nolanstr/diycnc/analysis/figs/base_current.png

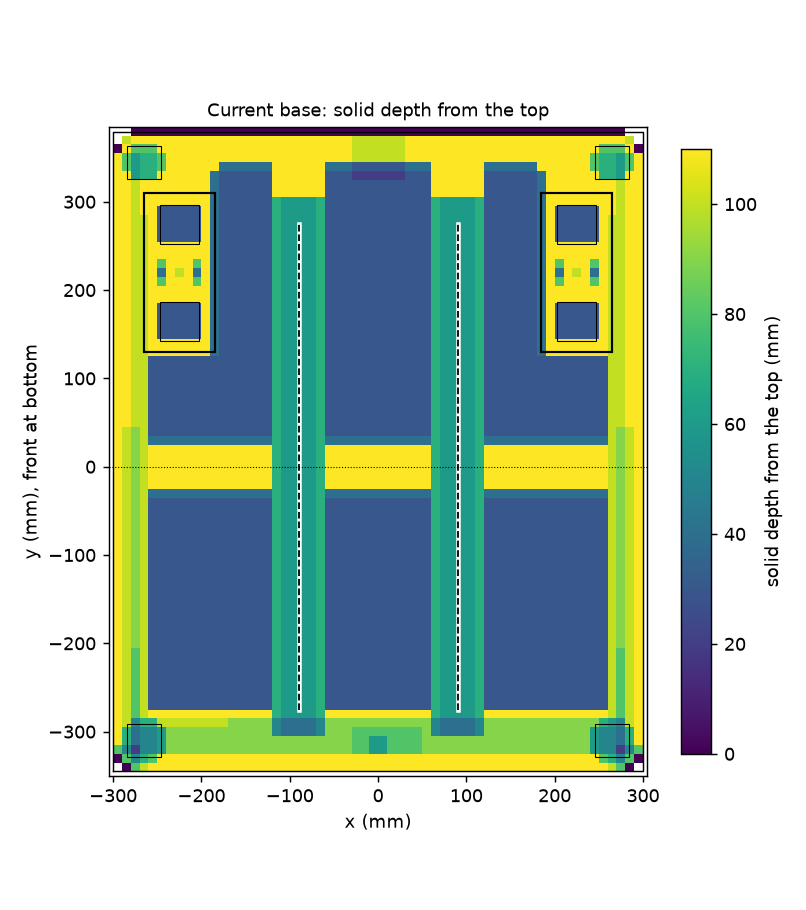
analysis/figs/base_current.png
