nolanstr/diycnc/analysis/figs/base_final.png

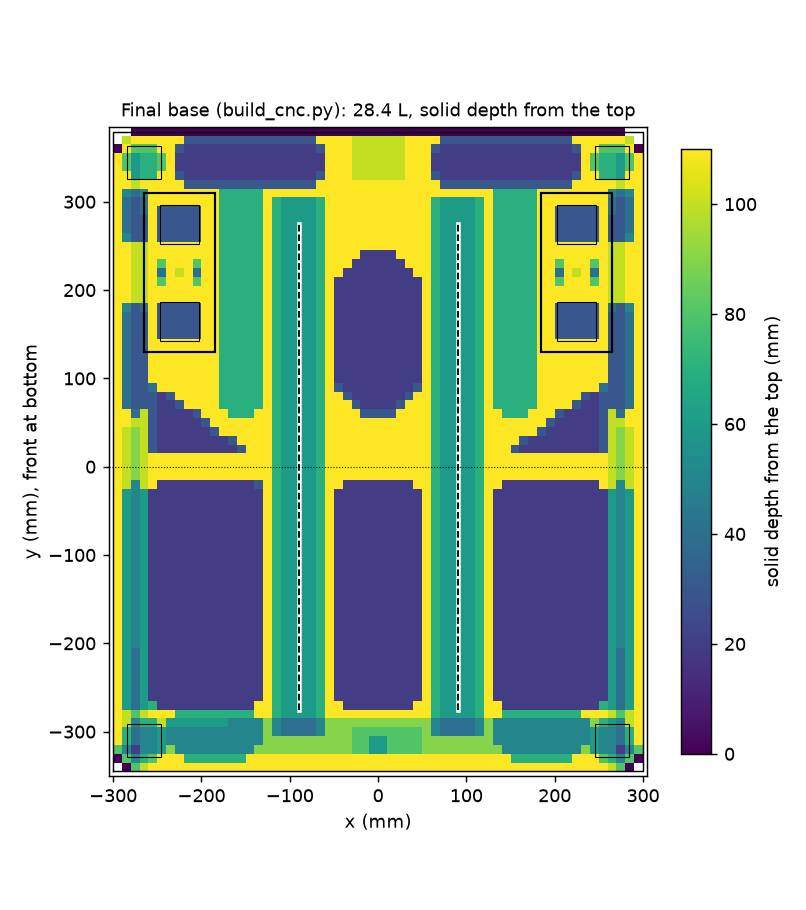
analysis/figs/base_final.png
