nolanstr/diycnc/analysis/figs/base_free_18_depth.png

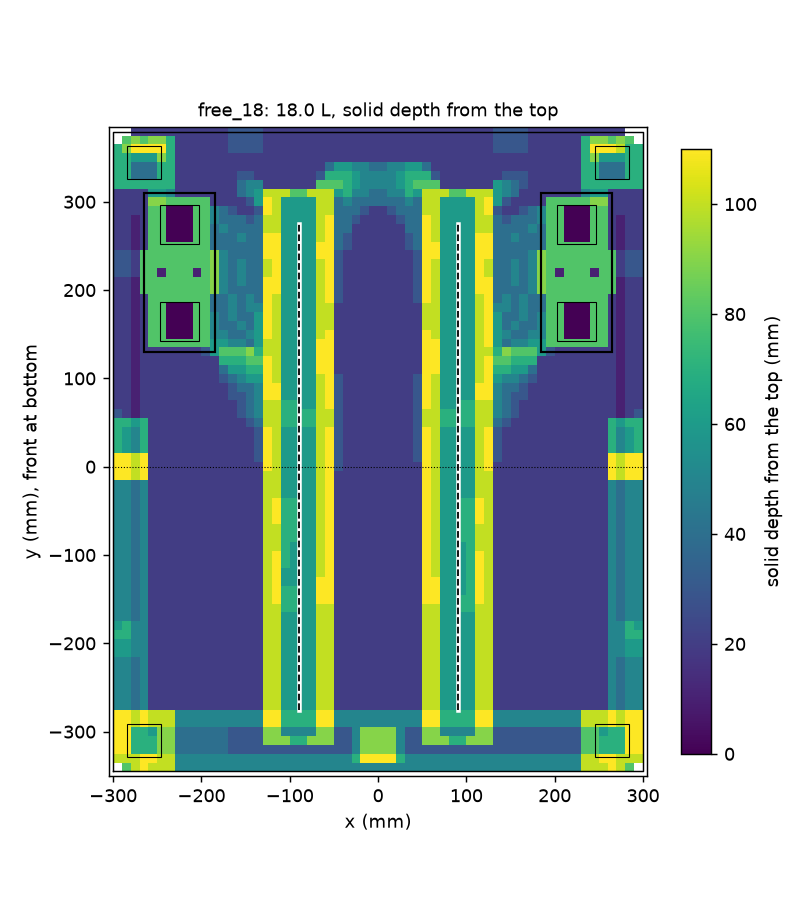
analysis/figs/base_free_18_depth.png
