nolanstr/diycnc/analysis/figs/base_free_18_layers.png

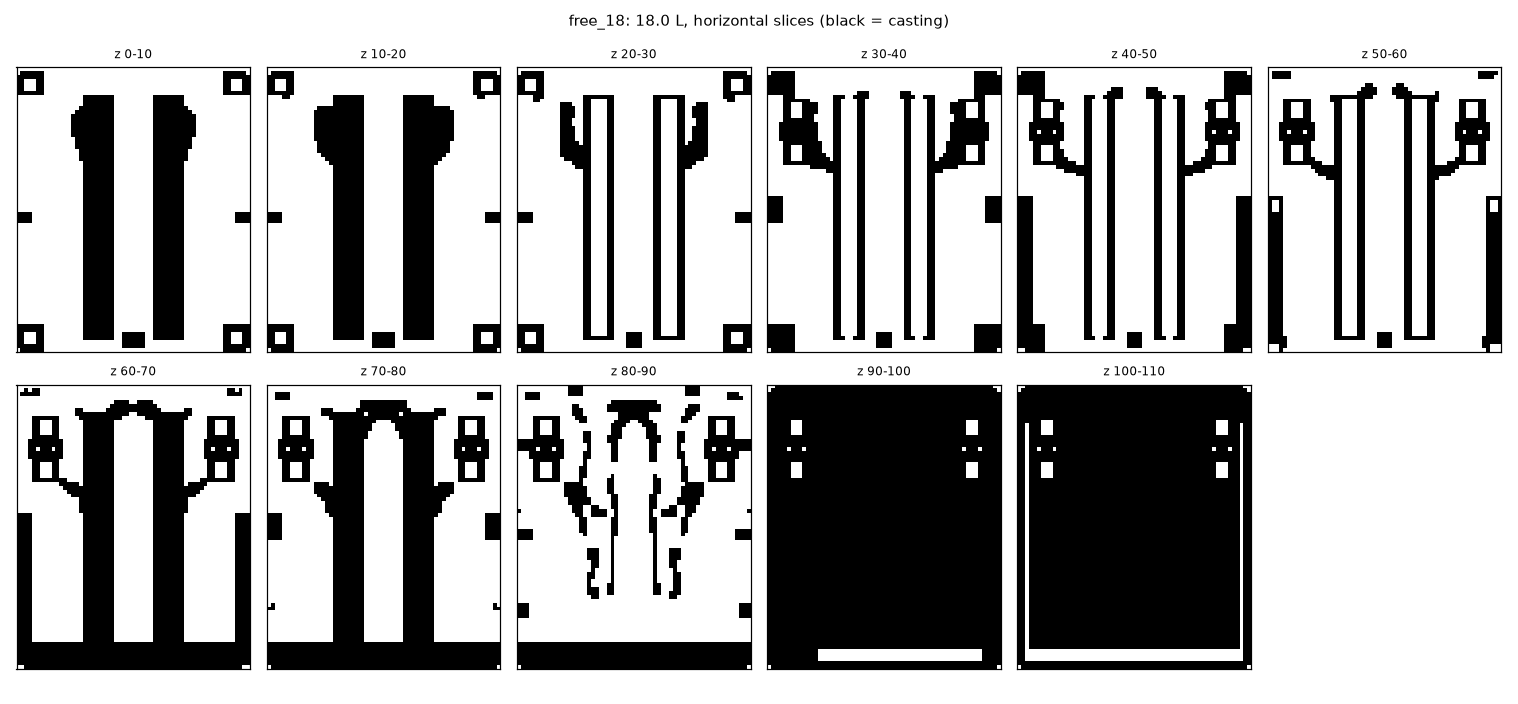
analysis/figs/base_free_18_layers.png
