nolanstr/diycnc/analysis/figs/base_free_21_depth.png

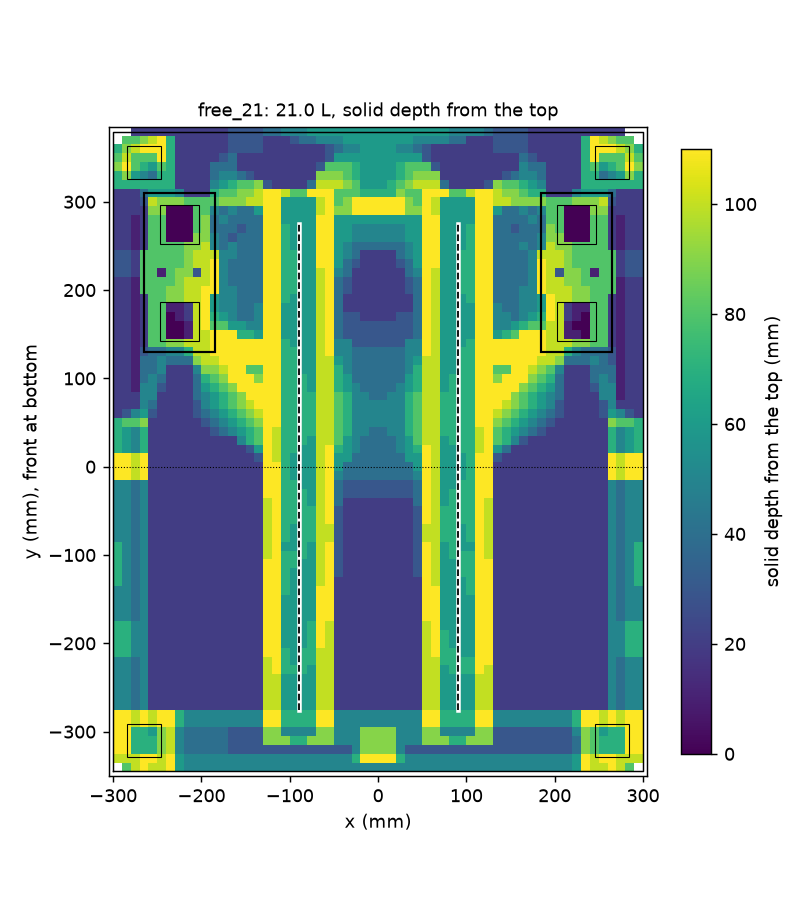
analysis/figs/base_free_21_depth.png
