nolanstr/diycnc/analysis/figs/base_free_21_layers.png

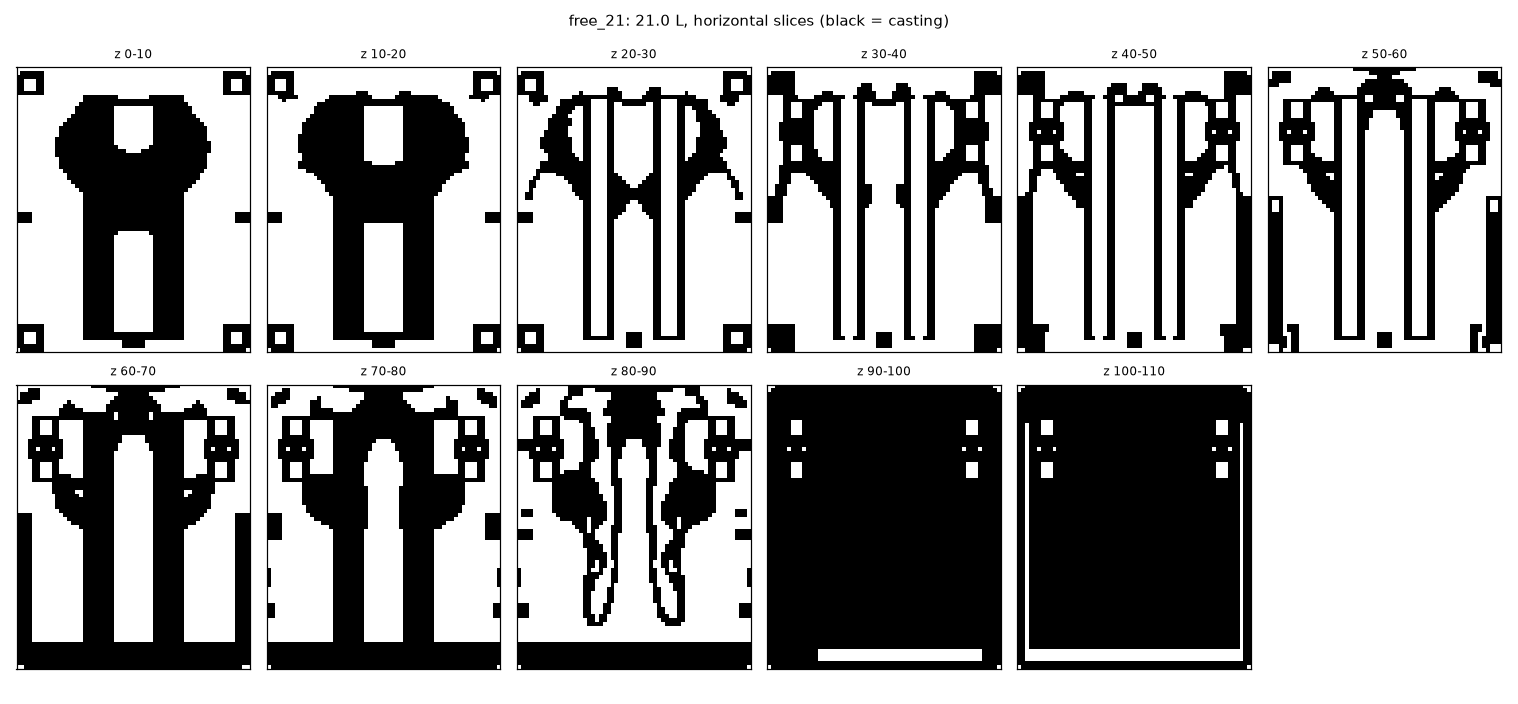
analysis/figs/base_free_21_layers.png
