nolanstr/diycnc/analysis/figs/base_pocket_21_depth.png

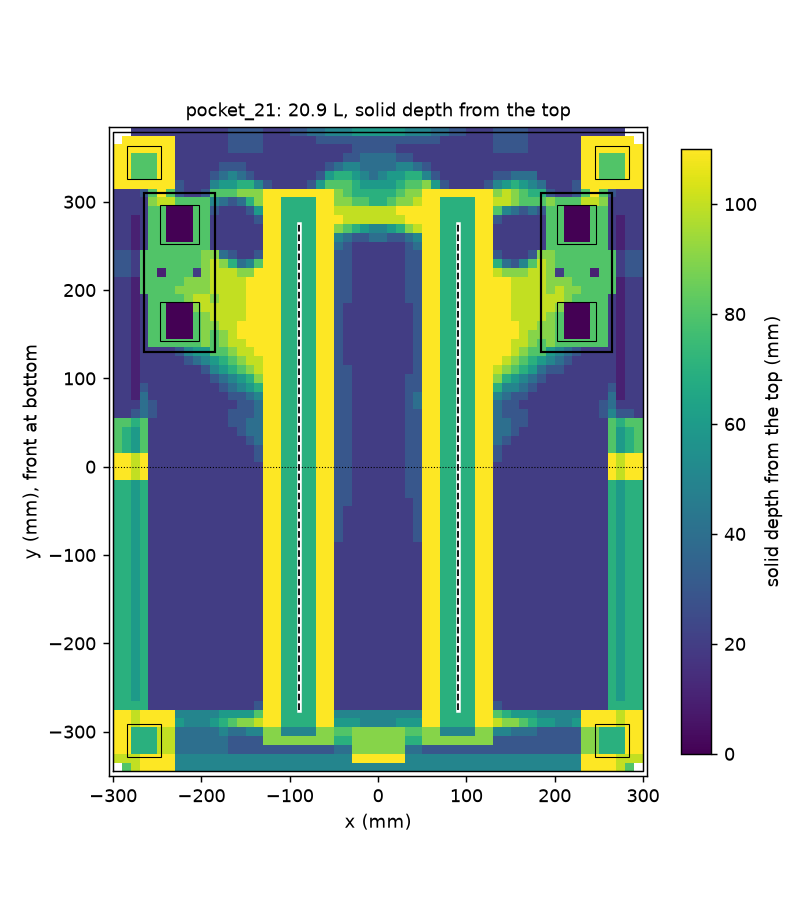
analysis/figs/base_pocket_21_depth.png
