nolanstr/diycnc/analysis/figs/base_pocket_28.5_depth.png

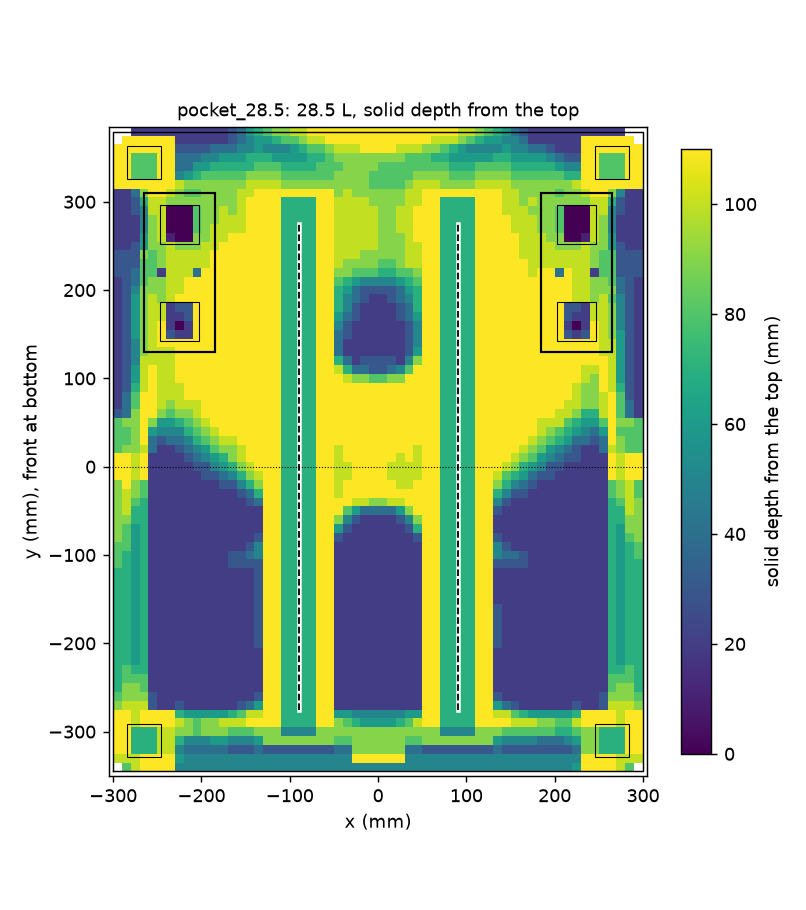
analysis/figs/base_pocket_28.5_depth.png
