nolanstr/diycnc/analysis/figs/frame2_base_28.4.png

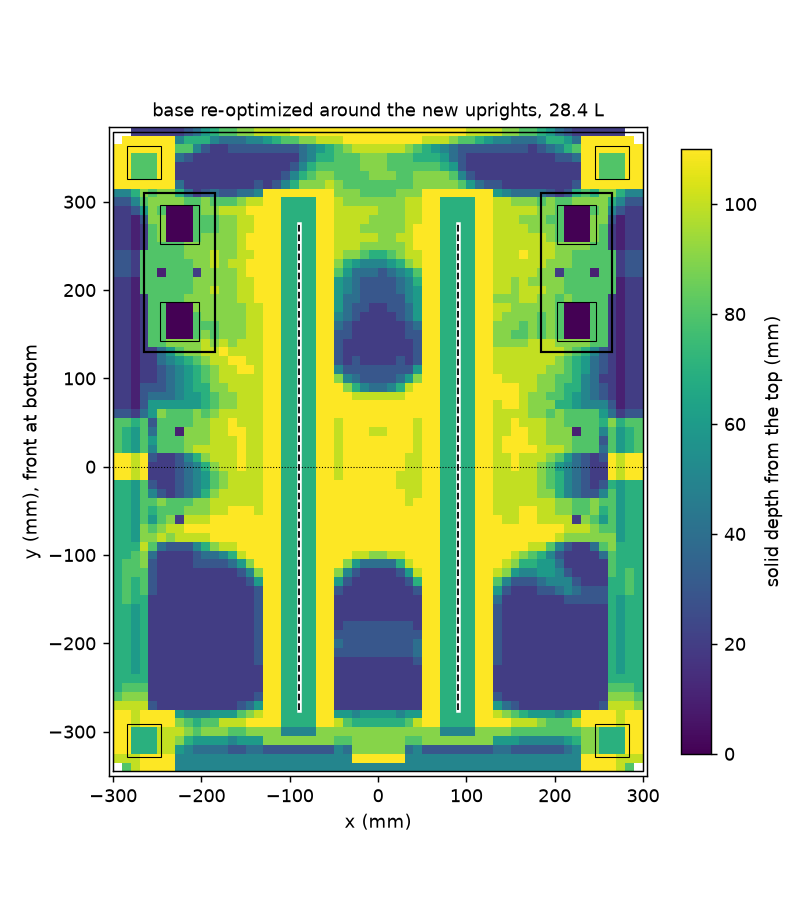
analysis/figs/frame2_base_28.4.png
