nolanstr/diycnc/analysis/figs/frame2_base_cad.png

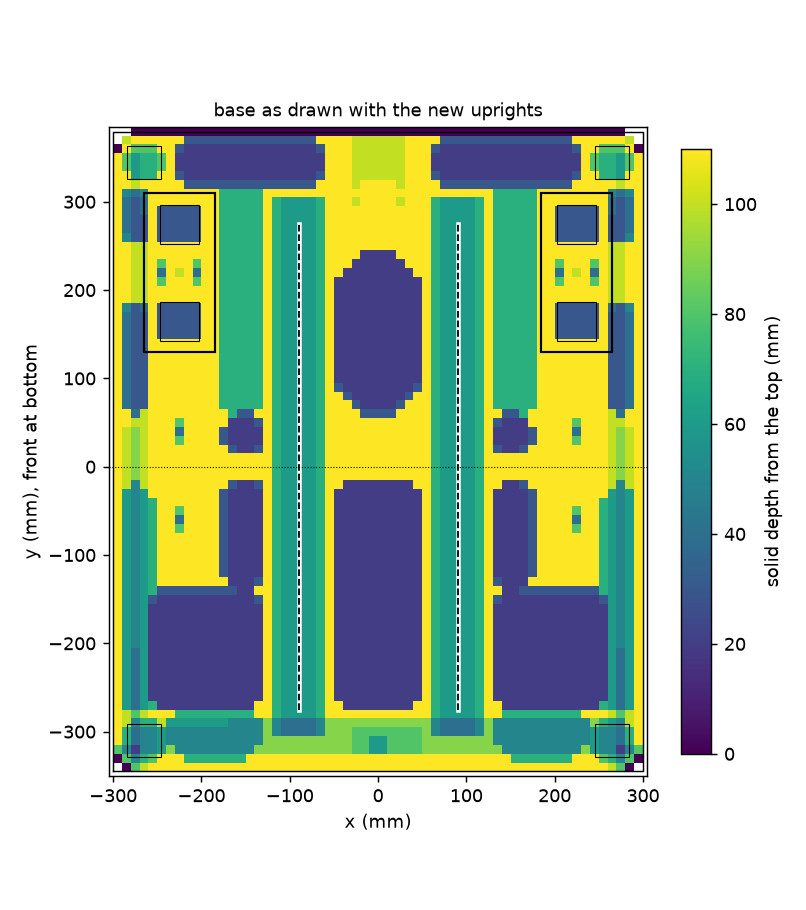
analysis/figs/frame2_base_cad.png
