nolanstr/diycnc/analysis/figs/frame_34.6_upright.png

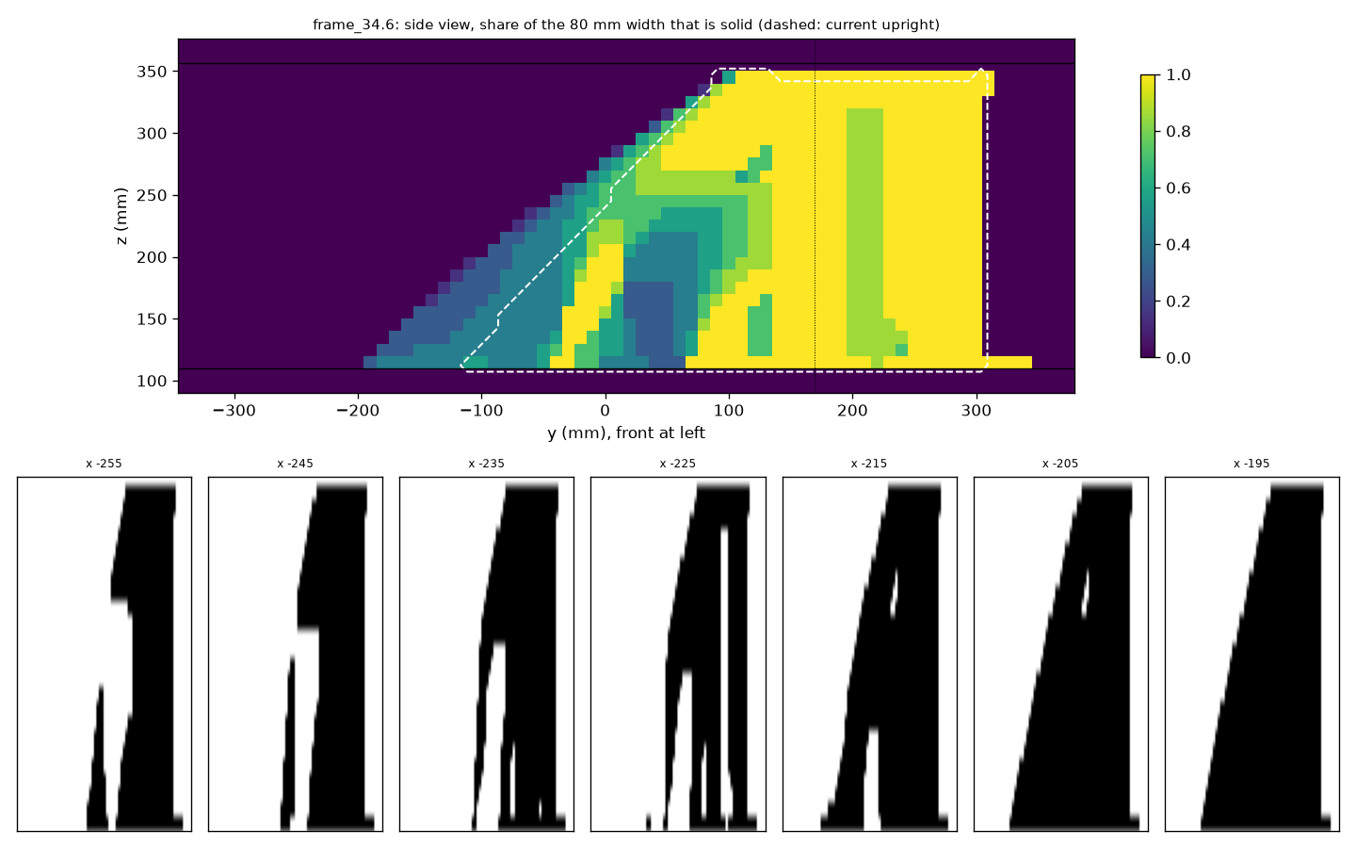
analysis/figs/frame_34.6_upright.png
