nolanstr/diycnc/analysis/figs/light_24.png

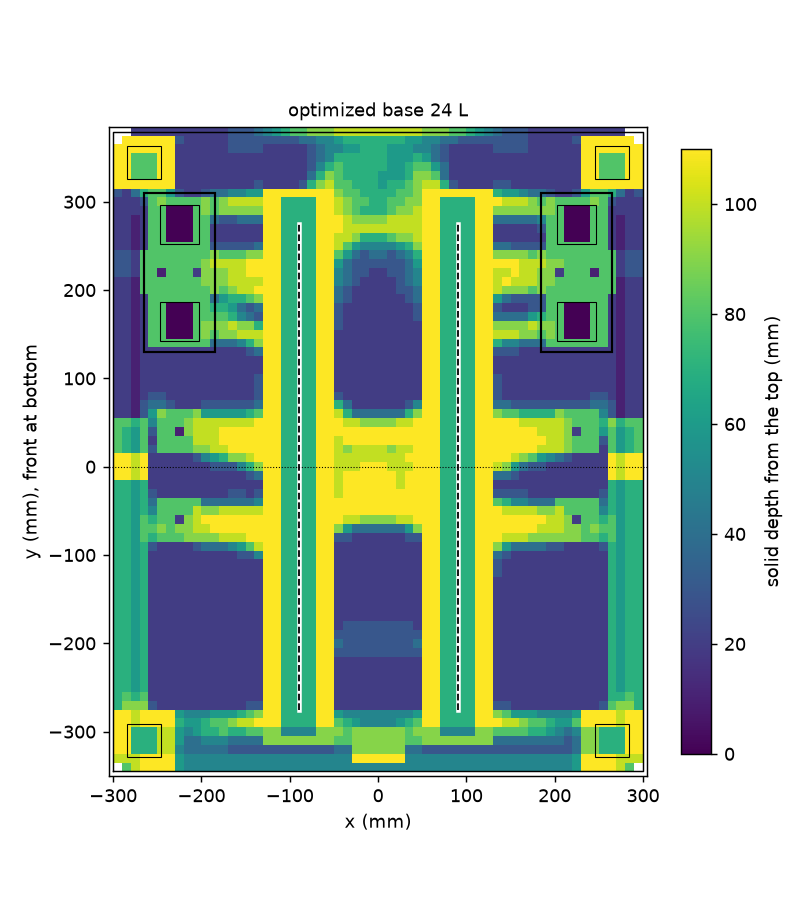
analysis/figs/light_24.png
