nolanstr/diycnc/analysis/figs/light_27.png

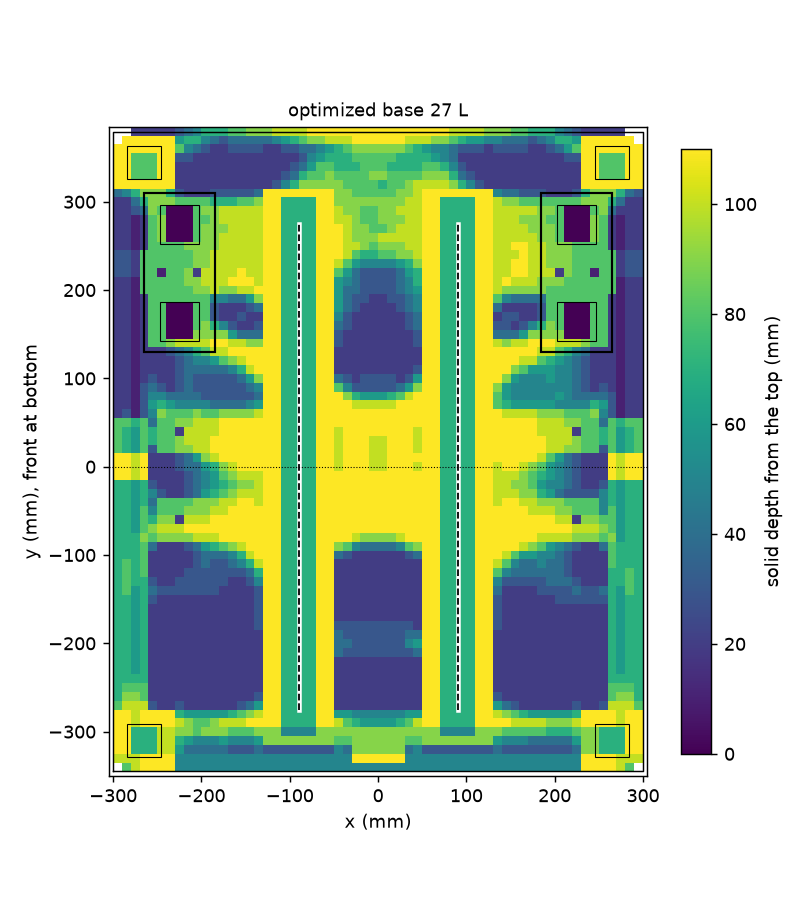
analysis/figs/light_27.png
