nolanstr/diycnc/analysis/figs/light_current.png

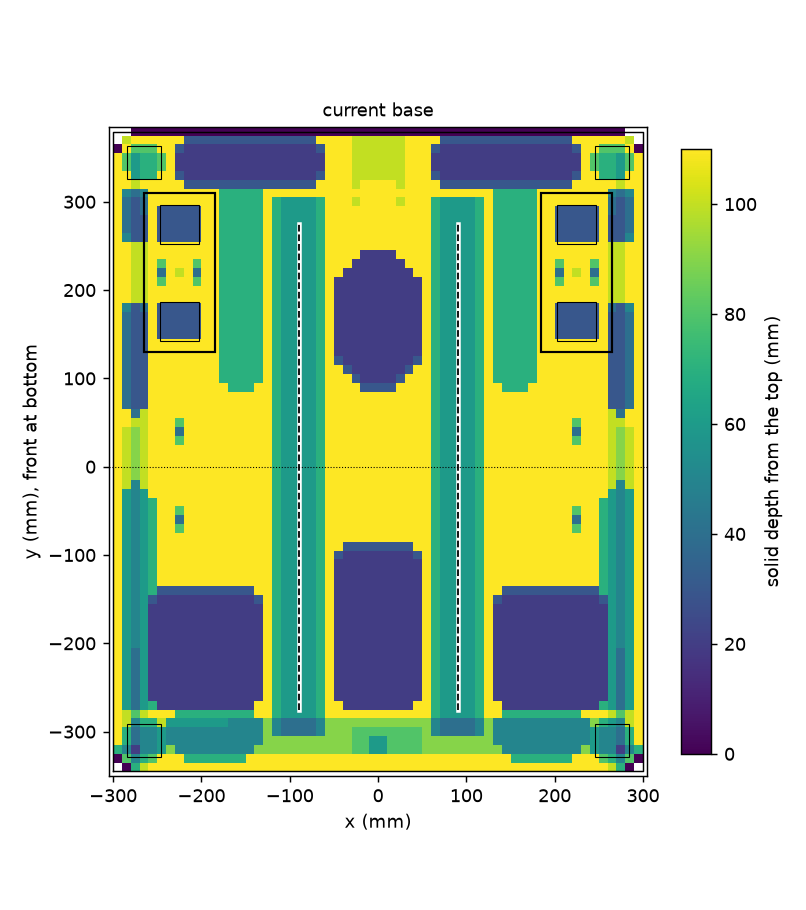
analysis/figs/light_current.png
