nolanstr/diycnc/analysis/figs/tradeoff.png

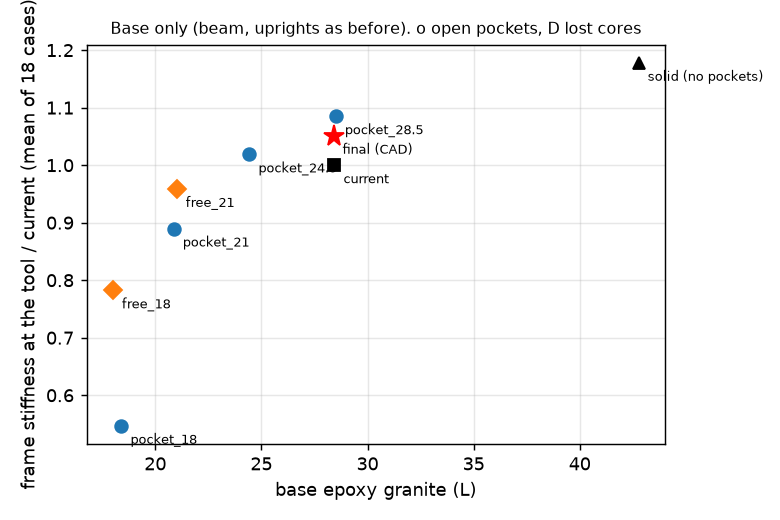
analysis/figs/tradeoff.png
