nolanstr/diycnc/analysis/figs/upright_thru_0.8.png

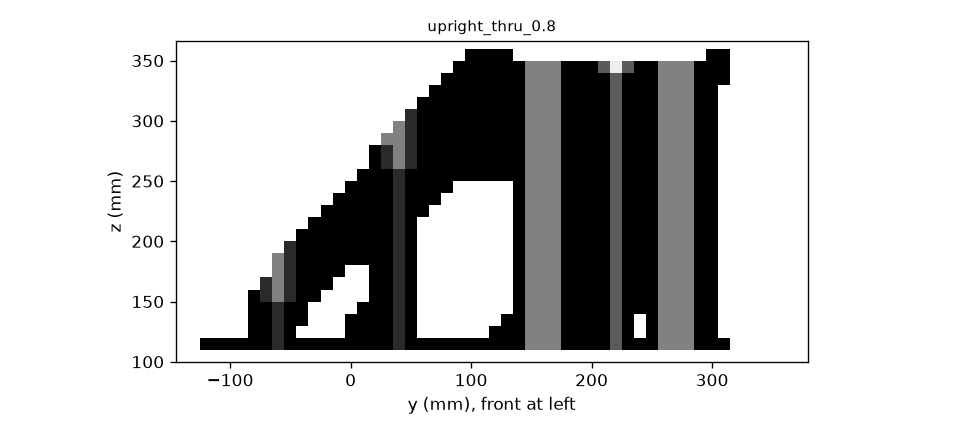
analysis/figs/upright_thru_0.8.png
