nolanstr/diycnc/renders/coolant_system.png

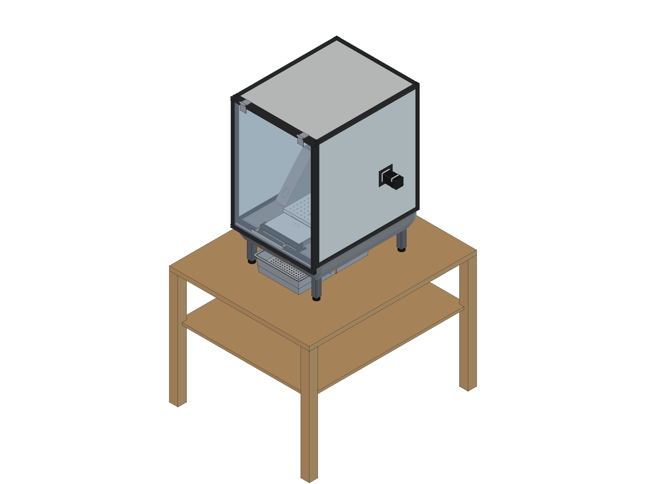
renders/coolant_system.png
