nolanstr/diycnc/renders/detail_cable_chain.png

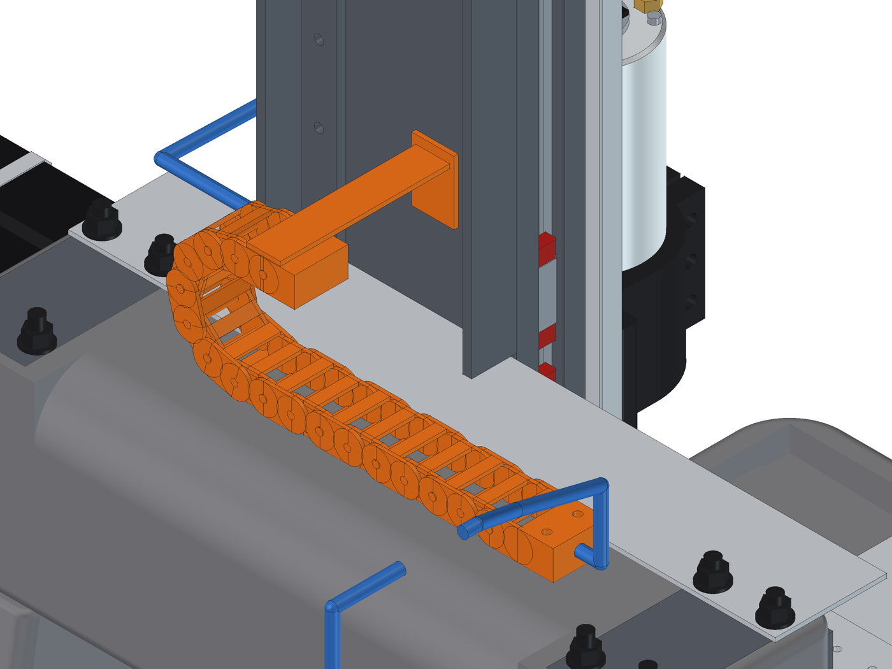
renders/detail_cable_chain.png
