nolanstr/diycnc/renders/detail_coolant_sump.png

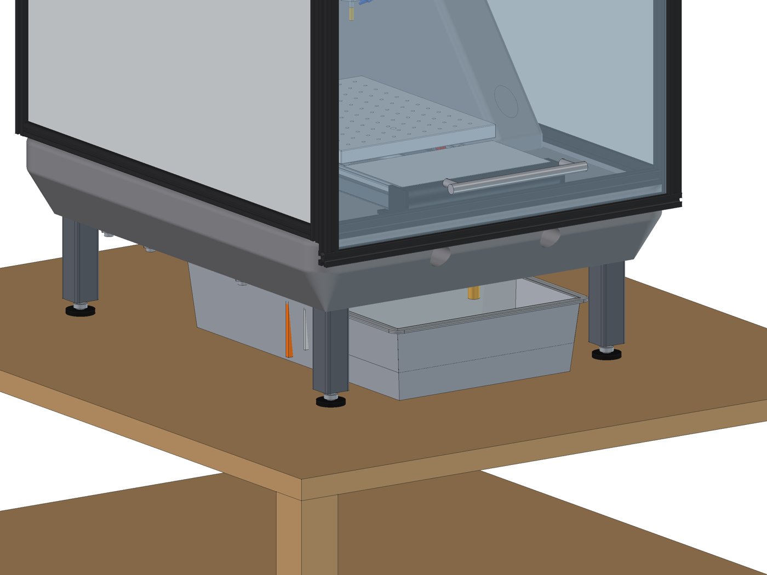
renders/detail_coolant_sump.png
