nolanstr/diycnc/renders/detail_coolant_sump_out.png

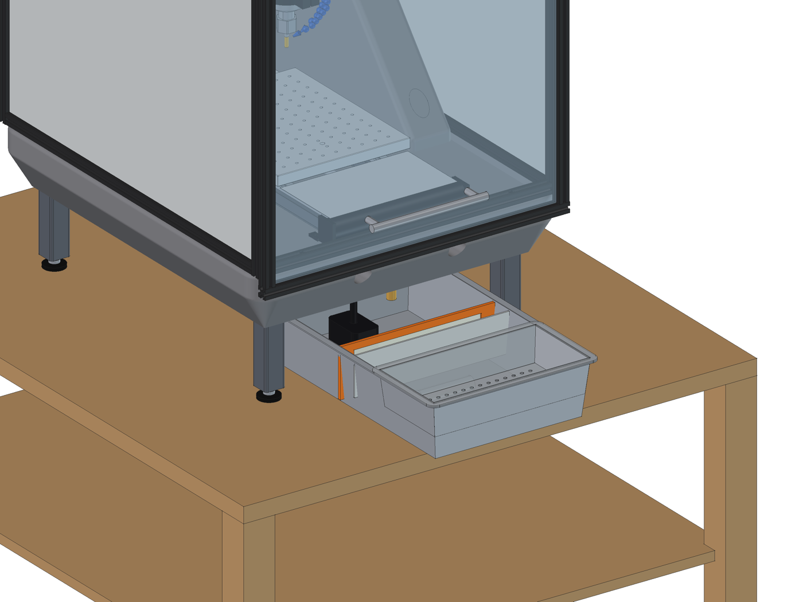
renders/detail_coolant_sump_out.png
