nolanstr/diycnc/renders/detail_nozzles.png

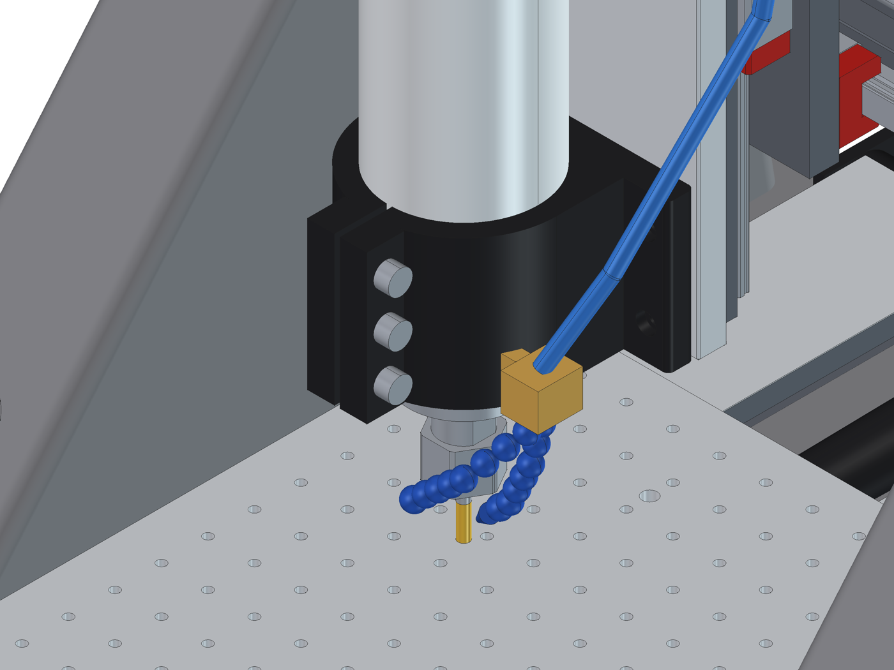
renders/detail_nozzles.png
