nolanstr/diycnc/renders/detail_table_drive.png

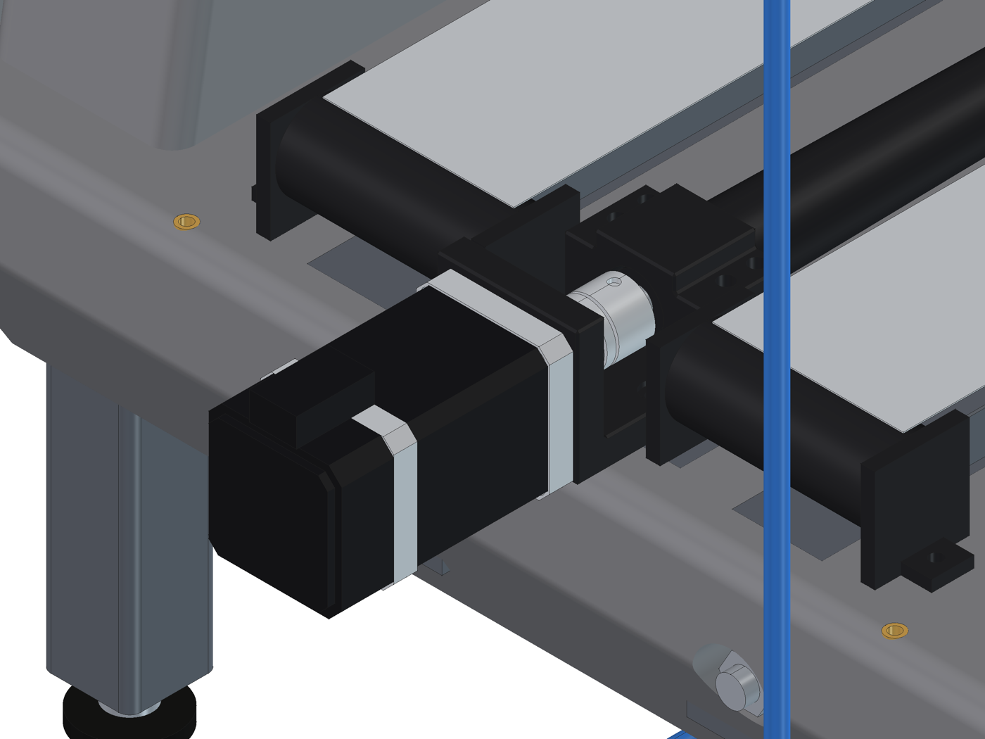
renders/detail_table_drive.png
