nolanstr/diycnc/renders/detail_way_covers.png

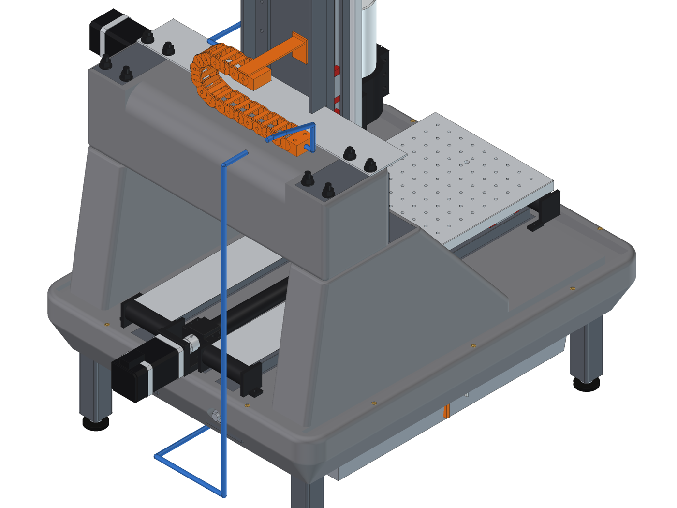
renders/detail_way_covers.png
