nolanstr/diycnc/renders/detail_z_axis.png

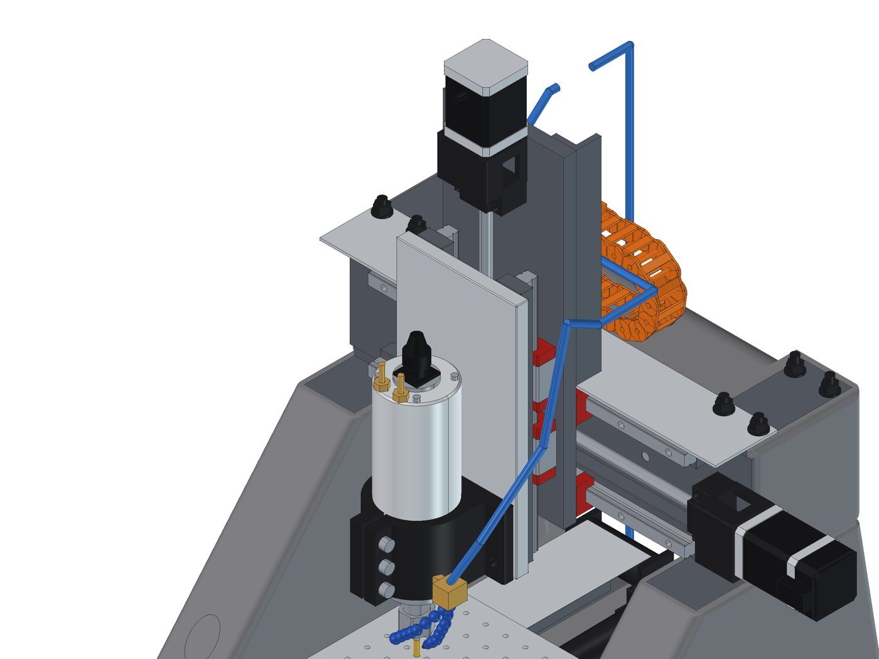
renders/detail_z_axis.png
