nolanstr/diycnc/renders/enclosure_closed.png

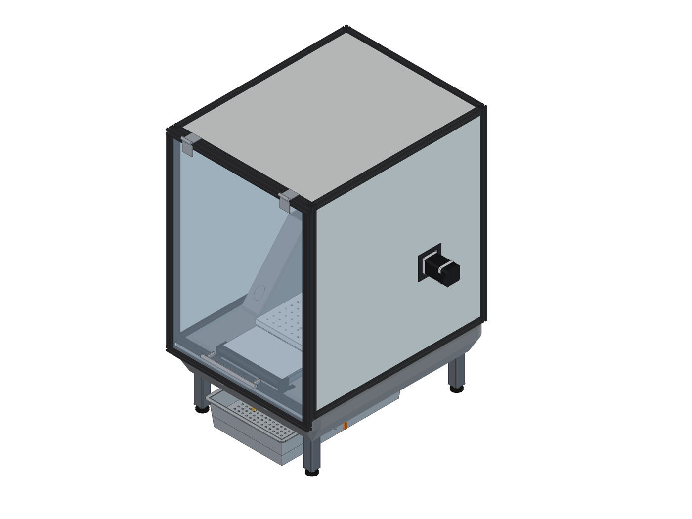
renders/enclosure_closed.png
