nolanstr/diycnc/renders/enclosure_open.png

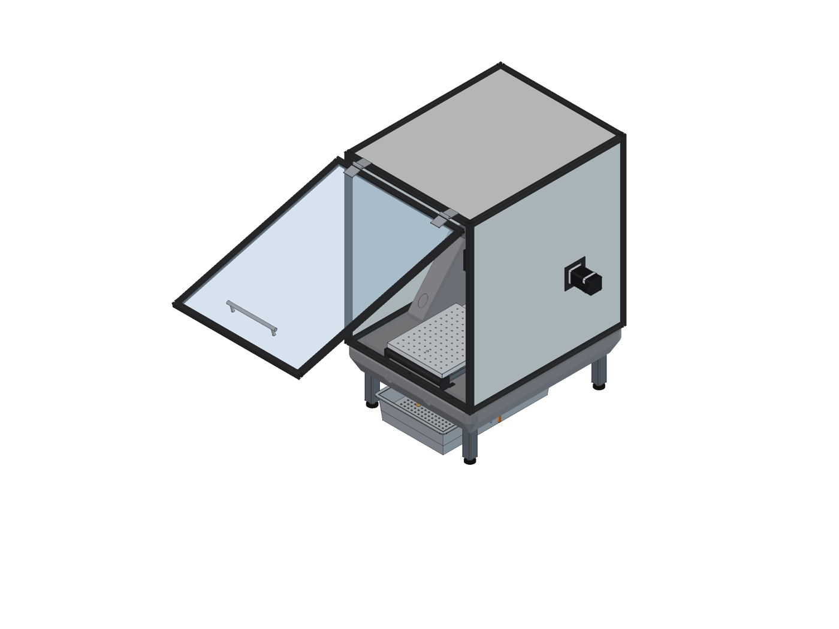
renders/enclosure_open.png
