nolanstr/diycnc/renders/frame_bare.png

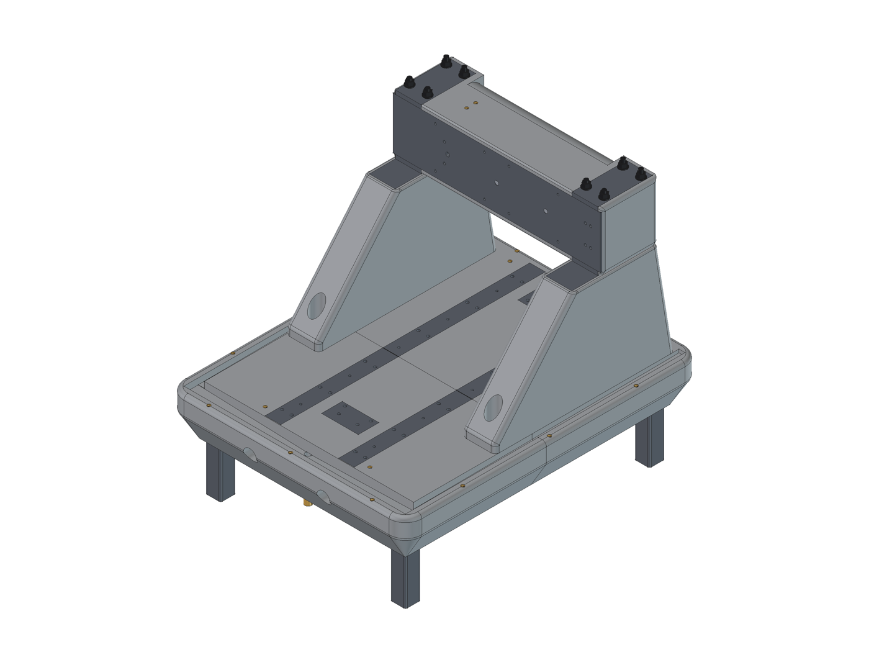
renders/frame_bare.png
