nolanstr/diycnc/renders/frame_bare_exploded.png

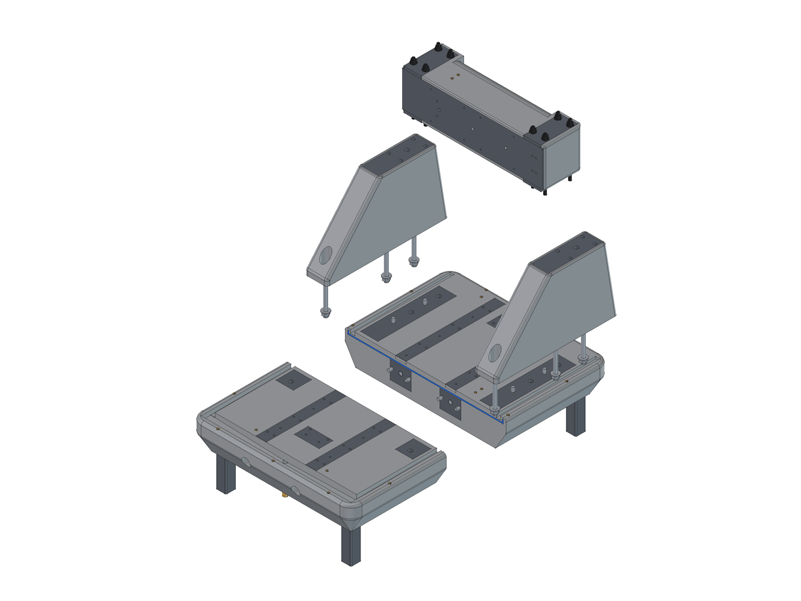
renders/frame_bare_exploded.png
