nolanstr/diycnc/renders/frame_bare_rear.png

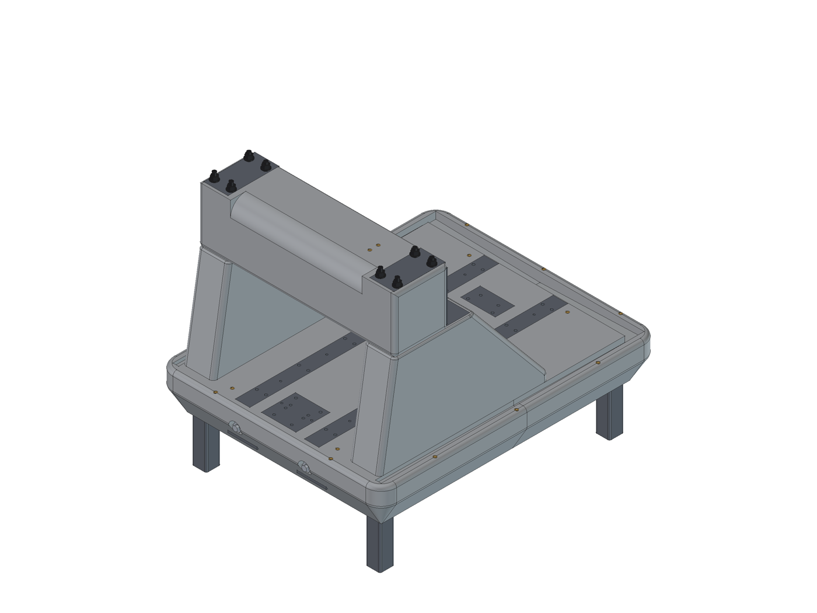
renders/frame_bare_rear.png
