nolanstr/diycnc/renders/frame_bare_xray.png

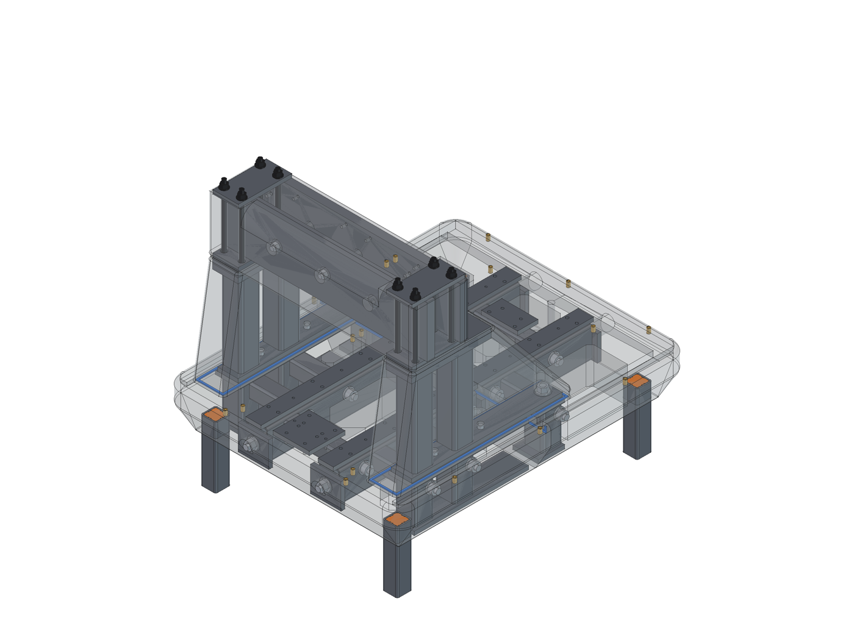
renders/frame_bare_xray.png
