nolanstr/diycnc/renders/frame_base_underside.png

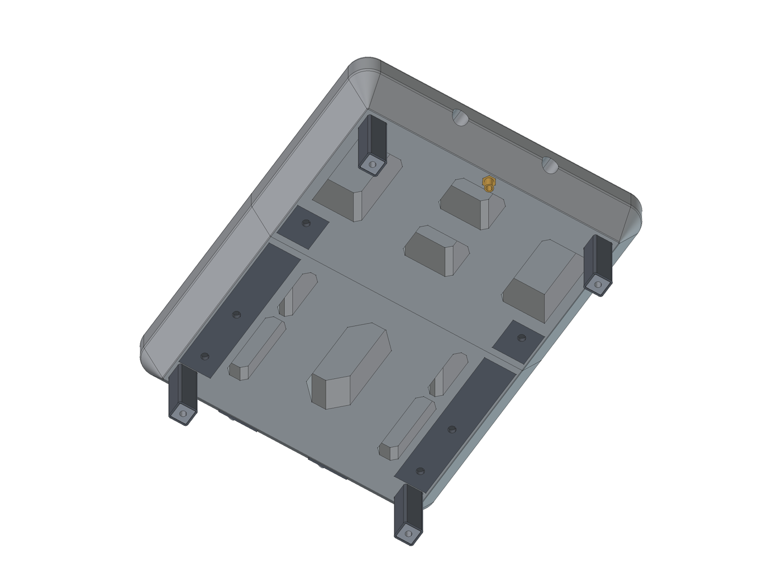
renders/frame_base_underside.png
