nolanstr/diycnc/renders/frame_exploded.png

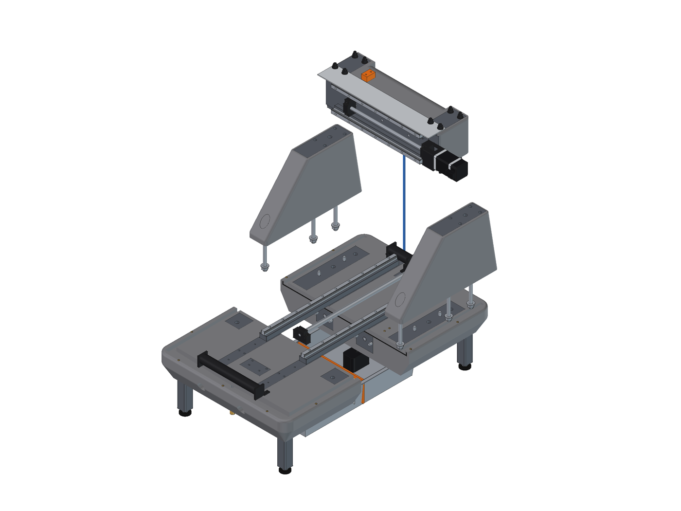
renders/frame_exploded.png
