nolanstr/diycnc/renders/frame_section_split.png

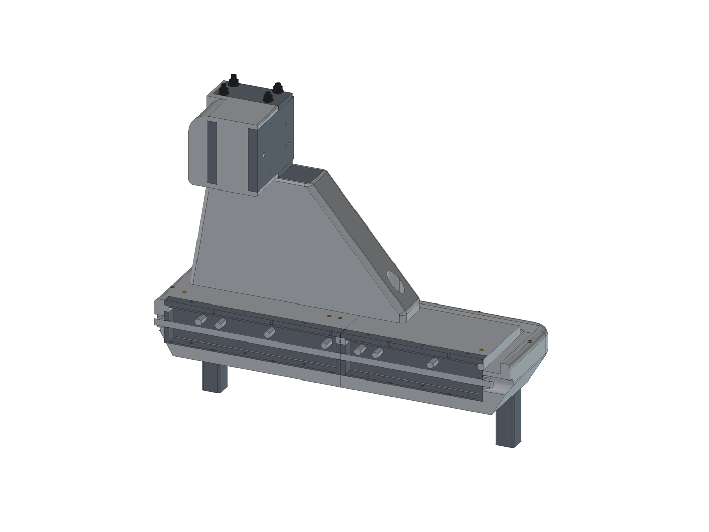
renders/frame_section_split.png
