nolanstr/diycnc/renders/frame_xray.png

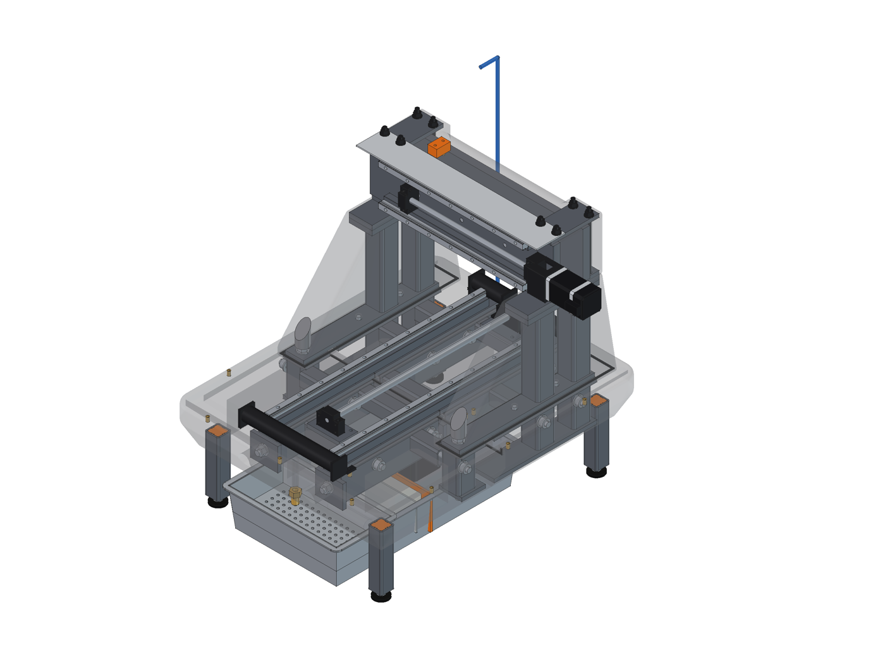
renders/frame_xray.png
