nolanstr/diycnc/renders/gasket_base_split.png

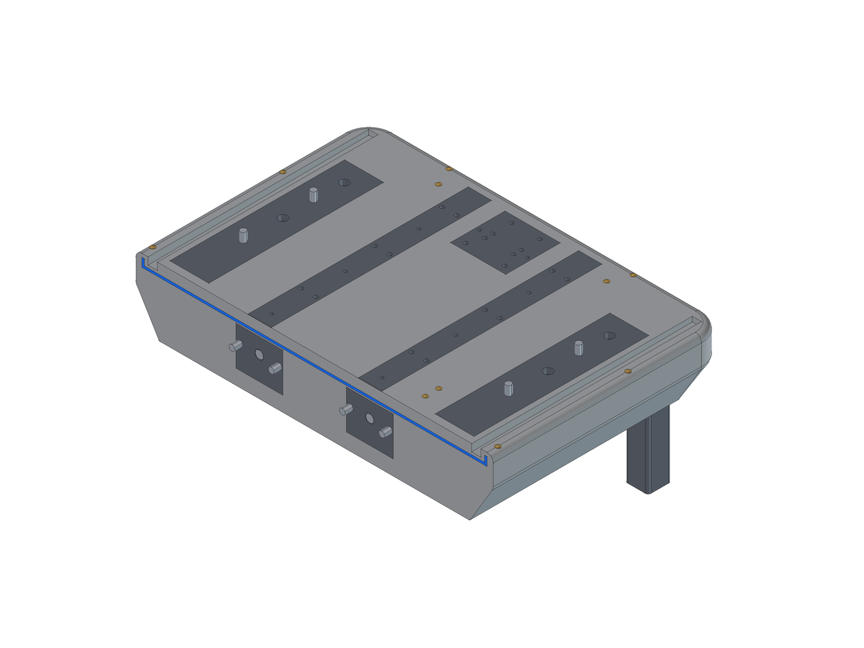
renders/gasket_base_split.png
