nolanstr/diycnc/renders/gasket_upright_foot.png

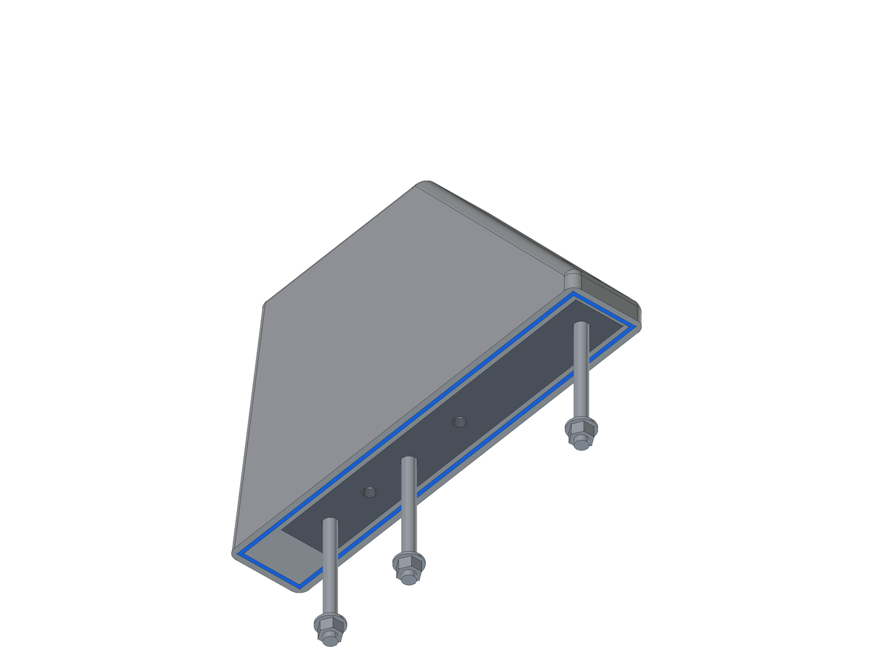
renders/gasket_upright_foot.png
