nolanstr/diycnc/renders/machine_front.png

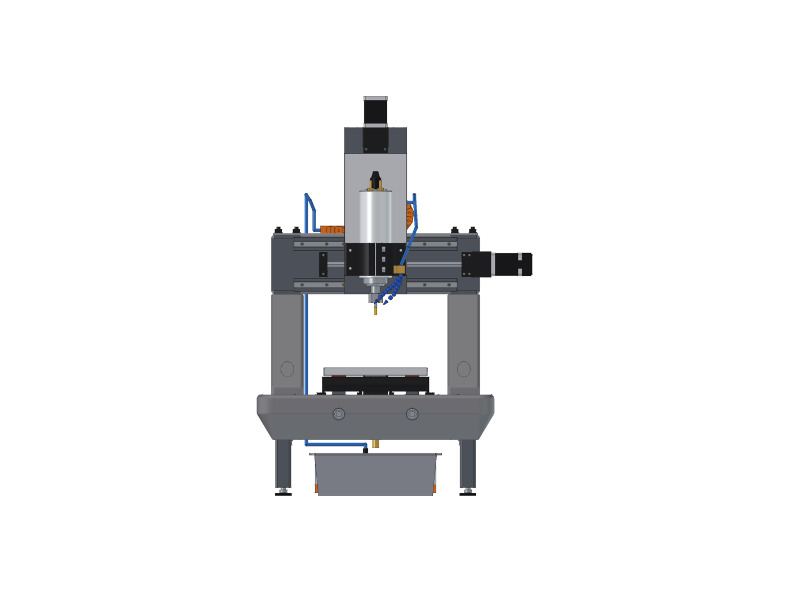
renders/machine_front.png
