nolanstr/diycnc/renders/machine_right.png

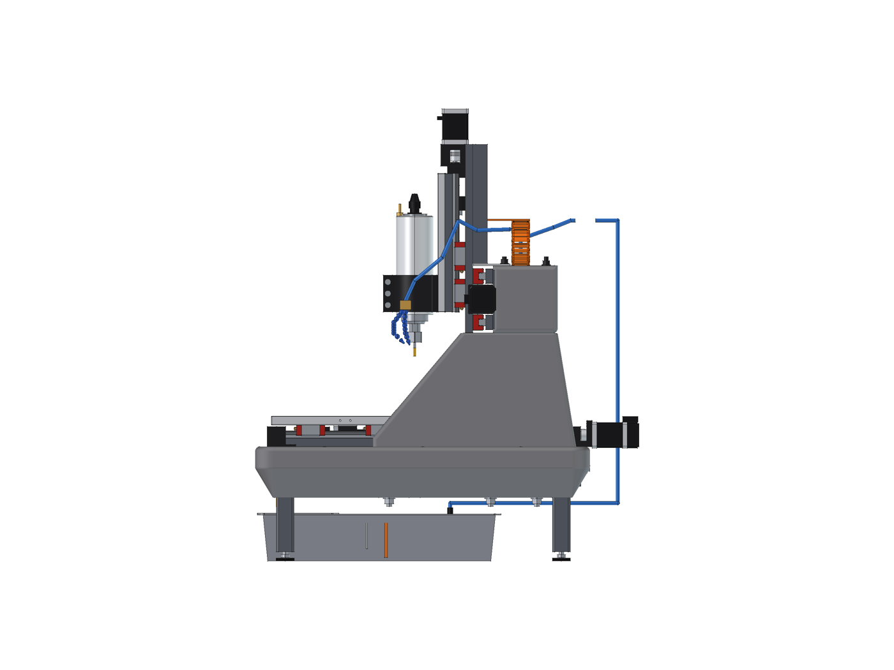
renders/machine_right.png
