nolanstr/diycnc/docs/1-sourcing/steel/README.md

# Steel for the skeletons and the X carriage

All stock mild steel (A36 / A500), nothing custom: buy it cut to length (Metal Supermarkets, Online Metals, a local steel yard; flat bar and tube also come in 3 and 6 ft lengths on Amazon and at hardware stores, and a chop saw or hacksaw does the rest). Drill and tap it from the printed 1:1 templates in `steel-templates.pdf` (center-punch through the paper, then a drill press).

25 different parts, 57 pieces, about 66 kg.

## Cut list (by stock size)

| Stock | Pieces (qty x length, mm) | Total |
|---|---|---|
| Angle 1-1/4 x 1-1/4 x 1/4 in | 2 x 257 | 1.7 ft |
| Flat bar 1/2 x 2-1/2 in | 4 x 198 | 2.6 ft |
| Flat bar 3/4 x 5 in | 2 x 508 | 3.3 ft |
| Flat bar 3/8 x 1-1/2 in | 2 x 359, 2 x 288 | 4.2 ft |
| Flat bar 3/8 x 2 in | 2 x 375, 1 x 90 | 2.8 ft |
| Flat bar 3/8 x 2-1/2 in | 4 x 285, 4 x 133, 8 x 76, 4 x 66 | 8.4 ft |
| Flat bar 3/8 x 3-1/2 in | 1 x 90 | 0.3 ft |
| Flat bar 5/8 x 6 in | 1 x 407 | 1.3 ft |
| Rectangular tube 2 x 3 x 1/8 in | 2 x 340, 2 x 269 | 4.0 ft |
| Square tube 1-1/2 x 1-1/2 x 1/8 in | 4 x 129, 6 x 75 | 3.2 ft |
| Square tube 2 x 2 x 3/16 in | 6 x 91 | 1.8 ft |

## Parts

| Part | Stock | Length | Qty | Holes |
|---|---|---|---|---|
| X carriage angle | Angle 1-1/4 x 1-1/4 x 1/4 in | 257 mm (10-1/8 in) | 2 | 5 x 17/64 in |
| Top plate, lower | Flat bar 1/2 x 2-1/2 in | 198 mm (7-13/16 in) | 2 | 2 x 27/64 in, tap 1/2-13, 4 x 5/16 in, tap 3/8-16, 1 x 9/16 in |
| Top plate, upper | Flat bar 1/2 x 2-1/2 in | 198 mm (7-13/16 in) | 2 | 4 x 13/32 in, 1 x 9/16 in |
| Beam back plate | Flat bar 3/4 x 5 in | 508 mm (20 in) | 1 | 3 x 13/32 in |
| Beam face plate | Flat bar 3/4 x 5 in | 508 mm (20 in) | 1 | 3 x 5/16 in, tap 3/8-16, 8 x M5 tap drill (4.2 mm), tap M5, 6 x M6 tap drill (5 mm), tap M6 |
| Rail bar rear | Flat bar 3/8 x 1-1/2 in | 359 mm (14-1/8 in) | 2 | 6 x 17/64 in, 3 x M5 tap drill (4.2 mm), tap M5 |
| Rail bar front | Flat bar 3/8 x 1-1/2 in | 288 mm (11-5/16 in) | 2 | 6 x 17/64 in, 2 x M5 tap drill (4.2 mm), tap M5 |
| Upright foot | Flat bar 3/8 x 2 in | 375 mm (14-3/4 in) | 2 | 3 x 9/16 in, 2 x 1/2 in |
| Pad BF | Flat bar 3/8 x 2 in | 90 mm (3-9/16 in) | 1 | 2 x 17/64 in, 2 x M6 tap drill (5 mm), tap M6 |
| Seat rear | Flat bar 3/8 x 2-1/2 in | 285 mm (11-1/4 in) | 2 | 2 x 9/16 in, 2 x 3/8 in |
| Pedestal bar rear | Flat bar 3/8 x 2-1/2 in | 285 mm (11-1/4 in) | 2 | 2 x 9/16 in |
| Beam seat | Flat bar 3/8 x 2-1/2 in | 133 mm (5-1/4 in) | 2 | 4 x 17/32 in, 1 x 3/8 in |
| Beam cap | Flat bar 3/8 x 2-1/2 in | 133 mm (5-1/4 in) | 2 | 4 x 17/32 in |
| Girder end | Flat bar 3/8 x 2-1/2 in | 76 mm (3 in) | 4 | 1 x 9/16 in |
| Girder end split | Flat bar 3/8 x 2-1/2 in | 76 mm (3 in) | 4 | 1 x 9/16 in, 2 x 3/8 in |
| Pedestal bar / seat front | Flat bar 3/8 x 2-1/2 in | 66 mm (2-5/8 in) | 4 | 1 x 9/16 in |
| Pad BK | Flat bar 3/8 x 3-1/2 in | 90 mm (3-9/16 in) | 1 | 2 x 17/64 in, 6 x M6 tap drill (5 mm), tap M6, 2 x M5 tap drill (4.2 mm), tap M5 |
| X carriage plate | Flat bar 5/8 x 6 in | 407 mm (16-1/16 in) | 1 | - |
| Girder rear | Rectangular tube 2 x 3 x 1/8 in | 340 mm (13-3/8 in) | 2 | 6 x 17/64 in, 3 x 1/4 in; 4 x 9/16 in |
| Girder front | Rectangular tube 2 x 3 x 1/8 in | 269 mm (10-5/8 in) | 2 | 6 x 17/64 in, 2 x 1/4 in; 3 x 9/16 in |
| Cross split | Square tube 1-1/2 x 1-1/2 x 1/8 in | 129 mm (5-1/16 in) | 2 | - |
| Cross BF front | Square tube 1-1/2 x 1-1/2 x 1/8 in | 129 mm (5-1/16 in) | 1 | 2 x 17/64 in, 2 x 9/32 in |
| Cross BK rear | Square tube 1-1/2 x 1-1/2 x 1/8 in | 129 mm (5-1/16 in) | 1 | 2 x 17/64 in, 2 x 9/32 in |
| Cross ped | Square tube 1-1/2 x 1-1/2 x 1/8 in | 75 mm (2-15/16 in) | 6 | - |
| Pedestal column | Square tube 2 x 2 x 3/16 in | 91 mm (3-9/16 in) | 6 | 1 x 9/16 in |
