nolanstr/diycnc/docs/1-sourcing/quote-requests.md

# Quote requests

Ready to send: copy the text into the seller's email or quote form, fill in your name and phone, and
send. Contacts were checked on 2026-10-22; none of these sellers publishes prices for cut pieces, so a
quote is the only way to beat the estimates in the sourcing list (steel ~$400, aluminum ~$65, ACM
~$117 + freight).

## 1. Steel, rail risers and aluminum plates

Send the same request to all four and take the best. Ask each to quote both ways: cut to the list,
and the same stock uncut (drops or full lengths), since a chop saw does the rest.

| Seller | How to send | Notes |
|---|---|---|
| Triple-S Steel, 6945 San Tomas Rd, Elkridge | howard.payton@sss-steel.com, 410-355-6464 | Sells to walk-in retail customers (walk-in Mon-Fri 8-3) |
| Metal Supermarkets, 7120 Golden Ring Rd #112 | Quote form at metalsupermarkets.com/location/baltimore, 410-918-0199 | No minimum; always cut to size |
| Alro Metals Outlet, 8893 Kelso Dr, Essex | "Email this facility" form at alro.com (location BZ), 410-687-2414 | Drops and remnants, open to the public, cuts while you wait: best taken in person with the list |
| DS Pipe & Steel, 1301 Wicomico St | Quote form at dspipe.com/request-a-quote, 410-539-8000 | "No order too small"; most Saturdays 7-1 |

> **Subject:** Quote request: small cut-to-length order, mild steel and aluminum, pickup
>
> Hello,
>
> I'd like a price for the following, for pickup in Baltimore. Please quote it cut to the lengths
> below, and if it's cheaper, the same stock uncut (drops or remnants are fine; I can cut it
> myself). Saw-cut ends are fine; length tolerance +/- 1/8 in. Hot-rolled A36 flat bar and A500
> tube unless noted.
>
> **Flat bar (hot-rolled A36)**
> - 3/4 x 5 in: 2 pcs at 20.00 in
> - 1/2 x 2-1/2 in: 4 pcs at 7.80 in
> - 3/8 x 1-1/2 in: 2 pcs at 14.13 in, 2 pcs at 11.34 in
> - 3/8 x 2 in: 2 pcs at 14.76 in, 1 pc at 3.54 in
> - 3/8 x 2-1/2 in: 4 pcs at 11.22 in, 4 pcs at 5.25 in, 8 pcs at 3.00 in, 4 pcs at 2.60 in
> - 3/8 x 3-1/2 in: 1 pc at 3.56 in
> - 5/8 x 6 in: 1 pc at 16.06 in
>
> **Angle (A36)**
> - 1-1/4 x 1-1/4 x 1/4 in: 2 pcs at 10.13 in
>
> **Tube (A500)**
> - Rectangular 2 x 3 x 1/8 in wall: 2 pcs at 13.40 in, 2 pcs at 10.61 in
> - Square 2 x 2 x 3/16 in wall: 6 pcs at 3.58 in, 4 pcs at 8.13 in
> - Square 1-1/2 x 1-1/2 x 1/8 in wall: 4 pcs at 5.09 in, 6 pcs at 3.31 in, 4 pcs at 6.00 in
>
> **Cold-rolled 1018 flat bar** (needs to be cold-rolled for flatness)
> - 3/4 x 1-1/4 in: 2 pcs at 23.62 in
> - 5/8 x 1-1/4 in: 2 pcs at 15.75 in, 2 pcs at 11.81 in
>
> **Aluminum 6061 flat bar** (drops or remnants welcome; MIC-6 even better if you have it)
> - 3/4 x 10 in: 1 pc at 12.63 in
> - 5/8 x 6 in: 1 pc at 11.81 in
>
> Total is roughly 185 lb of steel and 14 lb of aluminum. Could you also tell me your cutting
> charge, and whether I can pick it up the same week?
>
> Thank you,
> [name, phone]

## 2. Whiting (Clayworks Supplies)

clayworks@clayworkssupplies.com, 410-235-5998; 4625 Falls Rd, Mon-Fri 10-5, Sat 10-4. A call is quickest.

> **Subject:** Calcium carbonate whiting: mesh size
>
> Hello,
>
> I'd like to pick up a 50 lb bag of your calcium carbonate whiting ($17). Could you tell me its mesh
> size (I need 325 mesh, or finer) and whether it's in stock this week? If you have the SDS, could
> you send it as well?
>
> Thank you,
> [name, phone]

## 3. ACM sheet for the enclosure (Piedmont Plastics)

Piedmont Plastics, 7045 Troy Hill Dr, Elkridge, 301-881-7900 ("Talk to an expert" form at
piedmontplastics.com, Baltimore/Washington branch). Only when you get to part 3.

> **Subject:** Quote: one sheet of 3 mm ACM, pickup
>
> Hello,
>
> Could you quote one 48 x 96 in sheet of 3 mm aluminum composite panel (white or black, any brand)
> for pickup at Elkridge? If you cut to size, please also quote it cut into these panels: 2 at
> 726 x 684 mm, 1 at 726 x 560 mm, 1 at 684 x 560 mm and 1 at 518 x 79 mm.
>
> Thank you,
> [name, phone]
