nolanstr/diycnc/docs/1-sourcing/steel/steel-templates.pdf

# Steel parts: drilling templates

DIY CNC mill · October 2026 · full size, US Letter

## Printing

1. Print at Actual size / 100 %. Turn off "Fit to page" and "Scale to fit". Letter paper, portrait.
2. Measure the square below: it must be 100 mm (and the bar on every page 50 mm).

## Marking and drilling

1. Cut out the part's outline on each page and tape it to the part, its edges on the part's edges (x runs along the length from the end the page starts at). For a tube, tape it to the face named in the title.
2. Center-punch through every crosshair, pull the paper off, and drill on a drill press with the part clamped. Pilot with 1/8 in first. Tube holes marked "near wall only" go through one wall; the rest go through both.
3. Tap the holes the legend says to tap (cutting oil, a tap guide or the drill press chuck to start square).
4. Parts marked "x2" or more: mark one, then use it as a drilling jig for the rest (clamp them together).

## Pages

Part | Qty | Pages | Holes
X carriage angle (flat leg, from the heel) | 2 | 2-3 (2) | 5
Top plate, lower | 2 | 4-4 (1) | 7
Top plate, upper | 2 | 5-5 (1) | 5
Beam back plate | 1 | 6-8 (3) | 3
Beam face plate | 1 | 9-11 (3) | 17
Rail bar rear | 2 | 12-13 (2) | 9
Rail bar front | 2 | 14-15 (2) | 8
Upright foot | 2 | 16-17 (2) | 5
Pad BF | 1 | 18-18 (1) | 4
Seat rear | 2 | 19-20 (2) | 4
Pedestal bar rear | 2 | 21-21 (1) | 2
Beam seat | 2 | 22-22 (1) | 5

100 mm

## X carriage angle (flat leg, from the heel) (x2: mark each)

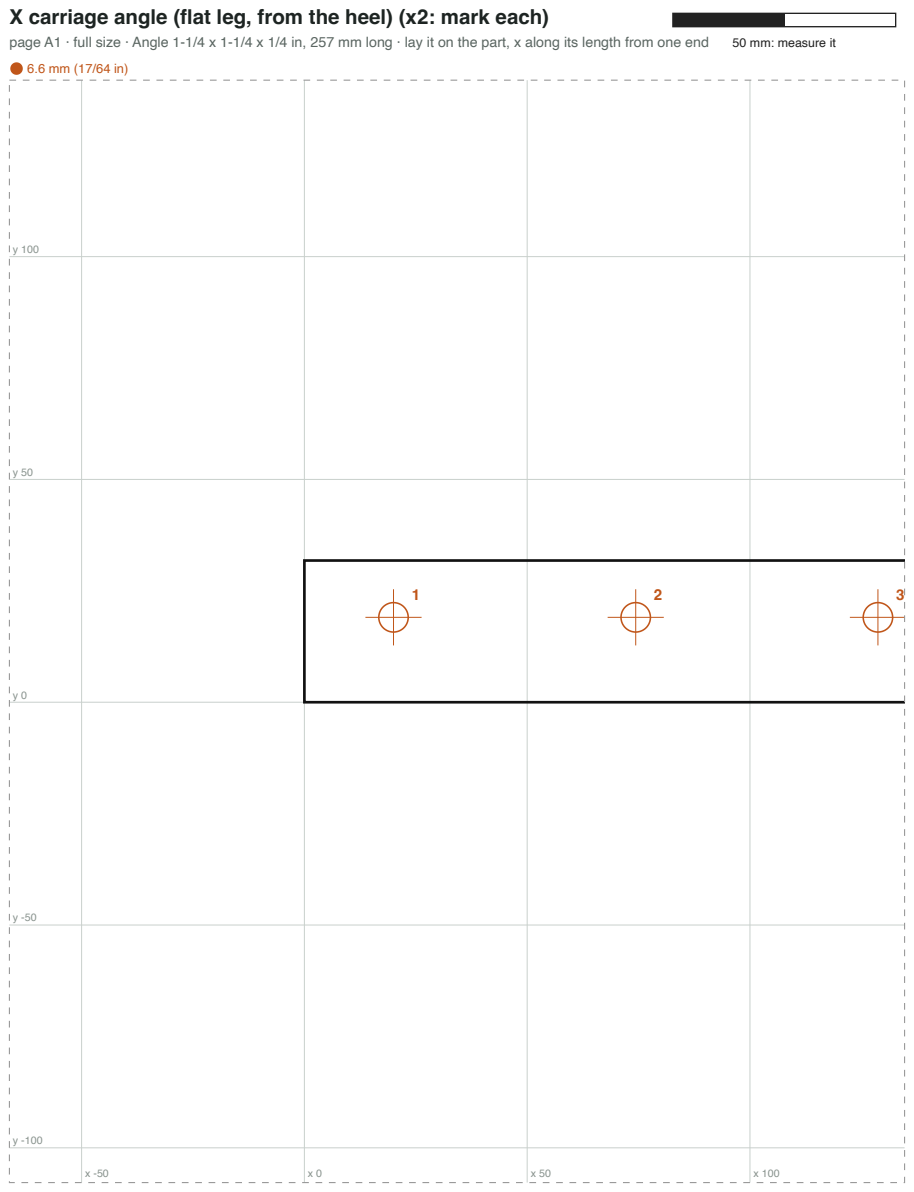
[picture p118: page 2]
page A1 · full size · Angle 1-1/4 x 1-1/4 x 1/4 in, 257 mm long · lay it on the part, x along its length from one end; 50 mm: measure it

## X carriage angle (flat leg, from the heel) (x2: mark each)

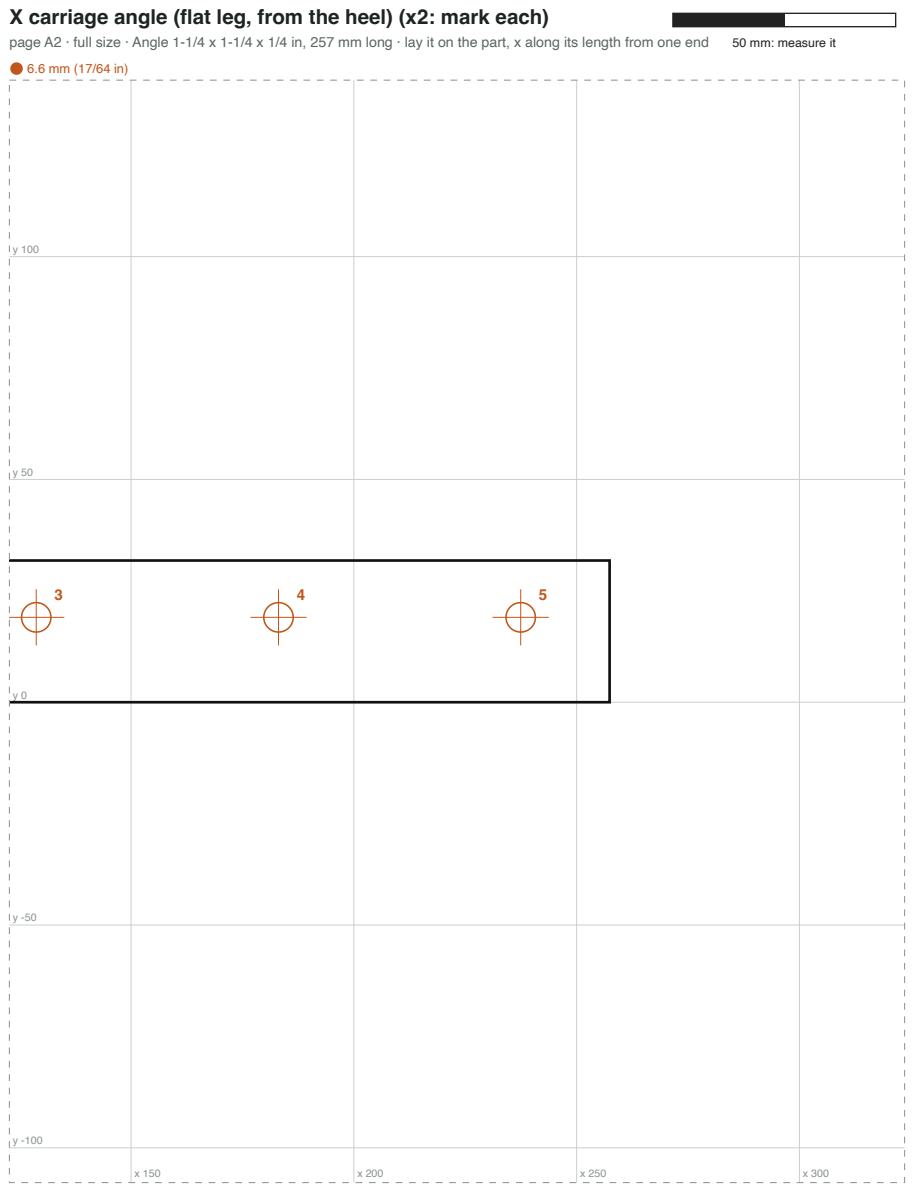
[picture p119: page 3]
page A2 · full size · Angle 1-1/4 x 1-1/4 x 1/4 in, 257 mm long · lay it on the part, x along its length from one end; 50 mm: measure it

## Top plate, lower (x2: mark each)

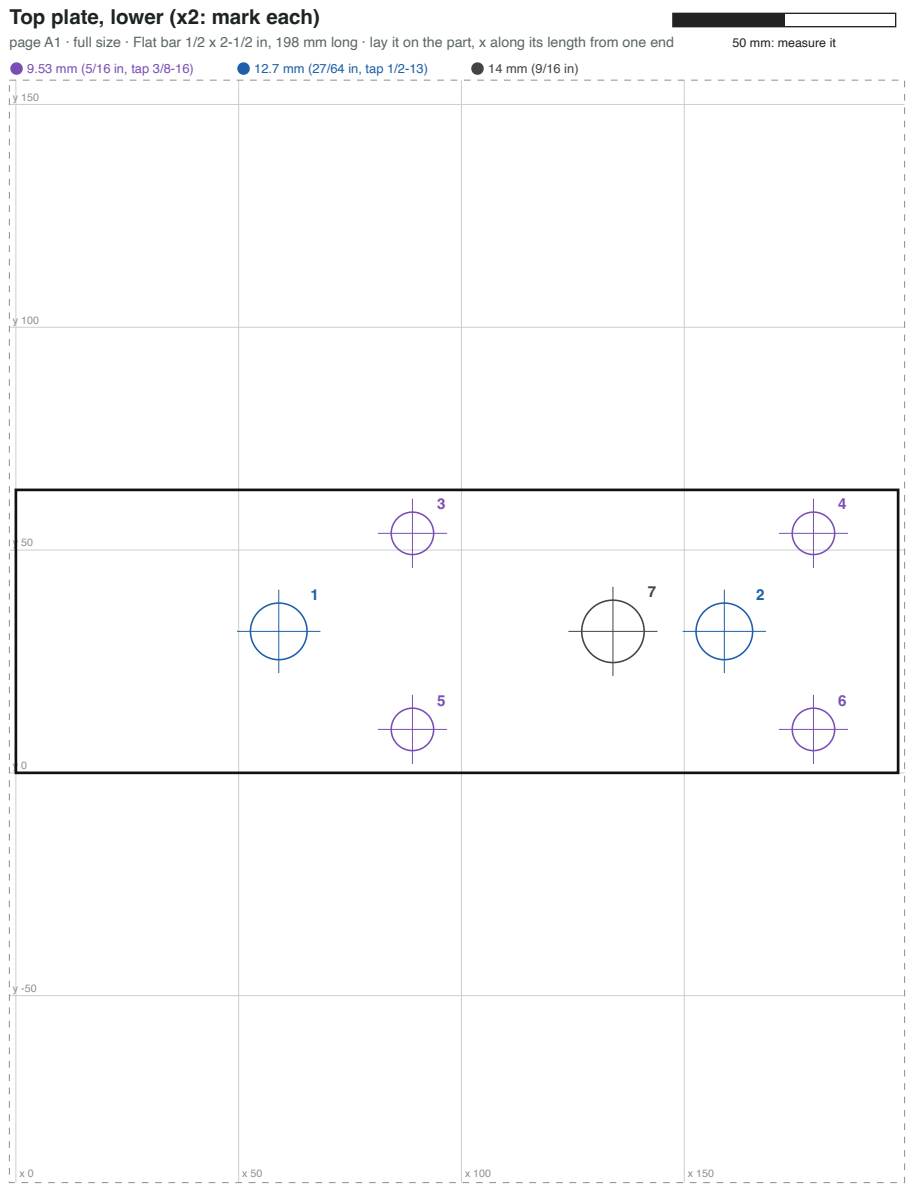
[picture p120: page 4]
page A1 · full size · Flat bar 1/2 x 2-1/2 in, 198 mm long · lay it on the part, x along its length from one end; 50 mm: measure it; 9.53 mm (5/16 in, tap 3/8-16); 12.7 mm (27/64 in, tap 1/2-13)

## Top plate, upper (x2: mark each)

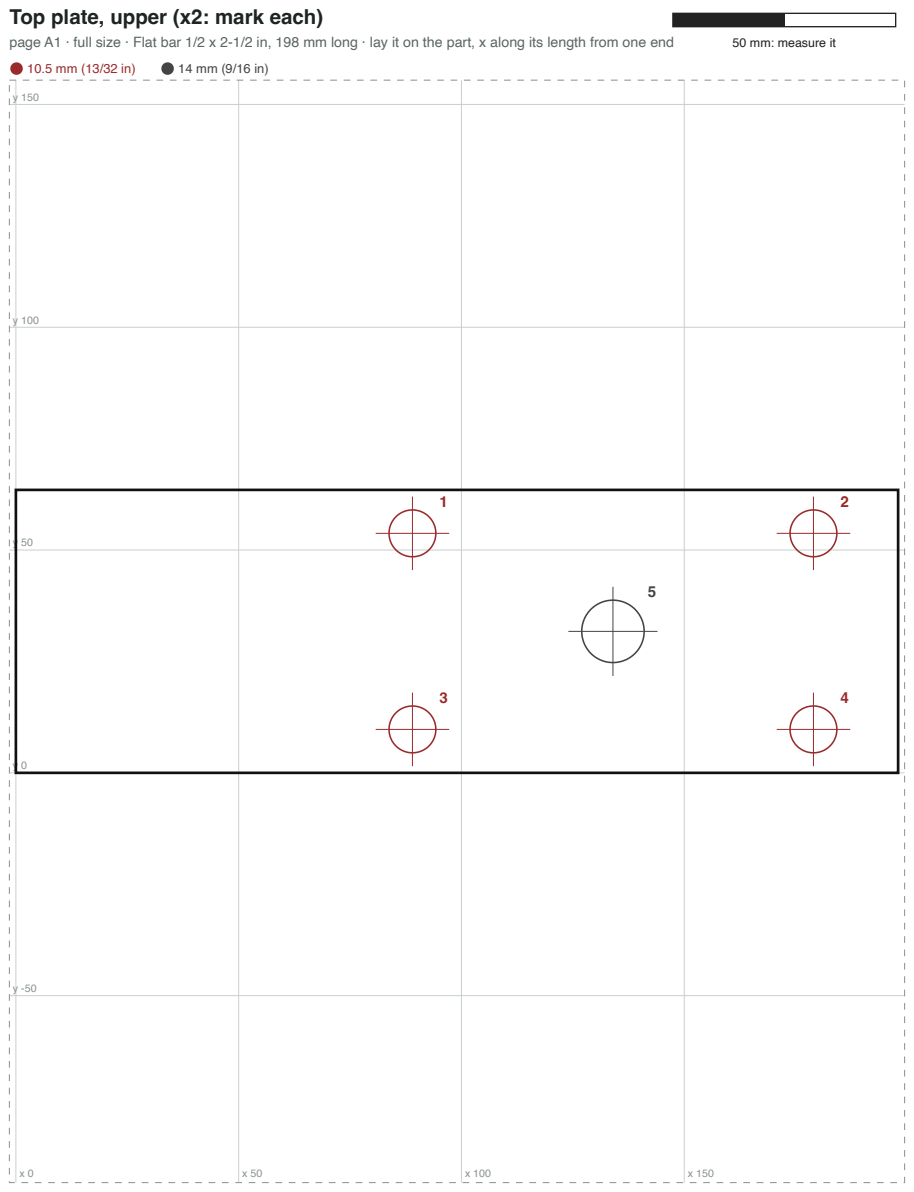
[picture p121: page 5]
page A1 · full size · Flat bar 1/2 x 2-1/2 in, 198 mm long · lay it on the part, x along its length from one end; 50 mm: measure it

## Beam back plate

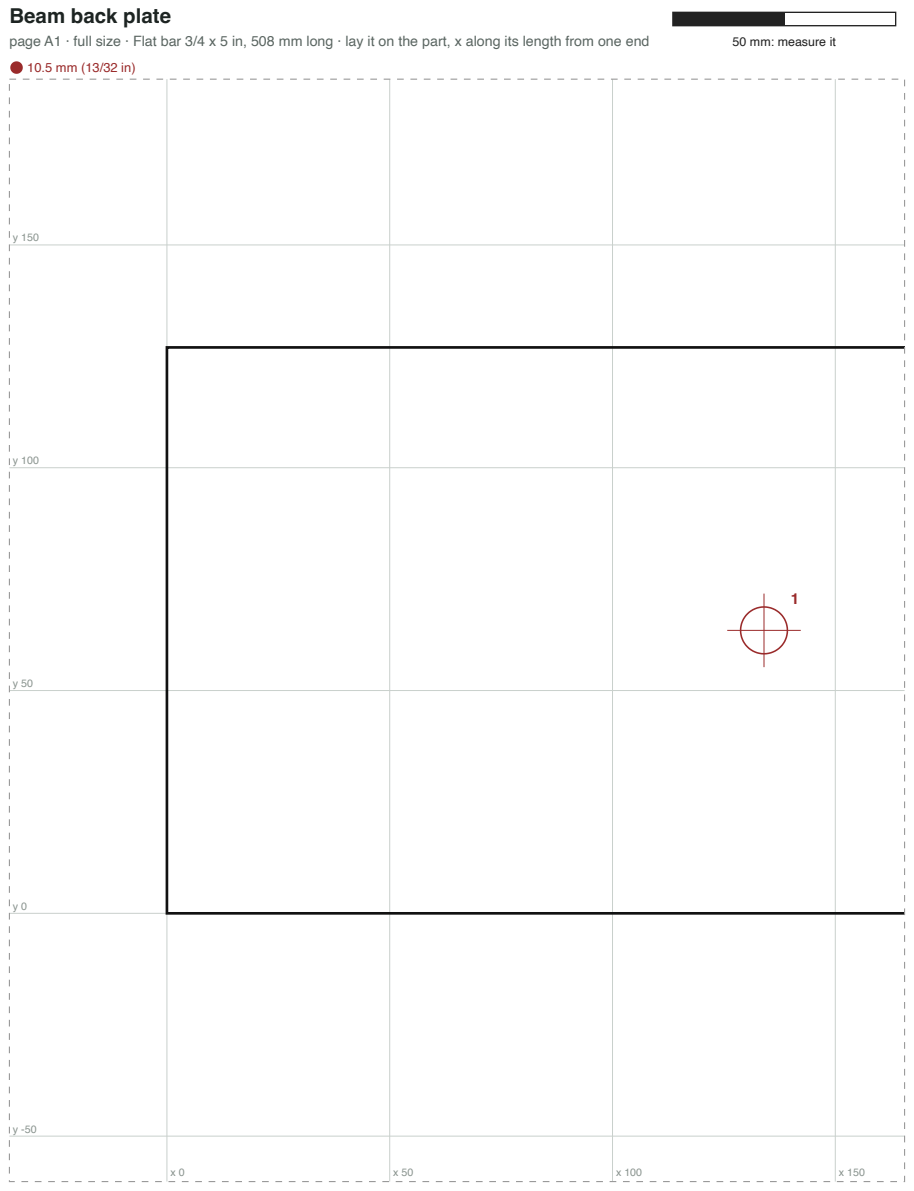
[picture p122: page 6]
page A1 · full size · Flat bar 3/4 x 5 in, 508 mm long · lay it on the part, x along its length from one end; 50 mm: measure it

## Beam back plate

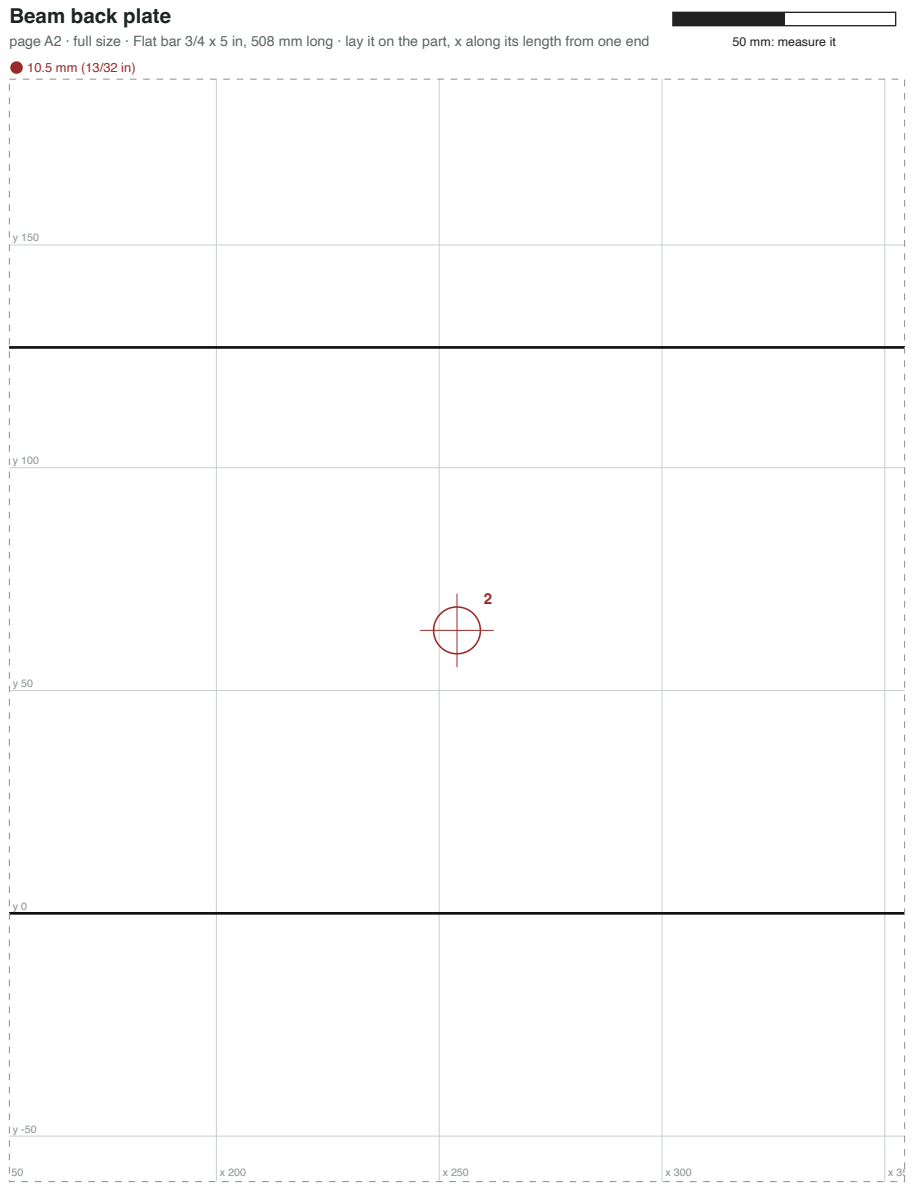
[picture p123: page 7]
page A2 · full size · Flat bar 3/4 x 5 in, 508 mm long · lay it on the part, x along its length from one end; 50 mm: measure it

## Beam back plate

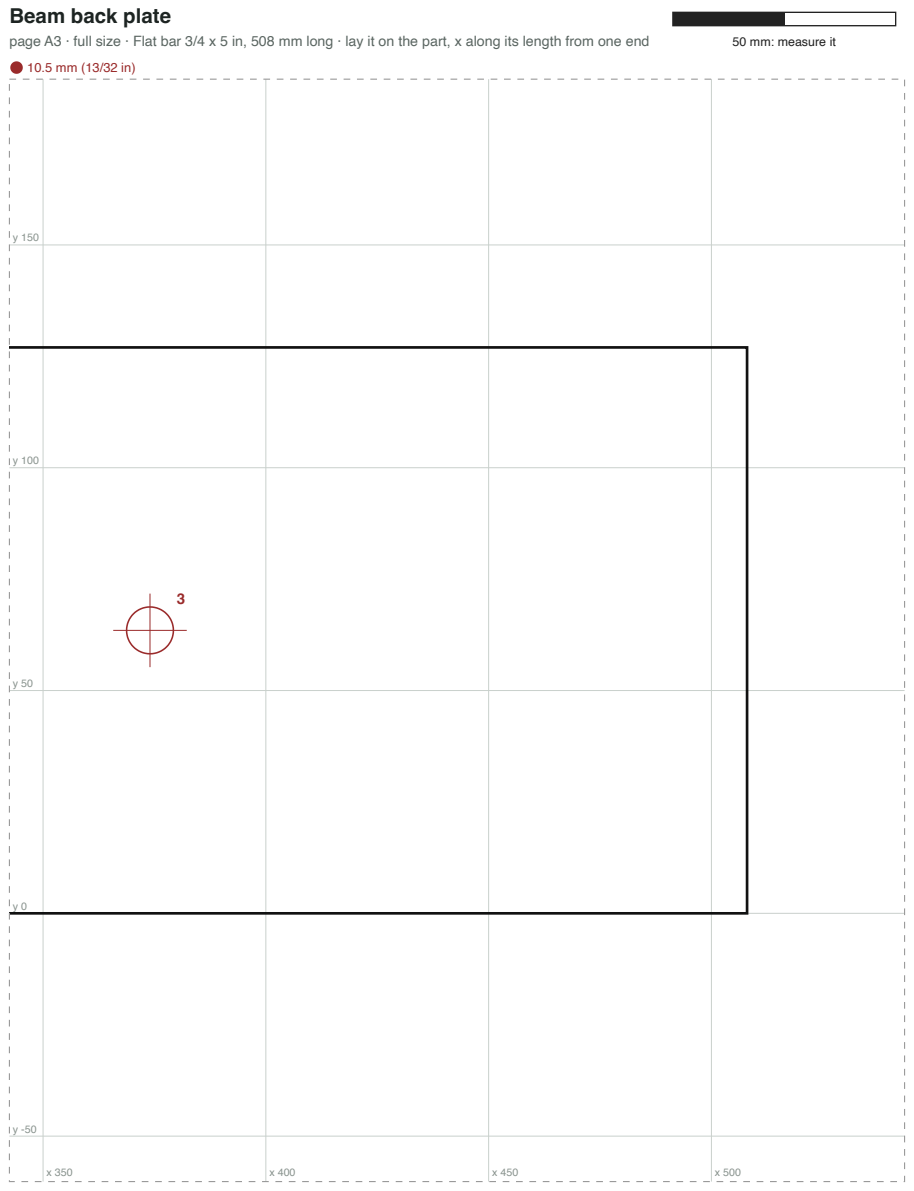
[picture p124: page 8]
page A3 · full size · Flat bar 3/4 x 5 in, 508 mm long · lay it on the part, x along its length from one end; 50 mm: measure it

## Beam face plate

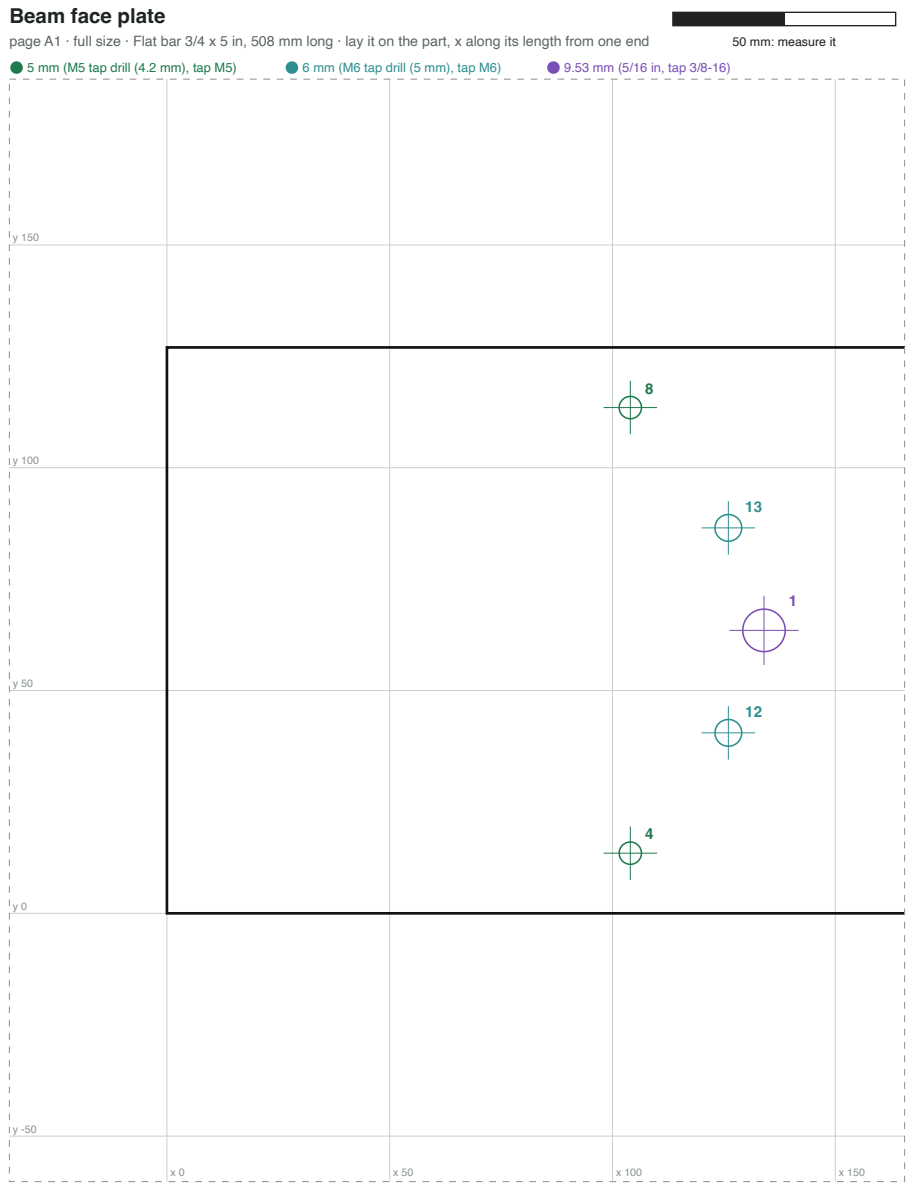
[picture p125: page 9]
page A1 · full size · Flat bar 3/4 x 5 in, 508 mm long · lay it on the part, x along its length from one end; 50 mm: measure it; 5 mm (M5 tap drill (4.2 mm), tap M5); 6 mm (M6 tap drill (5 mm), tap M6); 9.53 mm (5/16 in, tap 3/8-16)

## Beam face plate

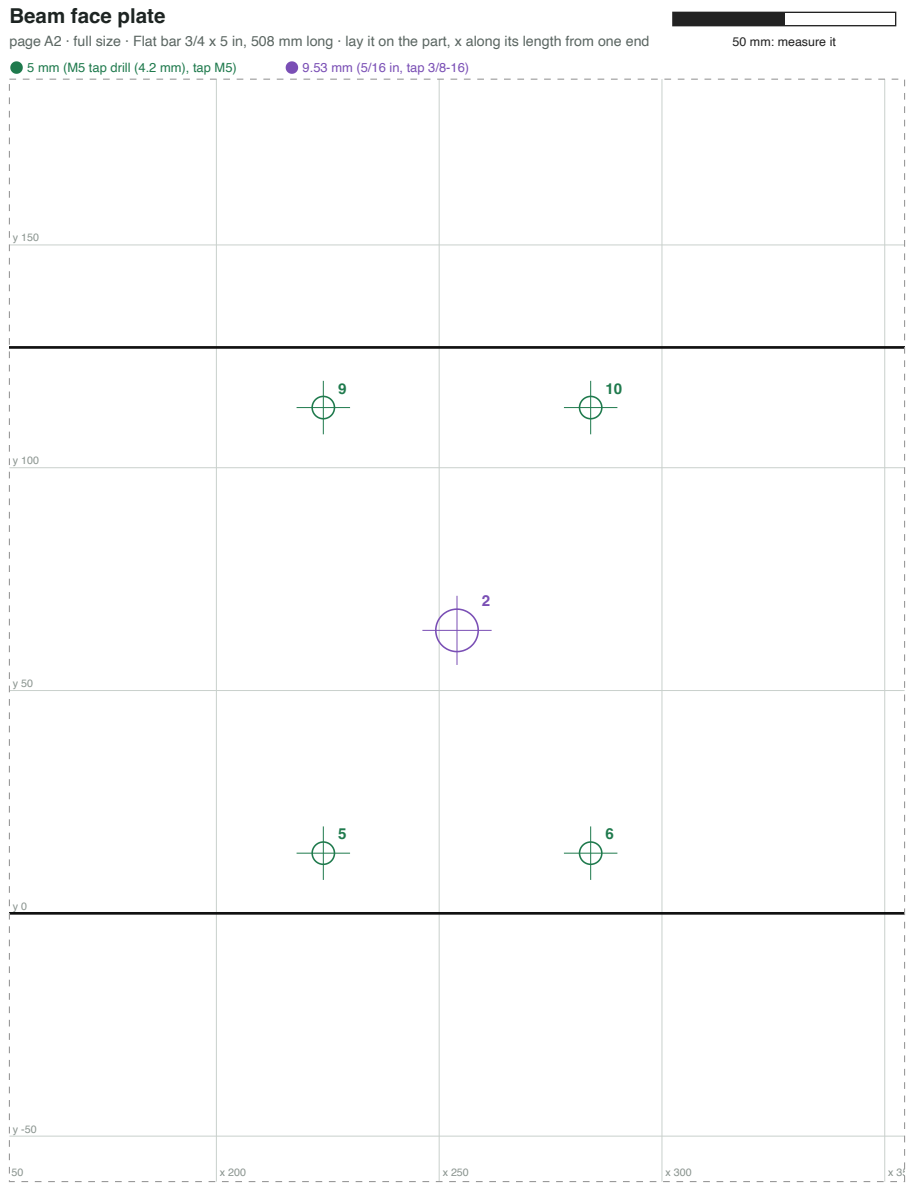
[picture p126: page 10]
page A2 · full size · Flat bar 3/4 x 5 in, 508 mm long · lay it on the part, x along its length from one end; 50 mm: measure it; 5 mm (M5 tap drill (4.2 mm), tap M5); 9.53 mm (5/16 in, tap 3/8-16)

## Beam face plate

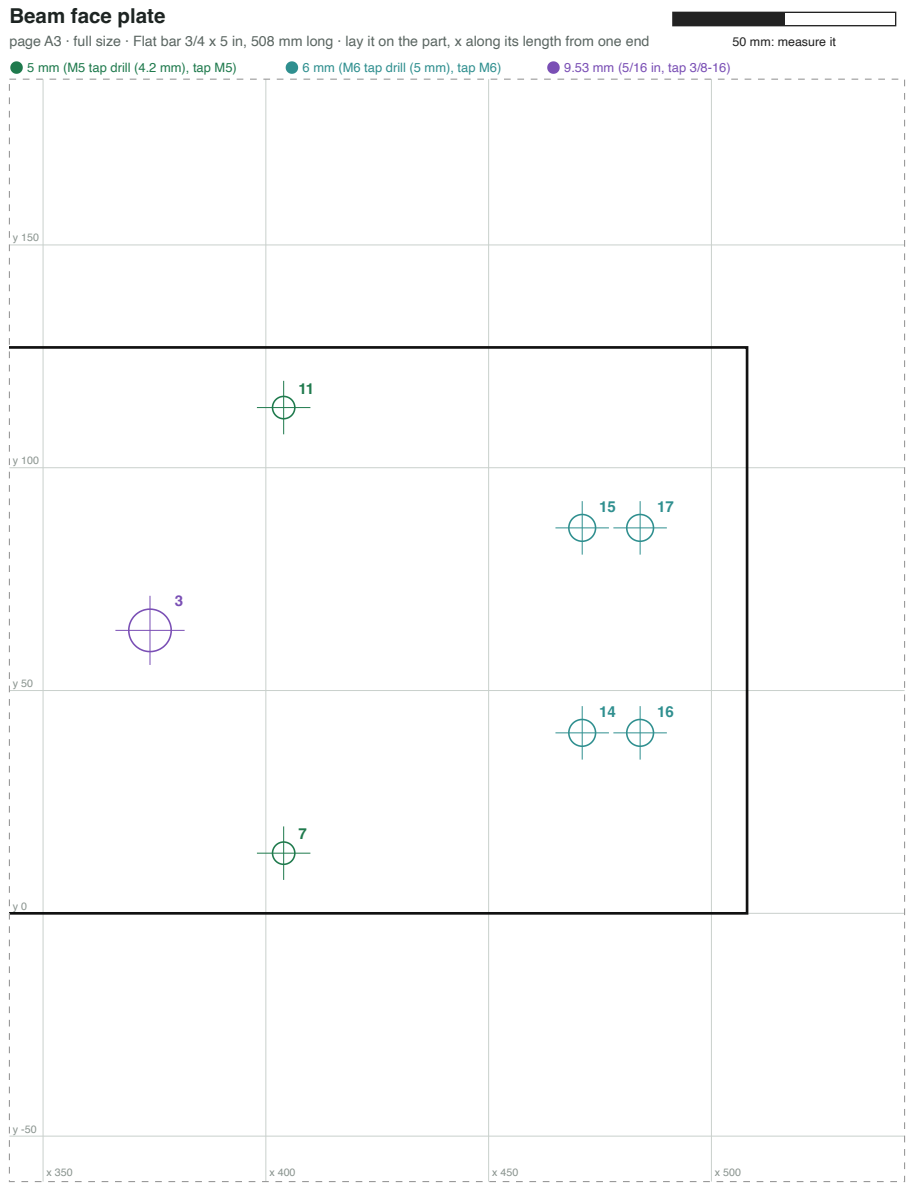
[picture p127: page 11]
page A3 · full size · Flat bar 3/4 x 5 in, 508 mm long · lay it on the part, x along its length from one end; 50 mm: measure it; 5 mm (M5 tap drill (4.2 mm), tap M5); 6 mm (M6 tap drill (5 mm), tap M6); 9.53 mm (5/16 in, tap 3/8-16)

## Rail bar rear (x2: mark each)

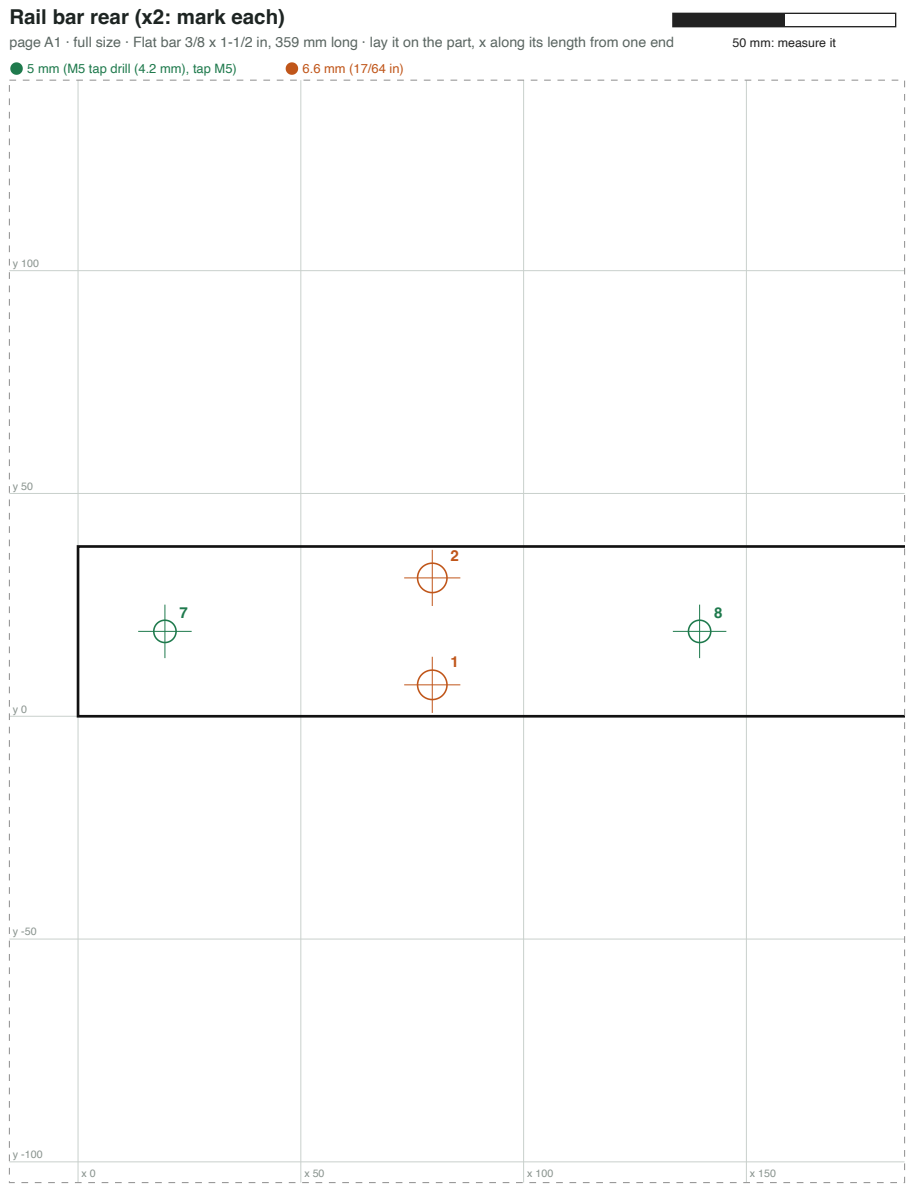
[picture p128: page 12]
page A1 · full size · Flat bar 3/8 x 1-1/2 in, 359 mm long · lay it on the part, x along its length from one end; 50 mm: measure it; 5 mm (M5 tap drill (4.2 mm), tap M5)

## Rail bar rear (x2: mark each)

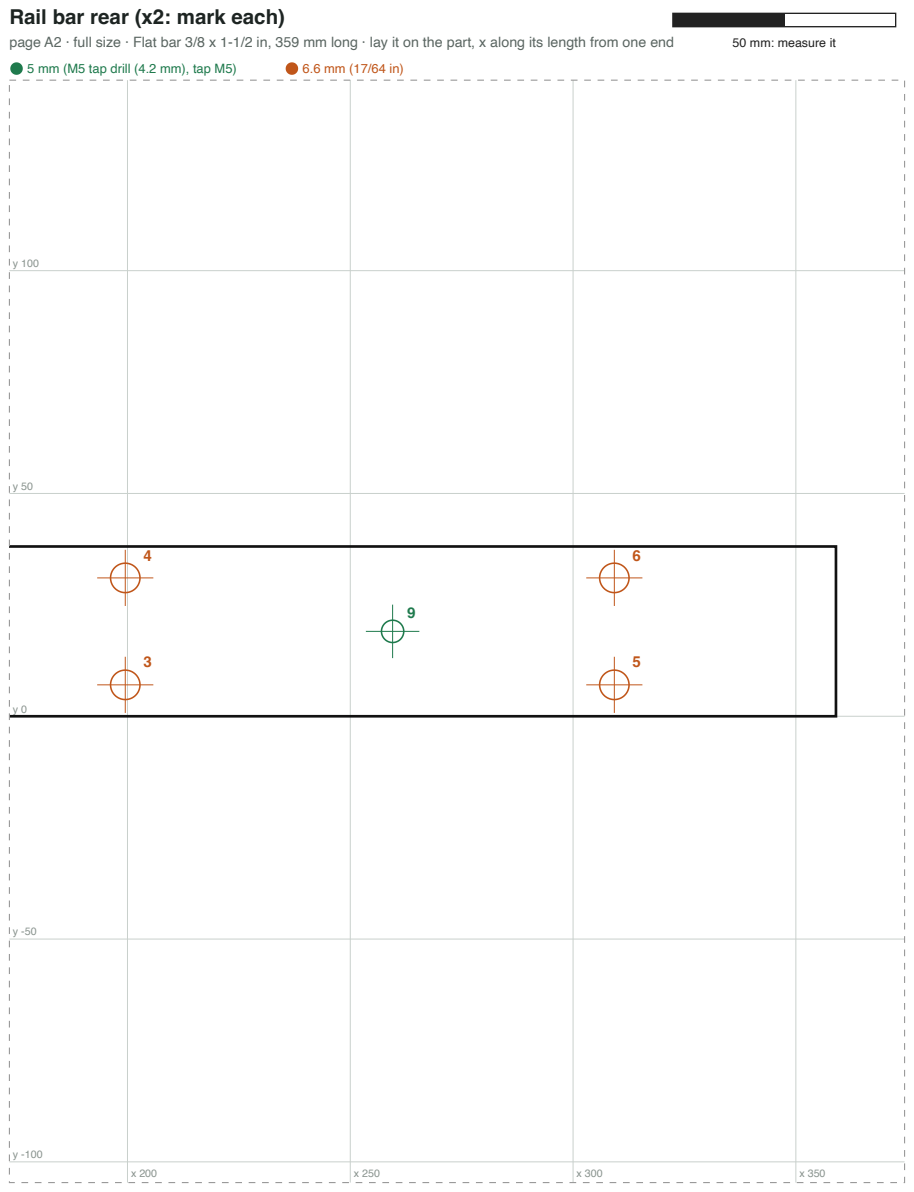
[picture p129: page 13]
page A2 · full size · Flat bar 3/8 x 1-1/2 in, 359 mm long · lay it on the part, x along its length from one end; 50 mm: measure it; 5 mm (M5 tap drill (4.2 mm), tap M5)

## Rail bar front (x2: mark each)

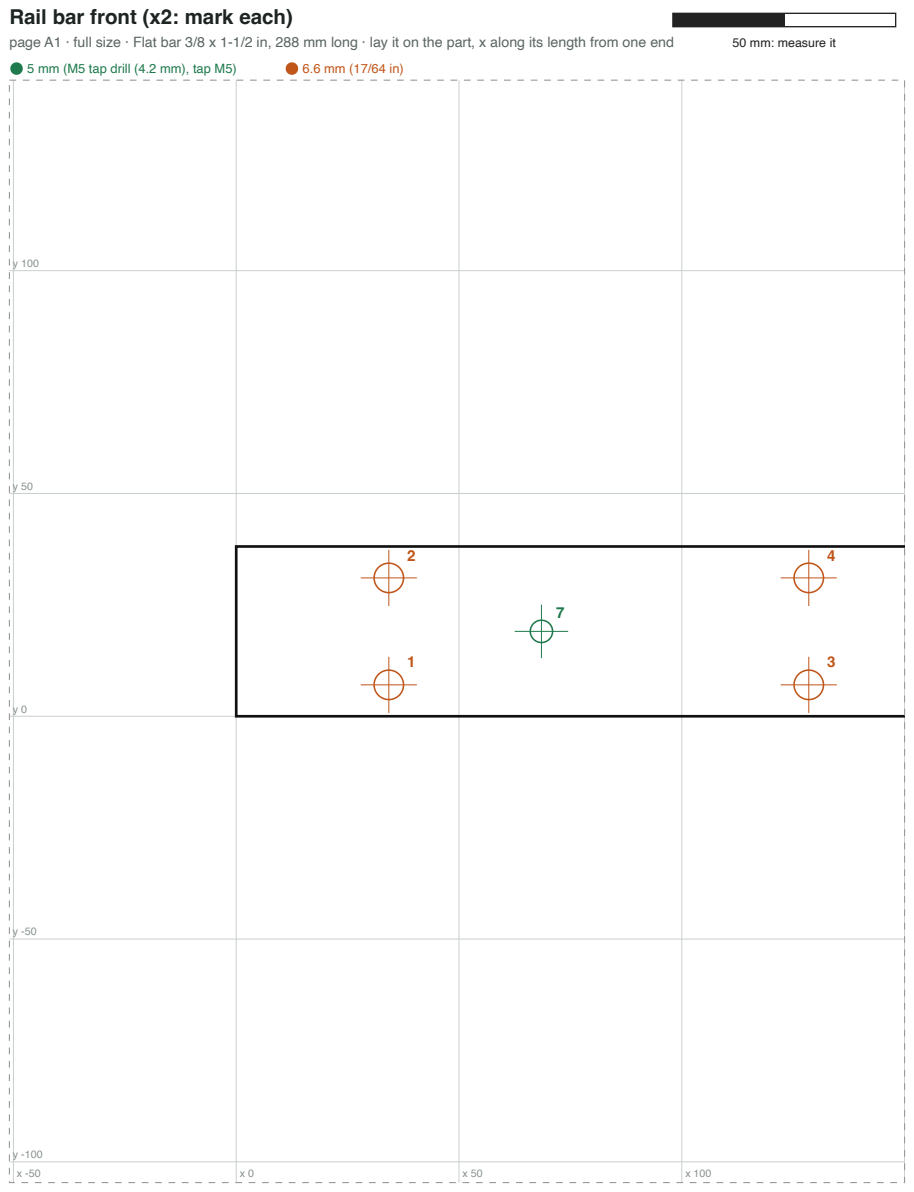
[picture p130: page 14]
page A1 · full size · Flat bar 3/8 x 1-1/2 in, 288 mm long · lay it on the part, x along its length from one end; 50 mm: measure it; 5 mm (M5 tap drill (4.2 mm), tap M5)

## Rail bar front (x2: mark each)

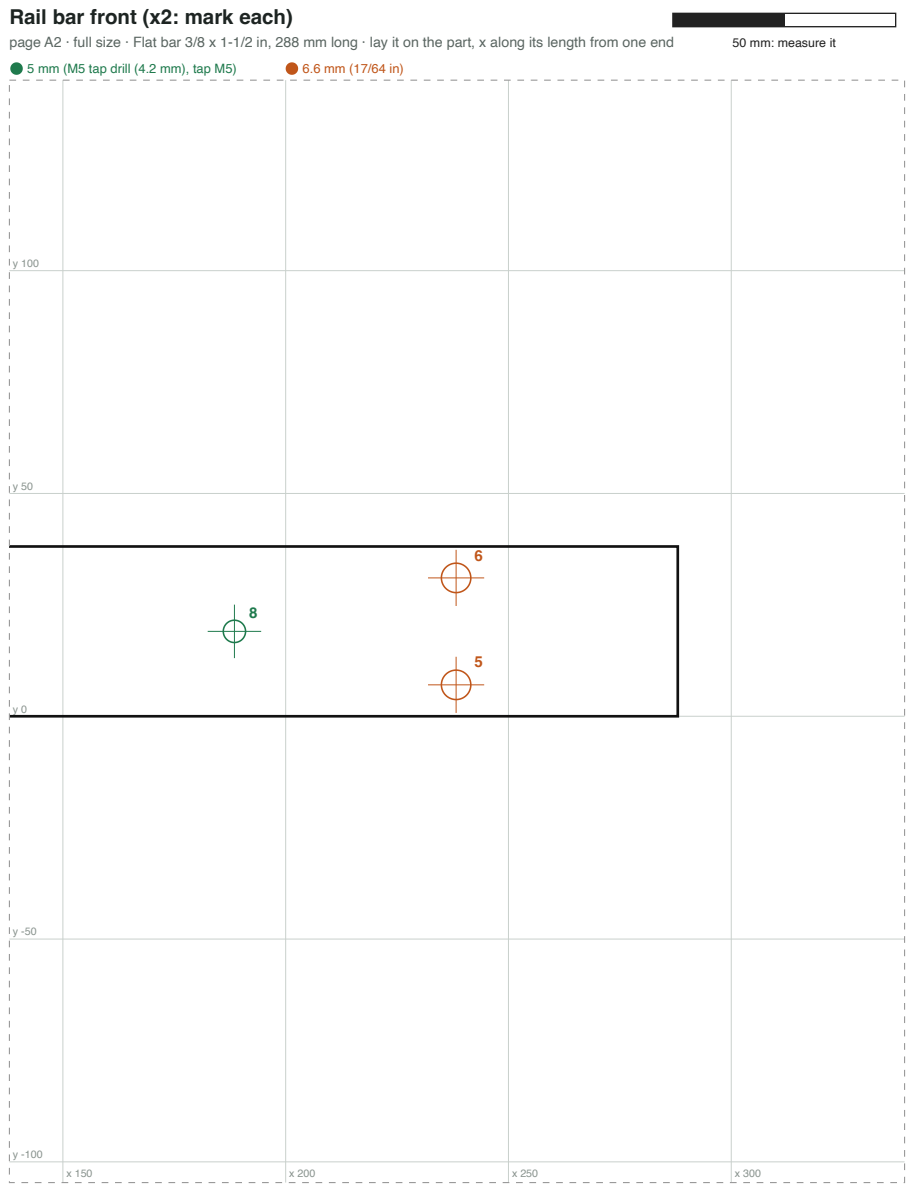
[picture p131: page 15]
page A2 · full size · Flat bar 3/8 x 1-1/2 in, 288 mm long · lay it on the part, x along its length from one end; 50 mm: measure it; 5 mm (M5 tap drill (4.2 mm), tap M5)

## Upright foot (x2: mark each)

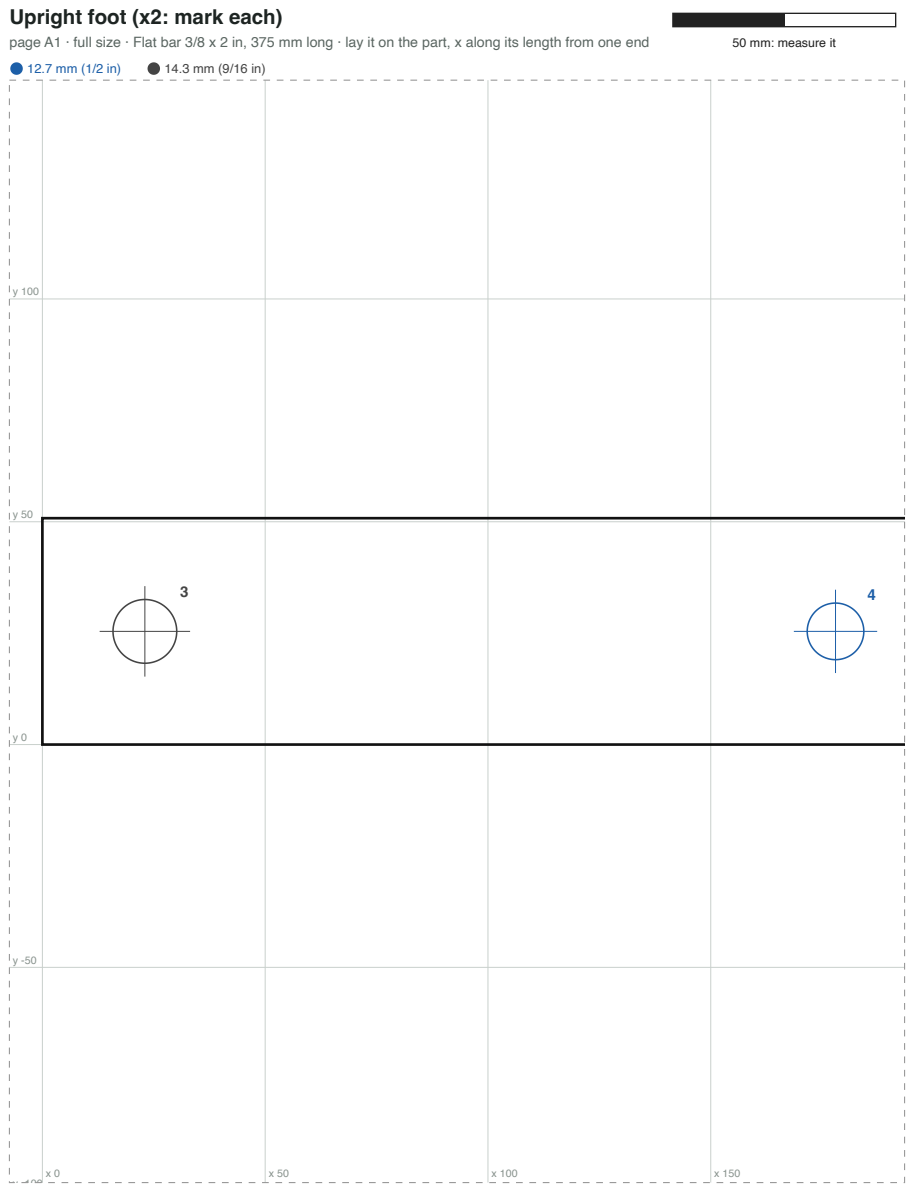
[picture p132: page 16]
page A1 · full size · Flat bar 3/8 x 2 in, 375 mm long · lay it on the part, x along its length from one end; 50 mm: measure it

## Upright foot (x2: mark each)

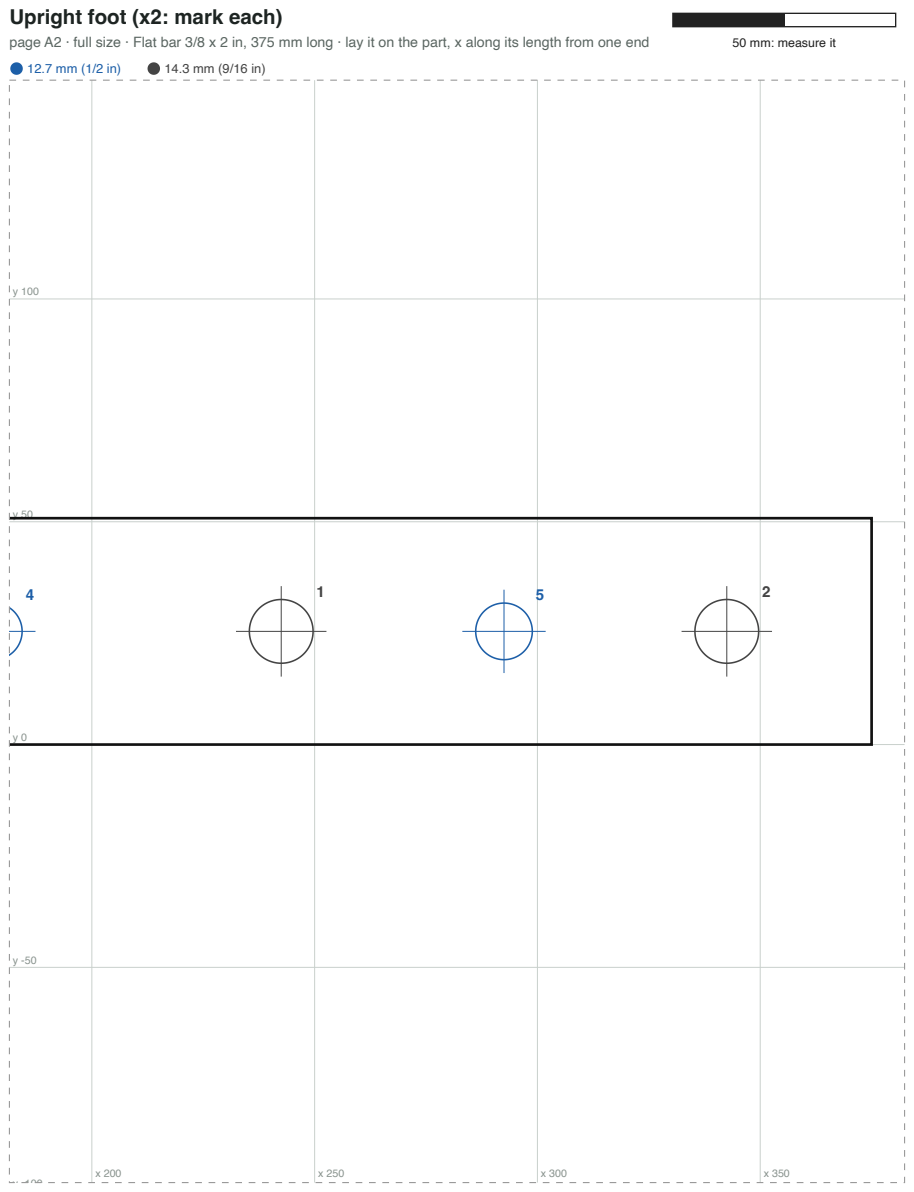
[picture p133: page 17]
page A2 · full size · Flat bar 3/8 x 2 in, 375 mm long · lay it on the part, x along its length from one end; 50 mm: measure it

## Pad BF

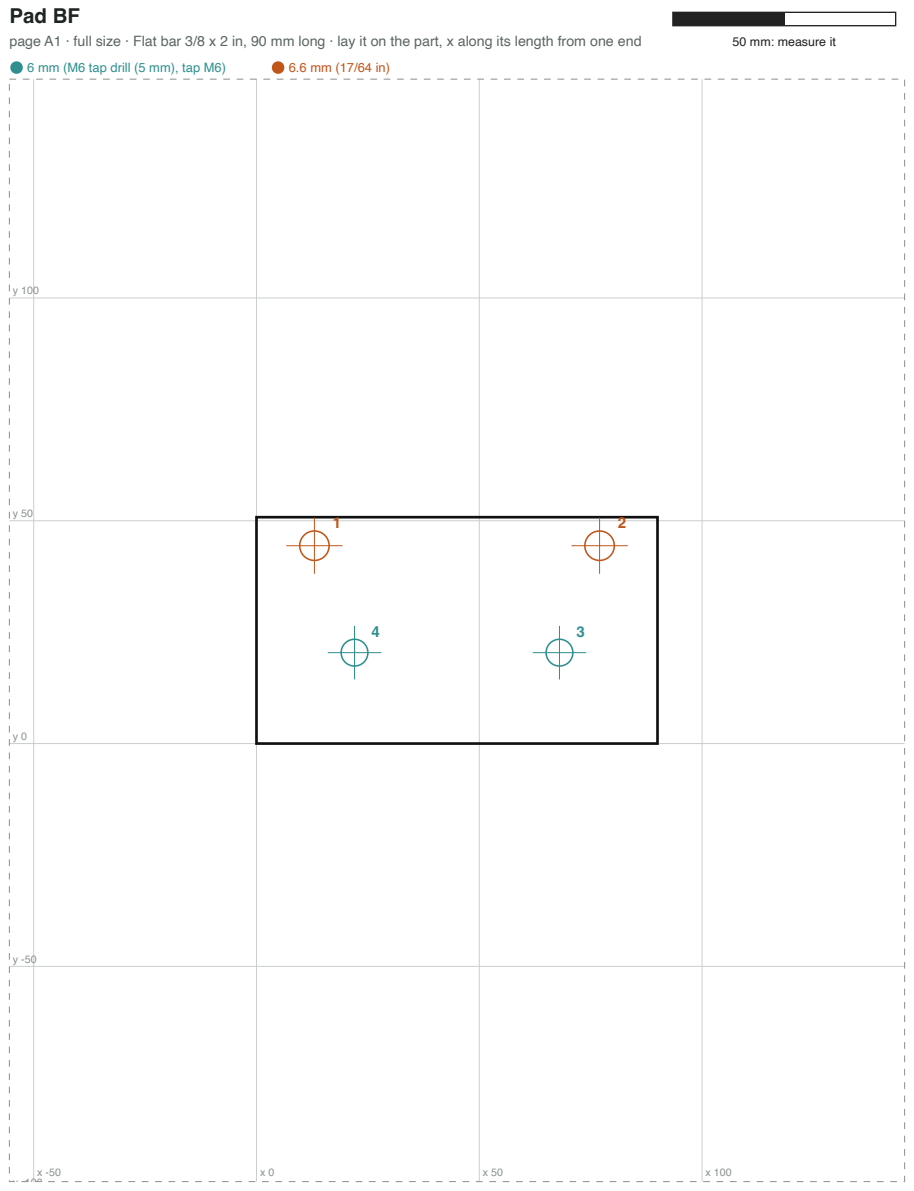
[picture p134: page 18]
page A1 · full size · Flat bar 3/8 x 2 in, 90 mm long · lay it on the part, x along its length from one end; 50 mm: measure it; 6 mm (M6 tap drill (5 mm), tap M6)

## Seat rear (x2: mark each)

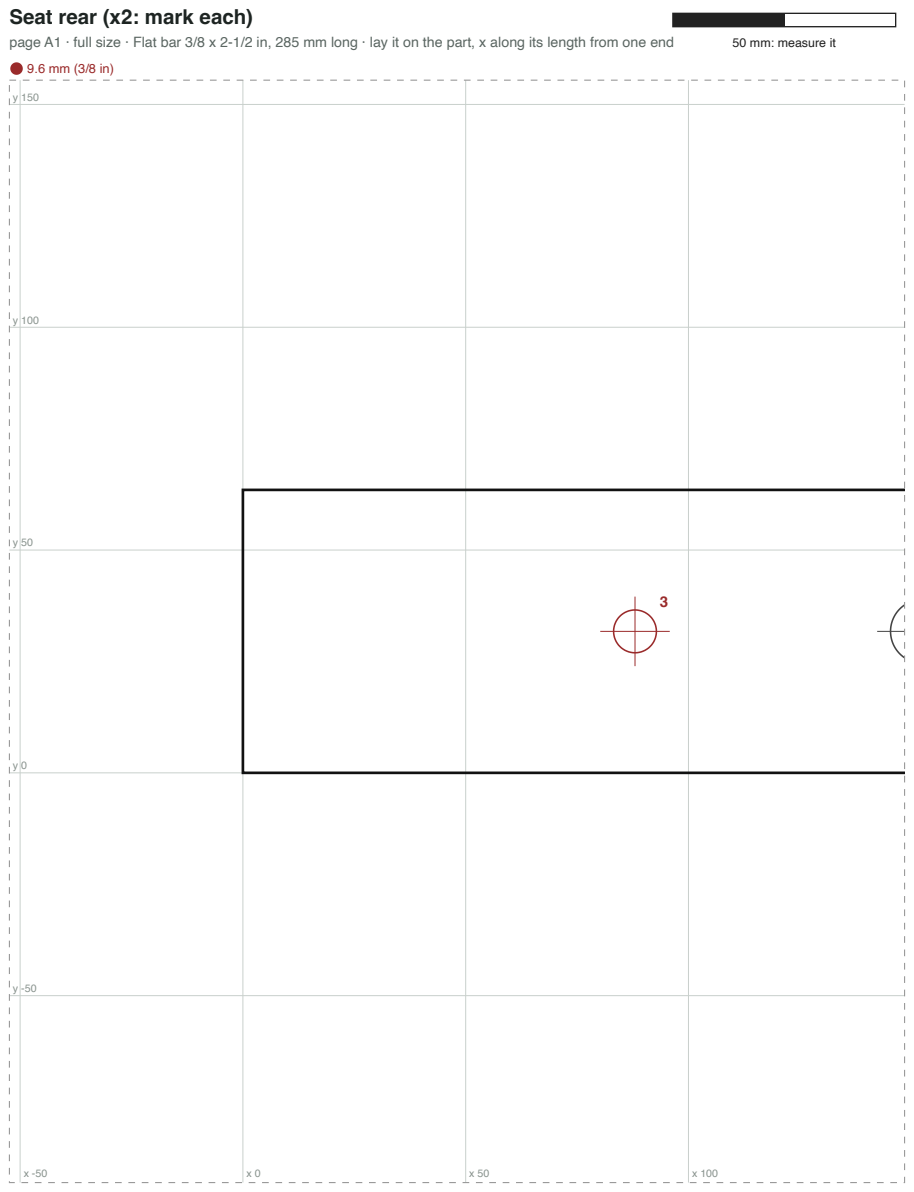
[picture p135: page 19]
page A1 · full size · Flat bar 3/8 x 2-1/2 in, 285 mm long · lay it on the part, x along its length from one end; 50 mm: measure it

## Seat rear (x2: mark each)

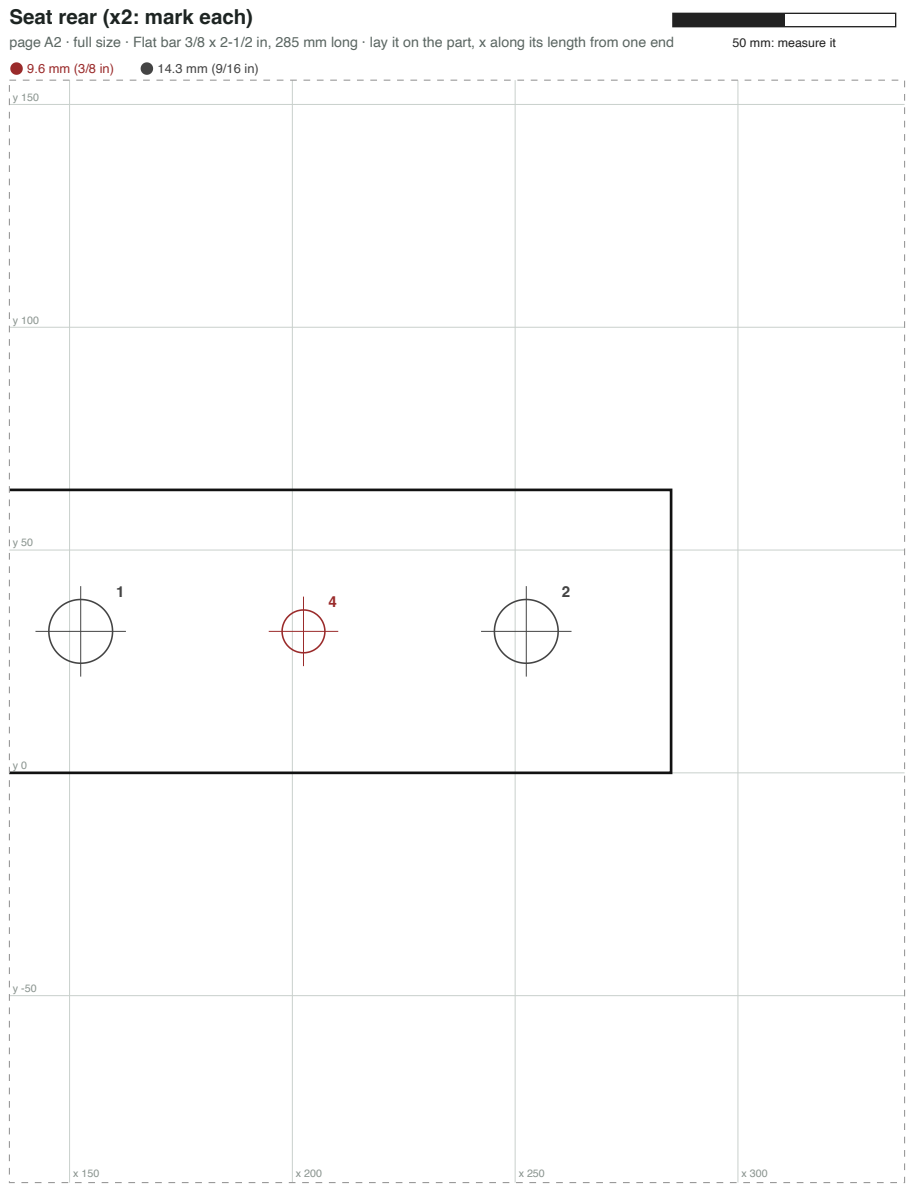
[picture p136: page 20]
page A2 · full size · Flat bar 3/8 x 2-1/2 in, 285 mm long · lay it on the part, x along its length from one end; 50 mm: measure it

## Pedestal bar rear (x2: mark each)

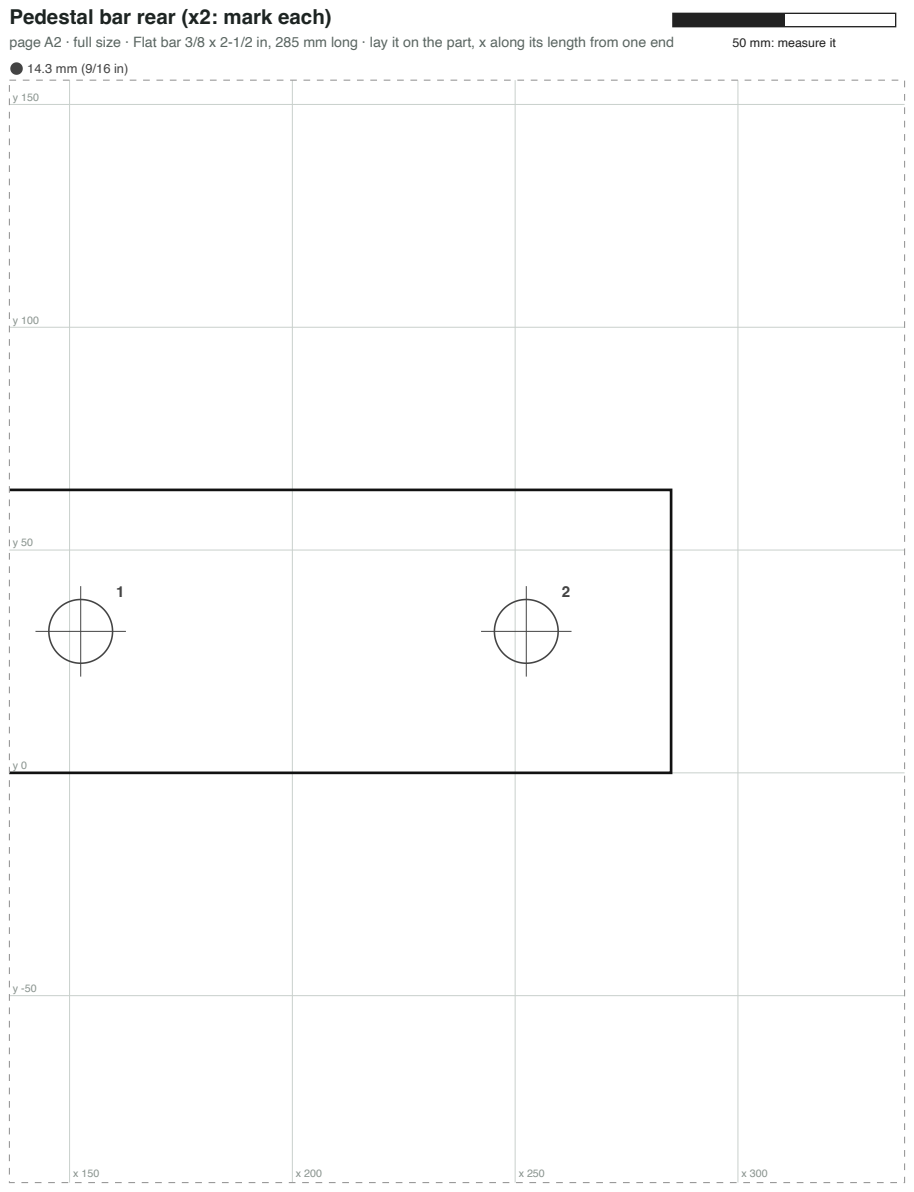
[picture p137: page 21]
page A2 · full size · Flat bar 3/8 x 2-1/2 in, 285 mm long · lay it on the part, x along its length from one end; 50 mm: measure it

## Beam seat (x2: mark each)

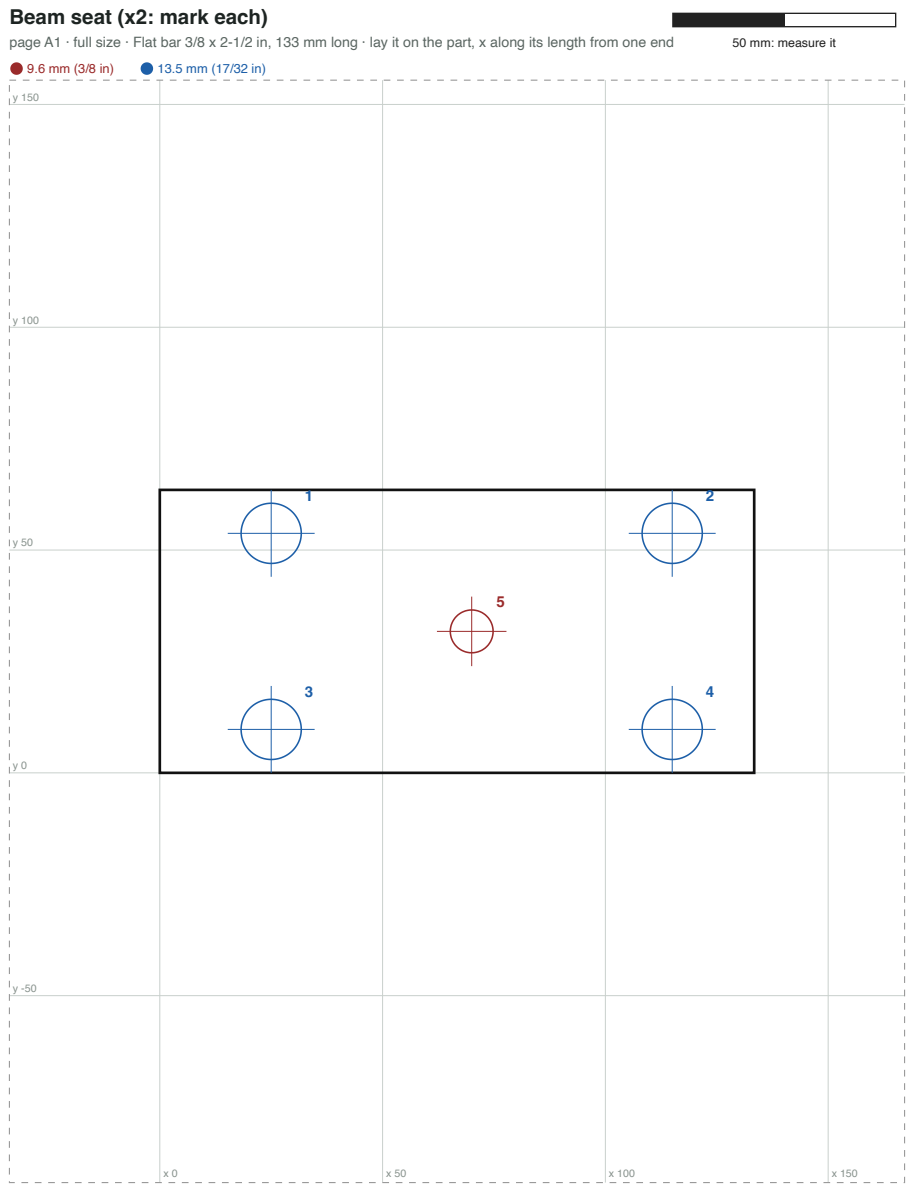
[picture p138: page 22]
page A1 · full size · Flat bar 3/8 x 2-1/2 in, 133 mm long · lay it on the part, x along its length from one end; 50 mm: measure it

## Beam cap (x2: mark each)

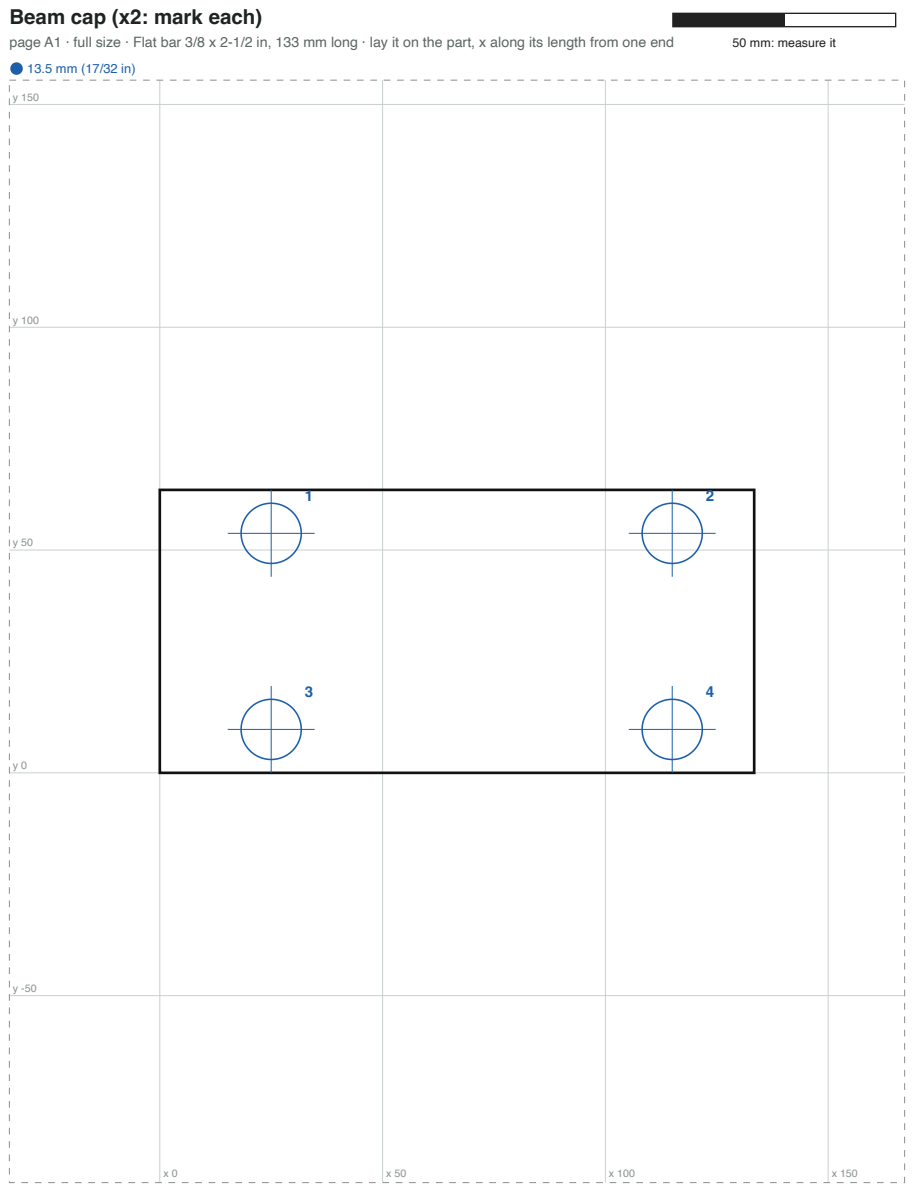
[picture p139: page 23]
page A1 · full size · Flat bar 3/8 x 2-1/2 in, 133 mm long · lay it on the part, x along its length from one end; 50 mm: measure it

## Girder end (x4: mark each)

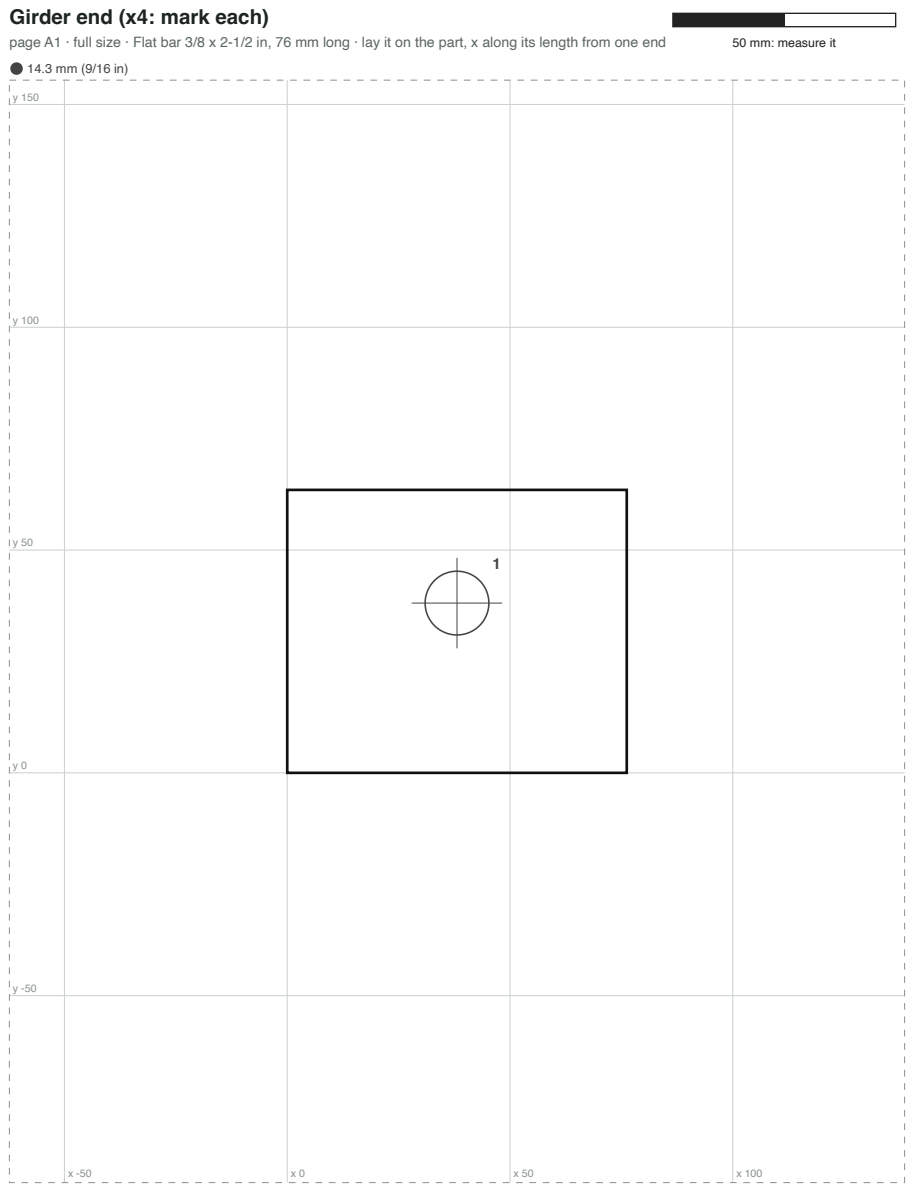
[picture p140: page 24]
page A1 · full size · Flat bar 3/8 x 2-1/2 in, 76 mm long · lay it on the part, x along its length from one end; 50 mm: measure it

## Girder end split (x4: mark each)

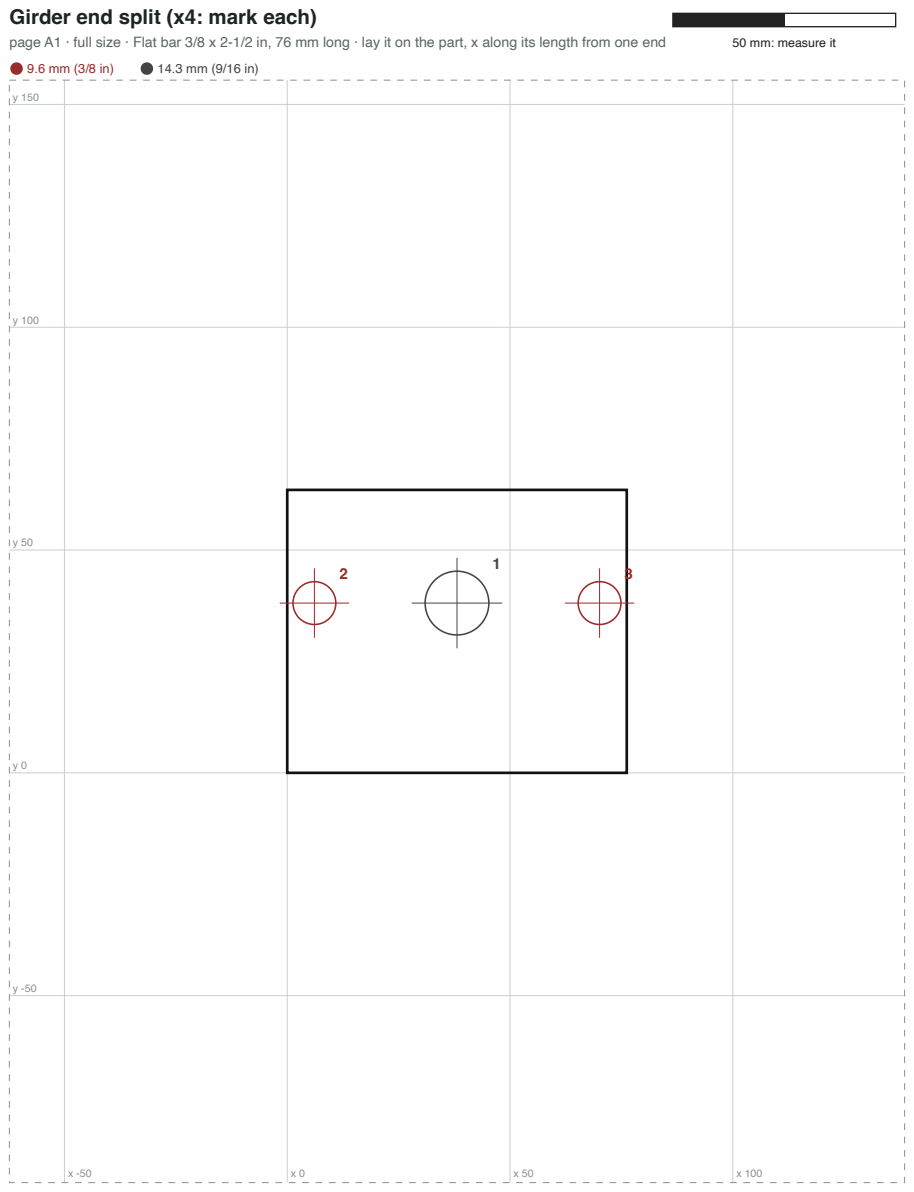
[picture p141: page 25]
page A1 · full size · Flat bar 3/8 x 2-1/2 in, 76 mm long · lay it on the part, x along its length from one end; 50 mm: measure it

## Pedestal bar / seat front (x4: mark each)

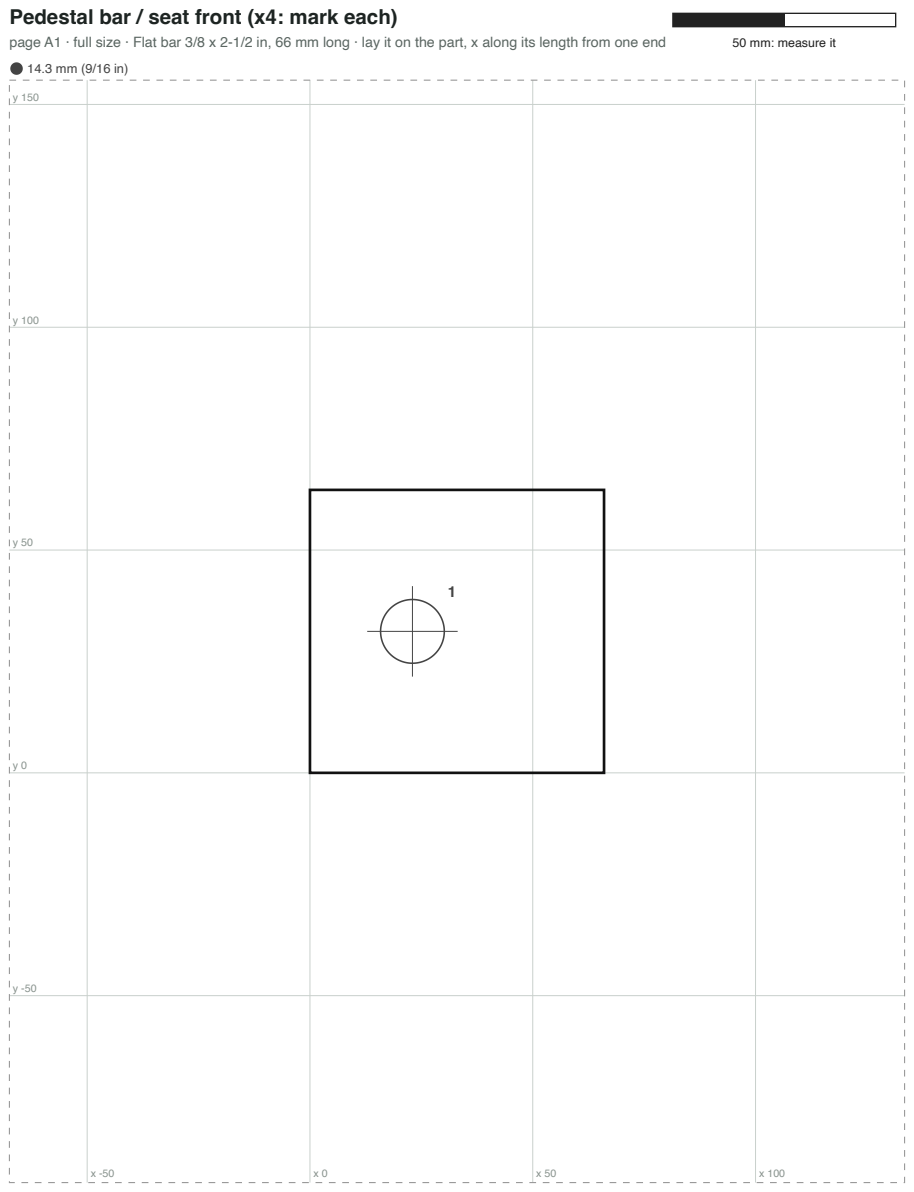
[picture p142: page 26]
page A1 · full size · Flat bar 3/8 x 2-1/2 in, 66 mm long · lay it on the part, x along its length from one end; 50 mm: measure it

## Pad BK

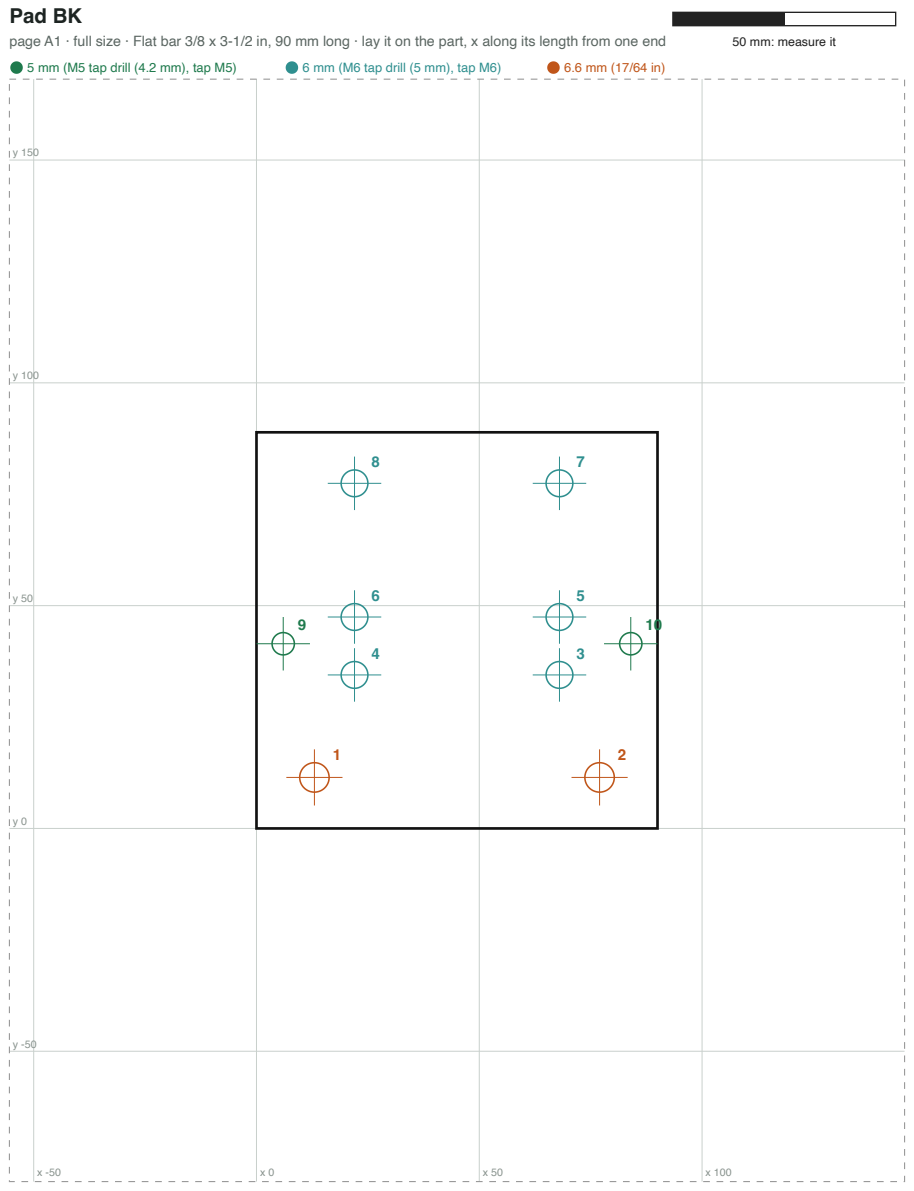
[picture p143: page 27]
page A1 · full size · Flat bar 3/8 x 3-1/2 in, 90 mm long · lay it on the part, x along its length from one end; 50 mm: measure it; 5 mm (M5 tap drill (4.2 mm), tap M5); 6 mm (M6 tap drill (5 mm), tap M6)

## Girder rear (z-face) (x2: mark each)

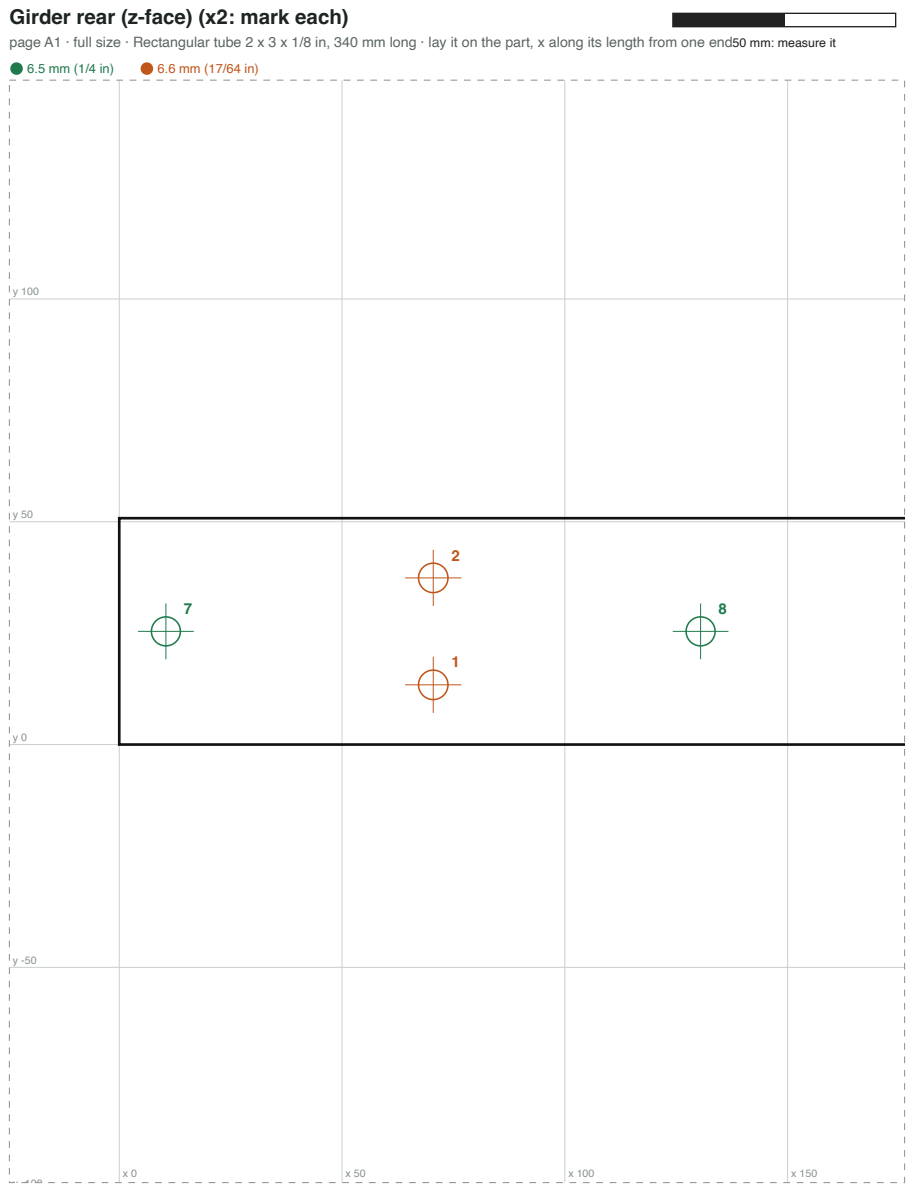
[picture p144: page 28]

page A1 · full size · Rectangular tube 2 x 3 x 1/8 in, 340 mm long · lay it on the part, x along its length from one end50 mm: measure it

## Girder rear (z-face) (x2: mark each)

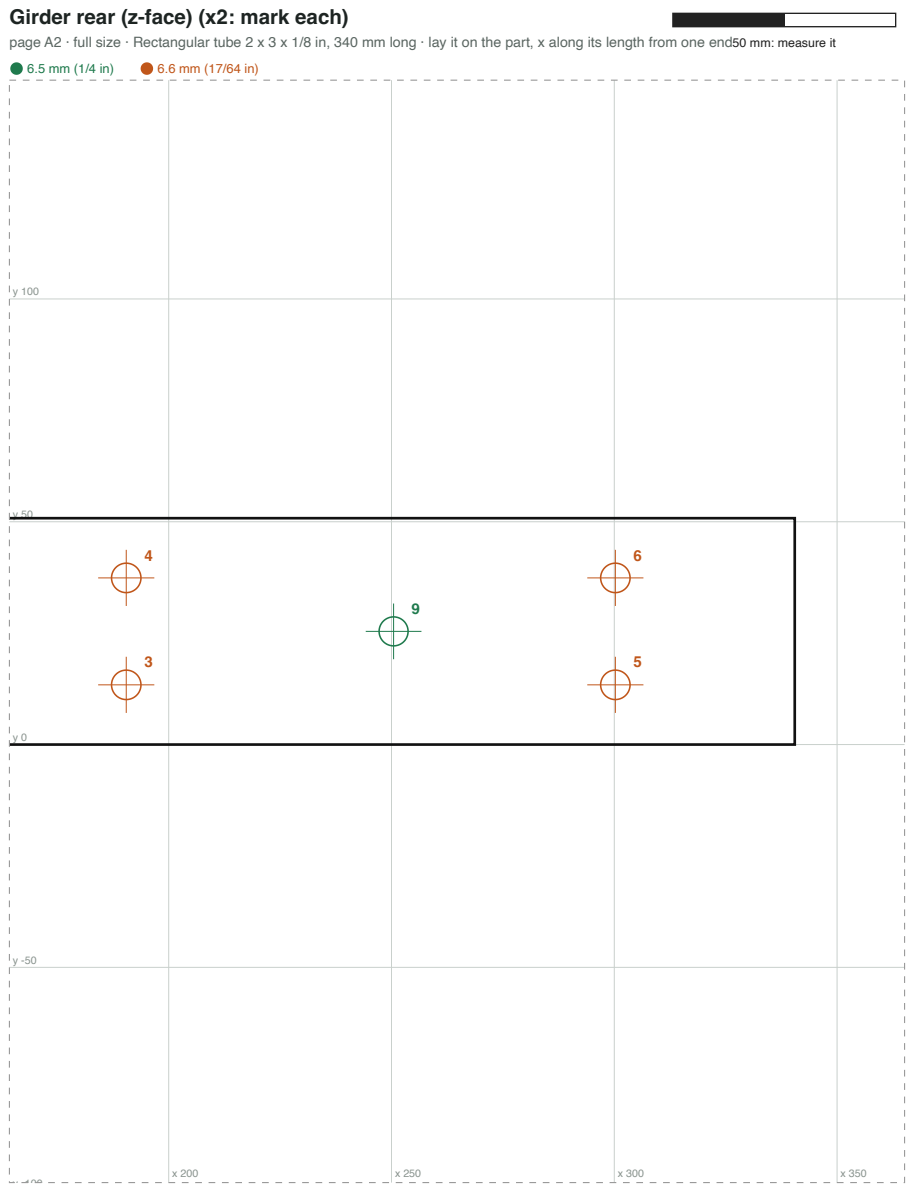
[picture p145: page 29]

page A2 · full size · Rectangular tube 2 x 3 x 1/8 in, 340 mm long · lay it on the part, x along its length from one end50 mm: measure it

## Girder rear (x-face) (x2: mark each)

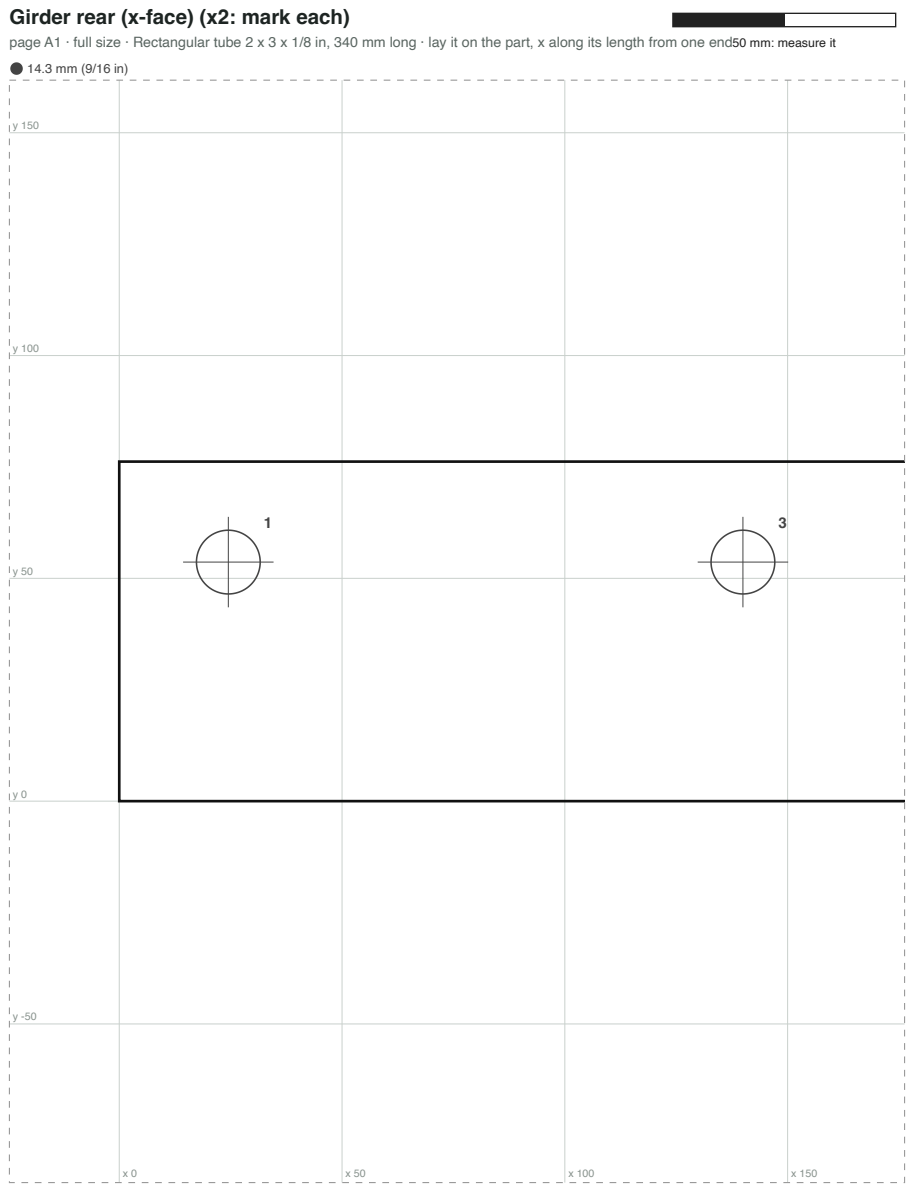
[picture p146: page 30]

page A1 · full size · Rectangular tube 2 x 3 x 1/8 in, 340 mm long · lay it on the part, x along its length from one end50 mm: measure it

## Girder rear (x-face) (x2: mark each)

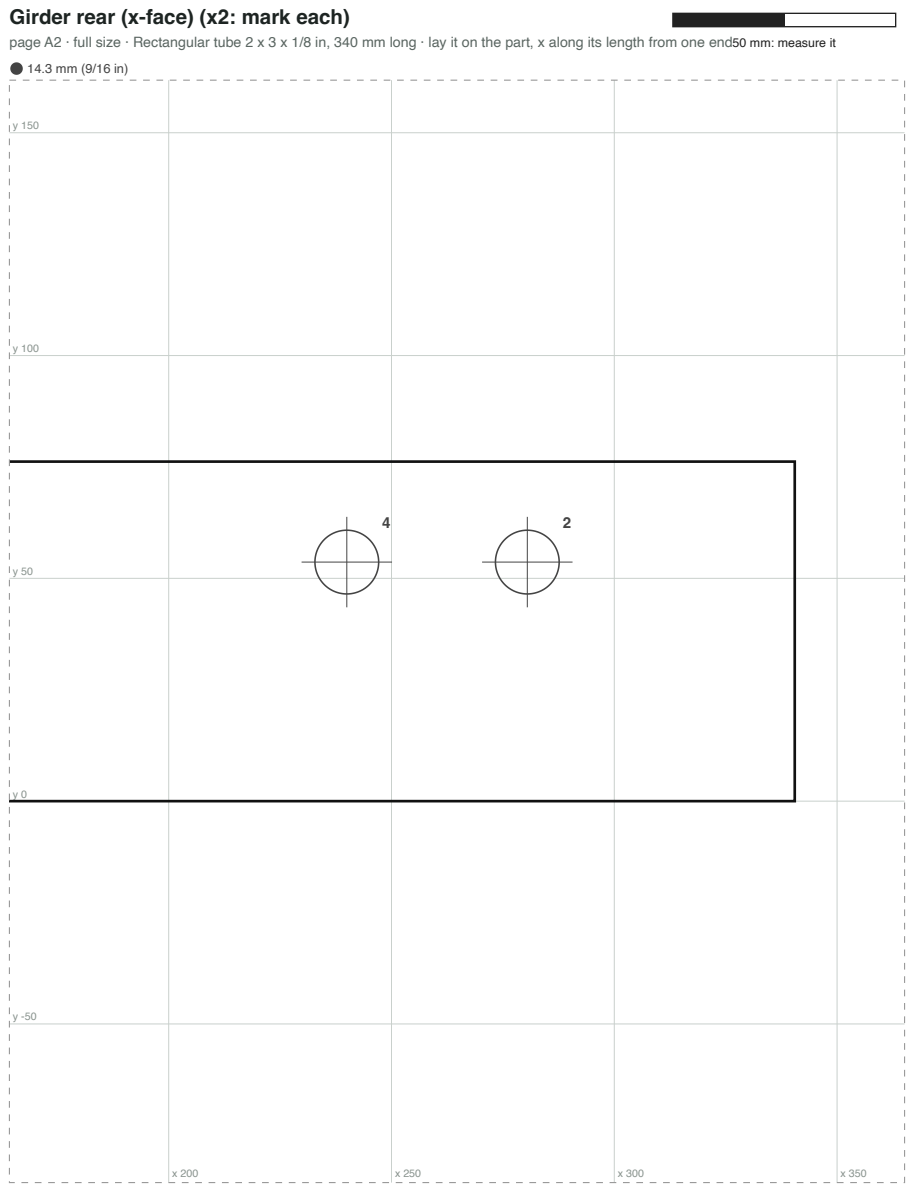
[picture p147: page 31]

page A2 · full size · Rectangular tube 2 x 3 x 1/8 in, 340 mm long · lay it on the part, x along its length from one end50 mm: measure it

## Girder front (z-face) (x2: mark each)

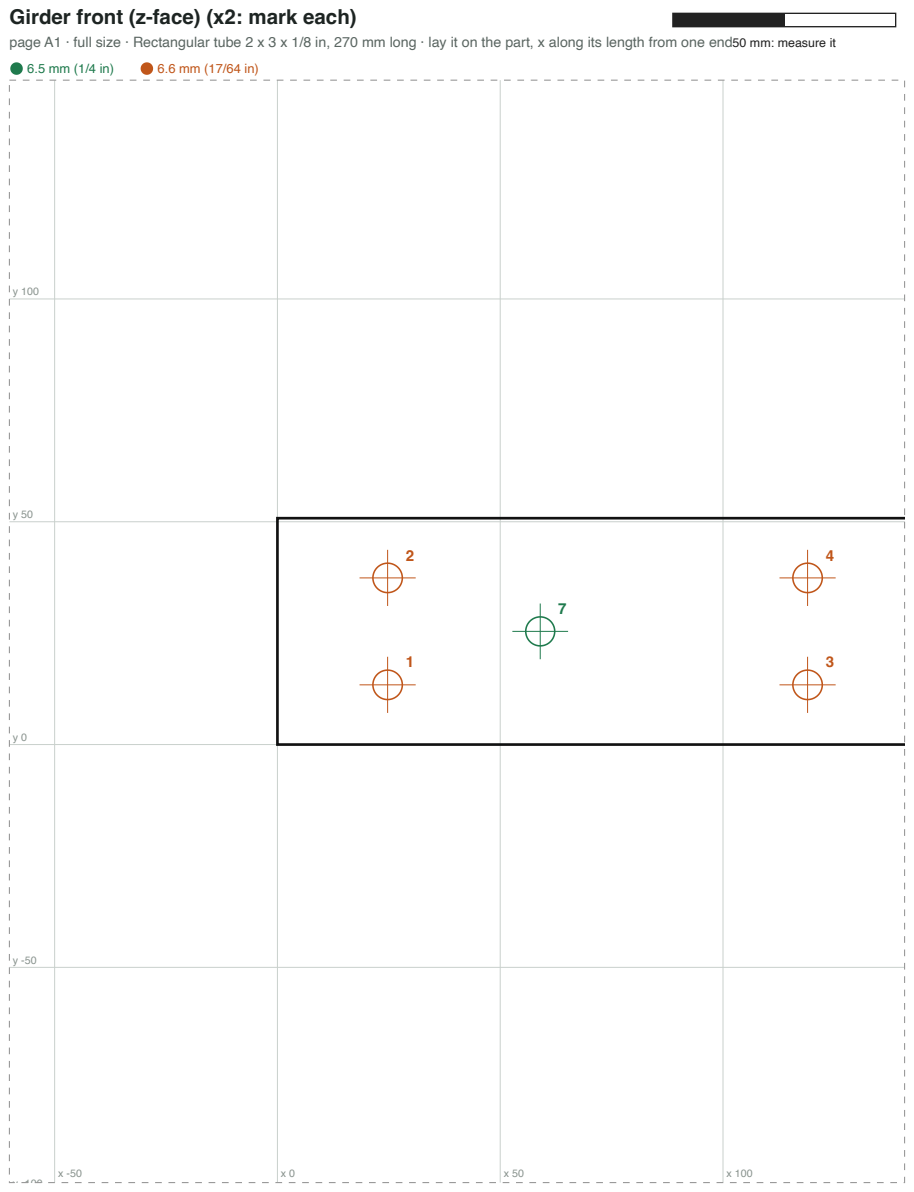
[picture p148: page 32]

page A1 · full size · Rectangular tube 2 x 3 x 1/8 in, 270 mm long · lay it on the part, x along its length from one end50 mm: measure it

## Girder front (z-face) (x2: mark each)

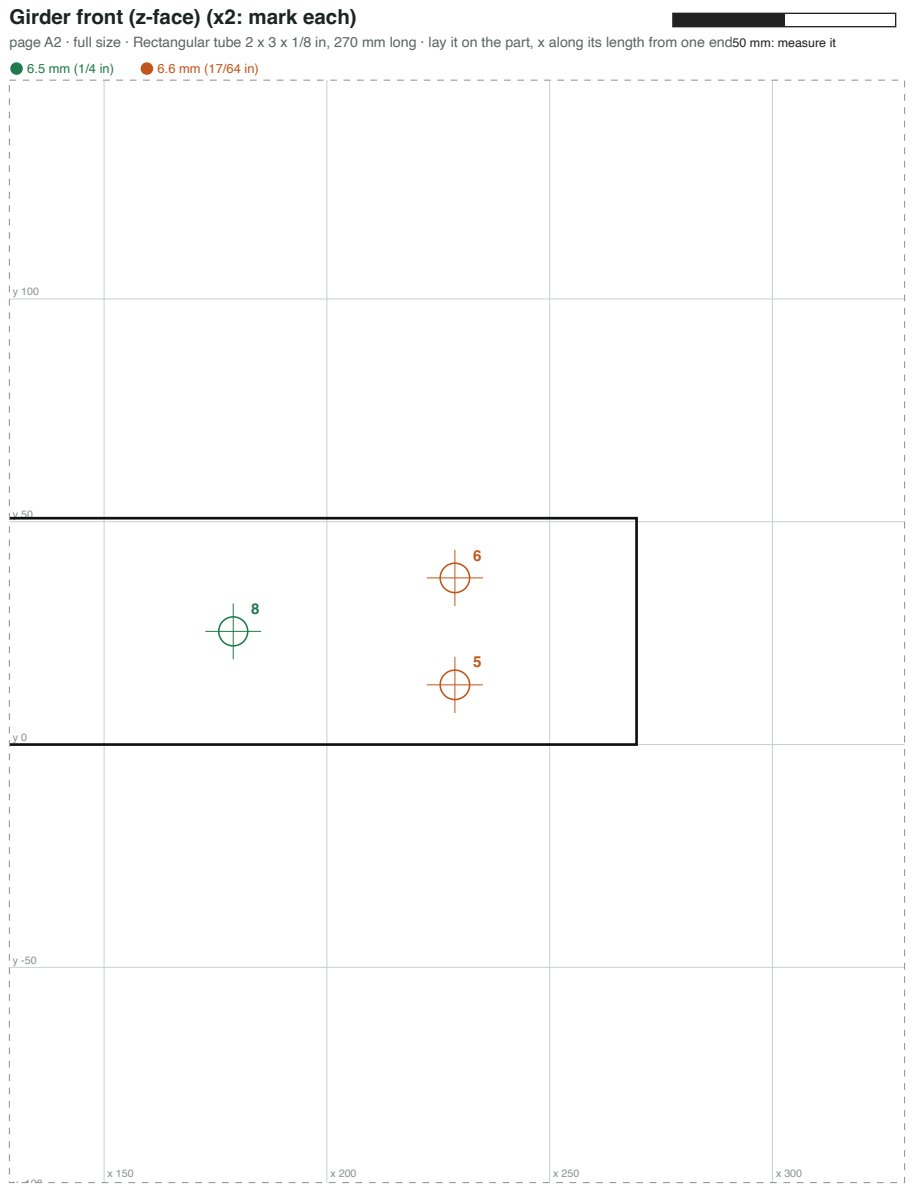
[picture p149: page 33]

page A2 · full size · Rectangular tube 2 x 3 x 1/8 in, 270 mm long · lay it on the part, x along its length from one end50 mm: measure it

## Girder front (x-face) (x2: mark each)

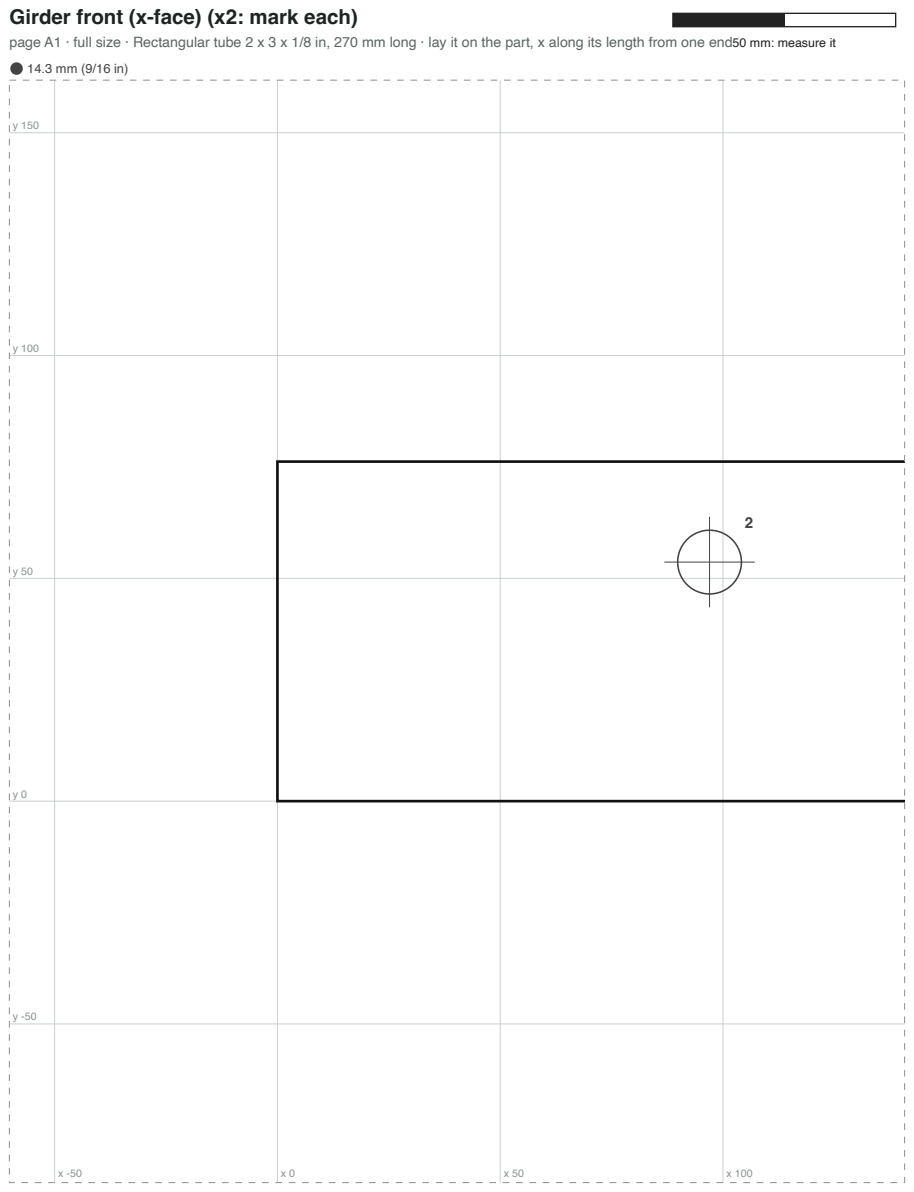
[picture p150: page 34]

page A1 · full size · Rectangular tube 2 x 3 x 1/8 in, 270 mm long · lay it on the part, x along its length from one end50 mm: measure it

## Girder front (x-face) (x2: mark each)

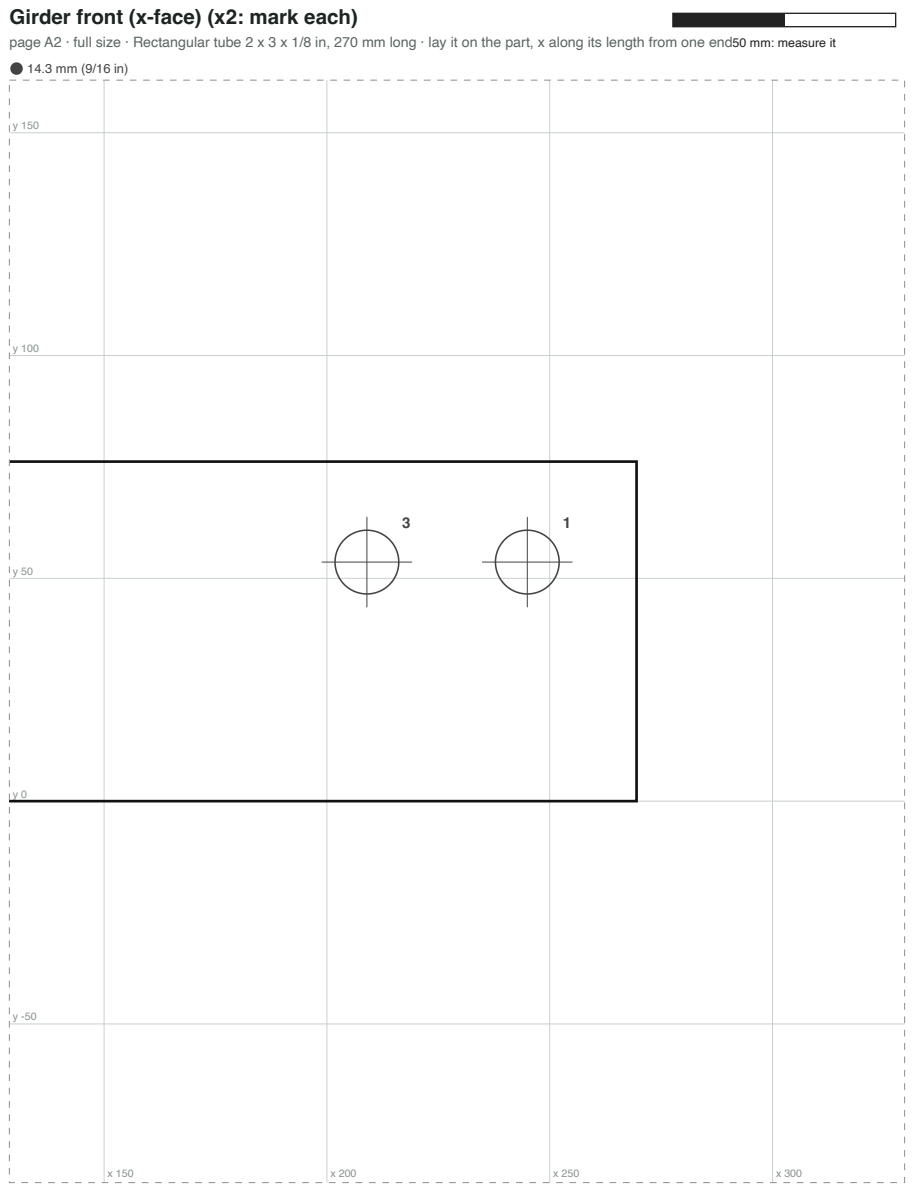
[picture p151: page 35]
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

## Cross BF front (z-face)

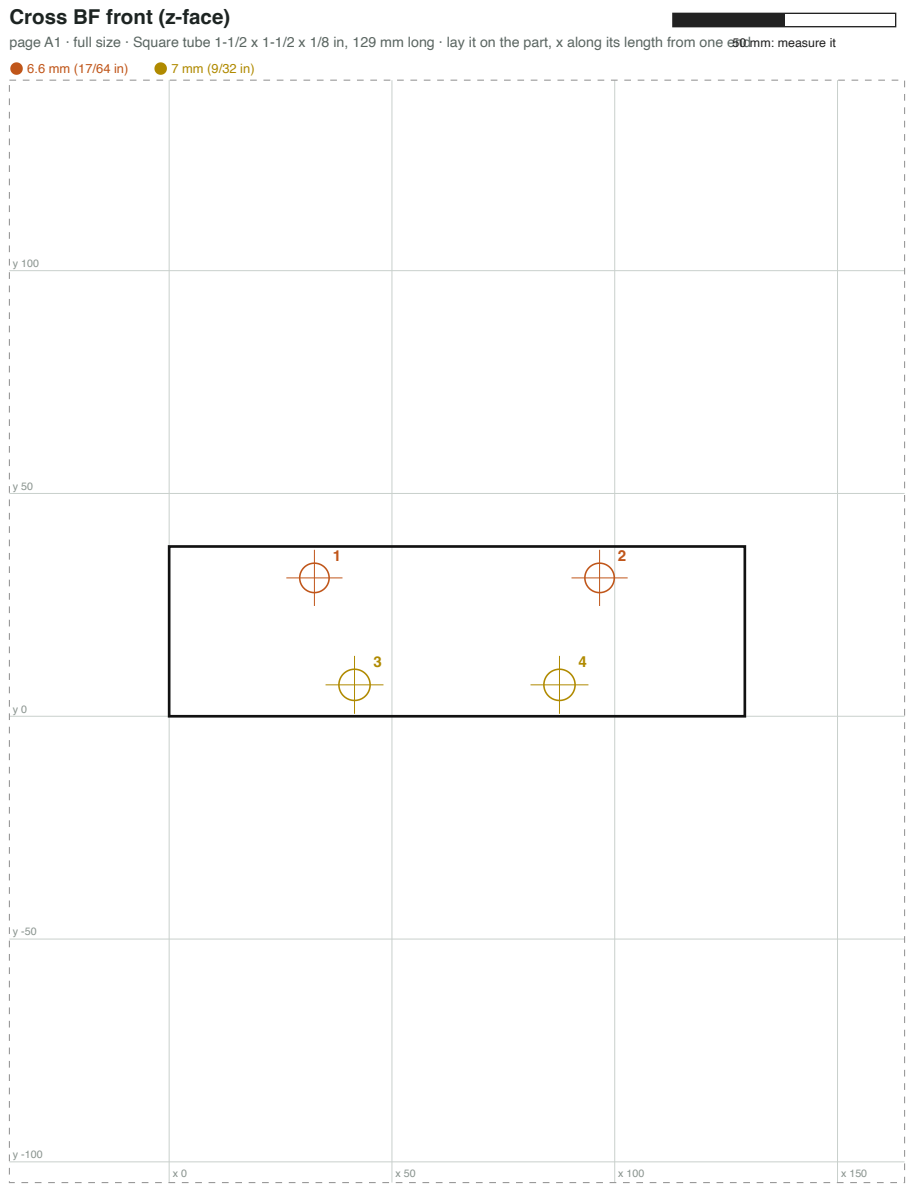
[picture p152: page 36]

page A1 · full size · Square tube 1-1/2 x 1-1/2 x 1/8 in, 129 mm long · lay it on the part, x along its length from one e5n0dmm: measure it

## Cross BK rear (z-face)

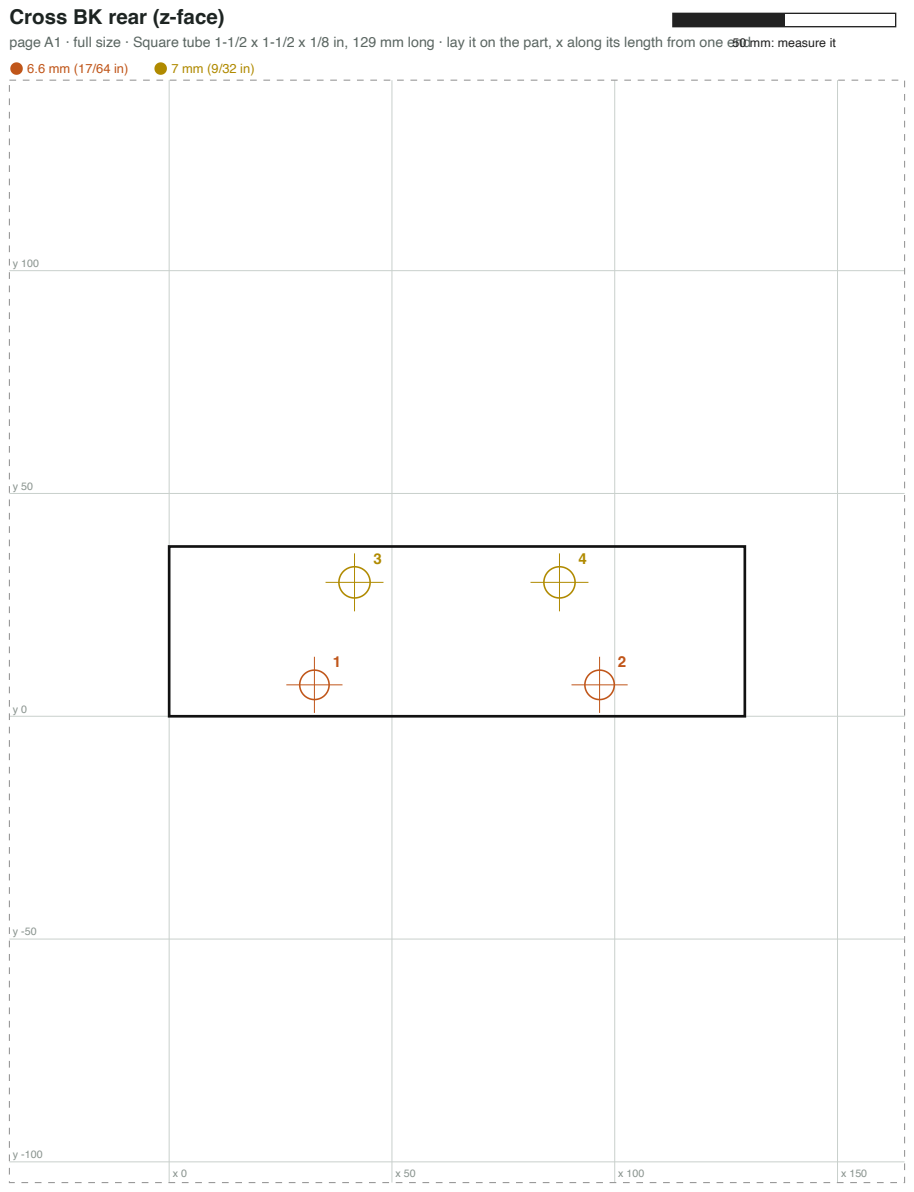
[picture p153: page 37]

page A1 · full size · Square tube 1-1/2 x 1-1/2 x 1/8 in, 129 mm long · lay it on the part, x along its length from one e5n0dmm: measure it

## Pedestal column (x-face) (x6: mark each)

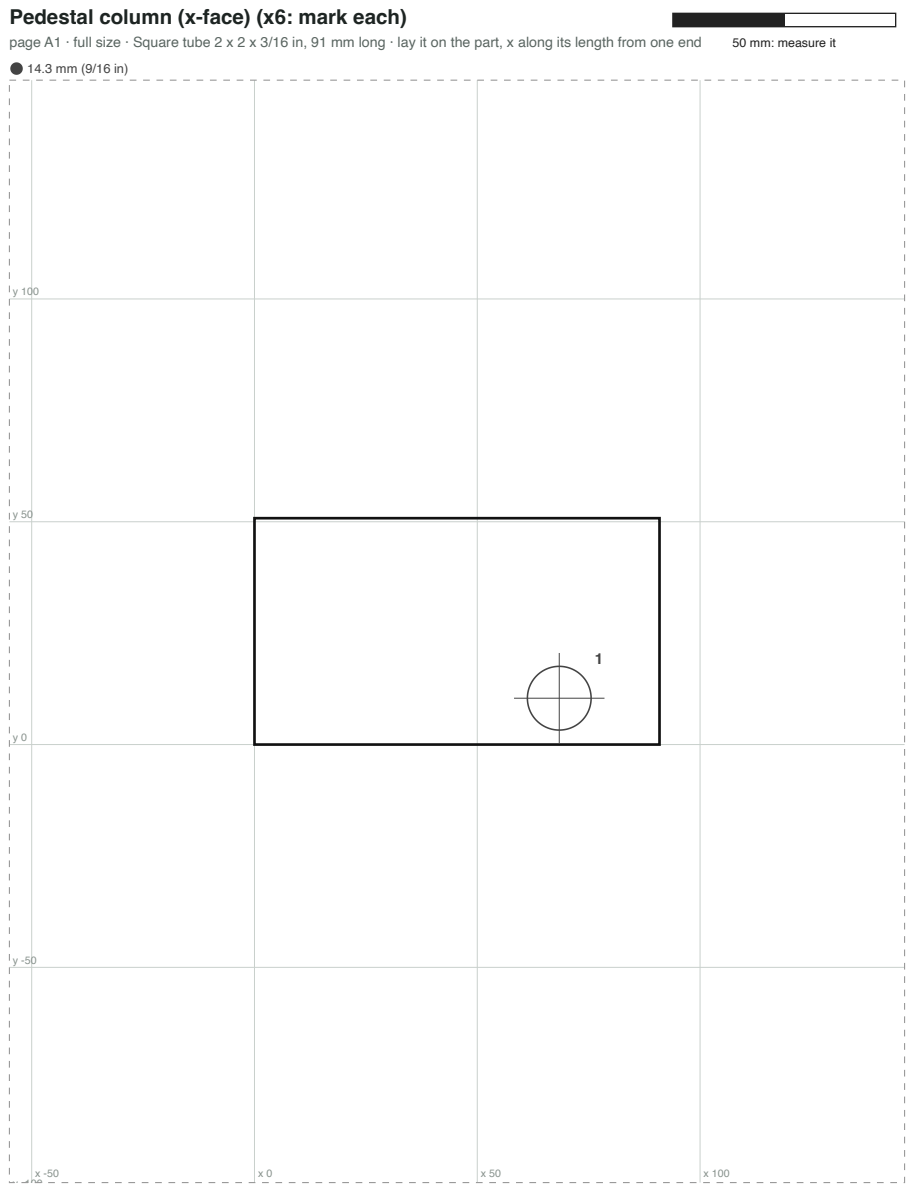
[picture p154: page 38]
page A1 · full size · Square tube 2 x 2 x 3/16 in, 91 mm long · lay it on the part, x along its length from one end; 50 mm: measure it
