nolanstr/diycnc/docs/1-sourcing/laser/anchor-bar-rear.dxf

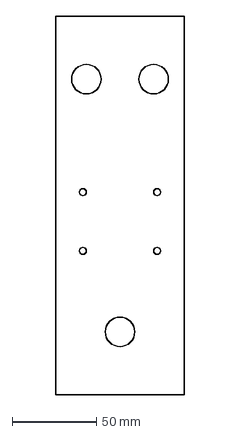
[picture p155: CAD file, 2026-10-12]
docs/1-sourcing/laser/anchor-bar-rear.dxf
76.2 x 225.0 mm
