nolanstr/diycnc/print/base-box/kit-corner-bracket.stl

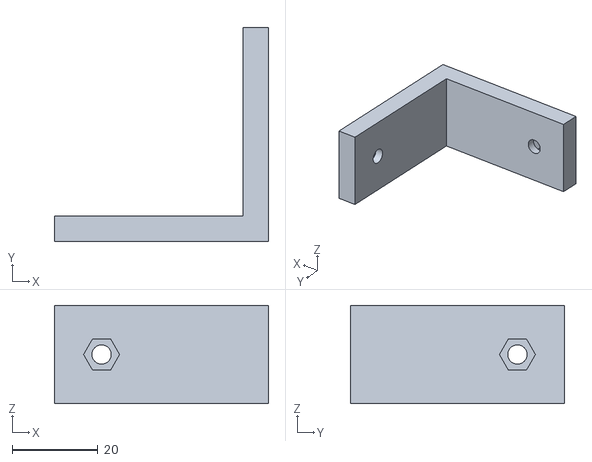
[picture p156: CAD file, 2026-10-23]
print/base-box/kit-corner-bracket.stl
50.0 x 50.0 x 23.0
