nolanstr/diycnc/print/base-front/filler-bevel-end-part1of3.stl

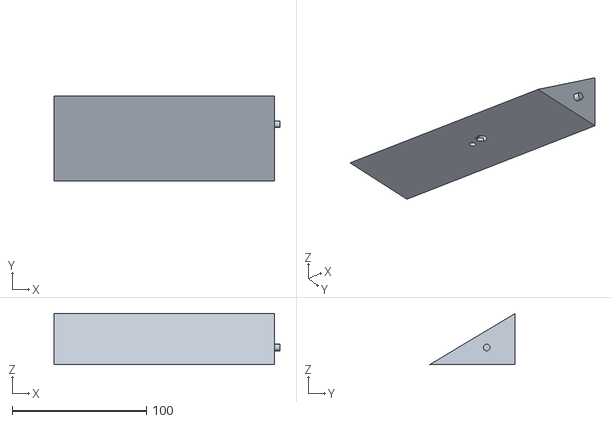
[picture p157: CAD file, 2026-10-23]
print/base-front/filler-bevel-end-part1of3.stl
168.1 x 63.5 x 38.1
