nolanstr/diycnc/print/base-rear/filler-corner-L.stl

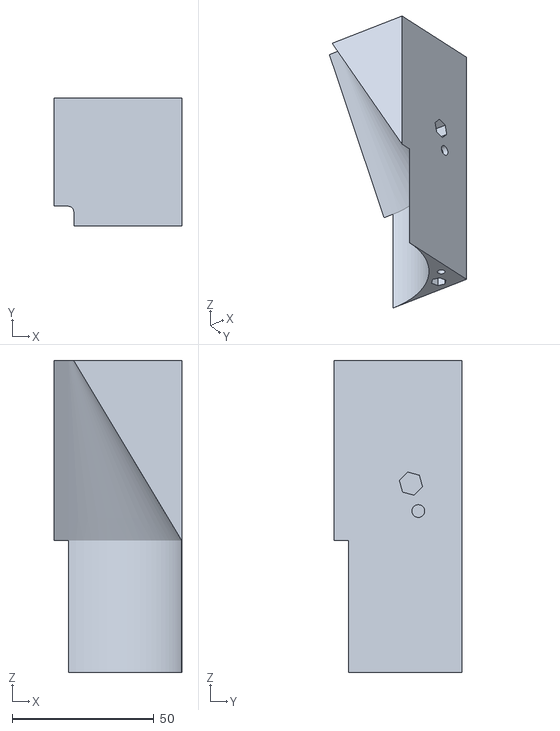
[picture p158: CAD file, 2026-10-23]
print/base-rear/filler-corner-L.stl
45.0 x 45.0 x 110.0
