nolanstr/diycnc/print/beam/filler-back-edge-part1of3.stl

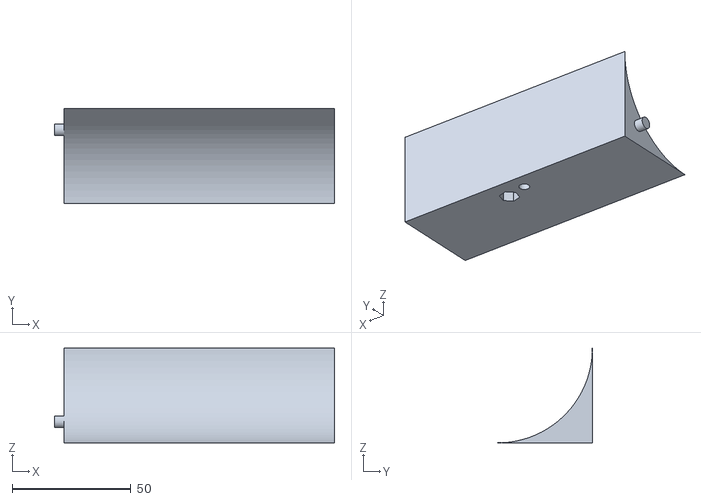
[picture p159: CAD file, 2026-10-23]
print/beam/filler-back-edge-part1of3.stl
118.1 x 40.0 x 40.0
