nolanstr/diycnc/print/machine/part-chain-mount-fixed.stl

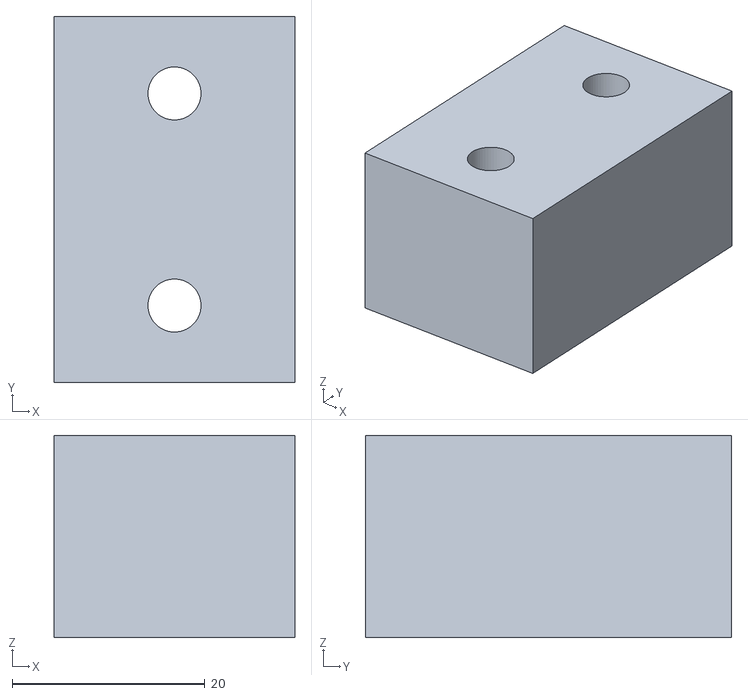
[picture p160: CAD file, 2026-10-13]
print/machine/part-chain-mount-fixed.stl
25.0 x 38.0 x 21.0
