nolanstr/diycnc/print/tools/kit-screed-shoe.stl

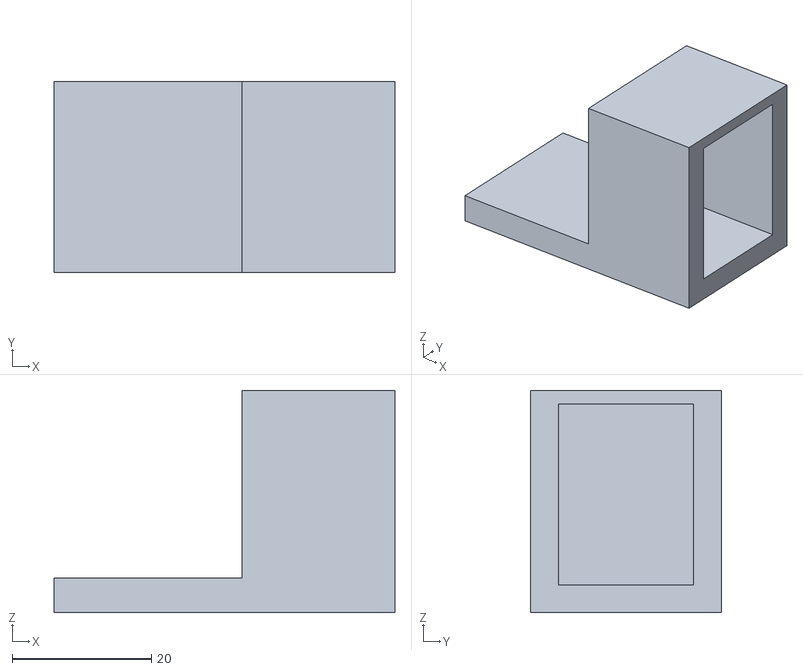
[picture p161: CAD file, 2026-10-11]
print/tools/kit-screed-shoe.stl
49.0 x 27.5 x 32.0
