nolanstr/diycnc/print/upright/kit-back-bracket.stl

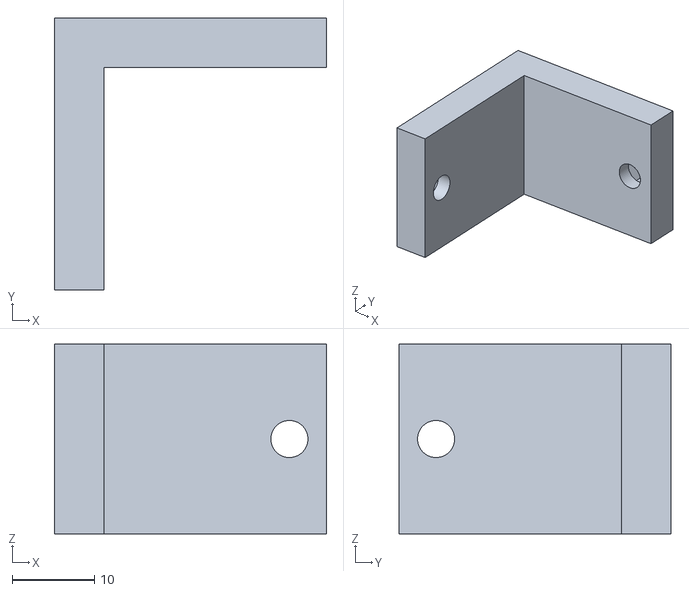
[picture p162: CAD file, 2026-10-23]
print/upright/kit-back-bracket.stl
33.0 x 33.0 x 23.0
