nolanstr/diycnc/print/base-box/kit-partition-bracket.stl

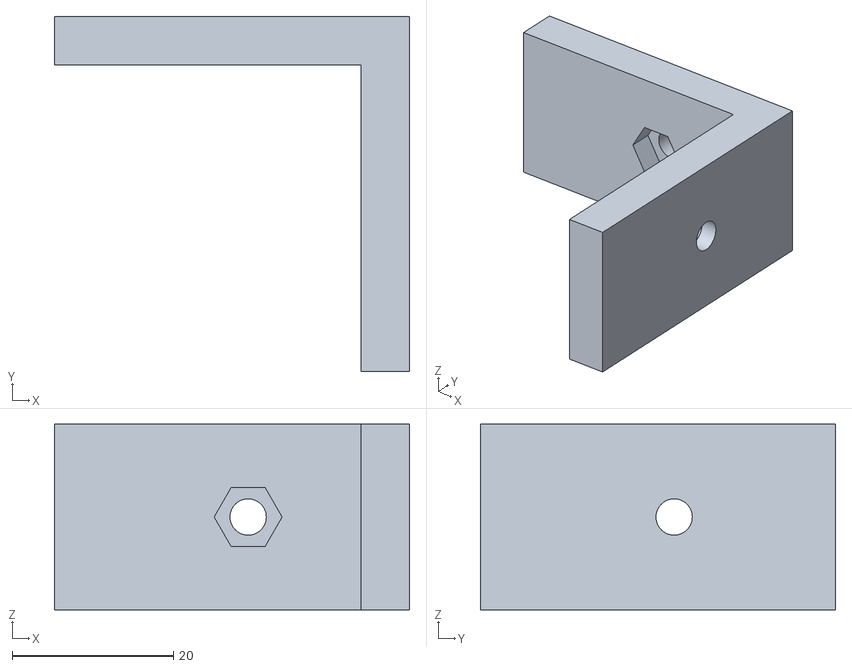
[picture p163: CAD file, 2026-10-23]
print/base-box/kit-partition-bracket.stl
44.0 x 44.0 x 23.0
