nolanstr/diycnc/print/base-front/filler-bevel-end-part3of3.stl

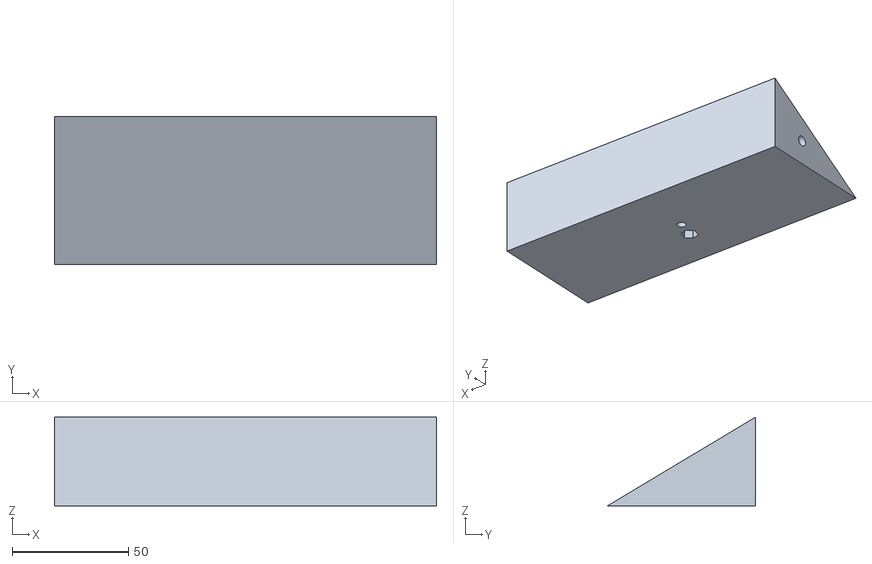
[picture p164: CAD file, 2026-10-23]
print/base-front/filler-bevel-end-part3of3.stl
164.1 x 63.5 x 38.1
