nolanstr/diycnc/print/base-rear/former-gutter-L-part2of3.stl

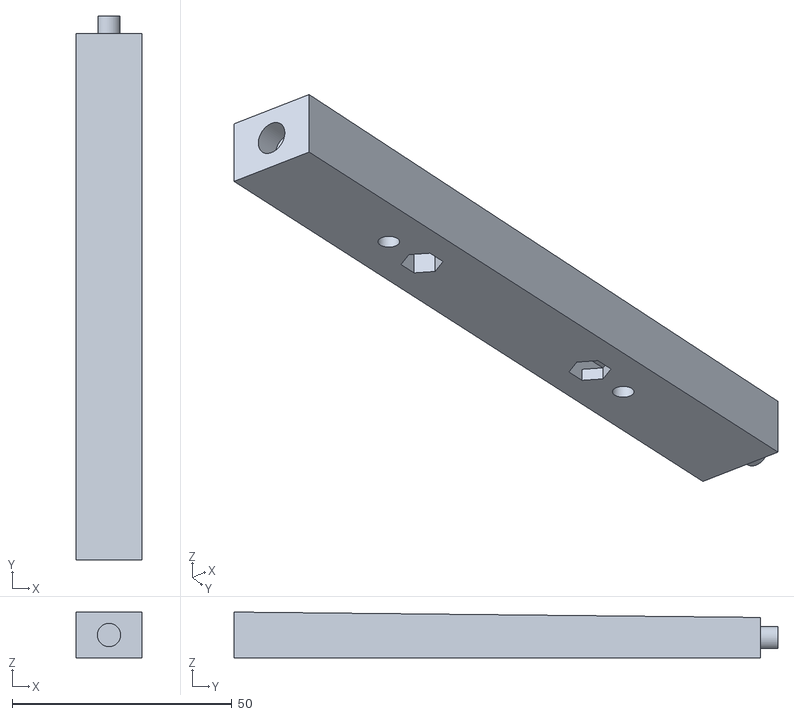
[picture p165: CAD file, 2026-10-23]
print/base-rear/former-gutter-L-part2of3.stl
15.0 x 123.8 x 10.5
