nolanstr/diycnc/print/machine/part-pocket-cap-l3.stl

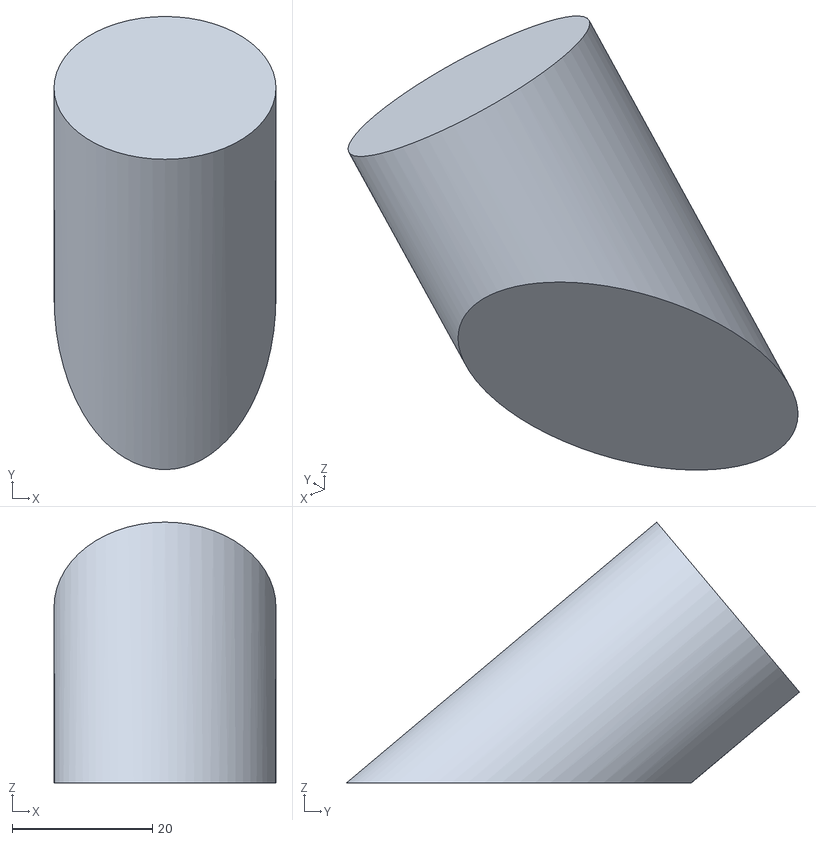
[picture p166: CAD file, 2026-10-12]
print/machine/part-pocket-cap-l3.stl
31.7 x 64.7 x 37.2
