nolanstr/diycnc/print/tools/kit-pour-gauge.stl

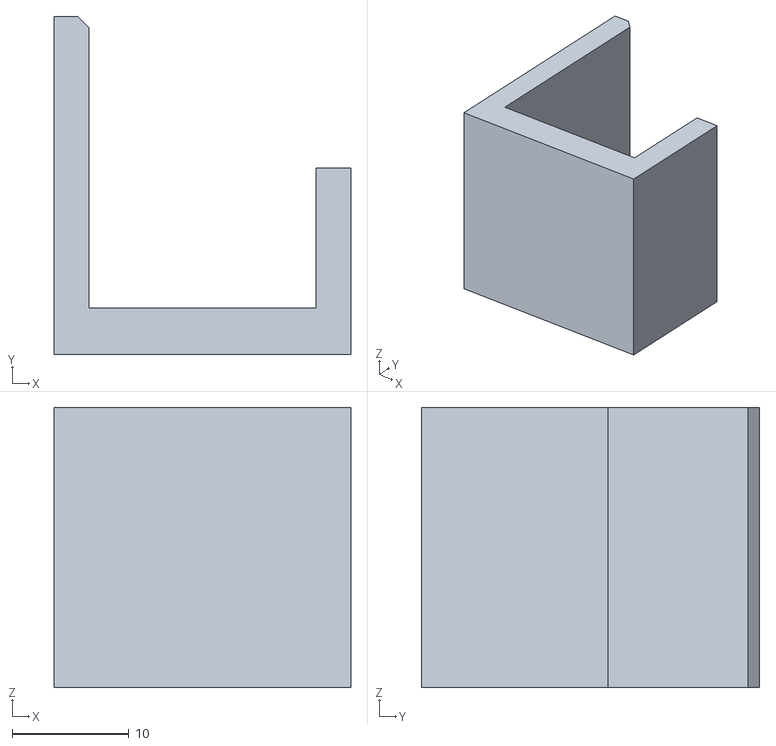
[picture p167: CAD file, 2026-10-11]
print/tools/kit-pour-gauge.stl
25.5 x 29.0 x 24.0
