nolanstr/diycnc/print/upright/former-foot-gasket-groove-part1of4.stl

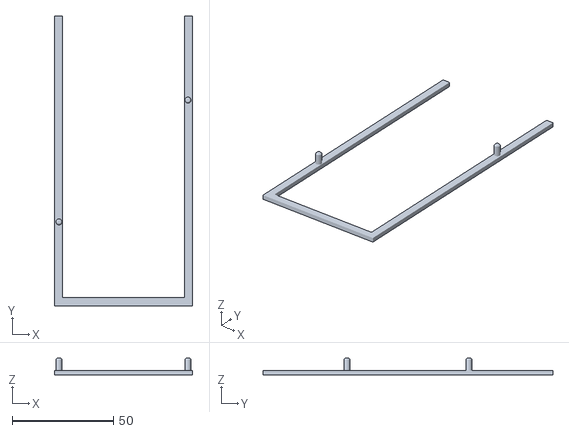
[picture p168: CAD file, 2026-10-23]
print/upright/former-foot-gasket-groove-part1of4.stl
68.0 x 142.7 x 8.30
