nolanstr/diycnc/print/base-box/kit-leg-holder.stl

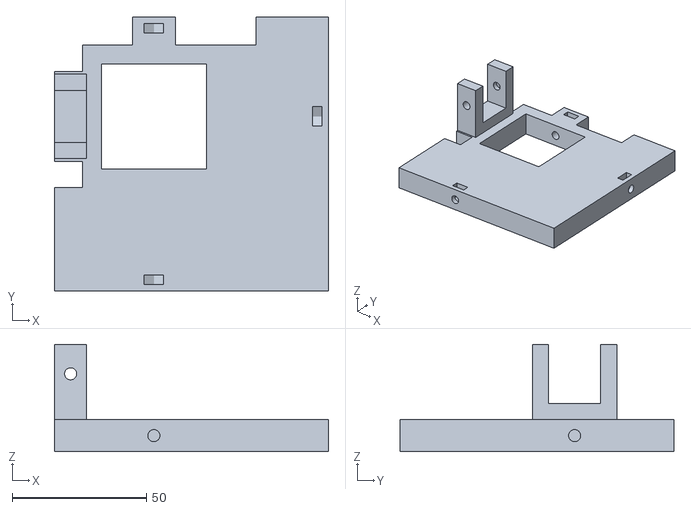
[picture p169: CAD file, 2026-10-23]
print/base-box/kit-leg-holder.stl
102.0 x 102.0 x 40.0
