nolanstr/diycnc/print/base-front/former-gutter-R-part2of2.stl

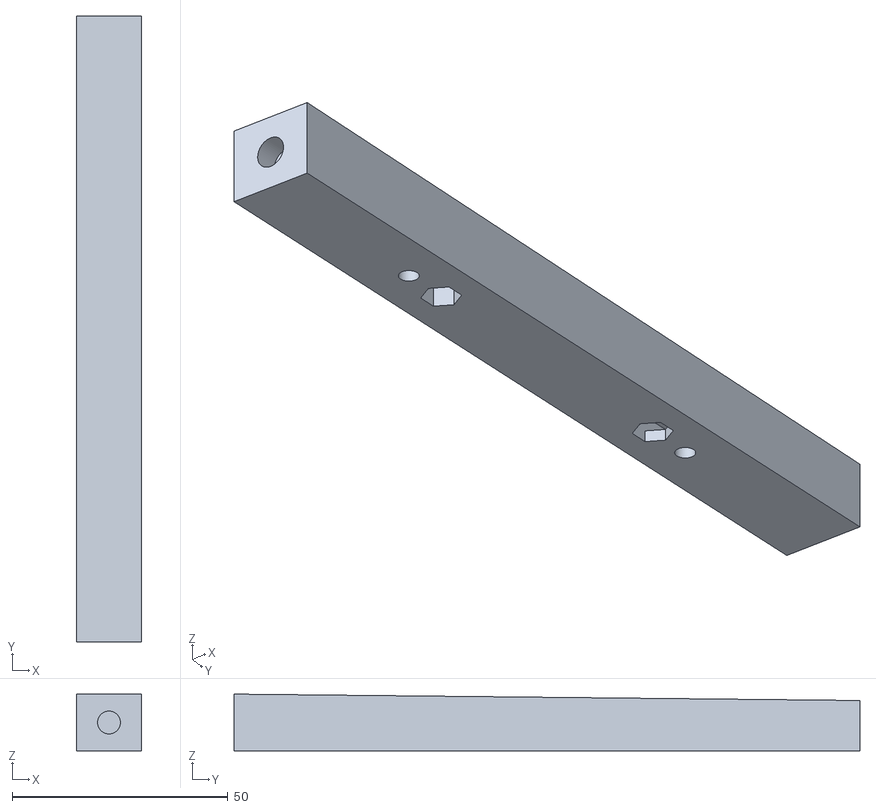
[picture p170: CAD file, 2026-10-23]
print/base-front/former-gutter-R-part2of2.stl
15.0 x 145.0 x 13.2
