nolanstr/diycnc/print/machine/part-chain-mount-moving.stl

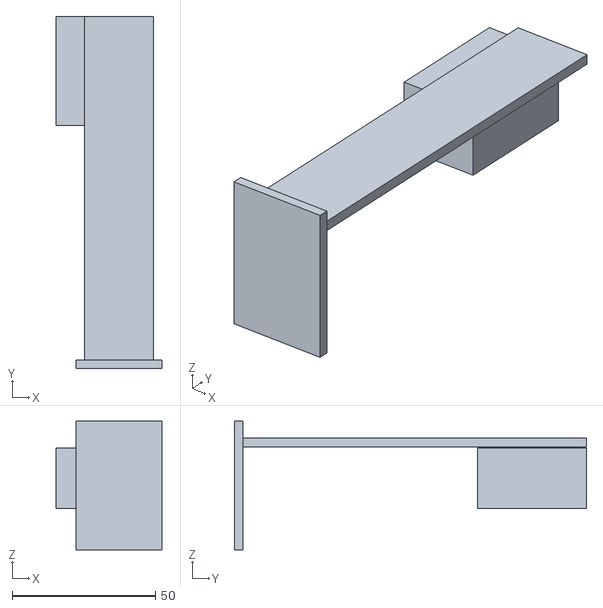
[picture p171: CAD file, 2026-10-10]
print/machine/part-chain-mount-moving.stl
37.0 x 122.9 x 45.0
