nolanstr/diycnc/print/upright/filler-toe-filler.stl

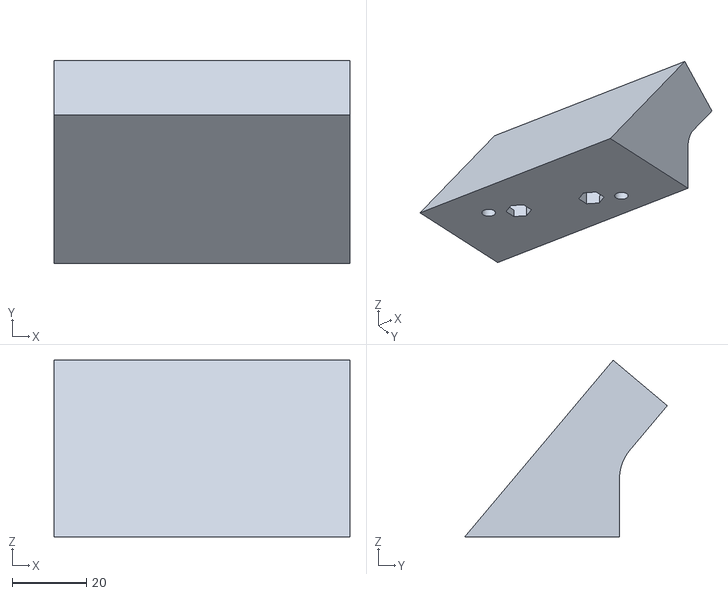
[picture p172: CAD file, 2026-10-23]
print/upright/filler-toe-filler.stl
79.7 x 54.5 x 47.6
