nolanstr/diycnc/print/base-box/kit-saddle.stl

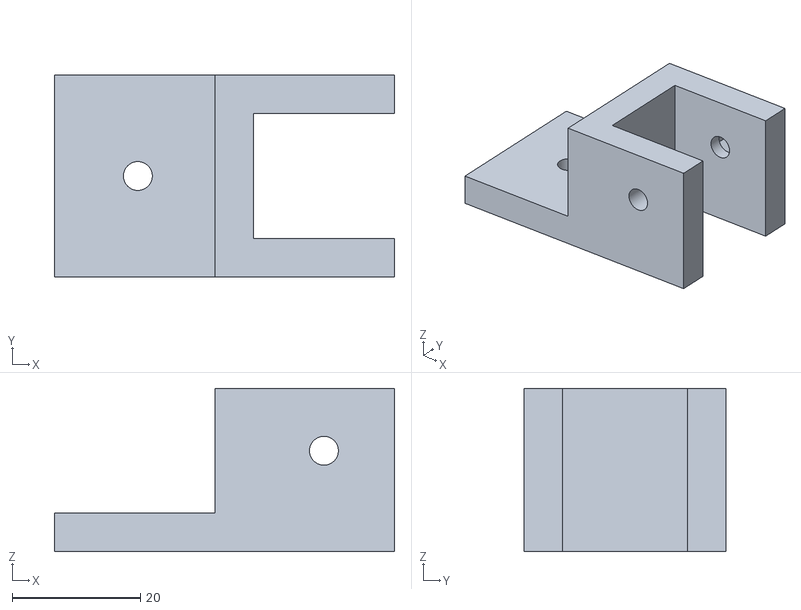
[picture p173: CAD file, 2026-10-23]
print/base-box/kit-saddle.stl
53.0 x 31.5 x 25.5
