nolanstr/diycnc/print/base-front/filler-bevel-R-part1of2.stl

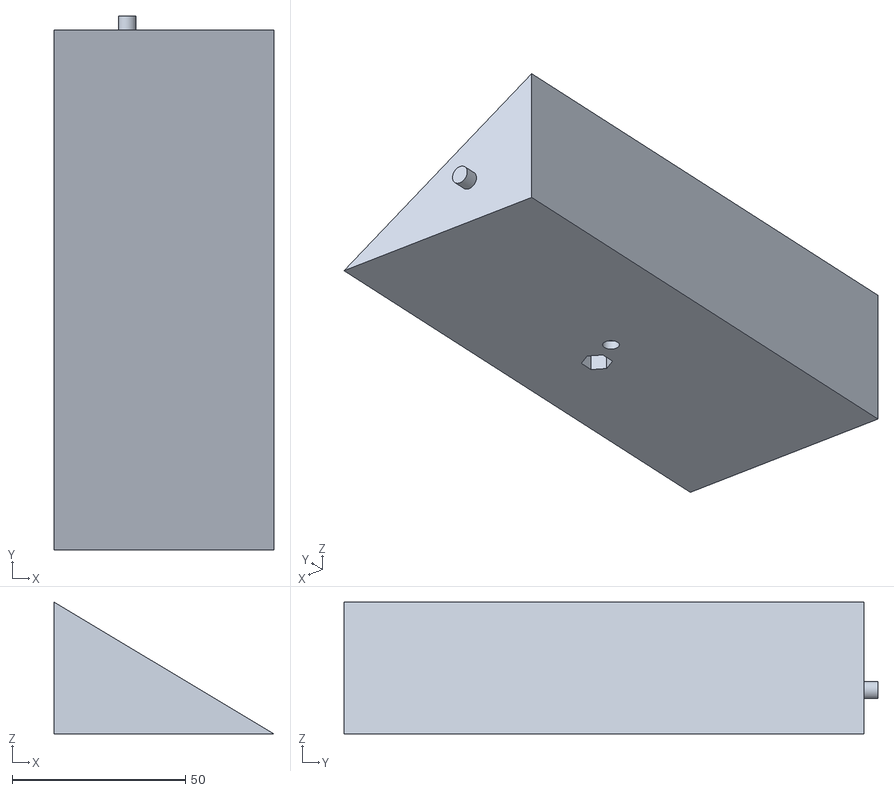
[picture p174: CAD file, 2026-10-23]
print/base-front/filler-bevel-R-part1of2.stl
63.5 x 154.0 x 38.1
