nolanstr/diycnc/print/base-rear/former-gutter-L-part1of3.stl

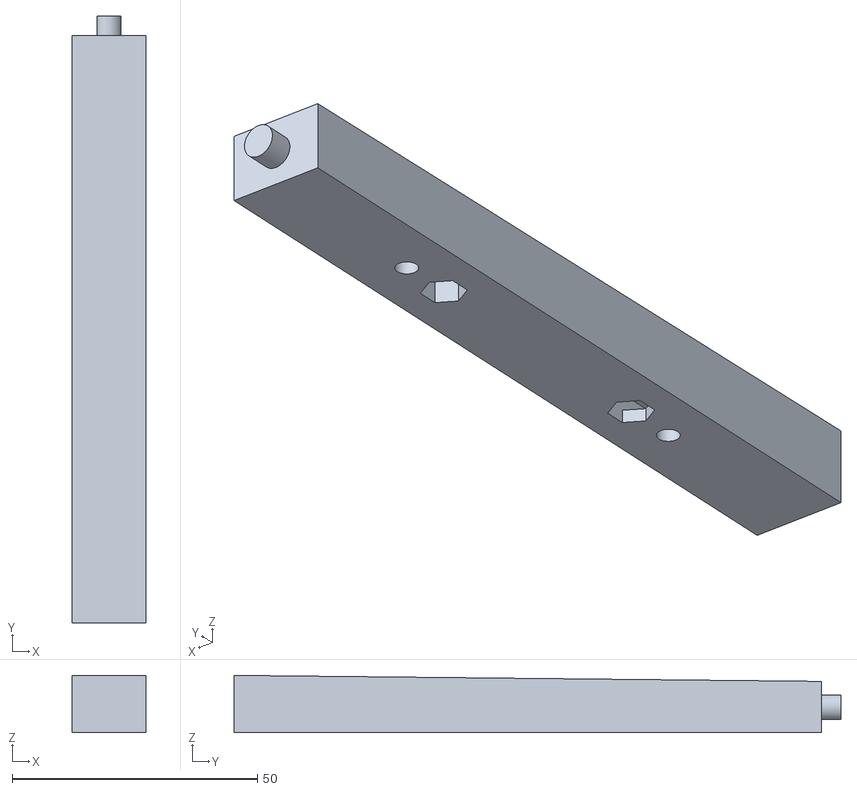
[picture p175: CAD file, 2026-10-23]
print/base-rear/former-gutter-L-part1of3.stl
15.0 x 123.8 x 11.7
