nolanstr/diycnc/print/beam/filler-back-edge-part3of3.stl

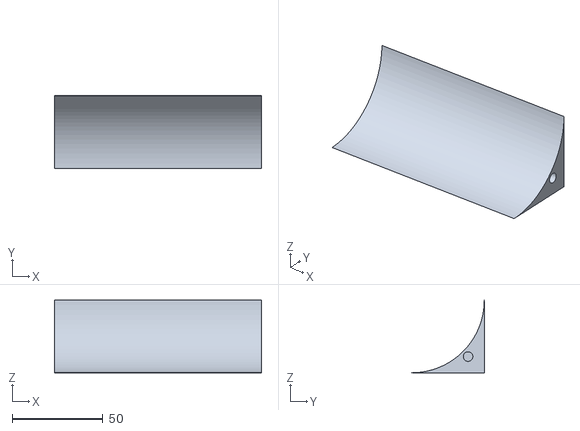
[picture p176: CAD file, 2026-10-23]
print/beam/filler-back-edge-part3of3.stl
114.1 x 40.0 x 40.0
