nolanstr/diycnc/print/machine/part-sump-filter-frame-part2of2.stl

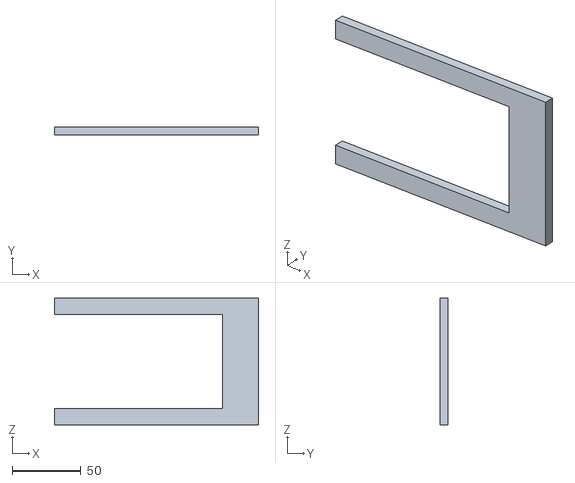
[picture p177: CAD file, 2026-10-10]
print/machine/part-sump-filter-frame-part2of2.stl
148.0 x 6.00 x 92.1
