nolanstr/diycnc/print/upright/plug-toe-plug.stl

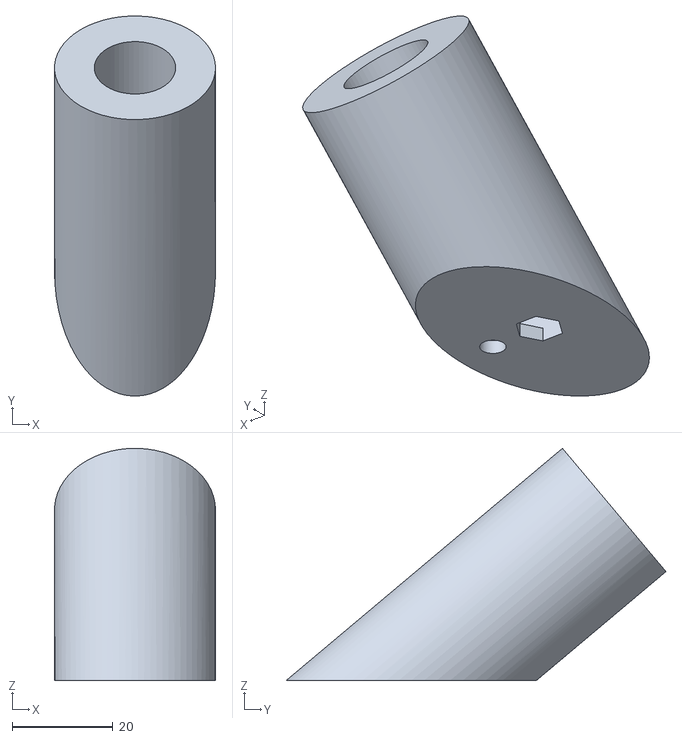
[picture p178: CAD file, 2026-10-23]
print/upright/plug-toe-plug.stl
32.0 x 75.5 x 46.2
