nolanstr/diycnc/print/beam/kit-dowel-stop.stl

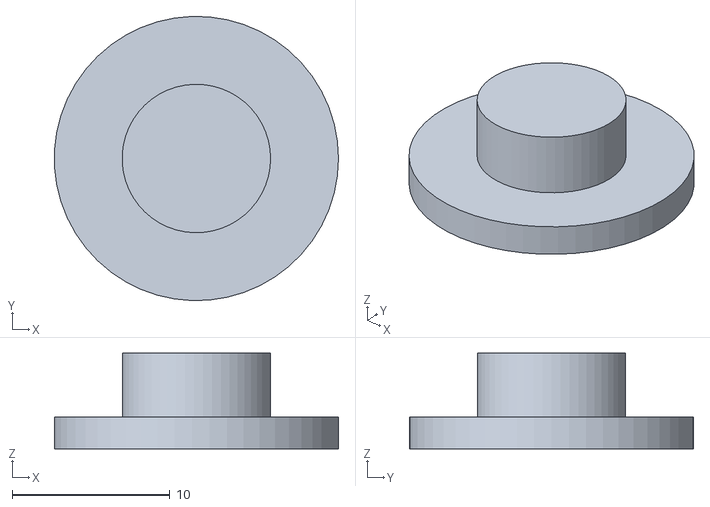
[picture p179: CAD file, 2026-10-12]
print/beam/kit-dowel-stop.stl
18.0 x 18.0 x 6.05
