nolanstr/diycnc/print/upright/kit-front-bracket.stl

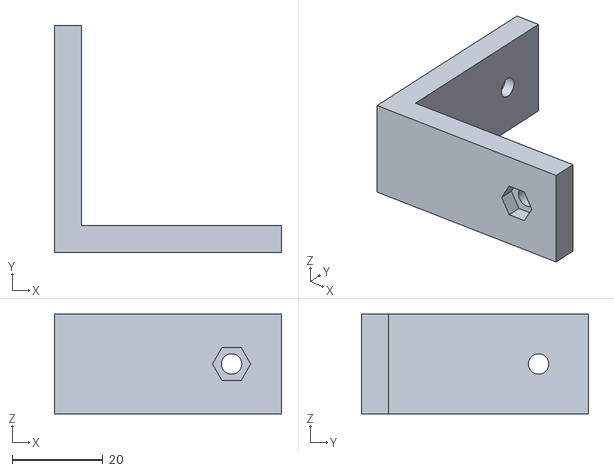
[picture p180: CAD file, 2026-10-23]
print/upright/kit-front-bracket.stl
50.0 x 50.0 x 22.0
