nolanstr/diycnc/print/base-front/filler-bevel-L-part2of2.stl

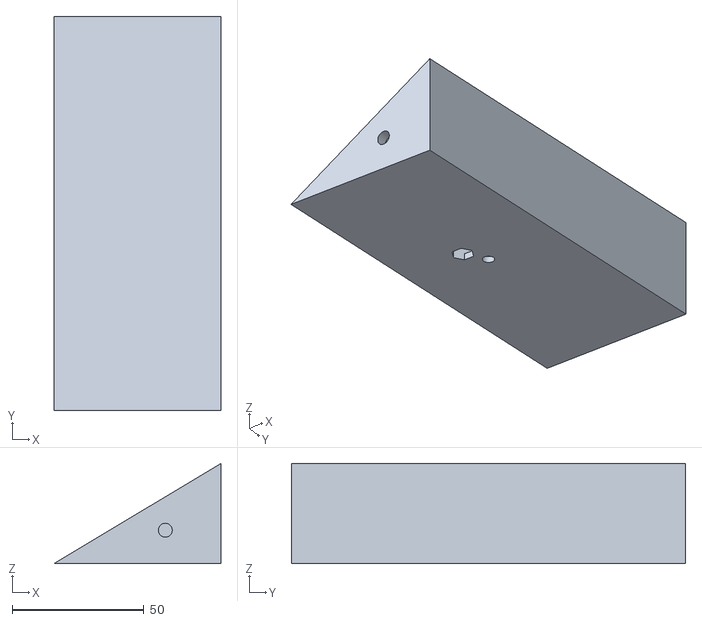
[picture p181: CAD file, 2026-10-23]
print/base-front/filler-bevel-L-part2of2.stl
63.5 x 150.0 x 38.1
