nolanstr/diycnc/print/base-rear/former-split-gasket-groove-part3of4.stl

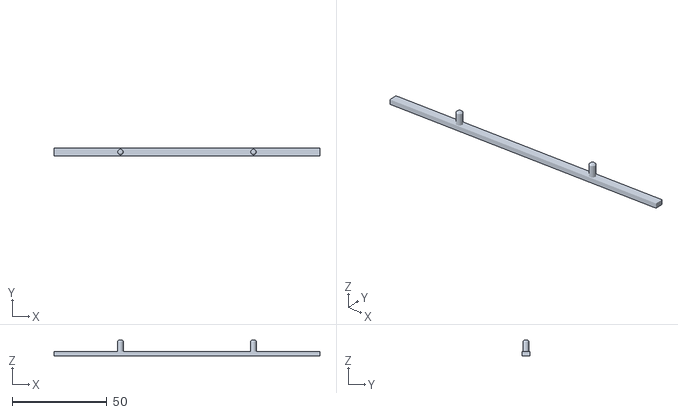
[picture p182: CAD file, 2026-10-23]
print/base-rear/former-split-gasket-groove-part3of4.stl
140.6 x 4.00 x 8.30
