nolanstr/diycnc/print/upright/cast-in-column-ring-l1a.stl

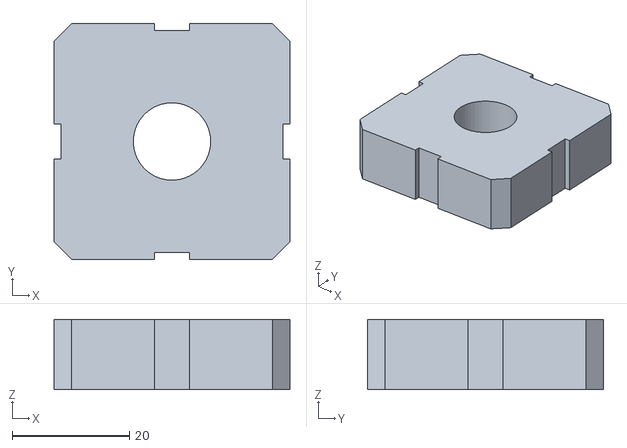
[picture p183: CAD file, 2026-10-23]
print/upright/cast-in-column-ring-l1a.stl
40.3 x 40.3 x 12.0
