nolanstr/diycnc/print/base-front/former-gutter-L-part1of2.stl

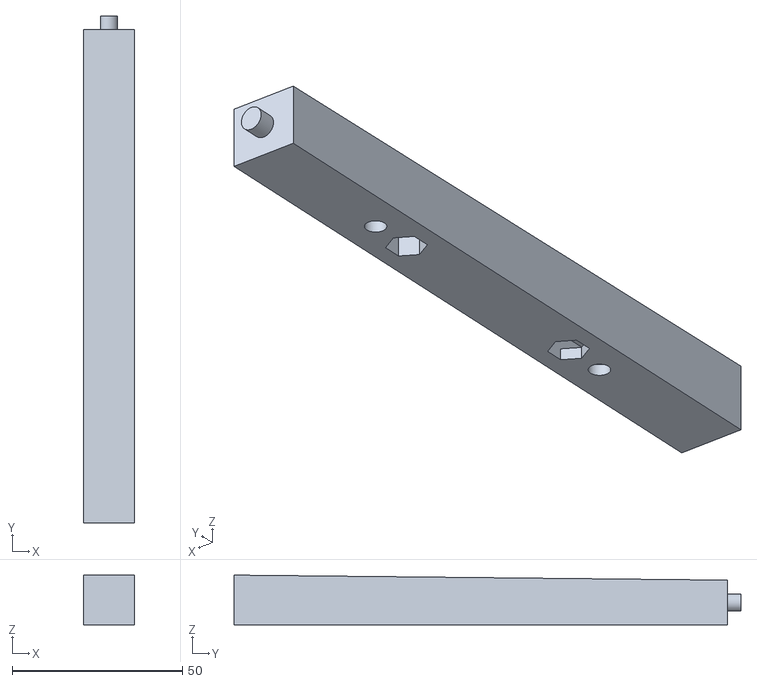
[picture p184: CAD file, 2026-10-23]
print/base-front/former-gutter-L-part1of2.stl
15.0 x 149.0 x 14.6
