nolanstr/diycnc/print/base-rear/former-split-gasket-groove-part4of4.stl

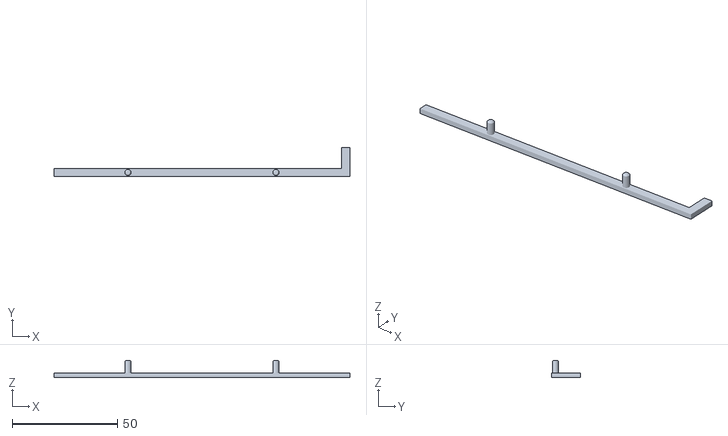
[picture p185: CAD file, 2026-10-23]
print/base-rear/former-split-gasket-groove-part4of4.stl
140.6 x 14.0 x 8.30
