nolanstr/diycnc/print/base-rear/former-gutter-L-part3of3.stl

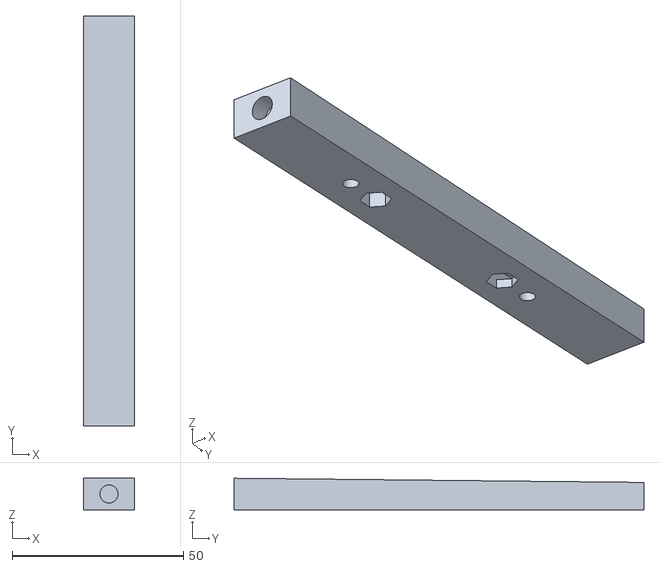
[picture p186: CAD file, 2026-10-23]
print/base-rear/former-gutter-L-part3of3.stl
15.0 x 119.8 x 9.23
