nolanstr/diycnc/print/upright/kit-saddle-flat.stl

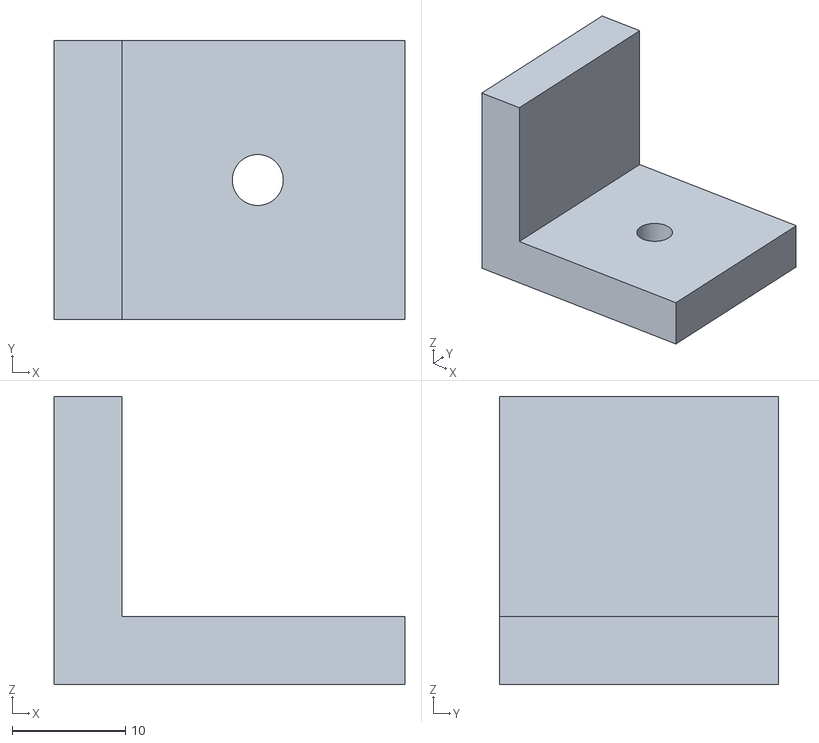
[picture p187: CAD file, 2026-10-11]
print/upright/kit-saddle-flat.stl
31.0 x 24.6 x 25.5
