nolanstr/diycnc/print/base-front/former-trough-part3of5.stl

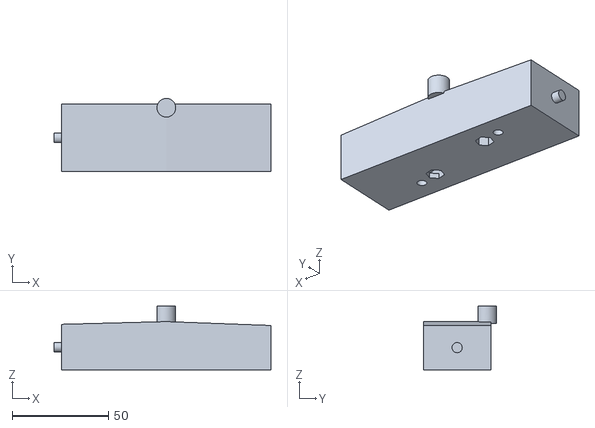
[picture p188: CAD file, 2026-10-23]
print/base-front/former-trough-part3of5.stl
112.5 x 37.9 x 33.0
