nolanstr/diycnc/print/base-rear/core-knee-L-post.stl

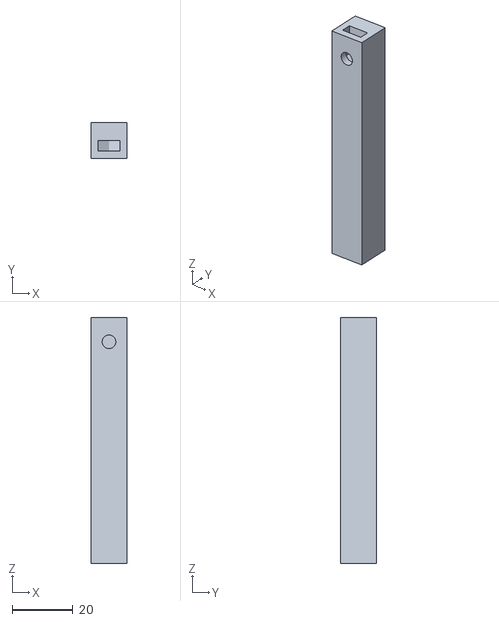
[picture p189: CAD file, 2026-10-23]
print/base-rear/core-knee-L-post.stl
12.0 x 12.0 x 81.0
