nolanstr/diycnc/print/upright/kit-plate-spacer.stl

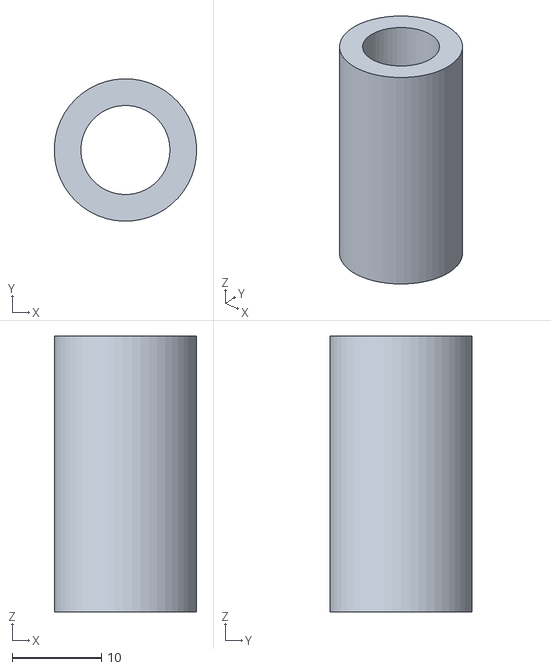
[picture p190: CAD file, 2026-10-11]
print/upright/kit-plate-spacer.stl
16.0 x 16.0 x 31.0
