nolanstr/diycnc/print/base-front/former-trough-part5of5.stl

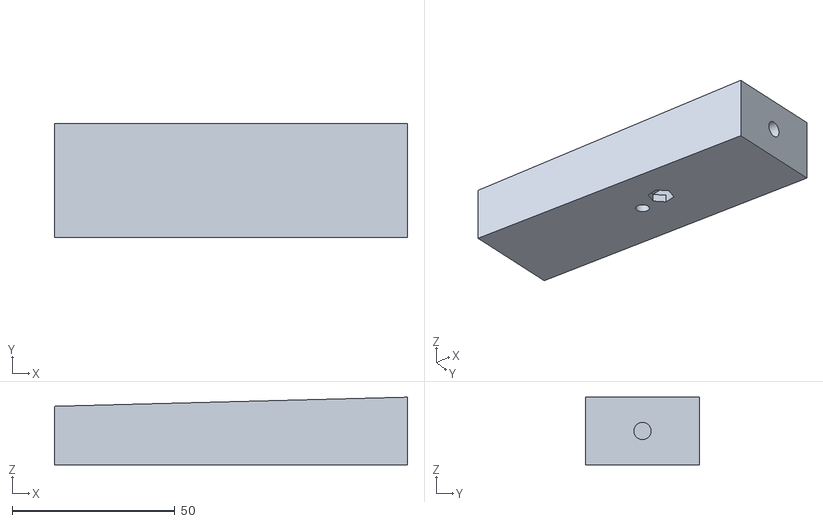
[picture p191: CAD file, 2026-10-23]
print/base-front/former-trough-part5of5.stl
108.5 x 35.0 x 20.8
