nolanstr/diycnc/print/base-front/former-trough-part4of5.stl

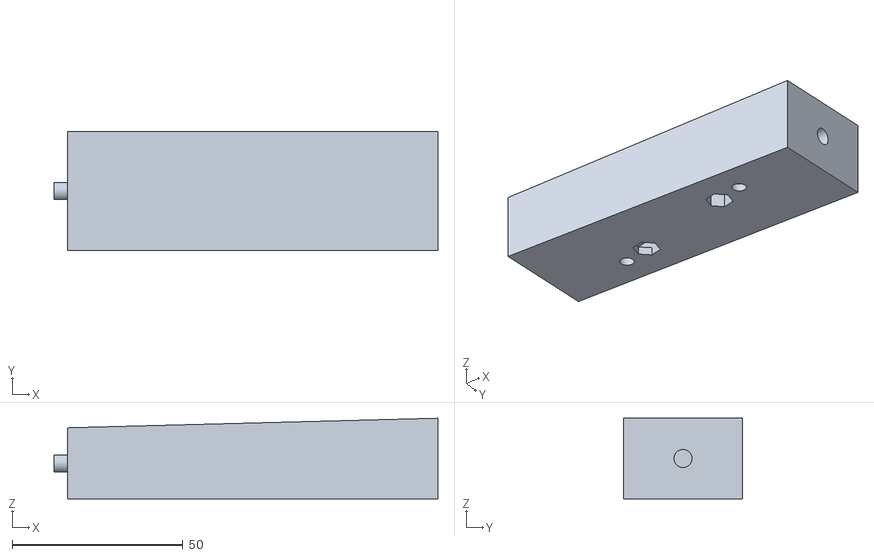
[picture p192: CAD file, 2026-10-23]
print/base-front/former-trough-part4of5.stl
112.5 x 35.0 x 23.6
