nolanstr/diycnc/print/base-front/former-trough-part2of5.stl

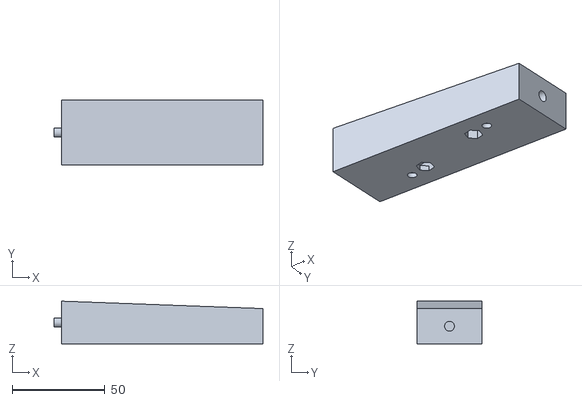
[picture p193: CAD file, 2026-10-23]
print/base-front/former-trough-part2of5.stl
112.5 x 35.0 x 23.0
