nolanstr/diycnc/print/base-rear/filler-bevel-L-part2of2.stl

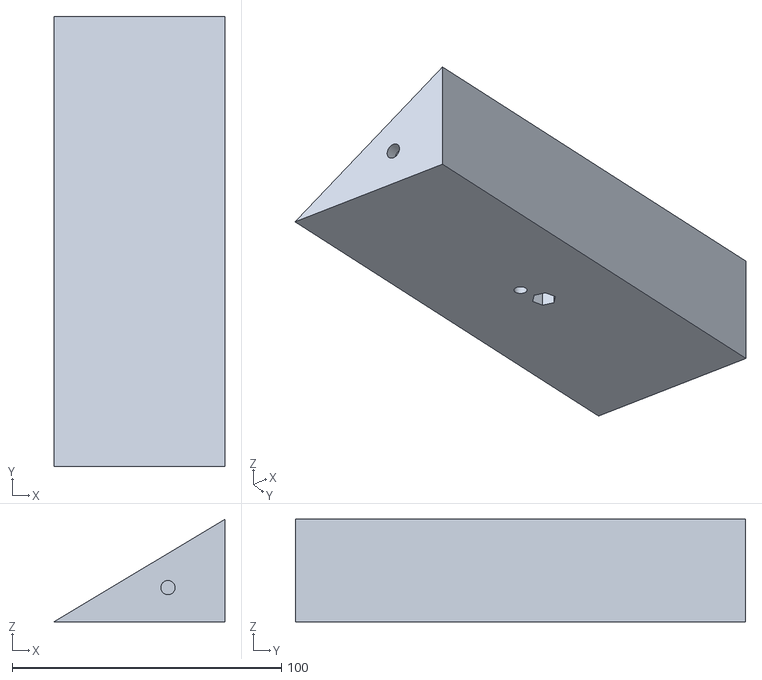
[picture p194: CAD file, 2026-10-23]
print/base-rear/filler-bevel-L-part2of2.stl
63.5 x 167.2 x 38.1
