nolanstr/diycnc/print/base-front/cast-in-leg-front-l-plug.stl

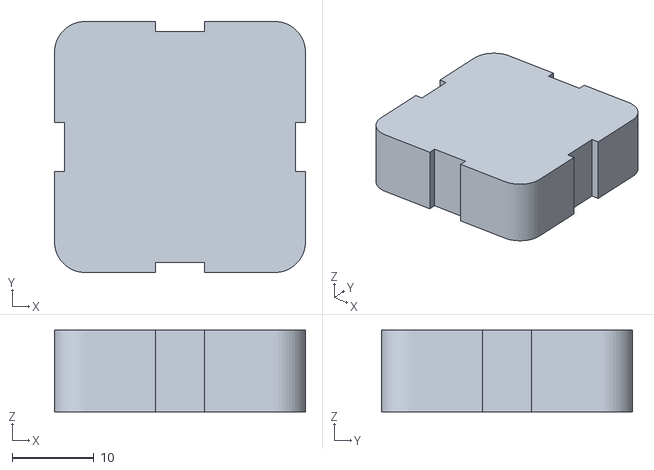
[picture p196: CAD file, 2026-10-23]
print/base-front/cast-in-leg-front-l-plug.stl
30.8 x 30.8 x 10.0
