nolanstr/diycnc/print/base-front/plug-draw-pocket-L.stl

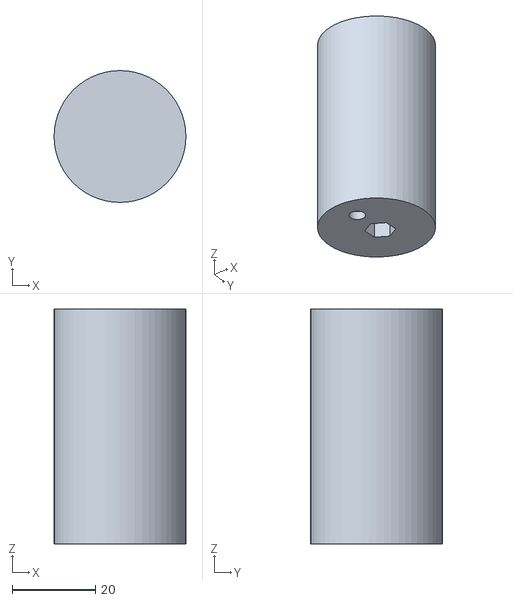
[picture p197: CAD file, 2026-10-12]
print/base-front/plug-draw-pocket-L.stl
31.7 x 31.7 x 56.5
