nolanstr/diycnc/print/base-rear/plug-draw-pocket-R.stl

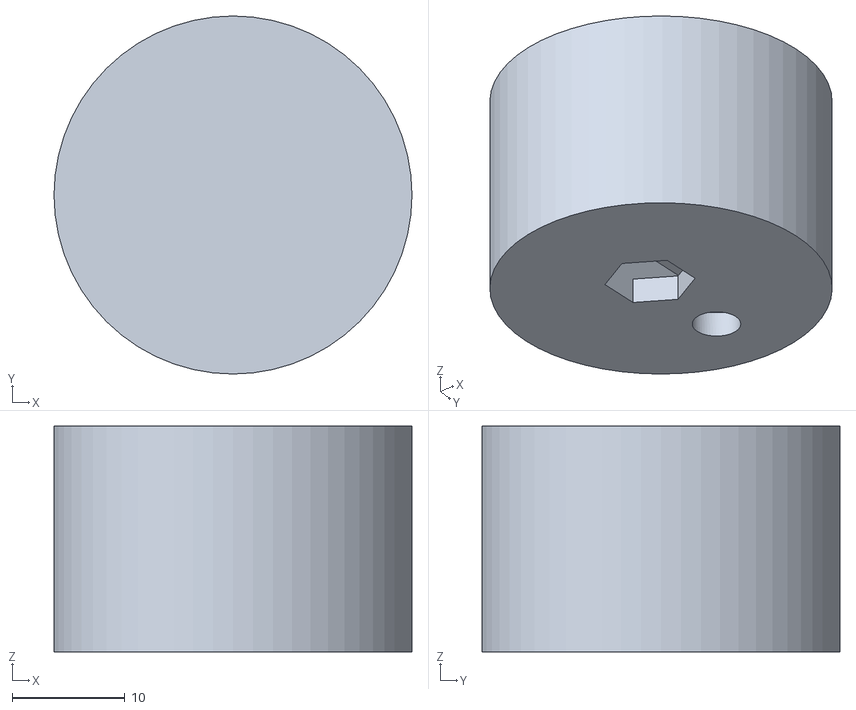
[picture p198: CAD file, 2026-10-12]
print/base-rear/plug-draw-pocket-R.stl
31.7 x 31.7 x 20.0
