nolanstr/diycnc/(list of files, cad)

Other CAD files:
print/beam/filler-back-edge-part2of3.stl
print/base-rear/filler-bevel-R-part1of2.stl
print/beam/kit-corner-bracket.stl
print/base-front/filler-bevel-end-part2of3.stl
print/base-rear/filler-bevel-end-part3of3.stl
print/machine/part-sump-filter-frame-part1of2.stl
print/upright/former-foot-gasket-groove-part4of4.stl
print/base-front/filler-bevel-R-part2of2.stl
print/base-rear/former-gutter-R-part2of3.stl
print/base-front/filler-corner-R.stl
print/base-rear/former-split-gasket-groove-part2of4.stl
print/upright/former-foot-gasket-groove-part2of4.stl
print/upright/former-foot-gasket-groove-part3of4.stl
print/base-front/filler-bevel-L-part1of2.stl
print/base-front/former-gutter-L-part2of2.stl
print/base-rear/former-split-gasket-groove-part1of4.stl
print/base-rear/former-gutter-R-part3of3.stl
print/base-rear/filler-bevel-end-part1of3.stl
print/base-front/former-gutter-R-part1of2.stl
print/base-rear/filler-bevel-R-part2of2.stl
print/base-front/filler-corner-L.stl
print/base-rear/filler-bevel-L-part1of2.stl
print/base-rear/filler-bevel-end-part2of3.stl
print/base-rear/former-gutter-R-part1of3.stl
print/base-front/plug-draw-pocket-R.stl
print/base-rear/filler-corner-R.stl
print/base-front/core-center-b-post.stl
print/base-front/core-center-a-post.stl
print/base-front/core-outboard-R-post.stl
print/base-rear/plug-draw-pocket-L.stl
print/base-front/core-outboard-L-post.stl
print/base-rear/core-center-post.stl
print/base-rear/core-foot-b-R-post.stl
print/base-rear/core-foot-b-L-post.stl
