nolanstr/diycnc/docs/src/mould-guide.md

# Mould guide

How to make the moulds for the five castings, put them together, and take them apart again. The
moulds are melamine boards that bolt together with printed brackets; every printed piece bolts or
pins to its board from outside, and the bulky hidden cores are foam. Nothing is glued, nothing
goes through a face the mix touches, and the moulds come apart cleanly for the next casting.

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

The rear base-half mould ready to pour: boards see-through, printed kit in orange, foam in blue

**The order of work:** print the kit (about a week of printer time, so start first) &rarr; cut and
drill the boards &rarr; cut the foam &rarr; wax &rarr; assemble a mould &rarr; cast &rarr; take it
apart. Cast in this order: base rear half, base front half (against the rear half), the two uprights
together, the beam.

## 1. How the moulds work

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

A corner of the base mould, the right way up

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

The captive nut: drop it in, slide it under the hole, bolt through the board

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

Pins on a gasket-groove bead

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

Peg and socket between the parts of a long former

**Cores** (the pockets in the base underside) are blocks of XPS foam wrapped in packing tape. Each
has a printed post glued into it; the post bolts to the side of a bridge (a board standing on edge
across the mould, in printed saddles on the wall tops), which sets its height and stops it floating.

A foam core hanging from its bridge

**Fits** are 0.15 mm a side: snug, but they go together by hand. Board thickness matters: the
saddles and cradles are drawn for 19.05 mm board (Home Depot's 3/4 in white melamine is a true
0.750 in). Measure yours; if it differs, set `mould_board` in `model/build_cnc.py` and re-run it.

## 2. What you need

| Material | Amount | Notes |
|---|---|---|
| Melamine board, 19 mm (3/4 in) | 2 sheets, 4 x 8 ft | the layout below; have the store rip the strips |
| XPS foam board, 2 in | 1 sheet, 2 x 8 ft | the cores; stack two layers for the 90 mm ones |
| PETG | 2 x 1 kg rolls | 1.19 kg for the moulds and cast-in parts (sliced) |
| Packing tape, double-sided carpet tape | 1 roll each | foam wrapping and holding |
| Paste wax (Partall #2) and PVA | 1 each | release, 3-5 coats |
| 3/8 in quarter-round moulding (PVC) | about 6 m | the 10 mm outside edges of the castings |
| 2x4 offcut | 4 blocks, about 50 mm | feet for each upright mould |

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

## 3. Print the kit

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

The mould kit (reused for every casting):

The printed mould kit

The formers, fillers and plugs (each shapes part of a casting):

Formers, fillers and plugs

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

## 4. Cut the boards

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

Sheet 1

Sheet 2

| Mould | Board | Qty | Size (mm) | Notes |
|---|---|---|---|---|
| Base | Base floor | 1 | 718 x 843 | both halves are cast on it |
| Base | Base front wall | 1 | 638 x 135 |  |
| Base | Base rear wall | 1 | 638 x 135 |  |
| Base | Base side wall, left | 1 | 724 x 135 |  |
| Base | Base side wall, right | 1 | 724 x 135 |  |
| Base | Base partition | 1 | 600 x 135 | rear half only; comes out before the front half |
| Base | Base partition strut | 2 | 326 x 60 | offcut, stands on edge; holds the partition foot (rear half only) |
| Base | Base cleat, front | 1 | 638 x 40 | offcut strip, flat on the floor |
| Base | Base cleat, rear | 1 | 638 x 40 | offcut strip, flat on the floor |
| Base | Base cleat, left | 1 | 724 x 40 | offcut strip, flat on the floor |
| Base | Base cleat, right | 1 | 724 x 40 | offcut strip, flat on the floor |
| Base | Base bridge y=-190 | 1 | 651 x 60 |  |
| Base | Base bridge y=-58 | 1 | 651 x 60 |  |
| Base | Base bridge y=100 | 1 | 651 x 60 |  |
| Base | Base bridge y=170 | 1 | 651 x 60 |  |
| Base | Base bridge y=280 | 1 | 651 x 60 |  |
| Base | Base leg bridge y=-310 | 1 | 480 x 60 |  |
| Base | Base leg bridge y=344 | 1 | 480 x 60 |  |
| Uprights | Upright floor | 2 | 198 x 575 |  |
| Uprights | Upright side plate, outer | 2 | 495 x 271 (profile) | cut to the profile |
| Uprights | Upright side plate, inner | 2 | 495 x 271 (profile) | cut to the profile |
| Uprights | Upright back board | 2 | 80 x 271 |  |
| Uprights | Upright front board | 2 | 80 x 312 | ends cut square |
| Uprights | Upright bridge | 2 | 131 x 108 |  |
| Uprights | Upright cleat, outer | 2 | 405 x 40 | offcut strip, flat on the floor |
| Uprights | Upright cleat, inner | 2 | 405 x 40 | offcut strip, flat on the floor |
| Uprights | Upright cleat, back | 2 | 80 x 40 | offcut strip, flat on the floor |
| Beam | Beam floor | 1 | 648 x 258 |  |
| Beam | Beam top wall | 1 | 568 x 165 |  |
| Beam | Beam bottom wall | 1 | 568 x 165 |  |
| Beam | Beam end wall, left | 1 | 140 x 165 |  |
| Beam | Beam end wall, right | 1 | 140 x 165 |  |
| Beam | Beam cleat, top | 1 | 568 x 40 | offcut strip, flat on the floor |
| Beam | Beam cleat, bottom | 1 | 568 x 40 | offcut strip, flat on the floor |
| Beam | Beam cleat, left | 1 | 140 x 40 | offcut strip, flat on the floor |
| Beam | Beam cleat, right | 1 | 140 x 40 | offcut strip, flat on the floor |

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

## 5. Drill the boards

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

### Base

#### Base floor

Base floor

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

#### Base front wall

Base front wall

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

#### Base rear wall

Base rear wall

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

#### Base side wall, left

Base side wall, left

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

#### Base side wall, right

Base side wall, right

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

#### Base partition

Base partition

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

#### Base cleat, front

Base cleat, front

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

#### Base cleat, rear

Base cleat, rear

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

#### Base cleat, left

Base cleat, left

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

#### Base cleat, right

Base cleat, right

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

#### Base bridge y=-190

Base bridge y=-190

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

#### Base bridge y=-58

Base bridge y=-58

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

#### Base bridge y=100

Base bridge y=100

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

#### Base bridge y=170

Base bridge y=170

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

#### Base bridge y=280

Base bridge y=280

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

#### Base leg bridge y=-310

Base leg bridge y=-310

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

#### Base leg bridge y=344

Base leg bridge y=344

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

### Uprights

#### Upright floor (x2)

Upright floor

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

#### Upright side plate, outer (x2)

Upright side plate, outer

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

Outline corners (x, y): (0, 0), (495, 0), (495, 271), (264, 271)

#### Upright side plate, inner (x2)

Upright side plate, inner

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

Outline corners (x, y): (495, 0), (0, 0), (0, 271), (231, 271)

#### Upright back board (x2)

Upright back board

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

#### Upright front board (x2)

Upright front board

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

#### Upright bridge (x2)

Upright bridge

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

#### Upright cleat, outer (x2)

Upright cleat, outer

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

#### Upright cleat, inner (x2)

Upright cleat, inner

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

#### Upright cleat, back (x2)

Upright cleat, back

| # | x | y | Hole | For |
|---|---|---|---|---|
| 1 | 40 | 20 | 4.5 | cleat |

### Beam

#### Beam floor

Beam floor

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

#### Beam top wall

Beam top wall

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

#### Beam bottom wall

Beam bottom wall

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

#### Beam end wall, left

Beam end wall, left

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

#### Beam end wall, right

Beam end wall, right

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

#### Beam cleat, top

Beam cleat, top

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

#### Beam cleat, bottom

Beam cleat, bottom

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

#### Beam cleat, left

Beam cleat, left

| # | x | y | Hole | For |
|---|---|---|---|---|
| 1 | 100 | 20 | 4.5 | cleat |
| 2 | 40 | 20 | 4.5 | cleat |

#### Beam cleat, right

Beam cleat, right

| # | x | y | Hole | For |
|---|---|---|---|---|
| 1 | 100 | 20 | 4.5 | cleat |
| 2 | 40 | 20 | 4.5 | cleat |

## 6. Cut the foam

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

| Casting | Piece | Qty | Size and how |
|---|---|---|---|
| base-front | centre | 1 | XPS block 100 x 185 x 90 mm, outline as the pocket (chamfered corners); taped, with its printed post glued in. |
| base-rear | centre | 1 | XPS block 100 x 190 x 90 mm, outline as the pocket (chamfered corners); taped, with its printed post glued in. |
| base-front | outboard-L | 1 | XPS block 130 x 164 x 90 mm, outline as the pocket (chamfered corners); taped, with its printed post glued in. |
| base-front | trough-band-L | 1 | XPS block 101 x 55 x 40 mm, outline as the pocket (chamfered corners); taped, with its printed post glued in. |
| base-front | draw-rod-L | 1 | XPS block 37 x 255 x 40 mm, outline as the pocket (chamfered corners); taped, with its printed post glued in. |
| base-front | foot-a-L | 1 | XPS block 68 x 66 x 90 mm, outline as the pocket (chamfered corners); taped, with its printed post glued in. |
| base-rear | foot-b-L | 1 | XPS block 68 x 100 x 90 mm, outline as the pocket (chamfered corners); taped, with its printed post glued in. |
| base-rear | foot-c-L | 1 | XPS block 80 x 63 x 90 mm, outline as the pocket (chamfered corners); taped, with its printed post glued in. |
| base-rear | knee-L | 1 | XPS block 50 x 183 x 40 mm, outline as the pocket (chamfered corners); taped, with its printed post glued in. |
| base-rear | outer-a-L | 1 | XPS block 35 x 43 x 65 mm, outline as the pocket (chamfered corners); taped, with its printed post glued in. |
| base-rear | outer-b-L | 1 | XPS block 35 x 60 x 65 mm, outline as the pocket (chamfered corners); taped, with its printed post glued in. |
| base-rear | rear-L | 1 | XPS block 170 x 52 x 90 mm, outline as the pocket (chamfered corners); taped, with its printed post glued in. |
| base-front | outboard-R | 1 | XPS block 130 x 164 x 90 mm, outline as the pocket (chamfered corners); taped, with its printed post glued in. |
| base-front | trough-band-R | 1 | XPS block 101 x 55 x 40 mm, outline as the pocket (chamfered corners); taped, with its printed post glued in. |
| base-front | draw-rod-R | 1 | XPS block 37 x 255 x 40 mm, outline as the pocket (chamfered corners); taped, with its printed post glued in. |
| base-front | foot-a-R | 1 | XPS block 68 x 66 x 90 mm, outline as the pocket (chamfered corners); taped, with its printed post glued in. |
| base-rear | foot-b-R | 1 | XPS block 68 x 100 x 90 mm, outline as the pocket (chamfered corners); taped, with its printed post glued in. |
| base-rear | foot-c-R | 1 | XPS block 80 x 63 x 90 mm, outline as the pocket (chamfered corners); taped, with its printed post glued in. |
| base-rear | knee-R | 1 | XPS block 50 x 183 x 40 mm, outline as the pocket (chamfered corners); taped, with its printed post glued in. |
| base-rear | outer-a-R | 1 | XPS block 35 x 43 x 65 mm, outline as the pocket (chamfered corners); taped, with its printed post glued in. |
| base-rear | outer-b-R | 1 | XPS block 35 x 60 x 65 mm, outline as the pocket (chamfered corners); taped, with its printed post glued in. |
| base-rear | rear-R | 1 | XPS block 170 x 52 x 90 mm, outline as the pocket (chamfered corners); taped, with its printed post glued in. |
| base-rear | socket | 4 | XPS block 41 x 41 x 80 mm, taped; dig it out after curing (a little acetone dissolves the rest). |

A socket core: printed spike bolted to the floor, the foam pushed over it

## 7. Prepare the surfaces

- Wax every face the mix touches, boards and removable printed pieces alike: 3-5 thin coats of paste
  wax, each buffed, then a coat of PVA. Don't wax the pieces that stay in (core posts, cast-in parts):
  scuff them and wipe them with acetone so the epoxy grips.
- The castings' outside edges are rounded 10 mm: glue 3/8 in quarter-round moulding into the inside
  corners that form outside edges (floor to wall), and run a small silicone fillet into the others.
- Grease every screw, bolt and rod that will come out of the casting.

## 8. Put the moulds together

### Base, rear half (cast first)

Both base halves are cast on the same floor board. The rear half goes first, against a partition at
the split; then the partition comes out and the front half is cast against the rear half's waxed
split face. The two top faces come out flush, the split faces match, and the front tubes slide
straight onto the rear half's spigots. The base is cast upside down (its top face on the floor);
these pictures show the mould the right way up.

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

Base rear, step 1

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

Base rear, step 2

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

Base rear, step 3

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

Base rear, step 4

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

Base rear, step 5

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

Base rear, step 6

### Base, front half (against the rear half)

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

Base front, step 1

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

Base front, step 2

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

Base front, step 3

### Uprights (two moulds, cast together)

The uprights are cast foot down. Both are the same, so build two of everything.

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

Upright, step 1

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

Upright, step 2

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

Upright, step 3

4. Stand the mould on its four 2x4 blocks. Push the posts up through the bushings onto the bench, and the greased 5/8 in rods up through the floor: the two short ones into the slope plugs (bolted to the front board), the two long ones on through the top. The dowel-hole bolt and nut go in from underneath.

Upright, step 4

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

Upright, step 5

The toe filler holds the front board's foot

### Beam

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

Beam, step 1

2. Stand the walls against the cleats and fit the four corner brackets.

Beam, step 2

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

Beam, step 3

A tube locator: a cross in the tube end, bolted through the end wall

## 9. Pouring, and the pour line

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

## 10. Taking it apart, and reuse

1. Leave it the full cure time (build guide). Unbolt the bridges and saddles, then the corner
   brackets, then the cleats; pull the walls straight off (a plastic wedge in the corner helps).
2. Unscrew every insert screw, coupler bolt and rod from outside, then lift the casting off the floor
   (or the floor off the casting).
3. Unbolt and pull the formers and fillers (the bolts come out from the board side first). A wooden
   dowel and a light tap frees a stuck one. Dig out the socket foam; the pocket cores can stay.
4. Scrape the boards, re-wax them, and store the kit pieces with their nuts in a box per mould. The
   same kit does the next casting; only the formers and pieces that stay in are per casting.

## 11. If something doesn't fit

| Problem | Fix |
|---|---|
| A nut won't slide under the hole | Clean the pocket with a 7 mm nut on a bolt; a warm nut (hair dryer) pushes in |
| A bracket or saddle is loose on the board | Your board is thinner than set: shim with tape, or set `mould_board` and reprint |
| A pin won't go into its hole | Run a 1/8 in bit through the hole again; trim the pin tip with a knife |
| A foam core moves while pouring | Check its post bolt is tight and the post is glued; add carpet tape under it |
| Mix leaks at a corner | A silicone fillet inside the corner before waxing; check the diagonals and brackets |
| A former is stuck after curing | Bolts out first; then a dowel and a light tap from its thick end |
