nolanstr/diycnc/docs/4-build/2-casting.pdf

# Build guide 2: molds and casting

DIY CNC epoxy-granite mill · October 2026

## 2. Molds and cores

The molds are a kit. Melamine boards are cut to a list and drilled from hole maps, and printed brackets hold them together with M4 bolts. Every printed piece bolts or pins to its board from outside, into a nut built into the piece. Nothing is glued, nothing goes through a cast face, and the molds come apart and go back together the same way. The mold guide has the cut list, the hardware, a drawing and a hole table for every board, and the steps ( docs/3-molds/ , one guide per mold); the print guide lists the printed parts.

Walls stand 25 mm above the pour line. The brackets, saddles and leg holders bolt through that band. Fill to the line, not to the top.
Everything that has to be flat or located goes against the floor, so each casting is poured with its most important face down.
Edges: the castings' outside edges are rounded 10 mm. Glue 3/8 in quarter-round molding (PVC or primed wood) into the inside corners of the boxes that form outside edges, and run small silicone fillets everywhere else. The base's lower edge is a bevel, 1-1/2 in in and 2-1/2 in up, formed by a strip along each wall at the pour line: a 2x3 ripped corner to corner on a table saw and screwed to the wall from outside, or the printed bevel strips. Printed pieces fill the corners either way.
Release: wax every surface the mix touches 3-5 times (Partall Paste #2), buff, then spray or wipe PVA. That includes the printed pieces that come out; not the ones that stay in.
Casting | Face on the mold floor | Size (mm) | Mass
Base front | top face (coolant floor) | 600 x 345 x 110 | 31.6 kg
Base rear | top face | 600 x 380 x 110 | 39.7 kg
Upright (x2) | foot (the face that sits on the base) | 80 wide, foot 400 long, 246 tall, sloped front | 12.1 kg each
Beam | front face (rails) | 530 x 140 x 140 | 23.7 kg

Casting order:

1. Base rear half, against a partition at the split, on a floor board big enough for both halves.
2. Base front half on the same floor, with the partition out, cast against the rear half's waxed split face. The two top faces come out flush and the split faces match. The front grid's end plates go straight onto the rear half's dowel pins, and the draw rods run on through, so that joint fits by construction. The split's gasket groove is in the rear half; tape over it first.
3. Uprights, one after the other in the same mold (the two are the same part): take it apart after the first one cures, scrape and re-wax it, and cast the second.
4. Beam.

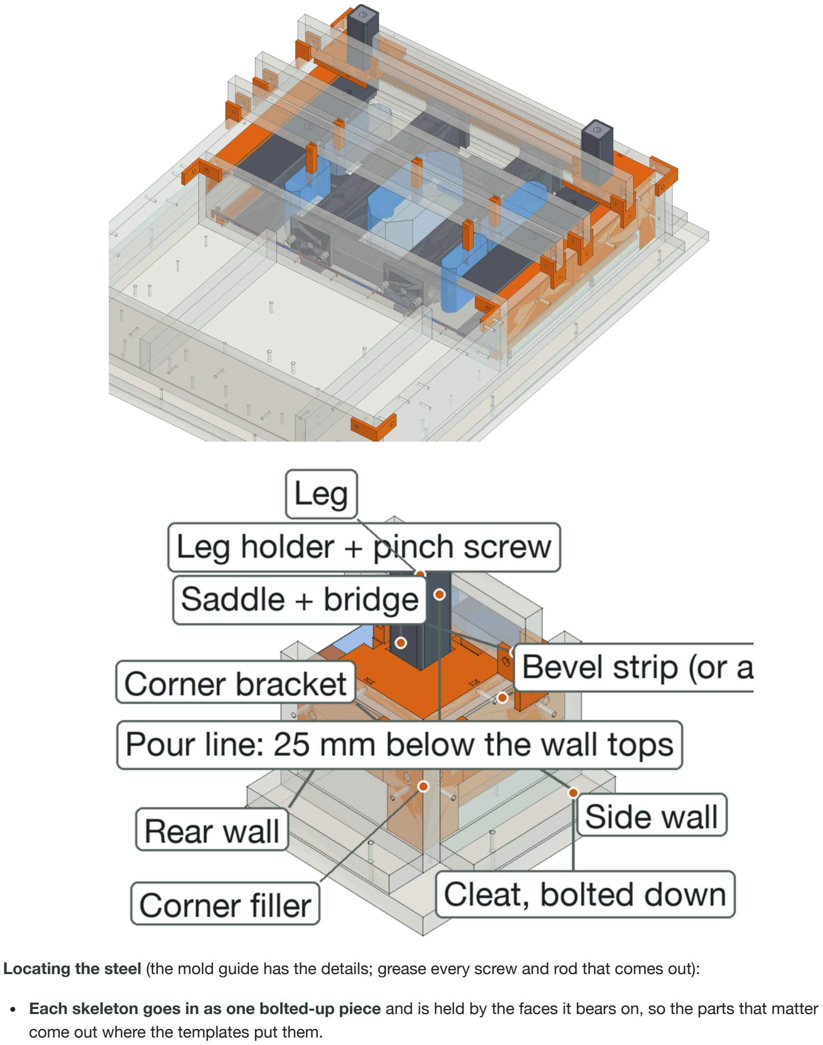
[picture p218: page 2]

Locating the steel (the mold guide has the details; grease every screw and rod that comes out):

Each skeleton goes in as one bolted-up piece and is held by the faces it bears on, so the parts that matter come out where the templates put them.

Base: the grid lies upside down on the floor (the base is cast top face down). Greased M5 and M6 screws through the floor hold its rail bars and support pads; the dowels through the floor and the seat bars locate the pedestals. The draw rods and tie rods sit inside the tubes, so nothing forms their holes; tape over the holes in the pedestals' bottom bars (they're at the pour line). For the front half, the front grid's split end plates go onto the rear half's dowel pins. Printed plugs form the draw-rod nut pockets down to the girders' end plates. The 15 inserts (11 for the enclosure, 4 for the way-cover rollers) screw to the floor; the rear rollers' other feet go into two M5 holes in the BK pad, screwed to the floor like the rest of the grid.
Dowels (rear half): two per upright, through the floor and the seat bars; they stand 15 mm proud and are grouted into oversize holes in the upright's foot at assembly (section 4).
Legs: through printed holders near the corners (65 mm in from the sides and the front, 62 mm from the back, behind the bevel), each held at its cast-in depth by a pinch screw.
Cores: taped XPS foam blocks on the wet 20 mm skin, between the steel; a printed post glued into each bolts to the side of a bridge. They can stay in.
Uprights: the foot bar lies on the floor. Stand the columns on a bed of thickened epoxy on it, set the top plate and bridge on them while it goes off, then lift those away and fill. The top plate goes back on, hung from the bridge on two greased 3/8 bolts, and the two column tie rods (greased) go up from under the floor through the foot bar and the columns into the plate, to hold the columns centered while it cures. A printed plug forms the toe pocket down to the foot bar; greased 1/2-13 bolts form the two dowel holes.
Beam: the face bar lies on the floor, held by greased M5 and M6 screws into its tapped holes, the back bar on its spacers above it; greased 1/2 in rods through the walls and the cap and seat bars form the stud holes. The dowels sit in the bottom wall on printed stops; the cable-chain mount's two inserts screw to the top wall.

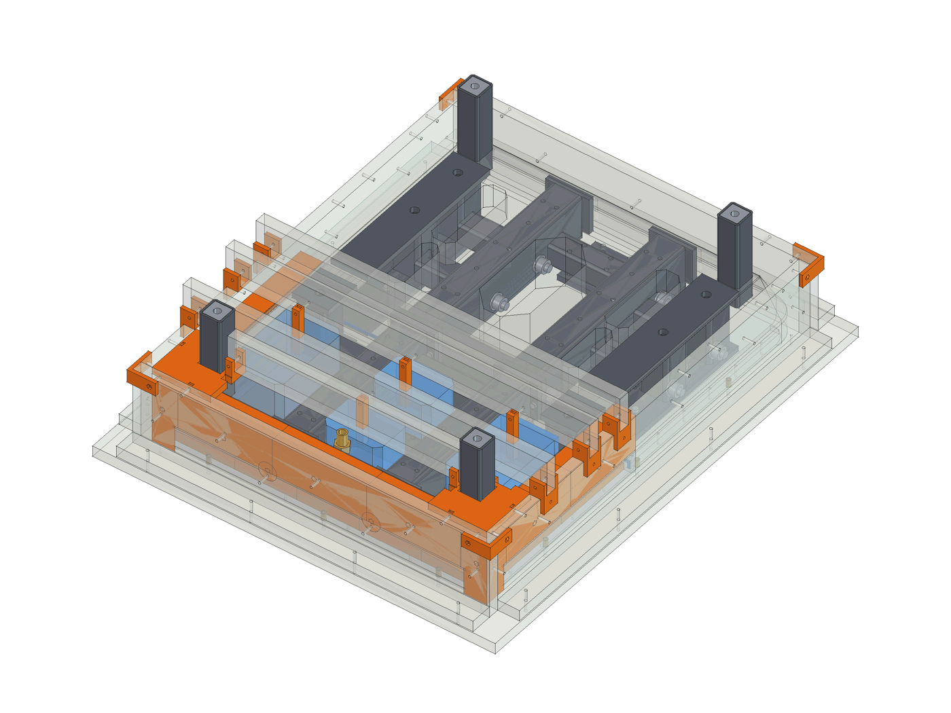
[picture p219: figure]
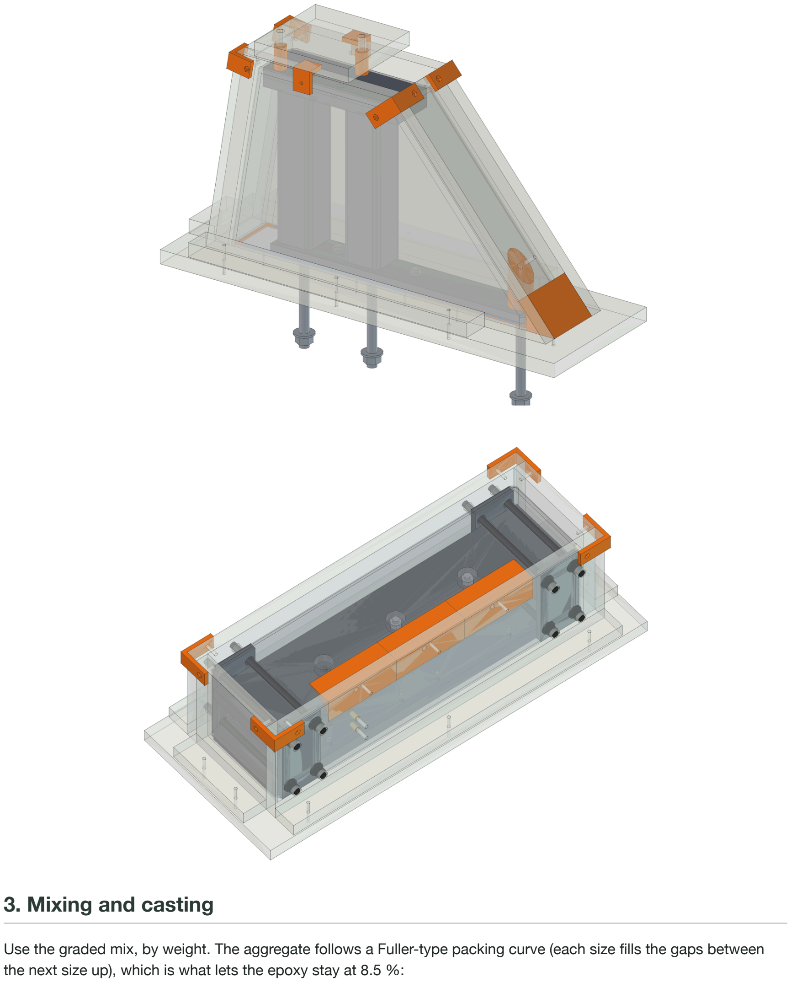
[picture p220: page 4]

## 3. Mixing and casting

Use the graded mix, by weight. The aggregate follows a Fuller-type packing curve (each size fills the gaps between the next size up), which is what lets the epoxy stay at 8.5 %:

Part | Size | Source | % of mix | For the whole frame
Epoxy | | Raka 127 + 606 | 8.5 % | 9.6 kg
Whiting (calcium carbonate) | 325 mesh, under 0.05 mm | pottery supplier | 9 % | 10 kg
Fine sand | 0.1-0.6 mm | pool filter sand (#20 silica) | 15 % | 17 kg
Coarse sand | 0.6-3 mm | concrete / all-purpose sand, sieved | 27.5 % | 31 kg
Pea gravel | 3-6 mm | bagged pea gravel, sieved | 20 % | 23 kg
Gravel | 6-10 mm | 3/8 in crushed stone (#8) or bigger pea gravel | 20 % | 23 kg

Two kitchen-type sieves (about 3 and 6 mm mesh, or hardware cloth) split the bagged sand and gravel into these bands. Wash anything dusty or clay-coated, and dry everything completely (spread it out in the sun, or an old oven tray): water stops the epoxy bonding. Crushed stone locks together a little stiffer than rounded gravel; rounded flows and packs a little better; either works.

The same mix in every casting. The beam and uprights get their extra stiffness from steel (3/4 in beam bars, 3/16 in column walls), so all five castings use this plain mix. (Optional, and only before the pour: brown fused #16 aluminum oxide grit, about five times stiffer than sand, in place of the coarse sand in the beam and uprights adds about 8 % on the frame for one 50 lb bag. It's heavier, so swap it by volume: 1.5 kg of #16 for every 1 kg of coarse sand, everything else, epoxy included, the same. Don't over-vibrate it: the heavy grit can settle. Black 70 grit for the fine sand, 1.4 kg for every 1 kg, is a further option on top.)

8.5 % only works if the aggregate packs densely, so prove the mix before casting anything:

1. Jar test. Fill a 1 L jar with the dry aggregate blend (no whiting), shaking and tapping it down, then pour in water from a measuring cup until it reaches the top. The water is the void space. Nudge the coarse sand and fine sand up or down a few percent until it's as small as you can get it (below about 25 % of the jar is good).
2. Test bars. Print or build a 40 x 40 x 500 mm bar mold (waxed like the others) and cast two bars at 8.5 % and two at 9.5 %, about 2 kg each, vibrated the same way as the castings (and two at 8.5 % with the #16 grit, if you use it).
3. Check them after 7 days. Cut one bar of each pair open: there should be no voids larger than a grain of sand, and every stone should be wetted. Then tap-test the other: weigh it, rest it on two foam strips 112 mm in from each end, tap the middle with a small hammer and read the lowest strong peak on a phone spectrum app (phyphox, Spectroid). Its stiffness is about E (GPa) = 4.8e-5 x mass (kg) x frequency (Hz)². The frame model assumes 30 GPa, about 570 Hz for a 1.9 kg bar; 25 GPa would cost about 13 % of the frame stiffness.
4. Pick the mix. Use 8.5 % if its bar is void-free and at least as stiff as the 9.5 % one; otherwise use 9.5 % and order the extra 1.5 qt epoxy kit. A grit bar, if you cast one, should come out about 20 % stiffer than the plain 8.5 % one (35 % with the 70 grit as well; it's heavier, so use the formula, not the pitch); if it's well short, or it has voids, cast the beam and uprights with sand.
Casting | Mix | Epoxy (8.5 %)
Base front | 30.7 kg | 2.6 kg
Base rear | 41.1 kg | 3.5 kg
Uprights | 2 x 11.6 kg | 2 x 1.0 kg
Beam | 18.0 kg | 1.5 kg

Add 5-10 % for waste: about 10 kg, plus about 1 kg for the test bars, which fits the 3 gal kit (about 12.5 kg). Mix only what you can place; if you're running short, the 1.5 qt kit covers the gel coat.

1. Dry and clean all aggregate. Weigh everything out per batch before opening the epoxy. Keep batches to what you can place within about half the epoxy's pot life (10-15 kg each).
2. Mix order: epoxy resin + hardener (exact ratio, by weight), then the whiting until smooth, then the sands, then the gravel. Mix until every stone is wet and the color is even.
3. Place in layers of 30-40 mm. Vibrate each layer until the surface goes glossy and stops releasing bubbles, then add the next. Work the mix around the steel, inserts and cores with a stick, and pack it up under the base's bevel strips: the air runs up their slope to the open face. Vibrate the full mold for 20-30 minutes at the end.
4. Level the open face at the pour line, 25 mm below the wall tops: strike it off with a straight board in the two printed screed shoes (mold guide, "Pour"). Cover against dust, and leave it at 20-25 °C. Demold after the time your epoxy needs (usually 24-48 h), but don't load or machine anything for 7 days.
5. Pull all the greased screws and rods, the formers, fillers and plugs. Printed cores stay in; foam cores can be dug out or dissolved with a little acetone. Unbolt the mold kit; it's reused.
6. Seal the base top (the coolant floor) and the gutters with a thin epoxy gel coat. Paint the exposed leg ends.

Cast the rear base half first and the front half against it (above). Cast the two uprights, one after the other in their mold, before the beam, so you can check the top-plate spacing against the beam mold.
