nolanstr/diycnc/docs/3-molds/templates/base-templates.pdf

# Base mold: drilling templates

DIY CNC epoxy-granite mill · October 2026 · full size, US Letter

## Printing

1. Print at Actual size / 100 %. Turn off "Fit to page" and "Scale to fit". Letter paper, portrait.
2. Measure the square below: it must be 100 mm (and the bar on every page 50 mm). If it is off by more than 1 mm, fix the scaling and print again.
3. Only pages with holes are printed. Every page has a grid labeled in the board's own millimeters, from the bottom-left corner as you look at the marked face, so you can place any page on its own.

## Marking a board

1. Lay the board on the bench with the face named at the top of its pages up (the cast face, or the top face for bridges and cleats).
2. Start with the page that has the board's corner on it: line its printed edges up with the board's edges and tape it down. Add the next pages overlapping by about 12 mm, with the grid lines on top of each other; trim one edge if it helps. Where a page shows no board edge, measure to a labeled grid line with a square instead.
3. Push an awl or a center punch through every crosshair. The circle is the finished hole size, the number is the hole's number in the guide's table, and the color is its size: the legend at the top of each page gives the drill.
4. Pull the paper off, and drill from the marked face (clamp a scrap underneath). Drill a 1/8 in pilot first for anything 13 mm or bigger; the 63.5 mm holes are a 2-1/2 in hole saw.
5. Walls: pencil the dashed pour line (25 mm below the top edge) on the cast face, or mark it later with the printed pour-line gauge. The casting is filled to this line.
6. Boards marked "x2" are the same board twice: mark both from one print.

## Pages

Board | Qty | Pages | Holes
Base floor | 1 | 2-17 (16) | 90
Base front wall | 1 | 18-21 (4) | 11
Base rear wall | 1 | 22-25 (4) | 11
Base side wall, left | 1 | 26-29 (4) | 17
B | id | ll i h | 1 | 30 33 (4) | 1

100 mm

## Base floor

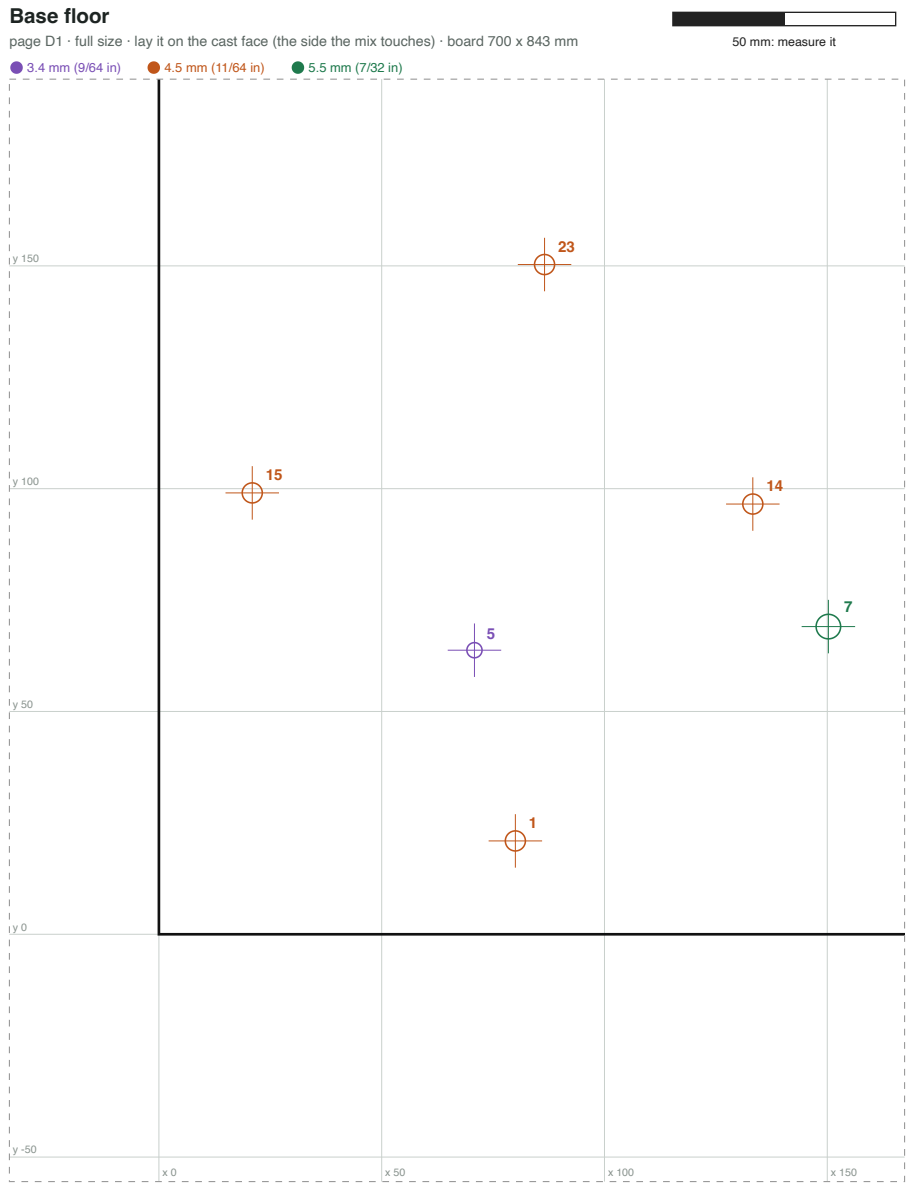
[picture p221: page 2]
page D1 · full size · lay it on the cast face (the side the mix touches) · board 700 x 843 mm; 50 mm: measure it

## Base floor

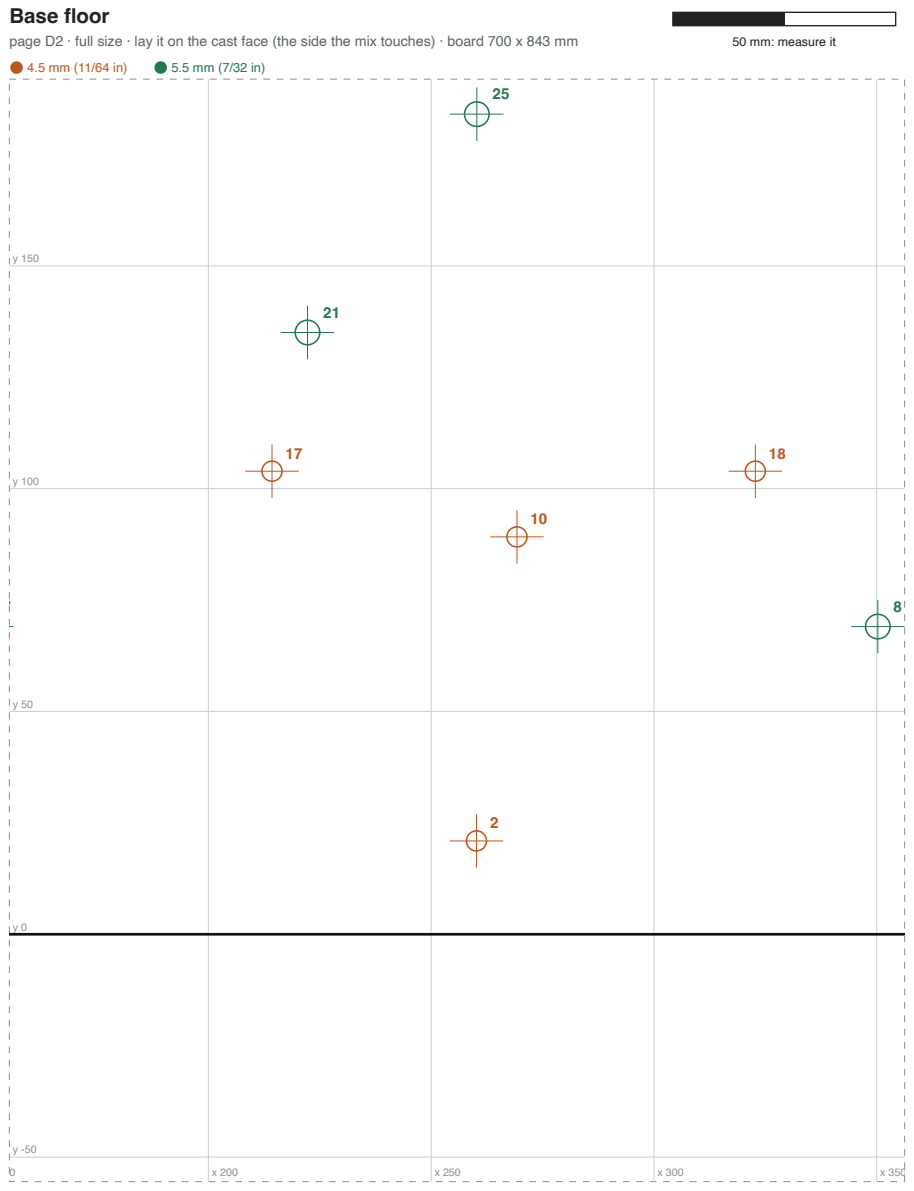
[picture p222: page 3]
page D2 · full size · lay it on the cast face (the side the mix touches) · board 700 x 843 mm; 50 mm: measure it

## Base floor

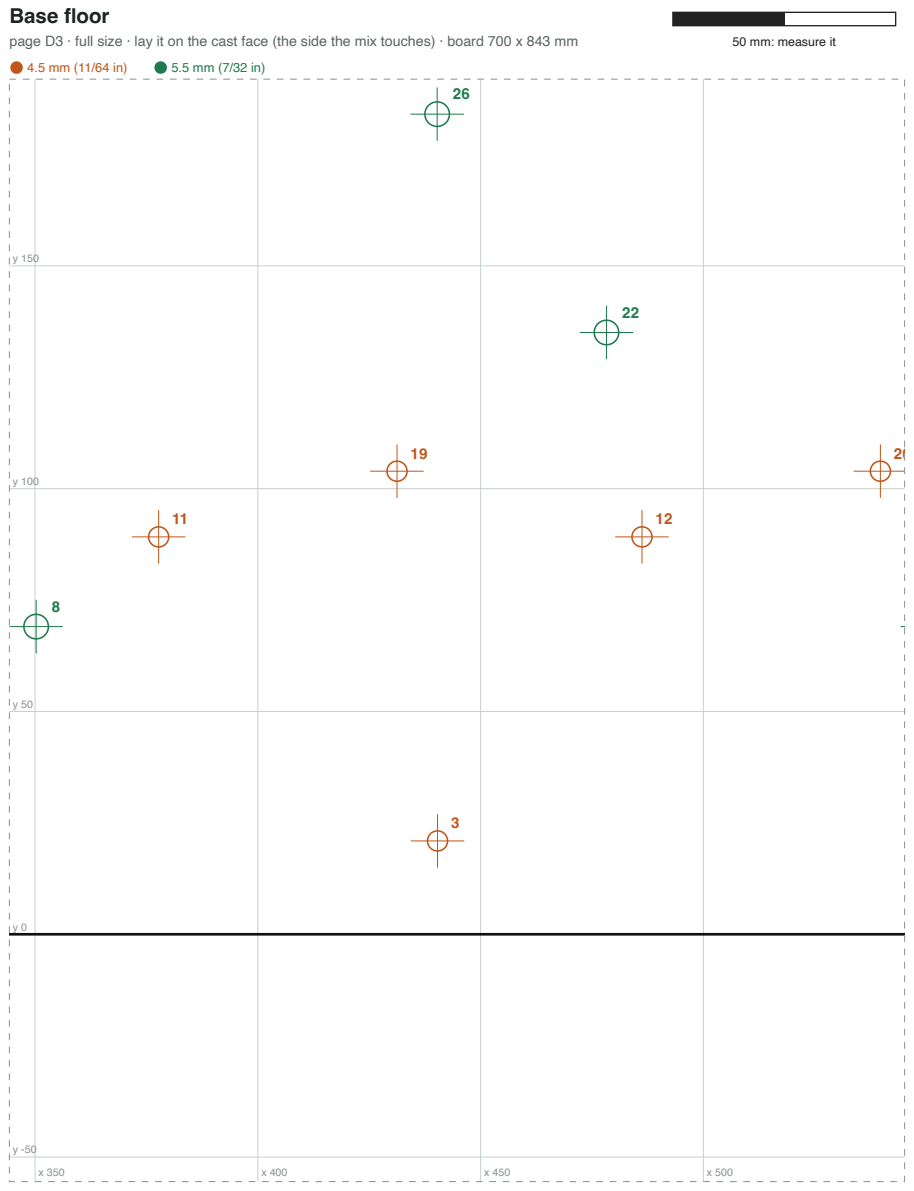
[picture p223: page 4]
page D3 · full size · lay it on the cast face (the side the mix touches) · board 700 x 843 mm; 50 mm: measure it

## Base floor

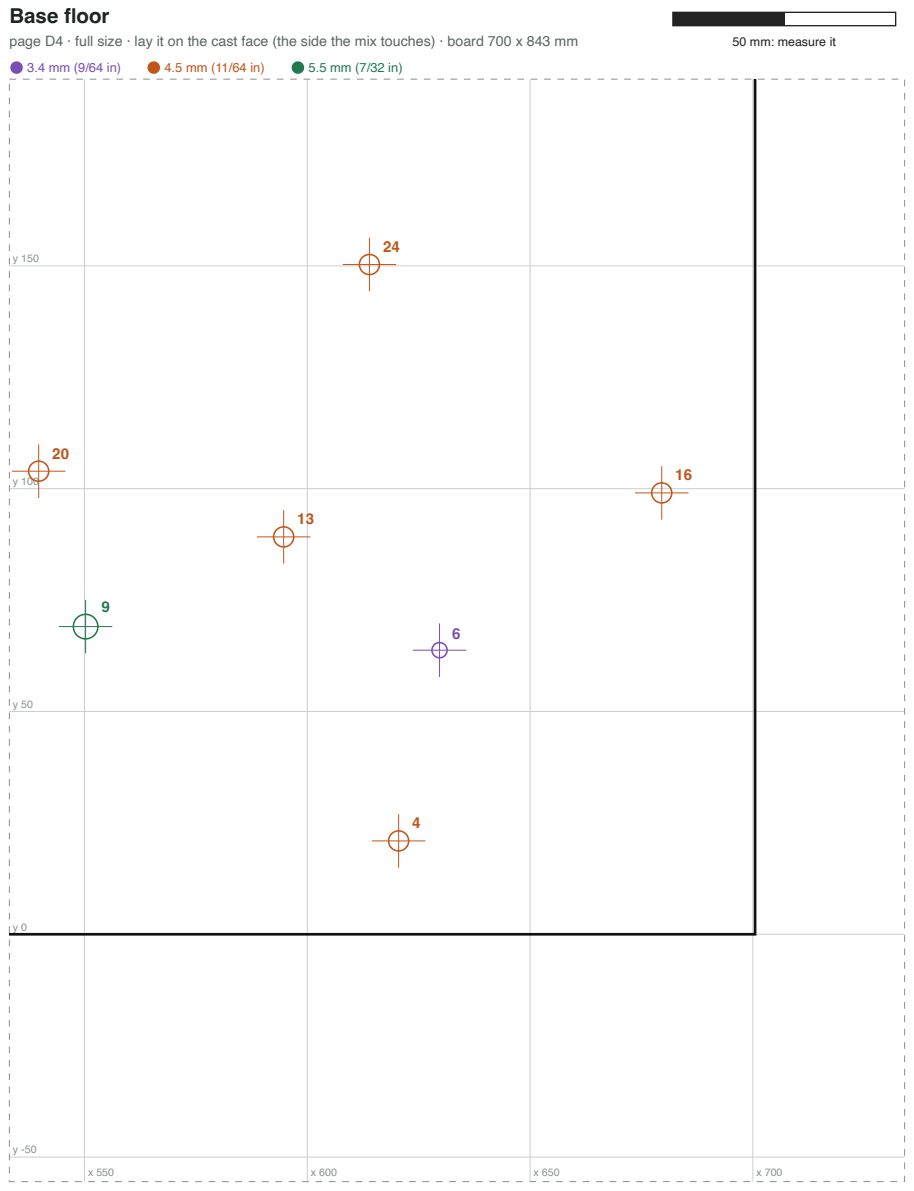
[picture p224: page 5]
page D4 · full size · lay it on the cast face (the side the mix touches) · board 700 x 843 mm; 50 mm: measure it

## Base floor

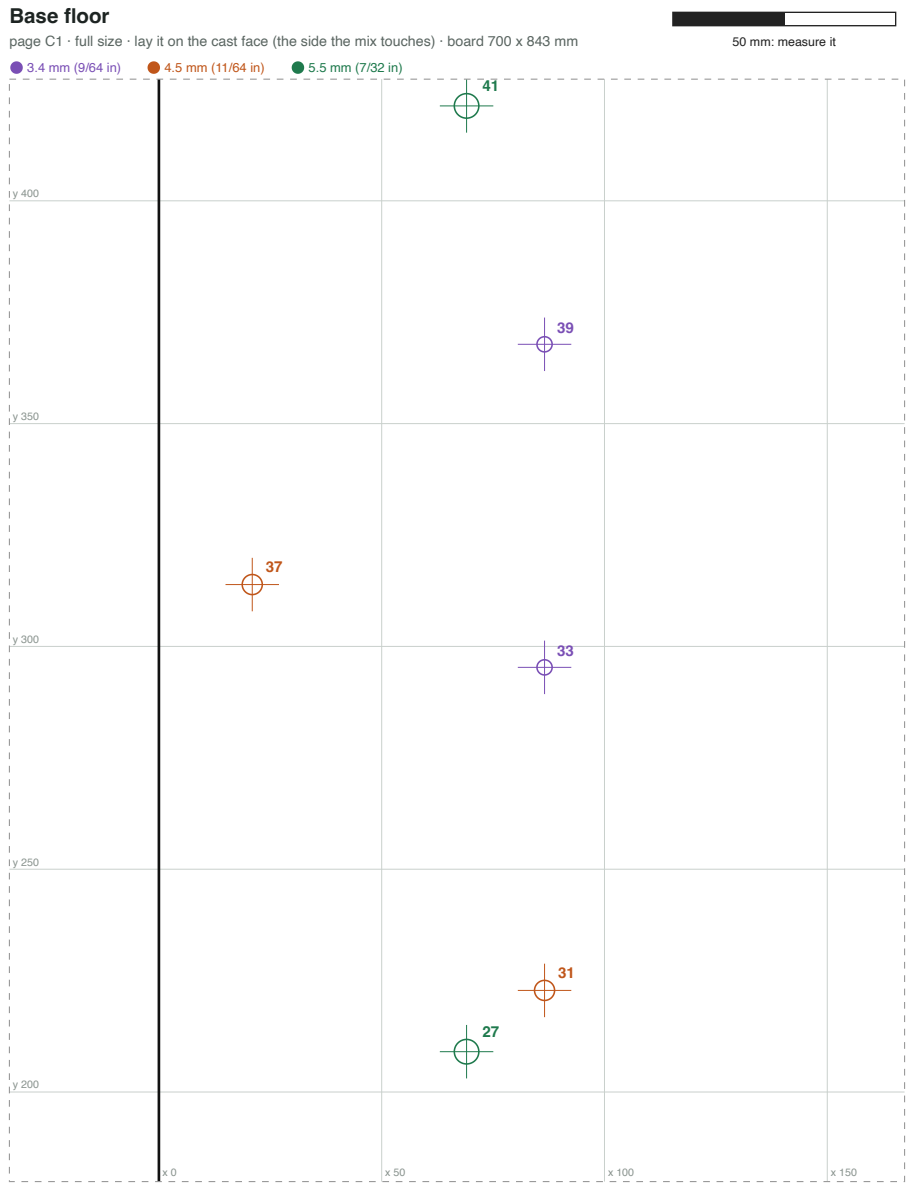
[picture p225: page 6]
page C1 · full size · lay it on the cast face (the side the mix touches) · board 700 x 843 mm; 50 mm: measure it

## Base floor

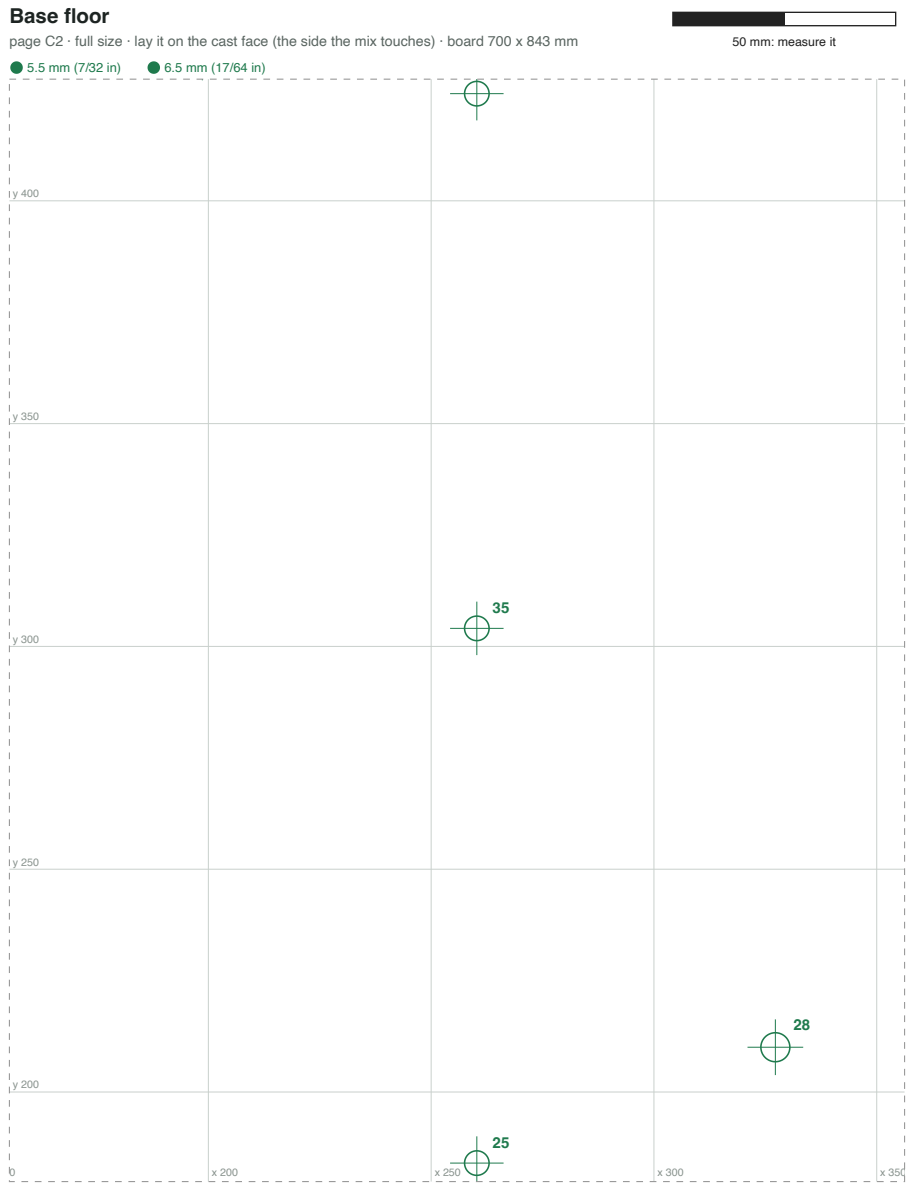
[picture p226: page 7]
page C2 · full size · lay it on the cast face (the side the mix touches) · board 700 x 843 mm; 50 mm: measure it

## Base floor

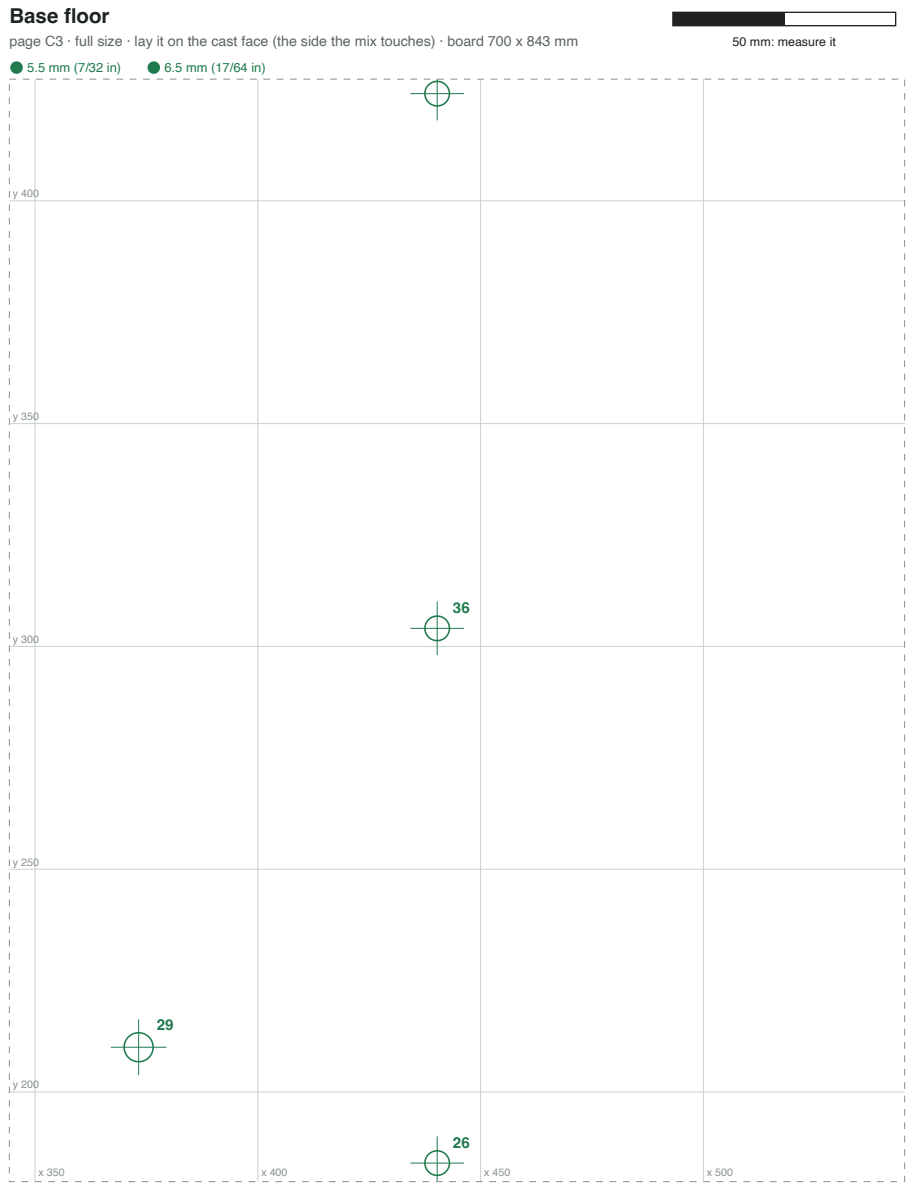
[picture p227: page 8]
page C3 · full size · lay it on the cast face (the side the mix touches) · board 700 x 843 mm; 50 mm: measure it

## Base floor

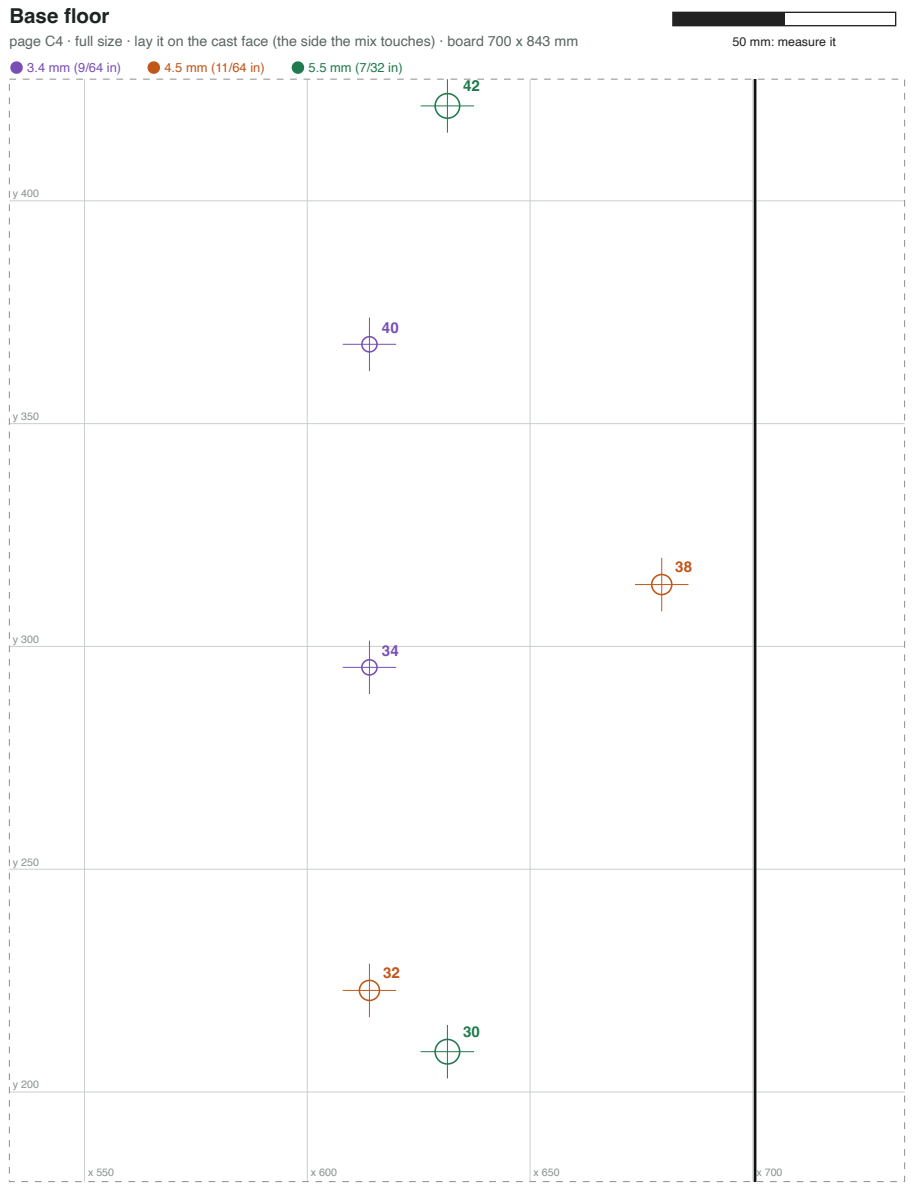
[picture p228: page 9]
page C4 · full size · lay it on the cast face (the side the mix touches) · board 700 x 843 mm; 50 mm: measure it

## Base floor

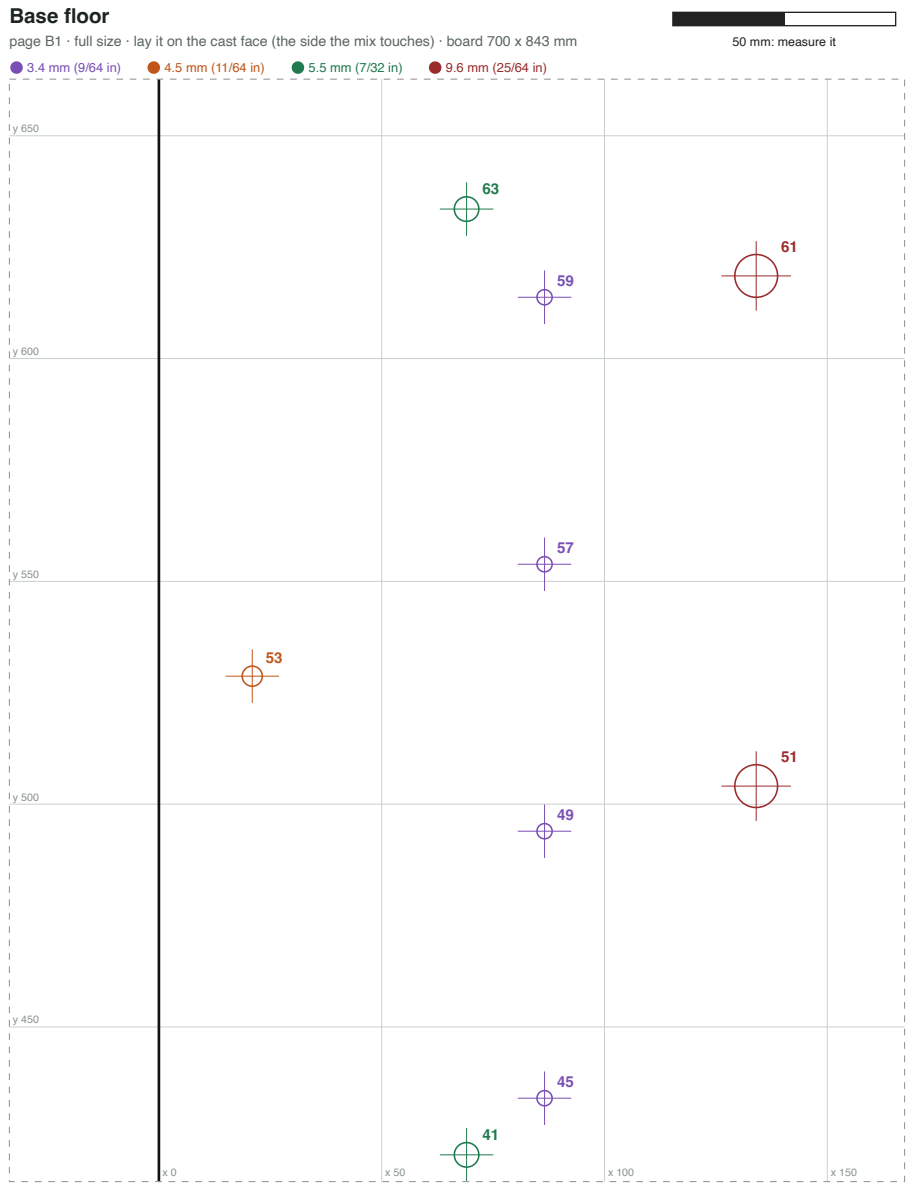
[picture p229: page 10]
page B1 · full size · lay it on the cast face (the side the mix touches) · board 700 x 843 mm; 50 mm: measure it

## Base floor

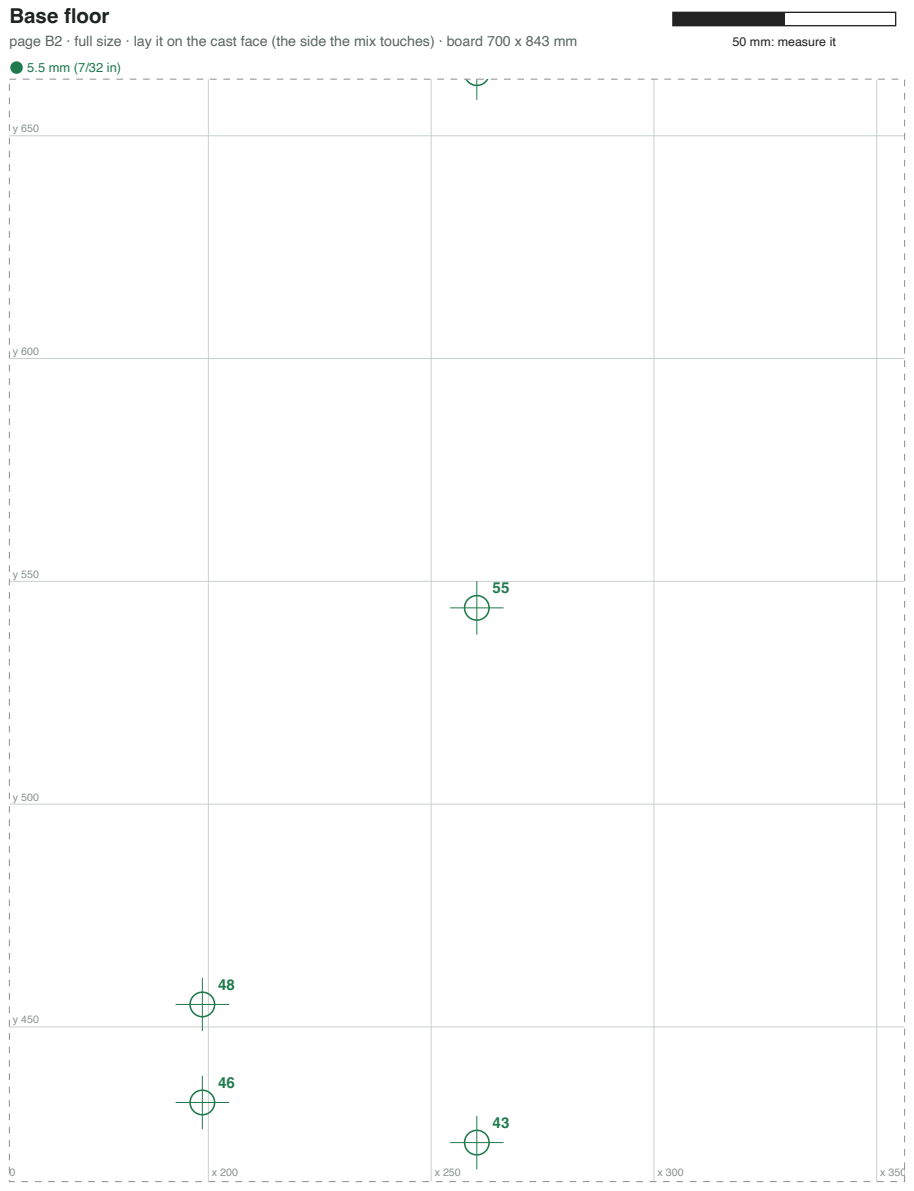
[picture p230: page 11]
page B2 · full size · lay it on the cast face (the side the mix touches) · board 700 x 843 mm; 50 mm: measure it

## Base floor

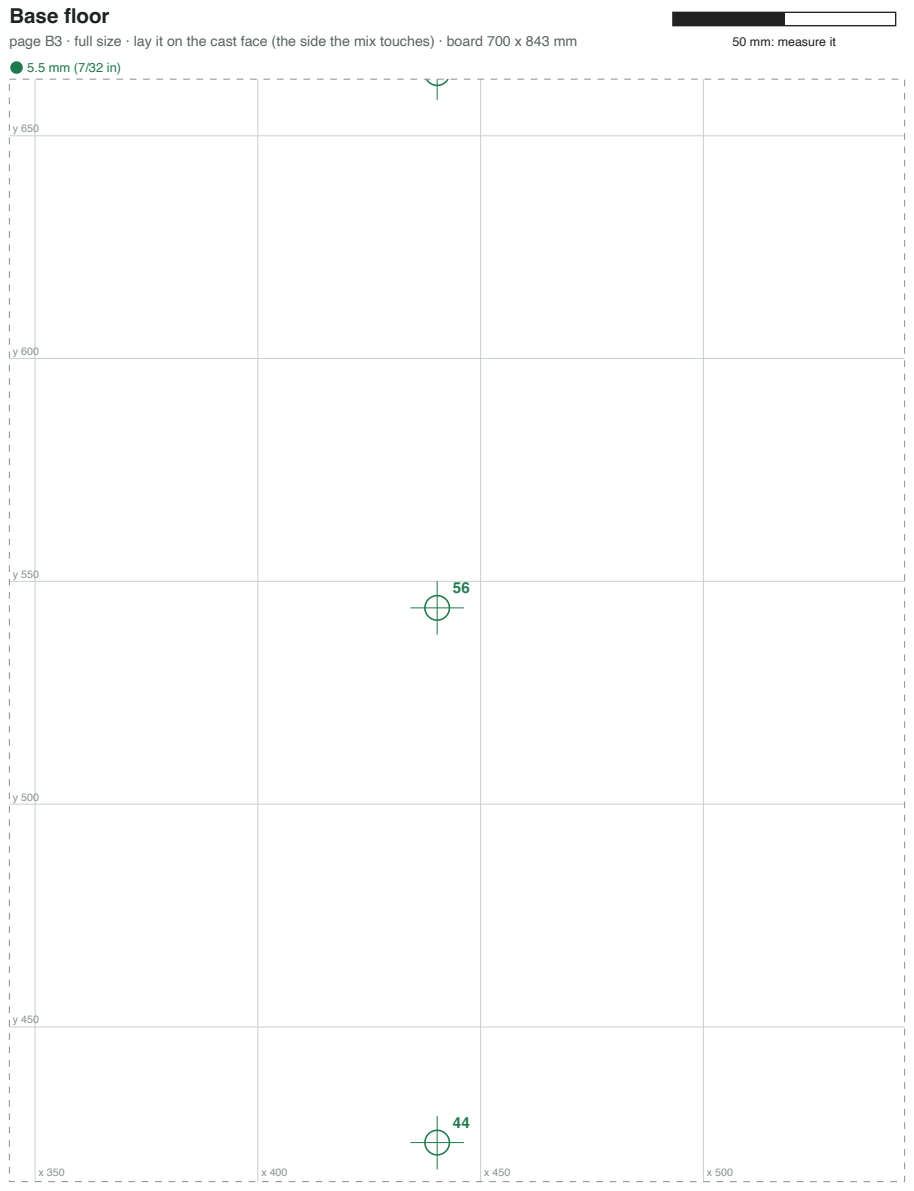
[picture p231: page 12]
page B3 · full size · lay it on the cast face (the side the mix touches) · board 700 x 843 mm; 50 mm: measure it

## Base floor

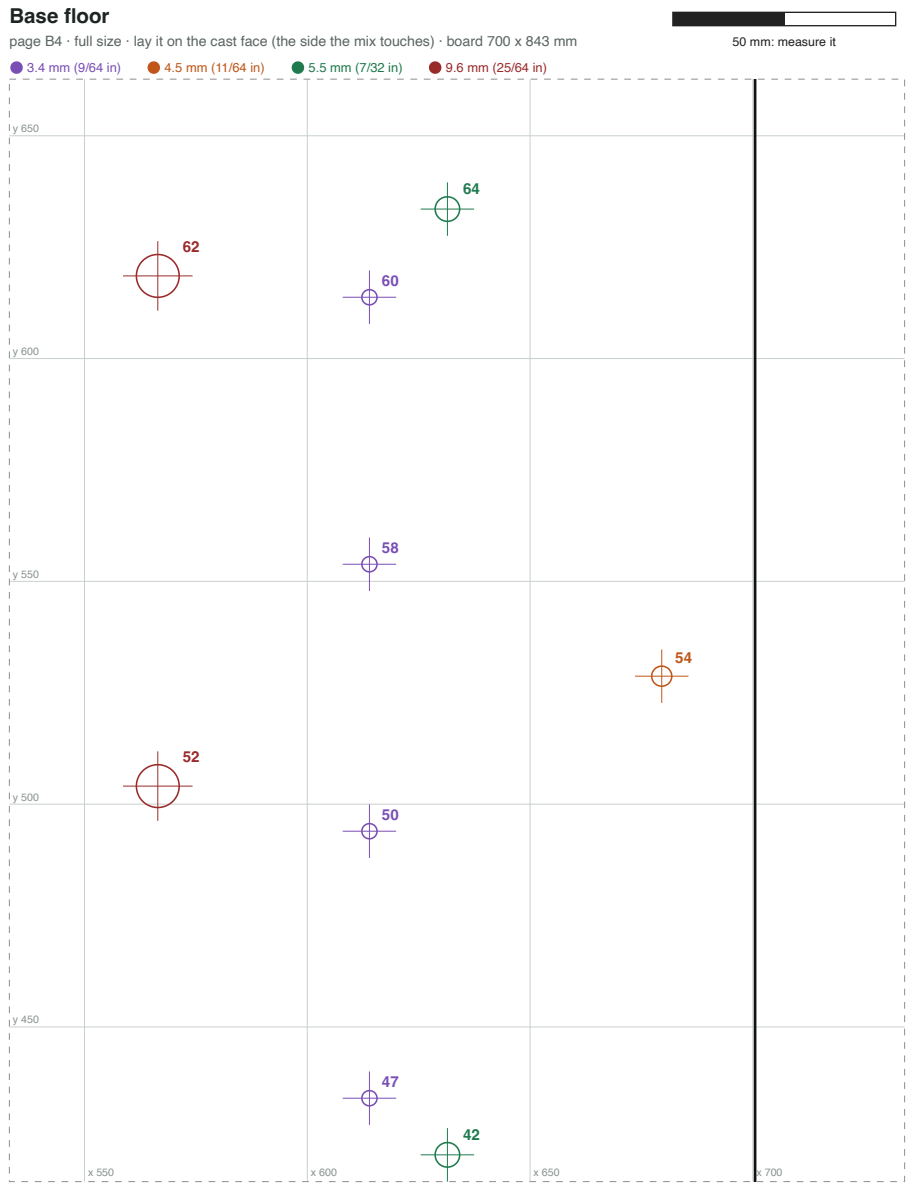
[picture p232: page 13]
page B4 · full size · lay it on the cast face (the side the mix touches) · board 700 x 843 mm; 50 mm: measure it

## Base floor

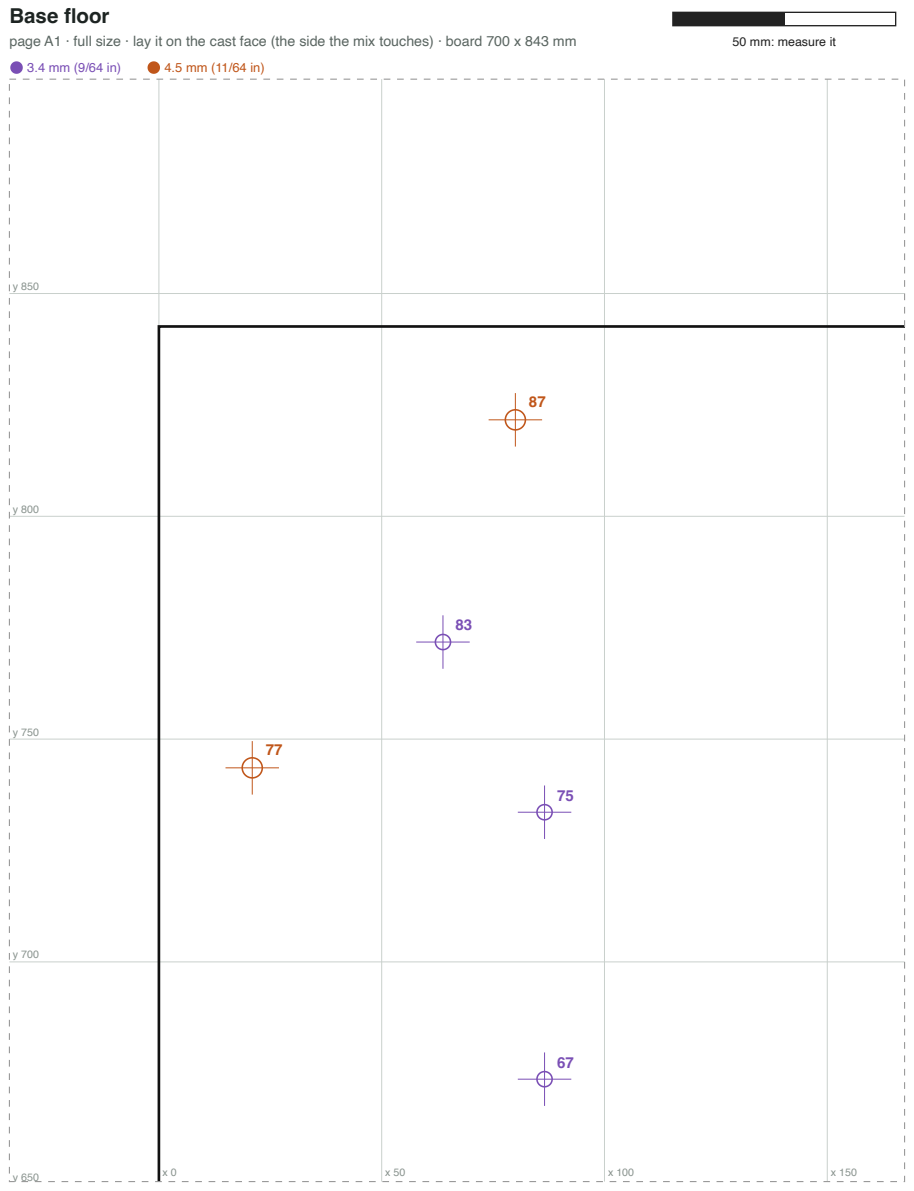
[picture p233: page 14]
page A1 · full size · lay it on the cast face (the side the mix touches) · board 700 x 843 mm; 50 mm: measure it

## Base floor

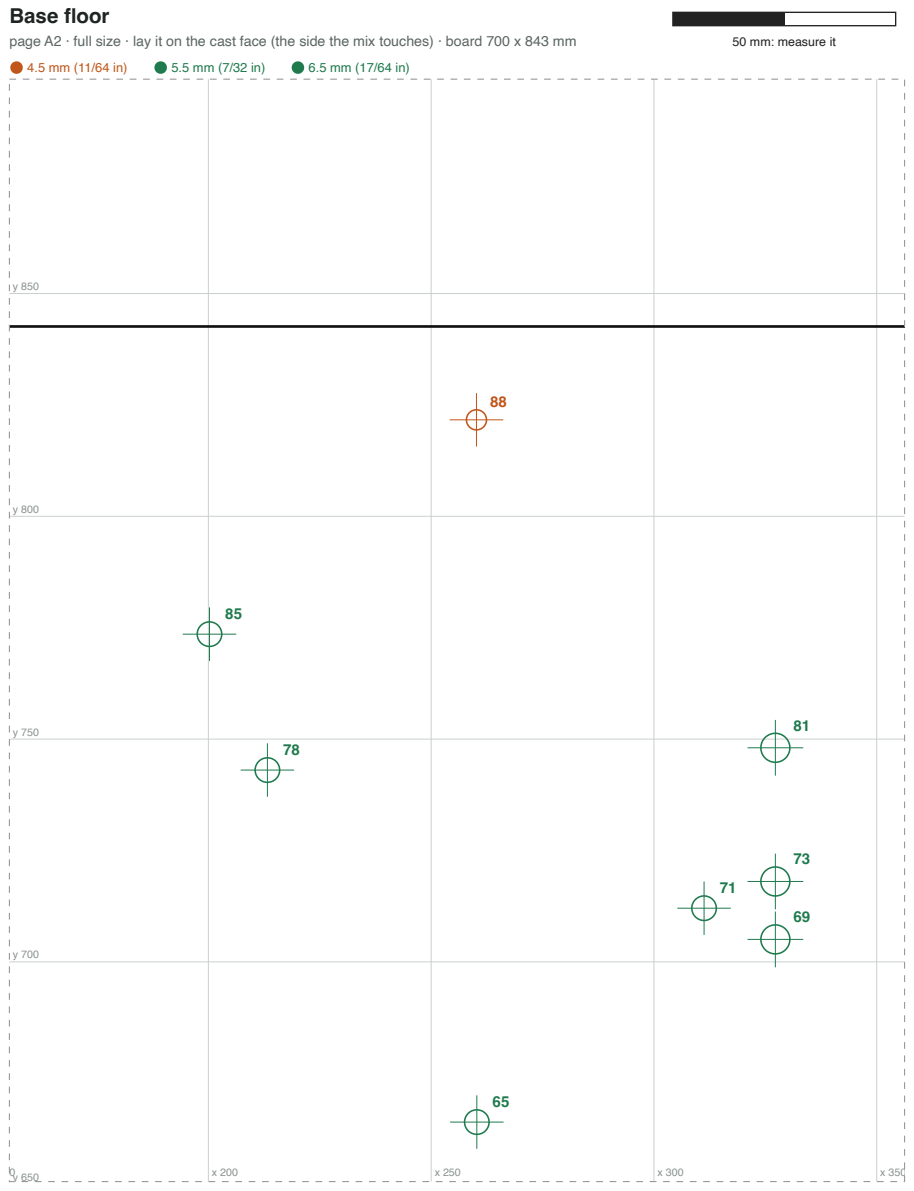
[picture p234: page 15]
page A2 · full size · lay it on the cast face (the side the mix touches) · board 700 x 843 mm; 50 mm: measure it

## Base floor

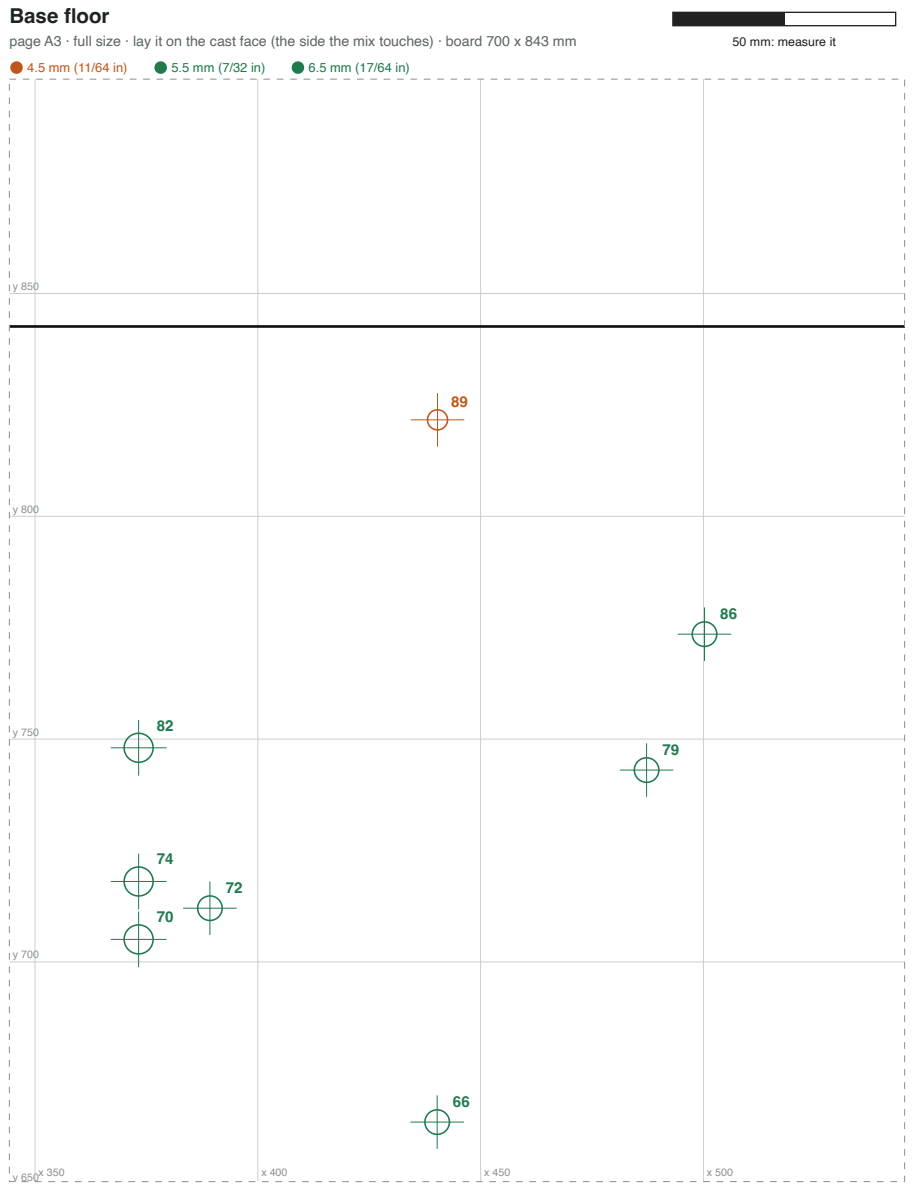
[picture p235: page 16]
page A3 · full size · lay it on the cast face (the side the mix touches) · board 700 x 843 mm; 50 mm: measure it

## Base floor

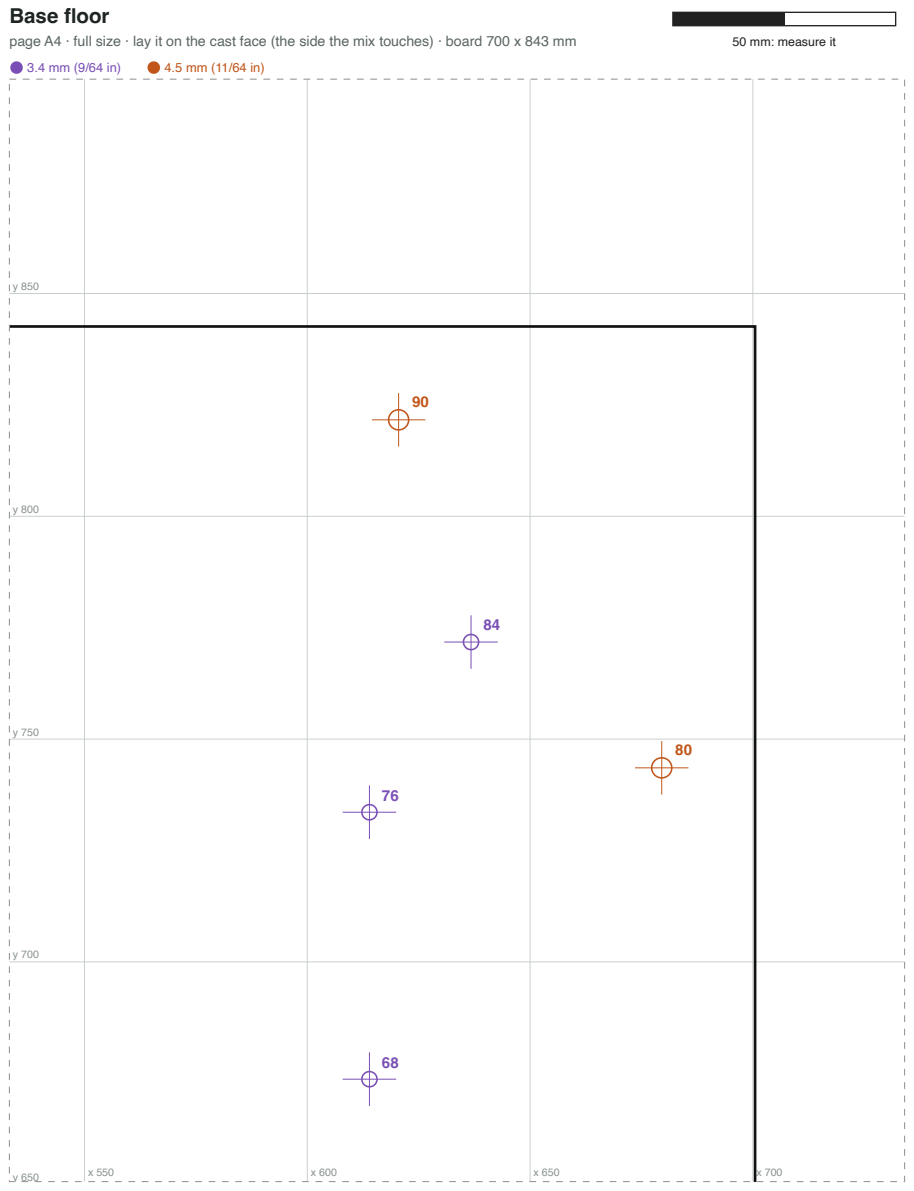
[picture p236: page 17]
page A4 · full size · lay it on the cast face (the side the mix touches) · board 700 x 843 mm; 50 mm: measure it

## Base front wall

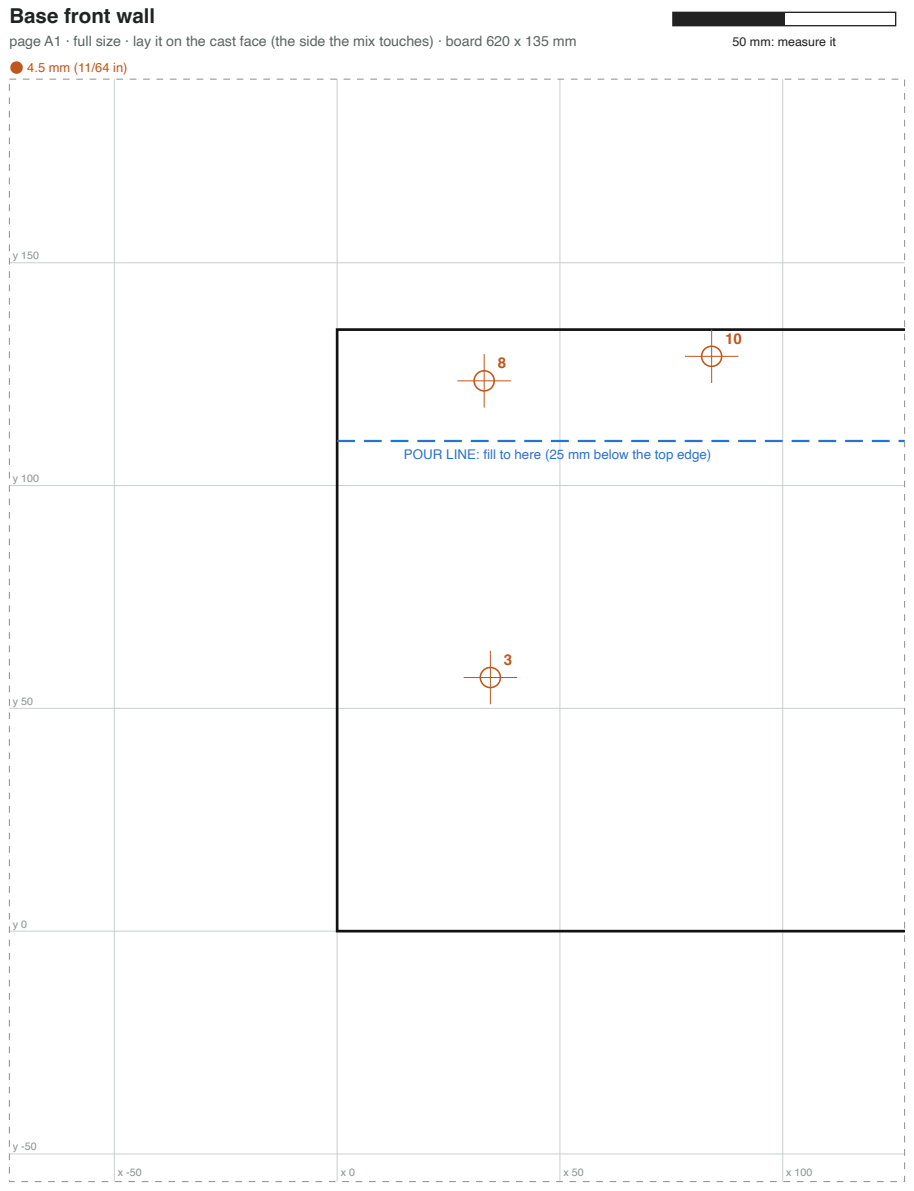
[picture p237: page 18]
page A1 · full size · lay it on the cast face (the side the mix touches) · board 620 x 135 mm; 50 mm: measure it

POUR LINE: fill to here (25 mm below the top edge)

## Base front wall

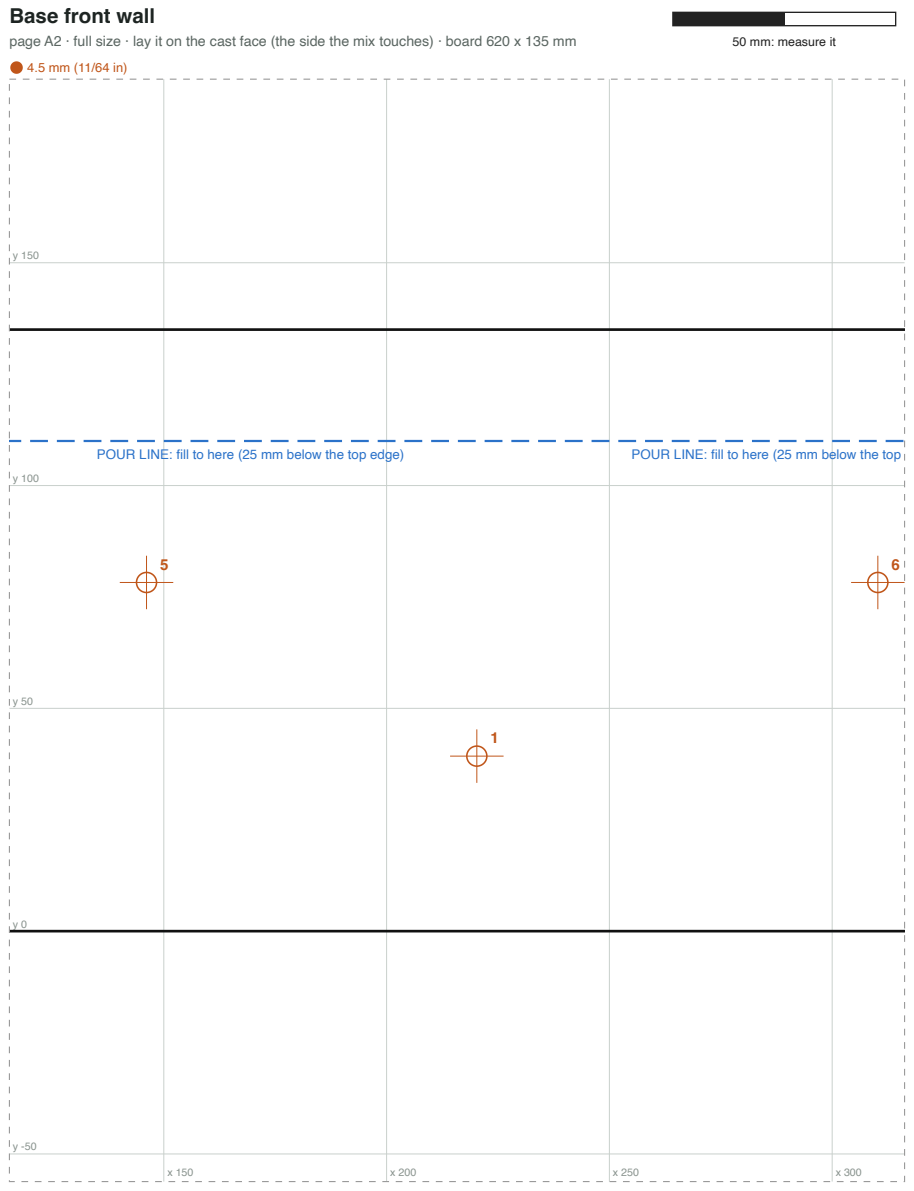
[picture p238: page 19]
page A2 · full size · lay it on the cast face (the side the mix touches) · board 620 x 135 mm; 50 mm: measure it; POUR LINE: fill to here (25 mm below the top edge); POUR LINE: fill to here (25 mm below the top

## Base front wall

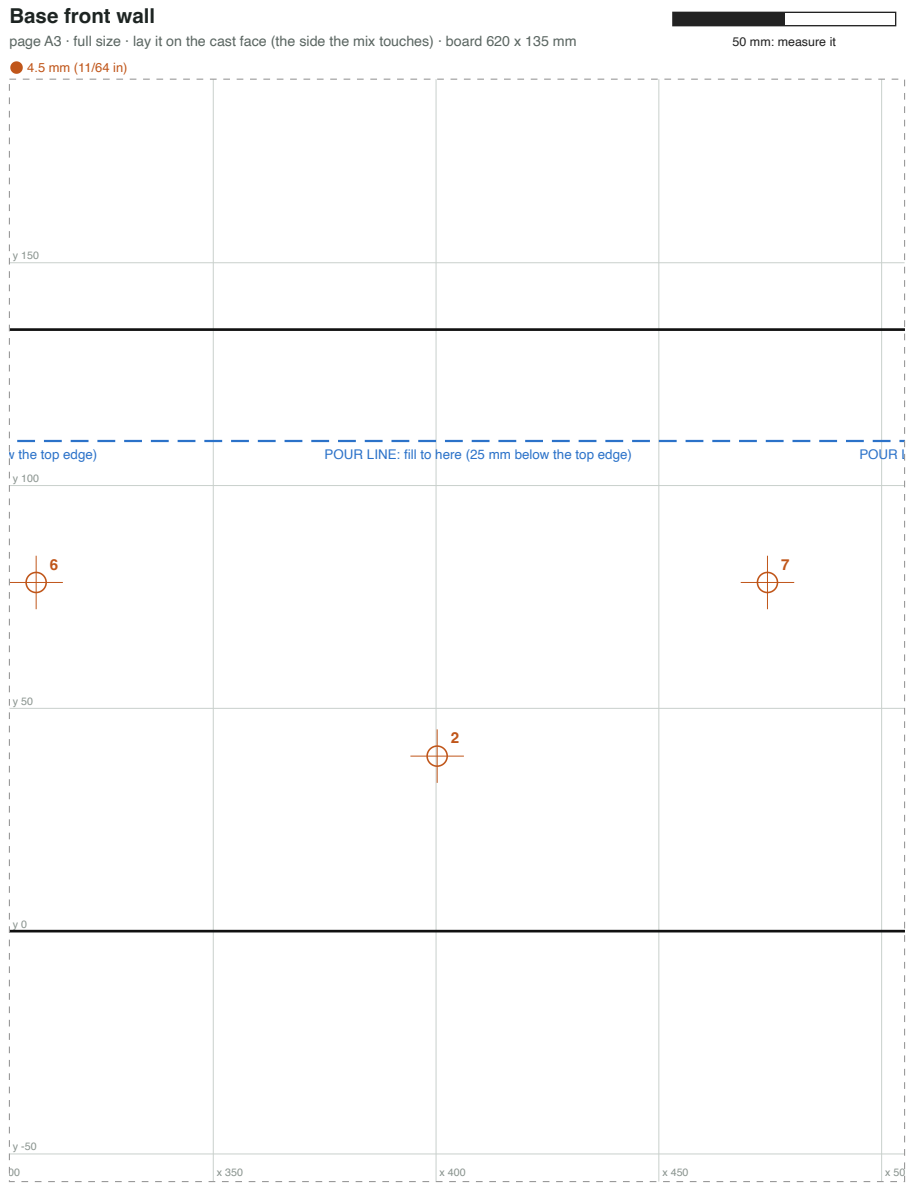
[picture p239: page 20]
page A3 · full size · lay it on the cast face (the side the mix touches) · board 620 x 135 mm; 50 mm: measure it; w the top edge); POUR LINE: fill to here (25 mm below the top edge); POUR L

## Base front wall

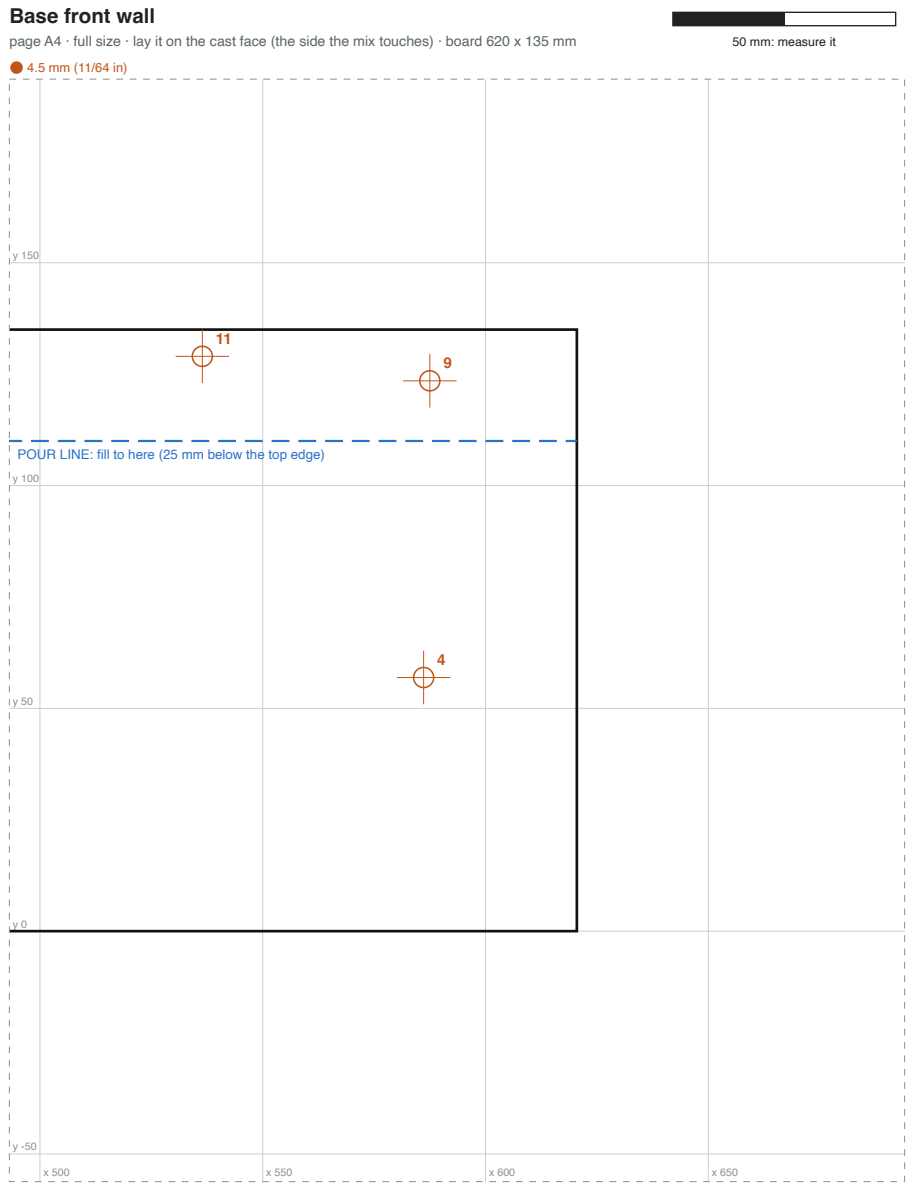
[picture p240: page 21]
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

POUR LINE: fill to here (25 mm below the top edge)

## Base rear wall

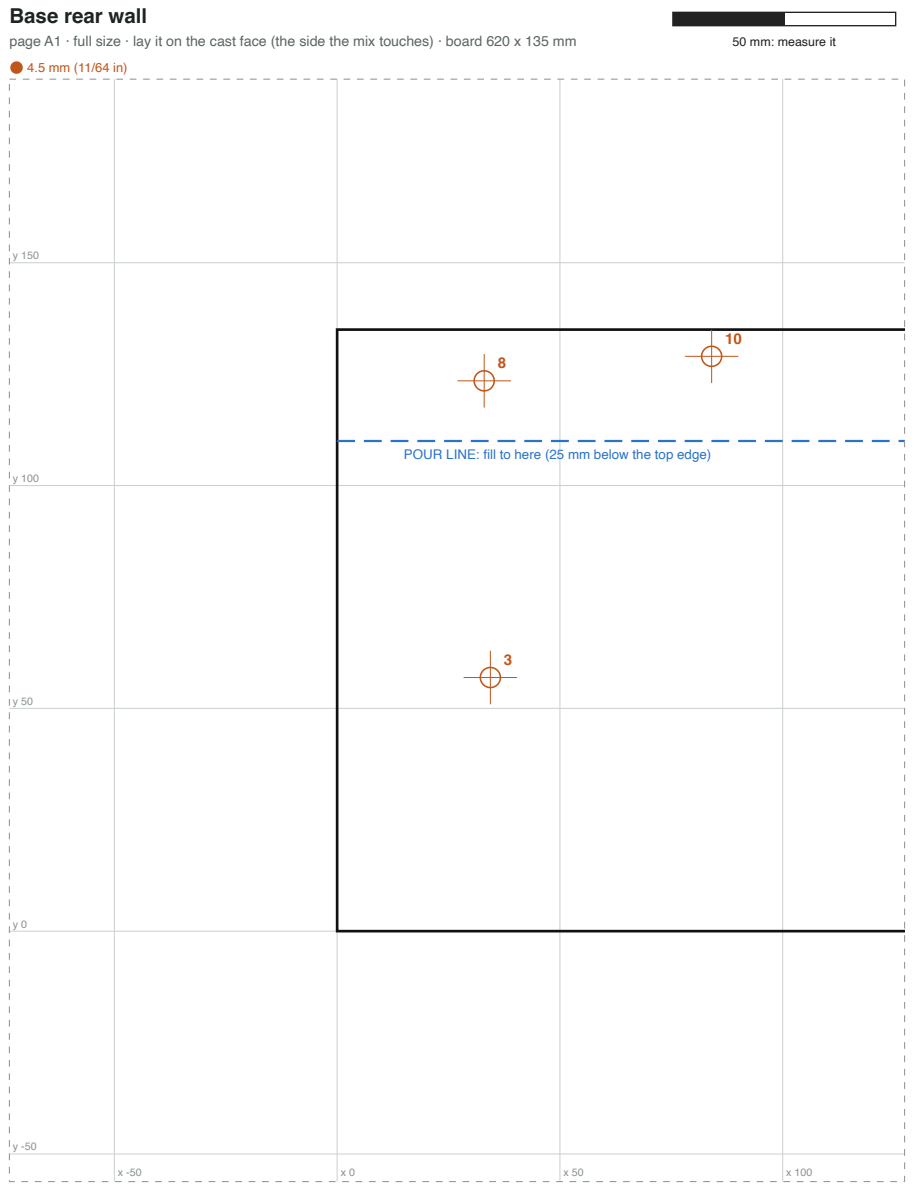
[picture p241: page 22]
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

POUR LINE: fill to here (25 mm below the top edge)

## Base rear wall

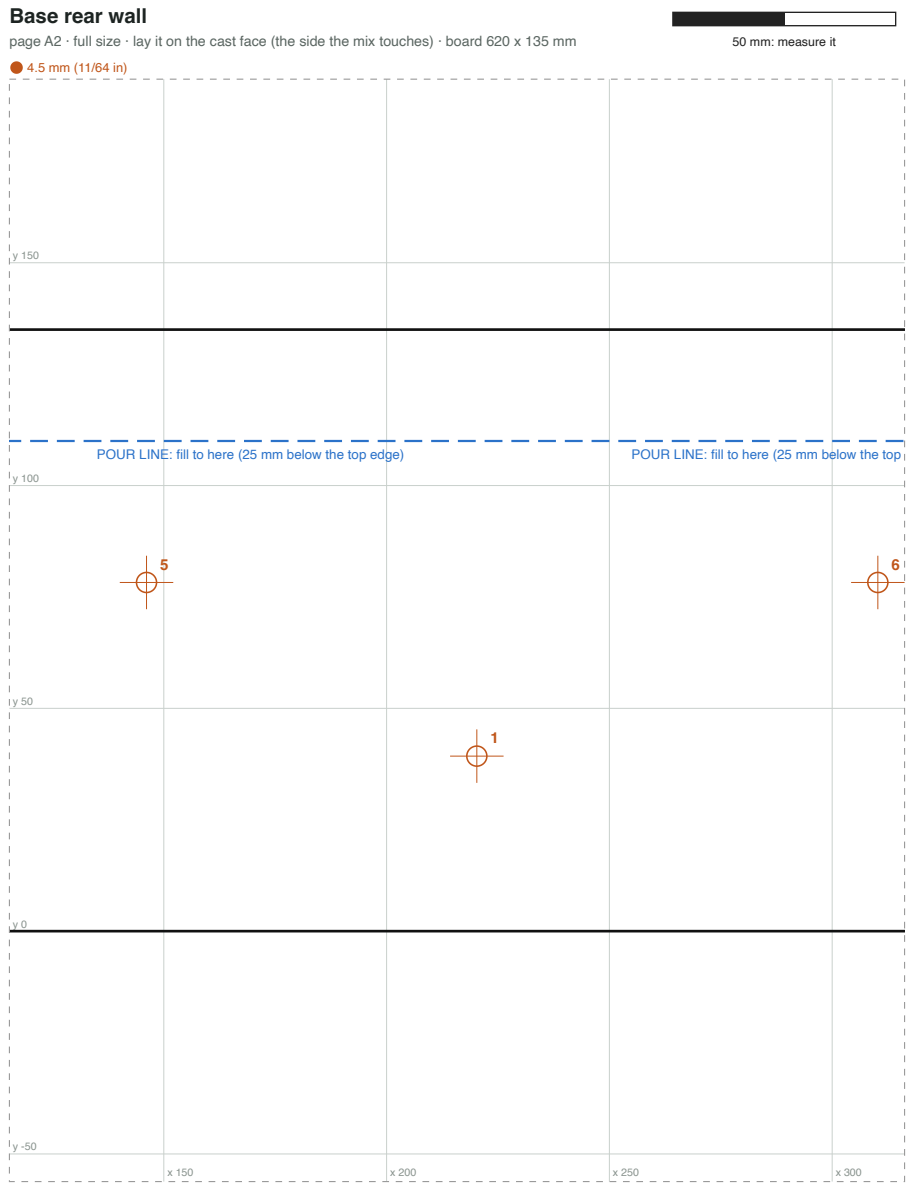
[picture p242: page 23]
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

## Base rear wall

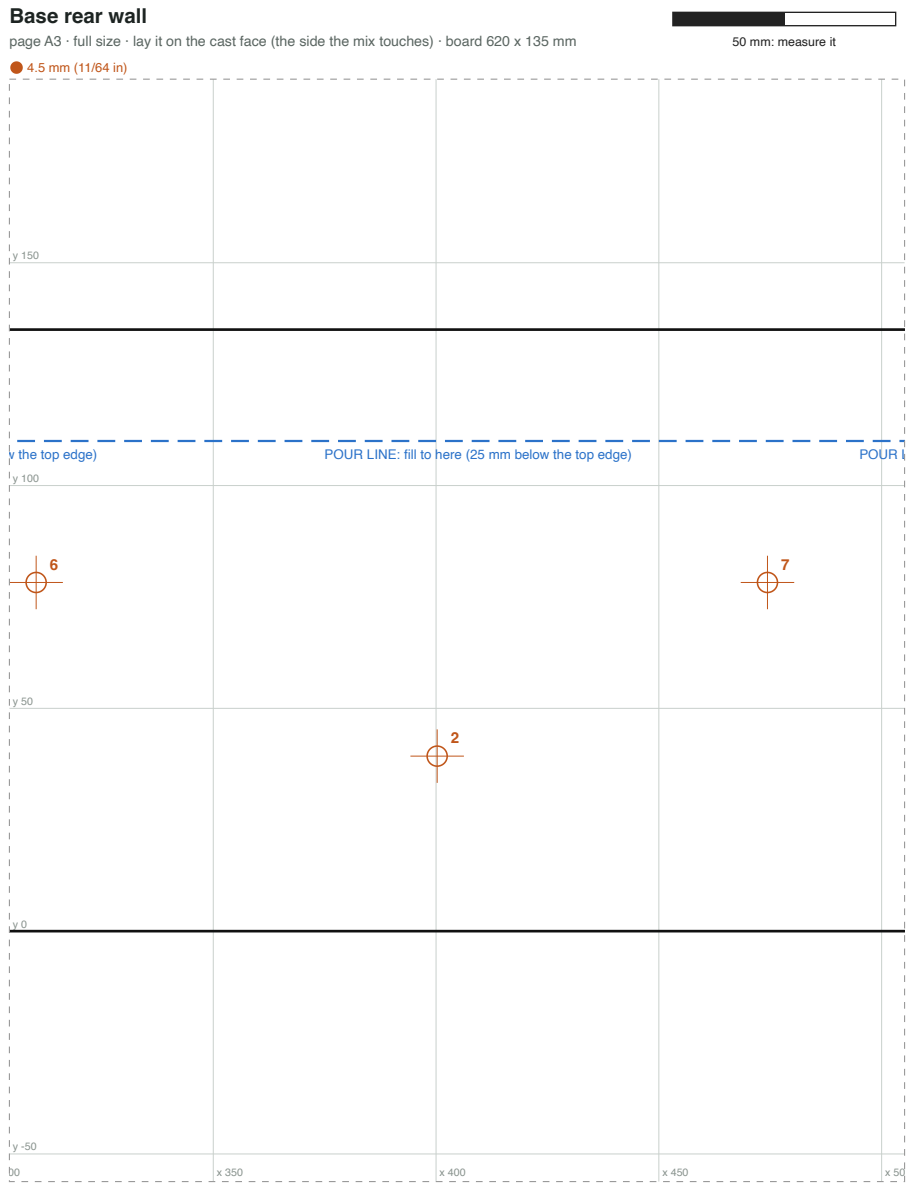
[picture p243: page 24]
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

## Base rear wall

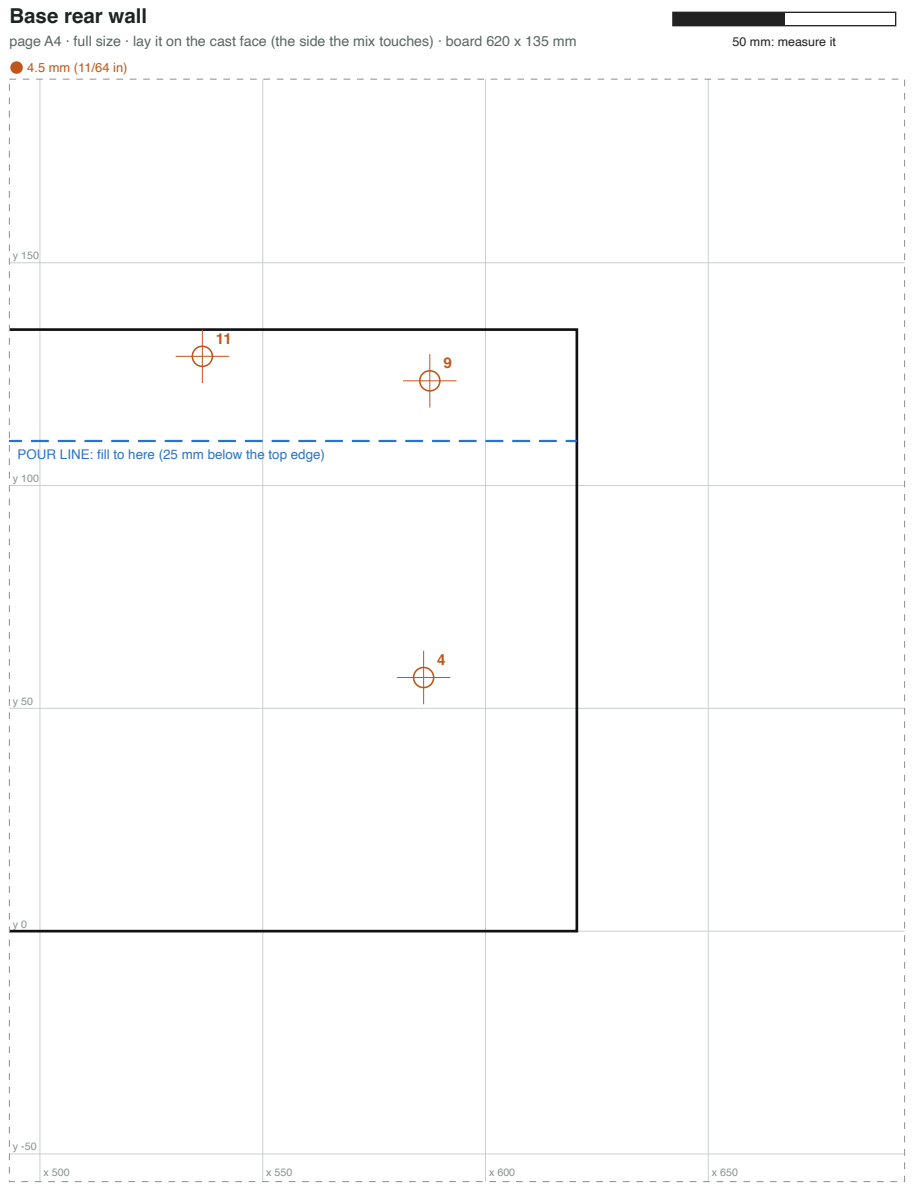
[picture p244: page 25]
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

POUR LINE: fill to here (25 mm below the top edge)

## Base side wall, left

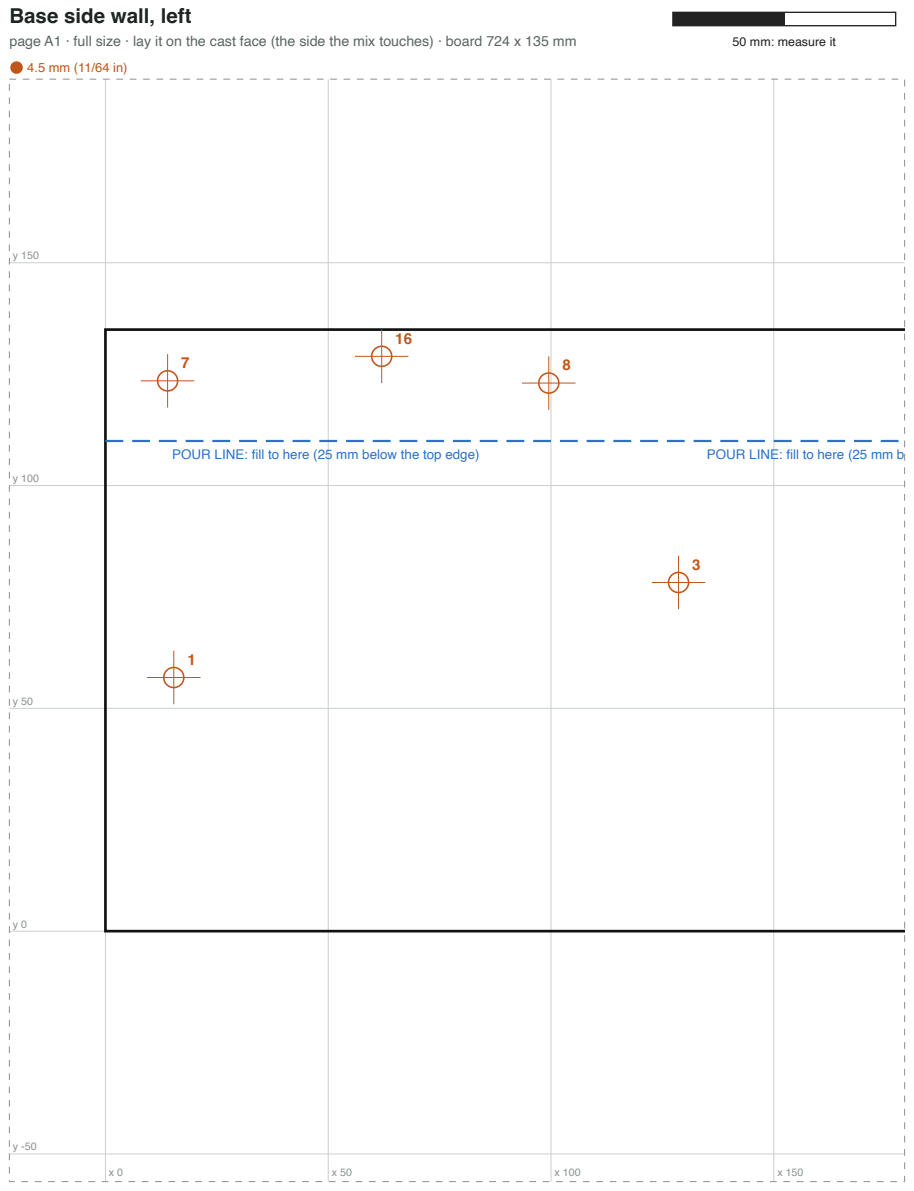
[picture p245: page 26]
page A1 · full size · lay it on the cast face (the side the mix touches) · board 724 x 135 mm; 50 mm: measure it; POUR LINE: fill to here (25 mm below the top edge); POUR LINE: fill to here (25 mm b

## Base side wall, left

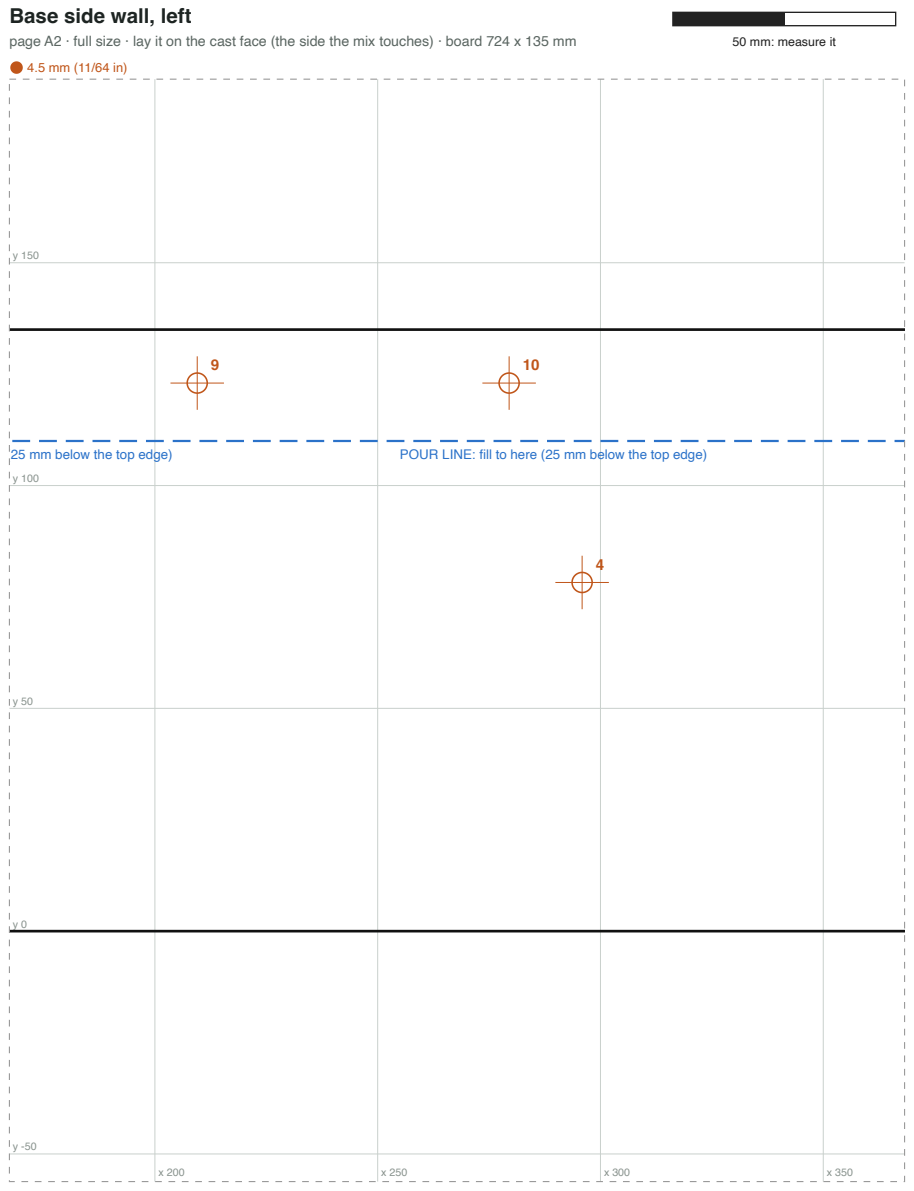
[picture p246: page 27]
page A2 · full size · lay it on the cast face (the side the mix touches) · board 724 x 135 mm; 50 mm: measure it; (25 mm below the top edge); POUR LINE: fill to here (25 mm below the top edge)

## Base side wall, left

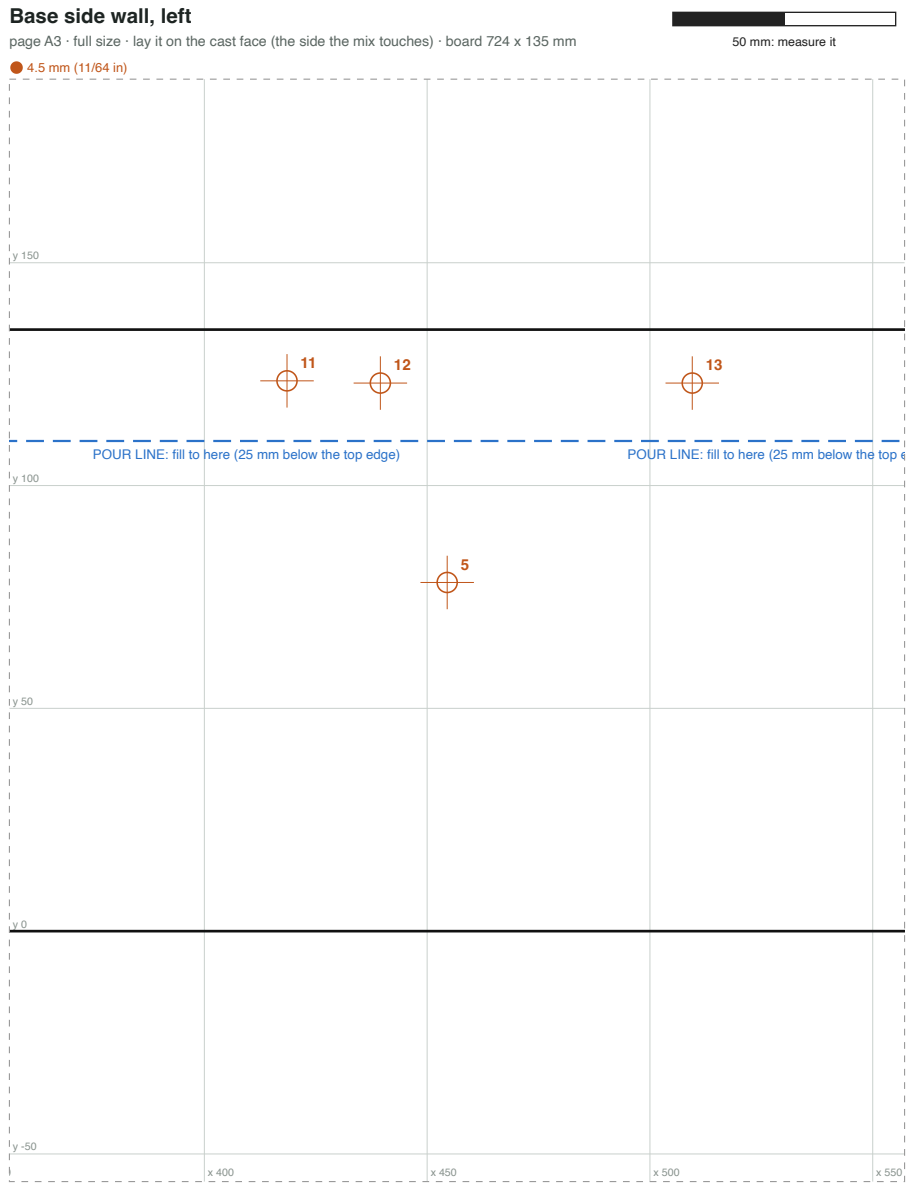
[picture p247: page 28]
page A3 · full size · lay it on the cast face (the side the mix touches) · board 724 x 135 mm; 50 mm: measure it; POUR LINE: fill to here (25 mm below the top edge); POUR LINE: fill to here (25 mm below the top e

## Base side wall, left

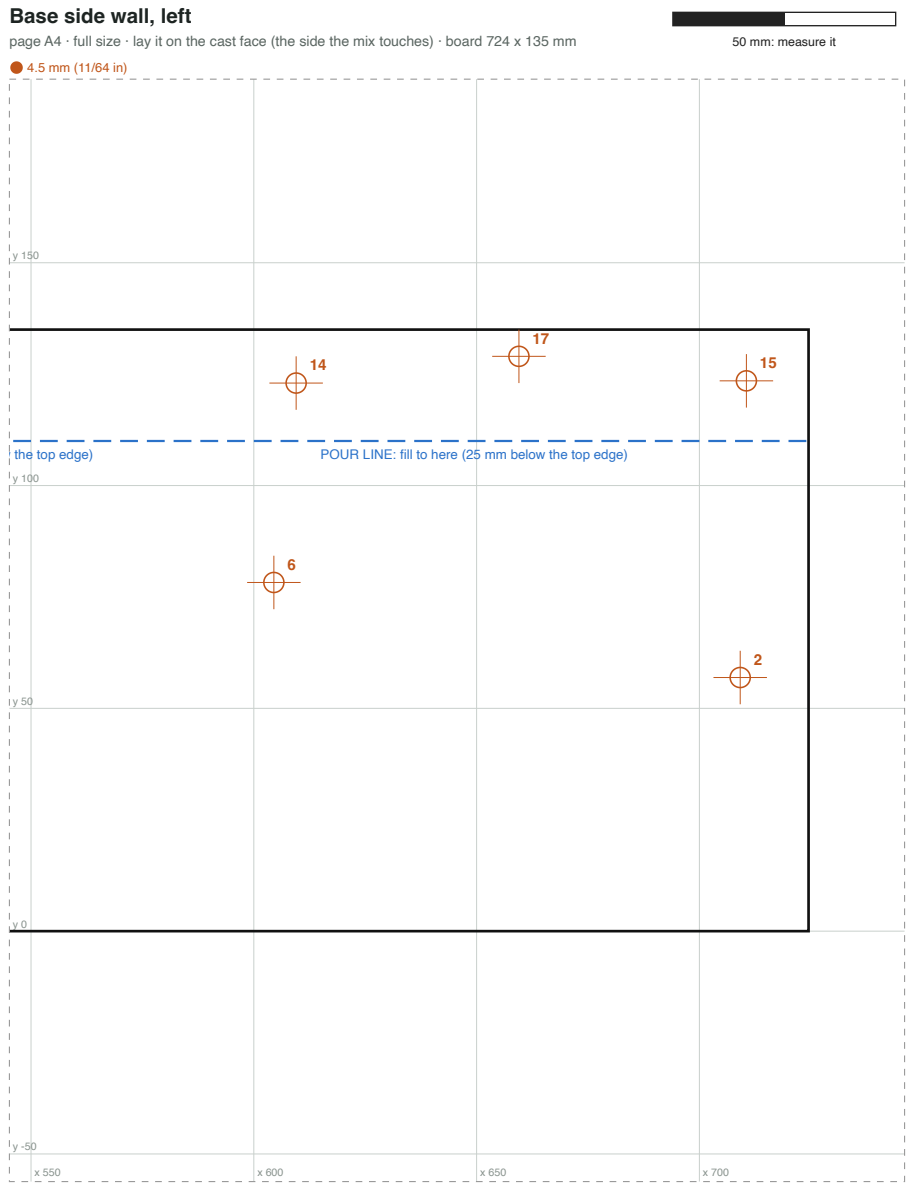
[picture p248: page 29]
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

## Base side wall, right

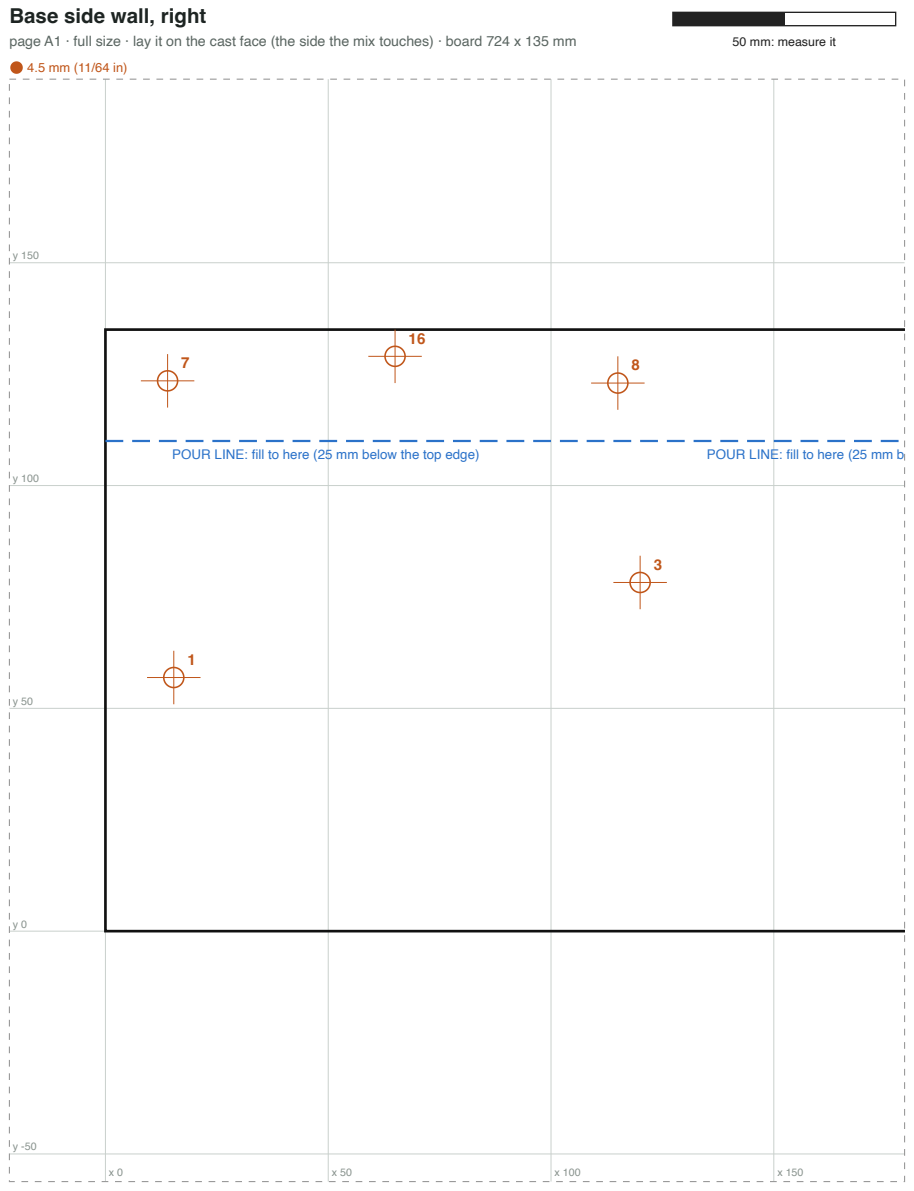
[picture p249: page 30]
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

## Base side wall, right

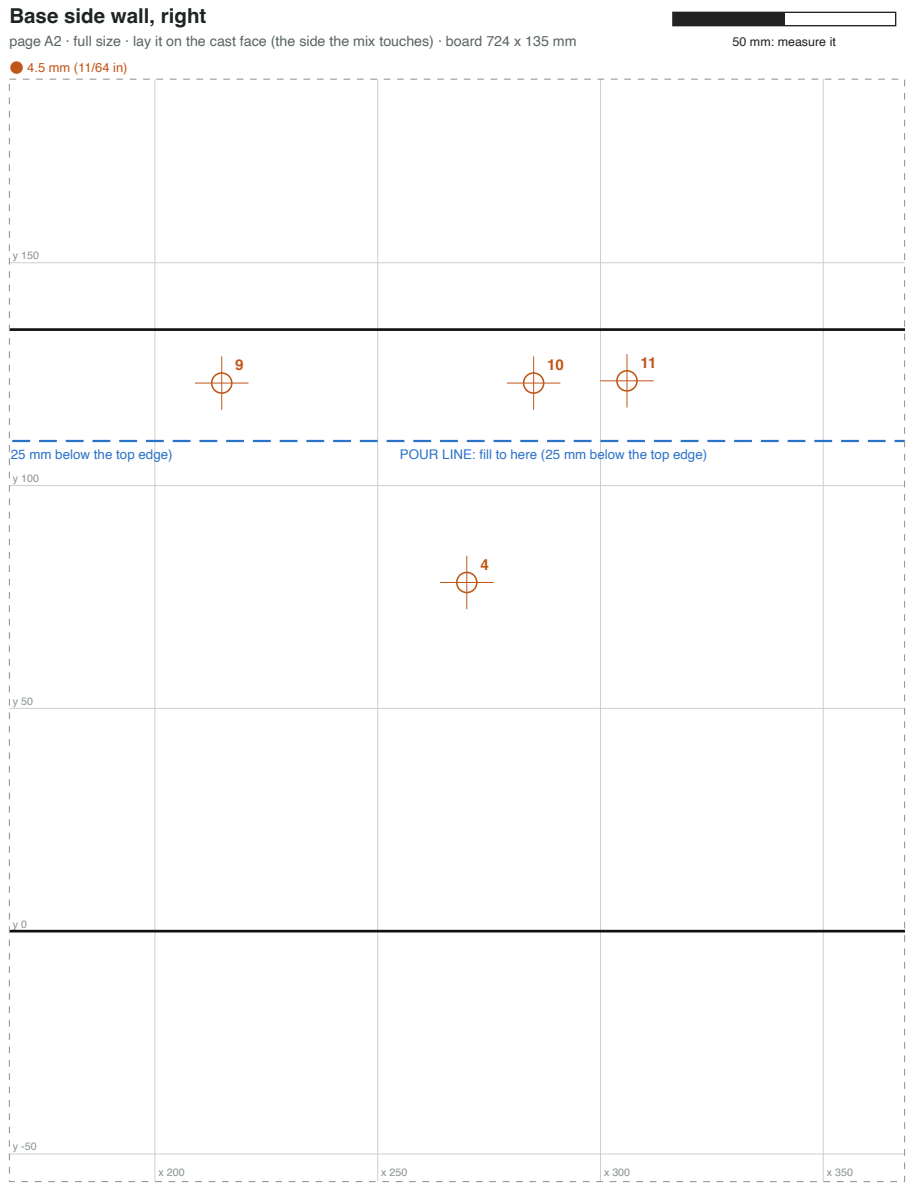
[picture p250: page 31]
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

## Base side wall, right

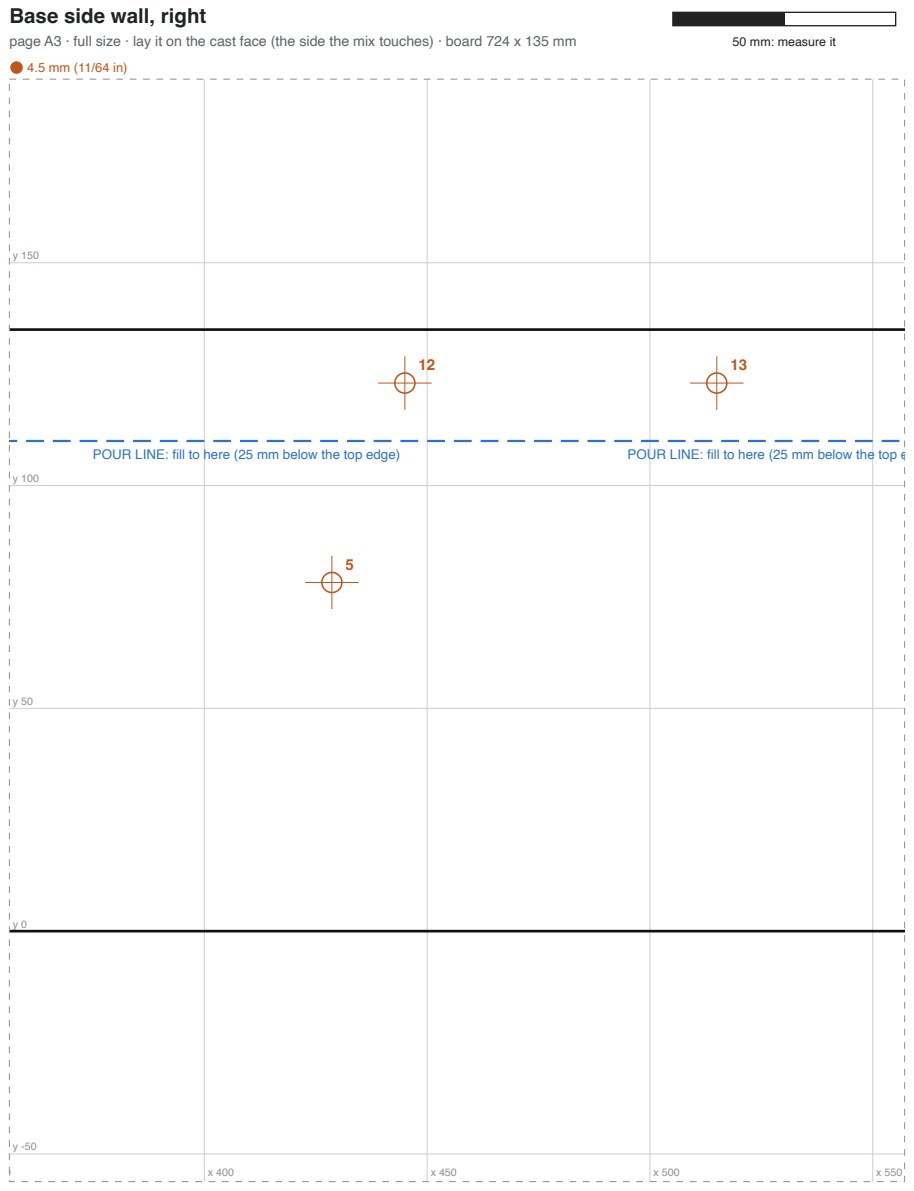
[picture p251: page 32]
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

## Base side wall, right

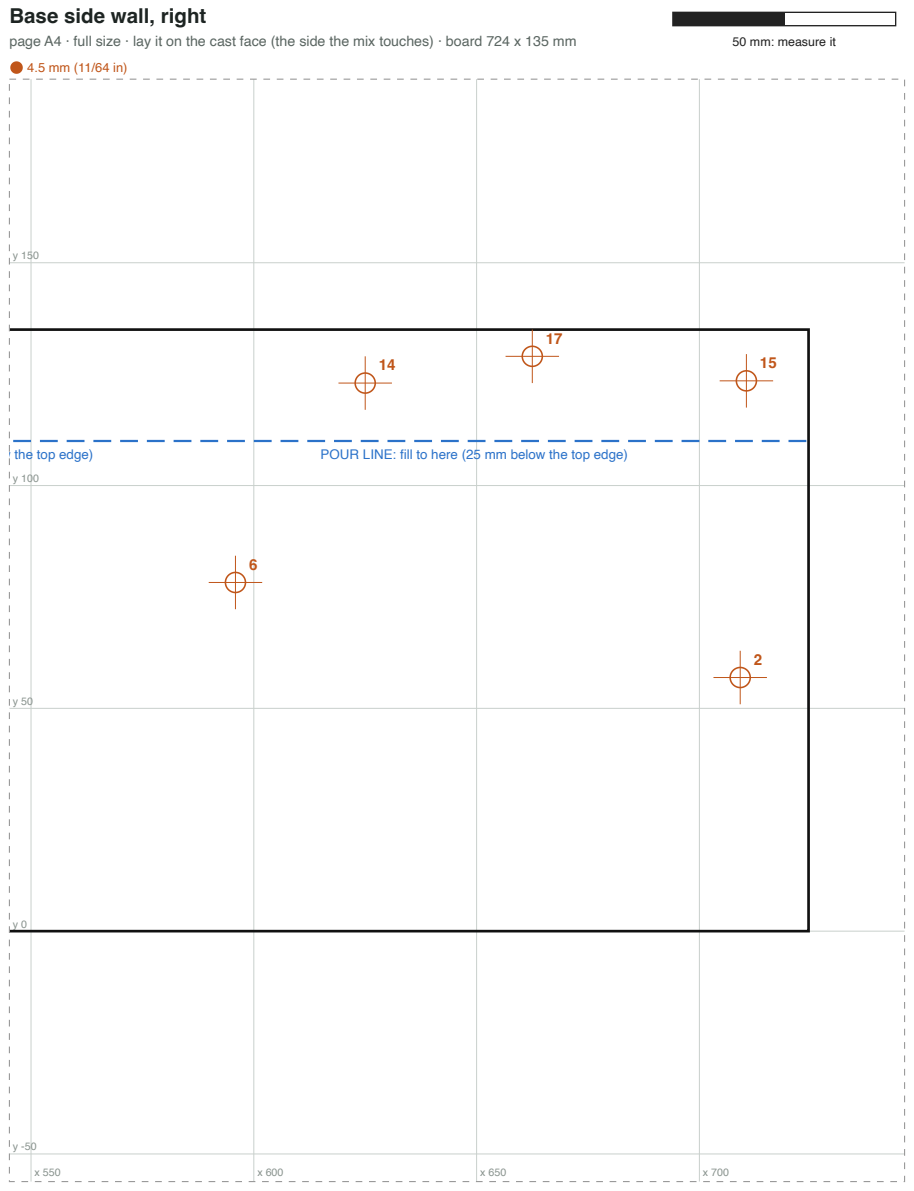
[picture p252: page 33]
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

## Base partition

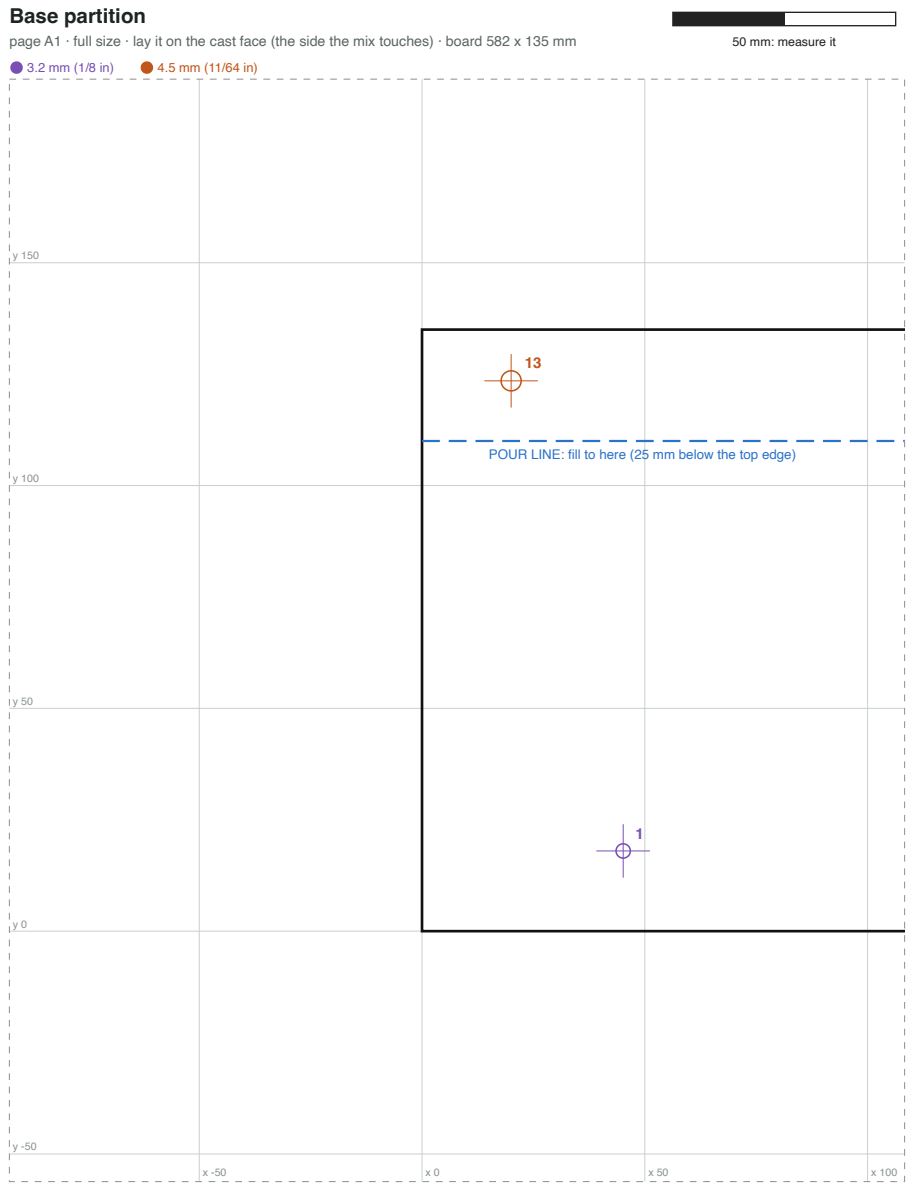
[picture p253: page 34]
page A1 · full size · lay it on the cast face (the side the mix touches) · board 582 x 135 mm; 50 mm: measure it

POUR LINE: fill to here (25 mm below the top edge)

## Base partition

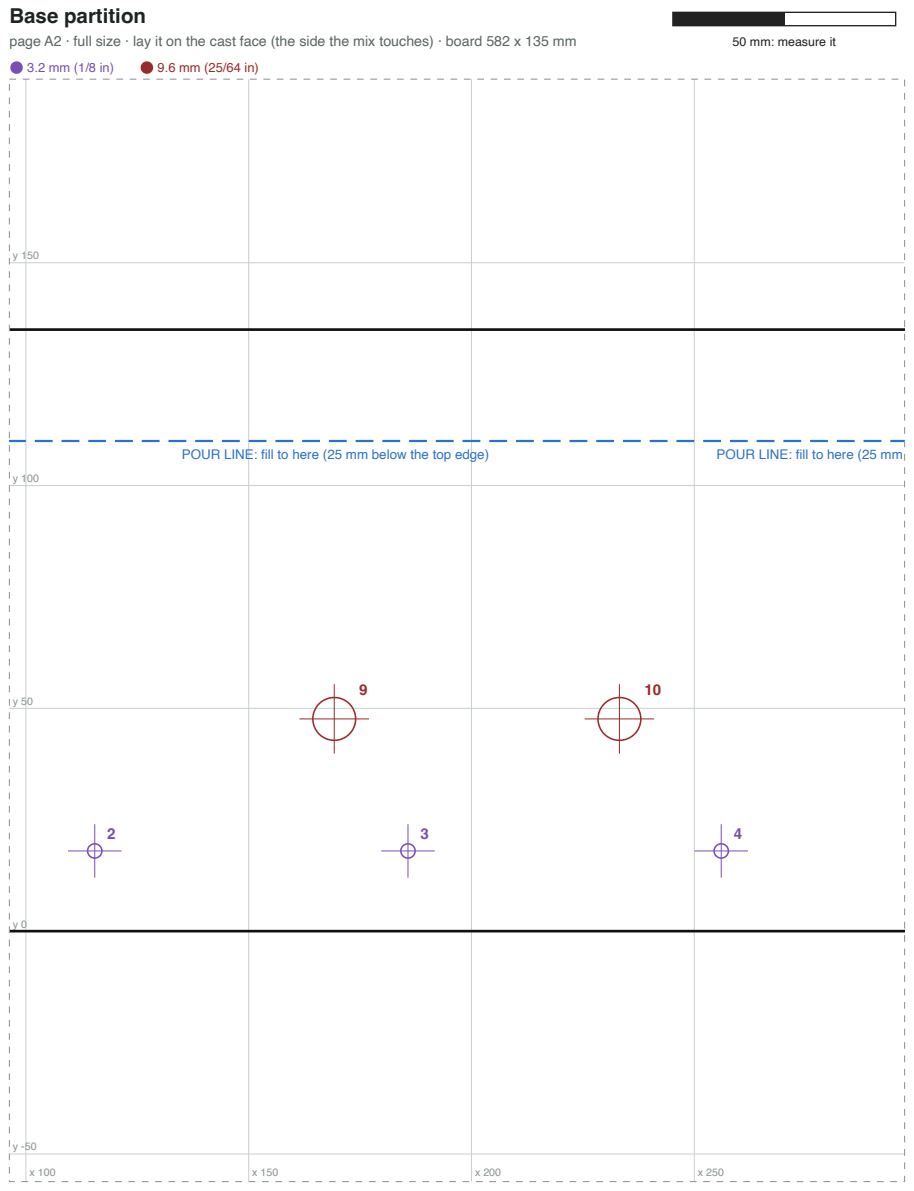
[picture p254: page 35]
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

## Base partition

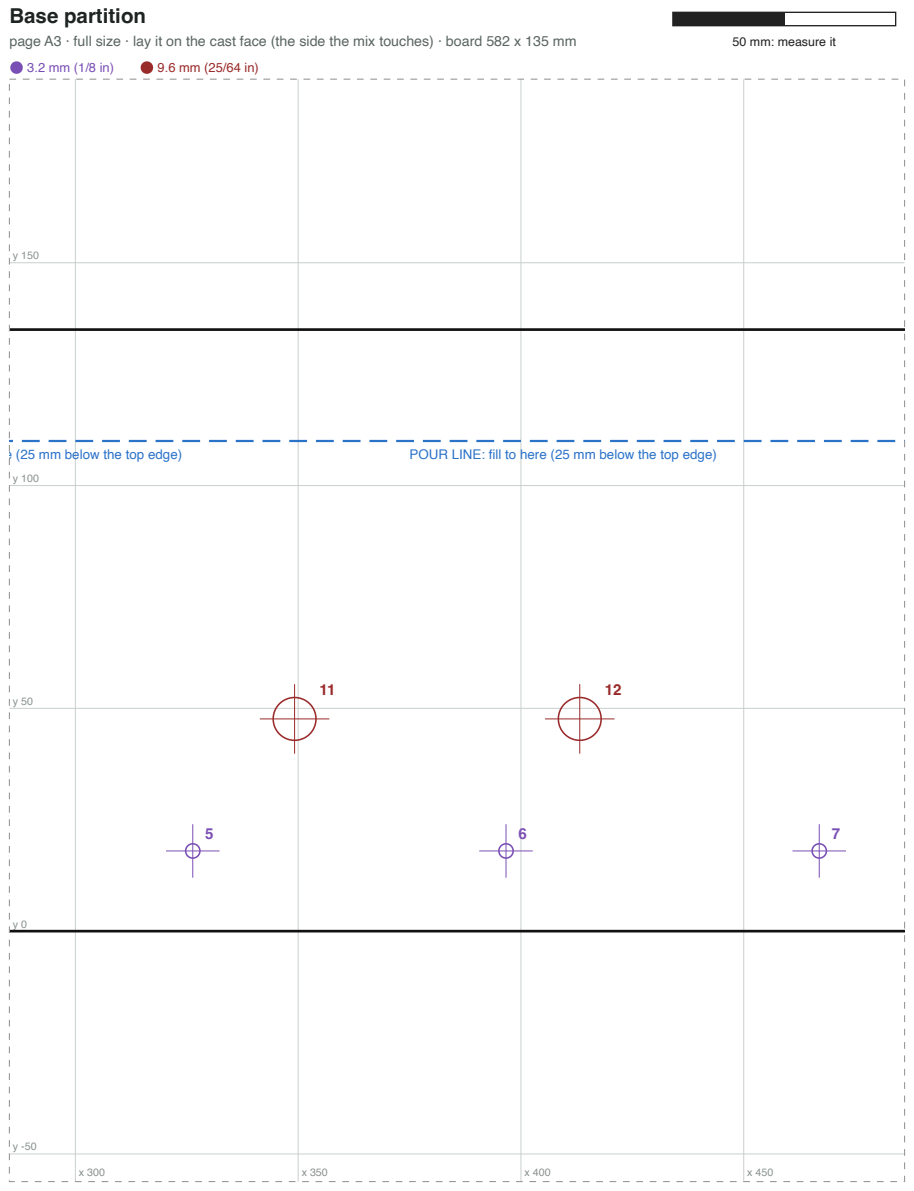
[picture p255: page 36]
page A3 · full size · lay it on the cast face (the side the mix touches) · board 582 x 135 mm; 50 mm: measure it; e (25 mm below the top edge); POUR LINE: fill to here (25 mm below the top edge)

## Base partition

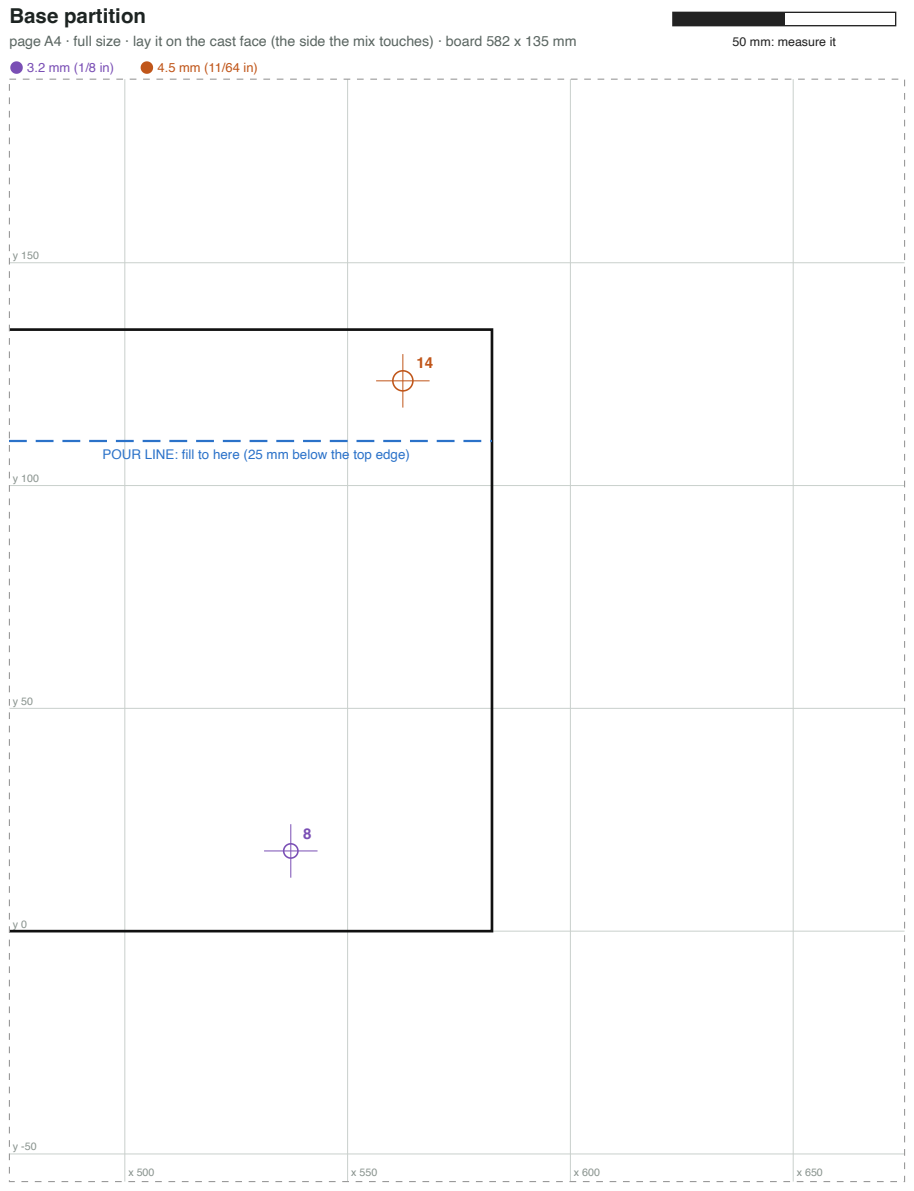
[picture p256: page 37]
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

POUR LINE: fill to here (25 mm below the top edge)

## Base cleat, front

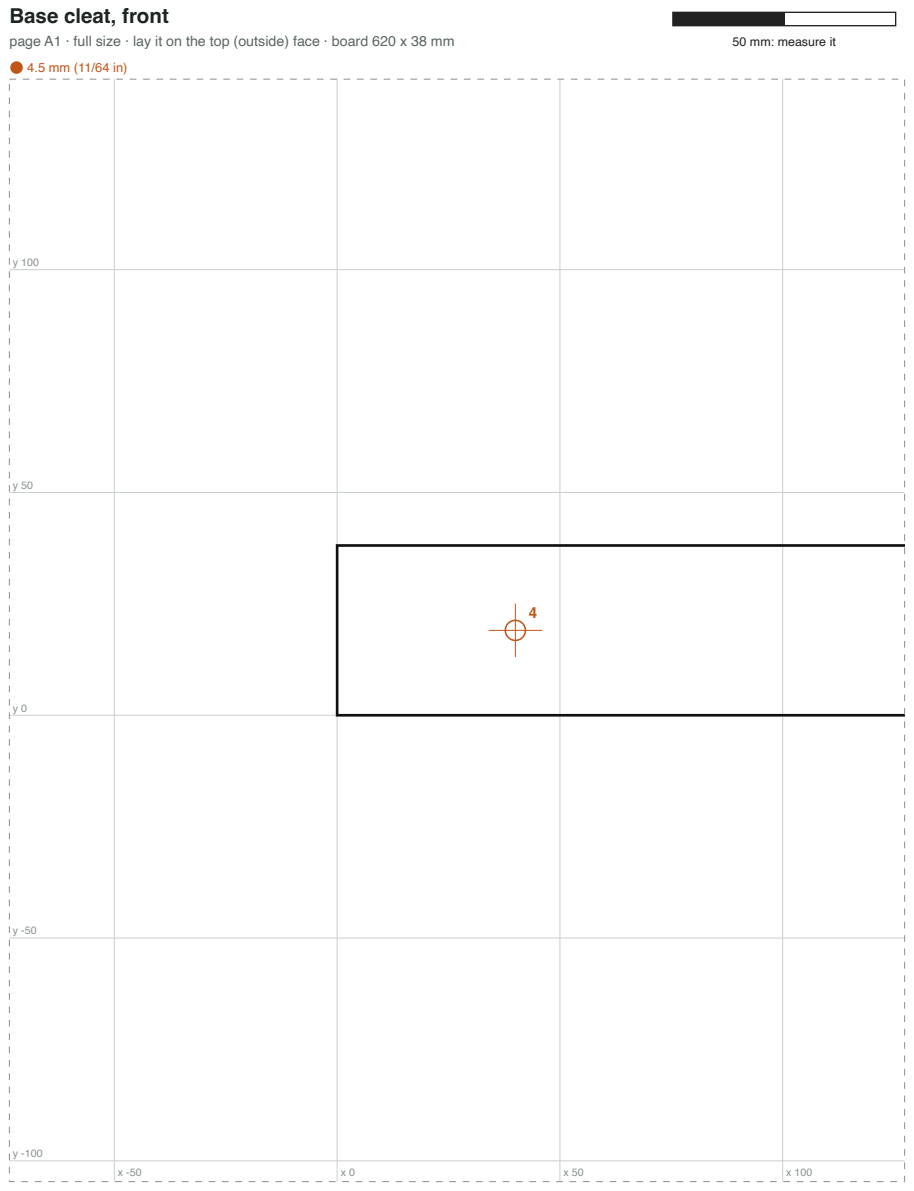
[picture p257: page 38]
page A1 · full size · lay it on the top (outside) face · board 620 x 38 mm; 50 mm: measure it

## Base cleat, front

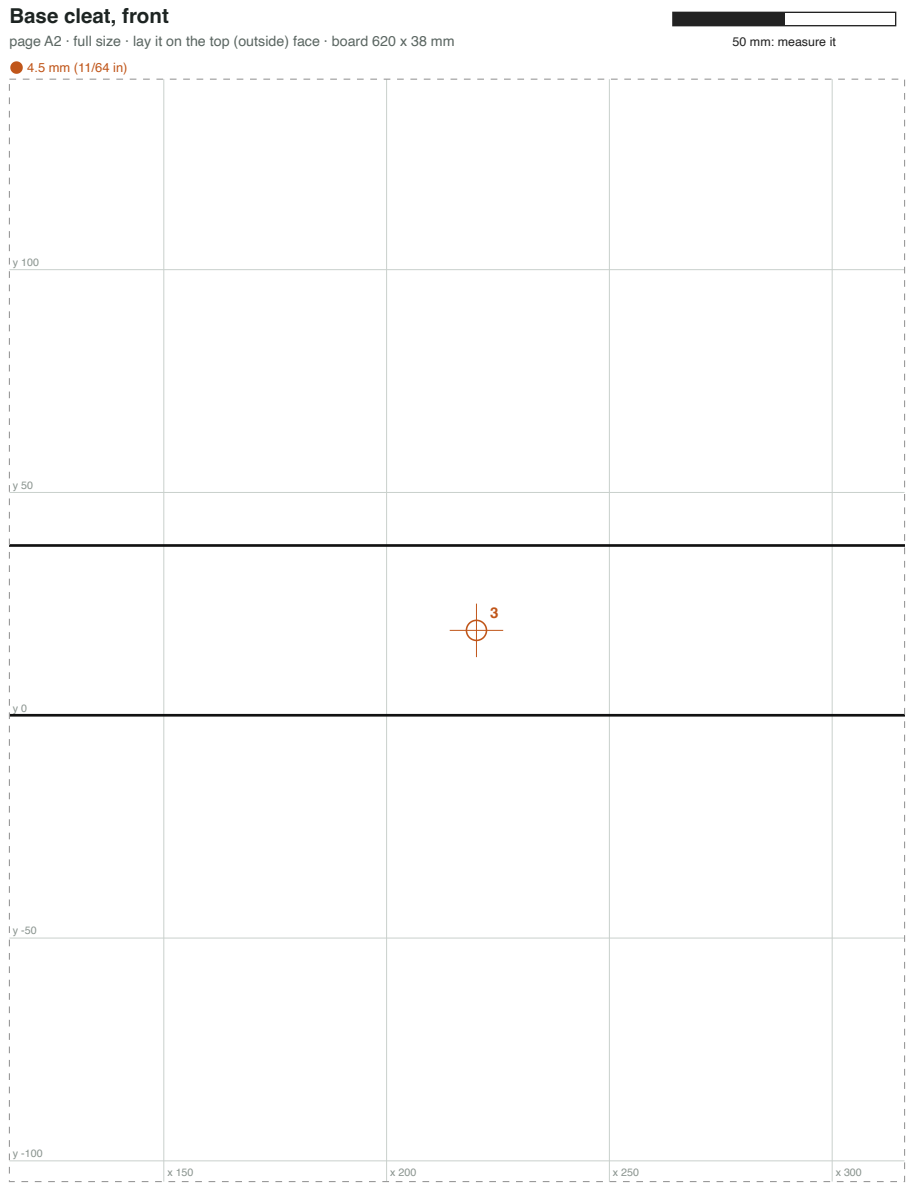
[picture p258: page 39]
page A2 · full size · lay it on the top (outside) face · board 620 x 38 mm; 50 mm: measure it

## Base cleat, front

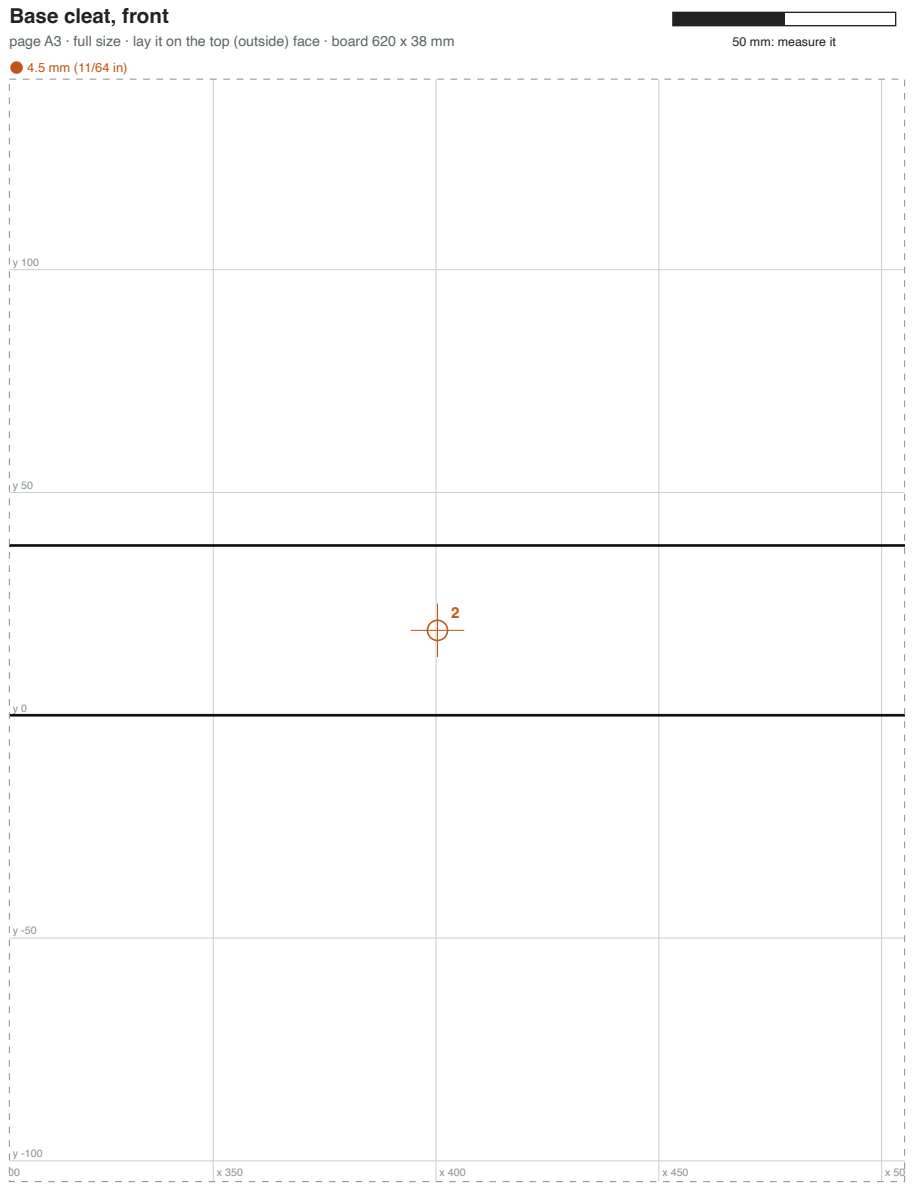
[picture p259: page 40]
page A3 · full size · lay it on the top (outside) face · board 620 x 38 mm; 50 mm: measure it

## Base cleat, front

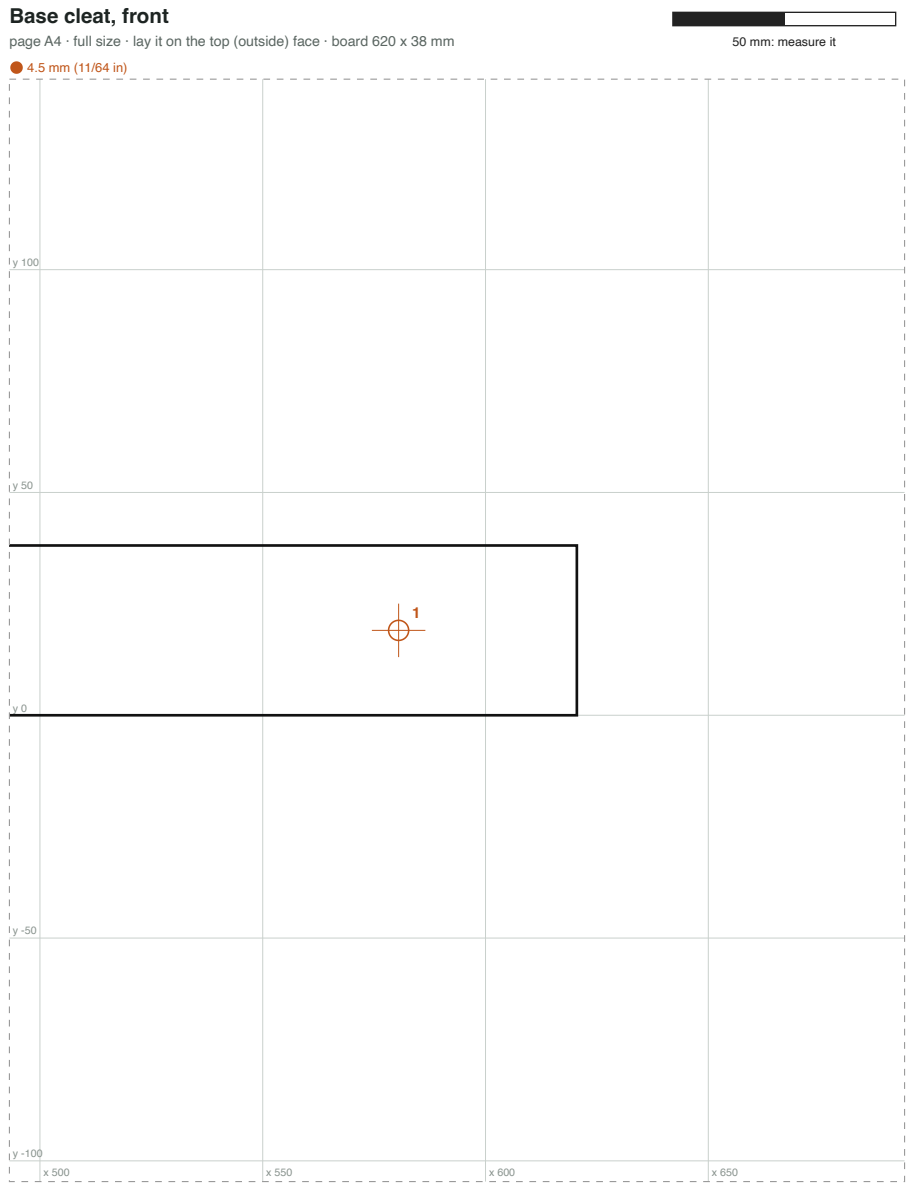
[picture p260: page 41]
page A4 · full size · lay it on the top (outside) face · board 620 x 38 mm; 50 mm: measure it

## Base cleat, rear

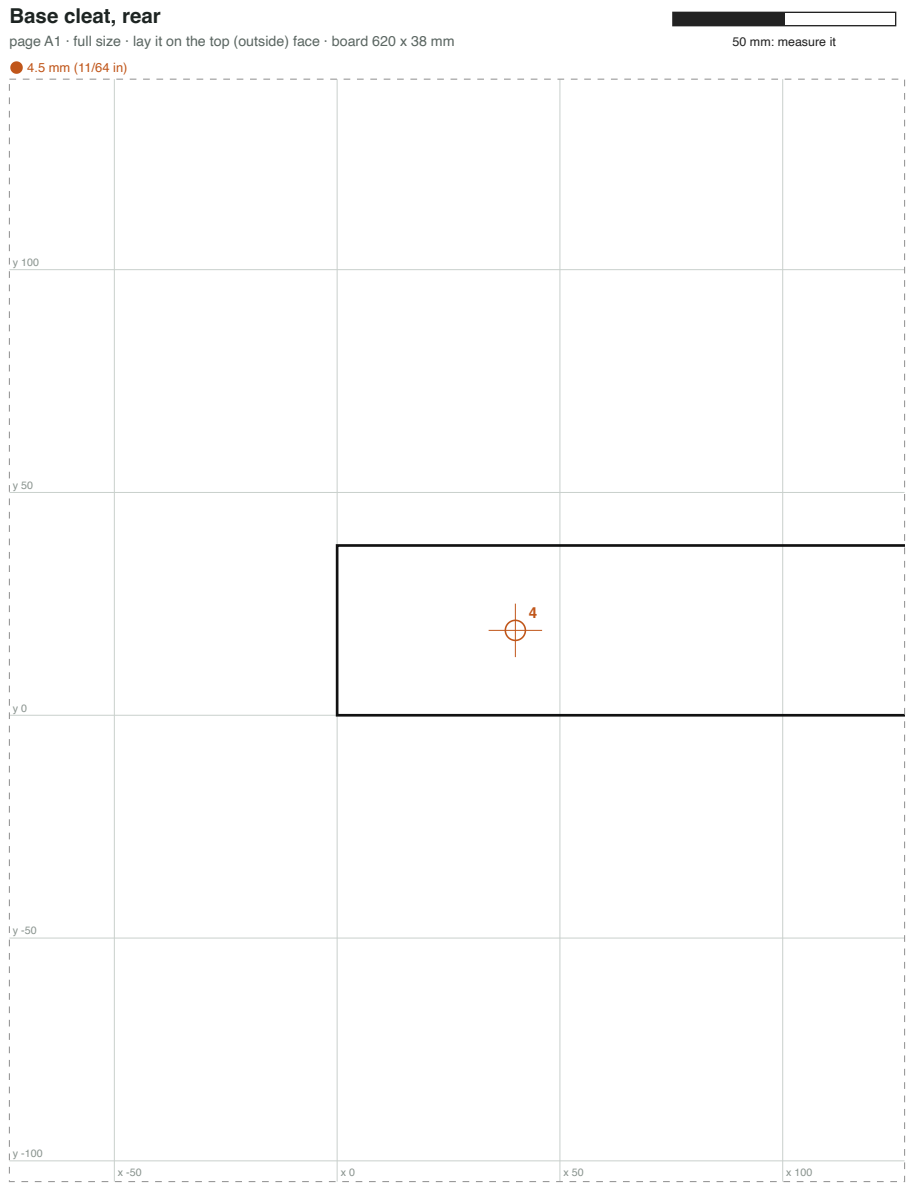
[picture p261: page 42]
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

## Base cleat, rear

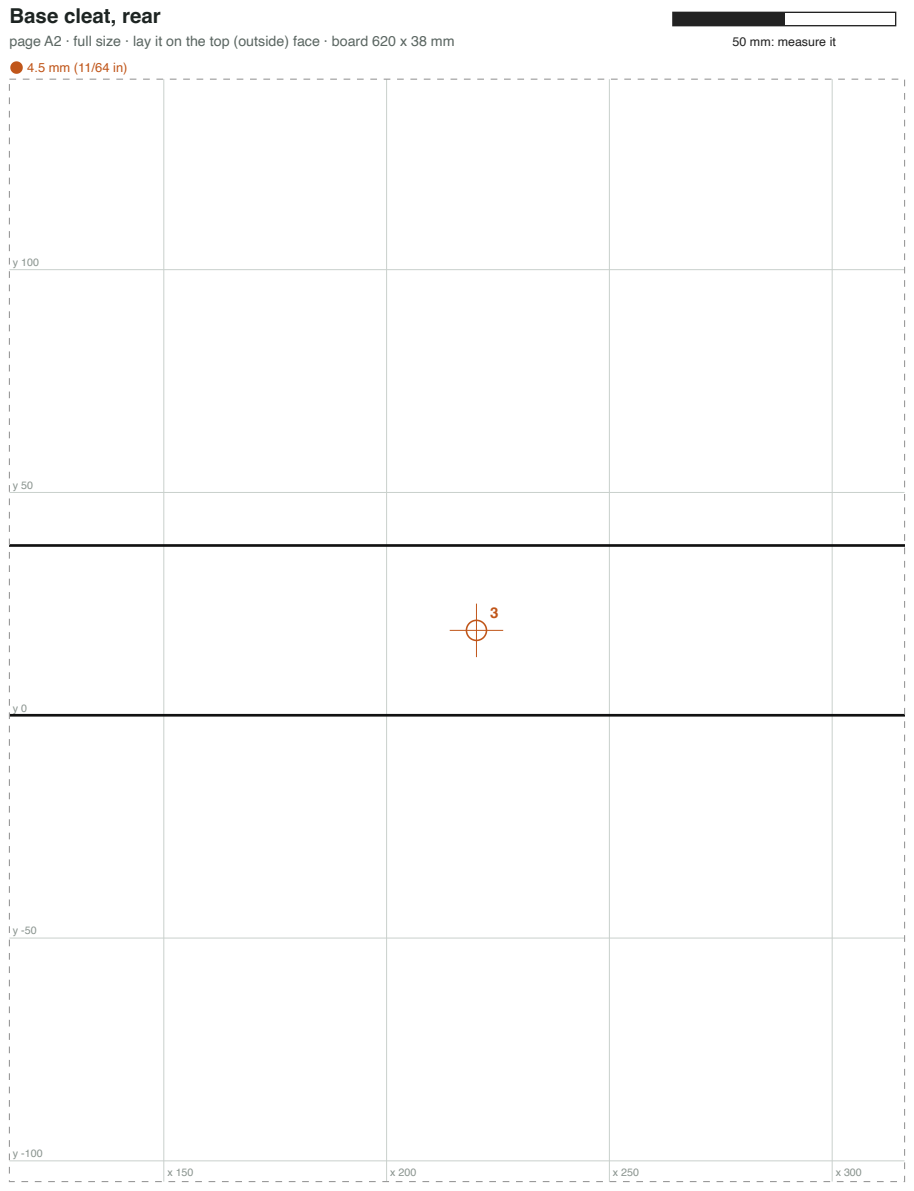
[picture p262: page 43]
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

## Base cleat, rear

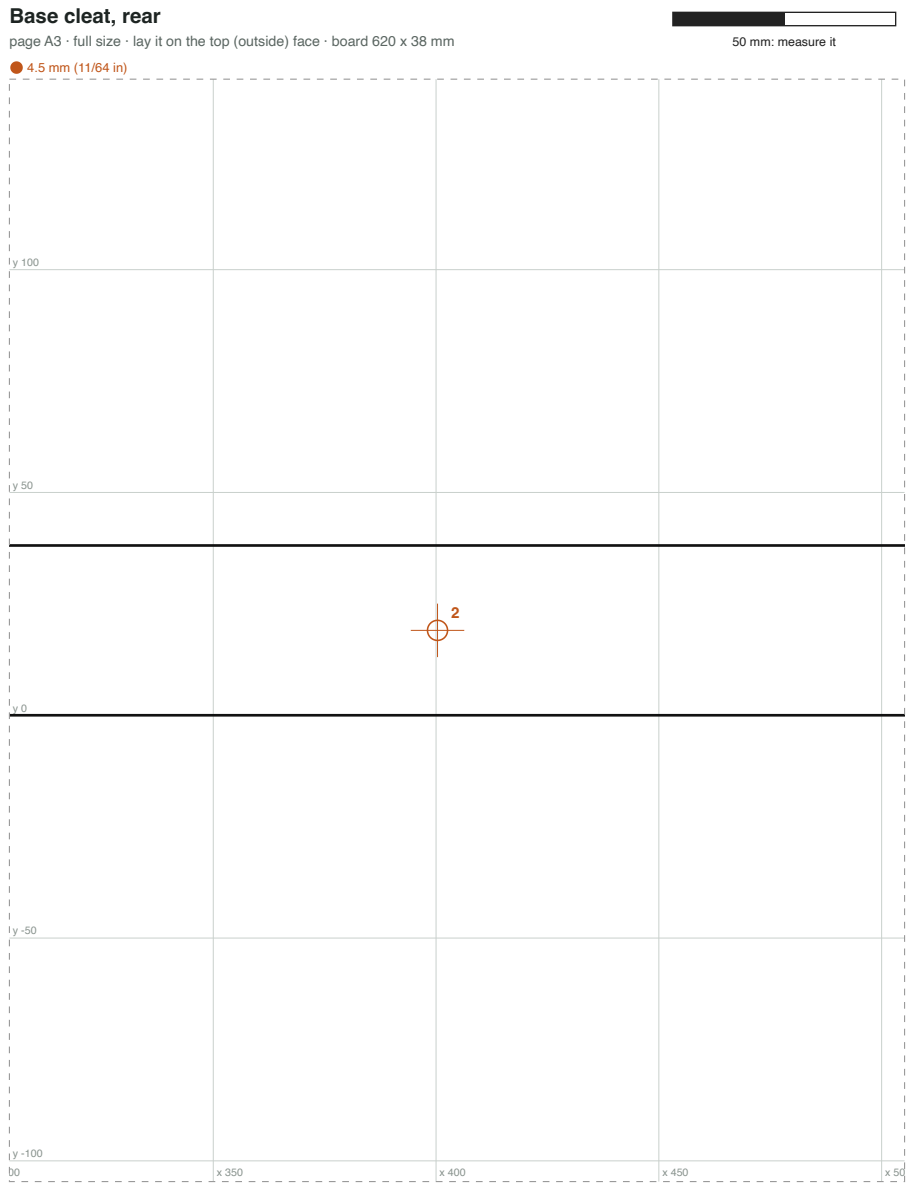
[picture p263: page 44]
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

## Base cleat, rear

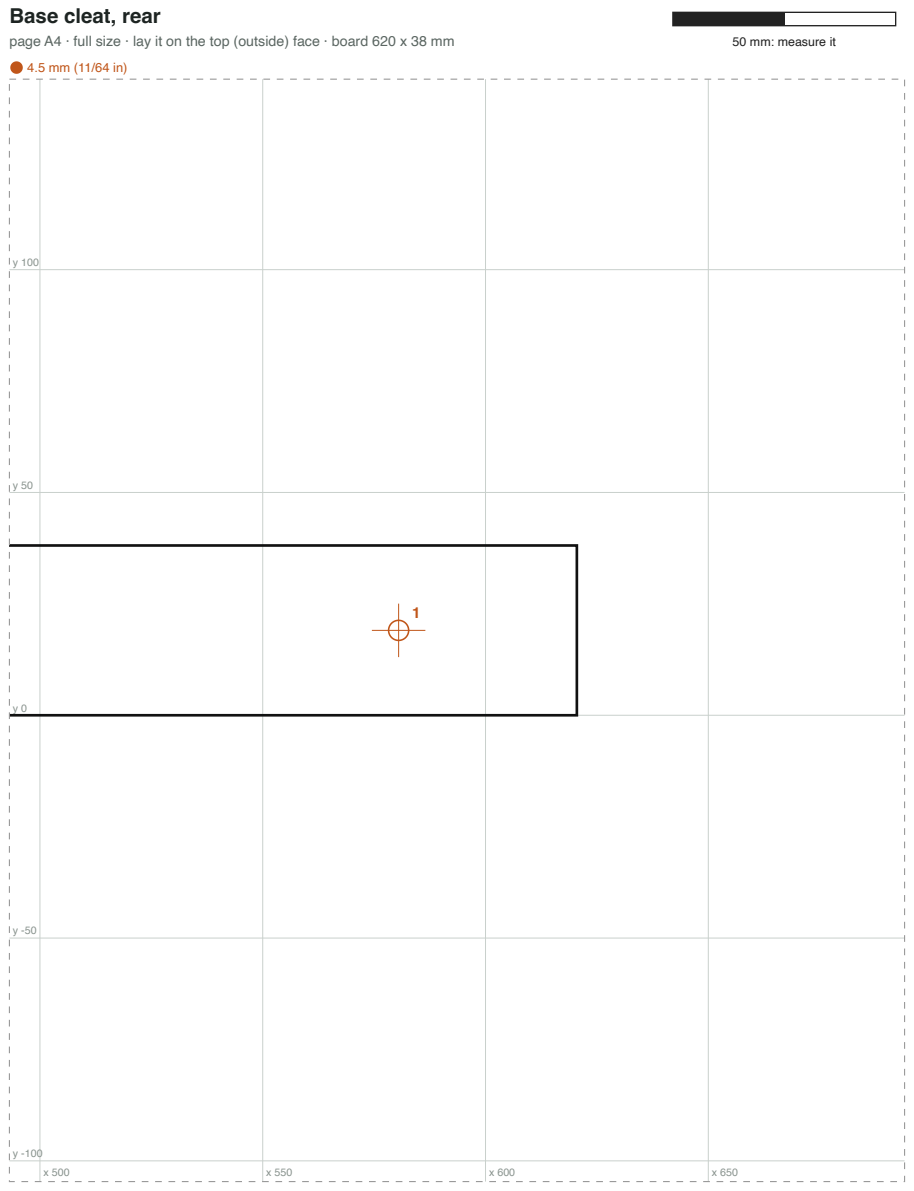
[picture p264: page 45]
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

## Base cleat, left

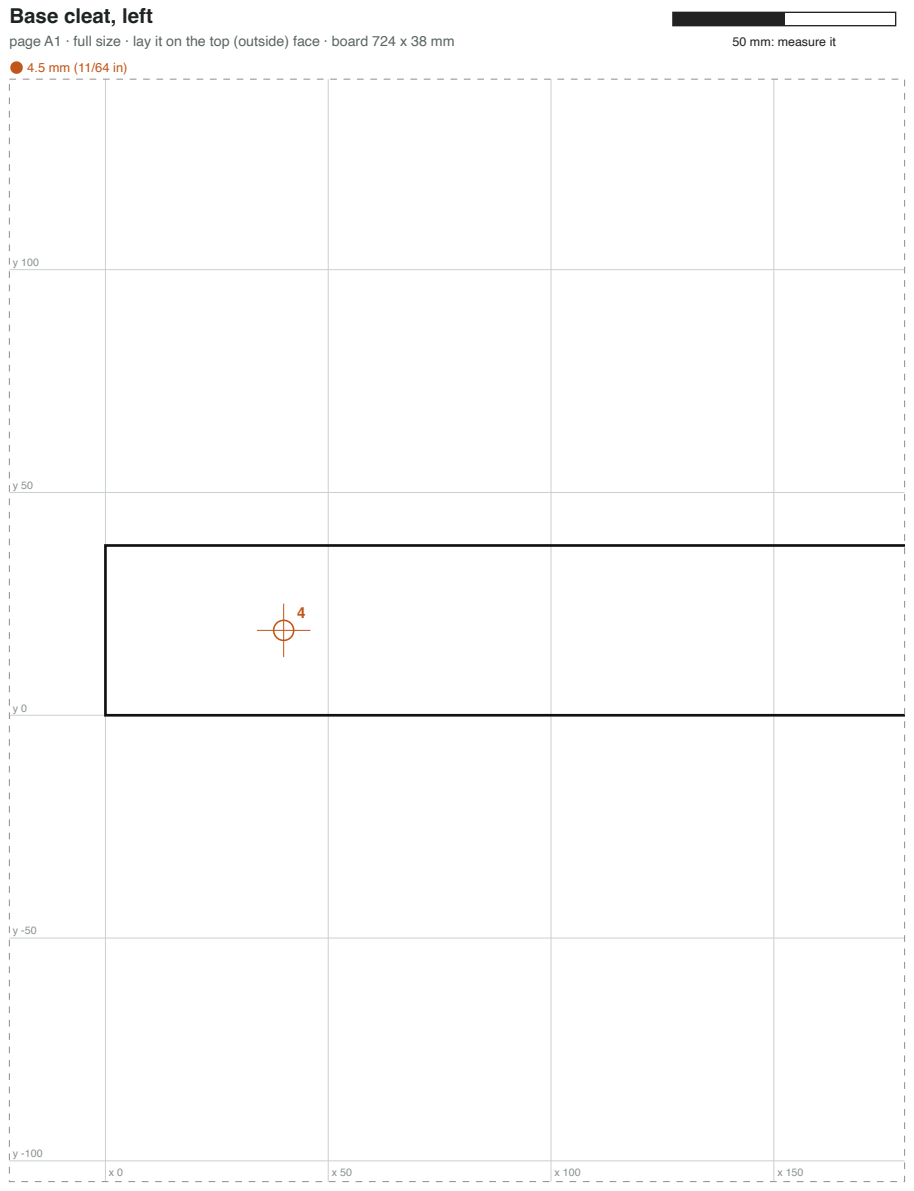
[picture p265: page 46]
page A1 · full size · lay it on the top (outside) face · board 724 x 38 mm; 50 mm: measure it

## Base cleat, left

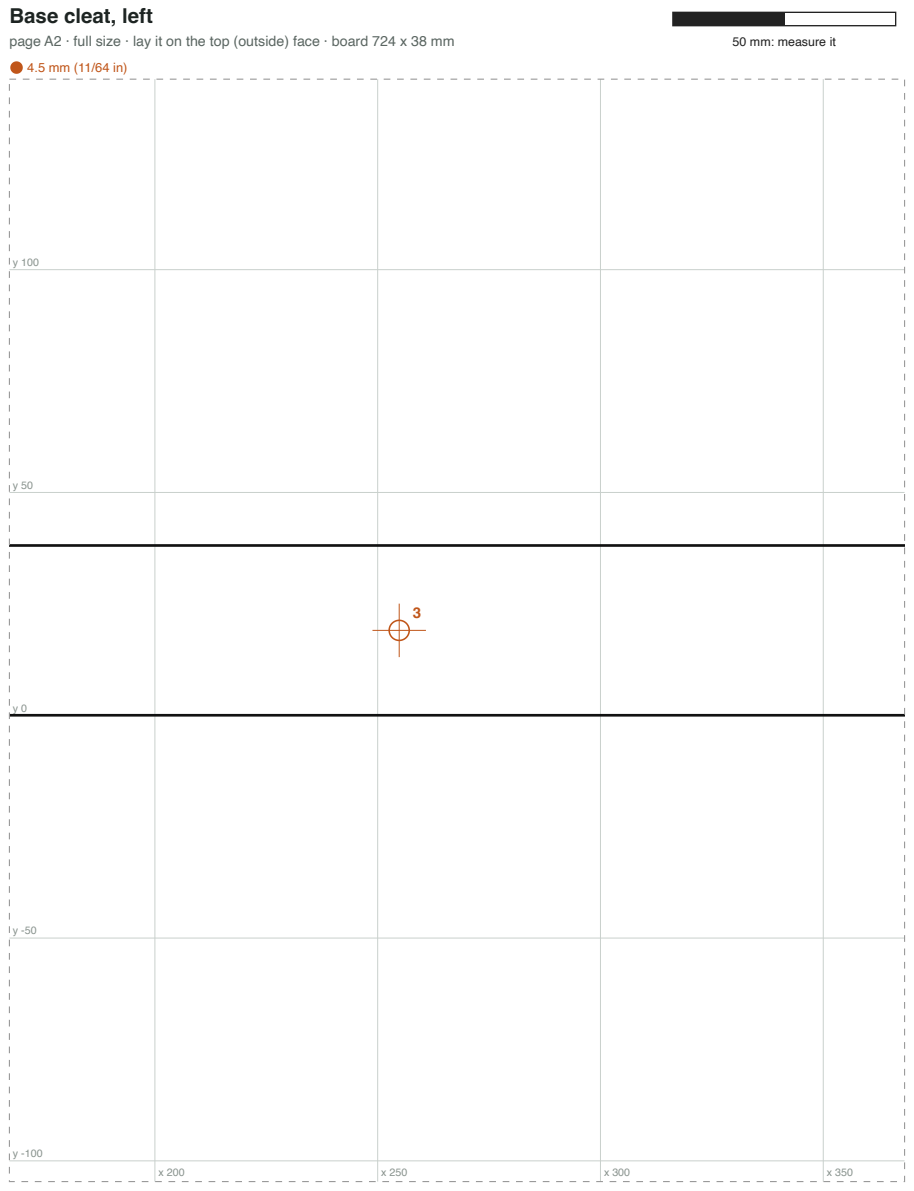
[picture p266: page 47]
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

## Base cleat, left

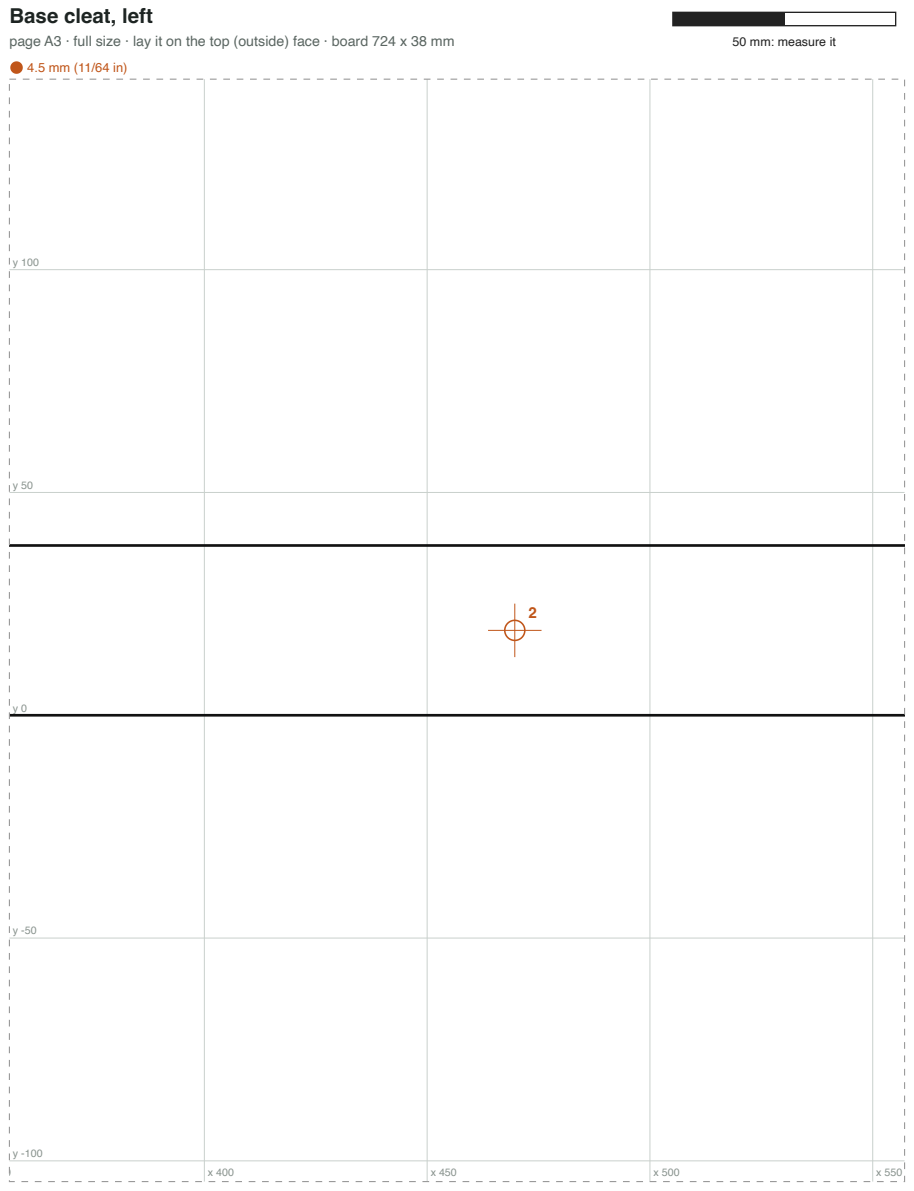
[picture p267: page 48]
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

## Base cleat, left

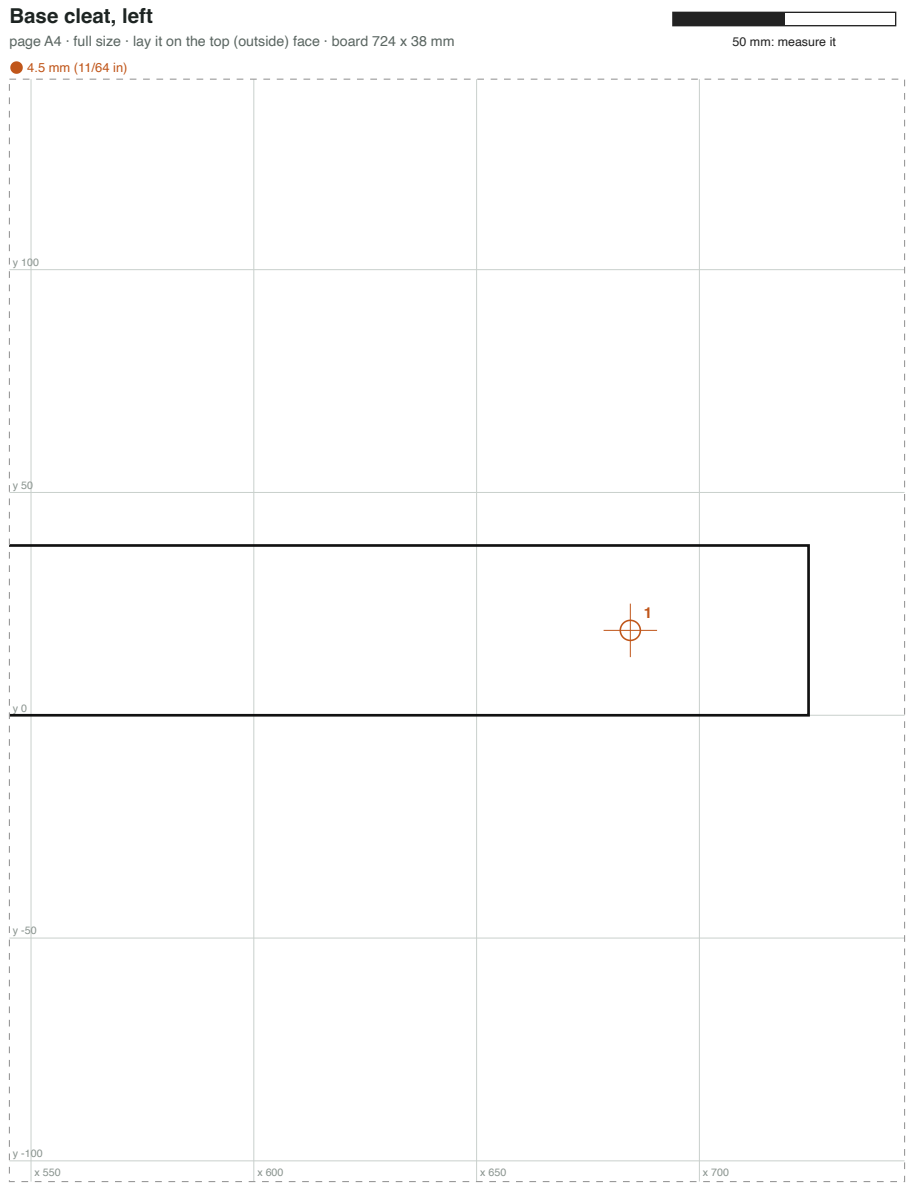
[picture p268: page 49]
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

## Base cleat, right

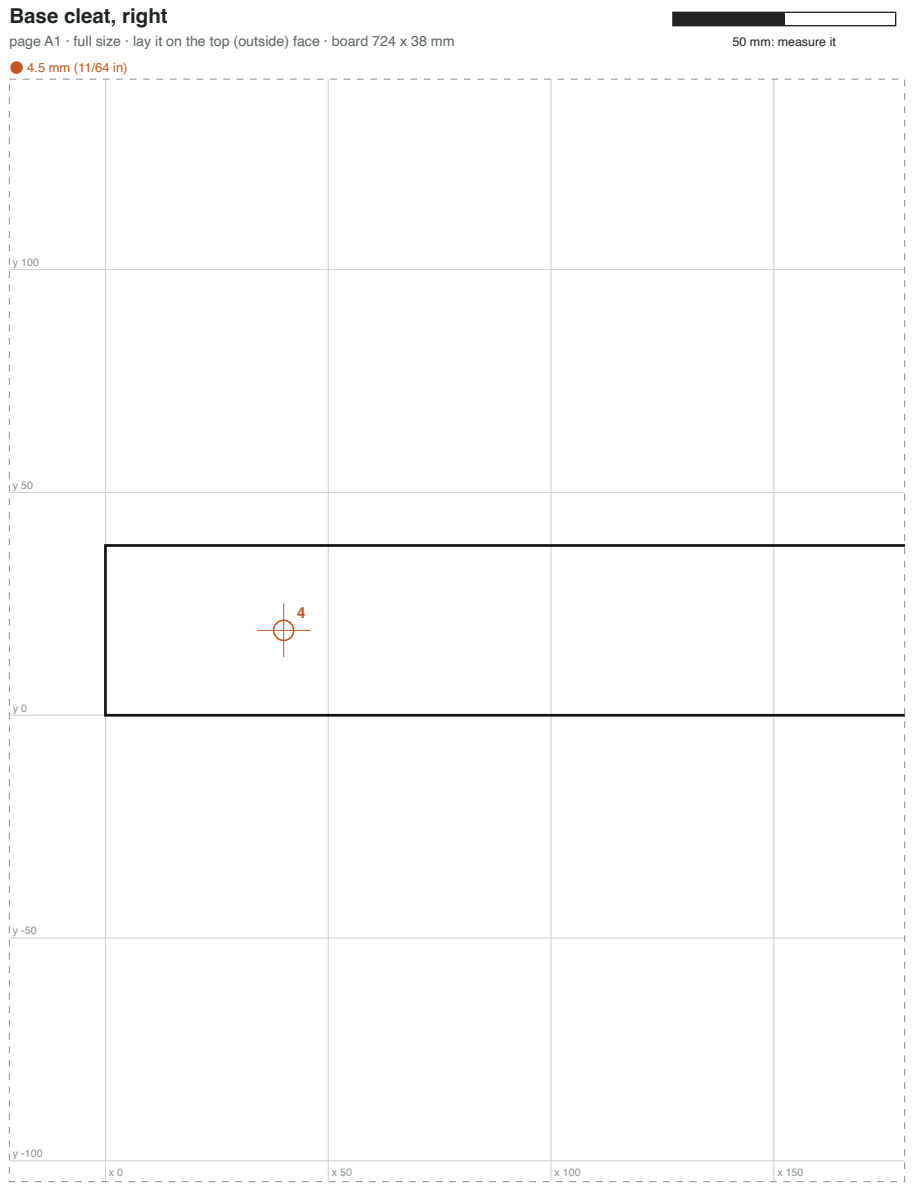
[picture p269: page 50]
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

## Base cleat, right

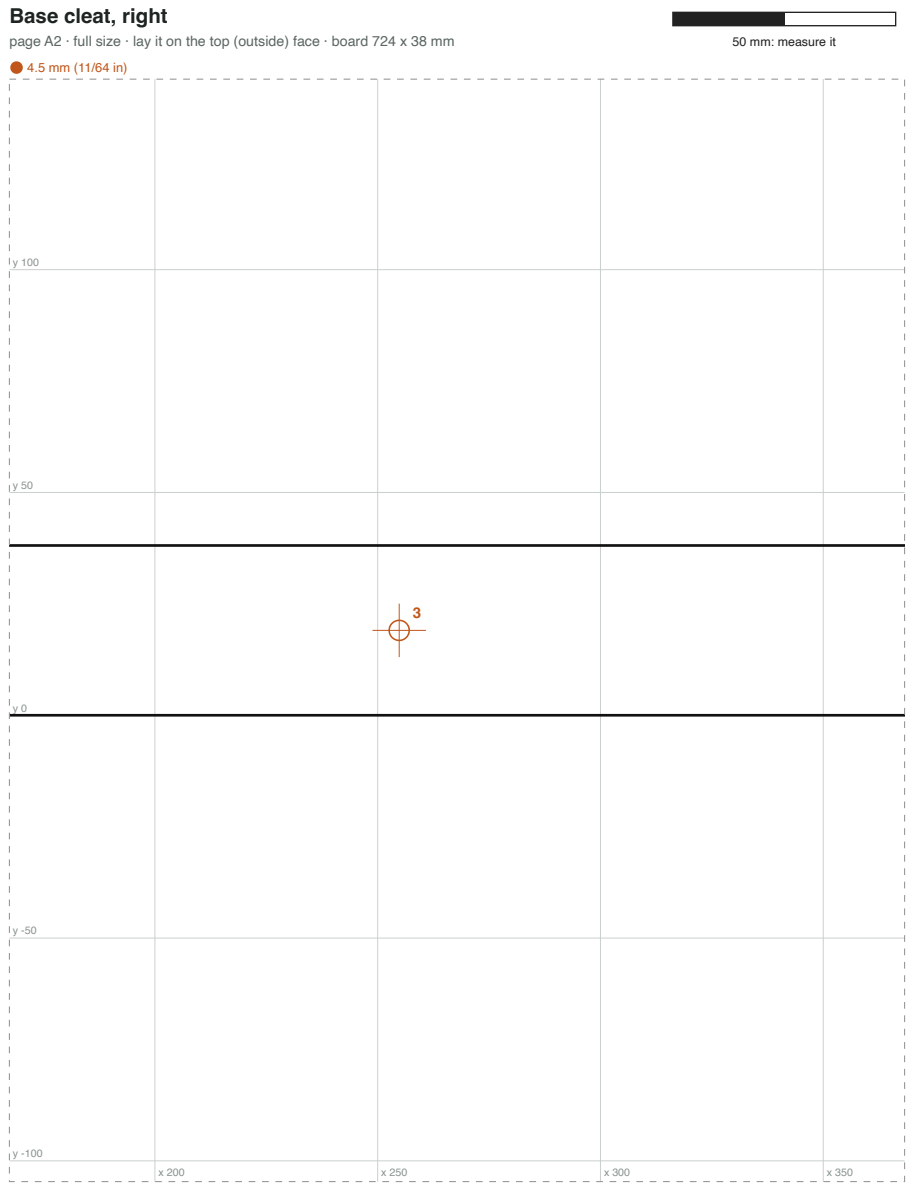
[picture p270: page 51]
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

## Base cleat, right

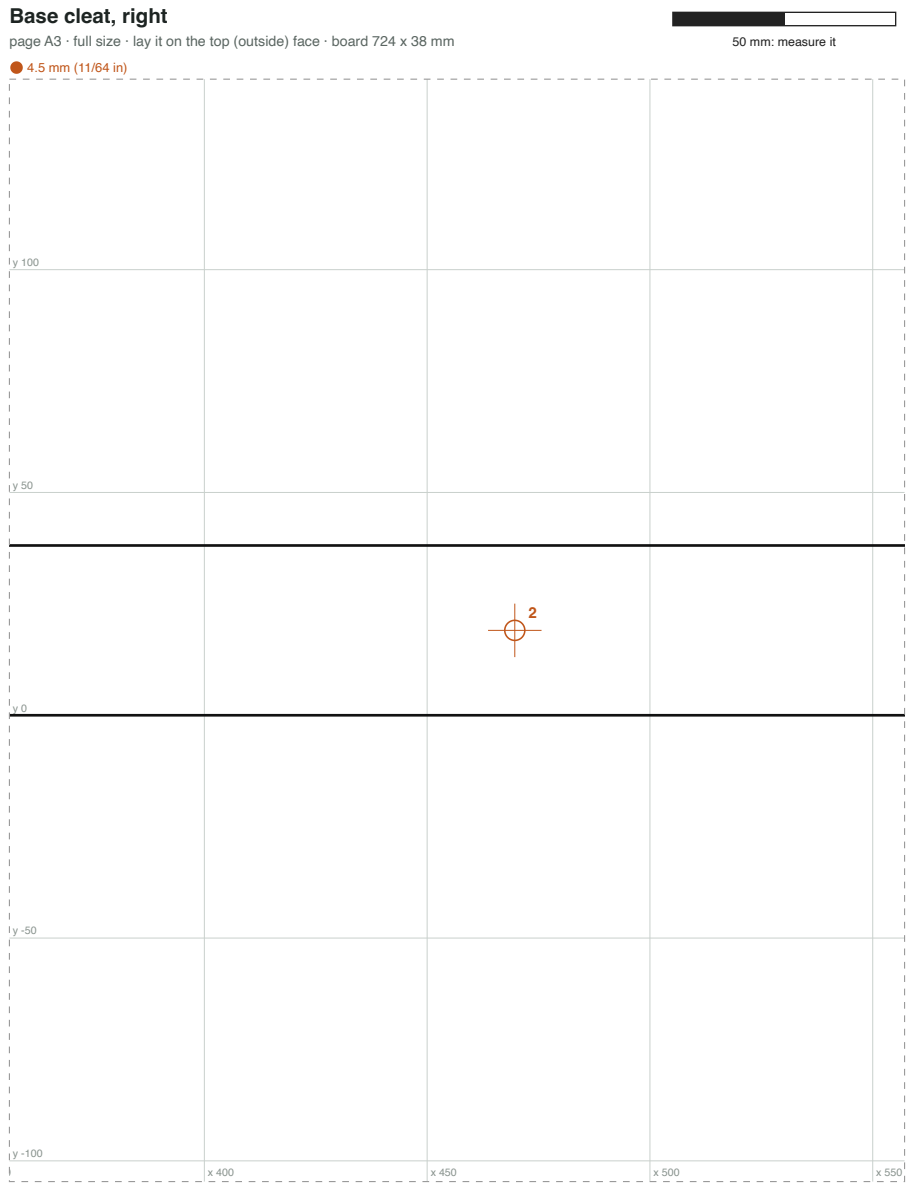
[picture p271: page 52]
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

## Base cleat, right

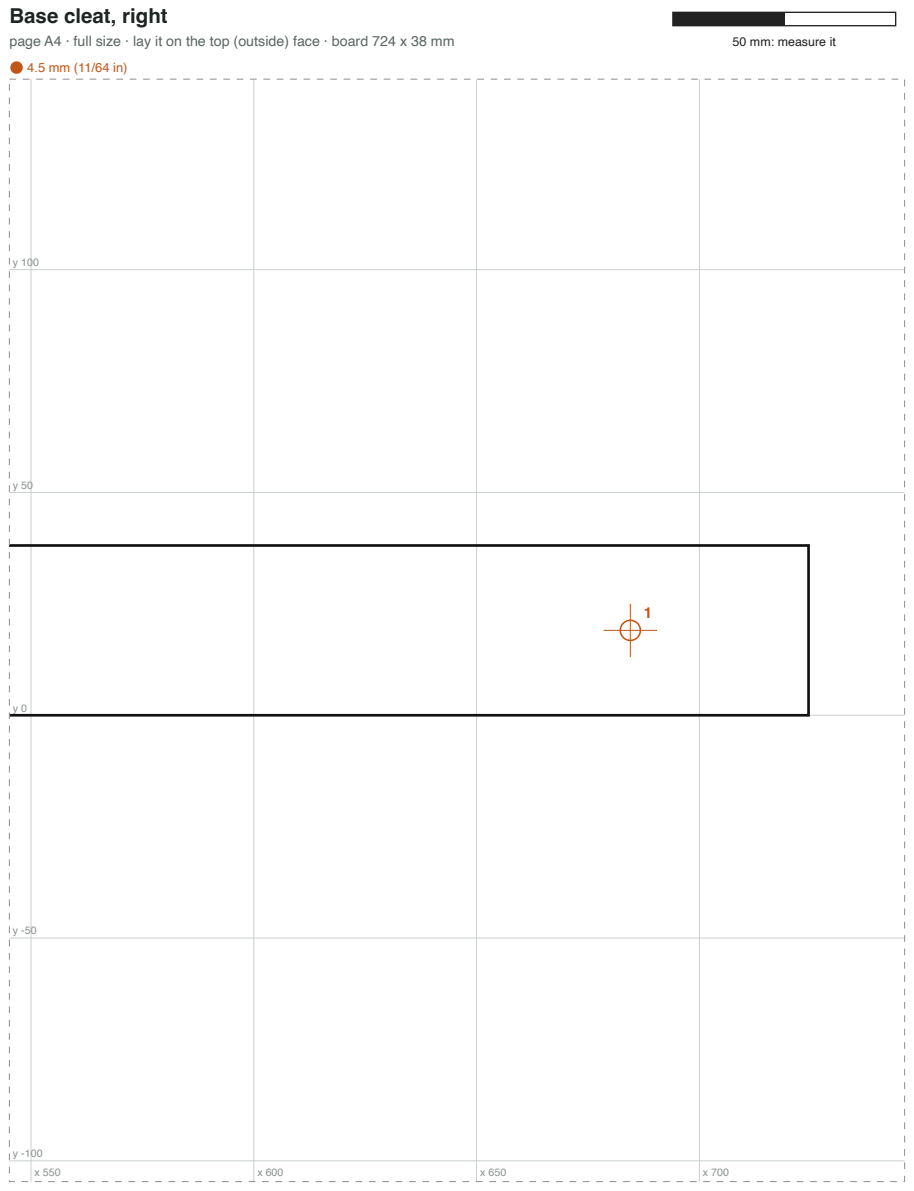
[picture p272: page 53]
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

## Base bridge y=-230

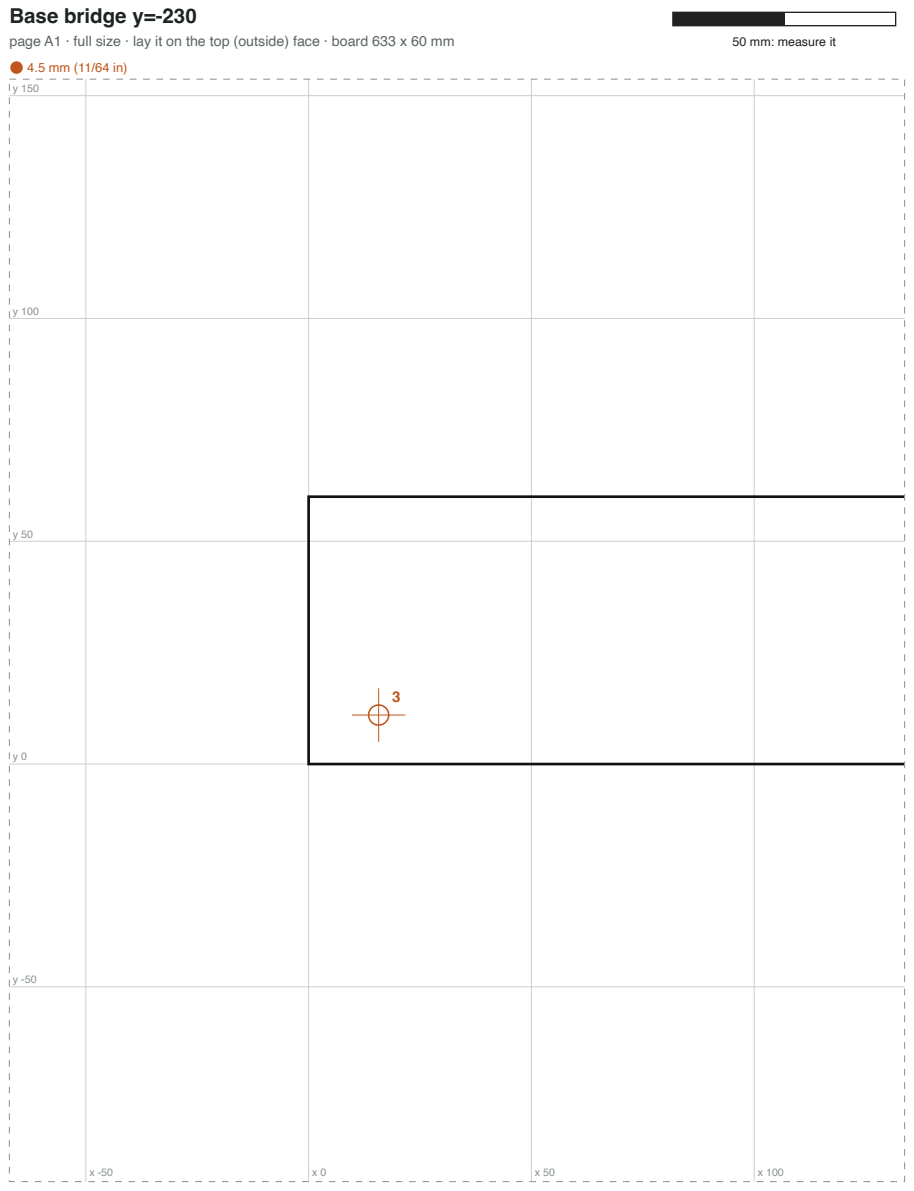
[picture p273: page 54]
page A1 · full size · lay it on the top (outside) face · board 633 x 60 mm; 50 mm: measure it

## Base bridge y=-230

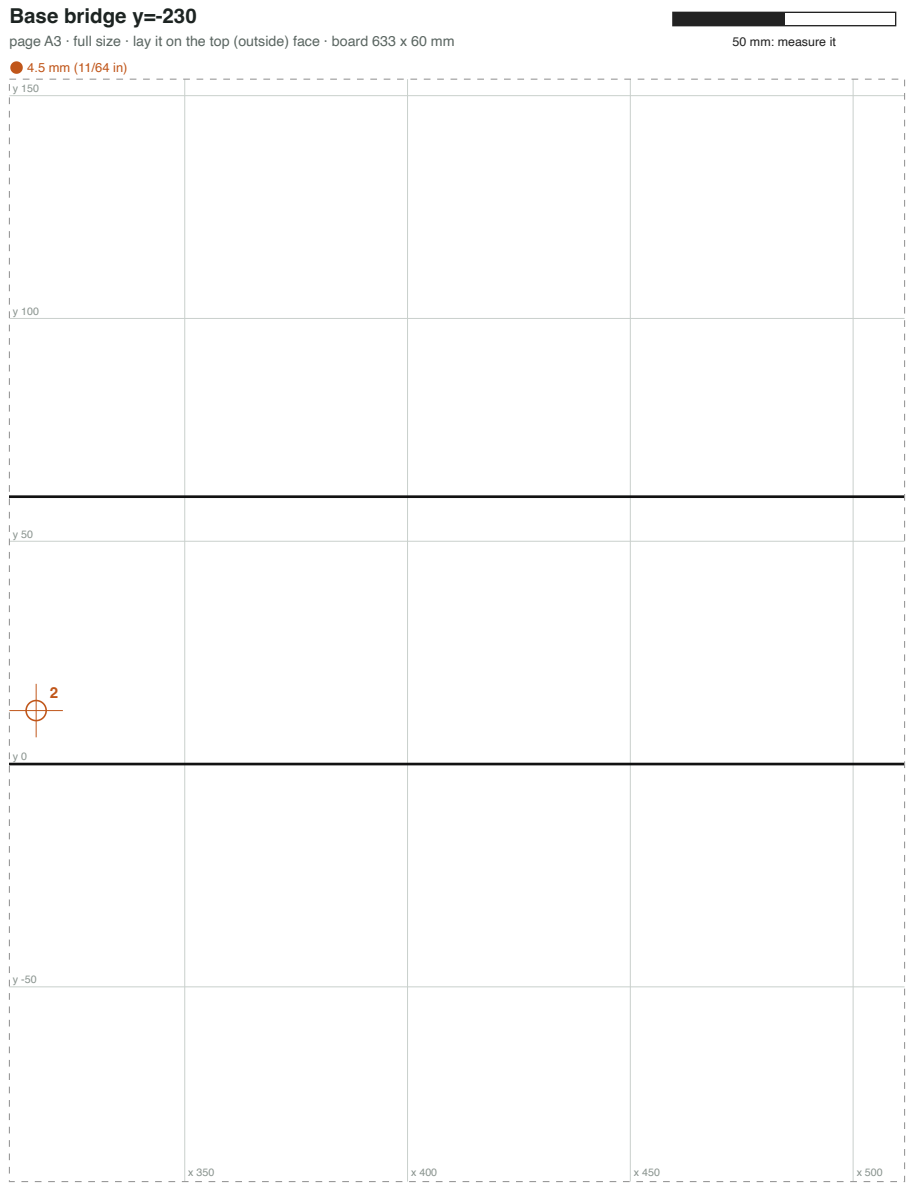
[picture p274: page 55]
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

## Base bridge y=-230

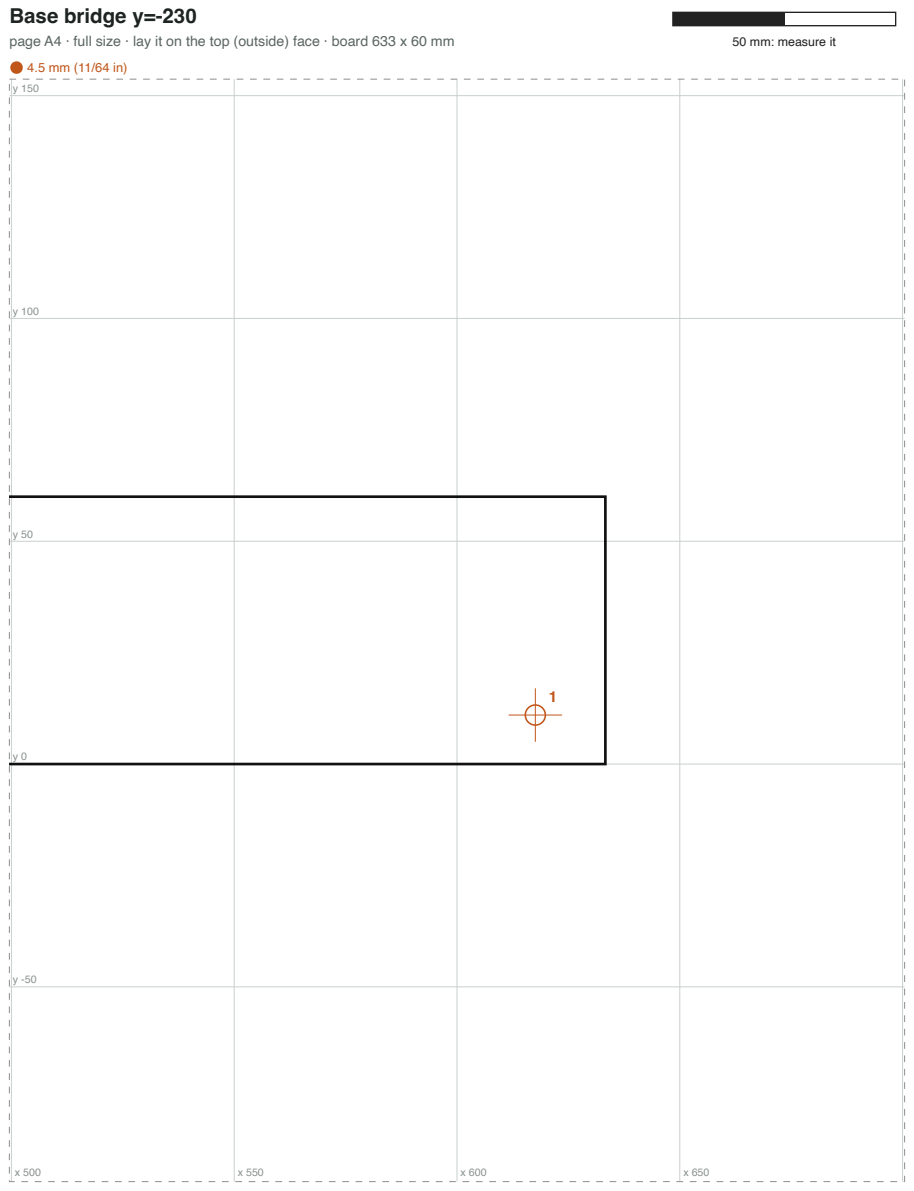
[picture p275: page 56]
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

## Base bridge y=-130

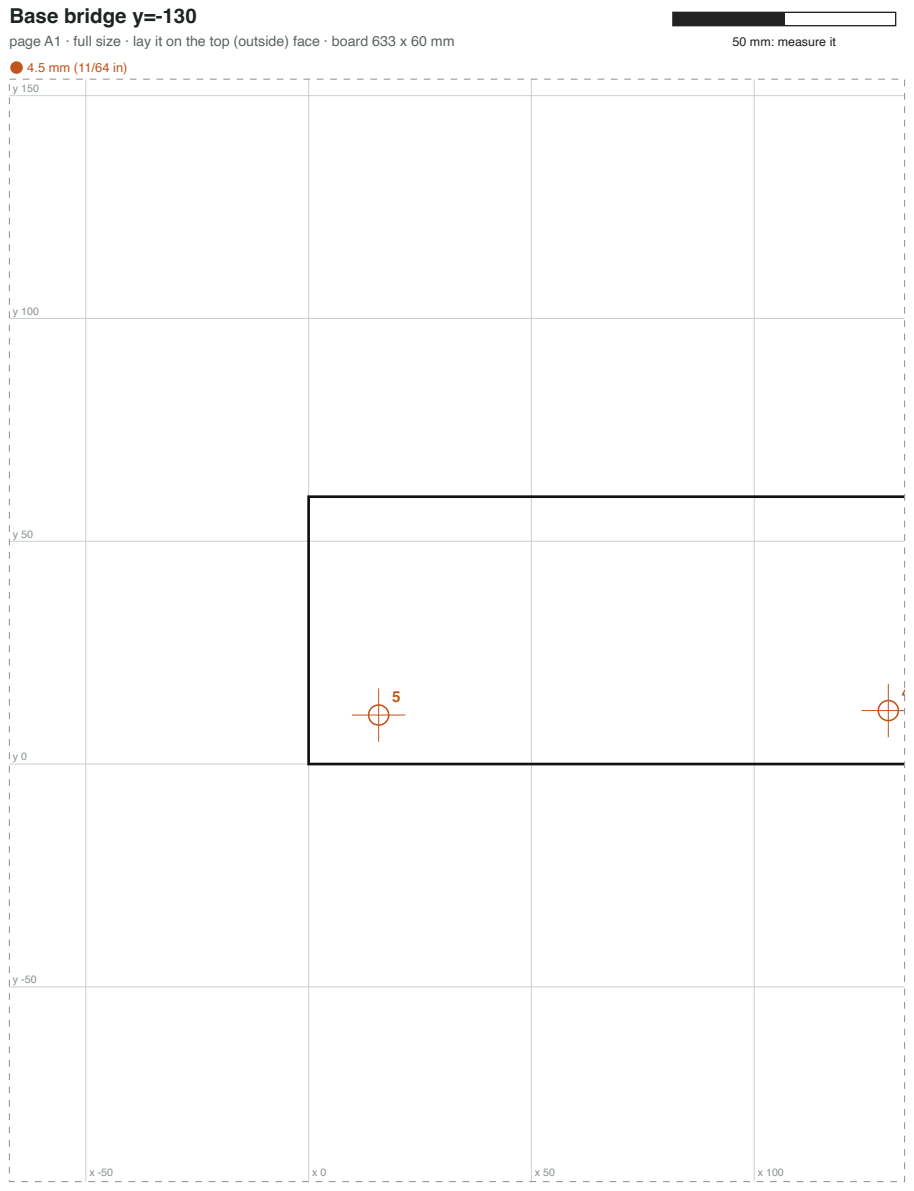
[picture p276: page 57]
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

## Base bridge y=-130

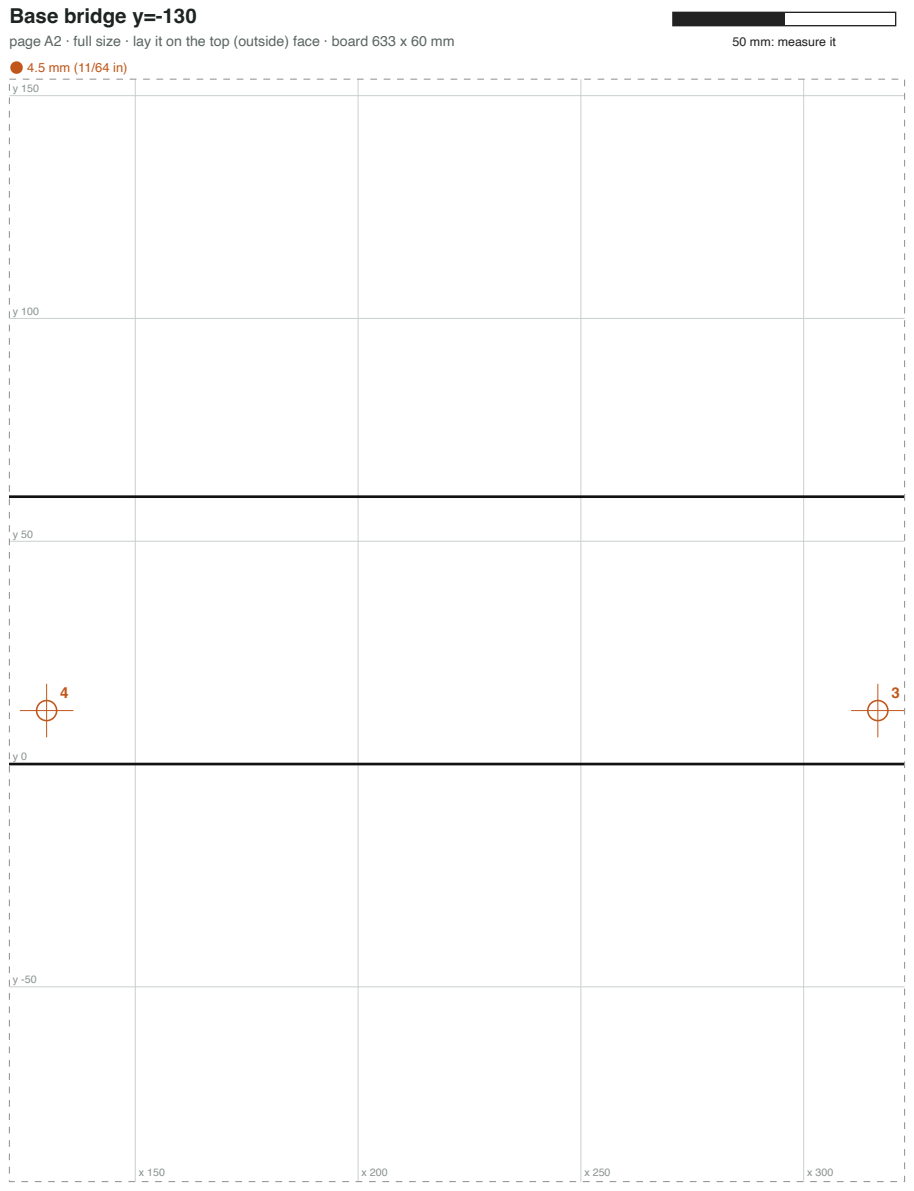
[picture p277: page 58]
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

## Base bridge y=-130

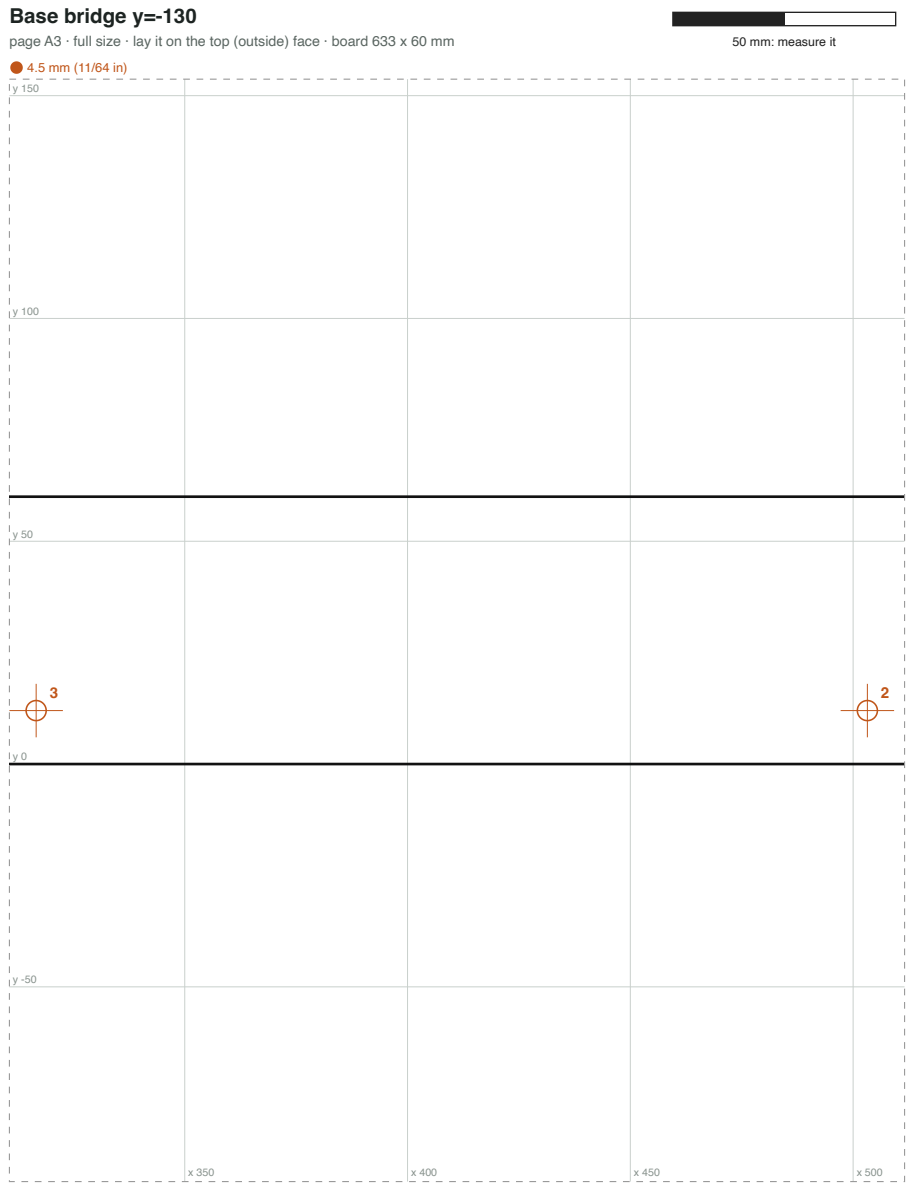
[picture p278: page 59]
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

## Base bridge y=-130

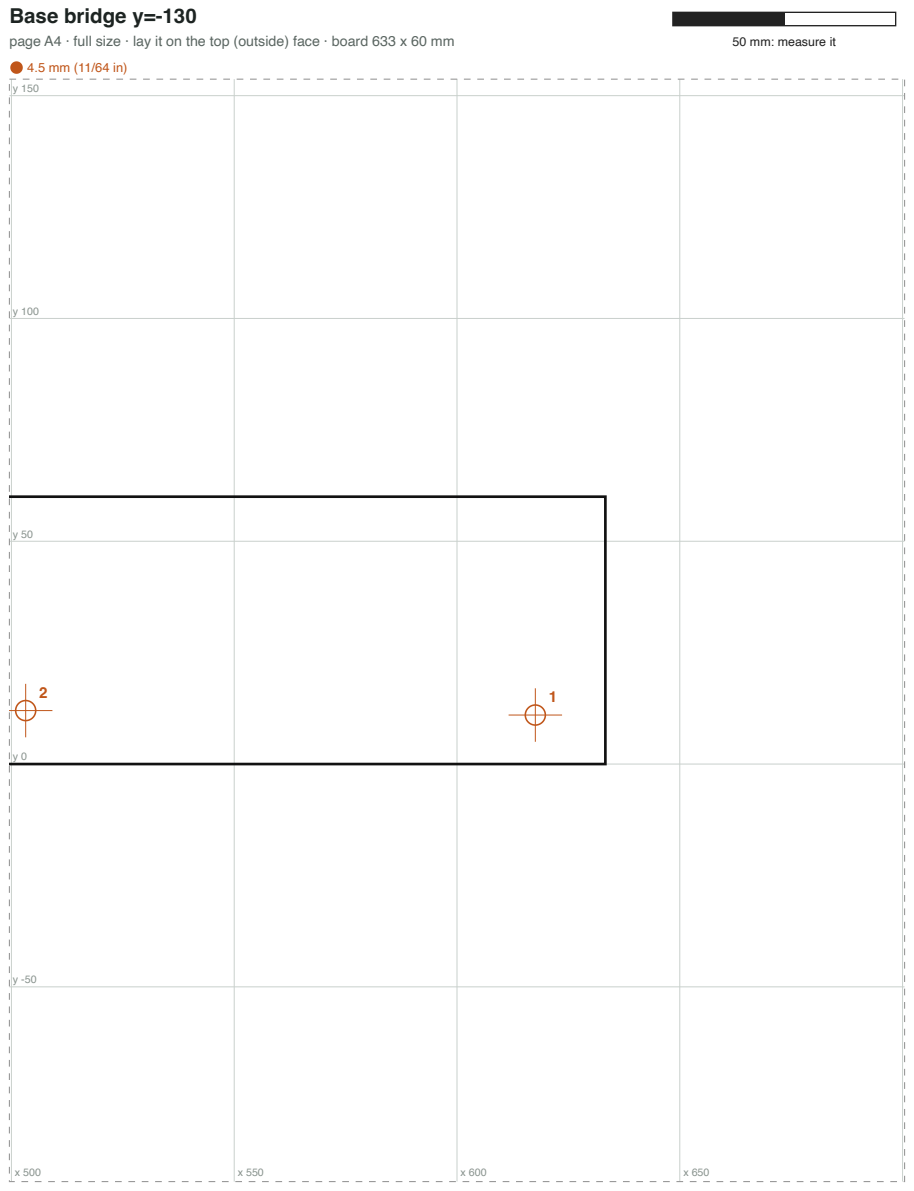
[picture p279: page 60]
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

## Base bridge y=-60

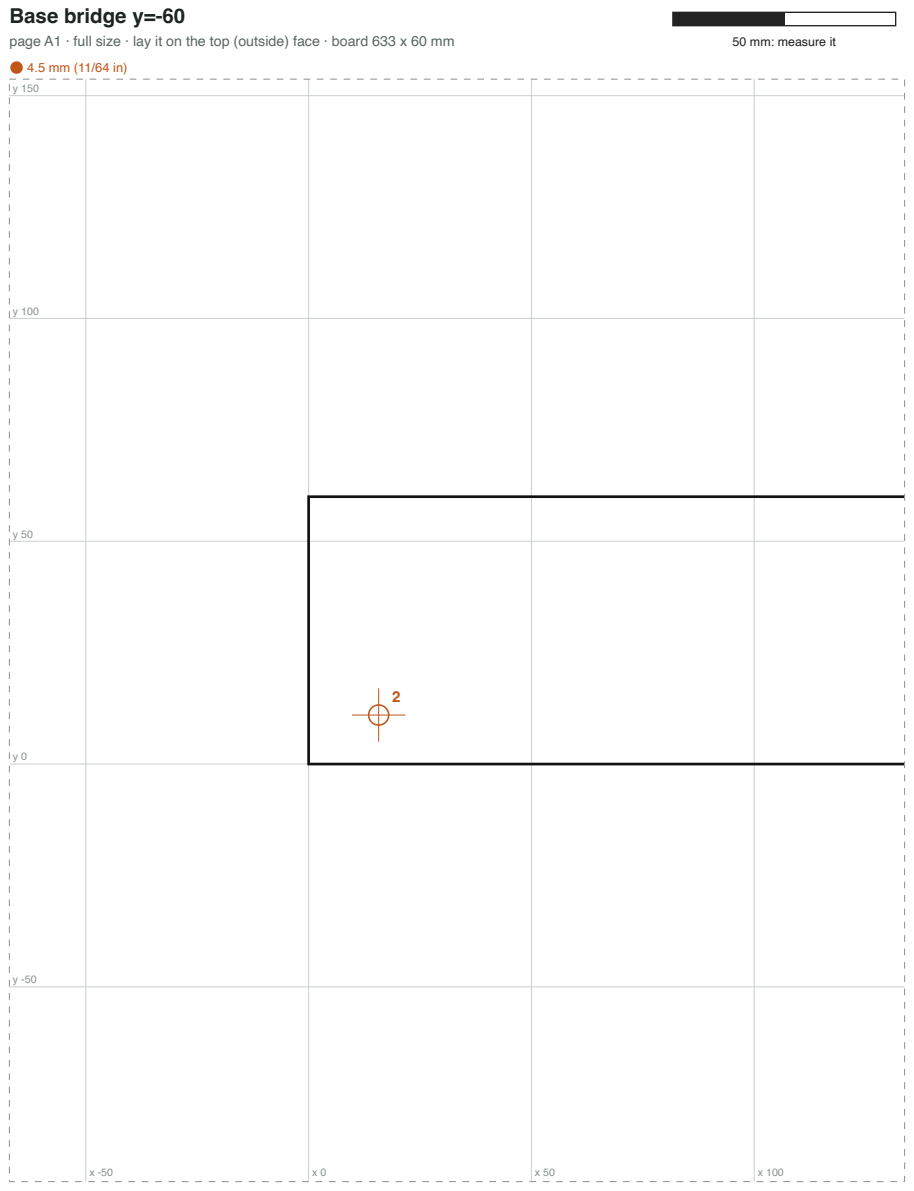
[picture p280: page 61]
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

## Base bridge y=-60

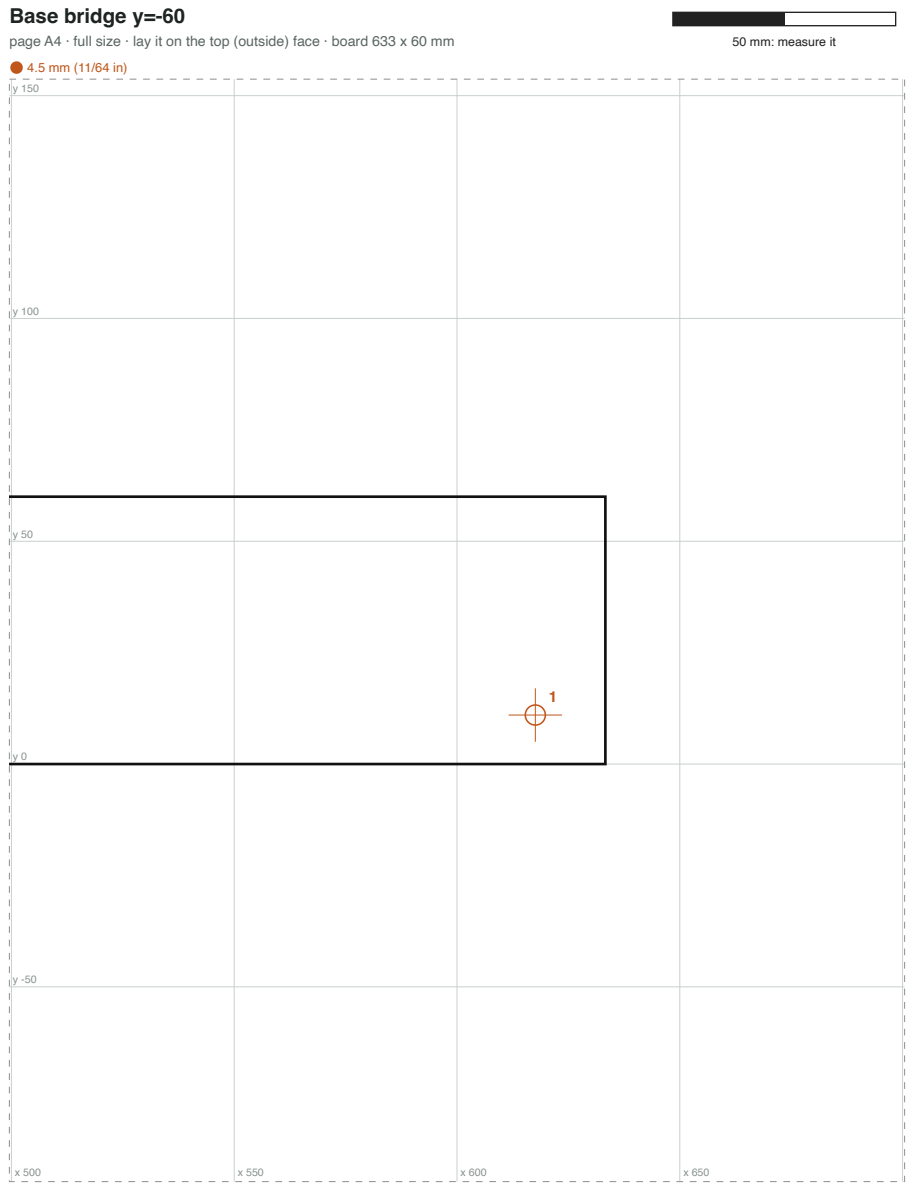
[picture p281: page 62]
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

## Base bridge y=100

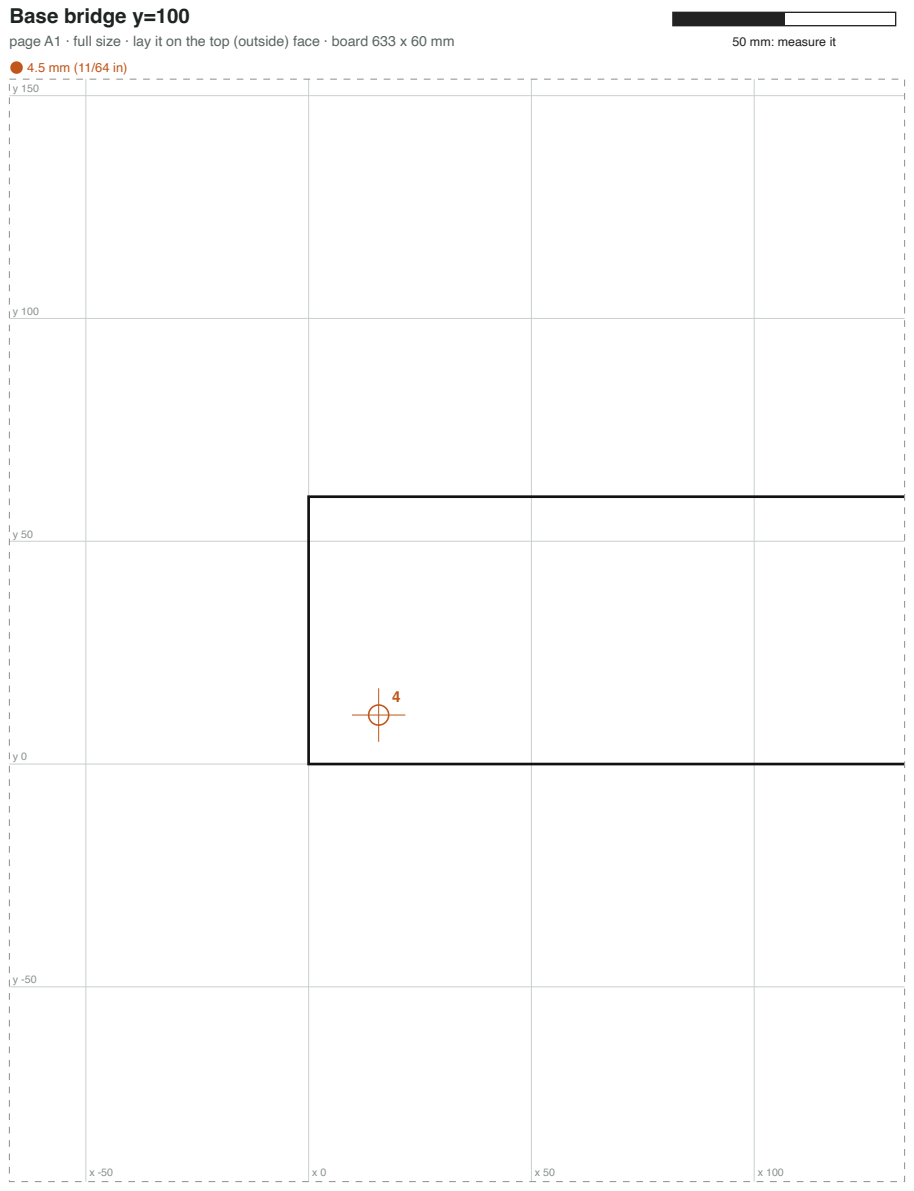
[picture p282: page 63]
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

## Base bridge y=100

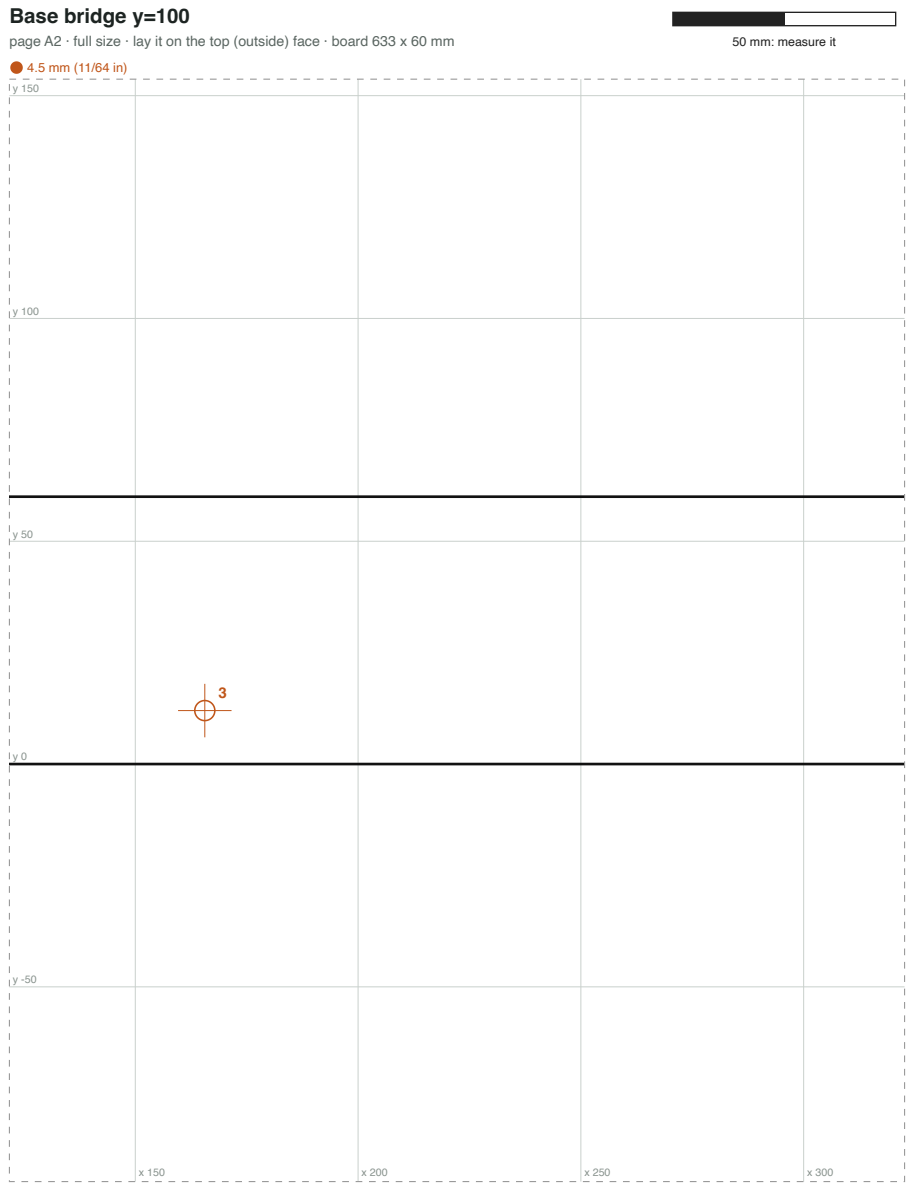
[picture p283: page 64]
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

## Base bridge y=100

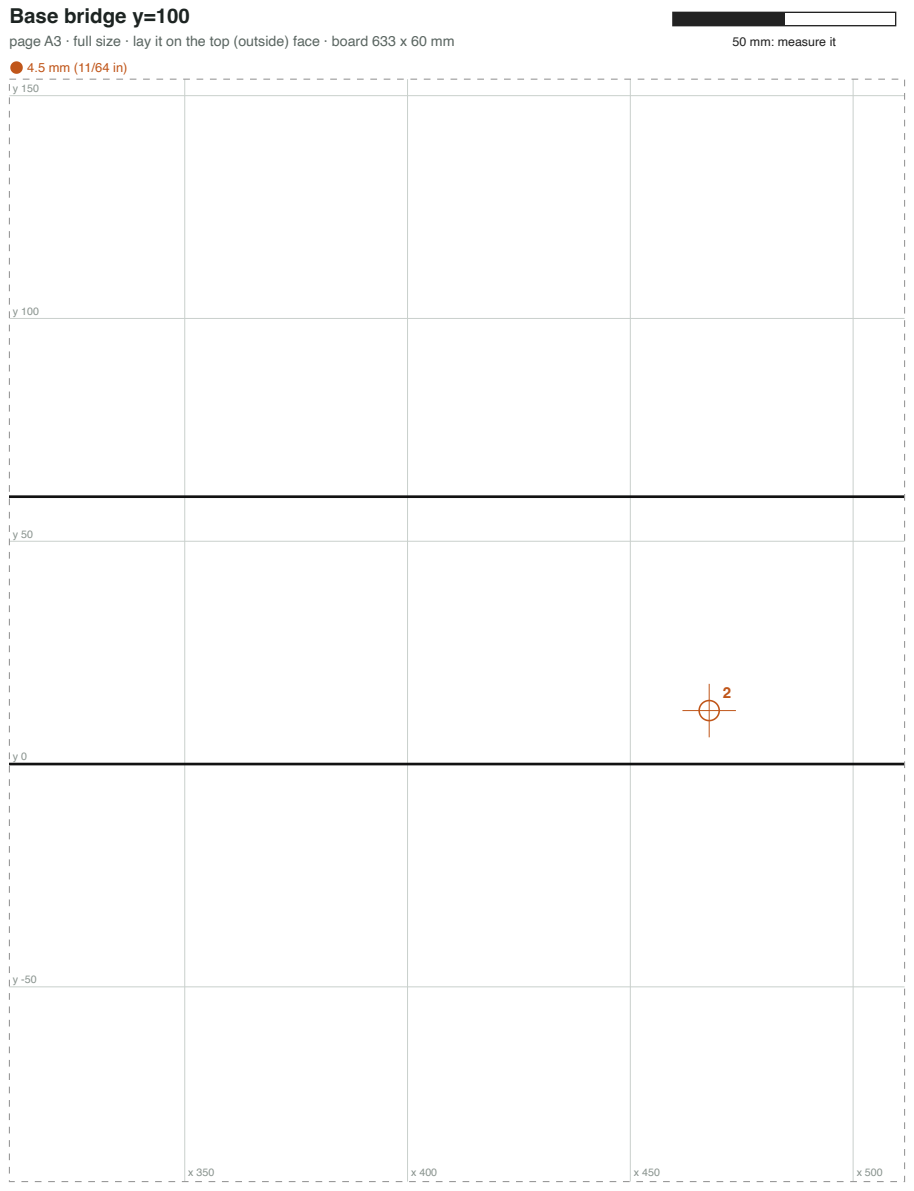
[picture p284: page 65]
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

## Base bridge y=100

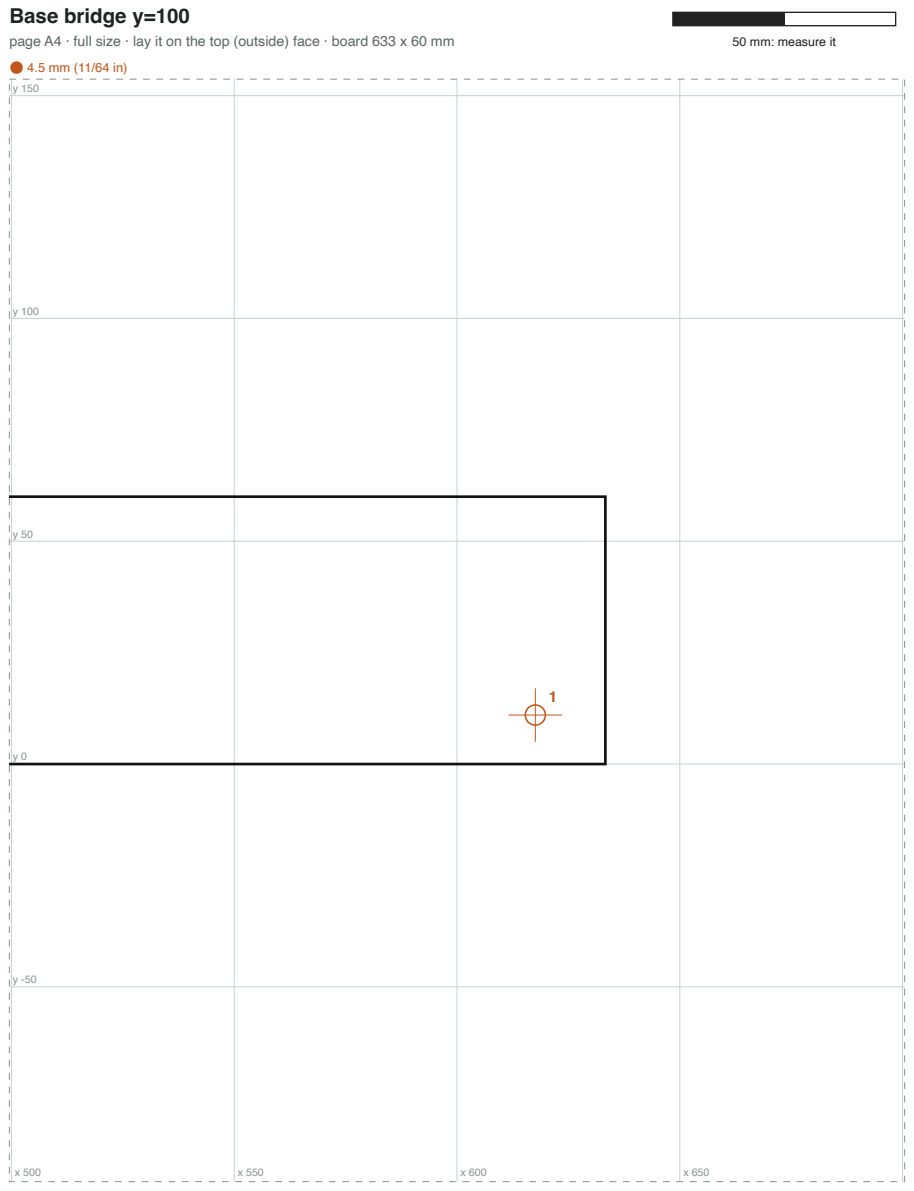
[picture p285: page 66]
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

## Base bridge y=170

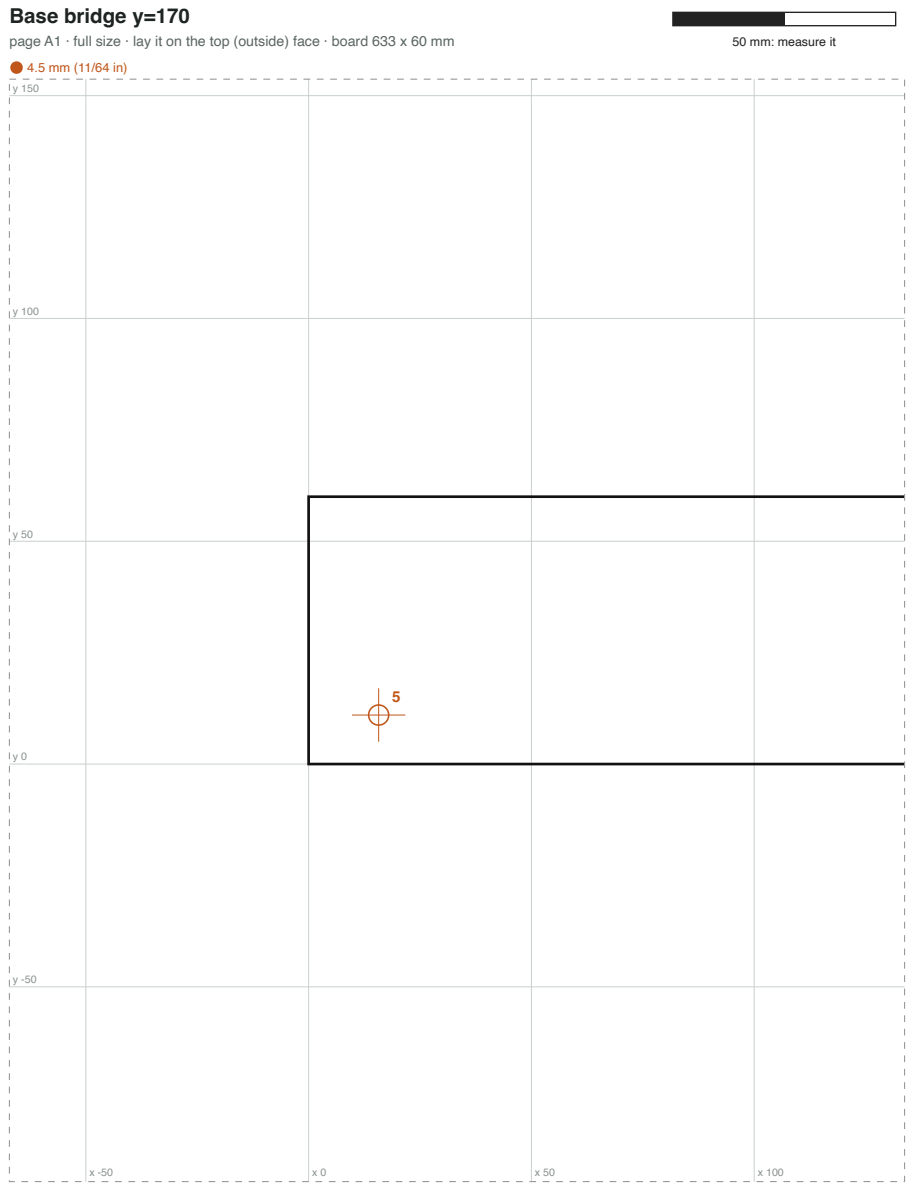
[picture p286: page 67]
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

## Base bridge y=170

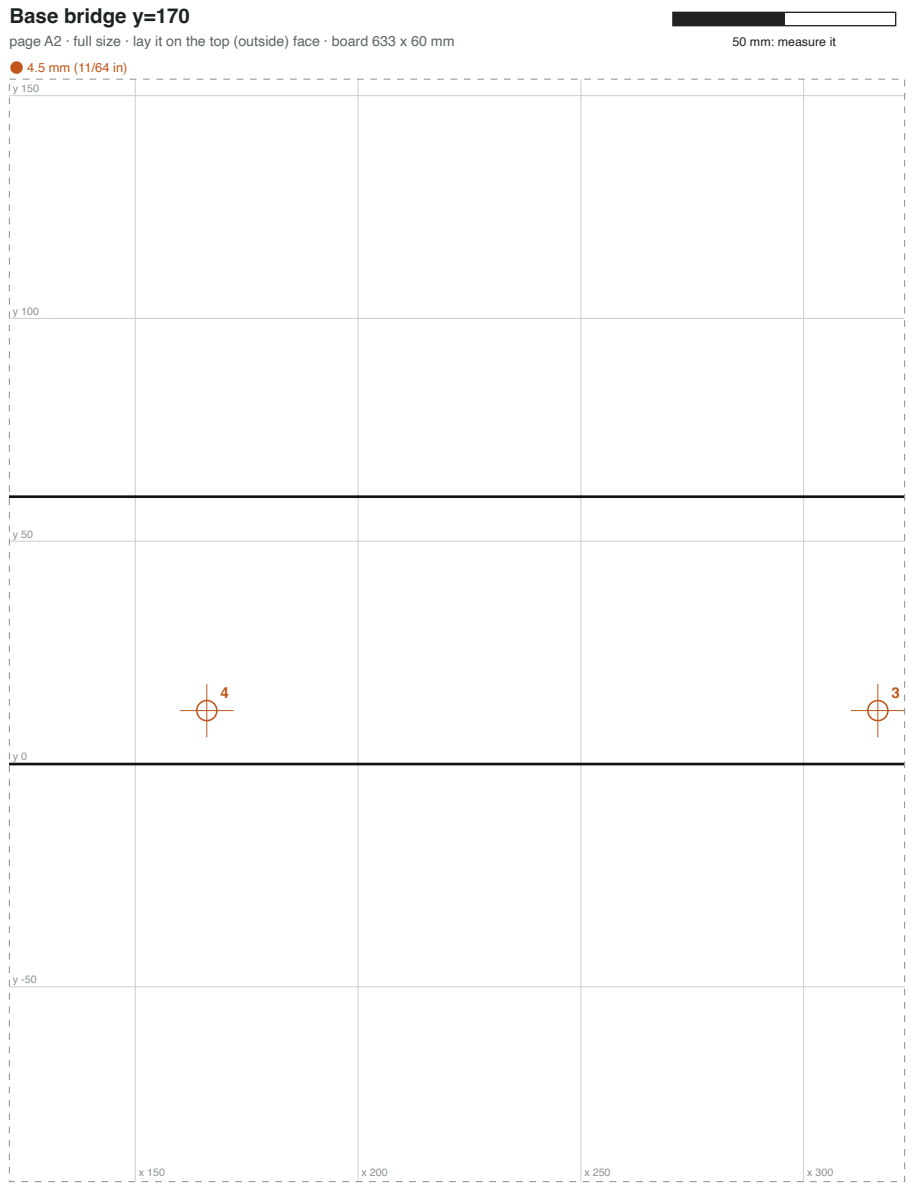
[picture p287: page 68]
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

## Base bridge y=170

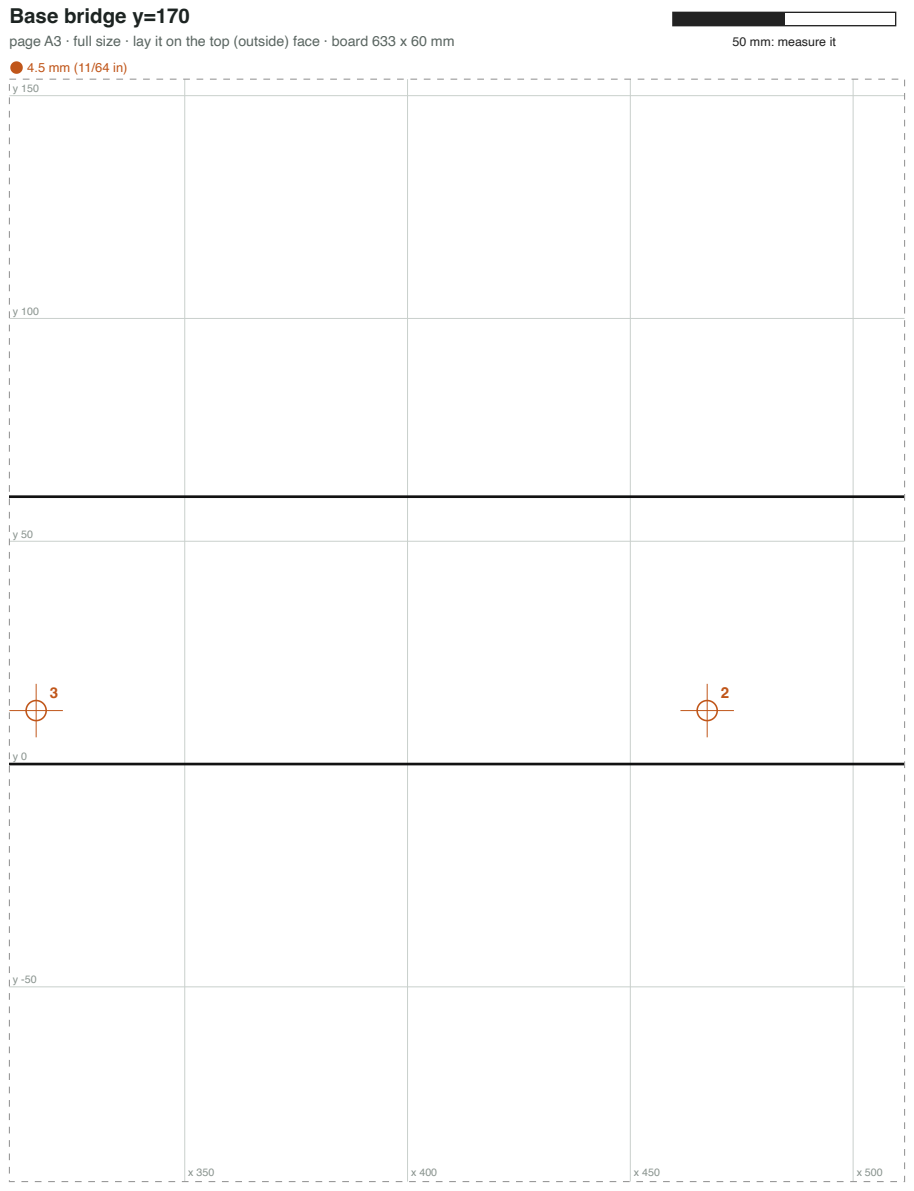
[picture p288: page 69]
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

## Base bridge y=170

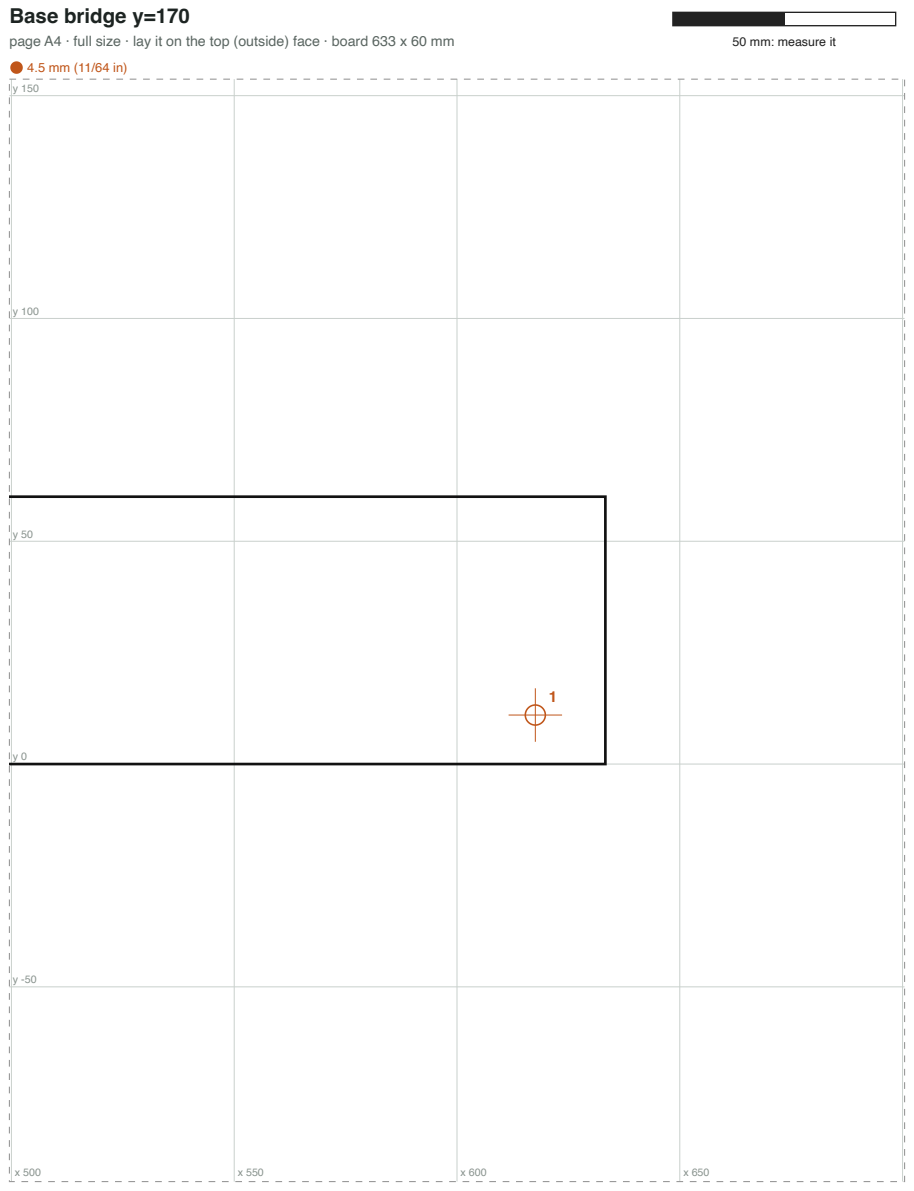
[picture p289: page 70]
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

## Base bridge y=280

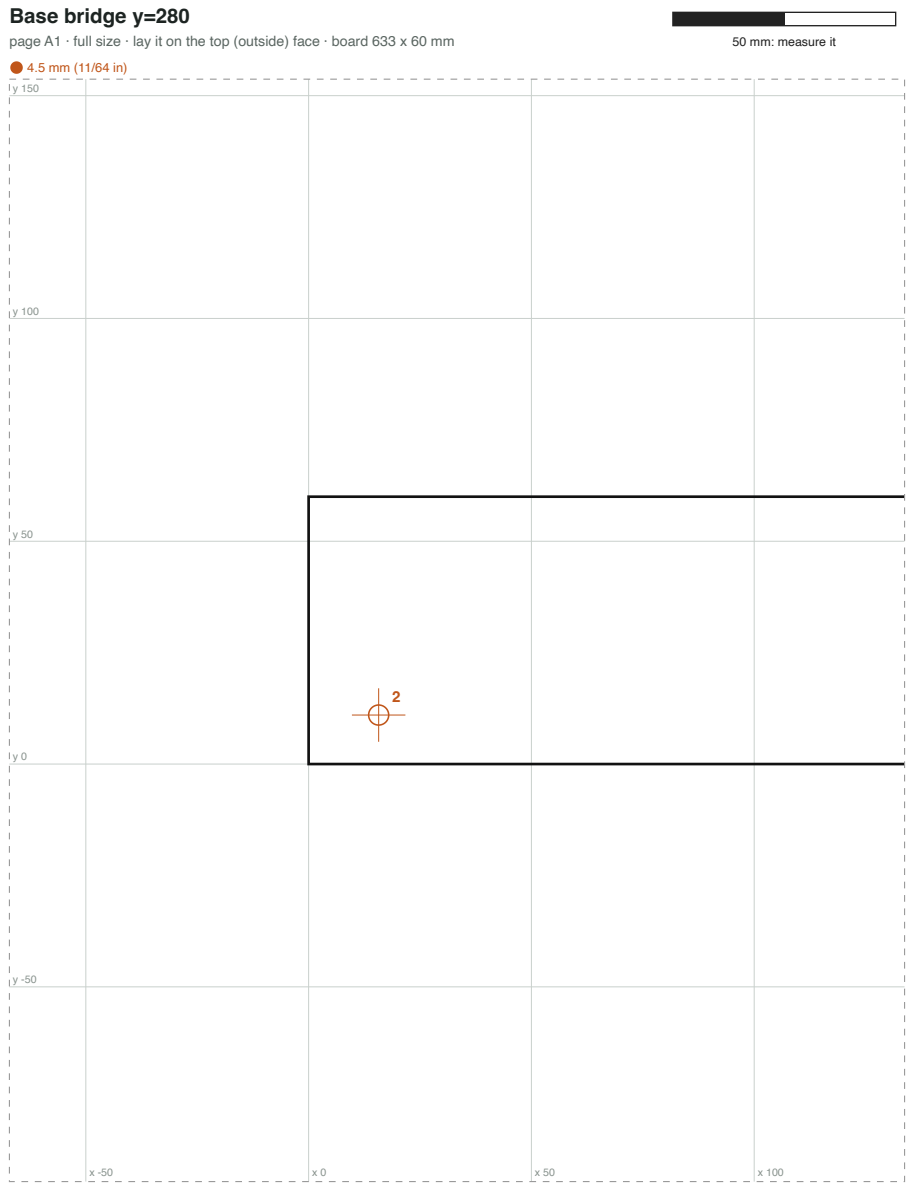
[picture p290: page 71]
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

## Base bridge y=280

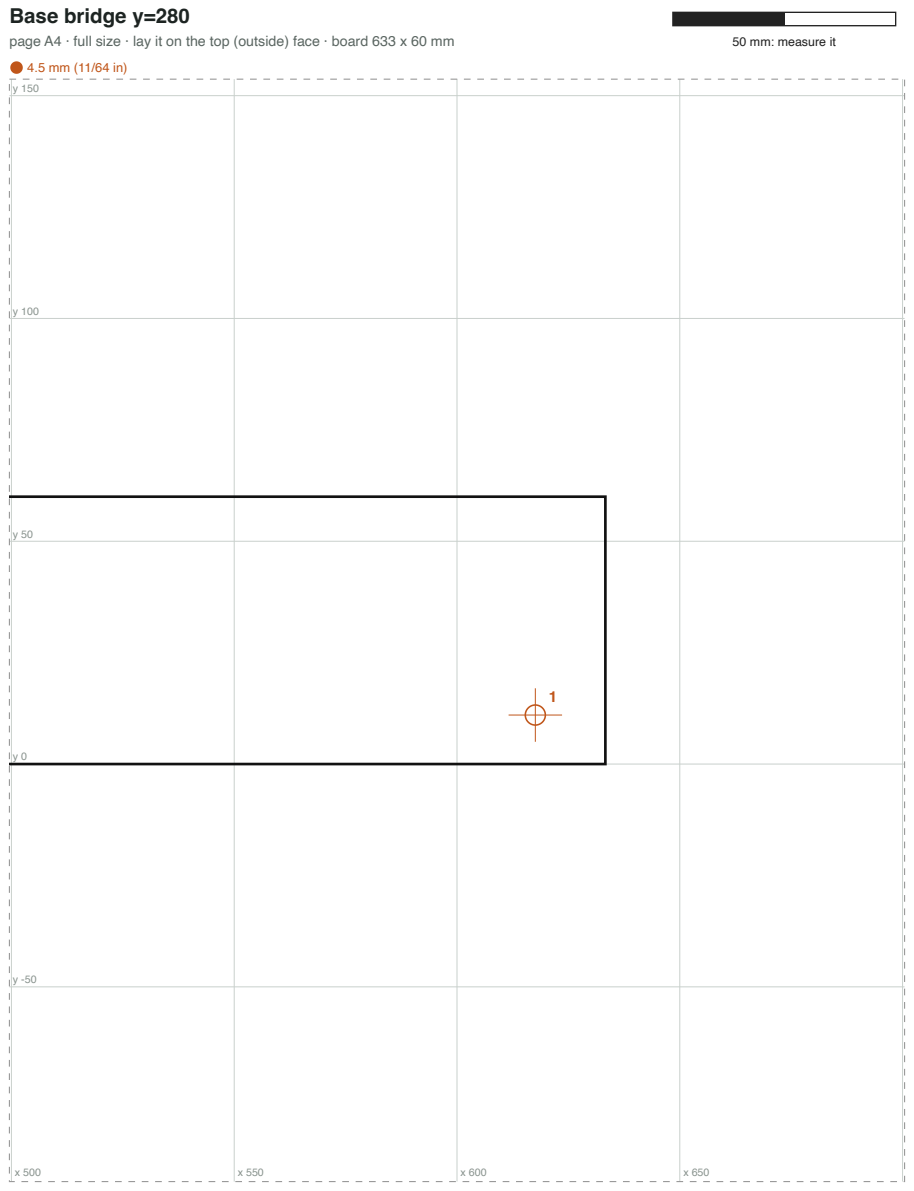
[picture p291: page 72]
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

## Base leg bridge y=-280

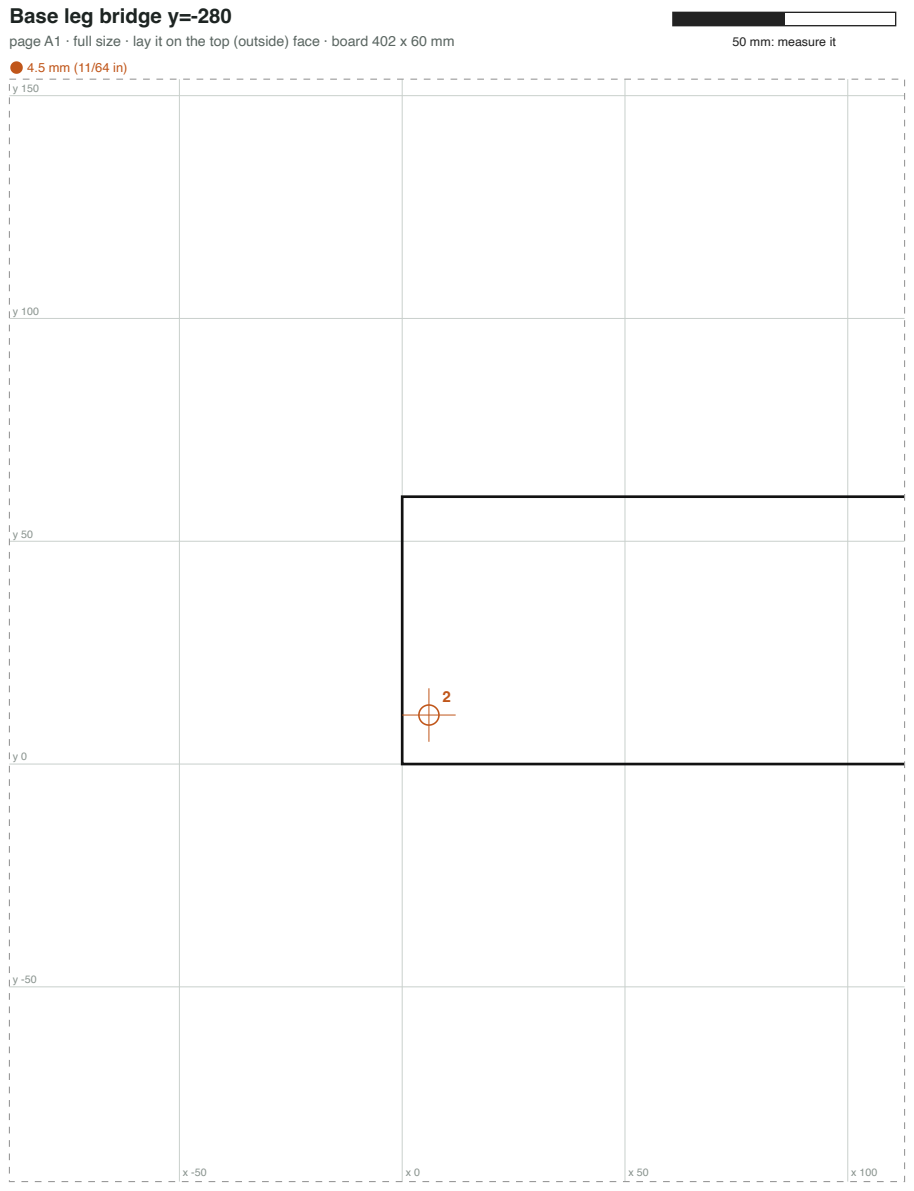
[picture p292: page 73]
page A1 · full size · lay it on the top (outside) face · board 402 x 60 mm; 50 mm: measure it

## Base leg bridge y=-280

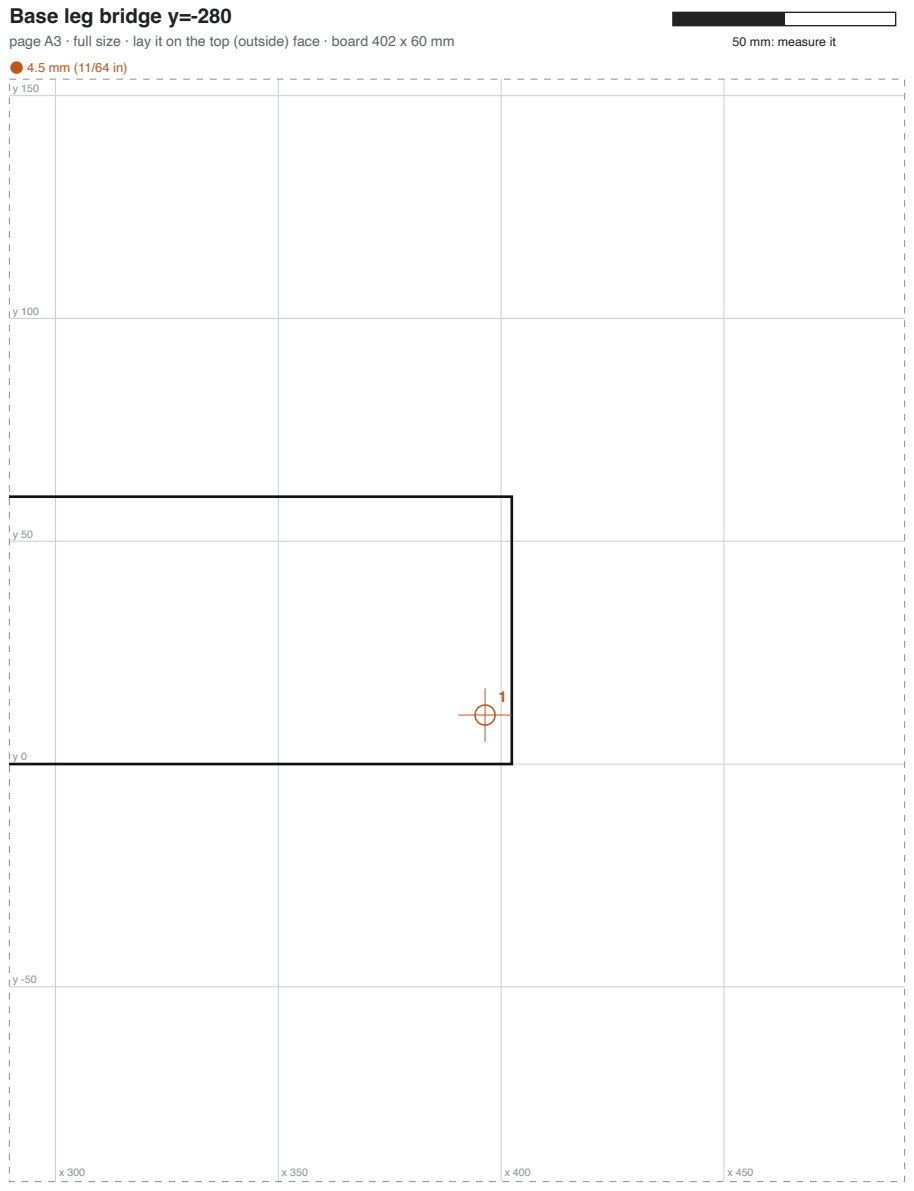
[picture p293: page 74]
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

## Base leg bridge y=318

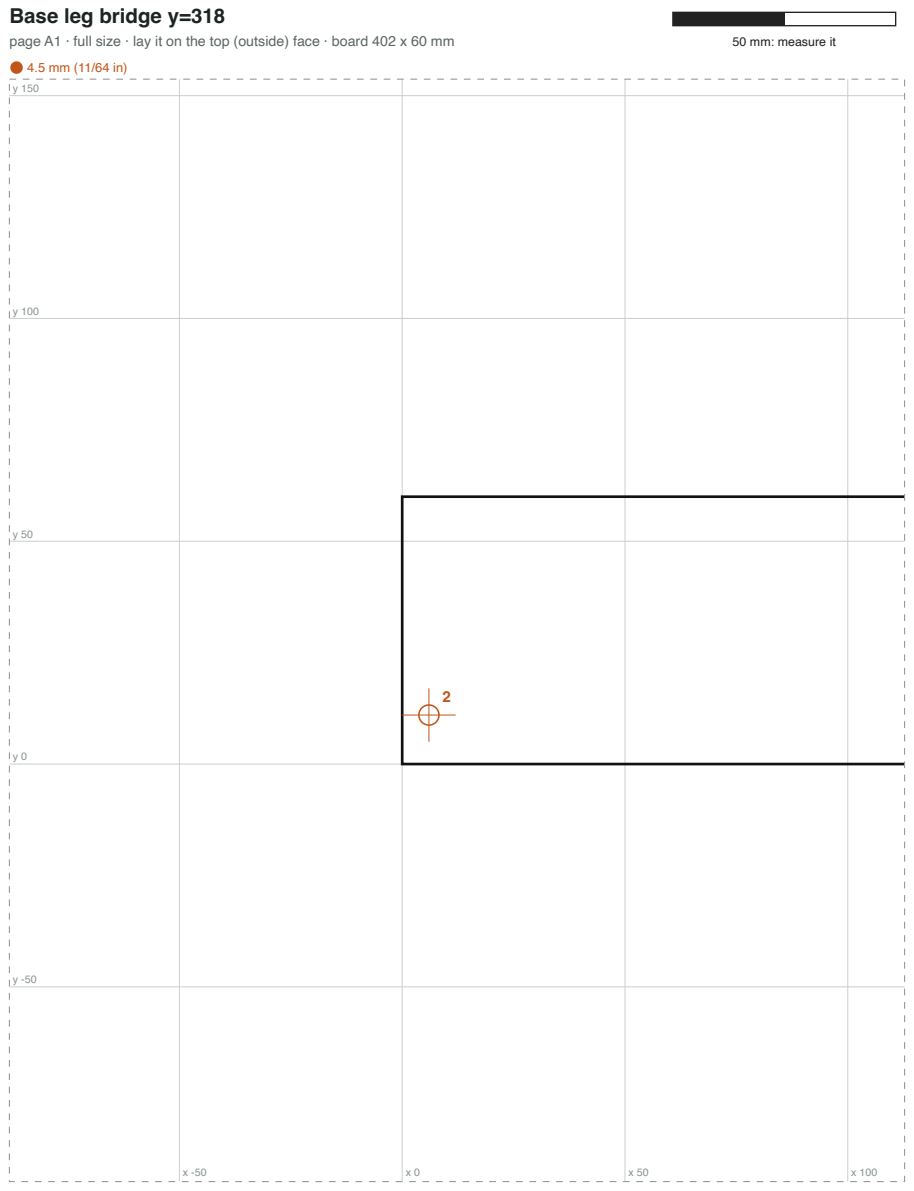
[picture p294: page 75]
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

## Base leg bridge y=318

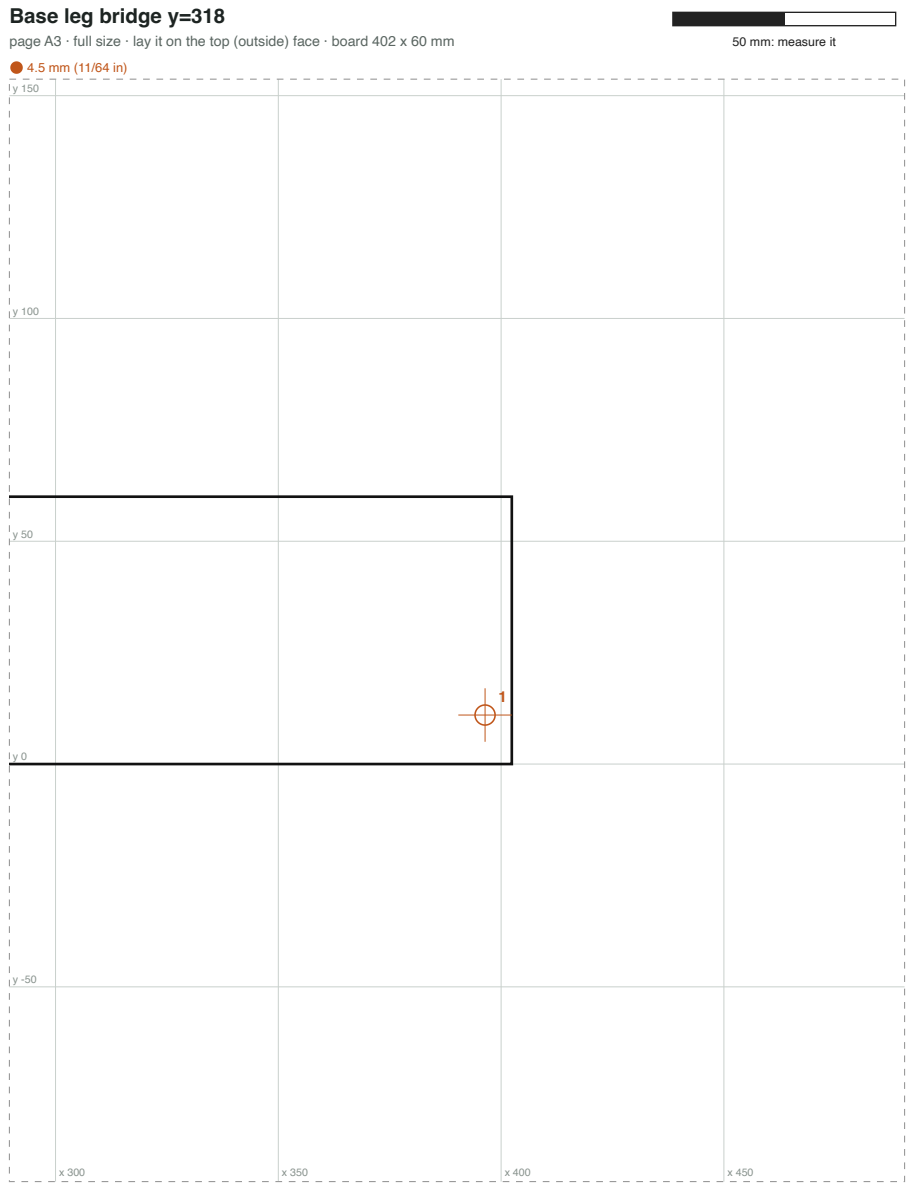
[picture p295: page 76]
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
