nolanstr/diycnc/docs/3-molds/templates/beam-templates.pdf

# Beam mold: drilling templates

DIY CNC epoxy-granite mill · October 2026 · full size, US Letter

## Printing

1. Print at Actual size / 100 %. Turn off "Fit to page" and "Scale to fit". Letter paper, portrait.
2. Measure the square below: it must be 100 mm (and the bar on every page 50 mm). If it is off by more than 1 mm, fix the scaling and print again.
3. Only pages with holes are printed. Every page has a grid labeled in the board's own millimeters, from the bottom-left corner as you look at the marked face, so you can place any page on its own.

## Marking a board

1. Lay the board on the bench with the face named at the top of its pages up (the cast face, or the top face for bridges and cleats).
2. Start with the page that has the board's corner on it: line its printed edges up with the board's edges and tape it down. Add the next pages overlapping by about 12 mm, with the grid lines on top of each other; trim one edge if it helps. Where a page shows no board edge, measure to a labeled grid line with a square instead.
3. Push an awl or a center punch through every crosshair. The circle is the finished hole size, the number is the hole's number in the guide's table, and the color is its size: the legend at the top of each page gives the drill.
4. Pull the paper off, and drill from the marked face (clamp a scrap underneath). Drill a 1/8 in pilot first for anything 13 mm or bigger; the 63.5 mm holes are a 2-1/2 in hole saw.
5. Walls: pencil the dashed pour line (25 mm below the top edge) on the cast face, or mark it later with the printed pour-line gauge. The casting is filled to this line.
6. Boards marked "x2" are the same board twice: mark both from one print.

## Pages

Board | Qty | Pages | Holes
Beam floor | 1 | 2-9 (8) | 24
Beam top wall | 1 | 10-12 (3) | 15
Beam bottom wall | 1 | 13-14 (2) | 12
Beam end wall, left | 1 | 15-15 (1) | 2
B | d | ll i h | 1 | 16 16 (1) | 2

100 mm

## Beam floor

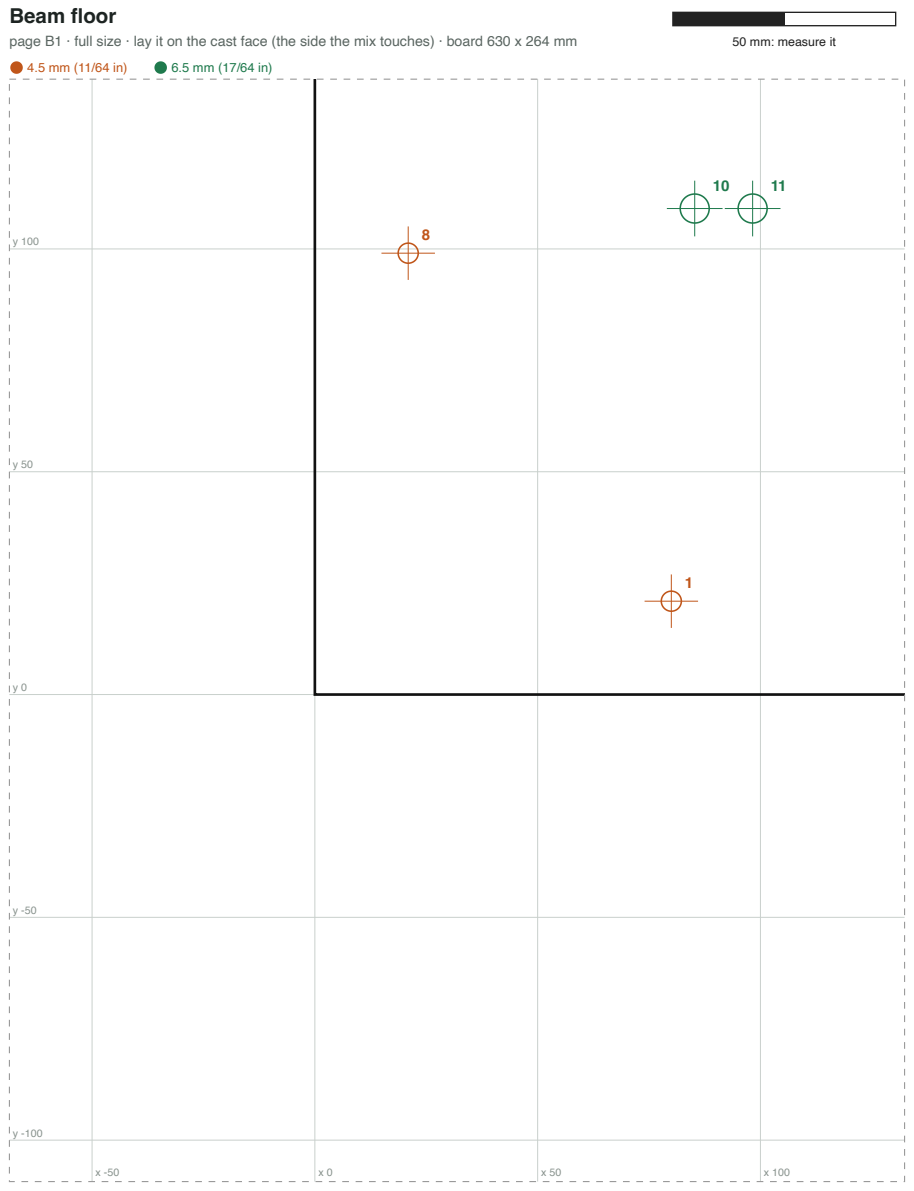
[picture p296: page 2]
page B1 · full size · lay it on the cast face (the side the mix touches) · board 630 x 264 mm; 50 mm: measure it

## Beam floor

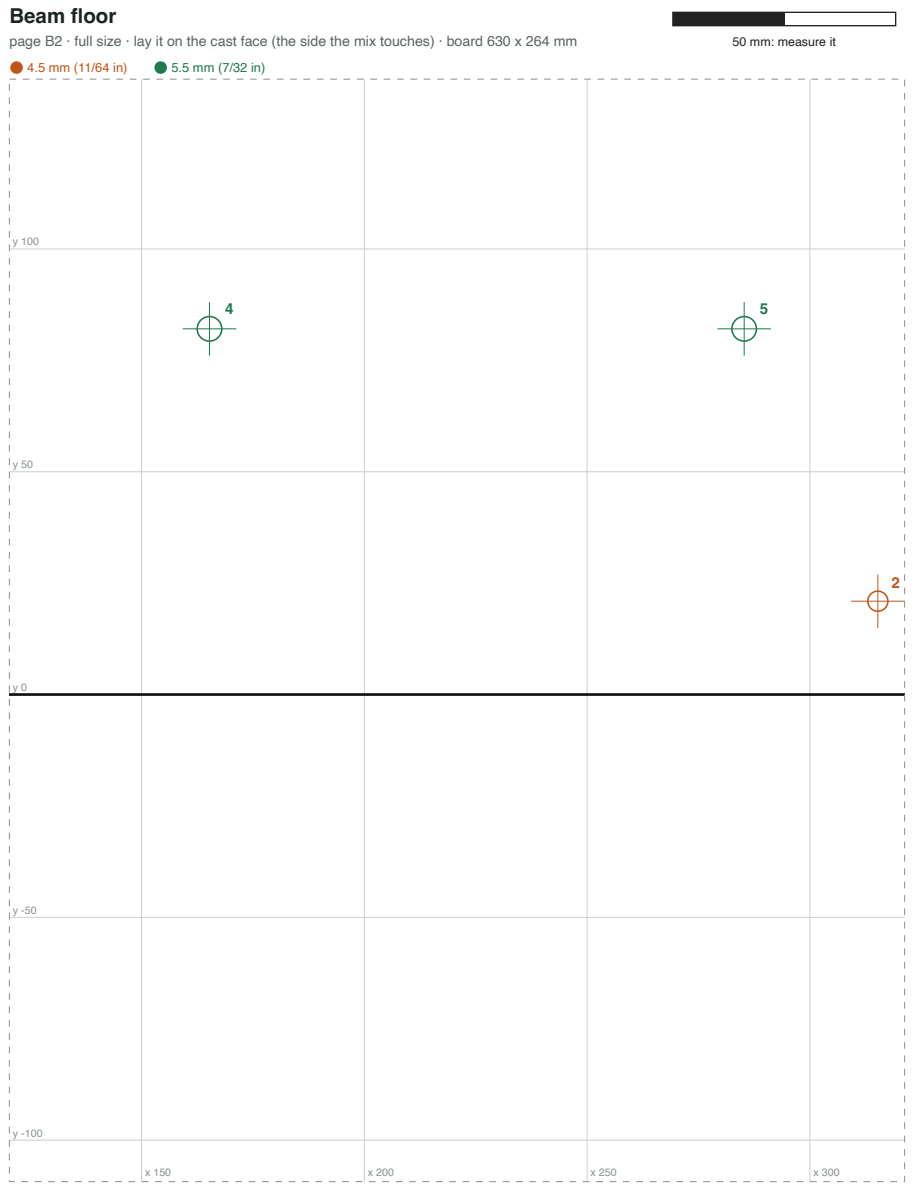
[picture p297: page 3]
page B2 · full size · lay it on the cast face (the side the mix touches) · board 630 x 264 mm; 50 mm: measure it

## Beam floor

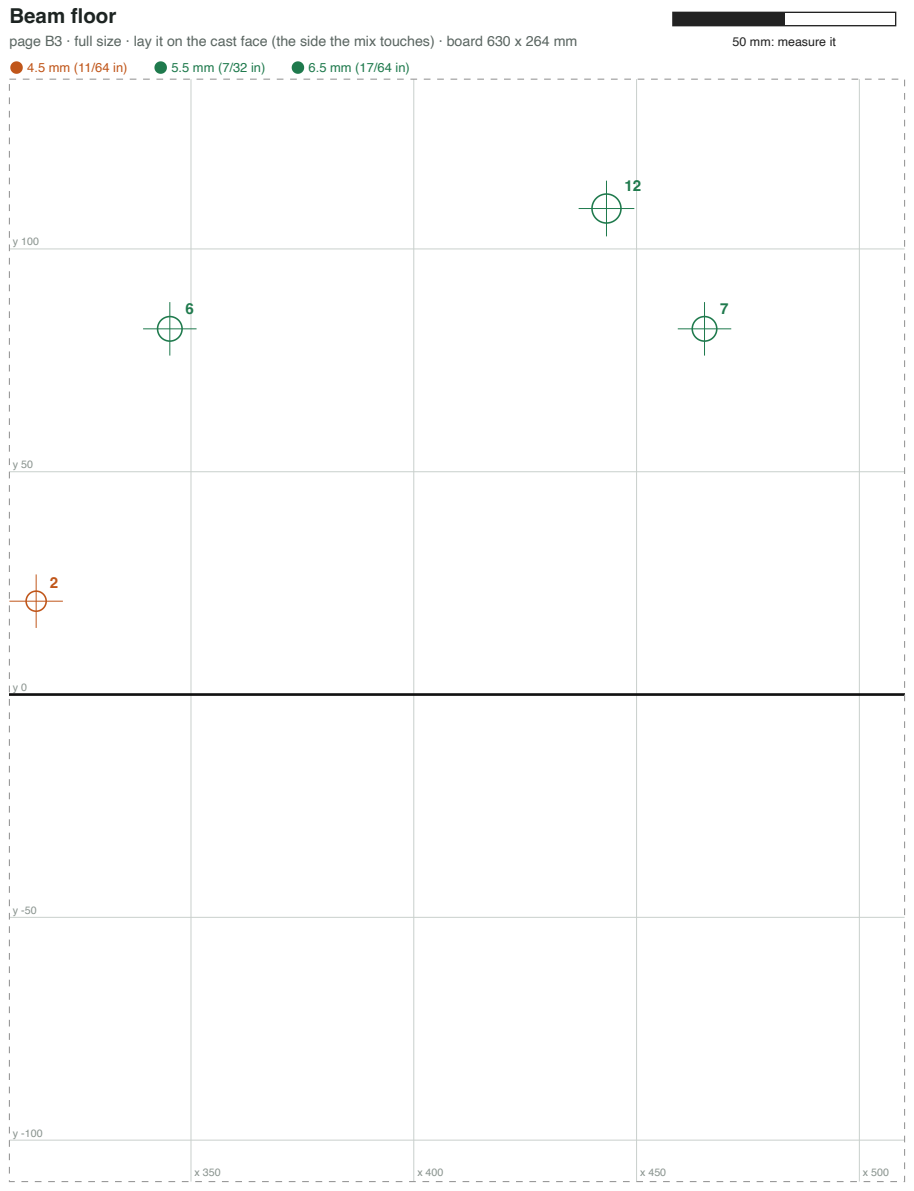
[picture p298: page 4]
page B3 · full size · lay it on the cast face (the side the mix touches) · board 630 x 264 mm; 50 mm: measure it

## Beam floor

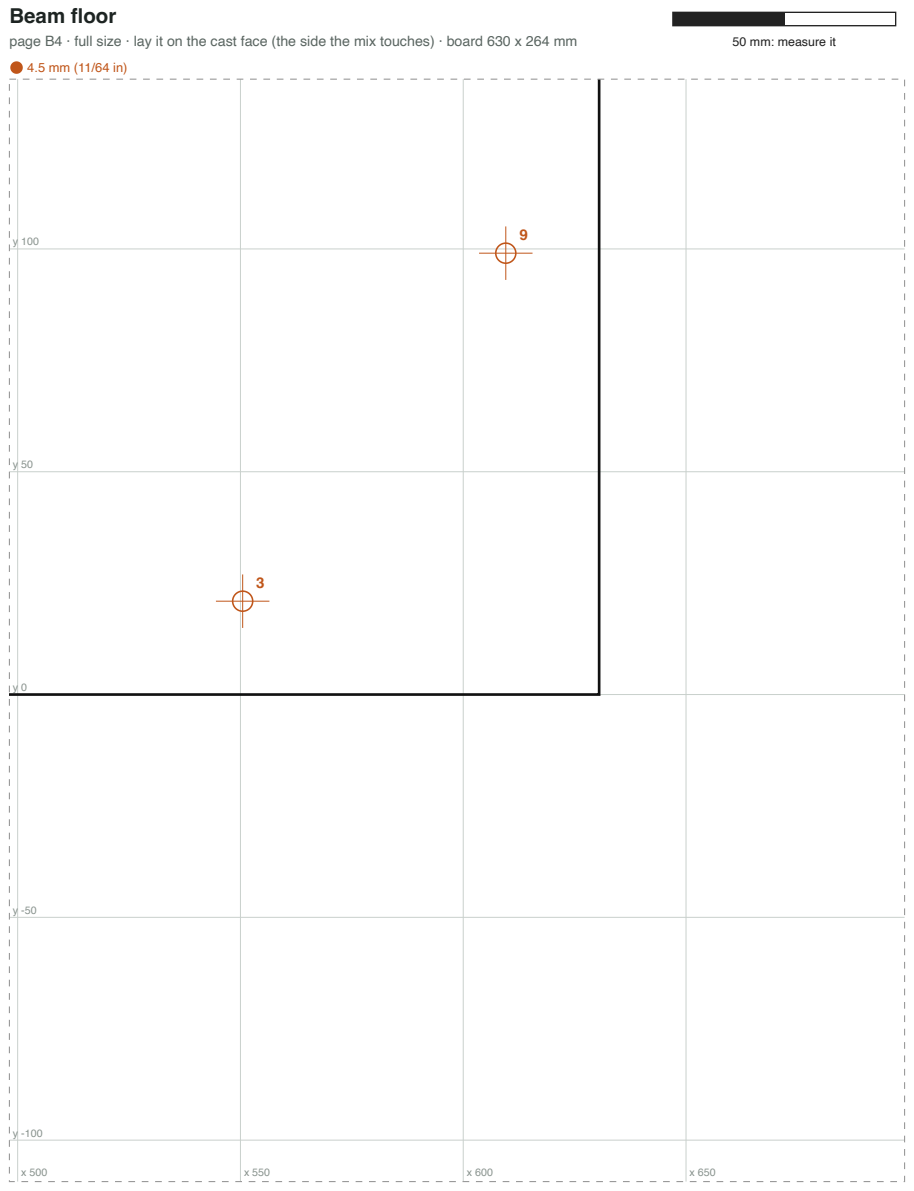
[picture p299: page 5]
page B4 · full size · lay it on the cast face (the side the mix touches) · board 630 x 264 mm; 50 mm: measure it

## Beam floor

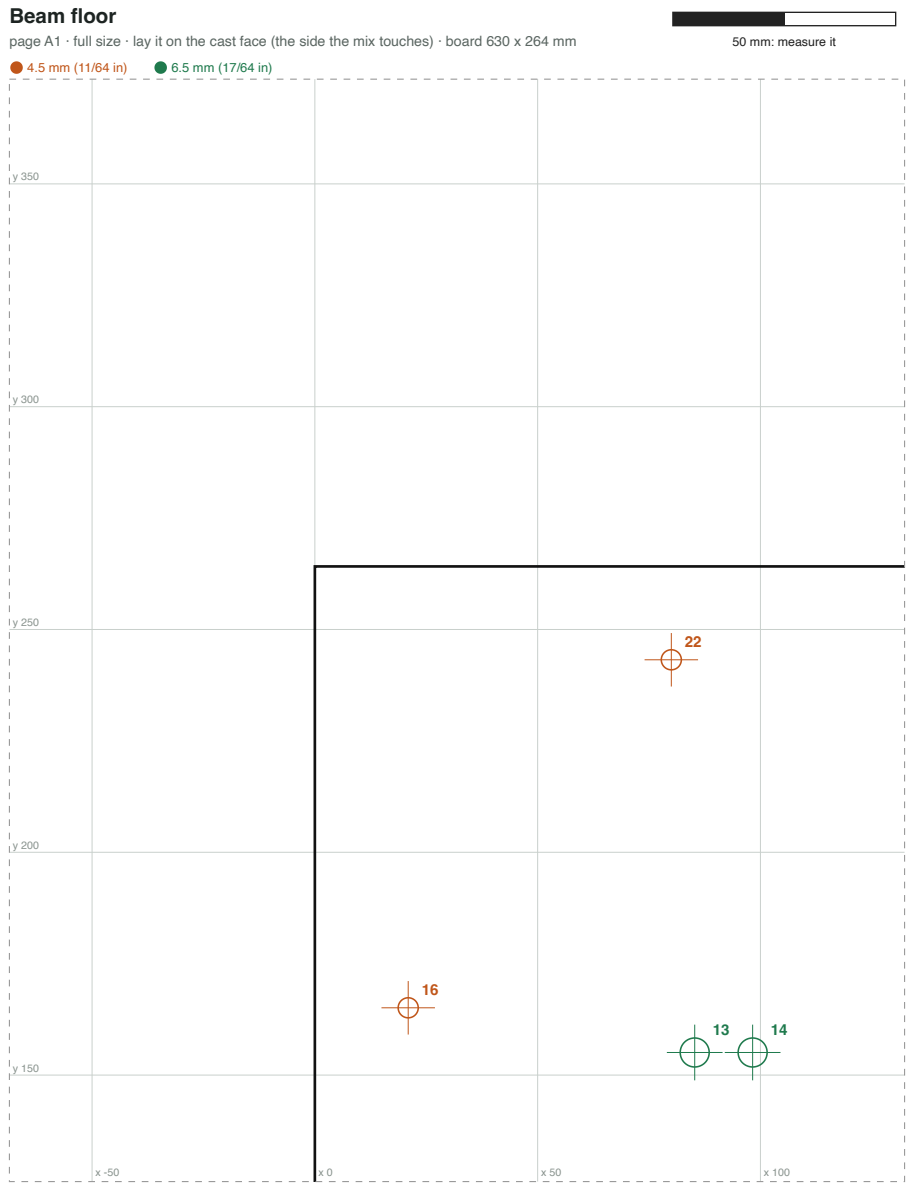
[picture p300: page 6]
page A1 · full size · lay it on the cast face (the side the mix touches) · board 630 x 264 mm; 50 mm: measure it

## Beam floor

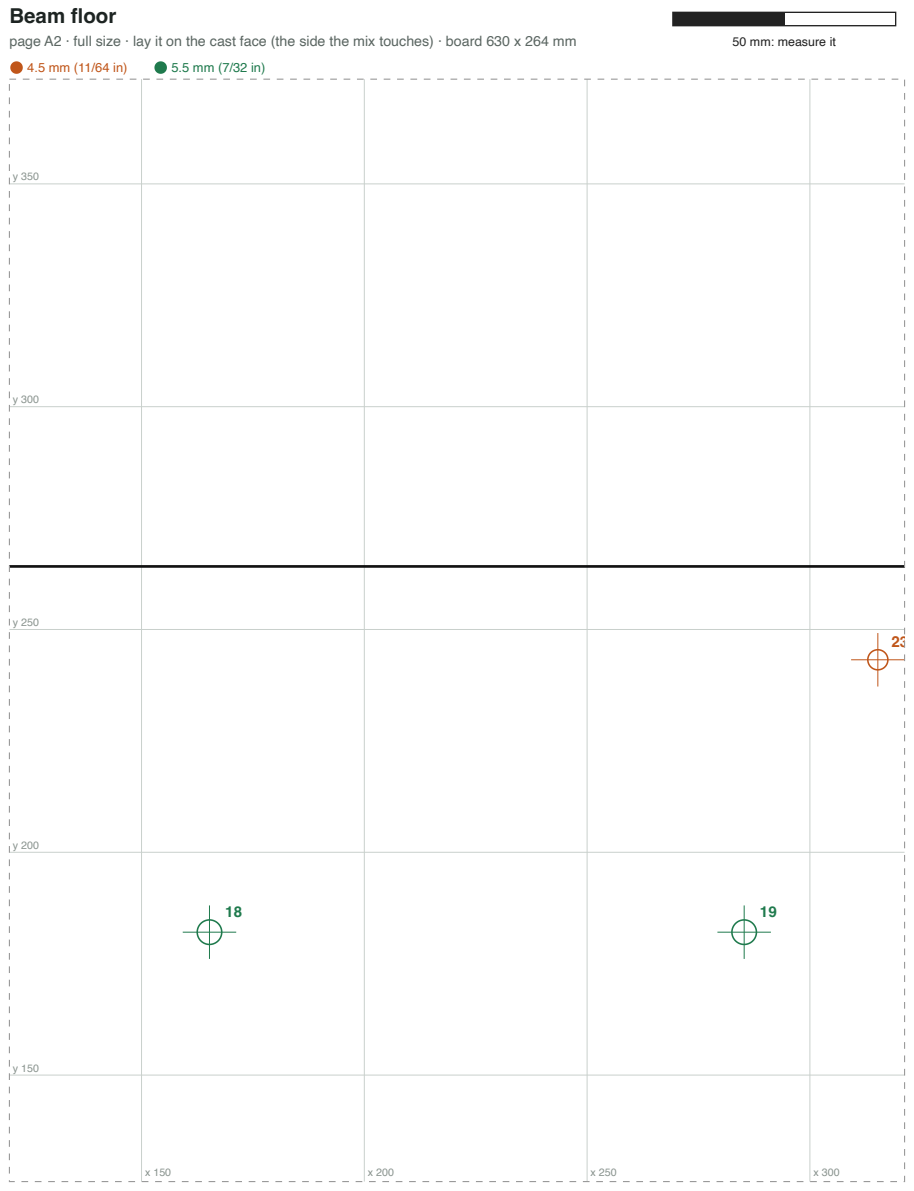
[picture p301: page 7]
page A2 · full size · lay it on the cast face (the side the mix touches) · board 630 x 264 mm; 50 mm: measure it

## Beam floor

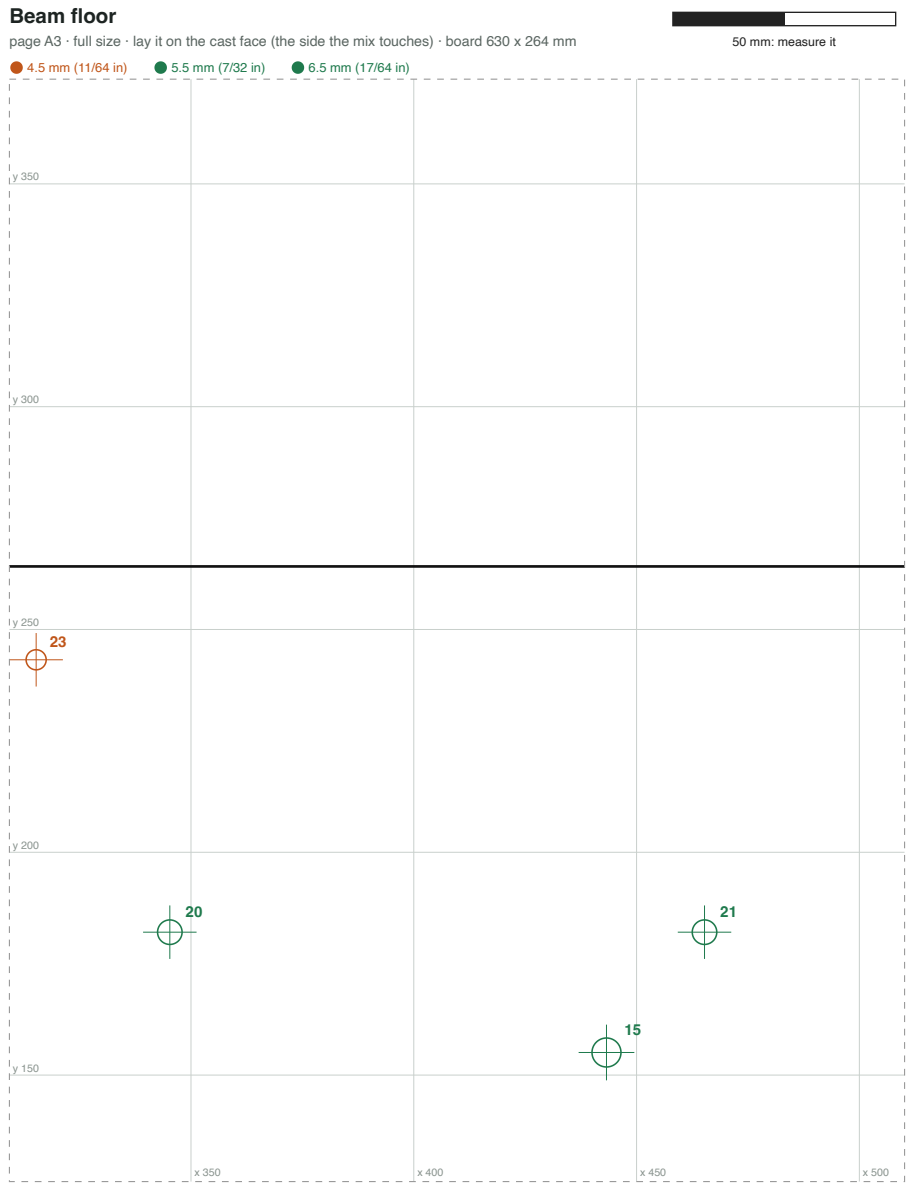
[picture p302: page 8]
page A3 · full size · lay it on the cast face (the side the mix touches) · board 630 x 264 mm; 50 mm: measure it

## Beam floor

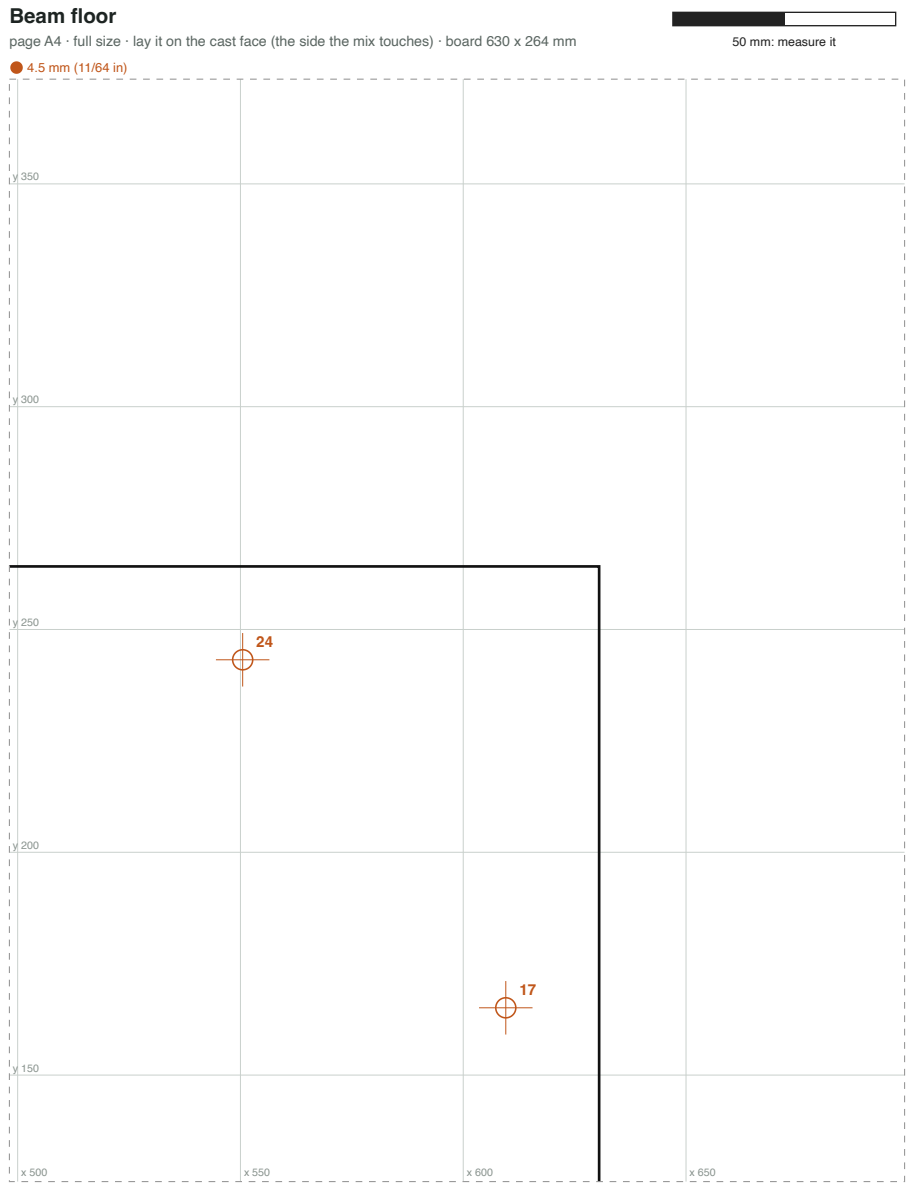
[picture p303: page 9]
page A4 · full size · lay it on the cast face (the side the mix touches) · board 630 x 264 mm; 50 mm: measure it

## Beam top wall

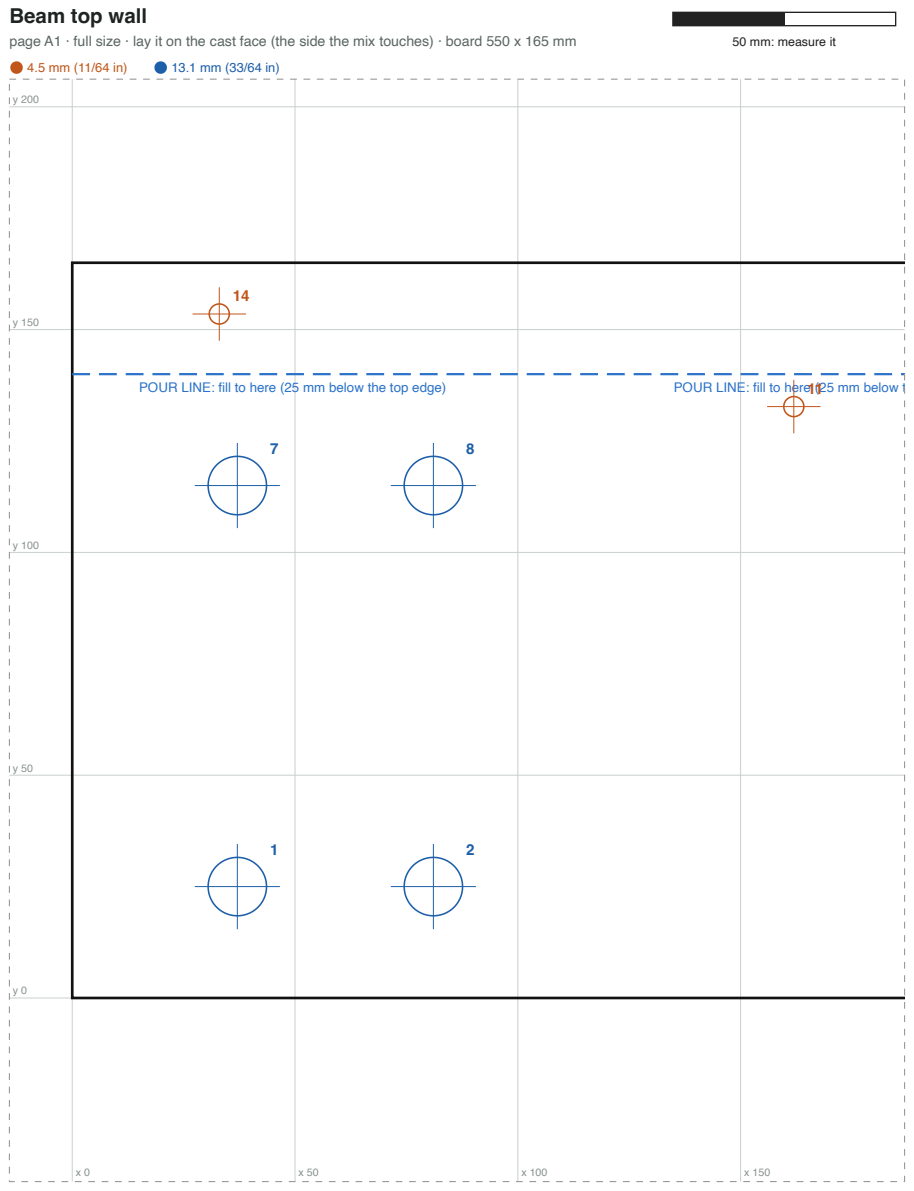
[picture p304: page 10]
page A1 · full size · lay it on the cast face (the side the mix touches) · board 550 x 165 mm; 50 mm: measure it; POUR LINE: fill to here (25 mm below the top edge); POUR LINE: fill to here (25 mm below t

## Beam top wall

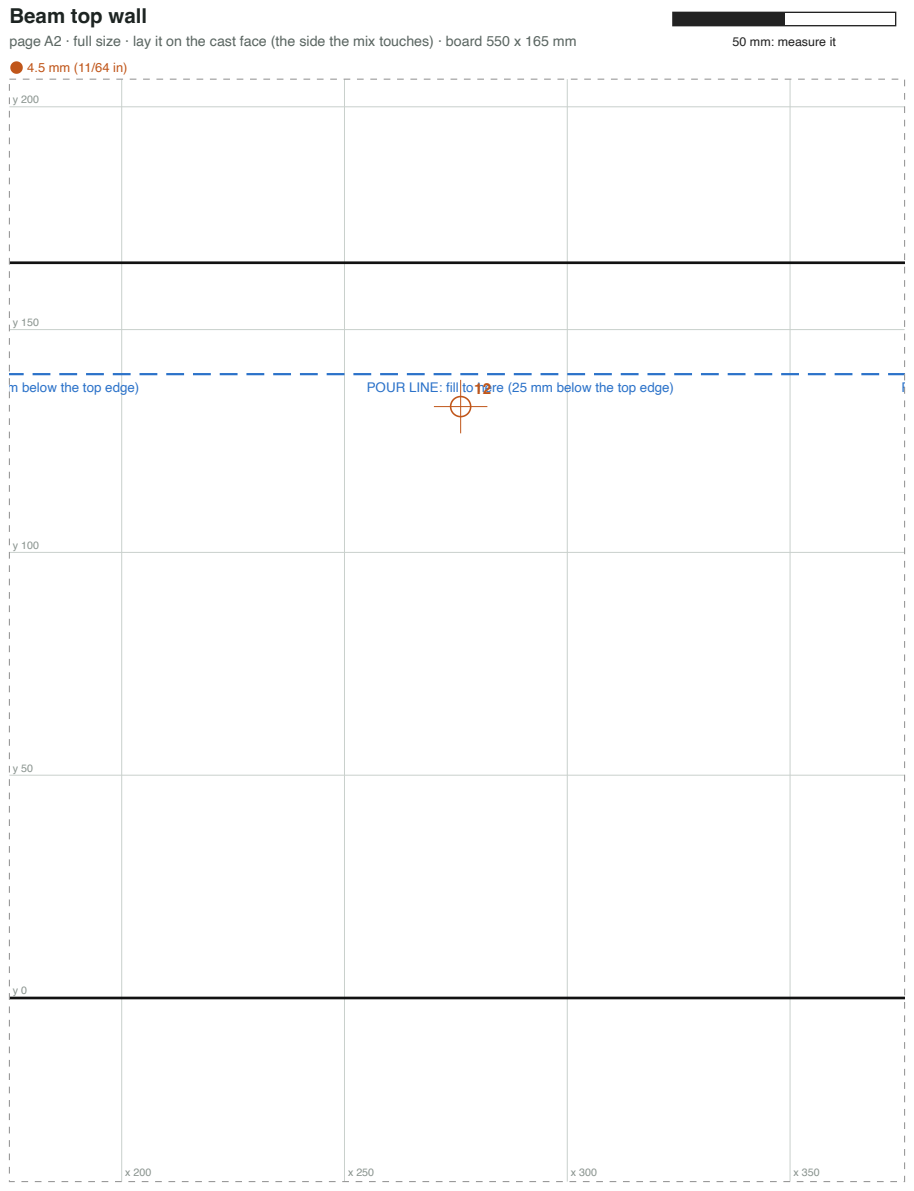
[picture p305: page 11]
page A2 · full size · lay it on the cast face (the side the mix touches) · board 550 x 165 mm; 50 mm: measure it; m below the top edge); POUR LINE: fill to1h2ere (25 mm below the top edge)

## Beam top wall

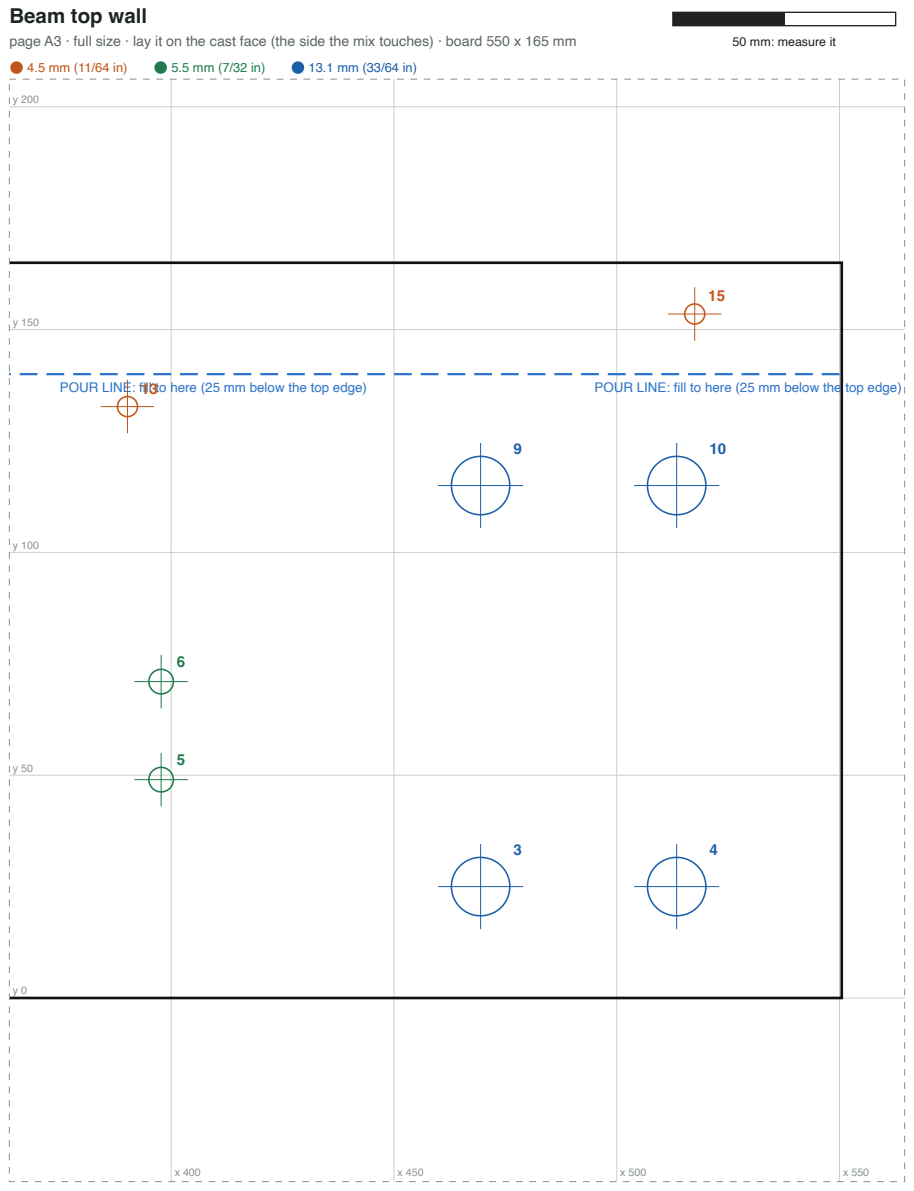
[picture p306: page 12]
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

## Beam bottom wall

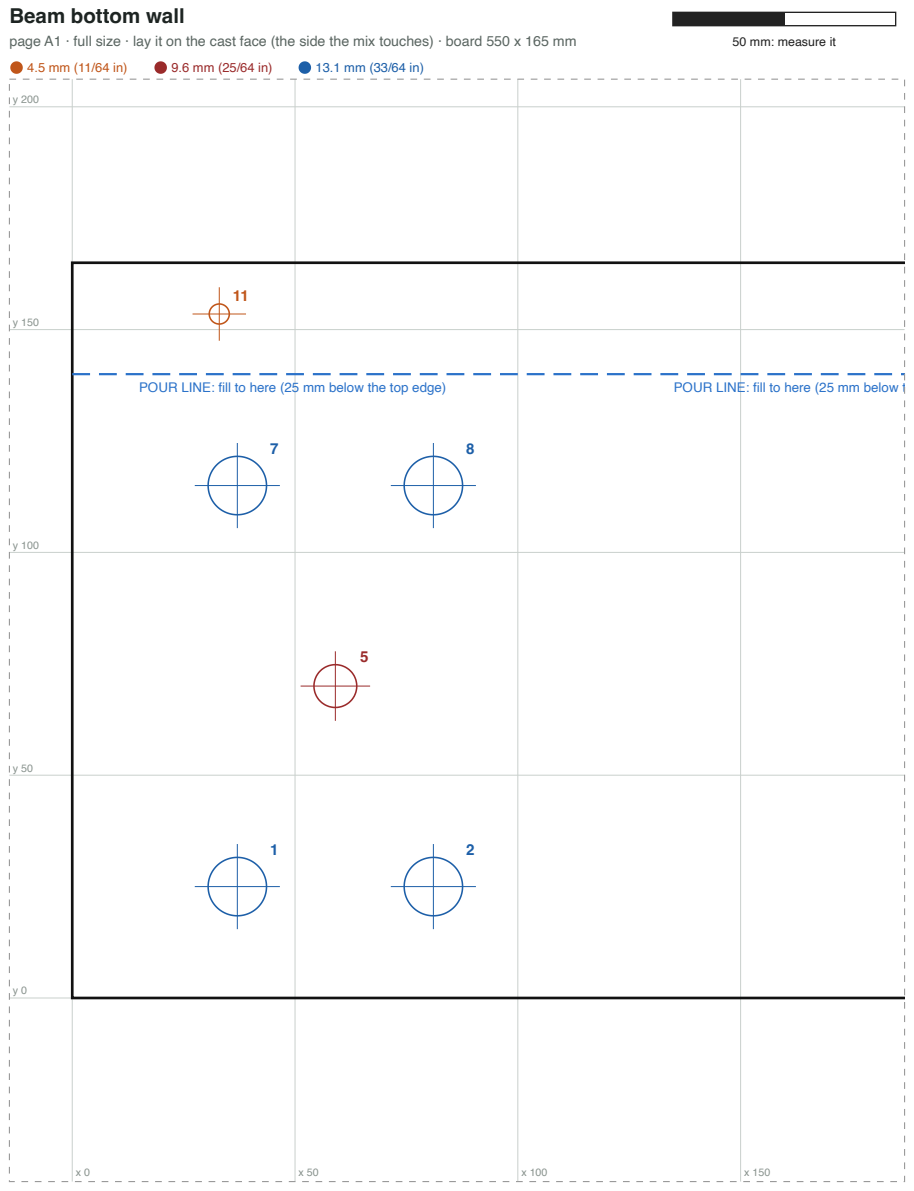
[picture p307: page 13]
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

## Beam bottom wall

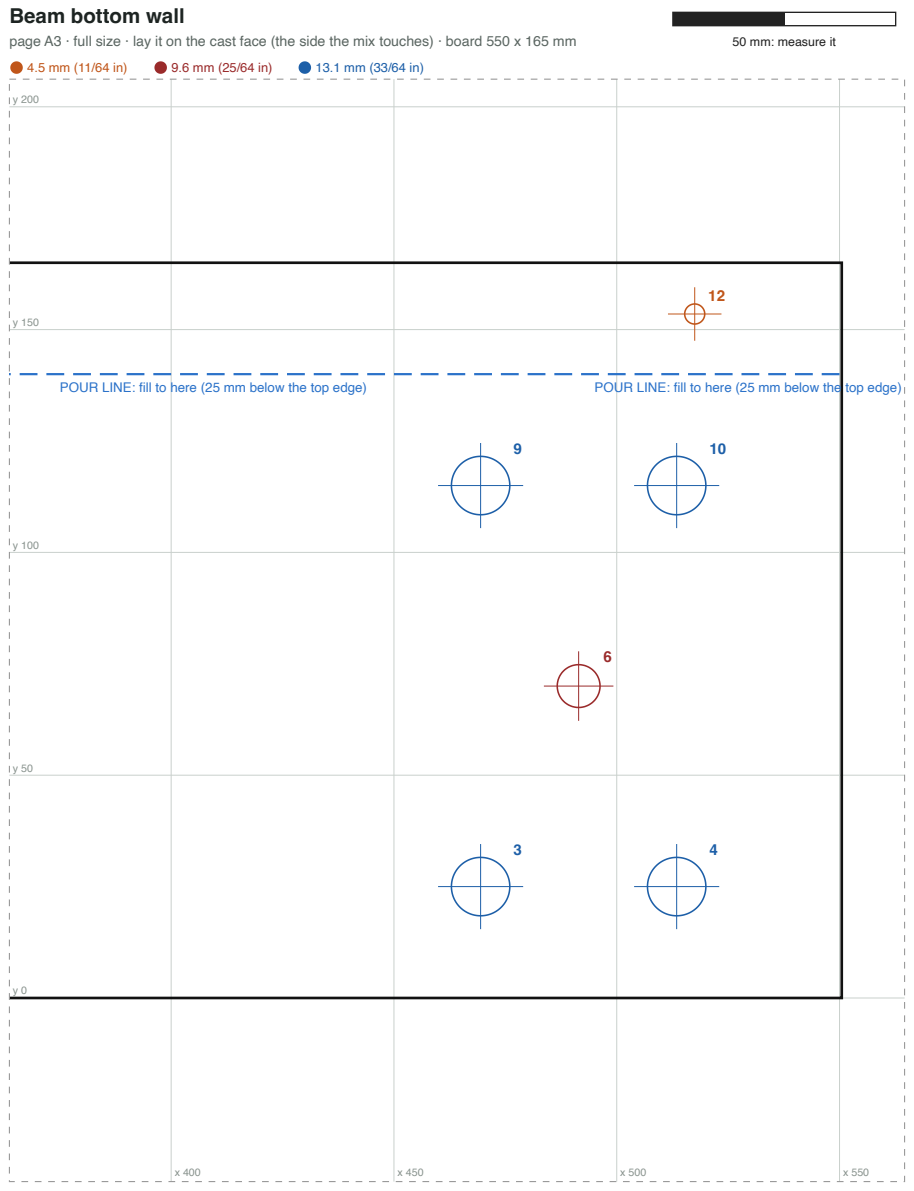
[picture p308: page 14]
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

## Beam end wall, left

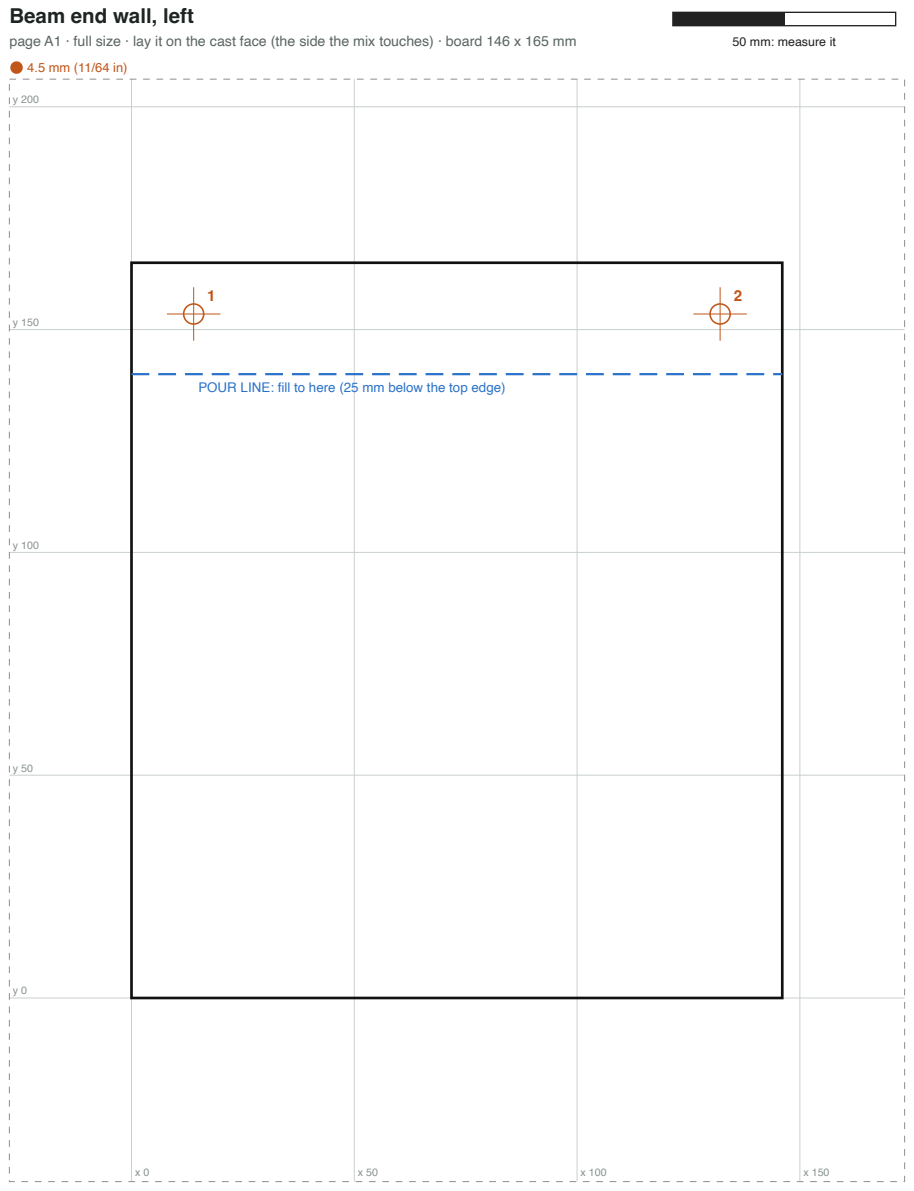
[picture p309: page 15]
page A1 · full size · lay it on the cast face (the side the mix touches) · board 146 x 165 mm; 50 mm: measure it

POUR LINE: fill to here (25 mm below the top edge)

## Beam end wall, right

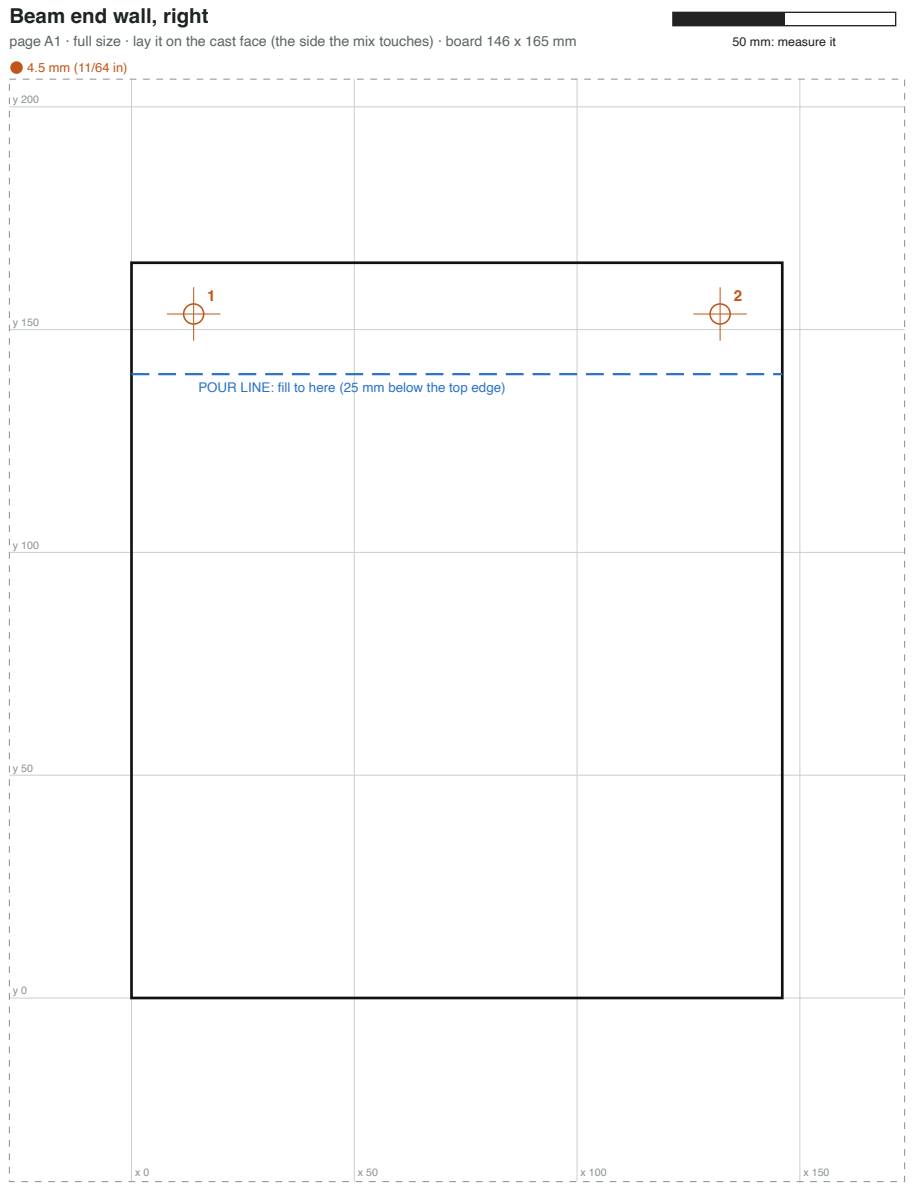
[picture p310: page 16]
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

POUR LINE: fill to here (25 mm below the top edge)

## Beam cleat, top

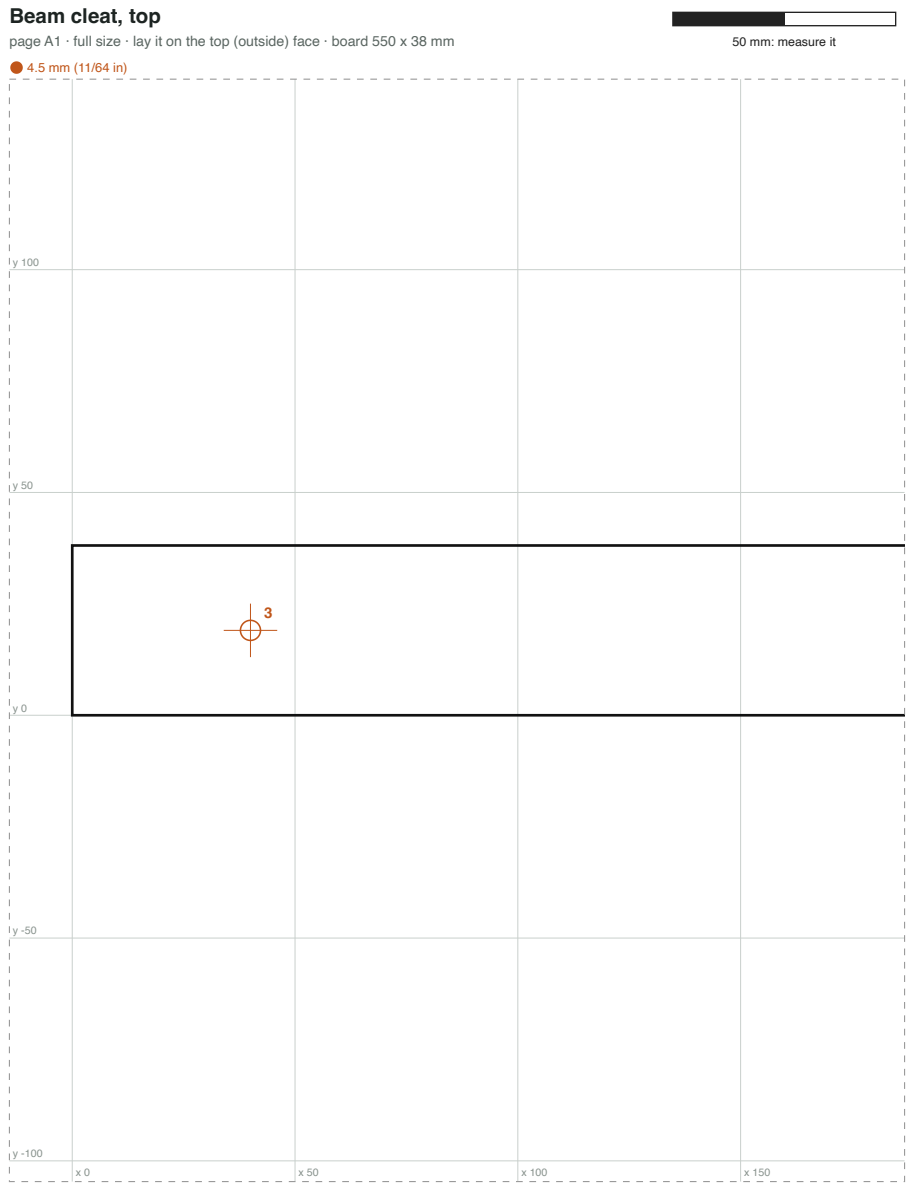
[picture p311: page 17]
page A1 · full size · lay it on the top (outside) face · board 550 x 38 mm; 50 mm: measure it

## Beam cleat, top

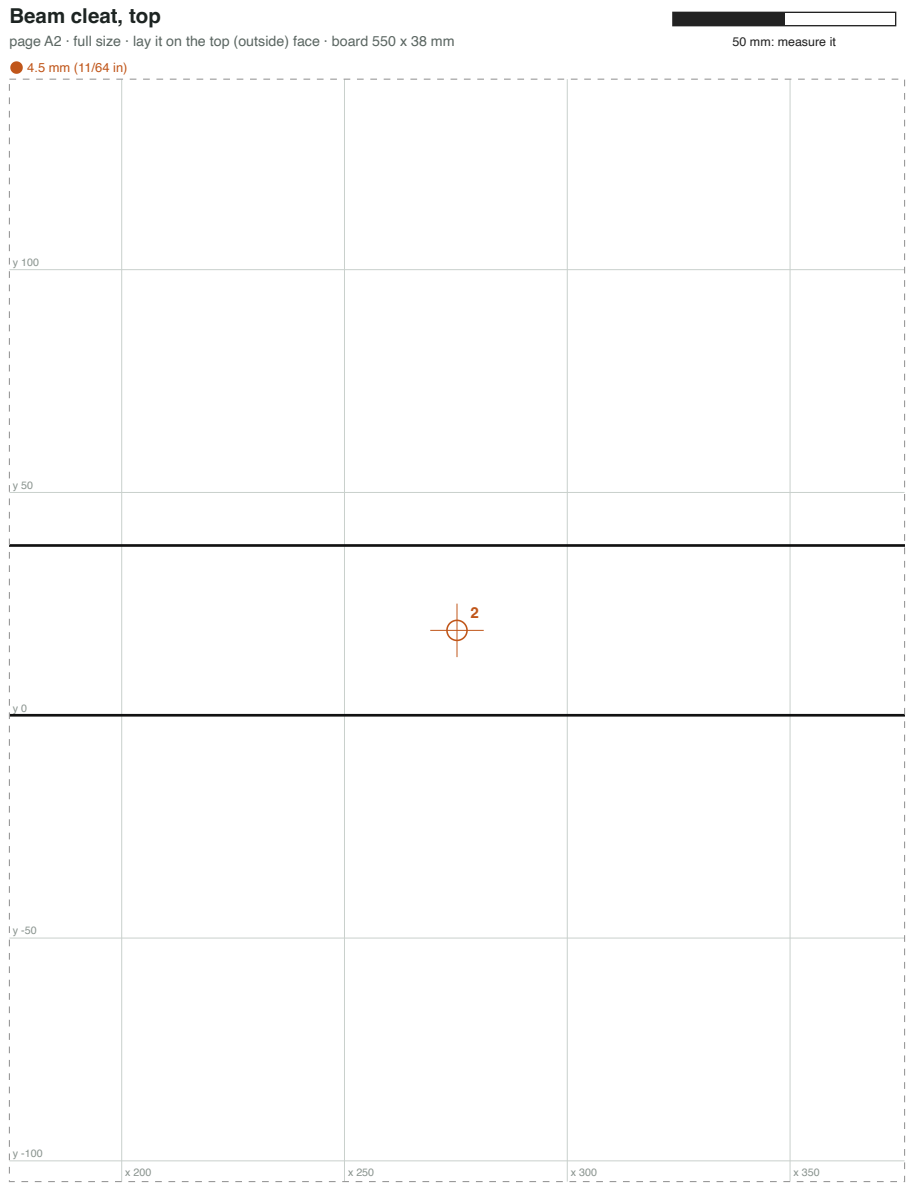
[picture p312: page 18]
page A2 · full size · lay it on the top (outside) face · board 550 x 38 mm; 50 mm: measure it

## Beam cleat, top

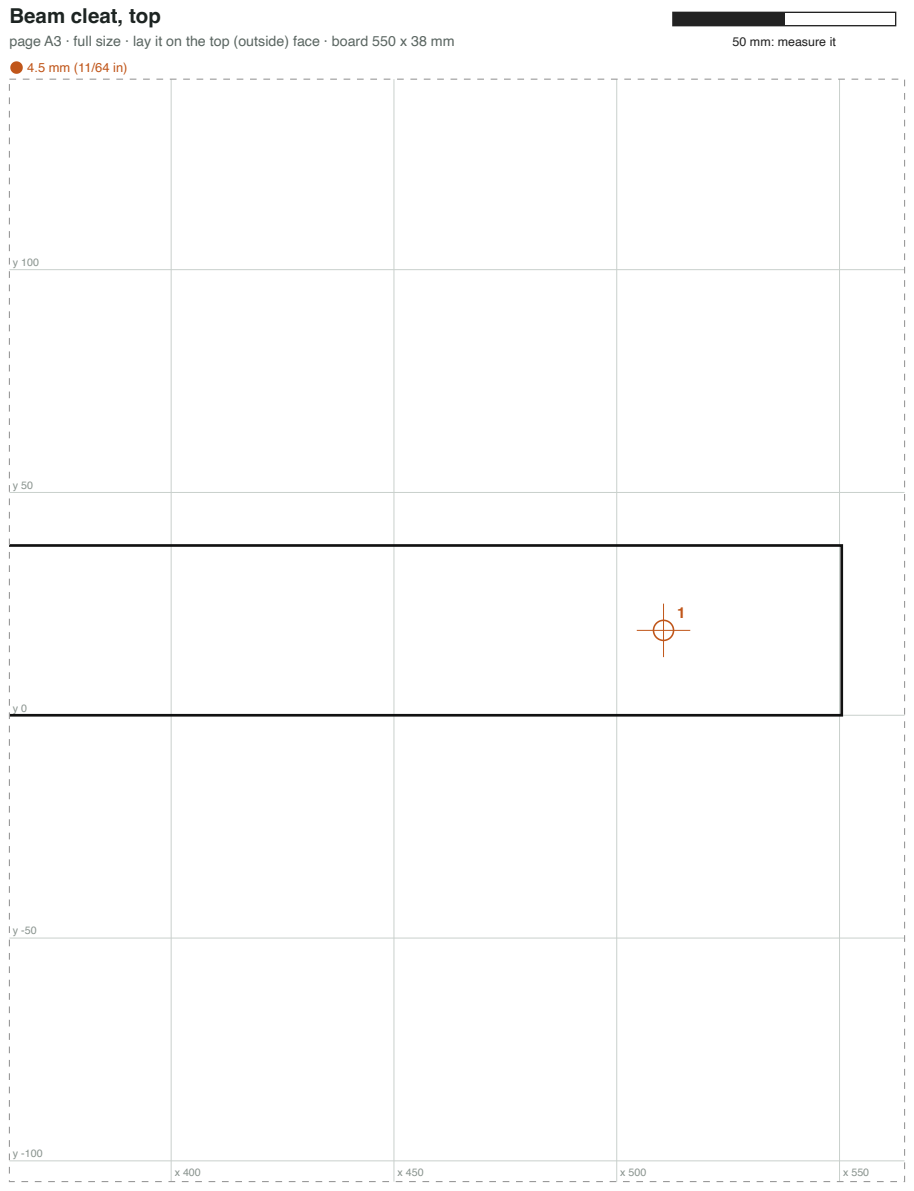
[picture p313: page 19]
page A3 · full size · lay it on the top (outside) face · board 550 x 38 mm; 50 mm: measure it

## Beam cleat, bottom

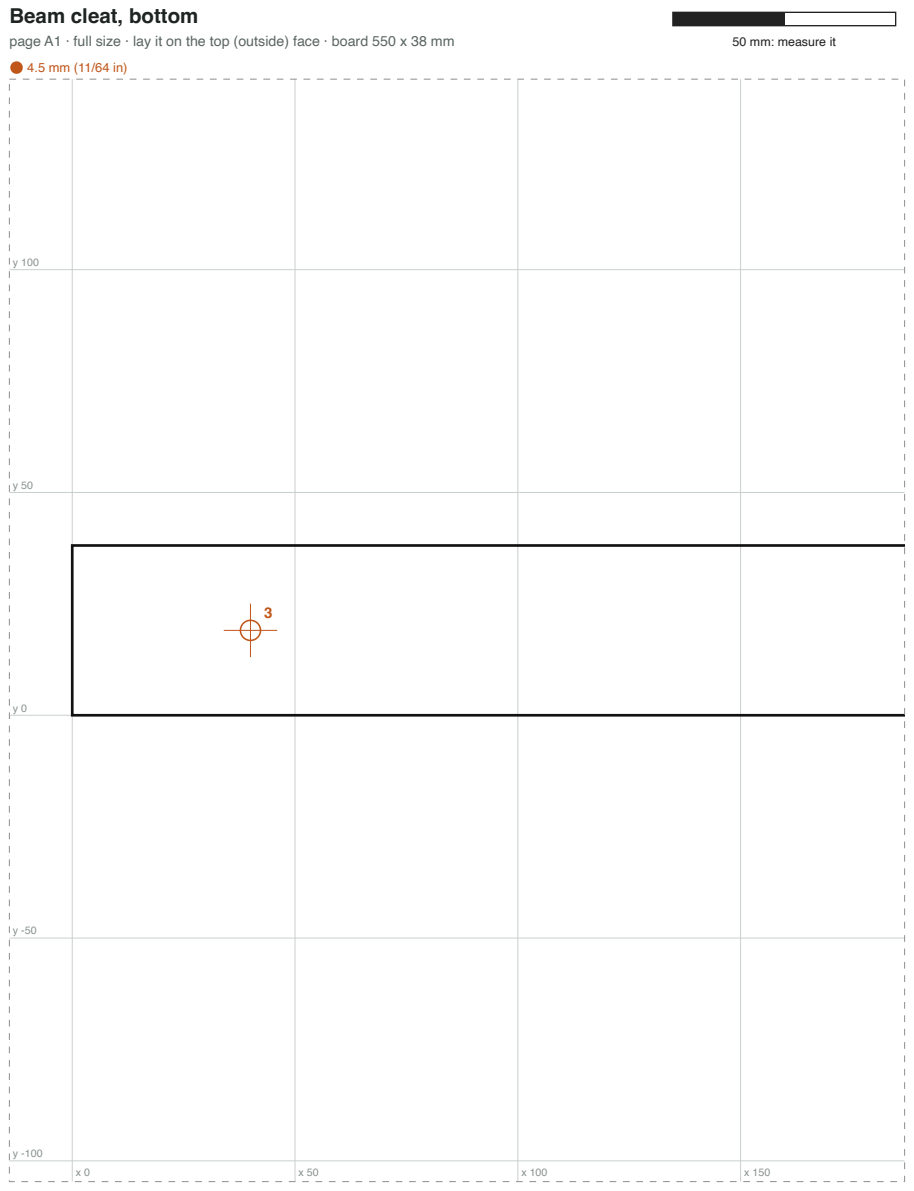
[picture p314: page 20]
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

## Beam cleat, bottom

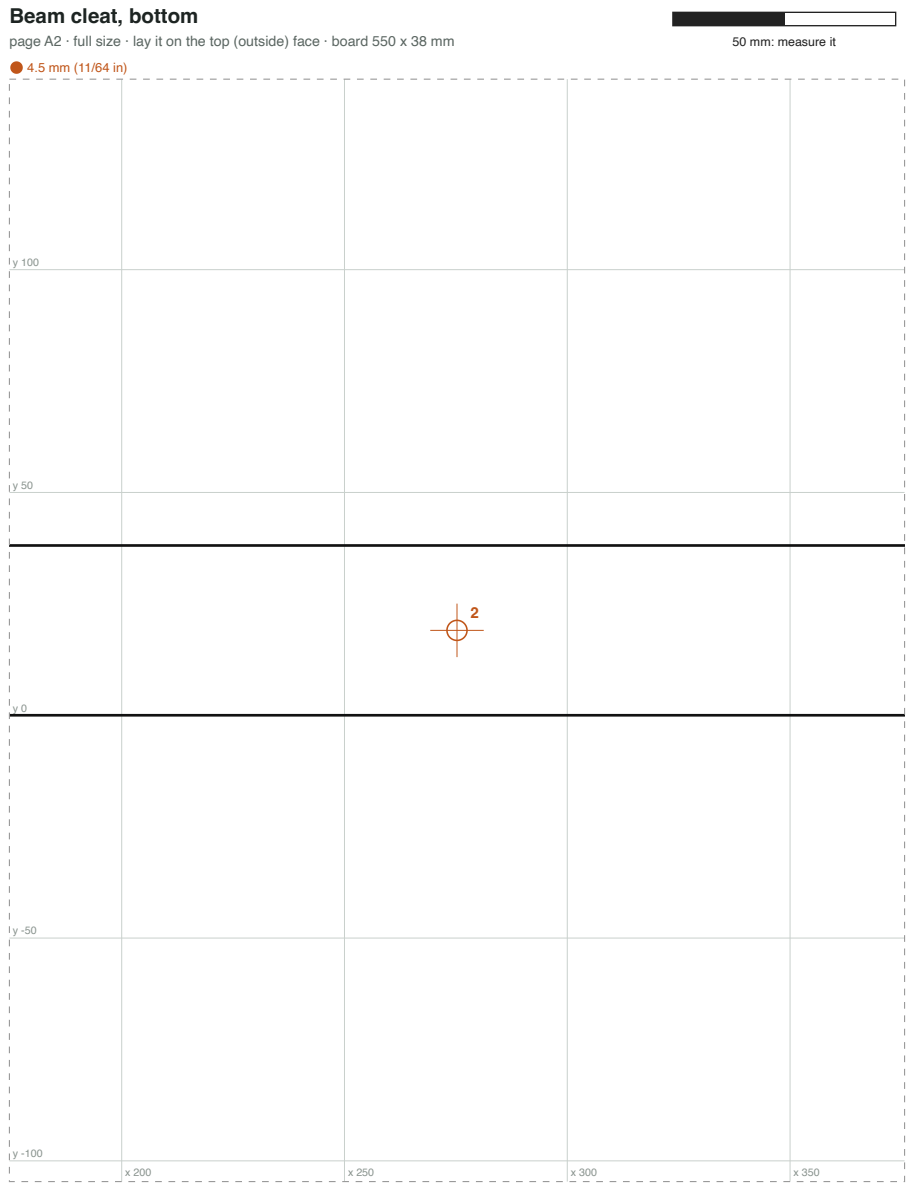
[picture p315: page 21]
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

## Beam cleat, bottom

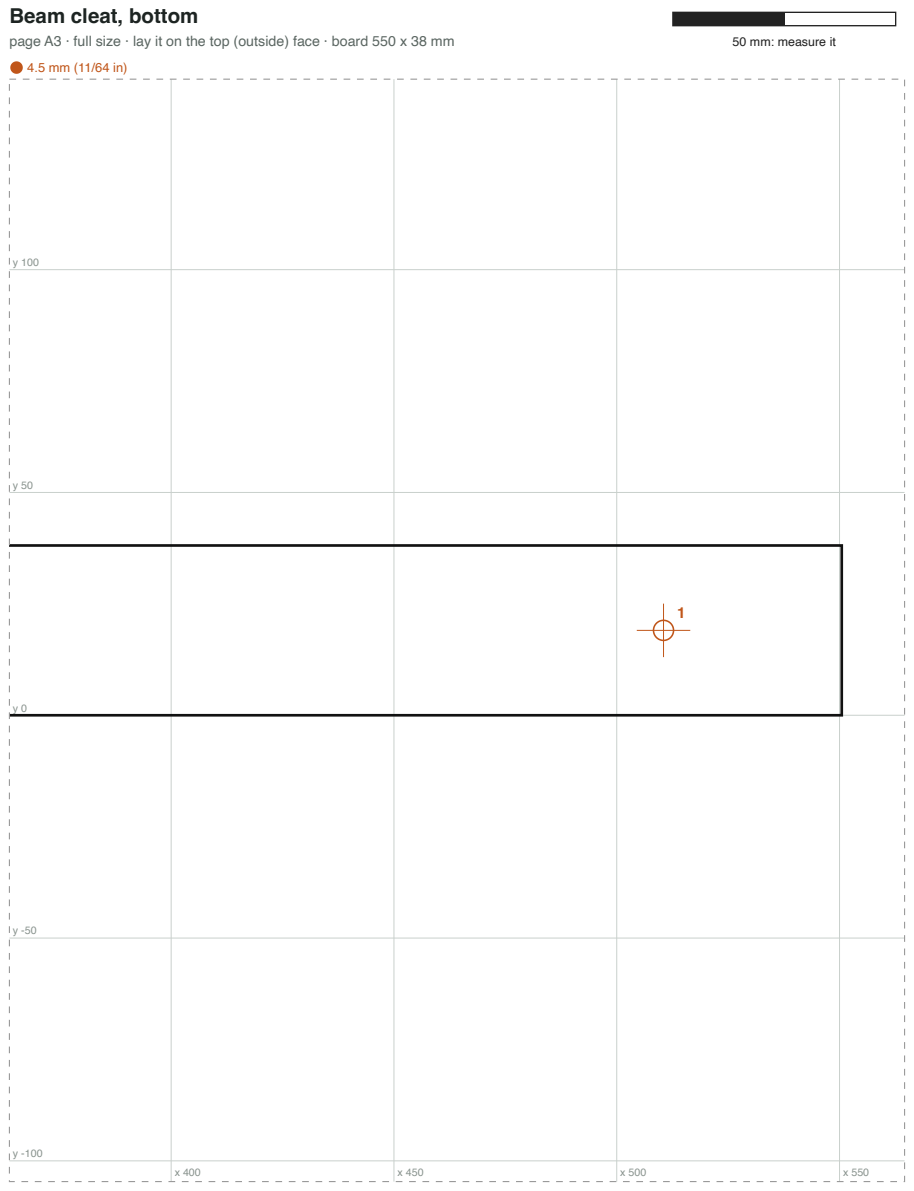
[picture p316: page 22]
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

## Beam cleat, left

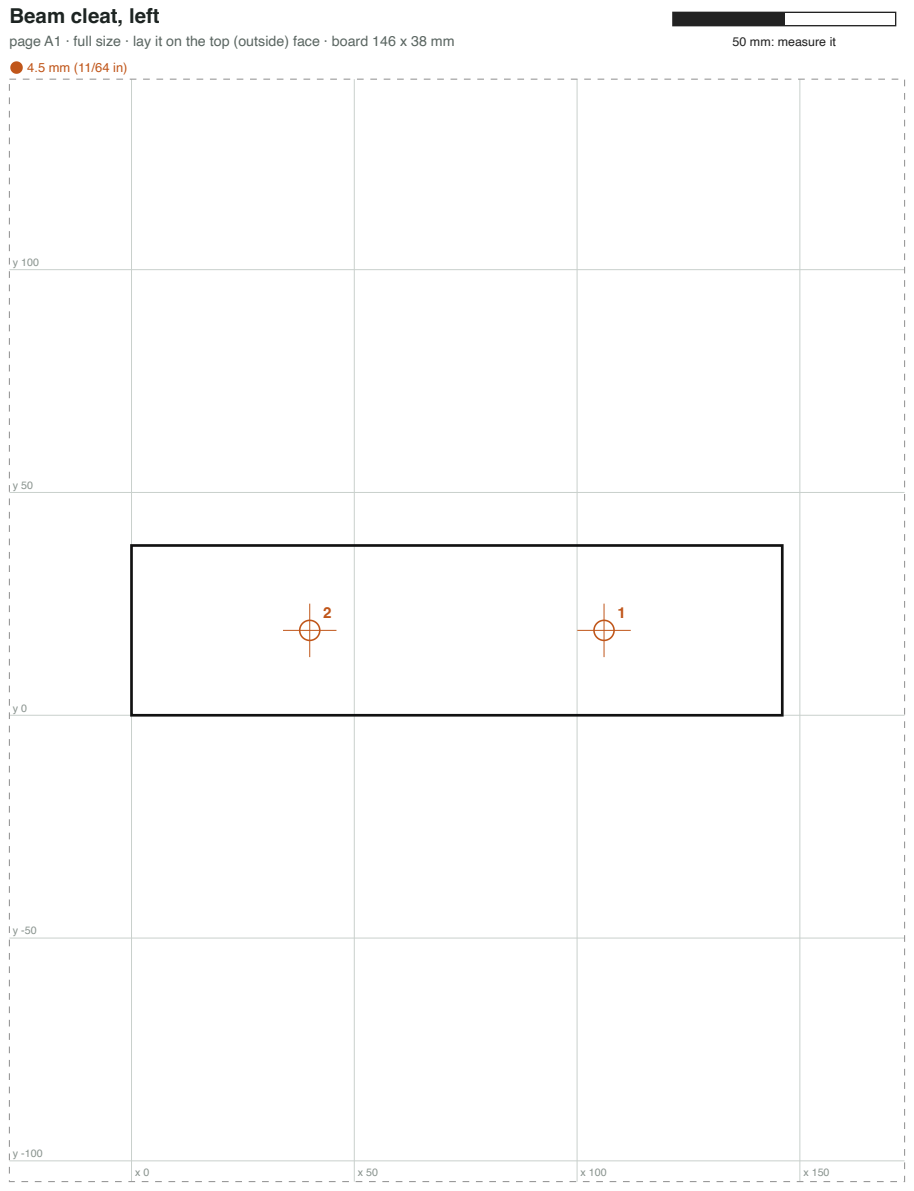
[picture p317: page 23]
page A1 · full size · lay it on the top (outside) face · board 146 x 38 mm; 50 mm: measure it

## Beam cleat, right

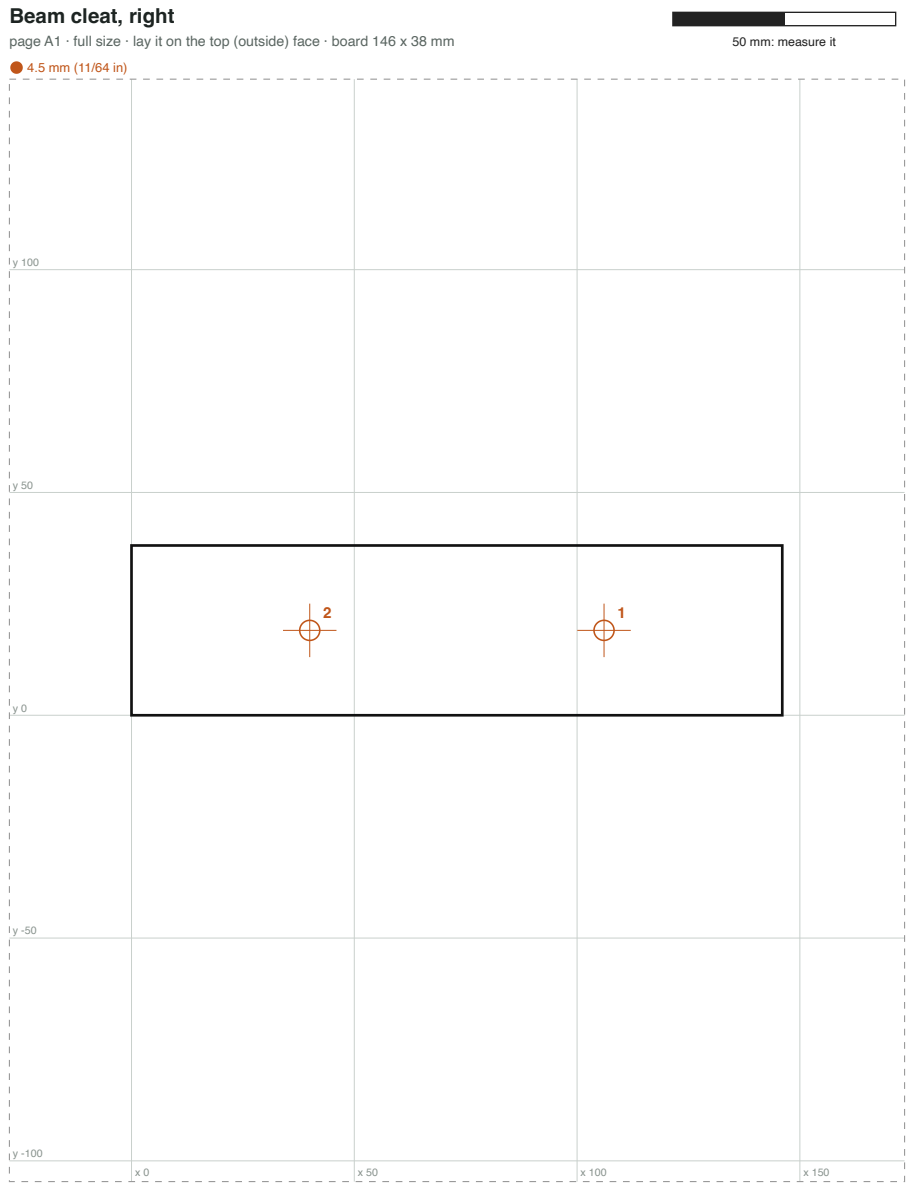
[picture p318: page 24]
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
