nolanstr/diycnc/docs/3-molds/templates/upright-templates.pdf

# Upright molds: drilling templates

DIY CNC epoxy-granite mill · October 2026 · full size, US Letter

## Printing

1. Print at Actual size / 100 %. Turn off "Fit to page" and "Scale to fit". Letter paper, portrait.
2. Measure the square below: it must be 100 mm (and the bar on every page 50 mm). If it is off by more than 1 mm, fix the scaling and print again.
3. Only pages with holes are printed. Every page has a grid labeled in the board's own millimeters, from the bottom-left corner as you look at the marked face, so you can place any page on its own.

## Marking a board

1. Lay the board on the bench with the face named at the top of its pages up (the cast face, or the top face for bridges and cleats).
2. Start with the page that has the board's corner on it: line its printed edges up with the board's edges and tape it down. Add the next pages overlapping by about 12 mm, with the grid lines on top of each other; trim one edge if it helps. Where a page shows no board edge, measure to a labeled grid line with a square instead.
3. Push an awl or a center punch through every crosshair. The circle is the finished hole size, the number is the hole's number in the guide's table, and the color is its size: the legend at the top of each page gives the drill.
4. Pull the paper off, and drill from the marked face (clamp a scrap underneath). Drill a 1/8 in pilot first for anything 13 mm or bigger; the 63.5 mm holes are a 2-1/2 in hole saw.
5. Walls: pencil the dashed pour line (25 mm below the top edge) on the cast face, or mark it later with the printed pour-line gauge. The casting is filled to this line.
6. Boards marked "x2" are the same board twice: mark both from one print.

## Pages

Board | Qty | Pages | Holes
Upright floor | 1 | 2-4 (3) | 21
Upright side plate, outer | 1 | 5-6 (2) | 3
Upright side plate, inner | 1 | 7-8 (2) | 3
Upright back board | 1 | 9-9 (1) | 2
U i h f | b | d | 1 | 10 11 (2) | 3

100 mm

## Upright floor

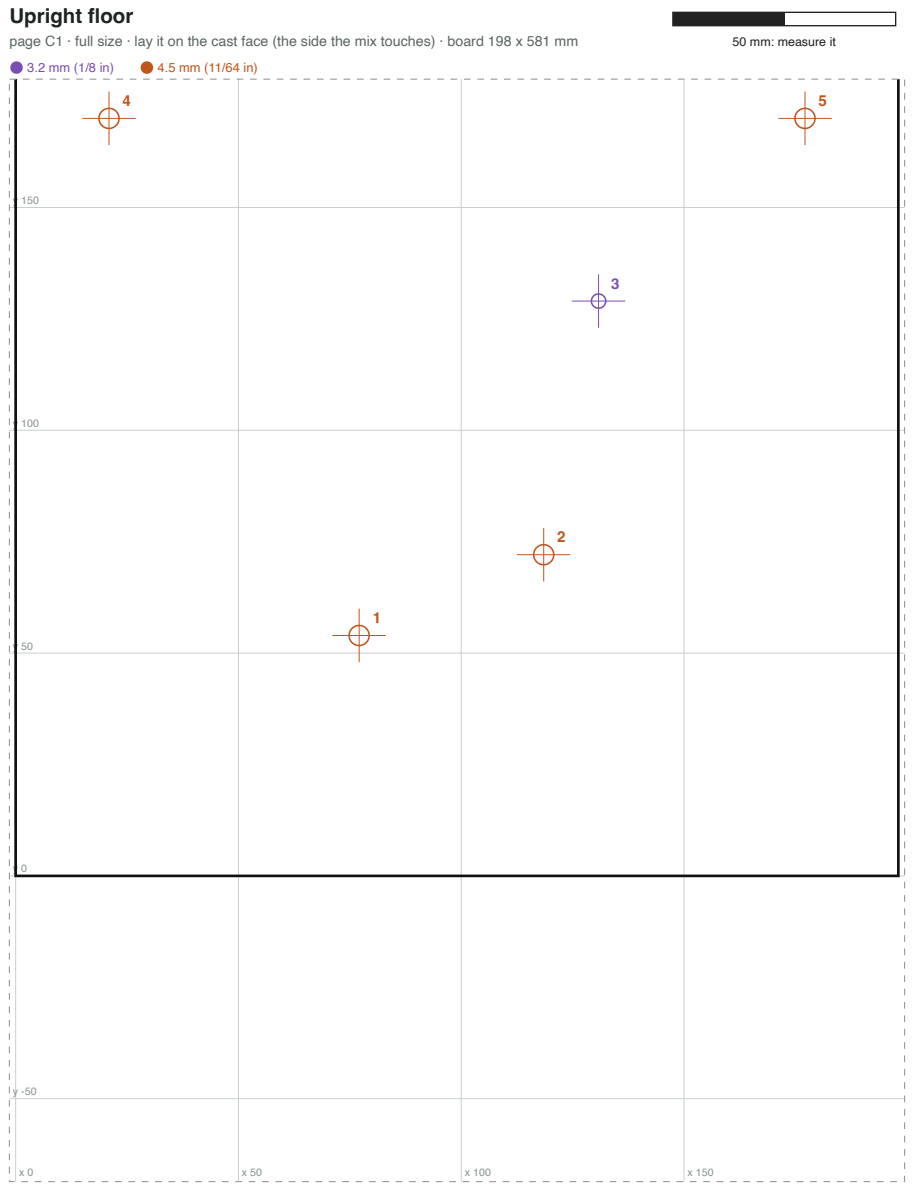
[picture p319: page 2]
page C1 · full size · lay it on the cast face (the side the mix touches) · board 198 x 581 mm; 50 mm: measure it

## Upright floor

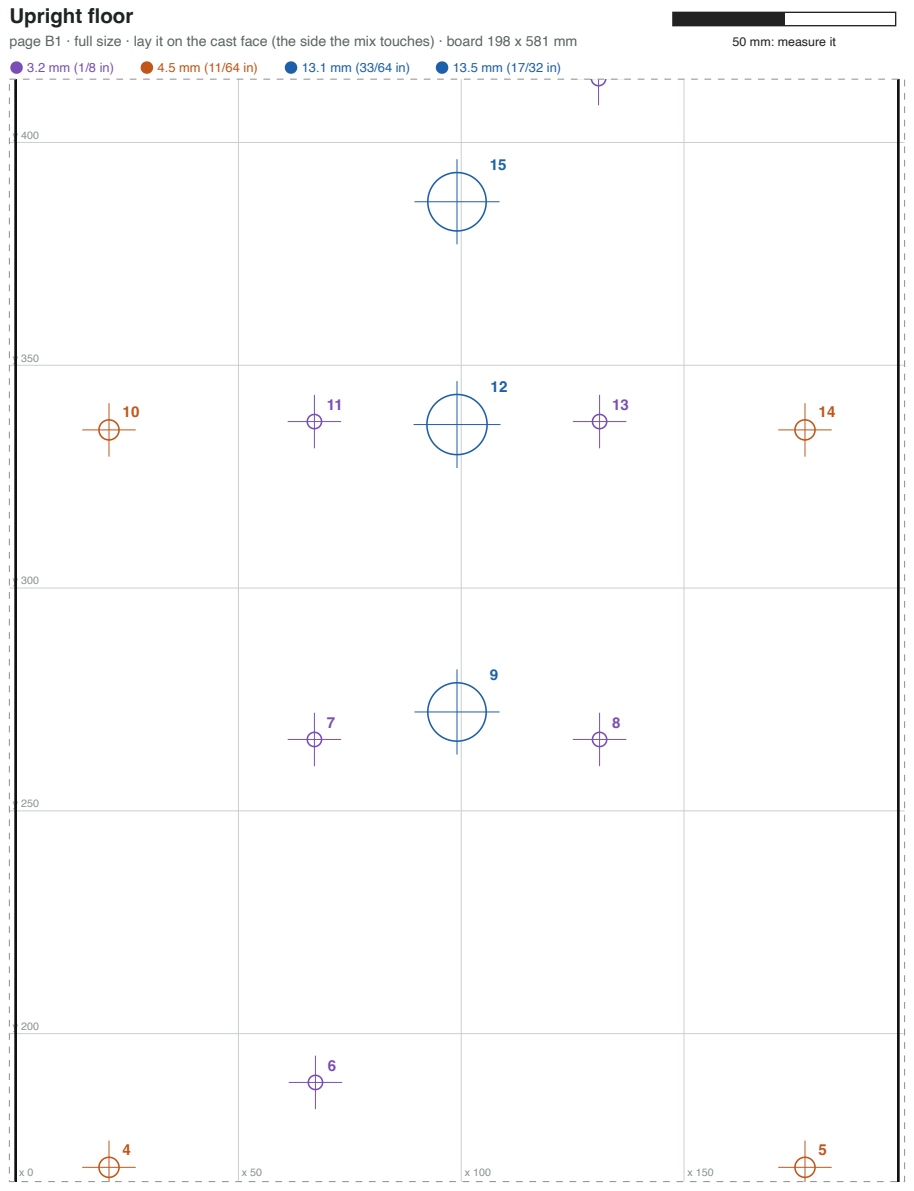
[picture p320: page 3]
page B1 · full size · lay it on the cast face (the side the mix touches) · board 198 x 581 mm; 50 mm: measure it

## Upright floor

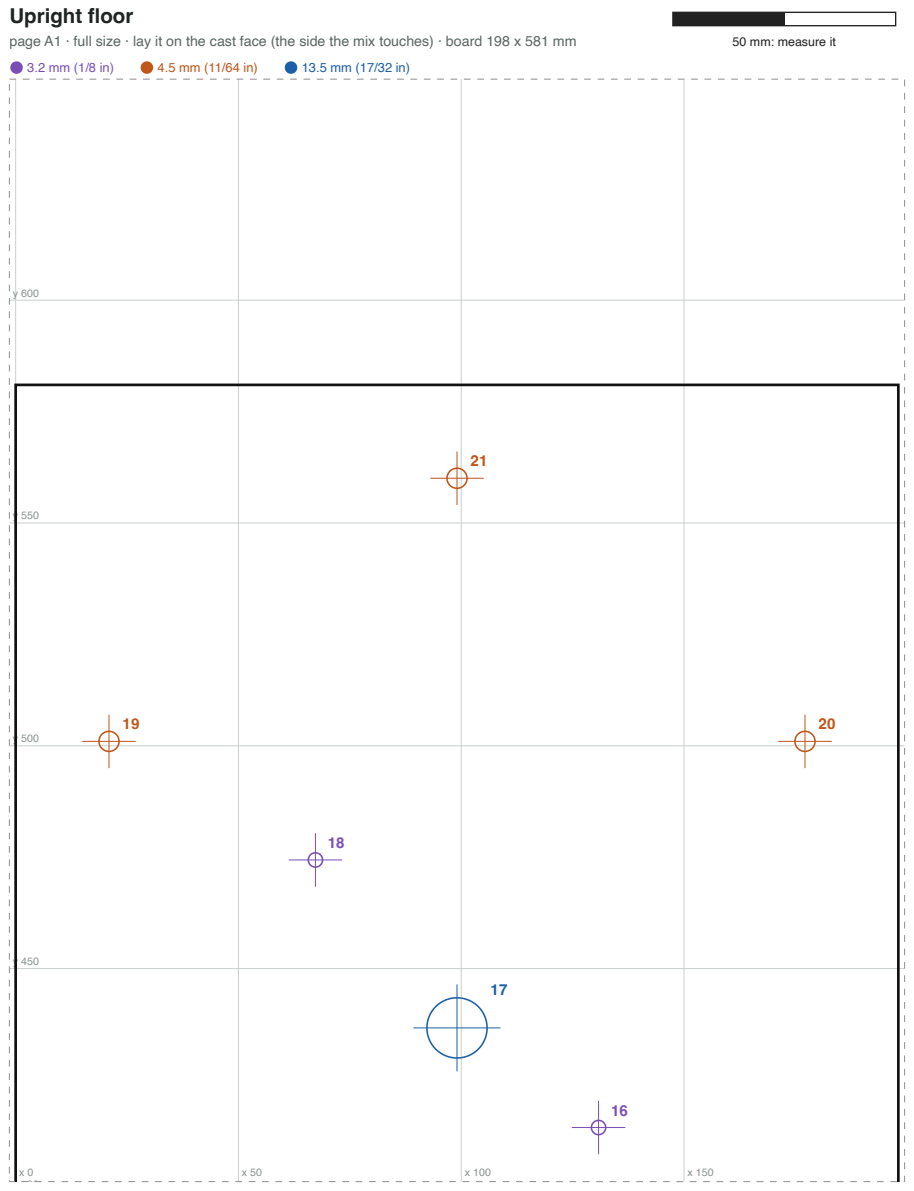
[picture p321: page 4]
page A1 · full size · lay it on the cast face (the side the mix touches) · board 198 x 581 mm; 50 mm: measure it

## Upright side plate, outer

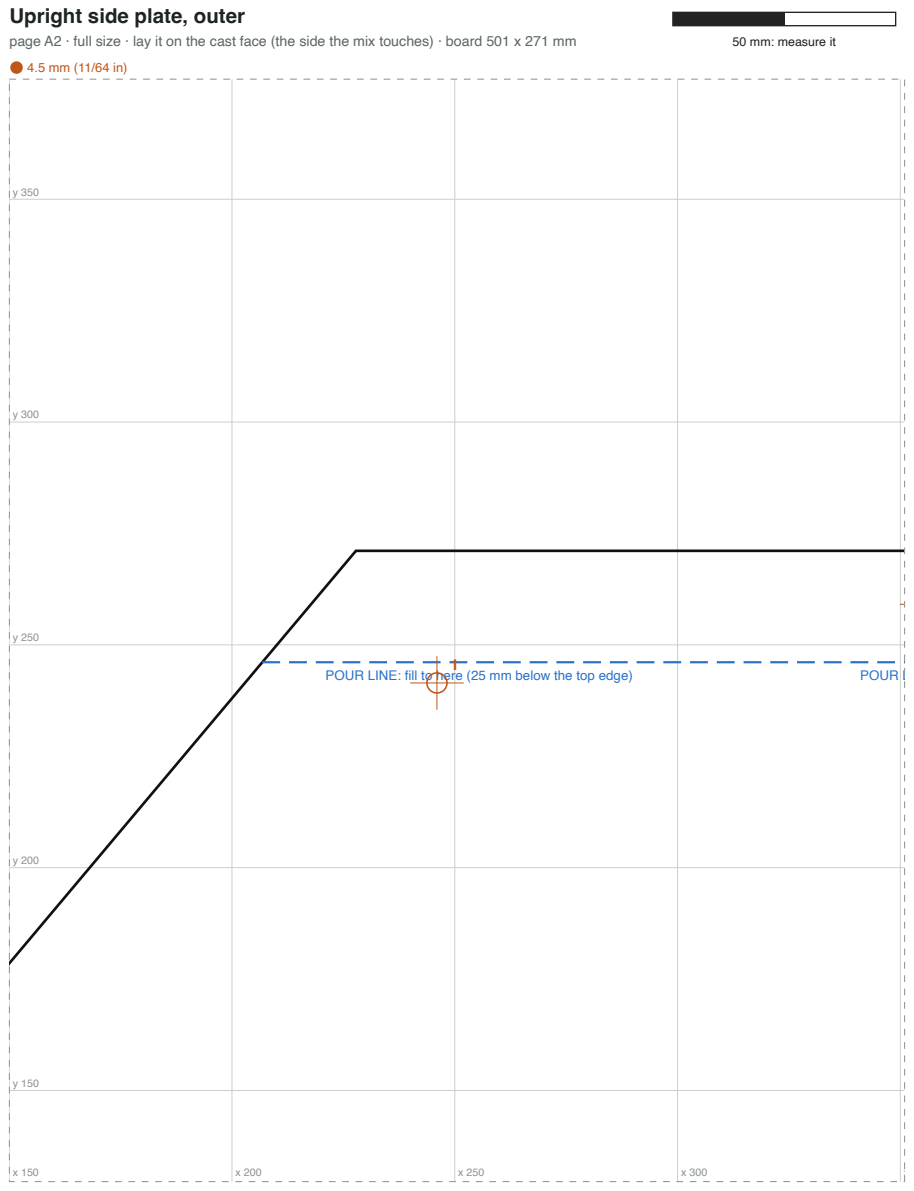
[picture p322: page 5]
page A2 · full size · lay it on the cast face (the side the mix touches) · board 501 x 271 mm; 50 mm: measure it; POUR LINE: fill to here (25 mm below the top edge); POUR L

## Upright side plate, outer

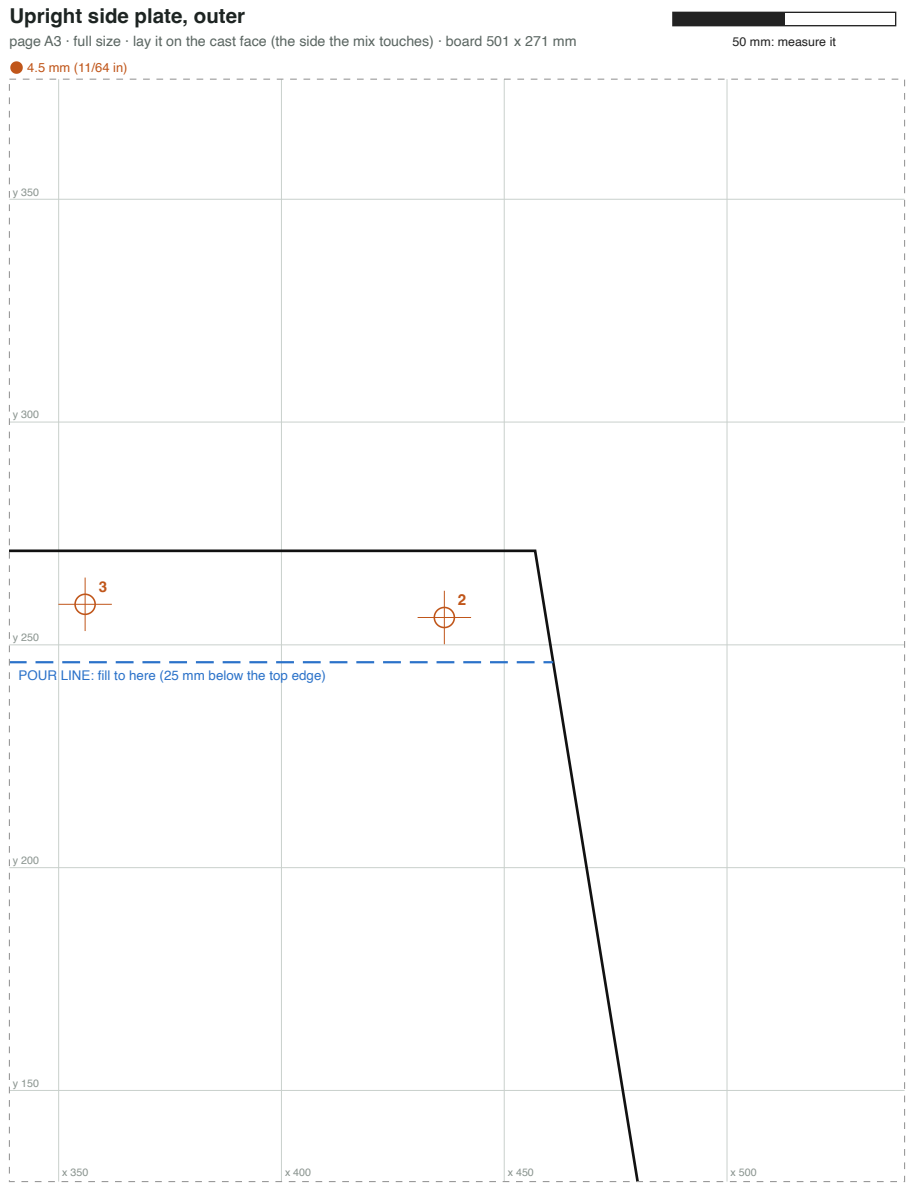
[picture p323: page 6]
page A3 · full size · lay it on the cast face (the side the mix touches) · board 501 x 271 mm; 50 mm: measure it

POUR LINE: fill to here (25 mm below the top edge)

## Upright side plate, inner

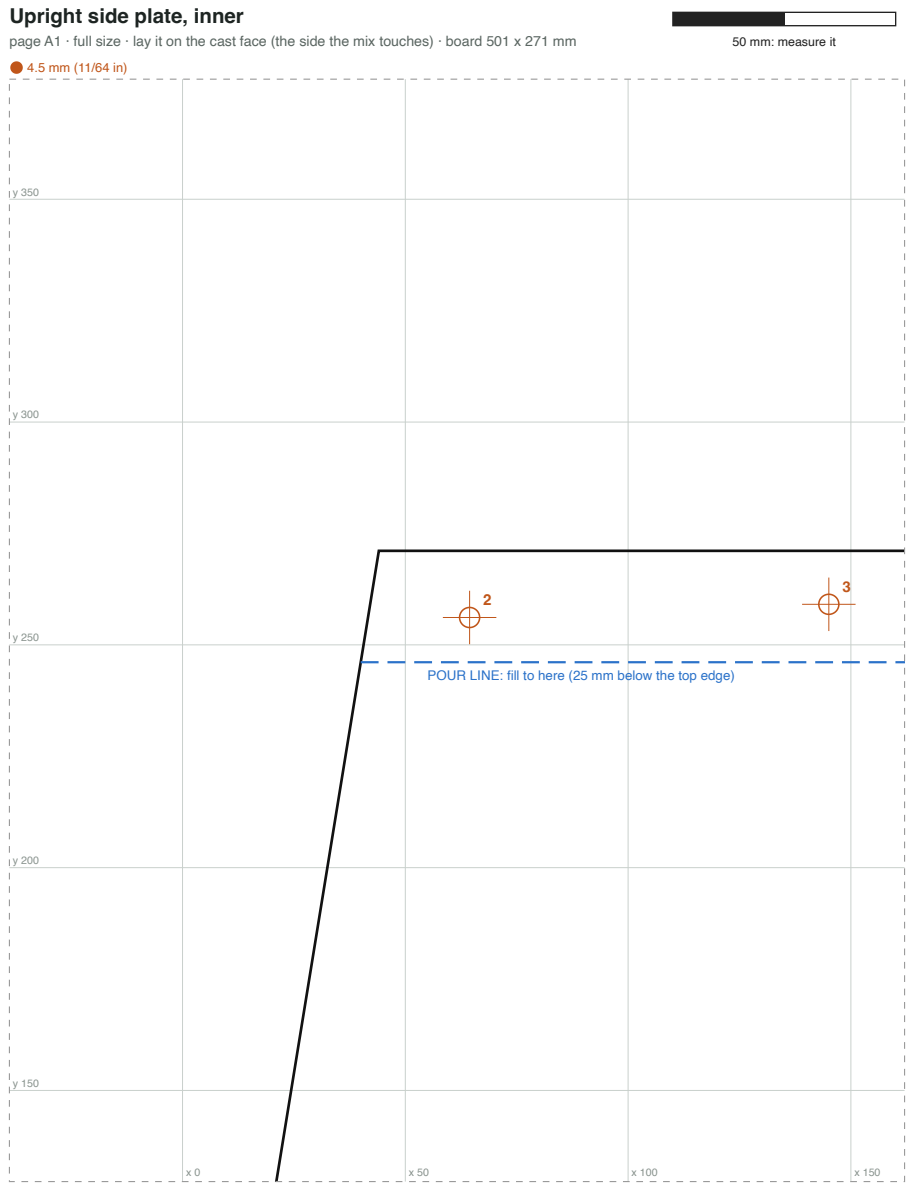
[picture p324: page 7]
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

POUR LINE: fill to here (25 mm below the top edge)

## Upright side plate, inner

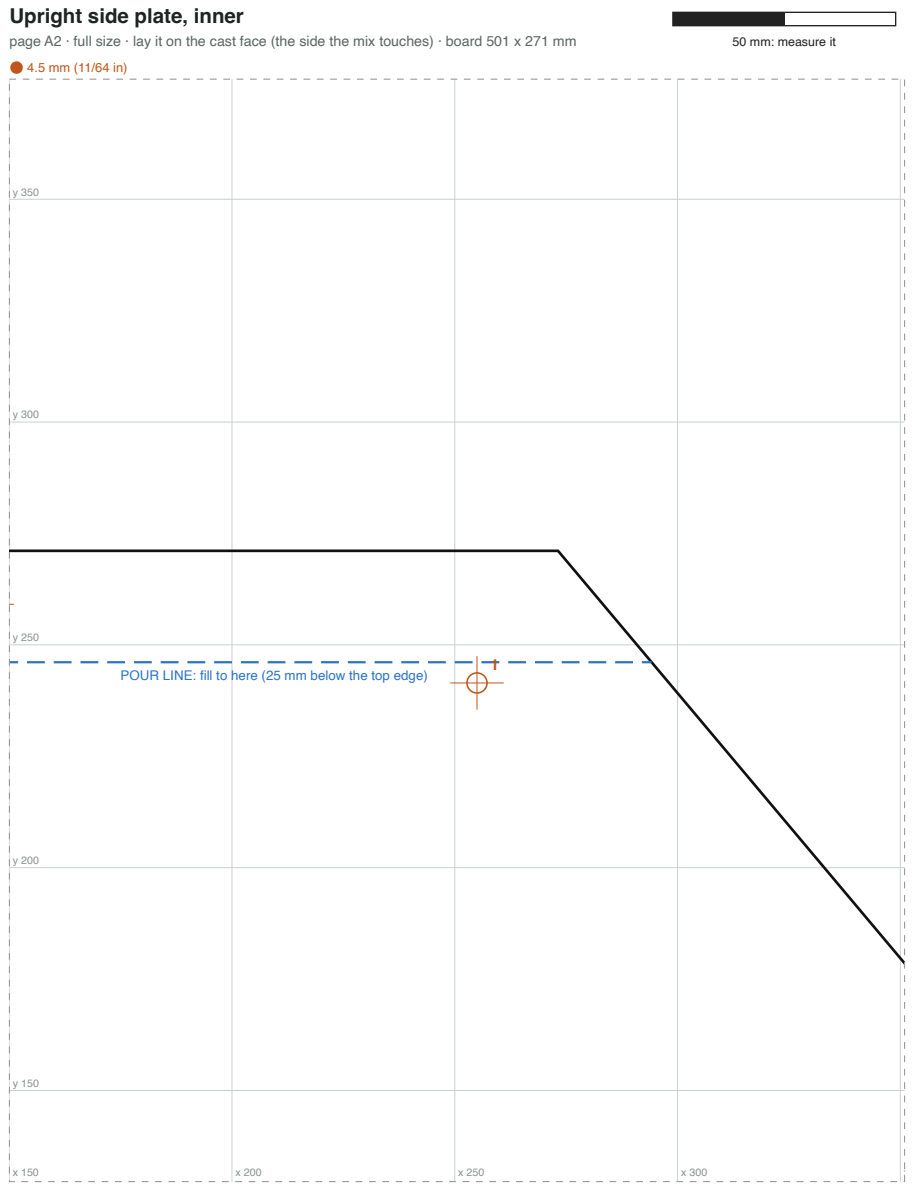
[picture p325: page 8]
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

POUR LINE: fill to here (25 mm below the top edge) y 200

## Upright back board

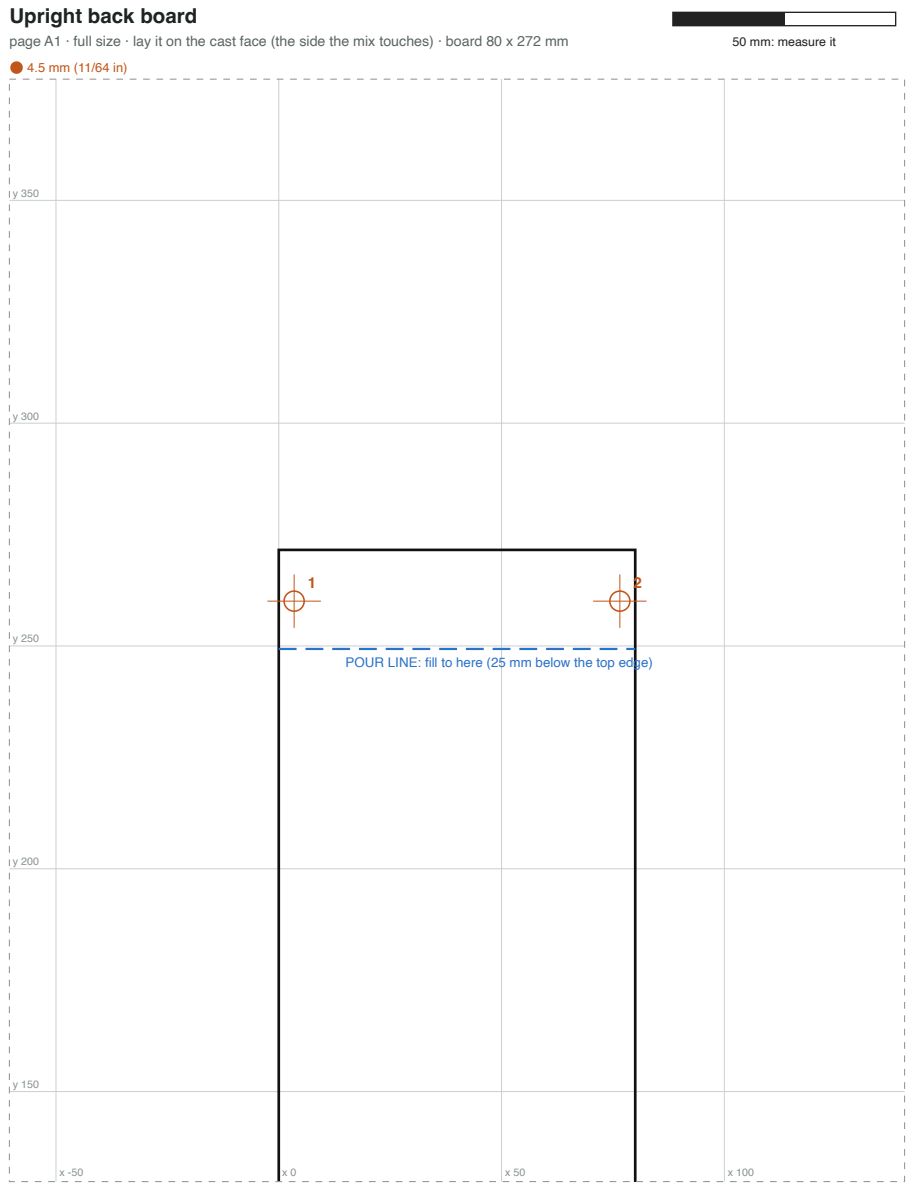
[picture p326: page 9]
page A1 · full size · lay it on the cast face (the side the mix touches) · board 80 x 272 mm; 50 mm: measure it

POUR LINE: fill to here (25 mm below the top edge)

## Upright front board

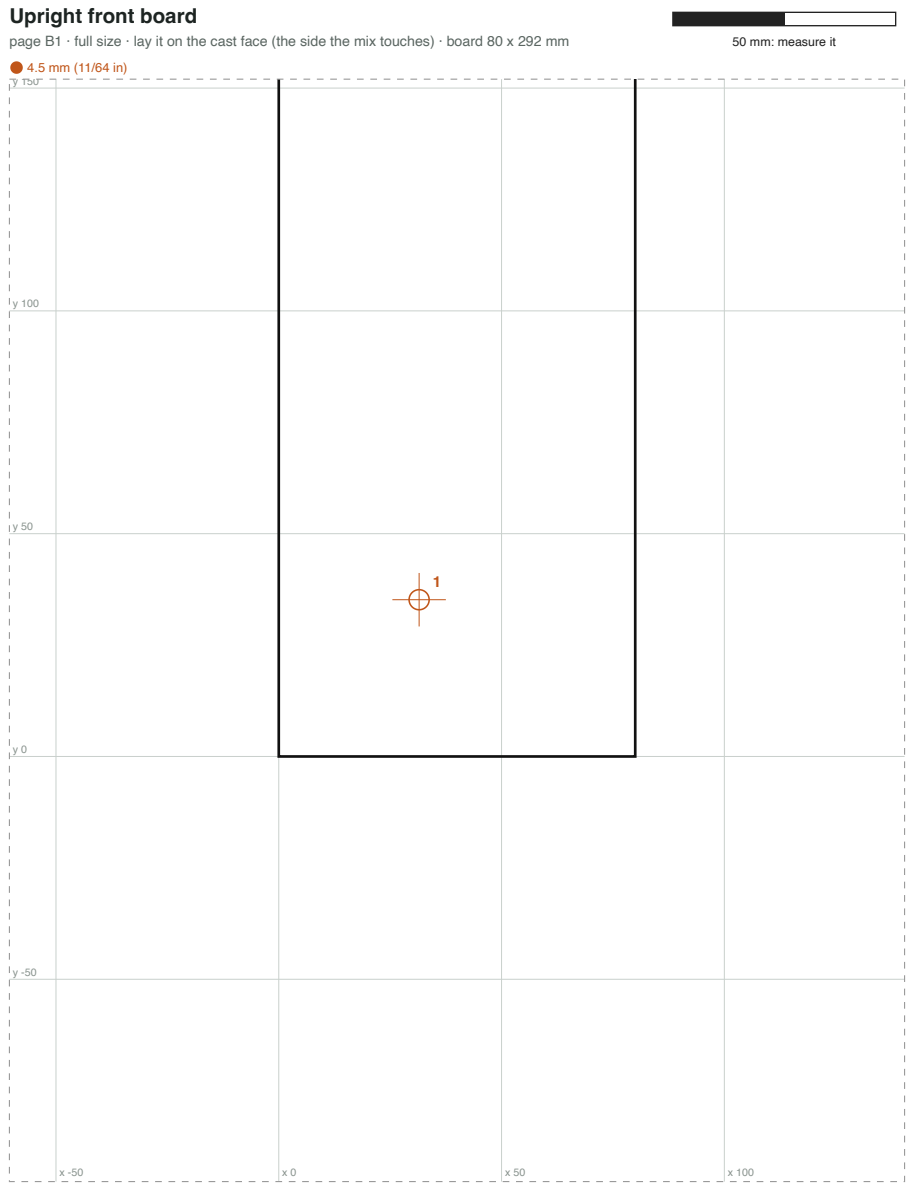
[picture p327: page 10]
page B1 · full size · lay it on the cast face (the side the mix touches) · board 80 x 292 mm; 50 mm: measure it

## Upright front board

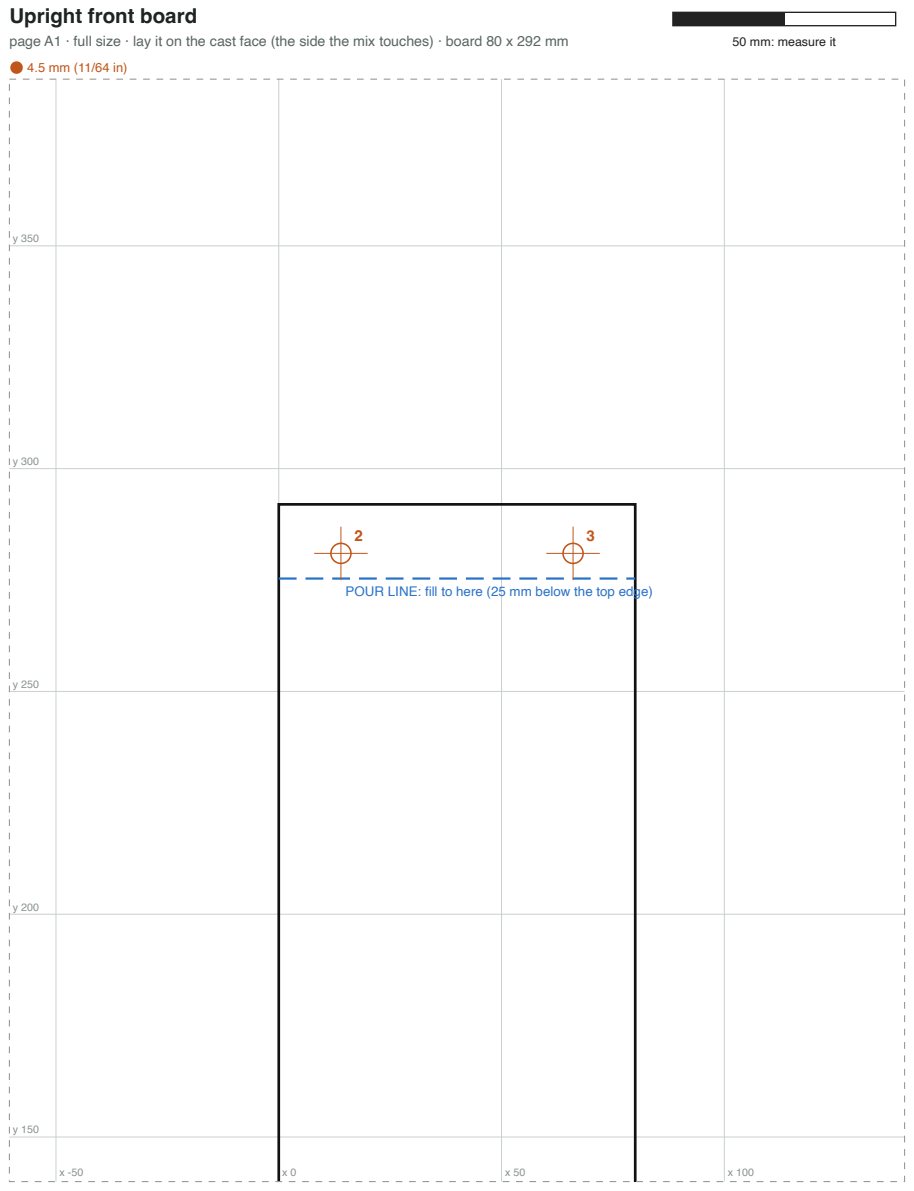
[picture p328: page 11]
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

POUR LINE: fill to here (25 mm below the top edge)

## Upright bridge

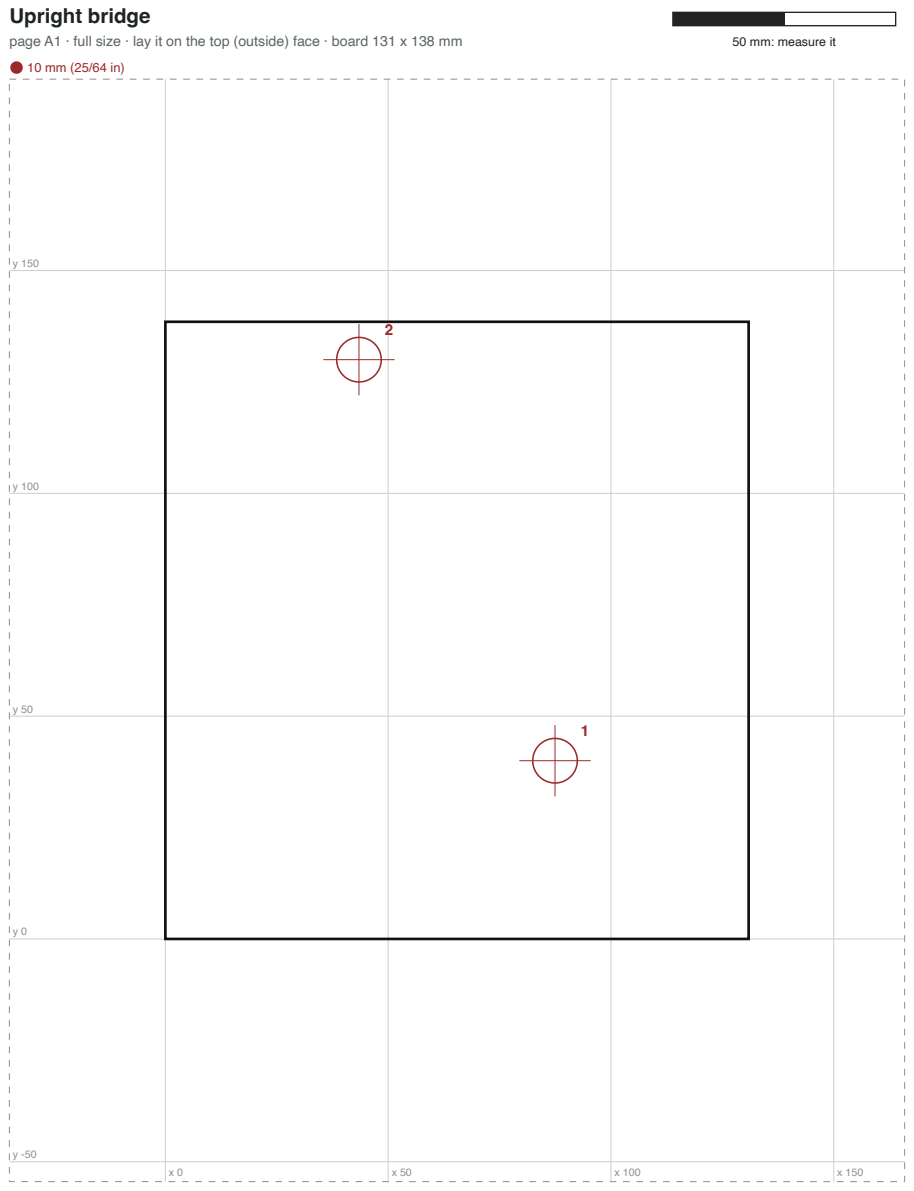
[picture p329: page 12]
page A1 · full size · lay it on the top (outside) face · board 131 x 138 mm; 50 mm: measure it

## Upright cleat, outer

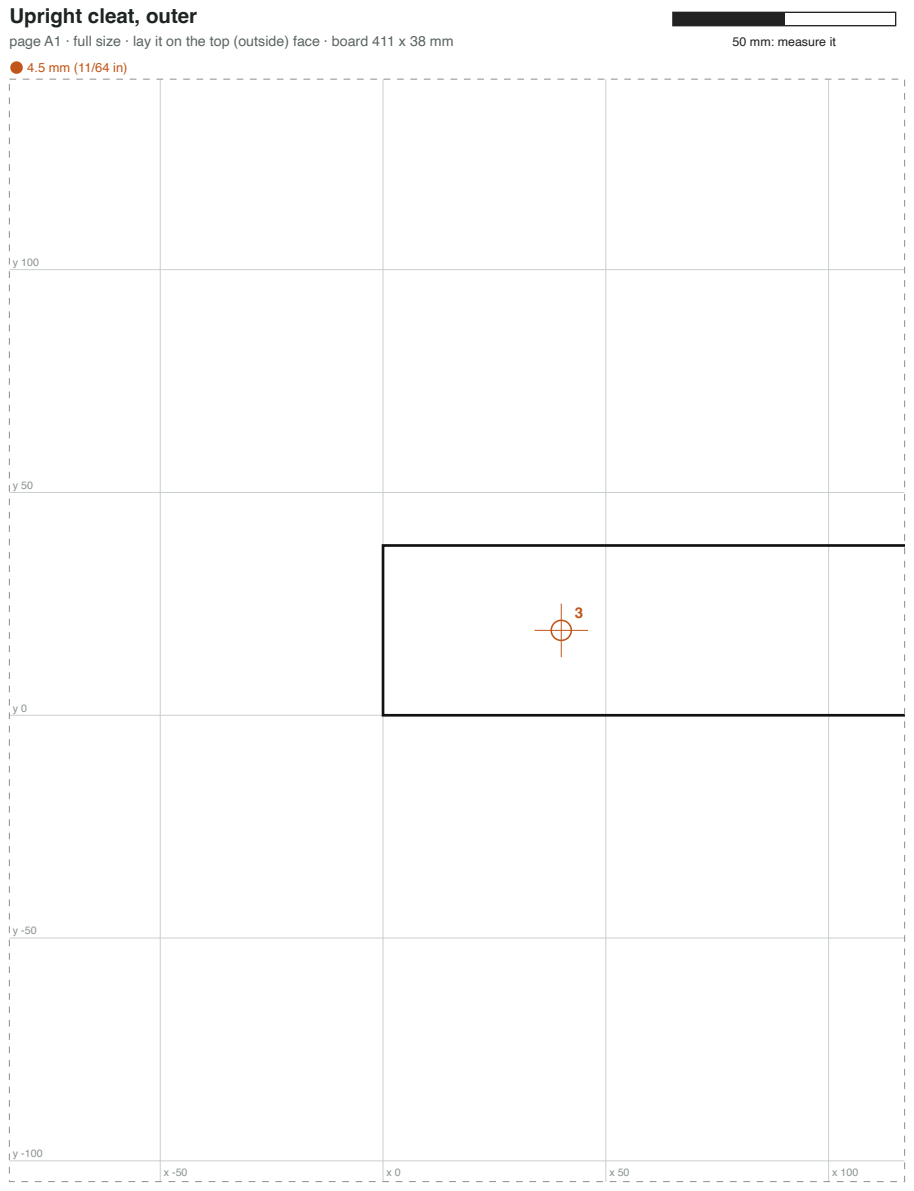
[picture p330: page 13]
page A1 · full size · lay it on the top (outside) face · board 411 x 38 mm; 50 mm: measure it

## Upright cleat, outer

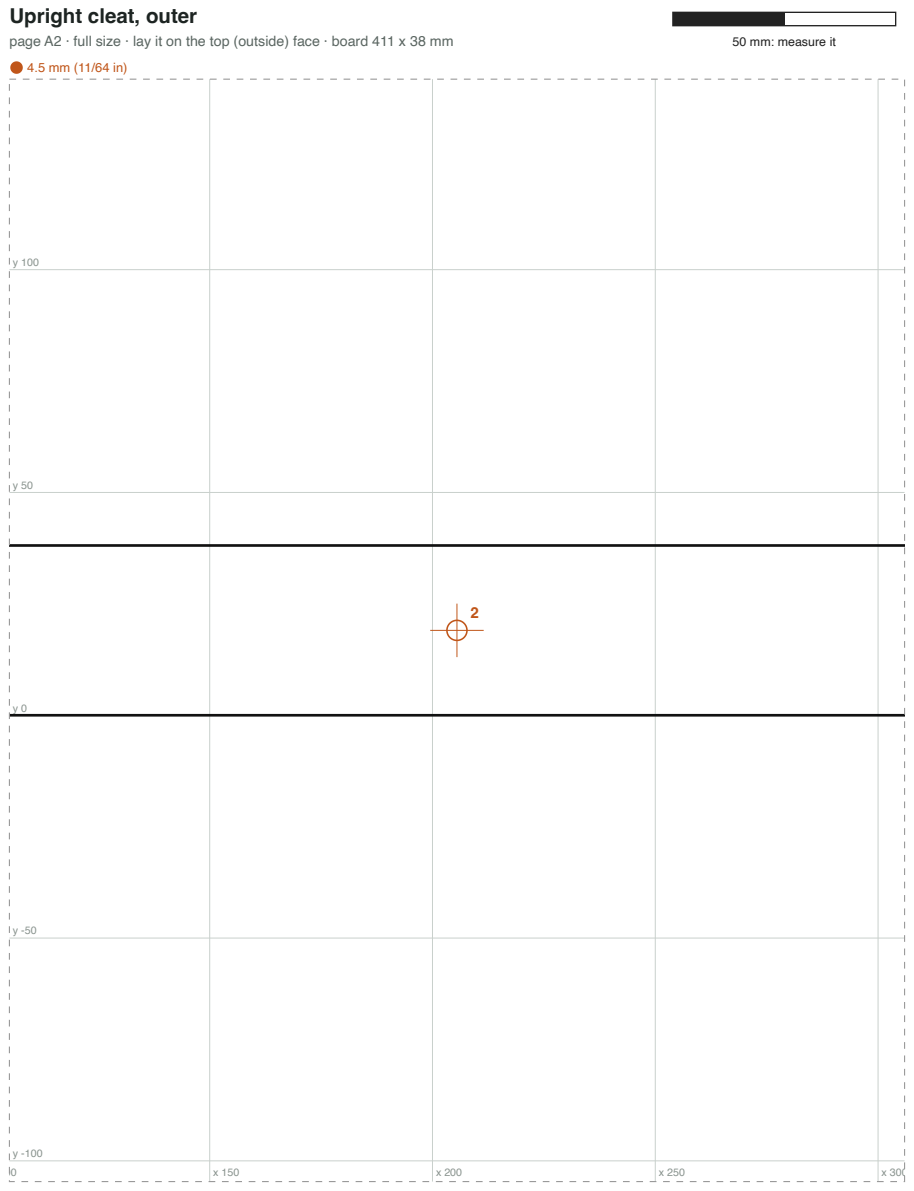
[picture p331: page 14]
page A2 · full size · lay it on the top (outside) face · board 411 x 38 mm; 50 mm: measure it

## Upright cleat, outer

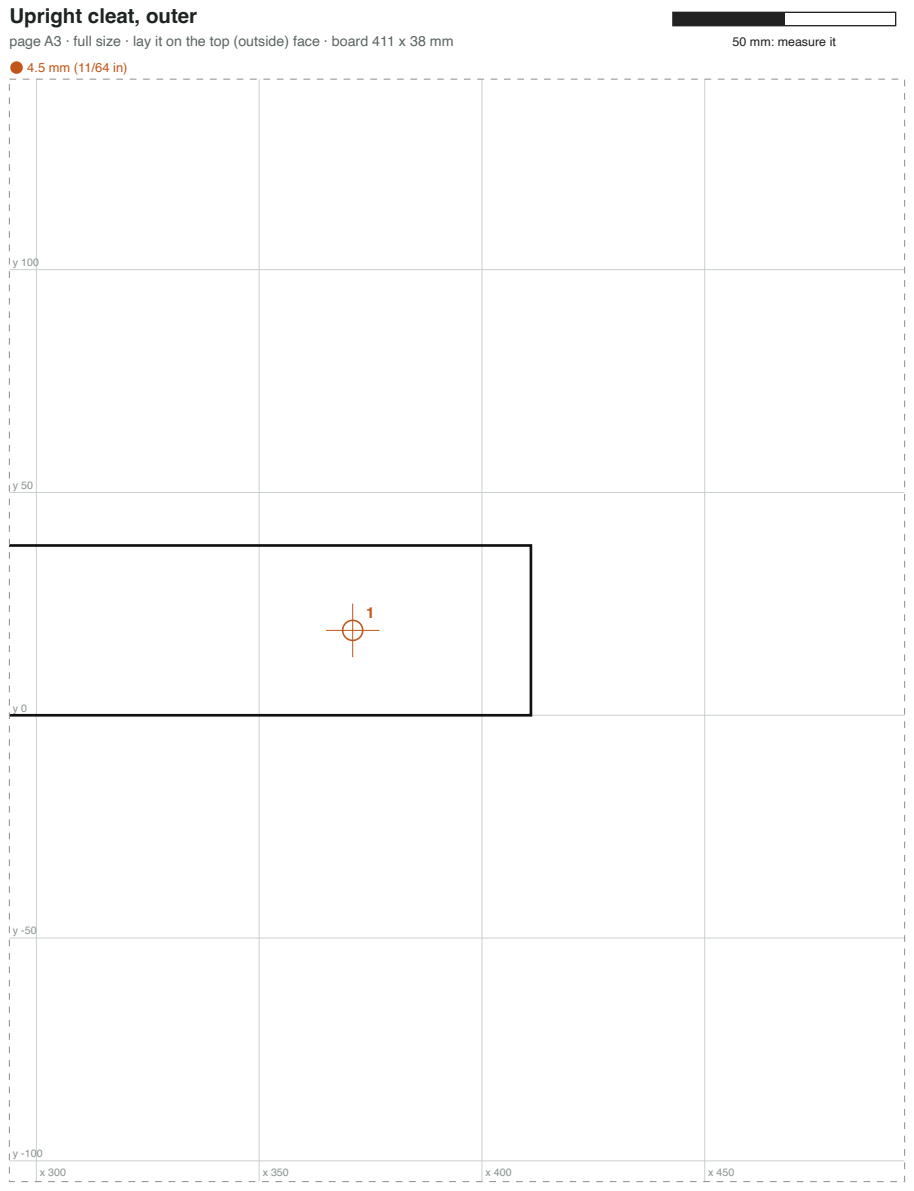
[picture p332: page 15]
page A3 · full size · lay it on the top (outside) face · board 411 x 38 mm; 50 mm: measure it

## Upright cleat, inner

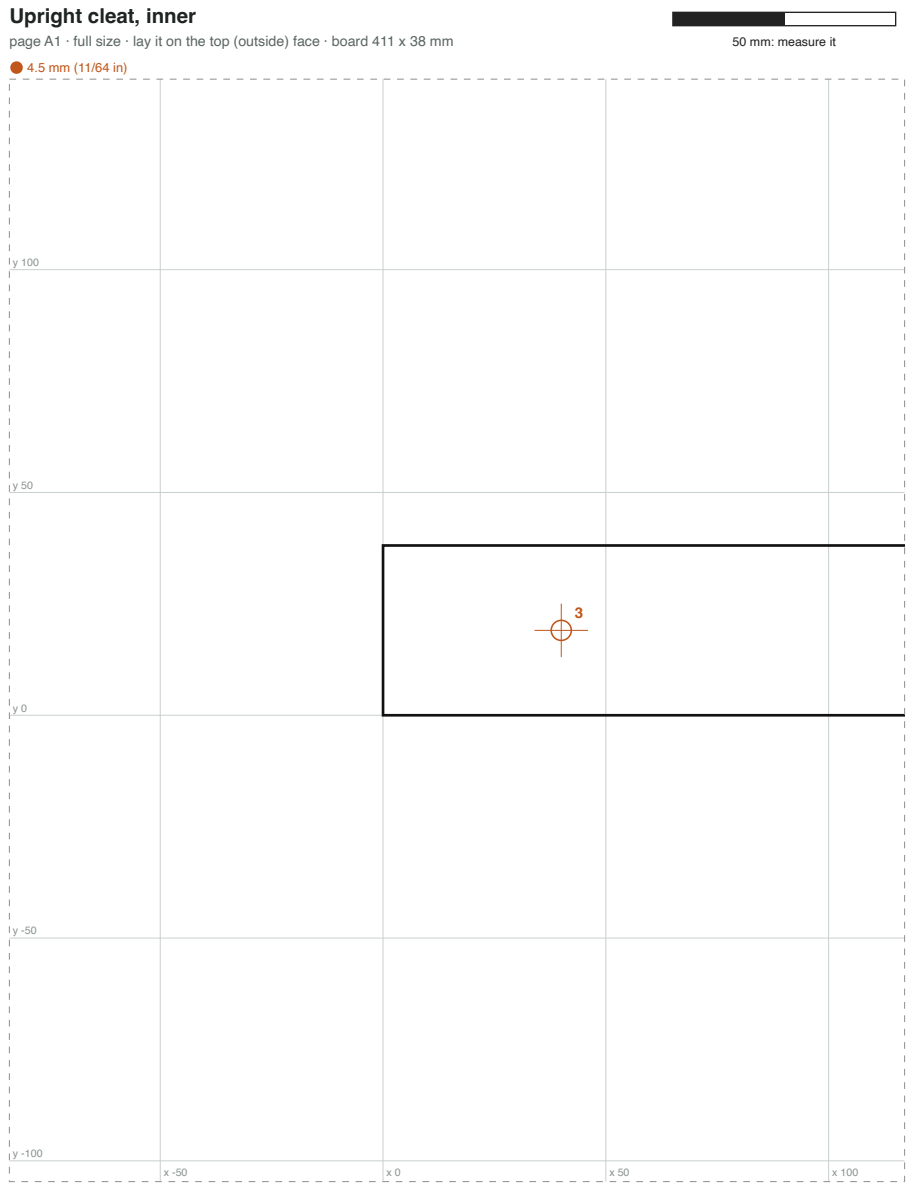
[picture p333: page 16]
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

## Upright cleat, inner

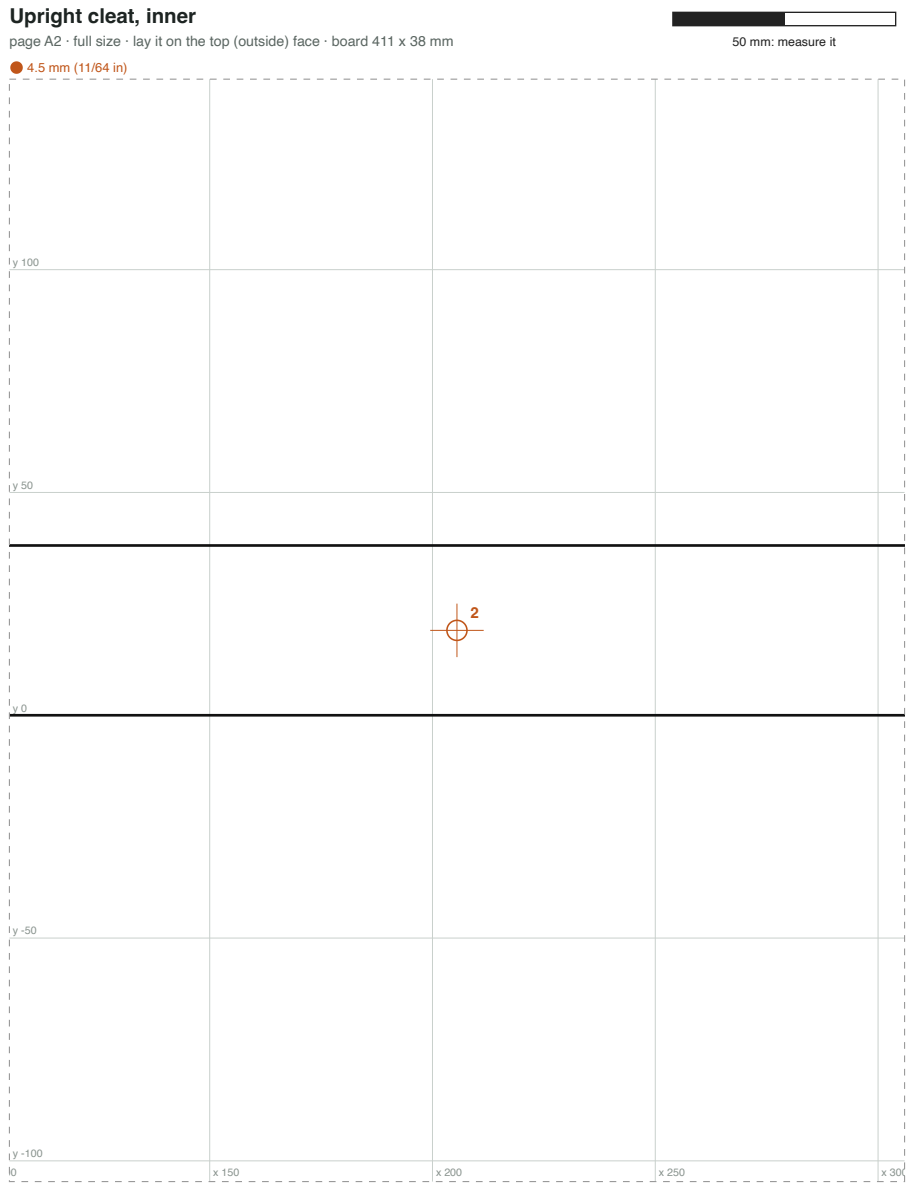
[picture p334: page 17]
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

## Upright cleat, inner

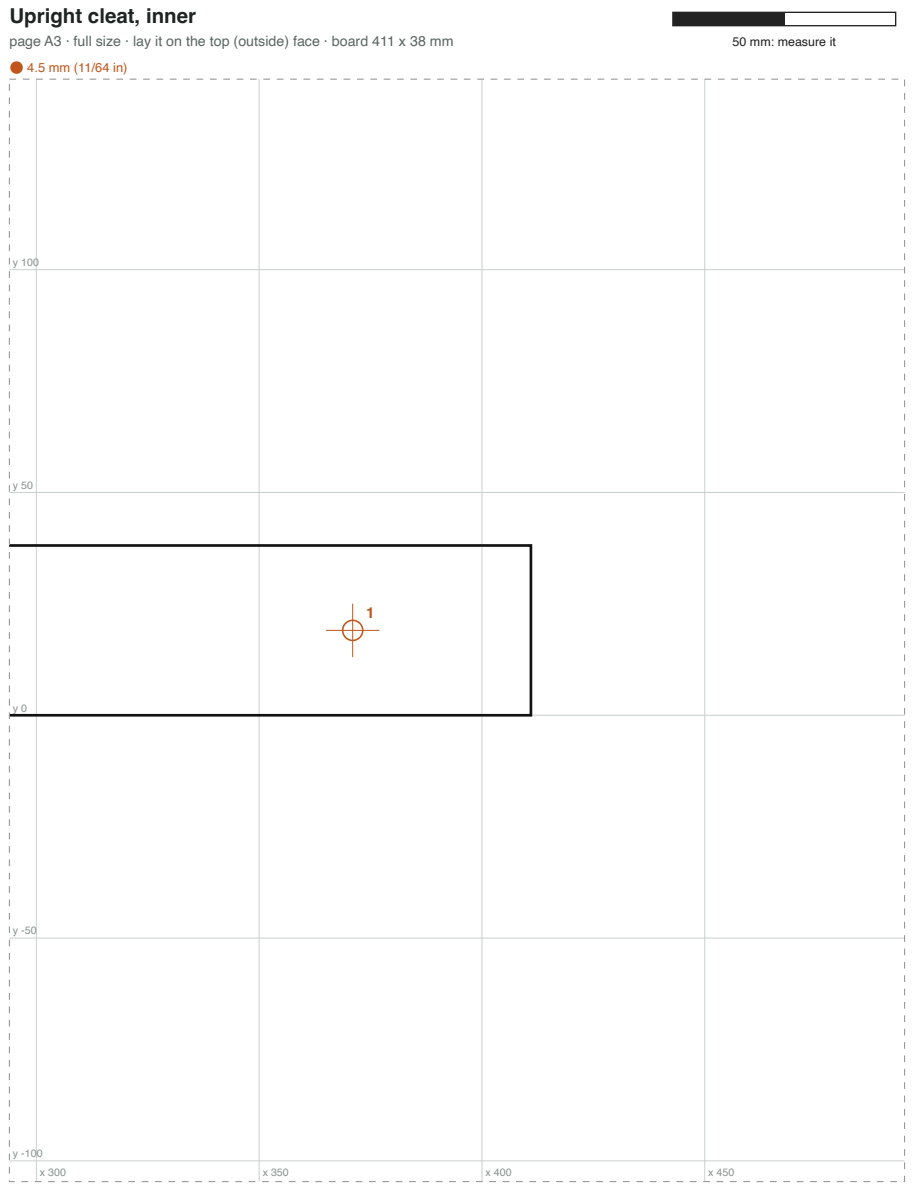
[picture p335: page 18]
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

## Upright cleat, back

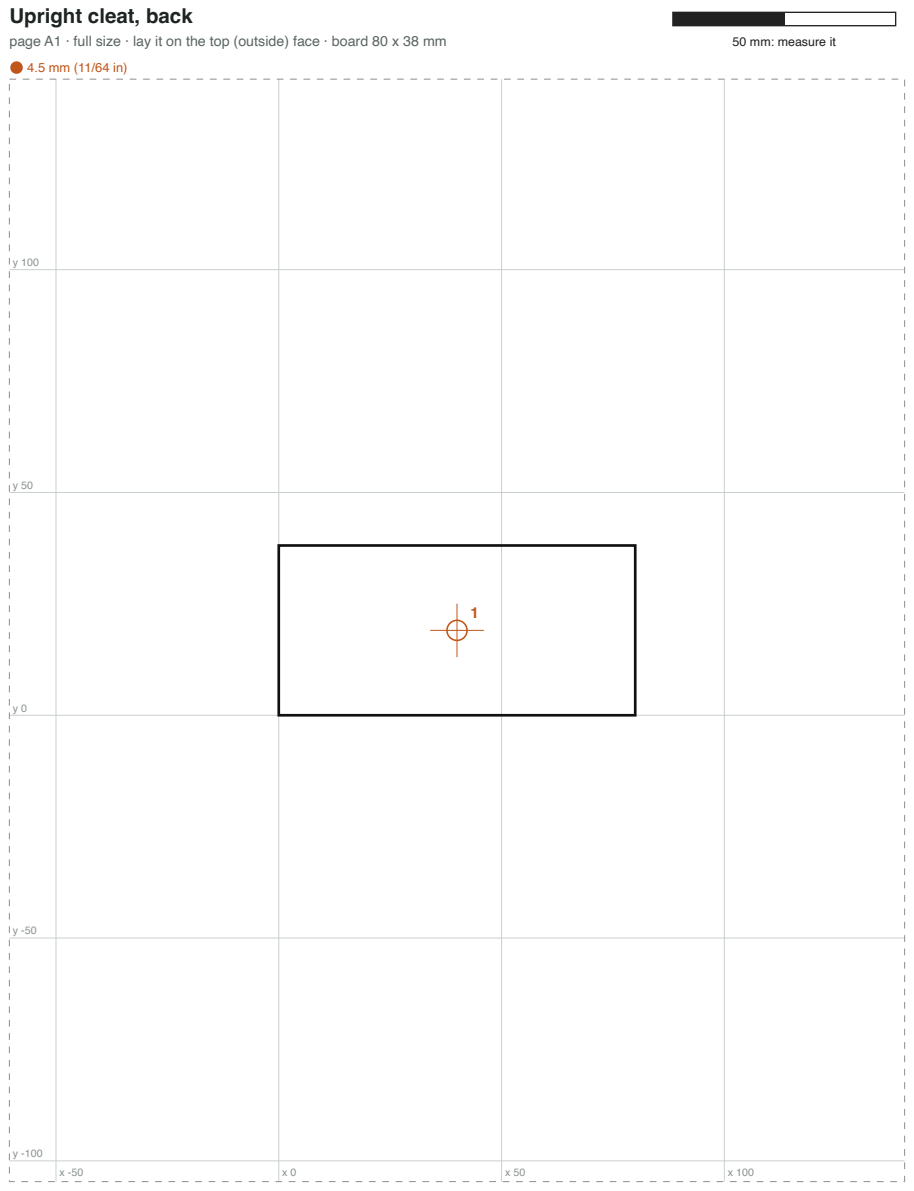
[picture p336: page 19]
page A1 · full size · lay it on the top (outside) face · board 80 x 38 mm; 50 mm: measure it
