nolanstr/diycnc/model/build_cnc.py

"""Parametric layout model of a fixed-gantry, epoxy-granite desktop CNC mill.

Target envelope is the Shariff DMC2 Mini (12 x 7 x 5.5 in travel). The long
axis rides on the table so the gantry beam stays short and stiff. Component
geometry (rails, blocks, ballscrew hardware, motors, spindle) lives in parts.py.
The frame is five bolt-together epoxy-granite castings with cast-in steel, and the
enclosure bolts to the base top.

Headless (collision check, docs/5-design/report.txt and the print/ STLs):
    /Applications/FreeCAD.app/Contents/Resources/bin/freecadcmd model/build_cnc.py
In the FreeCAD GUI (also rebuilds the colored DIYCNC.FCStd and DIYCNC.step):
    Macro > Macros... > select model/build_cnc.py > Execute

Edit P below and re-run. In the GUI, jog the axes and open the door by editing
posX / posY / posZ / doorAngle in the Params spreadsheet.

Coordinates: X right, Y toward the back (operator stands at -Y), Z up.
Origin is on the casting's underside directly below the spindle axis with all
axes at home (X and Y centered, Z fully up).
"""

import collections
import csv
import importlib
import itertools
import json
import math
import os
import re
import subprocess
import sys

import FreeCAD as App
import Part
from FreeCAD import Matrix, Vector

try:
    HERE = os.path.dirname(os.path.abspath(__file__))
except NameError:
    HERE = os.getcwd()
ROOT = os.path.dirname(HERE)          # repository root: docs/, renders/, print/ live here
if HERE not in sys.path:
    sys.path.insert(0, HERE)
import molds  # noqa: E402
import moldbox  # noqa: E402
import parts  # noqa: E402
import skeleton as sk  # noqa: E402

importlib.reload(parts)  # pick up edits when re-run inside one GUI session
importlib.reload(molds)
importlib.reload(moldbox)
importlib.reload(sk)
from molds import HW, Fix  # noqa: E402
from skeleton import T12, T14, T38  # noqa: E402

# --------------------------------------------------------------------------
# Parameters (mm)
# --------------------------------------------------------------------------
P = dict(
    # Work envelope
    travel_x=180.0,      # spindle along the beam
    travel_y=300.0,      # table front/back
    travel_z=140.0,
    work_clear=160.0,    # table top -> collet nut tip, Z at top (DMC2: 6.25 in table to spindle)
    beam_clear=180.0,    # table top -> underside of beam

    riser_w=31.75,       # 1-1/4 in cold-rolled steel flat bar under every rail

    # Table axis (Y): new HGR15 rails + SFU1605
    # Rails at the length they're sold in (2 x 600 mm kit, no cutting), shifted back 20 mm so
    # the front ends stay clear of the coolant trough.
    table_rail_len=600.0, table_rail_y=20.0, table_rail_spacing=180.0, table_blk_pitch=150.0,
    table_screw_len=550.0, table_riser_t=19.05,   # 3/4 in risers clear the 43 mm BK12
    # The table and Z plate are stock 6061 flat-bar widths (10 in and 6 in), so the only cut is their length.
    table_len=320.0, table_w=254.0, table_t=19.05, table_hole_pitch=25.0,

    # Beam axis (X): owned HGR15-400 pair + SFU1204-400 kit
    beam_rail_len=400.0, beam_rail_spacing=100.0, beam_blk_pitch=90.0,   # blocks span 151.4 on the 6 in carriage
    beam_screw_len=400.0, beam_riser_t=15.875,    # 5/8 in risers clear the 39 mm BK10
    # The X carriage is 5/8 x 6 in mild steel flat bar, with two 1-1/4 x 1/4 in steel angles bolted up its back above
    # the X blocks: it was the softest link between the tool and the work, and steel at the same thickness keeps
    # the spindle where it is (analysis/chain.py, design notes).
    carriage_w=152.4, carriage_t=15.875, car_angle=(31.75, 6.35),

    # Z axis: moving-rail (blocks fixed to the carriage), HGR15-300 + SFU1204-300
    z_rail_len=300.0, z_rail_spacing=100.0, z_blk_pitch=80.0,
    z_screw_len=300.0, z_nut_on_plate=230.0, z_riser_t=15.875,
    zplate_w=152.4, zplate_t=15.875,     # clamp foot is 148 wide

    # Motors (parts.MOTORS): closed loop on X/Y, the owned open-loop NEMA 23 on Z
    motor_x='23HS30-5004D-E1000', motor_y='23HS30-5004D-E1000', motor_z='23HS30-3004S',
    # Integrated bearing seat + motor brackets (parts.HM); None = the kit BK and a separate bracket. X and Z get
    # the HM10-57 once the one on hand is measured.
    bracket_y='HM12-57',

    # Epoxy-granite castings: base (front + rear halves), two uprights, beam
    # The base's underside pockets follow a topology optimization (analysis/, see base_pockets).
    base_h=110.0, base_corner_r=40.0, base_split_y=0.0, split_wall=15.0,
    base_core_skin=20.0,    # top skin over the pockets
    base_girder_w=80.0,     # full-depth girder under each table rail, rail tube in the middle
    base_tie=90.0,          # full-depth tie between the girders, this far ahead of the split
    base_tie_rear=55.0,     # ... and this far behind it
    base_foot_pockets=True, # pockets under the upright feet, between ribs and around the tie-rod couplers
    base_front_wall=70.0,   # the coolant trough and outlet run through it
    # The base's lower outside edge beveled (in, up), 1-1/2 x 2-1/2 in: its outside face reads as a 46 mm
    # slab, the pockets keep clear of it, and the mold's bevel strips are a 2x3 ripped corner to corner
    # (or printed). It costs no stiffness (design notes).
    base_bevel=(38.1, 63.5),
    # Uprights are raked buttresses (from the frame topology optimization, analysis/): the foot runs
    # forward along the base and the front face slopes up to just ahead of the beam.
    upright_t=80.0, upright_d=180.0, upright_front=40.0,
    upright_foot=260.0, upright_top_front=70.0,   # foot front / top front, mm ahead of the beam face
    upright_nose=20.0, upright_nose_r=12.0,       # blunt toe: vertical nose, rounded into the slope
    # The back face rakes too, the foot running 40 mm behind the beam's back: the upright reads as a tapered
    # buttress instead of a block, and it is stiffer (+1-2 %, design notes). The enclosure's rail is 10 mm behind it.
    upright_back_rake=40.0,
    # Upright skeleton, all stock: a 3/8 x 2 in flat-bar foot, two 2x2 tube columns (a tie rod inside each,
    # screwed into the top plate's lower bar) and the top plate
    column_ys=(35.0, 45.0),  # column center lines: this far behind the upright's top front / ahead of its back
    toe_rod=35.5,            # the toe tie rod, mm behind the foot's front edge; its nut sits on the foot plate
    column_len=206.4,        # 8-1/8 in, bought at length: 5 mm short, bedded in thickened epoxy on the foot bar
    beam_d=140.0, beam_h=146.05, beam_back_r=40.0, edge_r=6.0,  # 5 in face bar between two 3/8 in end bars
    # Outside edge rounds (quarter-round strips in the mold corners): castings' outer edges,
    # the beam's lower back edge (meets the uprights' back faces) and its rail-face edges
    round_r=10.0, beam_back_low_r=10.0, beam_face_r=3.0,

    # Cast-in steel and joints (tube = (size, wall)): US stock sizes in stock lengths, so
    # nothing is cut to length: 2 x 2 x 3/16 in (the upright and pedestal columns: the heavier wall is
    # steel in place of alumina grit) and 1-1/2 x 1-1/2 x 1/8 in mild steel.
    frame_tube=(50.8, 4.7625), post_tube=(38.1, 3.175),
    # Bought lengths, nothing cut: 12 in base (the split sockets), 18 in beam, 6 in spigots.
    tube_len=dict(base=304.8, spigot=152.4),
    # Real tube isn't nominal. A supplier's saw cut is good to about +/-1/8 in, and A500 tube is
    # +/-0.5 mm across the flats with a +/-10 % wall and a weld seam inside. So every cast-in piece is
    # set from one end (its datum) and its other end has room in the casting (the report checks it
    # against tube_cut_tol), and every printed part that slips on or into a tube has tube_fit a side
    # and clears the seam. Once the steel is here, caliper it, put the real sizes in frame_tube and
    # post_tube (outside across the flats, (outside - inside) / 2), set tube_fit to 0.25 and re-run
    # before printing those parts.
    tube_cut_tol=3.2, tube_fit=0.5, tube_seam=(6.0, 1.2),   # seam relief (width, depth) in printed faces
    stud_tol=1.6,        # a bought stud's length, +/-1/16 in
    # Printed PETG spigot sleeves (1-1/2 in spigot in the 2 in tube), this long in each tube.
    # The uprights have no posts: the tie rods clamp each foot to the base through steel, friction under
    # that clamp carries the side load, and two dowels per foot, grouted into oversize holes in the upright
    # at first assembly, locate it (the grout takes up whatever the two molds differ by).
    spigot_sleeve=70.0,
    # Legs: 6 in pieces of the 1-1/2 in tube cast into the base corners, with threaded inserts
    # for the leveling feet. The coolant sump slides in underneath, between them.
    leg_len=152.4, leg_embed=35.0,
    # Leg centers in from the base's sides, front and back: tucked in behind the bevel, which shortens the
    # span the base bends over between its feet (modes +11-31 %). The rear pair stays clear of the pedestal bars.
    leg_inset=(65.0, 65.0, 62.0),
    # O-ring cord seals at the epoxy-to-epoxy joints: the faces still bear on each other,
    # the cord sits in a groove (3 mm cord, 4 x 2.3 groove = ~25 % squeeze)
    gasket_cord=3.0, gasket_groove=(4.0, 2.3), gasket_split_z=92.0,
    # Joint hardware in hardware-store inch sizes: 1/2-13 rod, couplers and nuts, 3/8-16 grade 8
    # beam bolts, 3/8 in dowels.
    tie_rod_d=12.7, beam_bolt_d=9.525, dowel_d=9.525, dowel_proud=15.0,
    # The uprights are tied to steel top and bottom. Each top plate is two 1/2 x 2-1/2 in flat bars: the
    # lower one is tapped for the beam's studs and for the two column tie rods. At the bottom every tie rod
    # runs right through the base pedestal to its bottom bar, nut and washer below it. So the beam, the top
    # plate, the columns, the pedestal and the rods are one steel chain, with the epoxy granite clamped in
    # it, and there is no thread in the epoxy granite to come loose: every nut can be retightened.
    top_plate_t=25.4, plate_layer=12.7,
    beam_stud=190.5,         # the beam's eight 3/8-16 grade B7 studs, 7-1/2 in bought at length, screwed into the top plates
    drip_shield_t=3.0,       # ACM offcut over the X rails; the front studs' nuts clamp it to the beam top
    beam_bar_t=19.05,        # the beam's 5 in face and back bars, 3/4 in: steel in place of alumina grit (design notes)
    beam_spacer=63.5,        # 1/2 in x 2-1/2 in pipe nipples between the beam's face and back bars
    rod_tail=6.0,            # rod past its far nut; the rods are B7 studs bought in 1/4 in steps, and the step ends up here
    slope_pocket_d=32.0,     # toe tie-rod nut pocket, down to the foot plate
    # In the uprights the tie-rod holes are cast on 5/8 in rods (1.6 mm clearance a side) and the base
    # dowel's hole is 1/2 in, grouted with the posts: the uprights' own mold sets them.
    up_rod_hole=15.875, up_dowel_hole=12.7,
    beam_bolt_hole=12.7,     # the beam's cap-screw holes, cast on 1/2 in rods (1.6 mm a side over 3/8 in)
    plate_dowel_hole=14.0,   # the beam's dowels in the top plates: oversize, grouted at assembly
    # Cast-in threaded inserts (thread, outer diameter, length): the risers are bedded in epoxy
    # AND held down by counterbored low-head M5 screws under the rail; the BK/BF supports bolt
    # straight into M6 inserts. Nothing bolts to the cast-in tubes.
    # On the beam face the X BK/BF sit over the front beam tube, so they bolt to steel pads
    # (1/4 x 2-1/2 in flat bar, tapped M6) cast flush into the face against the tube.
    insert_m5=(5.0, 8.0, 12.0), insert_m6=(6.0, 10.0, 15.0), riser_cbore=(9.5, 4.5),
    side_clear=10.0,

    # Spindle: GDZ80-2.2 water-cooled, ER20, in the 80 mm cast foot clamp (bore 50 off the foot)
    clamp_off=50.0, clamp_lift=5.0, tool_stickout=30.0,

    # Enclosure: 2020 frame bolted to the base top, 4 mm polycarbonate, lift-up front door.
    # The base footprint matches the enclosure; its sealed top is the coolant floor.
    foot_h=20.0, enc_clear=15.0, panel_t=4.0, door_lap=30.0,
    motor_cutout=72.0,

    # Molds: melamine board (measure yours: the printed saddles and brackets are drawn for it), every
    # wall this much taller than its casting, so all the bolts go through above the pour line.
    mold_board=19.05, mold_freeboard=25.0,    # Home Depot 3/4 in white melamine is a true 0.750 in
    # XPS foam (one 2 in board) instead of PETG for the base pocket cores (only their posts are printed):
    # hidden, and they only need to be within a millimeter or two. False prints them
    # (about 1.4 kg more PETG). foam_formers also cuts the coolant trough and gutters and the beam's back
    # edge from foam; they shape faces you see and drain coolant, so they print by default.
    foam=True, foam_formers=False,

    eg_density=2.35,     # kg/L, epoxy granite
    # Aluminum oxide grit for the coarse sand in the beam and uprights, same volume (analysis/alumina.py):
    # about +9 % frame stiffness for $110. The 3/4 in beam bars and 3/16 in column walls give more for about
    # half that, so the mix is plain sand everywhere and the grit is an option, decided before the pour:
    # alumina=(('brown #16 (coarse sand)', 0.275, 3.95 / 2.65),).
    # (name, share of the sand mix by weight, density relative to sand)
    alumina_castings=('Upright', 'Beam'),
    alumina=(),
    eg_epoxy_frac=0.085,  # epoxy mass fraction, with well-graded aggregate + whiting (calcium carbonate) fines;
                          # check it with the jar test and test bars (build guide)
)

# rgb, shininess (0..1), transparency (0..100)
LOOKS = {
    'granite': ((0.50, 0.50, 0.52), 0.05, 0),     # as cast: gray aggregate and whiting in clear epoxy
    'steeltube': ((0.36, 0.38, 0.42), 0.35, 0),
    'alu': ((0.80, 0.81, 0.84), 0.45, 0),
    'steel': ((0.62, 0.64, 0.68), 0.70, 0),
    'black': ((0.13, 0.13, 0.14), 0.30, 0),
    'motor': ((0.09, 0.09, 0.10), 0.20, 0),
    'seal': ((0.70, 0.12, 0.10), 0.20, 0),
    'brass': ((0.80, 0.62, 0.30), 0.60, 0),
    'spindle': ((0.86, 0.87, 0.89), 0.60, 0),
    'tin': ((0.86, 0.68, 0.22), 0.70, 0),
    'rubber': ((0.08, 0.08, 0.08), 0.00, 0),
    'granite_hi': ((0.62, 0.63, 0.65), 0.05, 0),  # lighter castings in the frame-only renders
    'gasket_hi': ((0.10, 0.45, 1.00), 0.10, 0),   # gaskets highlighted in the frame renders
    'extrusion': ((0.17, 0.17, 0.18), 0.35, 0),
    'panel': ((0.70, 0.82, 0.92), 0.80, 72),
    'acm': ((0.80, 0.81, 0.82), 0.25, 0),
    'tank': ((0.88, 0.89, 0.90), 0.20, 35),
    'mesh': ((0.70, 0.72, 0.75), 0.50, 45),
    'filter': ((0.95, 0.95, 0.90), 0.00, 20),
    'hose': ((0.20, 0.45, 0.80), 0.30, 0),
    'drainhose': ((0.85, 0.86, 0.80), 0.30, 30),
    'locline': ((0.15, 0.32, 0.72), 0.30, 0),
    'printed': ((0.95, 0.45, 0.10), 0.25, 0),
    'printed_dark': ((0.50, 0.50, 0.52), 0.05, 0),   # printed in gray to match the castings (pocket caps)
    'shim': ((0.80, 0.81, 0.84), 0.85, 0),
    'wood': ((0.74, 0.58, 0.40), 0.10, 0),
    'melamine': ((0.93, 0.93, 0.90), 0.30, 62),   # mold boards, see-through in the renders
    'foam': ((0.45, 0.68, 0.92), 0.05, 30),       # XPS foam mold pieces
}
SHADED = ('granite',)   # drawn without edge lines


class Frame:
    """Local coordinates: u along the axis, v across it, w away from the mounting face."""

    def __init__(self, origin, u, v):
        u, v, o = Vector(*u), Vector(*v), Vector(*origin)
        w = u.cross(v)
        self.m = Matrix(u.x, v.x, w.x, o.x,
                        u.y, v.y, w.y, o.y,
                        u.z, v.z, w.z, o.z,
                        0, 0, 0, 1)

    def place(self, s):
        s = s.copy()
        s.transformShape(self.m)
        return s


class Model:
    def __init__(self):
        self.parts = []
        self.bom = []
        self.cutlist = []
        self.coupler_len = {}
        self.dims = {}
        self.warnings = []
        self.frame_container = 'FrameBaseRear'
        self.dynamic = []
        self.structure = set()   # castings, cast-in steel, joint hardware, gaskets
        self.anchors = []        # (point on the casting face, unit normal out of it, insert)
        self.plates = []         # flat bar in the skeletons (skeleton.Plate)
        self.base_tapped = []    # (plate, container): base plates cast_anchors taps, then adds
        self.tubes = []          # stock tube in the skeletons (skeleton.Tube)

    def add_dynamic(self, name, look, fn, container, touches=()):
        """A part whose shape depends on the axis positions: fn(x, y, z) -> shape or None.

        Way covers, the cable chain and the nozzle hose. `touches` names parts it is
        attached to (ignored by the collision check).
        """
        self.dynamic.append(dict(name=name, look=look, fn=fn, container=container, touches=set(touches)))

    def add(self, name, group, shape, look, comp=None, container=None, proxy=None):
        """proxy: smaller shapes used instead of `shape` by the collision check (hollow or sprawling parts).

        Fixed ('frame') parts without a container go to frame_container: the casting they bolt to.
        """
        if container is None and group == 'frame':
            container = self.frame_container
        self.parts.append(dict(name=name, group=group, shape=shape, look=look, comp=comp or name,
                               container=container, proxy=proxy or [shape]))

    def add_all(self, prefix, group, pieces, place=None, container=None):
        for suffix, shape, look in pieces:
            self.add(prefix + suffix, group, place(shape) if place else shape, look, comp=prefix, container=container)


# --------------------------------------------------------------------------
# Axes
# --------------------------------------------------------------------------
def riser_holddowns(length, pitch=60.0, end=20.0):
    """Hold-down screw positions along a rail: midway between rail screws, from each end inward
    every 120 mm (mirrored), so they sit under the rail between its own screws."""
    n = int((length - 2 * end) // pitch) + 1
    last = (n - 1) * pitch / 2 - pitch / 2         # outermost midpoint
    us = []
    u = last
    while u > -1e-6:
        us += [u, -u] if u > 1e-6 else [0.0]
        u -= 2 * pitch
    return sorted(us)


def rail_pair(m, f, tag, t, length, spacing, blk_pitch, rail_group, blk_group, rail_u0=0.0, blk_u0=0.0):
    for side, v in (('L', -spacing / 2), ('R', spacing / 2)):
        u0, u1 = rail_u0 - length / 2, rail_u0 + length / 2
        riser = parts.plate(u0, u1, v - P['riser_w'] / 2, v + P['riser_w'] / 2, 0, t, 0.6)
        if rail_group == 'frame':
            # counterbored M5 hold-downs into cast-in inserts; the heads sit below the rail
            cb_d, cb_h = P['riser_cbore']
            for u in riser_holddowns(length):
                uu = rail_u0 + u
                riser = riser.cut([parts.cyl_w(2.75, -1, t + 1, uu, v), parts.cyl_w(cb_d / 2, t - cb_h, t + 1, uu, v)])
                m.anchors.append((f.m.multVec(Vector(uu, v, 0)), f.m.multVec(Vector(0, 0, 1)) - f.m.multVec(Vector(0, 0, 0)),
                                  'insert_m5'))
        m.add(f'{tag}_Riser{side}', rail_group, f.place(riser), 'steeltube')
        m.add(f'{tag}_Rail{side}', rail_group, f.place(parts.hgr15_rail(length).translated(Vector(rail_u0, v, t))), 'steel')
        for i, du in enumerate((-blk_pitch / 2, blk_pitch / 2)):
            off = Vector(blk_u0 + du, v, t)
            m.add_all(f'{tag}_Block{side}{i + 1}', blk_group, parts.hgh15_block(), lambda s: f.place(s.translated(off)))


def screw_axis(m, f, tag, kind, length, u0, bf, bk, fixed_group, nut_group, nut_u, carrier_w, motor_min_u, motor,
               bracket=None):
    """Ballscrew, BF/BK supports, coupler, bracket and motor on fixed_group; nut + housing on nut_group.

    u0 is the BF outer face; length is the overall machined screw length. The nut housing
    bolts under the moving part at w = carrier_w. Returns the motor face position along u.
    bracket: an integrated HM bearing seat + motor bracket (parts.HM) in place of the BK and kit bracket, its
    bearing end where the BK's inner face would be, so the BK-machined screw end fits it.
    """
    a = parts.SUPPORT[bk]['h']
    e = parts.ENDS[kind]
    place = f.place
    screw, u1, s0, s1 = parts.ballscrew(kind, u0, length, bf, bk, a)
    m.add(f'{tag}_Screw', fixed_group, place(screw), 'steel')
    m.add_all(f'{tag}_{bf}', fixed_group, parts.support(bf, u0, a, e['bf_a'] / 2), place)
    ub = u1 - parts.SUPPORT[bk]['L']
    if bracket:
        m.add(f'{tag}_MotorBracket', fixed_group, place(parts.hm_bracket(bracket, ub)), 'black')
        m.add(f'{tag}_LockNut', fixed_group, place(parts.ring_u(parts.SUPPORT[bk]['lock'][0], e['bk_a'] / 2, u1,
                                                                u1 + parts.SUPPORT[bk]['lock'][1], 0, a)), 'black')
    else:
        m.add_all(f'{tag}_{bk}', fixed_group, parts.support(bk, ub, a, e['bk_a'] / 2, lock_r=e['bk_a'] / 2), place)
    if fixed_group == 'frame':
        # the BF and the BK (or HM bracket) bolt into M6 holes tapped in the steel of the base top / beam face
        n = f.m.multVec(Vector(0, 0, 1)) - f.m.multVec(Vector(0, 0, 0))
        sp = parts.SUPPORT[bf]
        pts = [(u0 + c, v) for c in sp['C'] for v in (-sp['P'] / 2, sp['P'] / 2)]
        if bracket:
            pts += parts.hm_holes(bracket, ub)
        else:
            sp = parts.SUPPORT[bk]
            pts += [(ub + c, v) for c in sp['C'] for v in (-sp['P'] / 2, sp['P'] / 2)]
        for u, v in pts:
            m.anchors.append((f.m.multVec(Vector(u, v, 0)), n, 'insert_m6'))

    shaft_r = parts.MOTORS[motor]['shaft_d'] / 2
    if bracket:
        # The bracket sets the motor face; the coupler bridges the stub and the motor shaft, centered on the gap.
        hm = parts.HM[bracket]
        face = ub + hm['L']
        tip, lo, hi = face - parts.SHAFT_LEN, *hm['coupler']
        span = min(max(tip + 15.0 - (s1 - 15.0), lo), hi)
        c0 = (s1 + tip) / 2 - span / 2
        c1 = c0 + span
        if min(s1 - c0, c1 - tip) < 10.0:
            m.warnings.append(f'{tag}: the {span:.0f} mm coupler takes only {min(s1 - c0, c1 - tip):.0f} mm of the '
                              f'stub or the motor shaft')
        m.coupler_len[tag] = span
    else:
        # The motor shaft (21 long) reaches 15 into the 30 mm coupler that sits on the stub.
        c0 = s0
        face = max(c0 + 30.0 + parts.SHAFT_LEN - 15.0, motor_min_u)
        c1 = face - (parts.SHAFT_LEN - 15.0)
        if c1 - c0 > 30.5:
            m.warnings.append(f'{tag}: motor pushed out to clear the moving parts; needs a {c1 - c0:.0f} mm '
                              f'coupler or a {length + c1 - c0 - 30:.0f} mm screw')
        m.coupler_len[tag] = c1 - c0
        m.add(f'{tag}_MotorBracket', fixed_group, place(parts.motor_bracket(u1, face, a)), 'black')
    if face < motor_min_u:
        m.warnings.append(f'{tag}: the bracket puts the motor {motor_min_u - face:.0f} mm into the moving parts')
    m.add(f'{tag}_Coupler', fixed_group, place(parts.coupler(c0, c1, a, e['stub'] / 2, shaft_r)), 'alu')
    m.add_all(f'{tag}_Motor', fixed_group, parts.nema23(face, a, motor), place)

    m.add(f'{tag}_Nut', nut_group, place(parts.sfu_nut(kind, nut_u, a)), 'steel')
    m.add_all(f'{tag}_NutHousing', nut_group, parts.nut_housing(kind, nut_u, a, carrier_w), place)
    return face


def fillet_safe(shape, radii, pred):
    """Fillet with the first radius OCC accepts."""
    for r in radii:
        out = parts.soften(shape, r, pred)
        if out is not shape:
            return out
    return shape


def on_z(z):
    return lambda e: all(abs(v.Point.z - z) < 1e-6 for v in e.Vertexes)


def on_y(y):
    return lambda e: all(abs(v.Point.y - y) < 1e-6 for v in e.Vertexes)


def hex_y(af, x, y0, length, z):
    """Hex prism (nut) along +y from y0."""
    h = parts.hexagon(af, 0.0, length)
    h.rotate(Vector(0, 0, 0), Vector(1, 0, 0), -90)
    h.translate(Vector(x, y0, z))
    return h


def frame_layout(d):
    """Positions shared by the castings, the cast-in steel and the joints."""
    g = dict(d)
    g['ux'] = (d['inner'] + d['outer']) / 2                    # upright center line
    g['rod_y'] = (d['up_y0'] + d['up_y1']) / 2                 # middle of the upright's top
    g['pocket_bot'] = d['beam_bot'] - P['top_plate_t']         # underside of the upright's top plate
    g['up_front'] = d['beam_face'] - P['upright_foot']         # front of the upright foot
    g['up_top_front'] = d['beam_face'] - P['upright_top_front']
    g['up_back_foot'] = d['up_y1'] + P['upright_back_rake']    # back of the upright foot
    g['foot_top'] = d['base_top'] + T38                        # top of the upright's foot plate (3/8 in)
    # tie rods (x, y, nut seat), all on the upright's center line: one inside each column (nut in the
    # top plate) and one at the toe (nut on the foot plate, in a pocket from the slope)
    g['columns'] = (d['up_y0'] + P['column_ys'][0], d['up_y1'] - P['column_ys'][1])
    nut_seat = d['beam_bot'] - P['plate_layer']
    g['tie_rods'] = [(g['ux'], cy, nut_seat) for cy in g['columns']]
    g['tie_rods'].append((g['ux'], g['up_front'] + P['toe_rod'], g['foot_top']))
    g['dowel_ys'] = (g['columns'][0] - 64.5, sum(g['columns']) / 2)   # the two base dowels under each upright
    g['bolt_xs'] = (g['ux'] - 22.0, g['ux'] + 22.0)            # beam cap screws
    g['bolt_ys'] = (d['beam_face'] + 25.0, d['beam_face'] + P['beam_d'] - 25.0)
    g['beam_dowel_y'] = d['beam_face'] + 70.0
    # base grid: a girder under each Y rail (web 12 mm outboard of the rail line, clear of the riser
    # hold-downs), a pedestal under each upright, cross plates at the split, the Y ballscrew supports and
    # the front; the draw rods run along the girders from the front face to the back face
    g['rail_x'] = g['girder_x'] = g['draw_rod_x'] = P['table_rail_spacing'] / 2   # girder tube under each rail
    g['pin_x'] = P['table_rail_spacing'] / 2 + 32.0                               # split dowel pins, beside it
    g['front_web'] = d['base_y0'] + 56.5                       # front cross plate (y of its front face)
    g['rear_end'] = d['base_y1'] - 29.5                        # girders' rear end plates (y of their front face)
    y_tail = parts.ENDS['SFU1605']['bk_e'] - parts.SUPPORT['BK12']['L'] + parts.ENDS['SFU1605']['stub_l']
    g['y_bf'] = d['y_bk'] - (P['table_screw_len'] - y_tail) + parts.SUPPORT['BF12']['L'] / 2   # BF12 center line
    g['y_bkc'] = d['y_bk'] - parts.SUPPORT['BK12']['L'] / 2                                       # BK12 center line
    g['split'] = P['base_split_y']
    g['outlet'] = (0.0, d['base_y0'] + max(30.0, P['base_bevel'][0] + 15.0))   # coolant drain (x, y): straight down into the sump
    ix, iy0, iy1 = P['leg_inset']
    g['legs'] = [(sx * (d['base_half'] - ix), y) for y in (d['base_y0'] + iy0, d['base_y1'] - iy1) for sx in (-1, 1)]
    g['gasket_len'] = 0.0
    g['draw_z'] = d['base_top'] - T38 - GIRDER[1] / 2              # the girders' center (and their draw rods)
    g['tie_z'] = d['base_top'] - T38 - CROSS / 2 - 3.5               # the cross tubes' center (and their rods)
    return g


GIRDER = (50.8, 76.2, 3.175)      # 2 x 3 x 1/8 in rectangular tube (wide, tall, wall)
CROSS = 38.1                      # 1-1/2 x 1-1/2 x 1/8 in square tube


BEVEL_WOOD = ('Or, instead of printing the strips: rip a 2x3 corner to corner on a table saw and screw the halves '
              'to the wall from outside (#8 x 1-1/4 in, every 150 mm).')
BASE_BRIDGES = {'base-front': (-230.0, -130.0, -60.0), 'base-rear': (100.0, 170.0, 280.0)}   # y of the base mold's bridges


class Steel:
    """Collects cast-in steel and joint hardware for the mass total."""

    def __init__(self, m):
        self.m, self.volume = m, 0.0

    def add(self, name, container, shape, look='steeltube'):
        self.m.add(name, 'frame', shape, look, container=container)
        self.m.structure.add(name)
        if look != 'printed':
            self.volume += shape.Volume

    def plug(self, name, container, axis, c1, c2, size, a0, a1, closed):
        """Printed end plug that keeps the casting out of a hollow tube: a cup, closed (2 mm) at the
        tube's end (`closed`, a0 or a1) and open toward the inside of the tube. `size` is the tube's
        inside; the cup is tube_fit a side smaller, with rounded corners and seam grooves."""
        s = size - 2 * P['tube_fit']
        env, _ = parts.square_tube(axis, c1, c2, s, 2.5, a0, a1)      # 3.75 mm corner rounds
        b0, b1 = (a0 + 2.0, a1 + 1.0) if closed == a0 else (a0 - 1.0, a1 - 2.0)
        cup = env.cut(parts.square_tube(axis, c1, c2, s - 4.8, 0.1, b0, b1)[0])
        self.add(name, container, seam_relief(cup, axis, c1, c2, s, a0, a1), 'printed')


def seam_relief(shape, axis, c1, c2, s, a0, a1):
    """Groove down the middle of each outside face of a printed square section (size s, along
    `axis` from a0 to a1, centered on (c1, c2)) that goes inside a steel tube: clears the weld seam."""
    w, dp = P['tube_seam']
    h = s / 2
    cuts = []
    for p0, p1, q0, q1 in ((h - dp, h + 1, -w / 2, w / 2), (-h - 1, -h + dp, -w / 2, w / 2),
                           (-w / 2, w / 2, h - dp, h + 1), (-w / 2, w / 2, -h - 1, -h + dp)):
        if axis == 'x':
            cuts.append(parts.box(a0 - 1, a1 + 1, c1 + p0, c1 + p1, c2 + q0, c2 + q1))
        elif axis == 'y':
            cuts.append(parts.box(c1 + p0, c1 + p1, a0 - 1, a1 + 1, c2 + q0, c2 + q1))
        else:
            cuts.append(parts.box(c1 + p0, c1 + p1, c2 + q0, c2 + q1, a0 - 1, a1 + 1))
    return shape.cut(cuts)


def chamfered(x0, x1, y0, y1, c):
    """Rectangle outline (x, y) with 45-degree corner chamfers c."""
    return [(x0 + c, y0), (x1 - c, y0), (x1, y0 + c), (x1, y1 - c), (x1 - c, y1), (x0 + c, y1), (x0, y1 - c), (x0, y0 + c)]


def bevel_clamp(pockets, g):
    """Pull the pockets in clear of the beveled lower edge (20 mm of casting inside it), dropping any
    that end up too narrow to bother with."""
    bi = P['base_bevel'][0]
    if bi <= 0:
        return pockets
    lim = bi + 20.0
    x1, y0, y1 = g['base_half'] - lim, g['base_y0'] + lim, g['base_y1'] - lim
    out = []
    for poly, z, name in pockets:
        pts = [(math.copysign(min(abs(x), x1), x), min(max(y, y0), y1)) for x, y in poly]
        pts = [p for i, p in enumerate(pts) if p != pts[i - 1]]
        xs, ys = [x for x, _ in pts], [y for _, y in pts]
        if max(xs) - min(xs) >= 25.0 and max(ys) - min(ys) >= 25.0:
            out.append((pts, z, name))
    return out


def rounded_rect(x0, x1, y0, y1, r, z):
    """Closed wire: a rectangle with corner radius r at height z, always started at the same corner."""
    c = [(x1 - r, y0 + r, -90), (x1 - r, y1 - r, 0), (x0 + r, y1 - r, 90), (x0 + r, y0 + r, 180)]
    edges = []
    for i, (cx, cy, a) in enumerate(c):
        pts = [Vector(cx + r * math.cos(math.radians(a + t)), cy + r * math.sin(math.radians(a + t)), z) for t in (0, 45, 90)]
        edges.append(Part.Arc(*pts).toShape())
        nx, ny, na = c[(i + 1) % 4]
        edges.append(Part.LineSegment(pts[2], Vector(nx + r * math.cos(math.radians(na)), ny + r * math.sin(math.radians(na)), z)).toShape())
    return Part.Wire(edges)


def base_pockets(g):
    """Underside pockets of the base: (outline [(x, y), ...], pocket top z, name). All open to the
    bottom, so the cores (printed shells or foam) pull straight out.

    The layout follows the topology optimization in analysis/ (see the design notes): two full-depth girders
    under the table rails, a full-depth tie between them behind the split, solid knees from
    the girders out under the upright feet, and thin skin nearly everywhere else.
    """
    top, half, y0, y1 = g['base_top'], g['base_half'], g['base_y0'], g['base_y1']
    zp = top - P['base_core_skin']
    s2, gw = P['table_rail_spacing'] / 2, P['base_girder_w'] / 2
    gi, go = s2 - gw, s2 + gw                       # girder inner and outer faces
    yf0, yf1 = y0 + P['base_front_wall'], g['split'] - P['split_wall']
    tie = g['split'] + P['base_tie_rear']
    ry = g['rod_y']
    foot = g['up_front']
    sw = P['split_wall'] + 10.0                      # full-depth band either side of the split
    ob = g['ux'] + 38.1 + 9.0                        # outboard of the pedestal (and the cross-rod nuts)
    bfw = g['y_bf'] + 12.0                           # the BF12 cross plate, just behind the screws
    leg_y = g['legs'][0][1] + P['post_tube'][0] / 2  # back face of the front legs
    out = [(chamfered(-gi, gi, yf0, bfw - 20.0, 10.0), zp, 'center-a'),       # front, between the girders
           (chamfered(-gi, gi, bfw + 20.0, g['split'] - P['base_tie'], 10.0), zp, 'center-b'),
           (chamfered(-gi + 6, gi - 6, tie, 245.0, 30.0), zp, 'center')]   # rear, clear of the cross rods' nuts
    for sx in (-1, 1):
        if P['base_foot_pockets']:
            # Under the upright feet: a full-depth rib across the foot's front end, another along the
            # split, and pockets between them that keep clear of the solid band under each upright's
            # center line, where the tie rods run down to the steel anchor bar.
            # The outboard pocket runs up to the front rib.
            cx = g['ux'] - 38.1 - 12.0                    # inboard of the pedestal
            sock = g['up_y0'] - 0.5                          # a rib across the foot
            front_end = foot + 10.0
            feet = [(chamfered(go + 6.0, cx, g['split'] + sw, sock - 5.0, 10.0), zp, 'foot-b')]
            knee_y0, outer_y0 = sock + 5.0, sock + 15.0
        else:
            front_end, feet, knee_y0, outer_y0 = foot - 20.0, [], tie, 60.0
        side = [
            (chamfered(go + 10.0, half - 40.0, max(yf0, leg_y + 12.0), front_end - 20.0, 10.0), zp, 'outboard'),  # front, outboard
            (chamfered(go + 5.0, 236.0, y0 + 15.0, yf0, 10.0), 40.0, 'trough-band'),      # under the coolant trough band
            (chamfered(ob, half - 8.0, yf0, yf1 - 5.0, 8.0), 40.0, 'draw-rod'),            # under the front draw rods
        ] + feet + [
            (chamfered(go, g['inner'] - 5.0, knee_y0, g['y_bkc'] - 34.0, 10.0), 40.0, 'knee'),   # under the knee, inboard of the pedestal
            (chamfered(ob, half - 8.0, outer_y0, ry - 32.0, 8.0), 65.0, 'outer-a'),        # outboard of the anchor bar,
            (chamfered(ob, half - 8.0, ry + 32.0, 312.0, 8.0), 65.0, 'outer-b'),           # either side of the rods
            (chamfered(go + 15.0, 230.0, 318.0, y1 - 10.0, 10.0), zp, 'rear'),            # behind the feet, outboard of the girder
        ]
        for poly, z, name in side:
            pts = [(sx * x, y) for x, y in poly]
            out.append((pts if sx > 0 else pts[::-1], z, f"{name}-{'R' if sx > 0 else 'L'}"))
    return bevel_clamp(out, g)


def base_envelope(g, front, edges=True):
    """Outside shape of a base half, before any cuts (the mold cavity). edges=False leaves off the
    small edge rounds (the mold fillers only need the big corner radii)."""
    half, base_top, ys = g['base_half'], g['base_top'], g['split']
    ya, yb = (g['base_y0'], ys) if front else (ys, g['base_y1'])
    outer_y = ya if front else yb
    blk = parts.box(-half, half, ya, yb, 0, base_top)
    blk = parts.soften(blk, P['base_corner_r'], lambda e: parts.parallel((0, 0, 1))(e) and on_y(outer_y)(e))
    bi, bh = P['base_bevel']
    if bi > 0:
        # the bevel: a ruled loft from the outline pulled in at the underside up to the full outline
        r, y0, y1 = P['base_corner_r'], g['base_y0'], g['base_y1']
        low = rounded_rect(-half + bi, half - bi, y0 + bi, y1 - bi, r - bi, 0.0)
        high = rounded_rect(-half, half, y0, y1, r, bh)
        keep = Part.makeLoft([low, high], True, True).fuse(Part.Face(high).extrude(Vector(0, 0, base_top - bh + 1)))
        blk = blk.common(keep).removeSplitter()
    if not edges:
        return blk
    blk = fillet_safe(blk, (P['round_r'], P['edge_r'], 3.0), lambda e: on_z(base_top)(e) and not on_y(ys)(e))
    if bi > 0:
        blk = fillet_safe(blk, (P['round_r'], 6.0), lambda e: on_z(bh)(e) and not on_y(ys)(e))
    return fillet_safe(blk, (2.0,), lambda e: on_z(0.0)(e) and not on_y(ys)(e))


def base_top_formers(g, front):
    """Recesses in a base half's top face (named solids): the side gutters, the coolant trough
    (front) and, with a short Y bracket, the table-motor relief (rear). Cut from the casting; printed as mold formers."""
    half, base_top, ys = g['base_half'], g['base_top'], g['split']
    ya, yb = (g['base_y0'], ys) if front else (ys, g['base_y1'])
    out = []
    # Coolant floor: a trough across the front, falling toward the outlet, fed by side gutters
    # that run between the uprights and the enclosure walls.
    gx0, gx1 = half - 35.0, half - 20.0
    gy0, gy1 = g['base_y0'] + 20.0, g['base_y1'] - 20.0
    side = [(gy0, base_top + 1), (gy0, base_top - 15), (gy1, base_top - 8), (gy1, base_top + 1)]
    for sx in (-1, 1):
        xa = min(sx * gx0, sx * gx1)
        gutter = Part.Face(Part.makePolygon([Vector(xa, y, z) for y, z in side] + [Vector(xa, *side[0])])).extrude(
            Vector(gx1 - gx0, 0, 0))
        out.append((f"gutter-{'R' if sx > 0 else 'L'}", gutter.common(parts.box(-half, half, ya, yb, 0, base_top + 1))))
    if front:
        ox = g['outlet'][0]
        trough = [(-gx1, base_top + 1), (-gx1, base_top - 15), (ox, base_top - 25), (gx1, base_top - 18), (gx1, base_top + 1)]
        out.append(('trough', Part.Face(Part.makePolygon([Vector(x, gy0, z) for x, z in trough] +
                                                         [Vector(trough[0][0], gy0, trough[0][1])])).extrude(Vector(0, 35.0, 0))))
    elif not P['bracket_y'] or g['y_bk'] - parts.SUPPORT['BK12']['L'] + parts.HM[P['bracket_y']]['L'] < yb:
        # relief under the table motor, which hangs below the base top: from the bracket's motor end
        c = P['motor_cutout'] / 2
        y_m = g['y_bk'] - parts.SUPPORT['BK12']['L'] + parts.HM[P['bracket_y']]['L'] if P['bracket_y'] else g['y_bk']
        out.append(('motor-relief', parts.box(-c, c, y_m, yb + 1, base_top - 8, base_top + 1)))
    return out


def base_grid(m, g, st, front, cont, tag):
    """The steel grid of a base half, all stock, drilled from the templates and bolted: a 2x3 tube girder
    under each Y rail with a 3/8 x 1-1/2 in rail bar bolted on top (tapped for the riser hold-downs) and a
    3/8 x 3 in end plate at each end; a pedestal under each upright (3/8 x 2-1/2 in seat and bottom bars,
    a 2x2 tube spacer round each tie rod); and 1-1/2 in cross tubes, each clamped by a 1/2-13 rod through
    it and the tubes it joins: girder to girder (at the split, and under the Y ballscrew supports, whose
    3/8 x 2 in pads bolt on top) and girder to pedestal. The draw rods run inside the girders, from end
    plate to end plate, and clamp the halves together. Returns the plates and tubes cut from the casting,
    and the plates cast_anchors taps."""
    base_top, ys = g['base_top'], g['split']
    H = base_top - T38                               # underside of the bars on top
    gw, gh, gt = GIRDER
    gz = g['draw_z']
    tz = g['tie_z']
    sides = ((-1, 'L'), (1, 'R'))
    parts_, tapped = [], []
    gx = g['girder_x']
    if front:
        tube_y = (g['front_web'] + T38, ys - T38)
        bar_y = (g['front_web'], ys - 0.5)
        ends = [('Front', g['front_web']), ('Split', ys - T38)]
    else:
        tube_y = (ys + T38, g['rear_end'])
        bar_y = (ys + 0.5, g['rear_end'] + T38)
        ends = [('Split', ys), ('Back', g['rear_end'])]
    # cross rods (y): girder to girder at the split and under the supports, girder to pedestal beside each
    # pedestal column's tie rod
    tie_ys = ([ys - 34.0, g['y_bf'] + 12.0] if front else [ys + 34.0, g['y_bkc'] - 17.5])
    ped_ys = [y_ - 15.0 for _, y_, _ in g['tie_rods'] if (y_ < ys) == front]
    # through-bolts that hold each rail bar down on its girder: midway between the riser hold-downs, clear of
    # the cross rods
    holds = [P['table_rail_y'] + u for u in riser_holddowns(P['table_rail_len'])]
    marks = sorted([bar_y[0]] + [h_ for h_ in holds if bar_y[0] < h_ < bar_y[1]] + [bar_y[1]])
    bolt_ys = [(a + b) / 2 for a, b in zip(marks, marks[1:]) if b - a > 30
               and all(abs((a + b) / 2 - t_) > 13 for t_ in tie_ys + ped_ys)]
    girders = {}
    for sx, side in sides:
        x0 = sx * gx
        tube = sk.Tube(f'BaseGirder{tag}{side}', 'y', x0, gz, gw, gh, gt, *tube_y)
        rail = sk.flat_bar(f'BaseRailBar{tag}{side}', 'z', H, T38, x0 - 19.05, bar_y[0], x0 + 19.05, bar_y[1])
        for by in bolt_ys:
            for dx in (-12.0, 12.0):
                tube.drill('z', by, x0 + dx, 6.6, '1/4-20 bolt (rail bar)')
                rail.hole(x0 + dx, by, 6.6)
        for hy in (P['table_rail_y'] + u for u in riser_holddowns(P['table_rail_len'])):
            if tube_y[0] < hy < tube_y[1]:
                tube.drill('z', hy, x0, 6.5, 'relief under a riser hold-down', both=False)
        for kind, c0 in ends:
            e = sk.flat_bar(f'BaseGirderEnd{kind}{tag}{side}', 'y', c0, T38, x0 - 38.1, H - 76.2, x0 + 38.1, H - 12.7)
            e.hole(x0, gz, 14.3)
            if kind == 'Split':
                for dx in (-32.0, 32.0):
                    e.hole(x0 + dx, gz, 9.6)                 # dowel pins: glued in the rear plate, into the front one
            parts_.append(e)
        girders[side] = tube
        parts_.append(tube)
        tapped.append(rail)
    # pedestals under the uprights
    peds = {}
    for sx, side in sides:
        ux = sx * g['ux']
        rods = [(sx * x_, y_) for x_, y_, _ in g['tie_rods'] if (y_ < ys) == front]
        sy0, sy1 = (g['up_front'] + 12.5, ys - 12.0) if front else (ys + 12.0, g['up_y1'] - 12.5)
        seat = sk.flat_bar(f'BaseSeat{tag}{side}', 'z', H, T38, ux - 31.75, sy0, ux + 31.75, sy1)
        pbar = sk.flat_bar(f'BasePedestalBar{tag}{side}', 'z', 0.0, T38, ux - 31.75, sy0, ux + 31.75, sy1)
        cols = []
        for k, (x_, y_) in enumerate(rods):
            seat.hole(x_, y_, 14.3)
            pbar.hole(x_, y_, 14.3)
            c = sk.Tube(f'BasePedestalColumn{tag}{side}{k + 1}', 'z', x_, y_, P['frame_tube'][0], P['frame_tube'][0], P['frame_tube'][1],
                        T38, H)
            cols.append((y_, c))
            parts_.append(c)
        if not front:
            for dy in g['dowel_ys']:
                seat.hole(ux, dy, 9.6)
        peds[side] = cols
        parts_ += [seat, pbar]
    # cross tubes, each clamped by a 1/2-13 rod through it and the tubes it butts against
    ties, rods_ = [], []
    def cross(name, y, xa, xb, through):
        c = sk.Tube(name, 'x', y, tz, CROSS, CROSS, 3.175, xa, xb)
        for t_ in through:
            t_.drill('x', y if t_.axis == 'y' else tz, tz if t_.axis == 'y' else y, 14.3, '1/2-13 cross rod')
        ties.append((name, y, through))
        parts_.append(c)
        # the rod: through the cross tube and both tubes it joins, a washer and nut on each outside face
        lo = min(t_.env.BoundBox.XMin for t_ in through)
        hi = max(t_.env.BoundBox.XMax for t_ in through)
        tail = 13.6 + P['rod_tail']
        rod = parts.cyl_u(P['tie_rod_d'] / 2, lo - tail, hi + tail, y, tz)
        nuts = [parts.cyl_u(13.5, lo - 2.5, lo, y, tz).fuse(parts.cyl_u(11.0, lo - 13.6, lo - 2.5, y, tz)),
                parts.cyl_u(13.5, hi, hi + 2.5, y, tz).fuse(parts.cyl_u(11.0, hi + 2.5, hi + 13.6, y, tz))]
        st.add(name.replace('BaseCross', 'CrossRod'), cont, rod.fuse(nuts), 'steel')
        rods_.append(rod.fuse(nuts))
        return c
    inner_x = gx - gw / 2
    cross(f'BaseCrossSplit{tag}', tie_ys[0], -inner_x, inner_x, [girders['L'], girders['R']])
    cross(f'BaseCross{"BF" if front else "BK"}{tag}', tie_ys[1], -inner_x, inner_x, [girders['L'], girders['R']])
    for sx, side in sides:
        for k, ((y_, col), py) in enumerate(zip(peds[side], ped_ys)):
            a, b = sorted((sx * (gx + gw / 2), sx * (g['ux'] - 25.4)))
            cross(f'BaseCrossPed{tag}{side}{k + 1}', py, a, b, [girders[side], col])
    # pads for the Y ballscrew supports, bolted down onto their cross tube
    for nm, y_, _ in ties:
        if nm.startswith(('BaseCrossBF', 'BaseCrossBK')):
            bf = nm.startswith('BaseCrossBF')
            py0, py1 = (g['y_bf'] - 20.4, g['y_bf'] + 30.4) if bf else (g['y_bk'] - 50.8, g['y_bk'])
            if not bf and P['bracket_y']:
                # the HM bracket's six holes, the rear rollers' inner feet and the pad's own bolts, 8 mm in from
                # its edges, on the narrowest stock flat bar that covers them
                ub = g['y_bk'] - parts.SUPPORT['BK12']['L']
                ys_ = [ub + c for c in parts.HM[P['bracket_y']]['C']] + [y_ - 12.0] + \
                      [ub + parts.HM[P['bracket_y']]['L'] - parts.HM[P['bracket_y']]['E']] + \
                      [yy for _, yy in roller_layout()['tapped']]
                need = max(ys_) - min(ys_) + 16.0
                w_ = next(w for w in (50.8, 63.5, 76.2, 88.9, 101.6) if w >= need)
                py0 = (max(ys_) + min(ys_)) / 2 - w_ / 2
                py1 = py0 + w_
                if py1 > g['base_y1'] - 6.0:
                    py0, py1 = g['base_y1'] - 6.0 - w_, g['base_y1'] - 6.0
            pad = sk.flat_bar('BasePadBF' if bf else 'BasePadBK', 'z', H, T38, -45.0, py0, 45.0, py1)
            tube = next(p_ for p_ in parts_ if getattr(p_, 'name', '') == nm)
            by = y_ + (12.0 if bf else -12.0)
            for bx in (-32.0, 32.0):
                pad.hole(bx, by, 6.6)
                tube.drill('z', bx, by, 6.6, '1/4-20 bolt (pad)')
            # reliefs in the tube's top under the support's screws
            sup = parts.SUPPORT['BF12' if bf else 'BK12']
            us = (g['y_bf'] - sup['L'] / 2) if bf else (g['y_bk'] - sup['L'])
            for c_ in sup['C']:
                for vx in (-sup['P'] / 2, sup['P'] / 2):
                    if abs(us + c_ - y_) < CROSS / 2 - 4:
                        tube.drill('z', vx, us + c_, 7.0, 'relief under a support screw', both=False)
            tapped.append(pad)
    m.half_rods = rods_
    for p_ in parts_:
        st.add(p_.name, cont, p_.shape)
        if isinstance(p_, sk.Plate):
            m.plates.append(p_)
        else:
            m.tubes.append(p_)
    return parts_, tapped


def base_half(m, g, st, front):
    """Front or rear half of the base: its steel grid (base_grid) cast into epoxy granite. The halves
    meet at y = split, end plate to end plate, on dowel pins, clamped by the two draw rods."""
    half, base_top, ys = g['base_half'], g['base_top'], g['split']
    ya, yb = (g['base_y0'], ys) if front else (ys, g['base_y1'])
    tag, cont = ('Front', 'FrameBaseFront') if front else ('Rear', 'FrameBaseRear')
    blk = base_envelope(g, front)

    cuts = []
    for poly, z_top, _ in base_pockets(g):
        if (sum(y for _, y in poly) / len(poly) < ys) == front:
            face = Part.Face(Part.makePolygon([Vector(x, y, -1) for x, y in poly + poly[:1]]))
            cuts.append(face.extrude(Vector(0, 0, z_top + 1)))
    plates, tapped = base_grid(m, g, st, front, cont, tag)
    cuts += [pl.env if isinstance(pl, sk.Tube) else pl.slab for pl in plates + tapped]
    cuts += m.half_rods
    m.base_tapped += [(pl, cont) for pl in tapped]
    # draw rods: from a nut pocket in the front face to a nut pocket in the back face, beside the girders
    for sx, side in ((-1, 'L'), (1, 'R')):
        dx, dz = sx * g['draw_rod_x'], g['draw_z']
        if front:
            y0 = ya
            seat = g['front_web']
            cuts += [parts.cyl_v(16.0, y0 - 1, seat, dx, dz), parts.cyl_v(8.0, seat, ys + 1, dx, dz)]
            nut = hex_y(19.05, dx, seat - 13.6, 11.1, dz).fuse(parts.cyl_v(13.5, seat - 2.5, seat, dx, dz))
            st.add(f'DrawRodNut{tag}{side}', cont, nut.cut(parts.cyl_v(P['tie_rod_d'] / 2, seat - 20, seat + 1, dx, dz)), 'steel')
            rod = parts.cyl_v(P['tie_rod_d'] / 2, seat - 13.6 - P['rod_tail'], ys, dx, dz)
            st.add(f'DrawRod{side}', cont, rod, 'steel')
        else:
            seat = g['rear_end'] + T38
            cuts += [parts.cyl_v(8.0, ys - 1, seat, dx, dz), parts.cyl_v(16.0, seat, yb + 1, dx, dz)]
            nut = hex_y(19.05, dx, seat + 2.5, 11.1, dz).fuse(parts.cyl_v(13.5, seat, seat + 2.5, dx, dz))
            st.add(f'DrawRodNut{tag}{side}', cont, nut.cut(parts.cyl_v(P['tie_rod_d'] / 2, seat - 1, seat + 20, dx, dz)), 'steel')
            rod = parts.cyl_v(P['tie_rod_d'] / 2, ys, seat + 13.6 + P['rod_tail'], dx, dz)
            st.add(f'DrawRodRear{side}', cont, rod, 'steel')
        for k, dx in enumerate((-32.0, 32.0)):
            px = sx * g['girder_x'] + dx
            if not front:
                pin = parts.cyl_v(P['dowel_d'] / 2, ys - 12.7, ys + 12.7, px, dz)   # 3/8 x 1 in
                st.add(f'SplitPin{side}{k + 1}', cont, pin, 'steel')
                cuts.append(pin)
            else:
                cuts.append(parts.cyl_v(P['dowel_d'] / 2 + 0.05, ys - 13.2, ys + 0.1, px, dz))

    cuts += [shape for _, shape in base_top_formers(g, front)]
    if front:
        ox, oy = g['outlet']
        # drain: straight down through the front wall to a cast-in brass nipple over the chip basket
        cuts += [Part.makeCylinder(7.0, base_top - 25 + 1, Vector(ox, oy, 0)),
                 parts.hexagon(22.0, -0.5, 12.5, ox, oy)]
        nipple = parts.hexagon(22.0, 0.0, 12.0, ox, oy).fuse(Part.makeCylinder(8.0, 20.0, Vector(ox, oy, -20.0)))
        st.add('DrainOutlet', cont, nipple.cut(Part.makeCylinder(5.5, 34.0, Vector(ox, oy, -21.0))), 'brass')

    # legs cast in near the corners, behind the bevel (hollow, plugged at the top)
    leg_s, leg_w = P['post_tube']
    for i, (lx, ly) in enumerate(g['legs']):
        if ya <= ly < yb:
            name = f"Leg{'Front' if front else 'Rear'}{'L' if lx < 0 else 'R'}"
            z1 = P['leg_embed']
            env, shell = parts.square_tube('z', lx, ly, leg_s, leg_w, z1 - P['leg_len'], z1)
            cuts.append(env)
            st.add(name, cont, shell)
            st.plug(name + 'Plug', cont, 'z', lx, ly, leg_s - 2 * leg_w, z1 - 10, z1, z1)
            # threaded insert for the leveling foot
            insert = parts.square_tube('z', lx, ly, leg_s - 2 * leg_w - 1.2, 0.1, z1 - P['leg_len'], z1 - P['leg_len'] + 22)[0]
            st.add(name + 'Insert', cont, insert.cut(Part.makeCylinder(6.0, 30, Vector(lx, ly, z1 - P['leg_len'] - 5))), 'steel')

    # cast-in M5 inserts for the enclosure's bottom rails and the way-cover rollers
    for i, (bx, by) in enumerate(g['rail_bolts'] + g['cover_inserts'] + g['ychain_inserts']):
        if ya <= by < yb:
            cuts.append(Part.makeCylinder(4.0, 13.0, Vector(bx, by, base_top - 12)))
            st.add(f'Insert{tag}{i + 1}', cont, Part.makeCylinder(4.0, 12.0, Vector(bx, by, base_top - 12)).cut(
                Part.makeCylinder(2.5, 14.0, Vector(bx, by, base_top - 13))), 'brass')

    if not front:
        for sx, side in ((-1, 'L'), (1, 'R')):
            for i, dy in enumerate(g['dowel_ys']):
                dowel = Part.makeCylinder(P['dowel_d'] / 2, 30.0, Vector(sx * g['ux'], dy, base_top - 15))
                cuts.append(dowel)
                st.add(f'DowelBase{side}{i + 1}', cont, dowel, 'steel')

    # the uprights' tie rods: 5/8 in holes right through (cast on greased rods), between the pedestal webs
    for sx in (-1, 1):
        cuts += [Part.makeCylinder(P['up_rod_hole'] / 2, base_top + 2, Vector(sx * rx, ry, -1))
                 for rx, ry, _ in g['tie_rods'] if ya <= ry < yb]

    if not front:
        # Seal on the split face: a U under the floor gutters, rising at both ends to near the top. It is
        # in the rear half, which is cast first against a board; the front half is cast against it.
        groove, cord = split_gasket(g)
        cuts.append(groove)
        st.add('GasketBaseSplit', cont, cord, 'rubber')
        g['gasket_len'] += cord.Volume / (P['gasket_groove'][0] * P['gasket_groove'][1])

    shape = blk.cut(cuts).removeSplitter()
    m.add(f'Base{tag}Casting', 'frame', shape, 'granite', container=cont)
    return shape.Volume


def split_gasket(g):
    """Groove (cut from the front half) and the cord that fills it, on the split face y = split."""
    w, dpt = P['gasket_groove']
    ys, half = g['split'], g['base_half']
    xl, zb, zt = half - 12.0, P['gasket_split_z'], g['base_top'] - 6.0
    pieces = [parts.box(-xl - w / 2, xl + w / 2, ys, ys + dpt, zb - w / 2, zb + w / 2)]
    pieces += [parts.box(sx * xl - w / 2, sx * xl + w / 2, ys, ys + dpt, zb - w / 2, zt) for sx in (-1, 1)]
    shape = pieces[0].multiFuse(pieces[1:]).removeSplitter()
    return shape, shape.copy()


def foot_gasket(g, sx):
    """Groove loop in the upright's underside, 8 mm in from its edges."""
    w, dpt = P['gasket_groove']
    x0, x1 = sorted((sx * (g['inner'] + 8.0), sx * (g['outer'] - 8.0)))
    y0, y1 = g['up_front'] + 8.0, g['up_back_foot'] - 8.0
    z = g['base_top']
    ring = parts.box(x0 - w / 2, x1 + w / 2, y0 - w / 2, y1 + w / 2, z, z + dpt).cut(
        parts.box(x0 + w / 2, x1 - w / 2, y0 + w / 2, y1 - w / 2, z - 1, z + dpt + 1))
    return ring, 2 * ((x1 - x0) + (y1 - y0))


def upright_envelope(g, sx, edges=True):
    """Outside shape of an upright, before any cuts (the mold cavity): a raked buttress, the
    foot running forward along the base and the front face sloping up to the beam."""
    inner, outer, base_top, beam_bot = g['inner'], g['outer'], g['base_top'], g['beam_bot']
    x0 = inner if sx > 0 else -outer
    toe = base_top + P['upright_nose']
    prof = [(g['up_front'], base_top), (g['up_front'], toe), (g['up_top_front'], beam_bot), (g['up_y1'], beam_bot),
            (g['up_back_foot'], base_top)]
    up = Part.Face(Part.makePolygon([Vector(x0, y, z) for y, z in prof + prof[:1]])).extrude(Vector(P['upright_t'], 0, 0))
    # the nose rounds into the slope (part of the mold: a printed toe filler)
    up = fillet_safe(up, (P['upright_nose_r'],), lambda e: parts.parallel((1, 0, 0))(e) and on_z(toe)(e))
    if not edges:
        return up
    # outside edges well rounded; the top face (under the beam and the top plate) only lightly
    up = fillet_safe(up, (P['round_r'], 6.0), lambda e: not on_z(base_top)(e) and not on_z(beam_bot)(e)
                     and not (parts.parallel((1, 0, 0))(e) and on_z(toe)(e)))
    return fillet_safe(up, (4.0, 2.0), lambda e: on_z(beam_bot)(e))


def upright(m, g, st, sx):
    """Upright: a steel skeleton of stock parts (flat-bar foot, two tube columns, a top plate of two flat
    bars) cast into epoxy granite. The tie rods run inside the columns and screw into the top plate's
    lower bar, and one from the toe pocket bears on the foot, all right through the base, so the whole
    upright is clamped down through steel; two dowels locate it."""
    tag = 'L' if sx < 0 else 'R'
    cont = f'FrameUpright{tag}'
    inner, outer, base_top, beam_bot = g['inner'], g['outer'], g['base_top'], g['beam_bot']
    up_y0, up_y1 = g['up_y0'], g['up_y1']
    ux, ft = sx * g['ux'], g['foot_top']
    up = upright_envelope(g, sx)
    plate_t, lay = P['top_plate_t'], P['plate_layer']
    plate_bot = beam_bot - plate_t
    rod_r = P['tie_rod_d'] / 2

    # ---- the skeleton, all stock: a 3/8 x 2 in flat-bar foot, two 2x2 tube columns, and a top plate of two
    # 1/2 x 2-1/2 in flat bars (the lower one tapped for the column rods and the beam's studs)
    xa, xb = sorted((sx * (g['ux'] - 31.75), sx * (g['ux'] + 31.75)))
    py0, py1 = g['up_top_front'] + 6, up_y1 - 6
    lower = sk.flat_bar(f'TopPlate{tag}Lower', 'z', plate_bot, lay, xa, py0, xb, py1)
    upper = sk.flat_bar(f'TopPlate{tag}Upper', 'z', plate_bot + lay, lay, xa, py0, xb, py1)
    fa, fb = sorted((sx * (g['ux'] - 25.4), sx * (g['ux'] + 25.4)))   # inside the foot's gasket groove
    foot = sk.flat_bar(f'UprightFoot{tag}', 'z', base_top, T38, fa, g['up_front'] + 12.5, fb, up_y1 - 12.5)
    tl, tw = P['column_len'], P['frame_tube'][1]
    cols = []
    for i, cy in enumerate(g['columns']):
        env, shell = parts.square_tube('z', ux, cy, P['frame_tube'][0], tw, plate_bot - tl, plate_bot)
        cols.append(env)
        st.add(f'UprightColumn{tag}{i + 1}', cont, shell)
        # printed rings center the column on its rod at both ends (cast in)
        inner_s = P['frame_tube'][0] - 2 * tw - 2 * P['tube_fit']
        for k, z0 in enumerate((plate_bot - tl, plate_bot - 12.0)):
            ring = parts.box(ux - inner_s / 2, ux + inner_s / 2, cy - inner_s / 2, cy + inner_s / 2, z0, z0 + 12.0)
            ring = parts.soften(ring, 3.0, parts.parallel((0, 0, 1)), chamfer=True)
            ring = seam_relief(ring.cut(Part.makeCylinder(6.6, 14, Vector(ux, cy, z0 - 1))), 'z', ux, cy, inner_s, z0, z0 + 12)
            st.add(f'ColumnRing{tag}{i + 1}{"ab"[k]}', cont, ring, 'printed')
    for rx, ry, pb in g['tie_rods']:
        foot.hole(sx * rx, ry, 14.3)
        if pb >= g['pocket_bot'] - 1:
            lower.hole(sx * rx, ry, 0, tap='1/2-13')
    for dy in g['dowel_ys']:
        foot.hole(ux, dy, P['up_dowel_hole'])
    for bx in g['bolt_xs']:
        for by in g['bolt_ys']:
            lower.hole(sx * bx, by, 0, tap='3/8-16')
            upper.hole(sx * bx, by, 10.5)
    for pl in (lower, upper):
        pl.hole(ux, g['beam_dowel_y'], P['plate_dowel_hole'])
    for pl in (foot, lower, upper):
        st.add(pl.name, cont, pl.shape)
        m.plates.append(pl)

    # ---- the casting around it
    cuts = [foot.slab, parts.box(xa, xb, py0, py1, plate_bot, beam_bot + 1)] + cols
    cuts += [Part.makeCylinder(P['up_dowel_hole'] / 2, 10.0, Vector(ux, dy, ft - 1)) for dy in g['dowel_ys']]
    cuts += [Part.makeCylinder(rod_r + 1.0, plate_bot - tl - ft + 2, Vector(ux, cy, ft - 1)) for cy in g['columns']]
    pockets = []
    for j, (rx, ry, pb) in enumerate(g['tie_rods']):
        x = sx * rx
        # under the base: washer and nut against the anchor bar
        low = Part.makeCylinder(13.5, 2.5, Vector(x, ry, -2.5)).fuse(parts.hexagon(19.05, -13.6, 11.1, x, ry))
        st.add(f'TieRodNutLow{tag}{j + 1}', cont, low.cut(Part.makeCylinder(rod_r, 20, Vector(x, ry, -15))), 'steel')
        if pb >= g['pocket_bot'] - 1:
            rod_top = beam_bot - lay                     # screwed into the lower bar, flush with its top
            nut = None
        else:
            # toe: washer and nut on the foot plate, in a pocket from the slope; a printed cap closes it
            r = P['slope_pocket_d'] / 2
            pockets.append(Part.makeCylinder(r, beam_bot - pb + 1, Vector(x, ry, pb)))
            nut = Part.makeCylinder(13.5, 2.5, Vector(x, ry, pb)).fuse(parts.hexagon(19.05, pb + 2.5, 11.1, x, ry))
            rod_top = pb + 13.5
            cap = Part.makeCylinder(r - 0.15, beam_bot - pb, Vector(x, ry, pb + 13.7)).common(up)
            m.add(f'PocketCap{tag}{j + 1}', 'frame', cap, 'printed_dark', container=cont)
        if nut is not None:
            st.add(f'TieRodNut{tag}{j + 1}', cont, nut.cut(Part.makeCylinder(rod_r, 1e3, Vector(x, ry, 0))), 'steel')
        tail = 13.6 + P['rod_tail']
        st.add(f'TieRod{tag}{j + 1}', cont, Part.makeCylinder(rod_r, rod_top + tail, Vector(x, ry, -tail)), 'steel')
    ring, ring_len = foot_gasket(g, sx)
    cuts.append(ring)
    st.add(f'GasketUpright{tag}', cont, ring.copy(), 'rubber')
    g['gasket_len'] += ring_len
    shape = up.cut(cuts + pockets).removeSplitter()
    m.add(f'Upright{tag}Casting', 'frame', shape, 'granite', container=cont)
    return shape.Volume


def beam_envelope(g, edges=True):
    """Outside shape of the beam, before any cuts (the mold cavity)."""
    outer, bf, bot, top = g['outer'], g['beam_face'], g['beam_bot'], g['beam_top']
    by1 = bf + P['beam_d']
    shape = parts.box(-outer, outer, bf, by1, bot, top)
    back = lambda e: parts.parallel((1, 0, 0))(e) and on_y(by1)(e)
    shape = fillet_safe(shape, (P['beam_back_r'], 30.0), lambda e: back(e) and on_z(top)(e))
    shape = fillet_safe(shape, (P['beam_back_low_r'],), lambda e: parts.parallel((1, 0, 0))(e) and on_z(bot)(e)
                        and all(v.Point.y > by1 - 1 for v in e.Vertexes))
    # over the uprights the back top corner stays square: the cap plates and the back cap screws sit there
    shape = shape.fuse([parts.box(*sorted((sx * (g['inner'] - 5.0), sx * outer)), by1 - 50.0, by1, top - 50.0, top)
                        for sx in (-1, 1)]).removeSplitter()
    if not edges:
        return shape
    shape = fillet_safe(shape, (P['beam_face_r'],), lambda e: parts.parallel((1, 0, 0))(e) and on_y(bf)(e))
    return fillet_safe(shape, (P['round_r'], 6.0, 3.0), lambda e: all(abs(abs(v.Point.x) - outer) < 1e-6 for v in e.Vertexes))


def stud(mm, exact=False):
    """The nearest stud length sold (1/4 in steps), so every rod is bought at length instead of sawn.
    exact=True gives the length the rod would be cut to (rod_tail past the far nut exactly)."""
    return mm if exact else round(mm / 6.35) * 6.35


def beam_tie_length():
    """The beam ties: from 0.5 mm inside the face bar's front, through the nipple and back bar, about 12 mm past it."""
    return stud(2 * P['beam_bar_t'] + P['beam_spacer'] + 11.5)


def beam(m, g, st):
    """Beam: a steel box of stock flat bar cast into epoxy granite. A 5 in face bar (the rail face,
    tapped for the X risers and ballscrew supports, cast_anchors) and a back bar, held apart by pipe
    nipples on studs screwed into the face bar, both beam_bar_t thick; at each end a 3/8 x 2-1/2 in seat bar under and cap bar
    over them. Eight 3/8-16 studs, screwed into the upright top plates, clamp cap bar, face and back bars
    and seat bar down onto the top plates."""
    outer, inner, bf = g['outer'], g['inner'], g['beam_face']
    bot, top = g['beam_bot'], g['beam_top']
    by1 = bf + P['beam_d']
    cz = (bot + top) / 2
    shape = beam_envelope(g)
    cont = 'FrameBeam'
    xe = 254.0                                                         # 20 in bars
    tb = P['beam_bar_t']
    yb0 = bf + tb + P['beam_spacer']                                   # back bar, behind the spacers
    face = sk.flat_bar('BeamFacePlate', 'y', bf, tb, -xe, bot + T38, xe, top - T38)
    back = sk.flat_bar('BeamBackPlate', 'y', yb0, tb, -xe, bot + T38, xe, top - T38)
    ends = []
    for sx, side in ((-1, 'L'), (1, 'R')):
        xa, xb = sorted((sx * (g['ux'] - 31.75), sx * (g['ux'] + 31.75)))
        ends.append(sk.flat_bar(f'BeamSeat{side}', 'z', bot, T38, xa, bf, xb, bf + 133.35))
        ends.append(sk.flat_bar(f'BeamCap{side}', 'z', top - T38, T38, xa, bf, xb, bf + 133.35))
    for pl in ends:
        for sx in (-1, 1):
            for bx in g['bolt_xs']:
                for by in g['bolt_ys']:
                    if pl.slab.common(Part.makeCylinder(1, 1000, Vector(sx * bx, by, 0))).Volume > 0:
                        pl.hole(sx * bx, by, 13.5)
        if pl.name.startswith('BeamSeat'):
            pl.hole(math.copysign(g['ux'], pl.slab.BoundBox.Center.x), g['beam_dowel_y'], 9.6)
    # ties: studs screwed into the face bar, through pipe nipples and the back bar, nut behind
    cuts, ties = [], (-120.0, 0.0, 120.0)
    for tx in ties:
        face.hole(tx, cz, 0, tap='3/8-16')
        back.hole(tx, cz, 10.5)
        pipe = parts.cyl_v(10.65, bf + tb, yb0, tx, cz).cut(parts.cyl_v(7.9, bf, yb0 + 1, tx, cz))
        st.add(f'BeamSpacer{int(tx)}', cont, pipe)
        cuts.append(parts.cyl_v(10.65, bf + tb, yb0, tx, cz))
        stud = parts.cyl_v(P['beam_bolt_d'] / 2, bf + 0.5, bf + 0.5 + beam_tie_length(), tx, cz)
        nut = hex_y(14.3, tx, yb0 + tb, 8.4, cz).cut(parts.cyl_v(P['beam_bolt_d'] / 2, yb0, yb0 + 20, tx, cz))
        st.add(f'BeamTie{int(tx)}', cont, stud.fuse(nut), 'steel')
        cuts.append(parts.cyl_v(13.0, yb0 + tb, yb0 + tb + 14.0, tx, cz))           # its nut, in the casting
    plates = [back] + ends
    for pl in plates:
        st.add(pl.name, cont, pl.shape)
        m.plates.append(pl)
    m.beam_face_plate = face             # cast_anchors taps it, then adds it
    cuts += [pl.slab for pl in plates + [face]]
    n = 0
    for sx in (-1, 1):
        dowel = Part.makeCylinder(P['dowel_d'] / 2, P['dowel_proud'] + 15.0, Vector(sx * g['ux'], g['beam_dowel_y'],
                                                                                   bot - P['dowel_proud']))
        cuts.append(dowel)
        st.add(f'DowelBeam{"L" if sx < 0 else "R"}', cont, dowel, 'steel')
        for bx in g['bolt_xs']:
            for by in g['bolt_ys']:
                x = sx * bx
                n += 1
                cuts.append(Part.makeCylinder(P['beam_bolt_hole'] / 2, top - bot + 2, Vector(x, by, bot - 1)))
                z0 = bot - P['top_plate_t']                              # bottom of the top plate's lower bar
                stud = Part.makeCylinder(P['beam_bolt_d'] / 2, P['beam_stud'], Vector(x, by, z0))
                zw = top + (P['drip_shield_t'] if by == g['bolt_ys'][0] else 0.0)   # the front row clamps the shield
                washer = Part.makeCylinder(10.0, 2.0, Vector(x, by, zw))
                nut = parts.hexagon(14.3, zw + 2, 8.4, x, by)
                st.add(f'BeamBolt{n}', cont, stud.fuse([washer, nut]), 'black')
    # cast-in M5 inserts in the top for the cable chain's fixed mount
    for i, (ix, iy) in enumerate(g['chain_inserts'], 1):
        cuts.append(Part.makeCylinder(4.0, 13.0, Vector(ix, iy, top - 12)))
        st.add(f'InsertBeam{i}', cont, Part.makeCylinder(4.0, 12.0, Vector(ix, iy, top - 12)).cut(
            Part.makeCylinder(2.5, 14.0, Vector(ix, iy, top - 13))), 'brass')
    shape = shape.cut(cuts).removeSplitter()
    m.add('BeamCasting', 'frame', shape, 'granite', container=cont)
    return shape.Volume


def frame_modules(m, d):
    """Five bolt-together epoxy-granite castings with cast-in steel (see README)."""
    g = frame_layout(d)
    st = Steel(m)
    vols = {'Base front': base_half(m, g, st, True), 'Base rear': base_half(m, g, st, False),
            'Upright L': upright(m, g, st, -1), 'Upright R': upright(m, g, st, 1), 'Beam': beam(m, g, st)}
    d['casting_vols'] = {k: v / 1e6 for k, v in vols.items()}
    d['casting_L'] = sum(vols.values()) / 1e6
    d['steel_kg'] = st.volume / 1e6 * 7.85
    d['gasket_m'] = g['gasket_len'] / 1000
    plate_t = P['top_plate_t']
    tl = P['tube_len']
    inch = lambda mm: f'{sk.inch(mm)} in'
    ys, y0 = g['split'], d['base_y0']
    d['steel_bom'] = [
        ('frame', f"Steel square tube 2 x 2 x {sk.inch(P['frame_tube'][1])} in, bought at length",
         f"4 x {inch(P['column_len'])} (upright columns; the base's short ones are in the cut list)", 'buy'),
        ('frame', 'Steel square tube 1-1/2 x 1-1/2 x 1/8 in (or 0.120 wall), bought at length',
         f"4 x {inch(P['leg_len'])} (legs)", 'buy'),
        ('frame', 'Printed PETG: 8 column rings, 4 leg plugs, 2 gray pocket caps', '~60 g', 'PRINT'),
        ('frame', '1/2-13 grade B7 fully threaded studs, bought at length (nothing sawn)',
         ', '.join(f"{2 * n_} x {inch(L)}" for L, n_ in sorted(collections.Counter(tie_rod_lengths(g)).items(),
                                                              reverse=True))
         + f" (uprights), 2 x {inch(draw_rod_length(g))} (base draw rods), 4 x {inch(cross_rod_lengths(g)[0])} + "
           f"6 x {inch(cross_rod_lengths(g)[1])} (base cross rods)", 'buy'),
        ('frame', '1/2-13 nut + 1/2 in SAE washer', '32 of each', 'buy'),
        ('frame', '3/8-16 grade B7 fully threaded studs, bought at length: beam studs (into the upright top plates) and '
                  'beam ties, + 3/8-16 nuts and washers', f"8 x {inch(P['beam_stud'])} + 3 x {inch(beam_tie_length())}; 11 nuts",
         'buy'),
        ('frame', f"1/2 in x {inch(P['beam_spacer'])} black pipe nipple (beam spacers)", '3 pcs', 'buy'),
        ('frame', '1/4-20 hex bolt + nut + washers: rail bars onto the girders (4 in), pads onto their cross tubes '
                  '(2-1/4 in)', 'about 20 x 4 in + 4 x 2-1/4 in', 'buy'),
        ('frame', 'Dowel pin 3/8 x 1-1/4 in (4 base dowels, 2 beam) and 3/8 x 1 in (4 at the base split)', '6 + 4 pcs', 'buy'),
        ('frame', f"Nitrile O-ring cord {P['gasket_cord']:.0f} mm (base split + upright feet), glue the ends",
         f"{d['gasket_m'] + 0.3:.1f} m", 'buy'),
        ('frame', '1/2 in brass hex nipple, cast-in coolant drain', '1 pc', 'buy'),
    ]


def cross_rod_lengths(g, exact=False):
    """The base cross rods: girder to girder, and girder to pedestal column, a nut, washer and rod_tail past
    each outside face."""
    tail = 2 * (13.6 + P['rod_tail'])
    gw = GIRDER[0]
    return (stud(2 * (g['girder_x'] + gw / 2) + tail, exact), stud((g['ux'] + 25.4) - (g['girder_x'] - gw / 2) + tail, exact))


def draw_rod_length(g, exact=False):
    """The base draw rods: from the front cross plate to the girders' rear end plates, a nut, a washer
    and a rod_tail past each."""
    return stud(g['rear_end'] + T38 - g['front_web'] + 2 * (13.6 + P['rod_tail']), exact)


def tie_rod_lengths(g, exact=False):
    """Each upright's tie rods, stud length: from rod_tail under the bottom nut (washer, nut) to flush with
    the top plate (top two) or with the top of the slope nut."""
    return [stud((g['beam_bot'] - P['plate_layer'] if pb >= g['pocket_bot'] - 1 else pb + 13.5) + 13.6 + P['rod_tail'], exact)
            for _, _, pb in g['tie_rods']]


def free_end_room(cast, axis, c1, c2, size, end, sgn, cover=2.0, most=30.0):
    """How far a cast-in tube could run past its free end (at `end`, growing toward sgn) and stay in
    solid casting: a slab of its section plus `cover` all round, grown until it leaves the casting."""
    def slab(t):
        a0, a1 = sorted((end, end + sgn * t))
        h = size / 2 + cover
        lo1, hi1, lo2, hi2 = c1 - h, c1 + h, c2 - h, c2 + h
        if axis == 'y':
            return parts.box(lo1, hi1, a0, a1, lo2, hi2)
        return parts.box(lo1, hi1, lo2, hi2, a0, a1)
    crop = cast.common(slab(most))
    inside = lambda t: slab(t).cut(crop).Volume < 0.5
    if inside(most):
        return most
    lo, hi = 0.0, most
    while hi - lo > 0.25:
        mid = (lo + hi) / 2
        lo, hi = (mid, hi) if inside(mid) else (lo, mid)
    return lo


def steel_tolerance(m, d):
    """Where each cast-in piece's length error goes, and whether there's room for tube_cut_tol."""
    g = frame_layout(d)
    cast = {p['name']: p['shape'] for p in m.parts if p['name'].endswith('Casting')}
    tol, ys = P['tube_cut_tol'], g['split']
    tube_s, post_s = P['frame_tube'][0], P['post_tube'][0]
    s2 = P['table_rail_spacing'] / 2
    rows = []
    rooms = [free_end_room(cast['BaseFrontCasting' if ly < ys else 'BaseRearCasting'], 'z', lx, ly, post_s, P['leg_embed'], 1)
             for lx, ly in g['legs']]
    rows.append(('Legs (4)', 'set proud of the leg holder', 'top end, in the casting', min(rooms)))
    # upright columns: clamped up against the top plate; the bottom end sits in an epoxy bed on the foot plate
    rows.append(('Upright columns (4)', 'top end, against the top plate', 'an epoxy bed on the foot bar',
                 g['pocket_bot'] - P['column_len'] - g['foot_top']))
    # the studs are bought in 1/4 in steps: the step shortens or lengthens the tail past the far nut, and the
    # stud's own length error (stud_tol) has to fit in the shortest tail
    def tail(n, x):
        return P['rod_tail'] + min(a - b for a, b in zip(n, x))
    rows.append(('Draw rods (2, studs)', 'flush with the front nut', 'the tail behind the back nut',
                 tail([draw_rod_length(g)], [draw_rod_length(g, True)]), P['stud_tol']))
    rows.append(('Girders (4)', 'the split end plate', 'the far end plate, clamped by the draw rod', 6.0))
    rows.append(('Top plates (2)', 'bolted to the mold bridge', 'all edges, 6 mm inside the casting', 6.0))
    rows.append(('Tie and cross rods (studs)', 'screwed up to a stop, or flush with one nut', 'the tail past the far nut',
                 tail(tie_rod_lengths(g) + list(cross_rod_lengths(g)), tie_rod_lengths(g, True) + list(cross_rod_lengths(g, True))),
                 P['stud_tol']))
    d['steel_tol'] = [(r[0], r[1], r[2], r[3], r[3] >= (r[4] if len(r) > 4 else tol)) for r in rows]
    for n, _, _, room, ok in d['steel_tol']:
        if not ok:
            m.warnings.append(f'{n}: only {room:.1f} mm for its length error')


def cast_anchors(m, d):
    """Threads for the rails and ballscrew supports recorded by rail_pair / screw_axis, tapped into the
    steel: the beam's face plate, and the base's rail bars and support pads. Behind each the casting is
    relieved where the greased mold screw stood, so the screws that go in later have room."""
    parts_by_name = {p['name']: p for p in m.parts}
    holes, count = {}, {}
    face = m.beam_face_plate
    for pt, n, kind in m.anchors:
        thread, od, ln = P[kind]
        if abs(n.z) < 0.5:
            face.hole(pt.x, pt.z, 0, tap='M5' if kind == 'insert_m5' else 'M6')
            holes.setdefault('BeamCasting', []).append(
                Part.makeCylinder(thread / 2 + 0.5, 12.0, Vector(pt.x, d['beam_face'] + P['beam_bar_t'] - 0.5, pt.z), Vector(0, 1, 0)))
            count['face_' + kind] = count.get('face_' + kind, 0) + 1
            continue
        cast = 'BaseFrontCasting' if pt.y < P['base_split_y'] else 'BaseRearCasting'
        probe = Part.Vertex(pt - n * (T38 / 2))
        pl = next((pl for pl, _ in m.base_tapped if pl.slab.distToShape(probe)[0] < 1e-6), None)
        if pl is None:
            raise ValueError(f'no steel under the {kind} at {pt}')
        pl.hole(pt.x, pt.y, 0, tap='M5' if kind == 'insert_m5' else 'M6')
        holes.setdefault(cast, []).append(Part.makeCylinder(thread / 2 + 0.5, 12.0, pt - n * (T38 + 11.5), n))
        count['base_' + kind] = count.get('base_' + kind, 0) + 1
    for pl, cont in [(face, 'FrameBeam')] + m.base_tapped:
        m.add(pl.name, 'frame', pl.shape, 'steeltube', container=cont)
        m.structure.add(pl.name)
        m.plates.append(pl)
        d['steel_kg'] += pl.mass
    by_stock = {}
    for pt, qty, stock, ln, _ in steel_parts(m):
        by_stock.setdefault(stock, []).append((ln, qty))
    for stock, items in sorted(by_stock.items(), reverse=True):
        merged = collections.Counter()
        for ln, q in items:
            merged[round(ln)] += q
        d['steel_bom'].insert(0, ('frame', f'{stock}, cut to length (docs/1-sourcing/steel/)',
                                  ', '.join(f'{q} x {ln}' for ln, q in sorted(merged.items(), reverse=True)), 'buy'))
    for cast, hs in holes.items():
        p = parts_by_name[cast]
        p['shape'] = p['shape'].cut(hs)
        p['proxy'] = [p['shape']]
    d['anchor_count'] = count


MOLD_GROUPS = {'base-rear': 'MoldBaseRear', 'base-front': 'MoldBaseFront', 'upright': 'MoldUpright',
                'beam': 'MoldBeam'}
CASTING_FOLDERS = {'FrameBaseFront': 'base-front', 'FrameBaseRear': 'base-rear', 'FrameUprightL': 'upright',
                   'FrameBeam': 'beam'}


def mold_parts(m, d):
    """The mold kit (moldbox.py): melamine boards with their hole maps, the printed brackets and
    pieces that bolt to them, and the printed cast-in parts. m.molds: printed rows for print/;
    m.mold_kit: the kit (boards, hardware) for the mold guide."""
    molds.BOARD = P['mold_board']
    molds.BOARD_MAX = P['mold_board'] + 0.6
    g = frame_layout(d)
    kit = moldbox.Kit()
    mold_base(kit, m, g)
    mold_upright(kit, g)
    mold_beam(kit, m, g)
    # the pour line on every wall: where the casting's open face meets the board
    for mold, up, level in (('base', Vector(0, 0, -1), 0.0), ('upright', Vector(0, 0, 1), g['beam_bot']),
                            ('beam', Vector(0, 1, 0), g['beam_face'] + P['beam_d'])):
        for b in kit.boards:
            vu = b.V.dot(up)
            if b.mold == mold and abs(vu) > 0.3 and abs(b.U.dot(up)) < 1e-6:
                v = (level - b.o.dot(up)) / vu
                vs = [v_ for _, v_ in b.outline]
                b.pour_v = v if min(vs) + 1 < v < max(vs) - 1 else None
    mold_tools(kit)
    # printed parts already in the model: cast-in liners, sleeves and plugs, and the machine's own
    seen = {}
    for p in m.parts:
        if not p['look'].startswith('printed') or p['container'] == 'FrameUprightR':
            continue
        cast_in = p['name'] in m.structure
        folder = CASTING_FOLDERS.get(p['container'], 'machine') if cast_in else 'machine'
        bb = p['shape'].BoundBox
        key = (folder, round(p['shape'].Volume), tuple(sorted(round(v) for v in (bb.XLength, bb.YLength, bb.ZLength))))
        qty = 2 if folder == 'upright' or p['container'] == 'FrameUprightL' else 1
        if key in seen:
            seen[key]['qty'] += qty
            continue
        name = ''.join('-' + c.lower() if c.isupper() and i else c.lower() for i, c in enumerate(p['name'])).replace('--', '-')
        up = None
        if name.startswith('pocket-cap'):
            # its face (flush with the sloped front) on the bed
            sl = Vector(0, g['up_top_front'] - g['up_front'], g['beam_bot'] - g['base_top'] - P['upright_nose'])
            sl.normalize()
            up = Vector(0, sl.z, -sl.y)
        seen[key] = kit.add(folder, name, 'cast-in' if cast_in else 'part', p['shape'], qty,
                            'Cast in, stays.' if cast_in else '', up=up, placed=[])
    for mold, f in kit.loose:
        print(f'mold kit: {f.what} at {f.p} ({mold}) lands on no board')
    m.molds, m.mold_kit = kit.rows, kit


def fixed_piece(kit, folder, mold, name, kind, shape, contacts, qty=1, note='', up=None, show=None, mult=1,
                sizes=('M4', 'M3', 'pin'), lim=None, avoid=()):
    """A printed mold piece cut to the bed (peg and socket on each cut), each part fixed to the
    boards it sits against. contacts: [(point on the board face, n out of the piece, fixings per part)]."""
    parts_out, fixes = [], []
    for p in molds.keyed(molds.split(shape, lim or molds.BED)):
        for c0, n, k in contacts:
            if k == 'auto':
                k = 2 if max(p.BoundBox.XLength, p.BoundBox.YLength, p.BoundBox.ZLength) > 110 else 1
            p, fx = molds.fasten(p, c0, n, k, sizes, what=name, avoid=avoid)
            fixes += fx
        parts_out.append(p)
    if up is None:
        # flat face against the board on the bed; pins (if any) point up, so then the other way round
        n0 = contacts[0][1]
        up = n0 if any(f.kind == 'pin' for f in fixes) else -n0
    row = kit.add(folder, name, kind, parts_out, qty, note, up, show=show)
    kit.fix(fixes, mold, mult)
    return row


def mold_base(kit, m, g):
    """Both base halves in one box on one floor board: the rear half first, against a partition at
    the split; then the partition comes out and the front half is cast against the rear half's
    waxed split face, on the same floor. So the two top faces come out flush, the split faces match,
    and the front girders' end plates go straight onto the rear ones' dowel pins. Each half's steel grid
    goes in as one piece: its rail bars and pads screwed to the floor, its seats on the dowels.

    The base is cast top face down: the floor board is at z = base_top and 'up' in the mold is -z."""
    T, fb = P['mold_board'], P['mold_freeboard']
    half, top, y0, y1, ys = g['base_half'], g['base_top'], g['base_y0'], g['base_y1'], g['split']
    up, Z = Vector(0, 0, -1), Vector(0, 0, 1)
    X, Y = Vector(1, 0, 0), Vector(0, 1, 0)
    wt = -fb                                  # wall tops (z)
    both, REAR, FRONT = ['base-rear', 'base-front'], ['base-rear'], ['base-front']
    M = 'base'
    B = moldbox.box_board
    xo = half + T                             # outer faces of the side walls
    kit.board(B('Base floor', M, (-xo - 40, y0 - T - 40, top), (xo + 40, y1 + T + 40, top + T), Z, Y,
                note='both halves are cast on it', show=both))
    kit.board(B('Base front wall', M, (-xo, y0 - T, wt), (xo, y0, top), -Y, up, show=both))
    kit.board(B('Base rear wall', M, (-xo, y1, wt), (xo, y1 + T, top), Y, up, show=both))
    for sx, tag in ((-1, 'left'), (1, 'right')):
        kit.board(B(f'Base side wall, {tag}', M, (sx * half, y0, wt), (sx * xo, y1, top), sx * X, up, show=both))
    kit.board(B('Base partition', M, (-half, ys - T, wt), (half, ys, top), -Y, up,
                note='rear half only; comes out before the front half', show=REAR))
    for sx in (-1, 1):
        kit.board(B('Base partition strut', M, (sx * 150 - T / 2, y0, top - 60), (sx * 150 + T / 2, ys - T, top), X, up,
                    note='offcut, stands on edge; holds the partition foot (rear half only)', show=REAR))

    # corner brackets at the four outside corners, floor brackets along every wall foot
    for sx in (-1, 1):
        for yw, sy in ((y0 - T, -1), (y1 + T, 1)):
            c = Vector(sx * xo, yw, wt)
            kit.add_many('base-box', 'corner-bracket', 'kit', [moldbox.angle_bracket(
                c, -sx * X, sy * Y, -sy * Y, sx * X, up, fb - 2)], mold=M, show=both, merge=True, up=up)
    cleat(kit, M, 'Base cleat, front', Vector(-xo, y0 - T, top), Vector(xo, y0 - T, top), -Y, up, both)
    cleat(kit, M, 'Base cleat, rear', Vector(-xo, y1 + T, top), Vector(xo, y1 + T, top), Y, up, both)
    for sx, tag in ((-1, 'left'), (1, 'right')):
        cleat(kit, M, f'Base cleat, {tag}', Vector(sx * xo, y0, top), Vector(sx * xo, y1, top), sx * X, up, both)
    # partition: brackets to the side walls on its front face, above the pour line
    kit.add_many('base-box', 'partition-bracket', 'kit',
                 [moldbox.angle_bracket(Vector(sx * half, ys - T, wt), -sx * X, -Y, -Y, -sx * X, up, fb - 2, hole_at=20)
                  for sx in (-1, 1)], mold=M, show=REAR, up=up)

    # bridges: boards on edge across the box, in saddles on the side walls; the cores bolt to their sides
    bh, bz = 60.0, wt - TH_SADDLE
    lines = BASE_BRIDGES
    legs_y = {'base-front': g['legs'][0][1], 'base-rear': g['legs'][2][1]}
    for folder, ys_ in lines.items():
        for yb in ys_:
            xb = xo + moldbox.SLOT + TH_SADDLE
            kit.board(B(f'Base bridge y={yb:.0f}', M, (-xb, yb - T / 2, bz - bh), (xb, yb + T / 2, bz), -Y, up,
                        view='outside', show=[folder]))
            sad = []
            for sx in (-1, 1):
                s, wf, bf = moldbox.saddle(Vector(sx * half, yb, wt), sx * X, up, Y)
                sad.append((s, wf + [bf]))
            kit.add_many('base-box', 'saddle', 'kit', sad, mold=M, show=[folder], merge=True, reuse=True, up=X,
                         note='The rear half needs six; four move over for the front half.')
    next(r for r in kit.rows if r['folder'] == 'base-box' and r['name'] == 'saddle')['qty'] = \
        2 * max(len(v) for v in lines.values())
    # legs: a holder in each corner above the pour line, with a pinch screw that holds the leg at its
    # cast-in depth; a short bridge between each pair of holders
    lx_in = half - leg_reach()
    for folder, ly in legs_y.items():
        sy = -1 if ly < 0 else 1
        yw = y0 if sy < 0 else y1
        kit.board(B(f'Base leg bridge y={ly:.0f}', M, (-lx_in - 12, ly - T / 2, bz - bh), (lx_in + 12, ly + T / 2, bz),
                    -Y, up, view='outside', show=[folder]))
        holders = []
        for sx in (-1, 1):
            lx = sx * (half - P['leg_inset'][0])
            holders.append(leg_holder(Vector(lx, ly, 0), sx, sy, half, yw, fb, lx_in))
        kit.add_many('base-box', 'leg-holder', 'kit', holders, mold=M, show=[folder], merge=True, up=up,
                     note=f"Set the leg {P['leg_len'] - P['leg_embed'] - fb:.0f} mm proud of the holder and tighten "
                          'the pinch screw (M4 x 20).')
    kit.count('M4 x 20 bolt (leg pinch screw)', 4, M)
    kit.count('M4 nut', 4, M)
    # anchor bars: each hangs flush with the pour line from its bridges, on printed posts with an M5 screw
    # down through each into a tapped hole in the bar

    # pieces on the floor and walls
    floor = (Vector(0, 0, top), Z)
    for front, folder in ((False, 'base-rear'), (True, 'base-front')):
        yo = y0 if front else y1
        formers = dict(base_top_formers(g, front))
        cav = parts.box(-half, half, *((y0, ys) if front else (ys, y1)), 0, top)
        for name, shape in formers.items():
            shape = shape.common(cav)
            if name.startswith('gutter') and 'trough' in formers:
                shape = shape.cut(formers['trough'])
            if P['foam_formers'] and name != 'motor-relief':
                kit.add(folder, name, 'foam', shape, 1, foam_note(name, shape), show=[folder])
                continue
            if name == 'trough':
                ox, oy = g['outlet']
                shape = shape.fuse(Part.makeCylinder(5.0 - FIT_PLUG, 9.0, Vector(ox, oy, top - 25 - 8), Z))   # drain liner spigot
            fixed_piece(kit, folder, M, name, 'former', shape, [(*floor, 'auto')], lim=120.0 if name == 'trough' else molds.BED,
                        note='Bolts to the floor from underneath (the base is cast top face down).', show=[folder])
        # The rounded corners, and the bevel along the lower edge: one ring, cut into corners and straight
        # strips. The strips sit at the pour line against the walls, so their bolts are covered.
        fill = Part.makeCompound(molds.fillers(base_envelope(g, front, edges=False)))
        c = P['base_corner_r'] + 5.0
        sy = -1 if front else 1
        yc = yo - sy * c
        end_wall, big = (Vector(0, yo, 0), Y * sy, 1), 2000.0
        for sx in (-1, 1):
            side_wall = (Vector(sx * half, 0, 0), sx * X, 1)
            corner = fill.common(parts.box(*sorted((sx * (half - c), sx * big)), *sorted((yc, yo + sy * big)), -big, big))
            if corner.Volume > 1:
                fixed_piece(kit, folder, M, f'corner-{"R" if sx > 0 else "L"}', 'filler', corner,
                            [(*floor, 1), end_wall, side_wall], note='Rounded corner; bolts to the floor and both walls.',
                            show=[folder])
            strip = fill.common(parts.box(*sorted((sx * (half - c), sx * big)), *sorted((yc, ys)), -big, big))
            if strip.Volume > 1:
                fixed_piece(kit, folder, M, f'bevel-{"R" if sx > 0 else "L"}', 'filler', strip, [side_wall],
                            note='The bevel along the lower edge: at the pour line, bolted to the side wall. ' + BEVEL_WOOD,
                            show=[folder])
        strip = fill.common(parts.box(-half + c, half - c, *sorted((yc, yo + sy * big)), -big, big))
        if strip.Volume > 1:
            fixed_piece(kit, folder, M, 'bevel-end', 'filler', strip, [end_wall],
                        note=f"The bevel along the lower edge: at the pour line, bolted to the {'front' if front else 'rear'} wall. "
                             + BEVEL_WOOD,
                        show=[folder])
    groove = split_gasket(g)[0]
    fixed_piece(kit, 'base-rear', M, 'split-gasket-groove', 'former', groove, [(Vector(0, ys, 0), -Y, 2)],
                note='Pins into the partition.', up=-Y, show=REAR, sizes=('pin',))

    # cores: each hangs from a bridge by a post beside it. Where two pockets overlap, the shallower
    # core stops at the deeper one's wall.
    pockets = base_pockets(g)
    for k, (poly, z_top, name) in enumerate(pockets):
        face = Part.Face(Part.makePolygon([Vector(x, y, 0) for x, y in poly + poly[:1]]))
        for poly2, z2, _ in pockets:
            if z2 > z_top:
                face = face.cut(Part.Face(Part.makePolygon([Vector(x, y, 0) for x, y in poly2 + poly2[:1]])))
        face = max(face.Faces, key=lambda f_: f_.Area)
        poly = [(v.Point.x, v.Point.y) for v in face.OuterWire.OrderedVertexes]
        pockets[k] = (poly, z_top, name)
    for poly, z_top, name in pockets:
        front = sum(y for _, y in poly) / len(poly) < ys
        folder = 'base-front' if front else 'base-rear'
        cands = list(lines[folder]) + [legs_y[folder]]
        xs, ycs = [x for x, _ in poly], [y for _, y in poly]
        cx = (min(xs) + max(xs)) / 2
        post = None
        for yb in sorted(cands, key=lambda b: abs(b - (min(ycs) + max(ycs)) / 2)):
            if yb == legs_y[folder] and abs(cx) > lx_in - 8:
                continue
            for side in (-1, 1):
                py = yb + side * (T / 2 + molds.POST / 2)
                if min(ycs) + molds.POST / 2 + 2.0 <= py <= max(ycs) - molds.POST / 2 - 2.0:   # post inside the wall
                    post = (cx, py, (0, -side), bz - 12.0, bz - 20.0)
                    break
            if post:
                break
        if not post:
            print(f'mold kit: no bridge over core {name}')
        if P['foam']:
            # foam block cut to the pocket; only its post is printed, pushed 30 mm into the foam
            p, fx = molds.core_post(*post, min(30.0, z_top - 10.0))
            kit.add(folder, f'{name}-post', 'core', p, 1, 'Post for a foam core: push it 30 mm into a snug hole in '
                    'the foam and glue it.', show=[folder])
            block = molds.prism(poly, 0.0, z_top).cut(p)
            kit.add(folder, name, 'foam', block, 1, foam_note(name, block, poly), show=[folder])
        else:
            shells, fx = molds.core(poly, z_top, [post] if post else [])
            for what, n in (('M3 x 10 bolt', 2), ('M3 nut', 2), ('M3 washer', 4)):
                kit.count(what, n * (len(shells) - 1), M)
            kit.add(folder, name, 'core', shells, 1, 'Shell core, stays in. Bolts to the bridge by its post.', show=[folder])
        kit.fix(fx, M)

    # draw rods: printed plugs on the front and back walls form the nut pockets down to the girders' end plates
    # (the rods run inside the girder tubes, so nothing else forms their holes)
    for front, folder, yw, seat, n_ in ((True, 'base-front', y0, g['front_web'], -Y), (False, 'base-rear', y1,
                                                                                     g['rear_end'] + T38, Y)):
        for sx in (-1, 1):
            dx, dz = sx * g['draw_rod_x'], g['draw_z']
            a, b = sorted((yw, seat))
            plug = parts.cyl_v(16.0 - FIT_PLUG, a, b, dx, dz)
            fixed_piece(kit, folder, M, f'draw-pocket-{"R" if sx > 0 else "L"}', 'plug', plug,
                        [(Vector(0, yw, 0), n_, 1)], up=n_ * -1,
                        note='Forms a draw-rod nut pocket down to the girder\'s end plate; bolts to the wall.',
                        show=[folder])

    # everything else through the boards: insert screws, bolts into the cast-in nuts, dowels
    holes = []
    for pt, n, kind in m.anchors:
        if abs(n.z) > 0.5:
            holes.append(Fix('hole', pt, Z, 5.5 if kind == 'insert_m5' else 6.5,
                             'M5 screw into the steel' if kind == 'insert_m5' else 'M6 screw into a pad'))
    for bx, by in g['rail_bolts'] + g['cover_inserts'] + g['ychain_inserts']:
        holes.append(Fix('hole', Vector(bx, by, top), Z, 5.5, 'M5 insert screw'))
    for sx in (-1, 1):
        holes += [Fix('hole', Vector(sx * g['ux'], dy, top), Z, 9.6, '3/8 dowel') for dy in g['dowel_ys']]
        holes += [Fix('hole', Vector(sx * g['girder_x'] + dx, ys, g['draw_z']), -Y, 9.6, '3/8 dowel pin (split)')
                  for dx in (-32.0, 32.0)]
    kit.fix(holes, M)
    kit.count('M5 x 30 screw, greased (holds a rail bar or the BK pad)',
              sum(1 for f in holes if f.what == 'M5 screw into the steel'), M)
    kit.count('M6 x 30 screw, greased (holds a support pad)', sum(1 for f in holes if f.what == 'M6 screw into a pad'), M)
    kit.count('M5 x 20 screw, greased (holds an insert)', sum(1 for f in holes if f.what == 'M5 insert screw'), M)



TH_SADDLE = 6.0
FIT_PLUG = 0.15
CLEAT = 38.1       # 1x2 strips along each wall's foot, flat on the floor, bolted down through it (any 1x2 lumber)


def cleat(kit, M, name, p0, p1, n_out, up, show, qty=1, mult=1):
    """A strip of board lying on the floor against a wall's outer face, from p0 to p1 (on that face, at
    the floor), bolted down through the floor: the wall's foot can't move out."""
    T = P['mold_board']
    a = p1 - p0
    length = a.Length
    a.normalize()
    cs = [p0, p1, p0 + n_out * CLEAT + up * T, p1 + n_out * CLEAT + up * T]
    lo = tuple(min(c[i] for c in cs) for i in range(3))
    hi = tuple(max(c[i] for c in cs) for i in range(3))
    kit.board(moldbox.box_board(name, M, lo, hi, up, n_out, qty=qty, note='flat on the floor', show=show,
                                 view='outside', stock='1x2'))
    n = max(1, math.ceil((length - 80.0) / 250.0) + 1) if length > 120 else 1
    at = [length / 2] if n == 1 else [40.0 + (length - 80.0) * k / (n - 1) for k in range(n)]
    kit.fix([Fix('bolt', p0 + a * t + n_out * (CLEAT / 2), -up, 4.5, 'cleat', 'M4',
                 molds.bolt_length(2 * molds.BOARD_MAX + 1.0 + HW['M4']['t'] + 1.0)) for t in at], M, mult)


def foam_note(name, shape, poly=None):
    """How to cut a foam piece: its size, and the profile where it isn't a plain block."""
    bb = shape.BoundBox
    size = f'{bb.XLength:.0f} x {bb.YLength:.0f} x {bb.ZLength:.0f} mm'

    def depth(ax, at):
        lo = [bb.XMin - 1, bb.YMin - 1, bb.ZMin - 1]
        ln = [bb.XLength + 2, bb.YLength + 2, bb.ZLength + 2]
        lo[ax], ln[ax] = at - 0.25, 0.5
        return shape.common(Part.makeBox(*ln, Vector(*lo))).BoundBox.ZLength
    if name.startswith('gutter'):
        return (f'XPS strip {size}: a wedge, {depth(1, bb.YMin + 0.5):.0f} mm deep at the front end tapering to '
                f'{depth(1, bb.YMax - 0.5):.0f} mm at the back.')
    if name == 'trough':
        return (f'XPS {size}: {depth(0, bb.XMin + 0.5):.0f} mm deep at the left end, {depth(0, 0.0):.0f} mm at the drain '
                f'(center), {depth(0, bb.XMax - 0.5):.0f} mm at the right, straight between. Push the drain liner into it.')
    if name.startswith('back-edge'):
        return f'XPS {size}: a 40 mm quarter-round hollow, cut with a hot wire or sanded on a 80 mm tube; taped.'
    return f'XPS block {size}, outline as the pocket (chamfered corners); taped, with its printed post glued in.'


def leg_reach():
    """How far a leg holder runs in from the mold walls: past the leg, with room for the pinch screw."""
    return max(P['leg_inset']) + 37.0


def leg_holder(c, sx, sy, half, yw, fb, x_in):
    """Holds a leg in a base corner, above the pour line: bolted through the side wall and the end
    wall; a square hole for the leg (which hangs from its sleeve) and a cradle for the leg bridge.
    c: the leg's center at the pour line."""
    T = P['mold_board']
    xw = sx * half
    z0, z1 = -fb, -fb + 12.0                    # a 12 mm plate at the top of the freeboard band
    xa, xb = sorted((xw, sx * x_in))
    ya, yb = sorted((yw, yw - sy * leg_reach()))
    s = parts.box(xa, xb, ya, yb, z0, z1)
    q = P['post_tube'][0] + 2 * P['tube_fit']
    s = s.cut(parts.box(c.x - q / 2, c.x + q / 2, c.y - q / 2, c.y + q / 2, z0 - 1, z1 + 1))
    # lighten: in (u, v) from the leg's center, positive toward the side wall and the end wall, keep a
    # 7 mm ring round the leg, the plate out to both walls, the cradle arm and the pinch-screw boss
    def uv_box(u0, u1, v0, v1):
        return parts.box(*sorted((c.x + sx * u0, c.x + sx * u1)), *sorted((c.y + sy * v0, c.y + sy * v1)), z0 - 1, z1 + 1)
    ring = q / 2 + 7.0
    band = T / 2 + moldbox.SLOT / 2 + TH_SADDLE + 1.0
    inner = abs(c.x) - x_in + 1.0                   # out to the holder's inner edges (and past them)
    s = s.cut([uv_box(-inner, -ring, -inner, -band), uv_box(-inner, -ring, band, ring),
               uv_box(-ring, -8.0, -inner, -ring), uv_box(8.0, inner, -inner, -ring)])
    # cradle: a pad under the leg bridge's end and two cheeks
    ca, cb = sorted((sx * x_in, sx * (x_in + 12.0)))
    slot = T + moldbox.SLOT
    s = s.fuse(parts.box(ca, cb, c.y - slot / 2 - TH_SADDLE, c.y + slot / 2 + TH_SADDLE, z0 - TH_SADDLE, z0))
    for e in (-1, 1):
        y_in = c.y + e * slot / 2
        s = s.fuse(parts.box(ca, cb, *sorted((y_in, y_in + e * TH_SADDLE)), z0 - TH_SADDLE - 22.0, z0 - TH_SADDLE))
    fixes = []
    zb = (z0 + z1) / 2
    # pinch screw: in from the holder's inner edge, through a captive nut, onto the leg
    pe = Vector(c.x, yw - sy * leg_reach(), zb)
    s = s.cut(molds.nut_trap(pe, Vector(0, -sy, 0), Vector(0, 0, -1), 'M4', mode='side', run=30.0,
                              depth=abs(pe.y - c.y) - q / 2 + 2.0))
    for p, n in ((Vector(xw, c.y, zb), Vector(sx, 0, 0)), (Vector(c.x, yw, zb), Vector(0, sy, 0))):
        s = s.cut(molds.nut_trap(p, n, Vector(0, 0, -1), 'M4', mode='side', run=30.0))
        fixes.append(Fix('bolt', p, n, 4.5, 'leg holder', 'M4', molds.nut_bolt('M4')[0]))
    qb = Vector((ca + cb) / 2, c.y, z0 - TH_SADDLE - 11.0)
    s = s.cut(Part.makeCylinder(2.25, slot + 2 * TH_SADDLE + 2, qb - Vector(0, slot / 2 + TH_SADDLE + 1, 0), Vector(0, 1, 0)))
    s = s.cut(molds.nut_recess(qb + Vector(0, slot / 2 + TH_SADDLE, 0), Vector(0, -1, 0), 'M4'))
    fixes.append(Fix('bolt', qb - Vector(0, T / 2, 0), Vector(0, 1, 0), 4.5, 'leg holder', 'M4',
                     molds.bolt_length(molds.BOARD_MAX + 2 * TH_SADDLE + moldbox.SLOT + 0.5)))
    return s.removeSplitter(), fixes


def mold_upright(kit, g):
    """Upright mold (one: the two uprights are the same part, so it casts one, comes apart after the
    cure and casts the other): cast foot down, so 'up' is +z. Two side plates cut to the profile stand
    on the floor; sloped back and front boards fit between them. The front board's foot sits
    on the printed toe filler. The posts come up through bushings in the floor, 5/8 in rods form the
    tie-rod holes, and a bridge across the top carries the top plate. The two top tie-rod holes are lined with printed
    sleeves, centered on greased 1/2 in rods that run up through the plate and the bridge."""
    T, fb = P['mold_board'], P['mold_freeboard']
    M, folder, show, mult = 'upright', 'upright', ['upright'], 1
    sx = -1
    x0, x1 = -g['outer'], -g['inner']
    top, bb = g['base_top'], g['beam_bot']
    zt = bb + fb
    X, Y, Z = Vector(1, 0, 0), Vector(0, 1, 0), Vector(0, 0, 1)
    toe = top + P['upright_nose']
    L0 = Vector(0, g['up_front'], toe)
    a = (Vector(0, g['up_top_front'], bb) - L0)
    a.normalize()
    nrm = Vector(0, -a.z, a.y)                  # out of the slope, forward and up
    s_of = lambda z, off: (z - L0.z - nrm.z * off) / a.z
    at = lambda s, off: L0 + a * s + nrm * off
    s0, s_top = 20.0, s_of(zt, T)
    K0 = Vector(0, g['up_back_foot'], top)            # back slope: foot to the top's back edge
    b = Vector(0, g['up_y1'], bb) - K0
    b.normalize()
    nb = Vector(0, b.z, -b.y)                    # out of the back, back and up
    sb_of = lambda z, off: (z - K0.z - nb.z * off) / b.z
    bat = lambda s, off: K0 + b * s + nb * off
    yb = bat(sb_of(top, T), T).y                 # back board's outside face at the floor
    B = moldbox.box_board
    kit.board(B('Upright floor', M, (x0 - T - 40, at(s_of(top, T), T).y - 40, top - T), (x1 + T + 40, yb + 40, top),
                -Z, Y, qty=1, show=show))
    prof = [(at(s_of(top, T), T).y, top), (yb, top), (bat(sb_of(zt, T), T).y, zt), (at(s_top, T).y, zt)]
    kit.board(moldbox.Board('Upright side plate, outer', M, Vector(x0, 0, 0), -X, Z, [(y, z) for y, z in prof],
                             qty=1, note='cut to the profile', show=show))
    kit.board(moldbox.Board('Upright side plate, inner', M, Vector(x1, 0, 0), X, Z, [(-y, z) for y, z in prof],
                             qty=1, note='cut to the profile', show=show))
    kit.board(moldbox.Board('Upright back board', M, K0 + X * x0, nb, b,
                             [(0, 0), (x1 - x0, 0), (x1 - x0, sb_of(zt, T)), (0, sb_of(zt, T))], qty=1,
                             note='ends cut square', show=show))
    kit.board(moldbox.Board('Upright front board', M, at(s0, 0) + X * x1, nrm, a,
                             [(0, 0), (x1 - x0, 0), (x1 - x0, s_top - s0), (0, s_top - s0)], qty=1,
                             note='ends cut square', show=show))
    by0 = min(g['bolt_ys'][0], g['columns'][0]) - 10.0               # bridge: over the plate bolts and the rods
    by1_ = max(g['bolt_ys'][1], g['columns'][1]) + 8.5
    kit.board(B('Upright bridge', M, (x0 - T - SLOT_W - TH_SADDLE, by0, zt + TH_SADDLE),
                (x1 + T + SLOT_W + TH_SADDLE, by1_, zt + TH_SADDLE + T), Z, Y, qty=1, view='outside', show=show))

    # corner brackets: back corners, and top and foot of the front board (the foot one only bears on it)
    back, fr = [], []
    for xs, m1 in ((x0 - T, -X), (x1 + T, X)):
        back.append(moldbox.angle_bracket(Vector(xs, bat(sb_of(zt, T), T).y, zt), -nb, m1, -m1, nb, b, fb - 2,
                                          leg=27.0, hole_at=22.5))
        fr.append(moldbox.angle_bracket(Vector(xs, 0, 0) + Vector(0, at(s_top, T).y, at(s_top, T).z), -nrm, m1, -m1, nrm,
                                         a, 22.0))
    kit.add_many(folder, 'back-bracket', 'kit', back, mold=M, show=show, per=2, mult=mult, up=b)
    kit.add_many(folder, 'front-bracket', 'kit', fr, mold=M, show=show, per=2, mult=mult, up=a,
                 note='At the top of the front board; its foot sits in the toe filler\'s lip.')
    yf = at(s_of(top, T), T).y
    for xs, n, tag in ((x0 - T, -X, 'outer'), (x1 + T, X, 'inner')):
        cleat(kit, M, f'Upright cleat, {tag}', Vector(xs, yf + 90.0, top), Vector(xs, yb, top), n, Z, show, 1, mult)
    cleat(kit, M, 'Upright cleat, back', Vector(x0, yb, top), Vector(x1, yb, top), Y, Z, show, 1, mult)
    sad = []
    for xs, n in ((x0, -X), (x1, X)):
        s, wf, _ = moldbox.saddle(Vector(xs, (by0 + by1_) / 2, zt), n, Z, Y, width=24.0, cheeks=False)
        sad.append((s, wf))
    kit.add_many(folder, 'saddle-flat', 'kit', sad, mold=M, show=show, per=2, mult=mult, up=X,
                 note='The bridge rests on them; its rods locate it.')

    # toe filler: under the front board's foot, rounding the nose into the slope
    env = upright_envelope(g, sx, edges=False)
    big = 400.0
    pts = [at(s0, T), at(s0 - big, T), at(s0 - big, -big), at(s0, -big)]
    lip = [at(s0 + 12.0, T + 6.0), at(s0 - big, T + 6.0), at(s0 - big, T - 0.01), at(s0 + 12.0, T - 0.01)]  # holds the board's foot
    region = molds.poly([Vector(x0 + FIT_PLUG, p.y, p.z) for p in pts]).fuse(
        molds.poly([Vector(x0 + FIT_PLUG, p.y, p.z) for p in lip])).extrude(X * (x1 - x0 - 2 * FIT_PLUG))
    region = region.common(parts.box(x0, x1, -1e3, 1e3, top, 1e3))
    toe_shape = max(region.cut(env).Solids, key=lambda s_: s_.Volume)
    fixed_piece(kit, folder, M, 'toe-filler', 'filler', toe_shape, [(Vector(0, 0, top), -Z, 2)], qty=1,
                note='Rounds the nose into the slope; the front board\'s foot sits in its lip. Bolts to the floor.',
                show=show, mult=mult)

    # foot gasket groove: pins into the floor
    keep_clear = [(Vector(sx * rx, ry, top), 8.0) for rx, ry, _ in g['tie_rods']]
    keep_clear += [(Vector(sx * g['ux'], dy, top), 6.4) for dy in g['dowel_ys']]
    fixed_piece(kit, folder, M, 'foot-gasket-groove', 'former', foot_gasket(g, sx)[0], [(Vector(0, 0, top), -Z, 2)],
                qty=1, note='Pins into the floor.', up=-Z, show=show, mult=mult, sizes=('pin',), avoid=keep_clear)

    # tie-rod holes: the top two on greased 1/2 in rods in printed sleeves, up through the plate and the
    # bridge; the slope ones on 5/8 in rods up into plugs that form the nut pockets
    rod = P['up_rod_hole'] / 2 + FIT_PLUG
    holes = []
    for rx, ry, pb in g['tie_rods']:
        x = sx * rx
        if pb >= g['pocket_bot'] - 1:
            holes.append(Fix('hole', Vector(x, ry, top), -Z, 13.5, 'column tie rod, from below'))
        else:
            ys_ = L0.z + (ry - L0.y) * a.z / a.y          # slope height over the rod
            p = Part.makeCylinder(P['slope_pocket_d'] / 2, bb - pb, Vector(x, ry, pb)).common(env).cut(
                Part.makeCylinder(rod, ys_ - 12.0 - pb + 1, Vector(x, ry, pb - 1)))
            nm = 'toe-plug'
            fixed_piece(kit, folder, M, nm, 'plug', p, [(L0, nrm, 1)], qty=1,
                        note='Forms a nut pocket in the slope; bolts to the front board; its rod stops inside it.',
                        show=show, mult=mult, sizes=('M4', 'M3'))
    holes += [Fix('hole', Vector(sx * g['ux'], dy, top), -Z, 13.1, '1/2-13 bolt, base dowel hole') for dy in g['dowel_ys']]
    plate_bolts = [(sx * (g['ux'] - 22.0), g['bolt_ys'][0]), (sx * (g['ux'] + 22.0), g['bolt_ys'][1])]
    sp = []
    for px, py in plate_bolts:
        holes.append(Fix('hole', Vector(px, py, zt + TH_SADDLE), Z, 10.0, '3/8-16 bolt into the top plate'))
        sp.append(Part.makeCylinder(8.0, zt + TH_SADDLE - bb, Vector(px, py, bb)).cut(
            Part.makeCylinder(5.0, 1e3, Vector(px, py, 0))))
    kit.add(folder, 'plate-spacer', 'kit', sp[0], 2, 'Between the bridge and the top plate, on its greased 3/8 bolt.',
            placed=sp, show=show)
    kit.fix(holes, M, mult)
    rod_bot = top - T - 20.0                       # the rods stand 20 mm out under the floor
    kit.count('Block of 2x4, laid flat: four under the upright mold (room under the floor for the rod ends)', 4, M)
    kit.count('the two column tie rods themselves, greased: up through the floor and the columns into the top '
              'plate, to center the columns while the casting goes off', 2, M)
    kit.count('3/8-16 x 3 in bolt, greased (holds the top plate, both layers)', 2, M)
    kit.count('1/2-13 x 1-1/2 in bolt + nut, greased (forms a dowel hole)', len(g['dowel_ys']), M)


SLOT_W = 0.4


def mold_tools(kit):
    """Two small printed tools for the pour line, which is the freeboard below every wall top.
    Pour-line gauge: clips over a wall top; its inner leg ends on the pour line, to pencil the line round
    the mold and to check the fill. Screed shoes: a pair that hang a straight board from the wall tops
    with its bottom edge on the pour line, to strike the top off level."""
    T, fb = P['mold_board'], P['mold_freeboard']
    slot = T + SLOT_W
    # wall top at z = 0, the wall from x = 0 (cast face) to x = T
    gauge = parts.box(-3.0, slot + 3.0, 0, 24.0, 0, 4.0).fuse([parts.box(-3.0, 0, 0, 24.0, -fb, 0),
                                                                parts.box(slot, slot + 3.0, 0, 24.0, -12.0, 0)])
    gauge = parts.soften(gauge.removeSplitter(), 1.0, lambda e: parts.parallel((0, 1, 0))(e)
                         and all(abs(v.Point.z + fb) < 1e-6 for v in e.Vertexes) and all(v.Point.x > -2 for v in e.Vertexes),
                         chamfer=True)
    kit.add('tools', 'pour-gauge', 'kit', gauge, 2, f'Clips over a wall top; its inner leg ends {fb:.0f} mm down, on the '
            'pour line. Pencil along it all round the mold, and check the fill against it.', up=Vector(0, 1, 0), placed=[])
    w = slot + 8.0
    shoe = parts.box(-24.0, T + 6.0, -w / 2, w / 2, 0, 5.0).fuse(parts.box(-24.0, -2.0, -w / 2, w / 2, -fb - 2.0, 0))
    shoe = shoe.cut(parts.box(-25.0, -4.0, -slot / 2, slot / 2, -fb, 1.0)).removeSplitter()
    kit.add('tools', 'screed-shoe', 'kit', shoe, 2, 'A pair: rest them on two facing wall tops and drop a straight board '
            f'(on edge) into them; its bottom edge sits on the pour line. Slide it along to strike off.',
            up=Vector(0, 0, -1), placed=[])


def mold_beam(kit, m, g):
    """Beam mold: cast front (rail) face down on the floor board, so 'up' is +y; the back is open.
    The steel box goes in as one piece: its face plate screwed to the floor, its end plates on the
    1/2 in rods that form the cap-screw holes."""
    T, fb = P['mold_board'], P['mold_freeboard']
    M, folder, show = 'beam', 'beam', ['beam']
    outer, bf, bot, top = g['outer'], g['beam_face'], g['beam_bot'], g['beam_top']
    by1 = bf + P['beam_d']
    yt = by1 + fb
    X, Y, Z = Vector(1, 0, 0), Vector(0, 1, 0), Vector(0, 0, 1)
    xo = outer + T
    B = moldbox.box_board
    kit.board(B('Beam floor', M, (-xo - 40, bf - T, bot - T - 40), (xo + 40, bf, top + T + 40), -Y, Z, show=show))
    kit.board(B('Beam top wall', M, (-xo, bf, top), (xo, yt, top + T), Z, Y, show=show))
    kit.board(B('Beam bottom wall', M, (-xo, bf, bot - T), (xo, yt, bot), -Z, Y, show=show))
    for sx, tag in ((-1, 'left'), (1, 'right')):
        kit.board(B(f'Beam end wall, {tag}', M, (sx * outer, bf, bot), (sx * xo, yt, top), sx * X, Y, show=show))
    br = []
    for sx in (-1, 1):
        for zw, sz in ((top + T, 1), (bot - T, -1)):
            br.append(moldbox.angle_bracket(Vector(sx * xo, yt, zw), -sz * Z, sx * X, -sx * X, sz * Z, Y, fb - 2))
    kit.add_many(folder, 'corner-bracket', 'kit', br, mold=M, show=show, merge=True, up=Y)
    cleat(kit, M, 'Beam cleat, top', Vector(-xo, bf, top + T), Vector(xo, bf, top + T), Z, Y, show)
    cleat(kit, M, 'Beam cleat, bottom', Vector(-xo, bf, bot - T), Vector(xo, bf, bot - T), -Z, Y, show)
    for sx, tag in ((-1, 'left'), (1, 'right')):
        cleat(kit, M, f'Beam cleat, {tag}', Vector(sx * xo, bf, bot), Vector(sx * xo, bf, top), sx * X, Y, show)
    rods = [Part.makeCylinder(P['beam_bolt_hole'] / 2 + FIT_PLUG, top - bot + 2, Vector(sx * bx, by, bot - 1))
            for sx in (-1, 1) for bx in g['bolt_xs'] for by in g['bolt_ys']]
    fl = molds.fillers(beam_envelope(g, edges=False))
    for i, f in enumerate(fl):
        nm = 'back-edge' if len(fl) == 1 else f'back-edge-{i + 1}'
        if P['foam_formers']:
            kit.add(folder, nm, 'foam', f, 1, foam_note('back-edge', f), show=show)
            continue
        f = f.cut(rods)
        fixed_piece(kit, folder, M, nm, 'filler', f, [(Vector(0, 0, top), Z, 1)], up=-Z,
                    note='Rounded back edge between the uprights; bolts to the top wall.', show=show)
    # the face plate lies on the floor, held by greased screws through it into its tapped holes; they stand
    # 10 mm through the plate, so the screws that go in later have room
    holes = []
    for pt, n, kind in m.anchors:
        if abs(n.y) > 0.5:
            holes.append(Fix('hole', pt, -Y, 5.5 if kind == 'insert_m5' else 6.5,
                             f"{'M5' if kind == 'insert_m5' else 'M6'} screw into the face plate"))
    for sx in (-1, 1):
        for bx in g['bolt_xs']:
            for by in g['bolt_ys']:
                holes.append(Fix('hole', Vector(sx * bx, by, top), Z, 13.1, '1/2 core rod'))
                holes.append(Fix('hole', Vector(sx * bx, by, bot), -Z, 13.1, '1/2 core rod'))
        holes.append(Fix('hole', Vector(sx * g['ux'], g['beam_dowel_y'], bot), -Z, 9.6, '3/8 dowel'))
    holes += [Fix('hole', Vector(ix, iy, top), Z, 5.5, 'M5 insert screw') for ix, iy in g['chain_inserts']]
    kit.fix(holes, M)
    stops = [Part.makeCylinder(4.7, T - P['dowel_proud'], Vector(sx * g['ux'], g['beam_dowel_y'], bot - T)).fuse(
        Part.makeCylinder(9.0, 2.0, Vector(sx * g['ux'], g['beam_dowel_y'], bot - T - 2.0))) for sx in (-1, 1)]
    kit.add(folder, 'dowel-stop', 'kit', stops[0], 2, 'Pushes into the dowel hole from outside so the dowel stands '
            f"{P['dowel_proud']:.0f} mm proud.", placed=stops, show=show)
    stand = 5 * math.ceil((P['mold_board'] + P['beam_bar_t'] + 10.0) / 5)      # through the floor and plate, 10 mm proud
    kit.count(f'M6 x {stand} screw, greased (holds the face plate)',
              sum(1 for f in holes if f.what == 'M6 screw into the face plate'), M)
    kit.count(f'M5 x {stand} screw, greased (holds the face plate)',
              sum(1 for f in holes if f.what == 'M5 screw into the face plate'), M)
    kit.count(f"1/2 in plain steel rod, greased (forms a beam bolt hole), {top - bot + 2 * T + 20:.0f} mm", 8, M)
    kit.count('M5 x 20 screw, greased (holds an insert)', len(g['chain_inserts']), M)
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
