nolanstr/diycnc/(commit log)

2026-10-10 Epoxy-granite desktop CNC mill model, stiffness study and build docs
    FreeCAD model of a fixed-gantry epoxy-granite mill (180 x 300 x 140 mm travel):
    five bolt-together castings with cast-in steel, HGR15 rails on bedded risers held
    by cast-in inserts, ballscrews on all axes, enclosure, slide-out coolant sump.
    - build_cnc.py / parts.py: parametric model, collision check, report, renders
    - fea/: voxel FE model of the frame and base topology optimization
    - BUILD.md: build instructions; sourcing.md/.csv: parts and prices
    [sourcing.csv]
2026-10-10 Reorganize repo, add printed mould parts, build pictures and PDF docs
    - New layout: model/, print/, renders/ (renders/build for build steps), docs/ (PDFs,
    report, sourcing CSV; Markdown sources and generators in docs/src), analysis/
    - Printed mould pieces (pocket cores as shells, formers, corner fillers, pocket plugs,
    drain liner) generated from the model and exported as STLs split to fit a 180 mm bed,
    with a print guide and manifest
    - Build-step renders (cast-in steel, moulds, frame assembly, axes) in the build guide
    - Build guide, print guide, sourcing list and design notes as PDFs
    - Top-level README with the layout and rebuild commands
    [manifest.csv, part-chain-mount-moving.stl, part-sump-filter-frame-part1of2.stl, part-sump-filter-frame-part2of2.stl, sourcing.csv]
2026-10-10 Raked-buttress uprights from a combined base/upright optimization; whiting fines; JLC notes
    - analysis/topopt_frame.py: base and uprights optimized together with one shared budget;
    uprights become raked buttresses whose foot runs forward along the base
    - Uprights redrawn as solid buttresses with four tie rods each; base pockets re-laid around
    the longer feet (full depth under them, wider tie across the split). Frame stiffness at the
    tool +39 / +11 / +35 % (X / Y / Z) for 8.9 L more epoxy granite
    - Whiting (calcium carbonate) replaces silica flour as the fine filler
    - Sourcing: extra tie-rod hardware, larger epoxy order, JLCMC/JLCCNC comparison
    - Docs, prints, renders and PDFs regenerat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
    [manifest.csv, sourcing.csv]
2026-10-10 Budget sourcing: phase 1 / spindle choice / phase 2, hardware-store joint hardware
    - Joint hardware in hardware-store inch sizes (1/2-13 rod and couplers, 3/8-16 grade 8 beam
    bolts, 3/8 dowels); enclosure and flood coolant moved to a phase 2
    - Sourcing list split into phase 1 (mill without spindle), spindle options and phase 2, with
    remnant steel and aluminium, Raka epoxy, pottery whiting and priced electrical parts
    - Build guide and design notes updated
    [sourcing.csv]
2026-10-10 Sourcing list in three parts: frame, electronics and spindle, enclosure and coolant
    [sourcing.csv]
2026-10-10 Sourcing wording
    [sourcing.csv]
2026-10-10 Cheaper electrical box, one shielded cable spool, bolt-and-pad feet
    [sourcing.csv]
2026-10-11 8.5 % epoxy mix with jar test and tap-tested bars; modal analysis; upright lightening-hole study
    Single 3 gal epoxy kit (Part 1 now $1,205). analysis/modal.py adds natural
    frequencies; topopt_upright.py and compare_uprights.py test through-windows and
    outer pockets in the uprights (1-3 % stiffness for ~$3, no frequency gain, so the
    uprights stay solid).
    [sourcing.csv]
2026-10-11 Cleaner castings: blunt upright toe, 10 mm outside edge rounds, beam back edge to suit the uprights, flush caps over the sloped nut pockets
    Slope pockets go 8 mm deeper for the caps, with their own printed plugs. Frame
    stiffness 78.2/110.1/95.5 N/um; renders, prints and docs regenerated.
    [manifest.csv, sourcing.csv]
2026-10-11 Sourcing: Raka ships free over $100
    [sourcing.csv]
2026-10-11 Sourcing: exact Raka kit (127 Thin + 606 Slow, 3 gal)
    [sourcing.csv]
2026-10-11 Aggregate grading: Fuller-type split (q ~0.45), sources and sizes; notes on alumina, quartz, microspheres, epoxy grout
    [sourcing.csv]
2026-10-11 Alumina grit (#16) as the coarse fraction in the beam and uprights: ~+10 % frame stiffness for one 50 lb bag
    analysis/alumina.py estimates the mix modulus (differential effective medium) and the
    frame stiffness; report, build guide, sourcing (Part 1 $1,295) and notes updated.
    [sourcing.csv]
2026-10-11 Both alumina grits in the beam and uprights: #16 brown for the coarse sand, 70 grit black (Harbor Freight) for the fine
    About +17 % frame stiffness (estimate) for $150; IMS Blasting #16 ships free.
    Part 1 $1,355.
    [sourcing.csv]
2026-10-11 Lighter base: pockets under the upright feet, narrower rear tie, 20 mm skin (castings 135 -> 126 kg)
    Re-optimized the base with the alumina beam and uprights (FEA_GRIT, to_light_*);
    the castable layout keeps ribs at the foot front and split and clears the tie-rod
    couplers and sockets. Frame 84.3/124.5/111.1 N/um (estimate), still above the
    sand-only frame. analysis/weight.py compares mass and stiffness.
    [manifest.csv, sourcing.csv]
2026-10-11 Bolt-together mould kit: melamine boards, printed brackets and saddles, captive-nut fixings
    - Walls stand 25 mm above the pour line; corner/floor brackets, saddles and leg
    holders bolt through that band (M4, nuts in hex pockets), so nothing goes
    through a cast face
    - Every printed mould piece bolts to its board from outside into a bayonet nut
    pocket (M4, M3 when thin) or pins on (gasket beads); bed-cut parts are pegged
    - Cores hang from on-edge bridges by a bolted post; split cores have bolted
    bulkhead frames
    - Base halves cast on one floor, rear first, front against the rear's split face;
    split gasket groove moves to the rear half
    - Post sockets, the upright dowel hole and the top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
    [kit-plate-spacer.stl, manifest.csv, sourcing.csv]
2026-10-11 Cut mould print volume from 4.6 to 3.7 kg PETG
    - Core shells 1.2 mm (three lines; the sand inside backs them)
    - Socket liners 2 mm walls (the posts are grouted, the liner only forms the socket)
    - Leg holders a 12 mm plate; upright saddles small caps (the rods locate the bridge)
    - Print settings by kind: formers, fillers, plugs 2 walls 10 %; kit 3 walls 15 %
    - foam_cores option: XPS pocket cores with only their printed posts (about 2.3 kg)
    - Sourcing: 4 rolls of PETG; Part 1 about $1,559
    [kit-saddle-flat.stl, manifest.csv, sourcing.csv]
2026-10-11 Foam for the bulky mould pieces: printing down to 1.4 kg (two rolls)
    - XPS foam (one 2 in board) for the base pocket cores (printed posts only), the
    socket cores (sockets now cast on foam and grouted, no printed liners), the
    coolant trough and gutters, and the beam's back-edge filler; foam=False prints them
    - Melamine offcut cleats along each wall foot replace the printed floor brackets
    - Leg holders get a pinch screw instead of the printed hanger
    - Sump baffle cut from ACM offcut
    - Mould guide lists the foam pieces with sizes; sourcing: 2 rolls PETG, XPS board, tape
    [core-centre-post.stl, core-foot-b-L-post.stl, core-foot-b-R-post.stl, core-foot-c-L-post.stl, core-foot-c-R-post.stl, core-knee-L-post.stl, core-knee-R-post.stl, manifest.csv]
2026-10-11 Hybrid foam and leaner printed shapes: 1.5 kg PETG
    - Foam only for the hidden pocket and socket cores; the trough, gutters and beam
    back edge print again (foam_formers=True cuts them too)
    - Spigot sleeves are two 15 mm rings; tube, leg and post end plugs are cups
    - Socket cores stand on small printed spikes; leg holders lightened
    - Toe filler gets a lip for the front board's foot, replacing four brackets
    - Tube locators: a cross in the tube end instead of a solid square
    - Post bushings: four tabs instead of a full flange
    - Thin formers fall back to one bolt before pins, and formers print flat face down
    - Saddle count corrected (six at once for the rear half)
    [manifest.csv, sourcing.csv]
2026-10-11 Mould construction guide with illustrations; sliced filament figures
    - model/slice_prints.py slices every STL in Bambu Studio (A1 mini, PETG) at the print
    guide's settings: 1288 g, about 107 h; the print guide uses the sliced figures
    - model/mould_figures.py renders labelled illustrations (FreeCAD + Pillow): step-by-step
    assembly for each mould, cut-aways of the captive nut, pins, pegs, a mould corner,
    a foam core on its bridge, the socket spike, the toe filler and the tube locator, and
    galleries of the printed kit and pieces
    - Mould guide rewritten as a full manual: how it works, materials, hardware and tools,
    printing, a sheet cutting layout, drilling maps, foam, release prep, as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
    [manifest.csv, sliced.csv, sourcing.csv]
2026-10-11 American spelling throughout: mold, aluminum, center, gray, color, liter
    - Files renamed: model/molds.py, model/moldbox.py, model/mold_figures.py,
    docs/mold-guide.*, renders/mold/, renders/build/*-mold-*
    - Parameters and identifiers follow (mold_board, mold_freeboard, vox.centers)
    - Docs, renders, STLs and PDFs regenerated
    [core-center-post.stl, manifest.csv, sliced.csv, sourcing.csv]
2026-10-11 Docs in one folder per stage, a PDF per mold and per build stage
    - docs/1-sourcing, 2-printing, 3-molds, 4-build, 5-design, with docs/README.md as the index
    - Molds: molds-complete.pdf plus base-mold.pdf, upright-molds.pdf and beam-mold.pdf, each
    self-contained (shared sections, and that mold's hardware, printed parts, boards, hole
    maps, foam and steps); the kit counts hardware per mold
    - Build guide: the complete PDF plus five stage PDFs for the bench
    - report.txt and sourcing.csv move into their sections; README links updated
    [sourcing.csv]
2026-10-11 Mold guides simplified, with exploded views, drilling templates and pour-line tools
    - Full-size drilling templates per mold (docs/3-molds/templates/): Letter pages, grid in board
    coordinates, crosshairs colored by hole size, the pour line on every wall, a scale check and
    printing and marking instructions; only pages with holes are printed
    - Pour line on every wall in the drawings and templates; printed pour-line gauge and screed shoes
    - Exploded view of each mold; step pictures without hole clutter, new parts in color and earlier
    ones gray; pour line shown; a pour-line figure
    - Mold guides rewritten shorter: exploded view first, short steps, templates for marking, hole maps
    moved to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
    [kit-pour-gauge.stl, kit-screed-shoe.stl, manifest.csv, sliced.csv]
2026-10-12 Tolerate real steel: datum ends, cut-length check, looser tube fits
    Each cast-in piece is set from one end and the report checks the room at
    its free end against a 1/8 in saw cut. Posts get 6 mm under the top plate,
    beam tube holes go to 3/4 in and are marked from the tube's middle, printed
    parts on or in tube get 0.5 mm a side and weld-seam grooves, sockets grow to
    2.5 mm a side of grout, and the X support pads bed onto the beam tube across
    a 1.5 mm gap. Design notes gain the load path and the steel tolerances.
    [manifest.csv, sliced.csv]
2026-10-12 Tie the uprights to steel top and bottom
    The four tie rods per upright now run from nuts held in the top plate (or in
    the slope pockets) right through the base to laser-cut 3/8 x 3 in anchor bars
    flush in its underside, nut and washer below, replacing the cast-in couplers.
    The top plate becomes two 1/2 in laser-cut layers: the lower tapped for the
    beam screws and seating the rod nuts, the upper with hex holes that stop them
    turning. Beam screws, plate, rods and bars form one bolted steel chain with
    the epoxy granite in compression, and every nut can be retightened.
    DXFs for the plates and bars go to docs/1-sourcing/laser/. The base mold forms
    the rod holes on 5/8 rods and hangs the bars fro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
    [anchor-bar-front.dxf, anchor-bar-rear.dxf, core-foot-c-L-post.stl, core-foot-c-R-post.stl, kit-dowel-stop.stl, manifest.csv, sliced.csv, sourcing.csv]
2026-10-12 Drop the upright posts, shorten the feet: re-run of the stiffness study
    With the uprights clamped through the steel chain, the frame model puts the
    posts at under 1.5 % of the stiffness, so the posts, the base sockets, the
    post bushings and the post grouting go. A second grouted dowel per foot
    locates each upright, and friction under the tie-rod clamp takes the side
    load. The stiffness the chain added pays for 30 mm off each upright foot
    (260 mm ahead of the beam face): the frame stays 3 / 1 / 2 % stiffer than
    before the chain with every mode as high or higher.
    The voxelizer can leave unbonded rods out (VOX_SKIP); vox_before_chain is
    the frame before the chain on the same basis.
    [anchor-bar-front.dxf, anchor-bar-rear.dxf, manifest.csv, sliced.csv, sourcing.csv]
2026-10-12 Steel skeletons as the primary frame, epoxy granite around them
    Each casting is now built around a skeleton of laser-cut plates that slot
    together (tab through slot, or half-depth crossings) and are clamped by rod
    and bolts; nothing is welded or threaded into the epoxy granite.
    - Uprights: 3/8 in foot plate, two 2x2 tube columns with the tie rods inside,
    a brace plate up the slope, the two-layer top plate; a third rod at the toe.
    - Beam: a box of a tapped face plate, back plate, diaphragms and end plates;
    the cap screws clamp it to the upright top plates. The beam tubes, their
    locators and the X support pads are gone.
    - Base: per half, a girder under each rail (tapped rail bar), a ped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
    [anchor-bar-front.dxf, base-cross-b-f-front.dxf, base-cross-b-k-rear.dxf, base-cross-front-front.dxf, base-cross-split-front.dxf, base-girder-bar-front.dxf, base-girder-bar-rear.dxf, base-girder-end-end-rear.dxf]
2026-10-12 Laser parts as DXF, STEP and STL, named by thickness and quantity
    Each plate is written to docs/1-sourcing/laser/{dxf,step,stl}/ lying flat,
    named like 3-8in_2x_beam-cap, with tapped holes at their tap drill size in
    every format. 32 different parts, 64 plates.
    [1-2in_2x_top-plate-lower.dxf, 1-2in_2x_top-plate-upper.dxf, 1-4in_1x_base-cross-bf-front.dxf, 1-4in_1x_base-cross-bk-rear.dxf, 1-4in_1x_beam-back-plate.dxf, 1-4in_2x_base-cross-split-front.dxf, 1-4in_2x_base-girder-web-front.dxf, 1-4in_2x_base-girder-web-rear.dxf]
2026-10-12 Skeletons from stock flat bar and tube instead of custom plates
    The 64 laser-cut plates are replaced by stock A36 flat bar and A500 tube cut to
    length, drilled from printed 1:1 templates and bolted:
    - Uprights: 3/8 x 2 in foot bar, two 2x2 columns, a top plate of two
    1/2 x 2-1/2 in bars with the column tie rods screwed into the lower one.
    - Beam (now 146 mm high): 3/8 x 5 in face and back bars on pipe-nipple
    spacers and studs, 3/8 x 2-1/2 in seat and cap bars clamped by eight
    3/8-16 B7 studs into the upright top plates.
    - Base: a 2x3 tube girder under each rail with a tapped rail bar bolted on,
    end plates, the draw rod inside it; pedestals of flat bar and 2x2 spacers;
    1-1/2 in cro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
    [1-2in_2x_top-plate-lower.dxf, 1-2in_2x_top-plate-upper.dxf, 1-4in_1x_base-cross-bf-front.dxf, 1-4in_1x_base-cross-bk-rear.dxf, 1-4in_1x_beam-back-plate.dxf, 1-4in_2x_base-cross-split-front.dxf, 1-4in_2x_base-girder-web-front.dxf, 1-4in_2x_base-girder-web-rear.dxf]
2026-10-13 Frame cost-down: core list plus add-later niceties, their fixings cast in now
    The frame's sourcing list is split into the core ($1,602.94) and an "add later
    (niceties)" section ($183.09) left out of the total: way covers and springs,
    the spiral screw cover, drip shield, sump and chip basket, grease gun. A $20
    "first chips" section (cutting fluid, drain bin, grease syringe) stands in.
    Everything the add-ons bolt to is in the castings or steel now:
    - Way-cover rollers: brackets with feet; the front and rear outer feet screw
    to four cast-in M5 inserts in the base, the rear inner feet to two M5 holes
    tapped in the BK12 pad.
    - Cable-chain mount: two M5 inserts in the beam top.
    - Drip shield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
    [manifest.csv, part-chain-mount-fixed.stl, sourcing.csv]
2026-10-23 Grit's money into steel, beveled base, raked uprights, frame animations
    Plain sand in every casting; the alumina grit becomes an option. The money
    goes into steel where the frame bends (analysis/steel_study.py): 3/4 x 5 in
    beam face and back bars on 2-1/2 in pipe nipples, and 2 x 2 x 3/16 in tube
    for every column. Stiffer than the #16 grit frame for about $45 less.
    - The base's lower edge is beveled 1-1/2 x 2-1/2 in all round and the legs
    are tucked in behind it: modes +11-31 %, castings 1 kg lighter. The bevel
    is a ripped 2x3 or printed strips in the mold; five shallow foam cores go.
    - The uprights' backs are raked to a foot 40 mm deeper (+1 kg each).
    - Frame now 105.2 / 157.2 / 138.2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
    [cast-in-leg-front-l-plug.stl, cast-in-leg-rear-l-plug.stl, former-foot-gasket-groove-part3of4.stl, manifest.csv, sliced.csv, sourcing.csv]
2026-10-23 Standard sizes: B7 studs at length, flat-bar plates, HM12-57 on Y, 4th-axis fixings
    Everything is bought at a stock size, cut by the supplier and only drilled:
    - Every rod is a grade B7 fully threaded stud at a stock length (1/4 in
    steps): 1/2-13 at 6, 8-1/2, 10-3/4, 14-1/4 and 27 in, 3/8-16 at 7-1/2
    and 4-1/2 in. Each is within 3 mm of the old cut length; the report
    checks the shortest tail past the far nut (4.6 mm) against the stud's
    own 1/16 in. Nothing is sawn at home. +$17.
    - The aluminum plates are stock 6061 flat-bar widths: a 10 in table and a
    6 in X carriage and Z plate. The X blocks go to 90 mm pitch to fit the
    6 in carriage, which brings the uprights 18 mm closer: the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
    [cast-in-column-ring-l1a.stl, core-knee-L-post.stl, core-knee-R-post.stl, filler-back-edge-part1of3.stl, filler-back-edge-part2of3.stl, filler-back-edge-part3of3.stl, filler-bevel-L-part1of2.stl, filler-bevel-L-part2of2.stl]
2026-10-26 Keep the regenerable STEP, FCStd and combined guides out of the repo
    model/DIYCNC.step and DIYCNC.FCStd (rebuilt with CNC_SNAPSHOTS=1) and the
    combined molds-complete.pdf and build-guide.pdf (make_pdfs.py merges the
    per-mold and per-stage guides) are ignored. The READMEs and the mold
    guides point to the per-part PDFs and the board sheet layout instead.
2026-10-27 Steel X carriage with angles, from a stiffness study through the moving parts
    analysis/chain.py carries the frame FEA on through the plates, rail blocks and
    ballscrews to the tool. The frame turns out to be 2-4 % of the deflection; the
    aluminum X carriage was the softest link. A 5/8 x 6 in steel carriage with two
    1-1/4 in angles up its back takes the machine from 3.1 / 2.7 / 4.0 to
    3.5 / 3.5 / 6.6 N/um at the tool, frame list $1,531.
    [sourcing.csv]
